kursatkemalkul/autokitch/_local/montaj-v87/v87_K_on.png

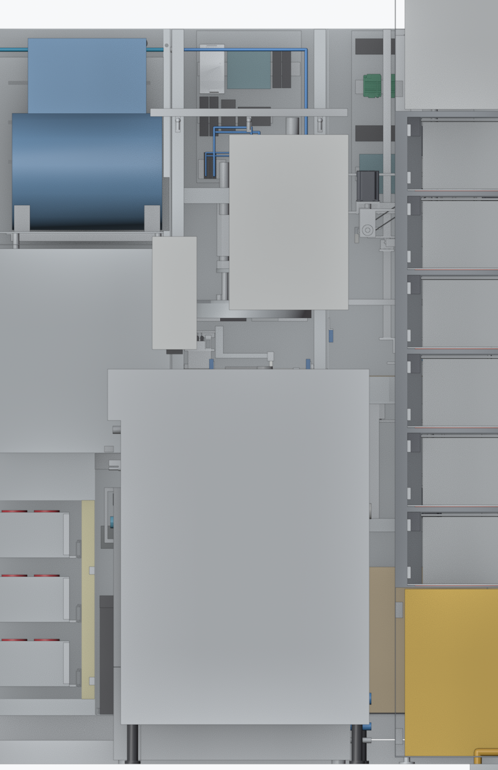
_local/montaj-v87/v87_K_on.png
