kursatkemalkul/autokitch/_local/montaj-v87/v87_K_34.png

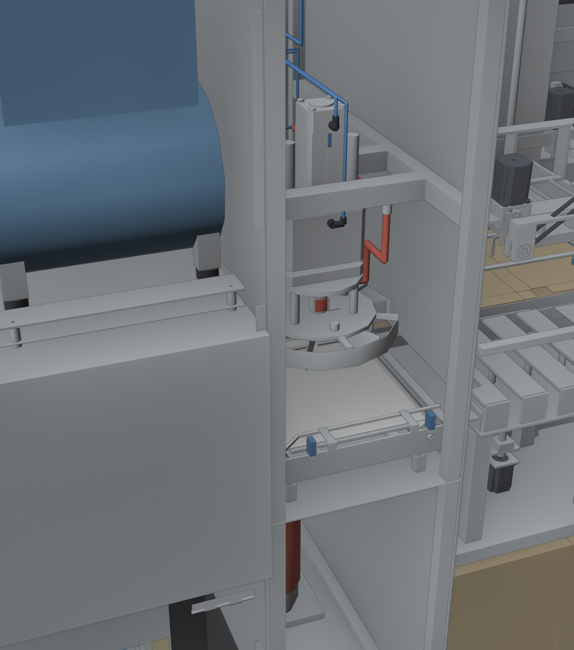
_local/montaj-v87/v87_K_34.png
