kursatkemalkul/autokitch/arastirma/DUZEN.md

# ARASTIRMA KLASÖR DÜZENİ (31 Ağu 2026)

Her istasyonun kendi klasörü var — o istasyonla ilgili çizim versiyonları,
belgeler, mail taslakları oraya gider. Yeni netlik = yeni versiyon, ilgili klasöre.

- 1_STORE    — soğuk depo: ist1_store_detay_v4 (4 Eyl; ölçü kontrolü: top kubbe Ø9,5×6, kutu Ø66×115, tatlı 4 kanal, soğutma 28, kaset çekmecesi 29, dikey 185 ✓) = ALT BUZLUK 6 çekmece (4 hamur + 2 kaset) + TAM ÇEKMECELİ KAPAKSIZ kasa, gerçek kalınlıklar (PU 60/80, ray 12,7, önler 40/60), robot erişimi 70 cm tam açılım (hat v43 STORE hâlâ v39 üst-buzluk — v44'te güncellenecek)
- 2_PRESS    — Fersah PZP-400 + uç cepleri + çöp          [güncel: ist2_pres_detay_v8 — sol yarı 30 L kova + 14 cm kol boşluğu (huni/çekmece yok), sağ yarı boş; altta yatay uç yuvaları 14 + tepsi rafı 8]
- 3_TOPPING  — dozaj/malzeme (hazne kulesi kararı AÇIK) · topping_cikis_geometri_v1 = çıkış kendi kaset merkezinde mi? 70 yan yana ✗ / 70 tek kolon A / 105 iki kolon B — B reddedildi (makine büyümez); topping_cikis_geometri_v2 = 70 tek kolon 3 dizilim (A1 öne kaşar öneri · A3 tabla · A2 yan yana dar-uzun ✗) · topping_kaset_form_v1 = form araştırması (F1 kutu · F2 kama · F3 REVOLVER döner tabla sektör kaset ÖNERİ · F4 tambur) · topping_revolver_v1 = KARAR: revolver 8 eşit 45° dilim (kaşar ×4 · sucuk ×2 · kav · kuş), dilim 11,7 L ≤ 6 kg, dozaj+değişim (35,60), geçiş rafı 12 yuva, 197 dikey ✓ · topping_dozaj_unitesi_v1 = dozaj kurgusu (Picnic referansı: köprü kırıcı tel + oluklu rotor; yük hücresiyle gram; sucuk = çubuk+dilimleyici; v2 = gerçek Picnic kareleri gömülü; v3 = sektörde köprü kırıcı = rotora paralel radyal TARAK mili, V-oluk 45°, malzeme tablosu; v4 = ideal kama huni vs bizim dilim üst/ön/yan; v5 = KARAR: cepli rotor+huni yerine YATAY HELEZON dış uçtan tek nokta (huni yok, çark katı 21→8, dozaj noktası (35,69)); dik boru ✗) · ist3_topping_detay_v12 GÜNCEL = ÇİFT REVOLVER (üst çalışan 8 + alt sıra 8 kaşar) + RAF A (park+boş) + RAF B (çözülme), dilim pasif helezon+tarak, pençe kavrama, M1 M2 M3 + klape ×2 + yük hücresi ×3 + RFID sabit gövdede, dikey 197 — Kemal REDDETTİ ('ne revolveri, KARAR C dedik') · ist3_topping_detay_v13 GÜNCEL = SABİT dizilim, helezon ağzı iç uçta → kasetler yan duvara yaslı, 2 kat + 2 dozaj düzlemi (kat 1 kaşar A + sucuk çubuk magazini sabit; kat 2 kaşar B + kav/kuş üst üste), raf A/B 2×4 yuva, yan dişli kavrama, 5 motor, 27+32+3+14+32+3+14+36+36 = 197 ✓, arka 50 cm boş — Kemal REDDETTİ ('C seçimindeki şekli direkt kullan, kutu kutu yapmışsın') · ist3_topping_detay_v14 GÜNCEL = TEK revolver Ø66 + C-şekli dilim (45° sektör, V-oluk, helezon r 12-30, tarak, ağız dış uçta (35,69), pençe iç uçta) + geçiş rafı 3 kat (12 yuva, önden FIFO, park = RAF 3 boş yuva), M1 M3 + klape + yük hücresi ×3 + RFID sabit gövdede, 27+4+33+8+14+37×3 = 197 — Kemal REDDETTİ ('revolver yok yokkk') · ist3_topping_detay_v15 GÜNCEL = REVOLVER YOK, C-kaset (sektör, helezon, tarak, V-oluk, ağız dış uçta) sabit PAPYON dizilimi: tip yan duvarda (motor), ağız ortada x 31/39; kat 1 kaşar A 60° | sucuk çubuk 60°; kat 2 kaşar B 60° | kavurma 30° + kuşbaşı 30° yan yana; her kasetin arkasında aynı rayda yedeği; boşluk ×2 (düzlem 123/74 cm); raf 2 kat (E-H + park + çözülme); 27+35+14+35+14+36+36 = 197 — Kemal REDDETTİ ('üstten üçgen değil, mükemmel form + v7 ölçüleri') · ist3_topping_detay_v16 GÜNCEL = v4 ideal kama huni (dikdörtgen, 45° V, tam boy helezon, tarak ×2) + C ağız iç uçta; kaşar 27×38×44 = 14,6 kg ×4 (A B çalışan, C D arkada), sucuk 27×19×27 çubuk ×2, kav/kuş 27×17×18 = 3,5 kg ×4; kat 47 ×2, boşluk 14 ×2 (tepsi 111 / 50 cm), raf 48 (park ×2 + boş küçük ×2); 27+47+14+47+14+48 = 197 ✓; kol yükü 18 kg → ⑦ ≥ 20 kg kobot (4 Eyl) · ist3_topping_detay_v17 GÜNCEL = TEK BÜYÜK KASET 27×78×44 tam derinlik (L-oluk: arka besleme helezonu + ön dozaj helezonu, ortada konik, tek duvar motoru), 76 L → kaşar 31 kg; kaşar A+B 62 kg/hafta + sucuk 10 kg büyük gövde → robot bunları HİÇ değiştirmez, eleman haftalık üstten doldurur (çekmece gibi öne çekilir); ⑦ kapandı (kol ≤ 6 kg); kav/kuş B = küçük gövde 3 gün (varsayılan) / A = −18 hücre + IQF donmuş dozaj (test); ALT 48 boşa çıktı; dok: motor duvarda, kaset pasif, kontak yok; isimler (LIW feeder, metering auger, bridge breaker...) (5 Eyl) · ist3_topping_detay_v18 GÜNCEL = KAPLAR: kıyma yok; BÜYÜK kap kaşar 27×65×48 = 56 L → 23 kg (3,5 gün; kat 1 + kat 2 birlikte 8 gün, eleman haftalık) · KÜÇÜK kap 27×21×28 = 13 L tek ölçü: sucuk 24 çubuk 7,5 kg (hafta, eleman, kavurmanın arkasında) / kavurma 3,3 kg / kuşbaşı 4 kg (3 gün, robot, STORE −18 28 ≤ 29); her kapta tek tarak (pimli mil, köprü kırıcı) + altta dozaj helezonu (sucukta bıçak); yerleşim kat 1 kaşar A + kavurma ön + sucuk arka, kat 2 kaşar B + kuşbaşı ön + yedek arka; dikey 27+51+14+51+14+40 = 197 (tepsi 107/42 cm); v16/v17 kaşar ölçüleri iptal (5 Eyl) · ist3_topping_detay_v19 GÜNCEL = kaplar 90° döndü: helezon derinlik (y) yönünde, V-kesit ÖN yüz, motor ARKADA eksenel pençe (taktığı gibi bağlanır); kesit asimetrik (dış duvar 45°, iç duvar dik, oluk bant kenarında); BÜYÜK kaşar 32,5×70×55 = 102 L → 42 kg HAFTALIK (yedek yok, robot dokunmaz); KÜÇÜK 32,5×20×28 = 11,7 L sucuk 28 yatay çubuk 8,7 kg / kavurma 3,3 / kuşbaşı 4; kat 1 kaşar sol tam derinlik + sucuk sağ ön, kat 2 kavurma sol + kuşbaşı sağ ön (arkası boş), ALT 53 sucuk yedeği + kav/kuş çözülme + park; dikey 27+58+14+31+14+53 = 197 (tepsi 100/55); kavurmalı/kuşbaşılı pide kat değiştirir +5 sn (5 Eyl) · ist3_topping_detay_v20 GÜNCEL = Kemal'in krokisi (referans/kemal_kroki_topping_kaplar_5eyl.jpg) izometrik: üst sol KAŞAR 32,5×70×55 (42 kg hafta) + üst sağ KAVURMA 32,5×20×55 (kısa, aynı yükseklik), alt SUCUK KÜP 32,5×20×40 + KUŞBAŞI 32,5×20×40; SUCUK KÜP — bıçak/çubuk/magazin İPTAL, dört kap aynı iç (tek tarak + helezon); motorlar 10 cm kalın arka duvarda gizli, kısa kaplara ara mil; dikey 27+58+14+42+14+42 = 197; (5 Eyl) · ist3_topping_detay_v21 GÜNCEL = Kemal'in simetrik V şekli korundu (helezon + tarak ortada); ağız banda kabın ön ucundaki kısa ÇAPRAZ HELEZONLA (konik dişli, aynı motor, kap içinde, 9-17 cm); kat 1 = KAŞAR 40×70×50 (121 L, 50 kg hafta) + SUCUK KÜP 24×20×50 (23 L, 9 kg hafta) eleman; kat 2 = KAVURMA + KUŞBAŞI 32×15×28 (11 L, 3 gün) robot; ALT 58 = değişim rafı (çözülme ×2 + park ×2); dikey 27+53+14+31+14+58 = 197 (tepsi 105/60); STORE −18 kesiti aynı paftada: kap döndürülüp 3/modül, 28 ≤ 29 ✓ (5 Eyl) — Kemal: taşıyıcı yok, arka arkaya yok, yan yana; menü Gemini araştırmasıyla kıyma+kaşar+kuşbaşı+sucuk; pide Ø30; 'mükemmel formu araştır' · kap_geometri_v1 GÜNCEL = literatüre dayalı kap: tek eğimli kama 55°, U-oluk R38, milsiz spiral Ø70, çift tarak, UHMW-PE, R ≥ 6 (EHEDG), yığın sınırı; BÜYÜK-L kaşar 32,5×70×60 → 90 L 37 kg ≈ 8 gün; KÜÇÜK 20×54×24 → 15,4 L (kıyma L ×4, sucuk R ×2, kuşbaşı R ×4; sol/sağ ayna, kap = ürün = pozisyon); kıyma/kuşbaşı harçları KAVRULMUŞ/SOTE vakumlu; dikey 27+63+14+27+14+52 = 197; ALT 2 sıra × 3 beşik; STORE −18 2/modül pay 5 (5 Eyl) · ist3_topping_detay_v22 GÜNCEL = bu kaplarla istasyon: izometrik + ön kesit + ALT 2 sıra × 3 beşik (kap şeklinde U yatak, L/R ayna: park L/R, yedek R, kıyma çözülme L, kuşbaşı çözülme R, boş yedek R) + STORE −18 kesiti (kıyma modülü L ×2, kuşbaşı modülü R ×2, 24 ≤ 29); kaşar 93 L 37 kg hafta, küçükler 17,7 L; helezon x 29,7 / 39,6; dikey 27+63+14+27+14+52 = 197, tepsi 95/54 (5 Eyl) · ist3_topping_detay_v23 GÜNCEL = TEK KAP TİPİ 16×54×24 simetrik (ağız ortada, ayna yok, 16 kap tek kalıp; 282 cm² → 14,8 L; kaşar 6,1 kg 1,35 gün); pide Ø30 → tepsi Ø32 + spiral R 11 = süpürme 27 → kap merkezleri x 27/43 (pay 0); 3 kat × 2 = 6 pozisyon (kat 1 kaşar A + sucuk, kat 2 kaşar B + boş/kavurma park, kat 3 kıyma + kuşbaşı), tepsi 158/117/76; üst teknik YOK: elektrik arka duvar içi, soğutma grubu ALT arkası 20 derin (plint ızgarası), evaporatör ALT üstü; ALT 74 = 2 sıra × 4 beşik (4 kaşar yedek, 2 çözülme, 2 park); STORE −18 3/modül; robot 11 değişim/hafta; 3×41 + 74 = 197 (5 Eyl) · ist3_topping_detay_v24 = v23 + normal ÜST GÖRÜNÜM (kat 1/2/3/ALT planları) + ALT sıra düzeltmesi (zf 8/35, evaporatör 62-74) · FULL_MAKINE hat_on_gorunus_teknik_v45 GÜNCEL (v45.1: TOPPING v23 bloğu, üst görünüm, KONTROL ⑤⑦⑧⑨⑪ ✓ + ⑫ tepsi Ø32 zinciri; STORE −18'de TOPPING kapları; tx '<' kaçışı) · FULL_MAKINE hat_on_gorunus_teknik_v46 GÜNCEL (5 Eyl; _uretec/teknik_cizim46.py doğrudan yazıldı, patch zinciri yok): TOPPING v25 bloğu (kap 14×68, L raf, klape ×3 + ALT ×2, soğutma dipte, evaporatör sol kanal, tepsi düzlemleri 158/117/76), STORE −18 sol modül klapeli kaset katı (4 kap, üstte z 28-57; v5 öneri), PRESS Ø32 + ÇATAL yuvası + plan kova/çatal, OVEN kavite 40 iç + ② 44 + kulp öne önerisi + niş/nozül düzeni, PACK bıçak Ø28 geometri + açık kutu 32×32×4,5 + şarjör 2×2 planda, SERVICE ambalaj notu, robot 16-20 kg + menzil ≥ 130 (UR16e 90 ✗) + 3 uç, KONTROL 13 madde (⑤ Fersah AÇIK, ⑦ yeniden AÇIK, ⑬ ÇATAL + haftalık) geniş kutu; tüm notlar notew() ile kolonuna sarılı; 8 denetçi ajan bulgusu işlendi; site HAT görseli v46 (5 Eyl) · hat_on_gorunus_teknik_v47 GÜNCEL (make_hat47.py → teknik_cizim47.py): TOPPING kap simgesi v26 Picnic tipi (daire duvar + POM helezon + göbek/çubuk tarak, şeffaf PC), ⑦ 15,4 kg, ⑧ v26 kap + 14,0 L, robot ≈ 12 kap/hafta, KONTROL kutusu uzatıldı; sitede henüz v46 · SİTE: TOPPING bölümü v24 + kap_geometri_v1 + Picnic referans görseli (otonom/img/picnic_istasyon.webp, referans/picnic_istasyon_5eyl.webp), HAT görseli v45 — commit 1a4ae75 + 61e4c1b (5 Eyl); referans kareler: 3_TOPPING/referans/ (Kemal kaydedecek) · ist3_topping_detay_v25 ÖNERİ (onay bekliyor, 5 Eyl) = KAP TAŞIMA TEK ÇÖZÜM: kap 14×68×24 (PE 6 mm, 17,5 L, boş ≈ 4,6 kg) altında 2 içi boş kızak 3,0×2,0 (cep 2,0×1,4), kabinde 2 L raf (20×8×2), robot ucu = ÇATAL (2 lama 16×12 × 50 cm + sırt, ≈ 2 kg, forklift: gir 50 → kaldır 0,5 → çek 70, 5° yatık taşıma); kap arkaya dayalı (helezon kare ucu duvardaki yaylı sokete, ara mil ve ön boşluk yok; derinlik 10+68+2+4 = 84); ALT beşik → aynı L raflar 2 sıra × 4 (soğutma grubu ALT dibinde 20, evaporatör sol yan kanalda), kat 27 + boşluk 14 aynı, 197 ✓; STORE −18: sol modül kaset çekmecesi → klapeli kat (4 kap yan yana 59,5, arka PU 8 + 68 + 2 + klape 6 = 84), sağ modül boş, öneri kaset katı z 28-57 (hamur 8-28); KOL YÜKÜ ⑦ YENİDEN AÇIK: kıyma 15,2 / sucuk 15,0 / kaşar 13,8 kg → 16-20 kg kobot ya da 2 günlük dolum · ist3_topping_detay_v26 GÜNCEL KAP (5 Eyl; ist3_topping26.py) = PICNIC TİPİ KAP (Kemal: 'biz böyle kuralım'): daire duvar R 6,5 tarak süpürmesiyle eş merkezli (göbek z 14, 4 çubuk Ø6 × 630 r 57/43/29/14, arka + ön omurga), plastik milli helezon POM Ø70 hatve 50 boy 60 + tırtıllı topuz Ø50 → yaylı soket (milsiz spiral iptal), boğaz 7,6 + yalak R 3,8, şeffaf PC 5 mm gövde (UHMW iptal), geçmeli kapak, ağız ön uçta 6×6,5; kap dışı 14×68, kızakla 26 → kat 27 (istasyon v25 / HAT v46 aynı); brüt 16,3 L / kullanılabilir 14,0 L → kaşar 5,8 kg 1,3 gün, kıyma 8,4 (2,9 g), sucuk 7,7 (6,4 g); boş kap 5,0 kg, kol kıyma 15,4; 123 cm³/dev (kaşar ≈ 50 g/dev); arka duvarda kap başına 2 soket (helezon z 3,8 + tarak z 14) · referans/: picnic_kap_helezon, picnic_kap_tarak, picnic_tarak_detay, picnic_reload_pepp (5 Eyl) · SİTE: TOPPING = v26 karar kutusu + v26 + 4 Picnic karesi (modelleme referansı) + v25 + v24 'yerleşim' etiketi; HAT görseli v46 (site_topping_v26.py) · ist3_topping_detay_v27 GÜNCEL (5 Eyl; ist3_topping27.py) = KAP AĞIZ/KAPAK/TUTMA: kapalı boru ucu y 62-67 (helezon son hatvesi içinde) + tek ağız 5×4,5 altta; menteşeli PC kapak (menteşe ön kenar y 67, burulma yayı kapalı tutar) + kol 1,8 (x +3, plaka altı boşlukta) + TOPPING katında raflar arası çapraz çubukta pim Ø8 (kap son 3 cm girerken kol pime dayanır → 90° açılır; STORE/ALT'ta pim yok); kızaklar ±4 → ±5 (çatal 10, L raflar ±5); taban plakası 0,4; ön çekme dudağı 1,5×3 (kap üstte 69,5 ≤ STORE 70); eleman: dudaktan çek → alttan tut → taşı; hacim 14,0 → 12,5 L (hazne 61,5) → kaşar 5,1 kg 1,1 gün, robot ≈ 14 kap/hafta; boş kap 5,7 kg, kol 15,2; açık: 3. kaşar kabı (kat 2 boş pozisyon) → 3,4 gün; site/HAT henüz v26/v47 · hat_on_gorunus_teknik_v48 (6 Eyl; _uretec/make_hat48.py → teknik_cizim48.py) = v47 + OVEN v3 kolonu (70, hat 420: plint/pano/kartuş/niş/fırın 2 kat/plenum/fan+filtre; yan yalıtım; üst görünüm arka kanal 20 + kulp 6) + TOPPING v27 sayıları (12,5 L, kap 5,7 kg, ⑦ 15,2, ≈ 14 kap/hafta) + kızaklar ±5 + KONTROL ② ve ⑩ KAPANDI (kulp 6 = 38 ≤ 40; kartuş) + ⑪ 420 + kutu yüksekliği içeriğe göre · hat_on_gorunus_teknik_v49 (6 Eyl; _uretec/make_hat49.py → teknik_cizim49.py) = v48 + OVEN v4 kolonu (2 standart yağ kabı sağ/sol + pompalar arkada + sprey ortada + KESME presi 50 + plenum/fan 12 + filtre 5 opsiyon + pano 20; üst görünümde kaplar ve pompalar kesik) + PACK = şarjör 116 + kutulama (kesim kalktı, BOŞ 26) + KONTROL ④ ⑩ ⑪ ⑫ güncel · hat_on_gorunus_teknik_v50 (6 Eyl; _uretec/make_hat50.py → teknik_cizim50.py) = v49 + OVEN v5 tek yağ kabı (sağ slot boş), ⑩ ⑪ güncel · hat_on_gorunus_teknik_v51 GÜNCEL (6 Eyl; _uretec/make_hat51.py → teknik_cizim51.py) = v50 + PACK v4 kutu açıcı (ön: zonlar + yığın 84 + plaka z 60 + kutu + plunger; üst: pencere + kapak bölgesi + kılavuzlar; ④ güncel; PACK plintli) · hat_dis_kapak_gorunus_v1 (6 Eyl; _uretec/kapak_gorunus1.py) = DIŞ GÖRÜNÜŞ: kapalı paneller, iç görünmez; beyaz = robot açıklığı (STORE kaset klapesi 40–69, PRESS 45–134 + kol boşluğu 178–192, TOPPING 3 kat klapesi 74–195, OVEN kesme 32–82 + sprey 82–112, PACK 60–104), turuncu = eleman kapıları (TOPPING ALT klapeleri, kova, yağ kabı, pano/fan/şarjör kapıları), mavi = cam fırın kapakları 112–168, çekmeceler robot pençeyle · hat_dis_kapak_gorunus_v2 GÜNCEL (6 Eyl; _uretec/kapak_gorunus2.py) = Kemal: yazısız, daha gerçekçi, açıklıklar koyu, PRESS'te yalnız pres ağzı açıklığı (50×36, z 72–108)
- 4_OVEN     — fırın · ist4_oven_detay_v5 GÜNCEL (6 Eyl; _uretec/ist4_oven5.py) = v4 ile aynı, Kemal "1 kap olsun, 2'ye gerek yok" → TEK standart yağ kabı solda (slot 15), sağ 15 boş, 12 L = 30 gün, dolu 14,1 kg, tek pompa, şamandıra 4 gün kala uyarır, değişim kapanışta (dolap gece açık, sabaha erir) · ist4_oven_detay_v4 (6 Eyl; _uretec/ist4_oven4.py) = Kemal: pompa arka duvarda, sağda solda 2 STANDART KAP (yağ versiyonu: helezon/tarak yok, taban kapalı, geçmeli kapak + dolum ağzı Ø60, arka soket = kuru bağlantı Ø12, şamandıra), 10 L = 25 gün (max 12 L = 30), dolu 12,3 kg, eleman AYDA 1 değiştirir, robot dokunmaz; 2 mini pompa 24 V arka duvarda, BEYİN biri boşalınca diğerine geçer · sprey ORTADA (slot 15 | tepsi 34 | slot 15), nozül 20 derinlikte, ayrı niş kalktı · zon = sıcak dolap 42 °C (klape 4; sadeyağ 32 °C altında katı → pompalanmaz; pide için sıcak şart değil; alternatif sıvı yağ = ısıtıcı yok) · KESME PRESİ PACK'ten OVEN'e: bıçak yıldızı + (2 × 28, paslanmaz 1,2 mm), 24 V lineer aktüatör 1500 N strok 100 mm (kuvvet 56 cm × 15–20 N/cm = 0,85–1,1 kN), 2 mil Ø12 kılavuz, tepsi zemin plakası + halka Ø33'e dayanır, robot yalnız kulpu tutar, kendini kilitler · fan ŞART (kabin ısısı), karbon filtre 5 OPSİYON (AVM), baca YOK (elektrikli) · zonlar hesapla: plint 12 / pano 20 / KESME 50 / YAĞ+SPREY 30 / fırın 56 (tepsi 117/145) / plenum+fan 12 / filtre 5 / yedek 12 = 197 (v3'te plenum+filtre+üst 51 → 17, pano 30 → 20) · ist4_oven_detay_v3 (6 Eyl; _uretec/ist4_oven3.py) = OVEN v2 + Kemal isteği: sadeyağ TANK → KARTUŞ 4 L paslanmaz 16×16×18 (ısıtma ceketi 45 °C, kuru bağlantı, kilit; ELEMAN haftada 1 değiştirir = 10 gün, ROBOT DOKUNMAZ; 1 haftalık 2,8 L çok değil → ikiye bölünmez) · sprey nişi 18 altı boş (robot tepsiyi sokar 1 sn çeker) · motorlar küçük (2 menteşe redüktörü Ø28 yan aralıkta, pompa 60×40×40, fan Ø120; ayrı motor odası yok) · havalandırma: plint ızgarası → yan/arka kanallar → plenum 26 → fan 140 m³/h → yağ filtresi + aktif karbon → üst ızgara (bacasız) · yan 3 = 2 seramik elyaf + 1 hava (sol TOPPING +3 °C, sağ PACK karton; komşu yüzey < oda +10 °C) · kolon 65 → 70 (hat 420) · zonlar: plint 12 / pano 30 / kartuş 30 / niş 18 / fırın 56 / plenum 26 / filtre 15 / üst 10 = 197; tepsi düzlemleri 95/123 · ist4_oven_detay_v2 (6 Eyl; _uretec/ist4_oven2.py) = Omake FPZ01.E21 çift katlı taş fırın 64×60×56 (2 kapak, 4,8 kW, 40 bin TL) + motorlu kapaklar + sadeyağ sprey ünitesi (4 L tank 45 °C, dişli pompa, 90° koni nozül, tek atım 4 ml) + stok (haftalık 2,8 L, teneke SERVICE'te) + satın alma seçenekleri; kolon 65×197 yeni dizilim: boş 40 / pano 20 / yağ 30 / niş 18 / fırın 56 / filtre 15; kulp 6 ile ② çözülür; HAT v48'de işlenecek
- 5_PACK     — kesim + kutu (kutu şema/mail arşivi burada) [kutu katlama artık ELEMAN işi] · v49 (6 Eyl): KESİM OVEN'e taşındı (OVEN v4 KESME presi) → PACK = şarjör 2×2×29 = 116 + kutulama (tepsi eğilir, 4 parça kayar); üstte 26 cm boşaldı · kutu_istasyonu_teknik_v4 GÜNCEL (6 Eyl; _uretec/kutu_istasyonu4.py) = ÜSTTEN BESLEMELİ KUTU AÇICI (Kemal: Çin pnömatik kutu açma videosu → bizde dikey, elektrikli): açık kutu blank 40×76 (32×32×4 köşe tırnaklı tepsi tipi, E-dalga 1,6 mm 115 g) üstte yatay yığın z 104–188 = 525 kutu (80 pide: 3 gün 38 cm garanti, 5 gün 64 cm hedef, dolu 6,6 gün; 7 gün 90 cm sığmaz); tek dikey eksen (bilyalı vida + NEMA 23, strok 48): plunger + 6 vantuz Ø40 alttan yükselir, en alt blankı çeker, 44 cm indirir, tabanı kalıp penceresinden (32,5) 4 cm çeker → 4 duvar + köşe tırnakları plowla katlanır (1 vuruş), kutu plakaya (z 60) yükselir, kapak açık arkada; robot tepsiyi eğer pide kayar; 3 flap parmağı (servo) + U çevirme kolu (24 V redüktör) kapağı kapatır; eksen 6 cm kaldırır, pençe alır → PICKUP. Zonlar: plint 12 / pano 18 / step+vakum pompası 15 / boyunduruk 10 / kalıp 5 / yükleme 44 (kapak yayı 40) / şarjör 84 / üst 9 = 197; klape 66×44 (robot), ön kapı (eleman demet sürer). Kompresör yok (24 V diyafram vakum pompası). Çevrim 15 sn. HAT v51 güncel, site değil
- 6_PICKUP   — QR teslim dolabı · pickup_dolap_teknik_v1 GÜNCEL (7 Eyl; _uretec/pickup_dolap1.py) = kabin 140×60×197 müşteri duvarında (pass-through): 12 dolap (2 sütun × 6 sıra, z 60–180; hesap: 20 sipariş/saat pik × 12 dk bekleme = 4 ort., %95 8, +2 geç = 10 gerek) + kiosk şeridi 20 (10" ekran, PIN, QR, kamera) + pano 48 (BEYİN PC, kilit kartı); dolap içi 56×36×16 = 3 pide üst üste (13,2) sağda + sol 20: 1 L şişe yatık + tatlı 12×12 / 2 kutu içecek; ön kapı 12 V elektrikli kilit + LED + açık-kaldı sensörü, arka üst menteşeli yaylı klape (robot kutuyla iter, mıknatıs kilit, interlock), ısıtıcı YOK (PU 20 mm + 15 dk kuralı + 3 buhar deliği); kod: platformlar (Yemeksepeti/Getir/Trendyol Go) kod üretmez → BEYİN üretir: kendi app SMS/QR, platform müşterisi ve kurye sipariş no son 4 hane; robot adresleme: BEYİN tablosu + 12 sabit XYZ + IR sensör (kamera yok); satın alma: TR kargo dolapçıları (pudo, Easy Point, Emanetmatik, Fitekno, kutu.tech) tek taraflı, yurt dışı Apex OrderHQ / Hatco Minnow; öneri entegratör kabin + hazır kilit kartı + Android kiosk ≈ 60–90 bin TL · kiosk_siparis_ekrani_v1 GÜNCEL (7 Eyl; _uretec/kiosk_siparis1.py) = Kemal: sipariş ekranı dolabın üstünde olmasın, ayrı olsun (sipariş veren kuryeyi bloke etmesin) ama her şey bir cephede → SİPARİŞ KİOSKU 40×197×25 duvara gömme (32" portre dokunmatik 40×71 merkez z 140, ÖKC entegre POS + 80 mm fiş z 95–103, 2D okuyucu, kamera, mini PC; BEYİN YOK, LAN istemci) + dolap şeridinde 10" TESLİM EKRANI (yalnız kod: PIN pad + QR, müşteri SMS/fiş kodu, kurye sipariş no son 4 hane); cephe 180 = kiosk 40 + PICKUP 140, iki bekleme noktası; sipariş akışı 6 adım (menü/ürün/sepet/telefon isteğe bağlı/ödeme/fiş+kod), dolap hazır olunca atanır; TR üreticiler KioSelf, Onega Zenyo KSK-3200, İnnova, Kardo, Novem, PandaX, Menulux, Posgo, robotPOS (50–120 bin TL tahmin); fiş zorunlu → ÖKC POS (Ingenico/PAX/Hugin), kağıtsız e-Arşiv mali müşavire · 3 AYRI TEKNİK RESİM GÜNCEL (7 Eyl; _uretec/pickup_uc_parca.py; Kemal: paftada Q&A/akış görseli yok, yalnız ön/üst/yan, gereksiz hacim yok): siparis_ekrani_teknik_v2 = duvar tipi 45×104×14 z 85–189 (32" + ÖKC POS yuva 20° + 80 mm yazıcı + 2D + kamera, mini PC, arkada gövde yok, altı serbest) · teslim_dolabi_teknik_v2 = 124×165×52 (plint 15 + pano 25 + 6×20 + üst 5), kapı 58×18 2 mm 304 gizli yaylı menteşe ×3 + amortisör (kendiliğinden kapanır) + yaylı elektrikli dil 5 kN + 10 mm bindirme + reed, arka klape üst menteşe yay + mıknatıs, PU 20, IR, buhar delikleri, çıkarılabilir tepsi · kod_unitesi_teknik_v1 = 20×34×8 z 110–144 (7" ekran, metal PIN pad IK09/IP65, 2D, kamera, LED, KURYE tuşu, RPi kontrolcü) dolabın sağında; kiosk_siparis_ekrani_v1 ve pickup_dolap_teknik_v1 ESKİ (birleşik/Q&A)
- 7_SERVICE  — servis istasyonu (ayrı ünite)
- FULL_MAKINE — bütün istasyonların BİR ARADA olduğu çizimler: · dukkan_plani_v1 (7 Eyl; _uretec/dukkan_plani1.py) = Kemal krokisinden dükkan üst görünüşü 560×560 = 31,4 m²: hat sol duvarda y 100–520, robot koridoru 90 (ray y 30–500), ince duvar 6 (arka uçta kilitli kapı 80), müşteri yüzünde teslim dolabı (y 20–144, duvardan geçer) + kod ünitesi + sipariş ekranı, SERVICE 70×84 + tezgah 130×40 + eleman + arka koridor 100 personel zonu (x 180–280), sağda müşteri salonu 280×560 = 15,7 m², giriş ön duvarda 100; alan tablosu; YORUM: v1 yanlış okundu · dukkan_plani_v2 GÜNCEL (7 Eyl; _uretec/dukkan_plani2.py) = Kemal düzeltmesi: aynalı (hat SAĞ duvarda x 316–400, kapı SOLDA), tezgah sokağa bakar, müşteri salonu YOK (al-git): 400×560 = 22,4 m²; ön duvar (kaldırım) soldan sağa: kapı 90 (eleman/kurye/ikmal) · tezgah penceresi 80 (sürme cam, tezgah 80×40 içeride, eleman arkasında) · sipariş ekranı 45×14 dışa asılı · teslim dolabı 124×52 ön duvar içinde (arkası robot koridoruna + hat önü boşluğuna bakar, ray ucu y 90) · kod ünitesi 20×8; personel zonu 220 (tezgah, SERVICE 84×70 ince duvara dayalı, depo 200, eleman koridoru 100 + kilitli arka kapı 80); robot koridoru 90 (x 226–316) + hat önü 48 boşluk; daraltma seçeneği 360×560 = 20,2 m² · dukkan_plani_v3 GÜNCEL TEK FİNAL (7 Eyl; _uretec/dukkan_plani3.py) = Kemal: "krokiyi çevirme, DÜKKANI 90° çevir, sokak cephesi aşağı baksın, tek final resim" → 560×320 = 17,9 m²: arka duvarda HAT 420 (x 100–520), önünde robot koridoru 90 (ray 340 düz + R45 kavis + 46 bacak sağ uca, dolaba iner), ince duvar 6 (sol uçta kilitli kapı 80), ön zon 140: sol koridor 100 + sokak kapısı 90, tezgah 80×40 sokağa bakar + eleman, SERVICE 84×84, sipariş ekranı 45, kod 20, teslim dolabı 124×52 sağ uçta ön duvar içinde; aynı paftada SOKAK CEPHESİ (kapı 90×210, pencere 80×100 eşik 100, ekran z 85–189, kod z 110–144, dolap 124×165); v1/v2 eski · dukkan_plani_v4 GÜNCEL TEK FİNAL (7 Eyl; _uretec/dukkan_plani4.py, dukkan_patch4.py ile v3'ten): Kemal "benim çizdiğim gibi yap" → kroki birebir: 600×320 = 19,2 m²; ince duvar YALNIZ tezgah bölgesinde (x 100–370), sağda robot koridoru dolabın arkasına kadar iner (kavis/bacak yok, düz ray 440), SERVICE 70×84 ince duvarın sağ ucunda, sipariş ekranı SERVICE'in önünde ön duvarda, kod, teslim dolabı sağda ön duvar içinde; sol şerit koridor 100 (sokak kapısı 80 + ön zon kapısı 80 + kilitli robot kapısı 70); tezgah 180×40 sokağa bakar, pencere 160; kol menzili ≥ 150 (dolap arkası ray ekseninden 139) → H2017; v3 eski · dukkan_plani_v5 GÜNCEL TEK FİNAL (7 Eyl; _uretec/dukkan_plani5.py): Kemal "tezgah + dolap SERVICE ile aynı hizada, ekran SERVICE'in arka (sokak) yüzünde, hat sağ duvara yaslı, sol koridor sil duvarla kapat, ray soldan kısalsın, erişimi kontrol et, en az kaç m²" → 420×320 = 13,4 m² (ön zon 130 ile 13,0): ön duvarda tek sıra kapı 75 + tezgah 140×40 (pencere 130) + SERVICE 70×84 sırtı sokağa (sırtında 32" ekran + kod) + dolap 124×52; ince duvar x 0–296, dolap arkası açık robot alanı; ray 300 (x 60–360) ekseni y 160 (duvara 14); erişim H2017 170 ile ✓ (dolap dip ≤ 156, TOPPING çatal 126, STORE 90, PACK 100), CRX-20iA/L 142 ✗; giriş ön duvar solda; v4 eski · dukkan_plani_v6 (kademeli cephe, Kemal istemedi) · dukkan_plani_v7 GÜNCEL TEK FİNAL (7 Eyl; _uretec/dukkan_plani7.py): Kemal "kademesiz düz: SERVICE arkası ince duvara, önü cephe; tezgah ve dolap aynı hatta" → 420×264 = 11,1 m²: ön zon 84 (tezgah 30 + eleman 54 DAR, öneri ön zon 100 → 11,8 m²), ince duvar x 0–296, dolap arkasındaki 32 + 6 robot alanı, ray 300 ekseni y 135, erişim CRX-20iA/L 142 ile ✓ (dolap sağ dibi 132, TOPPING çatal 113), ekran + kod SERVICE sırtında cephe hattında, kapı 75 solda, pencere 130
    hat_on_gorunus_teknik_v3..v46 (ön görünüş serisi; v46 GÜNCEL (5 Eyl: TOPPING v25 + STORE v5 öneri + denetim düzeltmeleri); v44 = tüm istasyonlar + KONTROL; v44: STORE v4 (alt buzluk, 19 çekmece, kalınlıklar) + PRESS v8 (kova + kol boşluğu) + TOPPING v11 + OVEN tank+pompa + PACK 116, 4 Eyl)
    hat_plan_* (yerleşim planları v32-v37 — yerleşim kararı SONRA)
    kombine_el_detay (robot eli)
- _uretec    — tüm çizimlerin Python üreteçleri (teknik_cizimN.py vb.)

İstasyon isimleri (ONAYLI): 1 STORE · 2 PRESS · 3 TOPPING · 4 OVEN · 5 PACK · 6 PICKUP (+SERVICE)
İstek üzerine tüm istasyonlar birleştirilip tek "full makine" çizimi üretilir (_uretec'ten).

- 8_ROBOT    — robot ucu/tepsi (4 Eyl 2026): robot_tepsi_el_v1 = kulplu tepsi robotun kilitli aksesuar ucu; pide press→kutu tepside; fırına tepsiyle girer; TOPPING v8 (tabla kalktı, açık dozaj boşluğu) — ONAY BEKLİYOR

- _uretec/render_hq.py — SVG → PNG 2,5× (Chrome device-scale-factor); 4 Eyl'den itibaren tüm PNG'ler bununla (güncel 8 çizim yeniden üretildi)

- SİTE (7 Eyl 2026) — otonom/hat/ = HAT · Yol C sayfaları (_uretec/hat_site_gen.py üretir; görseller otonom/hat/img/ içine kopyalanır): index.html DÜKKAN 3B (three.js kutu modeli, makine tek grup kırmızı → makine.html; SERVICE/dolap/ekran/kod kendi sayfasına) + genel senaryo + dükkan v7 · makine.html (istasyonlar ayrı renk + robot → store/press/topping/oven/pack/robot.html) · birim sayfaları hep aynı 6 başlık: senaryo · özellikler · teknik resimler · tedarikçiler · açık konular · sürüm geçmişi · scene.js + hat.css ortak. Store sayfası (otonom/index.html) Yol C araştırma bloğu silindi → kart + nav linki "HAT · Yol C →". Yeni pafta/karar geldiğinde: hat_site_gen.py içindeki ilgili unit() metnini ve IMGS listesini güncelle, çalıştır, commit, push, dispatch.

## SolidWorks 3B model (7 Eyl 2026)
- `1_STORE/STORE_dis_v1.SLDPRT` — STORE dış gövde, doğrudan SolidWorks 2025 içinde COM API ile üretildi (`_uretec/sw_store_dis.py`). 31 gövde, feature ağacında adlı (govde_kasa, ayak_1..4, sove_*, cekmece_*, *_kulp, panel_*). Gabari 1400×1970×840 mm, ön yüz z=+20, gövde z 0..−820.
- `1_STORE/STORE_dis_v1_sw_iso.png` — SolidWorks izometrik görüntü.
- CadQuery STEP/STL/SVG çıktıları (STORE_dis_v1.step vb.) eski deneme; SLDPRT esas.
- `2_PRESS/PRESS_dis_v1.SLDPRT`, `3_TOPPING/TOPPING_dis_v1.SLDPRT`, `4_OVEN/OVEN_dis_v1.SLDPRT`, `5_PACK/PACK_dis_v1.SLDPRT` — 70×197×84 dış gövdeler (`_uretec/sw_hat_dis.py`; zonlar kapak_gorunus2'den). Açıklıklar gövdeye 100 mm oyuk, servis kapakları sağ kenar dikey kulplu, cam kapak 12 mm.
- `FULL_MAKINE/HAT_dis_v1.SLDASM` — 5 istasyon yan yana (x: 0/1400/2100/2800/3500, toplam 4200), ön yüzler aynı düzlemde; `_sw_iso.png` + `_sw_on.png`.
- API notu: FeatureCut4 Dir bayrağı ekstrüzyonun TERSİ; AddComponent5 verilen noktaya BBOX MERKEZİNİ koyar.
- `1_STORE/STORE.SLDASM` + `1_STORE/parca/*.SLDPRT` (105 ayrı parça, `_uretec/sw_store_asm.py`) — AYRI PARÇALI SAC KASA: dış kabuk 1,5 / iç kabuk 1,0 / PU 60 (yan-arka-taban-tavan) / PU80 ayırıcı / orta bölme 24 sandviç / L-T bükme söveler / çekmece önü sandviç 40 (1,5+37,5 PU+1,0) / çekmece kutusu U 1,0 × 600. Parçalar global koordinatta; montajda sabit. `STORE_asm_iso.png`, `STORE_asm_on.png`.
- Eski çok gövdeli `STORE_dis_v1.SLDPRT` HAT_dis_v1.SLDASM'de hâlâ kullanılıyor (dış gabari).
