kursatkemalkul/autokitch/_local/e-v12/ozet.md

# E v12 · gerçek süre denetimi (30 Eyl 2026 · Claude)

Döngü: eski 23.0 s → **gerçek 31.96 s** (her eksen katalog hız/ivme sınırında) · zaman ihlali 0 · kesişim 0 · makine↔karton 0 · kafa↔besleme en kısa 4.30 mm

| eksen | eski süre (s) | gerçek süre (s) | eski tepe → gerçek tepe | sınır | φ |
|---|---|---|---|---|---|
| PISTON baskı kafası | 0.66 | 2.58 | 980 → 250 mm/s | 250 | 3.92 |
| PISTON baskı kafası | 0.69 | 1.35 | 270 → 139 mm/s | 250 | 1.95 |
| PISTON baskı kafası | 0.25 | 0.36 | 270 → 188 mm/s | 250 | 1.43 |
| PISTON baskı kafası | 0.50 | 2.23 | 1117 → 250 mm/s | 250 | 4.47 |
| PISTON baskı kafası | 1.40 | 1.90 | 340 → 250 mm/s | 250 | 1.36 |
| PISTON baskı kafası | 0.80 | 1.97 | 615 → 250 mm/s | 250 | 2.46 |
| ITICI vakum besleme arabası | 0.65 | 0.78 | 948 → 792 mm/s | 800 | 1.20 |
| ITICI vakum besleme arabası | 0.68 | 1.95 | 907 → 792 mm/s | 800 | 1.14 |
| NEST destek tablası | 0.38 | 0.85 | 180 → 80 mm/s | 80 | 2.25 |
| CNR_LIFT köşe çerçevesi | 0.50 | 0.71 | 114 → 80 mm/s | 80 | 1.43 |
| CNR_LIFT köşe çerçevesi | 0.30 | 0.41 | 110 → 80 mm/s | 80 | 1.38 |
| CNR_LIFT köşe çerçevesi | 0.25 | 0.42 | 132 → 80 mm/s | 80 | 1.65 |
| CNR_LIFT köşe çerçevesi | 0.30 | 0.71 | 190 → 80 mm/s | 80 | 2.38 |
| CNR köşe parmakları (4) | 0.84 | 1.04 | 193 → 165 °/s | 300 | 1.17 |
| PARMAK ön dil katlayıcı | 0.35 | 0.48 | 771 → 648 °/s | 900 | 1.19 |
| KATLAYICI U flap | 0.40 | 0.68 | 141 → 83 mm/s | 83 | 1.70 |
| KATLAYICI U flap | 0.40 | 0.79 | 141 → 83 mm/s | 83 | 1.70 |
| KOPRU pizza köprüsü | 0.40 | 0.61 | 112 → 83 mm/s | 83 | 1.35 |
| KOPRU pizza köprüsü | 0.40 | 0.54 | 112 → 83 mm/s | 83 | 1.35 |

Karton içi (kat yeri kalınlık bindirmesi, makine değil): 373 kayıt, 4 çift.
Bağlantı: 381 parça tek bileşen + asansör kayışı (0,38 mm diş boşluğu — v11 ile aynı).
