kursatkemalkul/autokitch/arastirma/4_OVEN/PROBLEMLER.md

# 4 · OVEN — PROBLEM DEFTERİ
Durumlar: **ÇÖZÜLDÜ** · **ÖNERİ VAR** (Kemal onayı bekliyor) · **AÇIK**.
Kapananlar silinmez, ÇÖZÜLDÜ olarak kalır. Güncelleme: 31 Ağu 2026

| # | Problem | Durum | Çözüm / Not |
|---|---|---|---|
| O1 | Pide yanarsa / az pişerse | ÖNERİ VAR | Reçeteli süre+sıcaklık (PZP ısıtmalı olduğundan +15-30 sn dahil); çıkışta kamera renk kontrolü → yanıksa ÇÖP + yeni pide otomatik başlar + elemana bilgi |
| O2 | Motorlu kapak açılmazsa pide içeride kalır | ÖNERİ VAR | Kapak switch + 2. deneme; başarısızsa alarm — eleman müdahale eder (bakım kapısından) |
| O3 | Peş peşe pişirmede taş taban soğur | DÜZELTİLDİ (6 Eyl) | Kemal haklı: 3 kW'lık kompakt fırın 4 dk döngüde kendini yeniler (pide başına ~200 kJ = 65 sn eleman; alt rezistans pişirme sırasında çalışır) → tek kavite de peş peşe pişirir. Soğuma 2. kavitenin gerekçesi DEĞİL; gerekçe pişme süresi (kapasite: tek kavite 12–15/saat, pik 25) + arıza yedeği. BEYİN koymadan önce taş sıcaklığı ≥ set −15 °C şartı arar (en fazla 60 sn bekler) |
| O6 | Fırın ne zaman açık/ısınmalı? Gece açık kalmasın (Kemal) | ÖNERİ VAR (6 Eyl) | Soğuktan 340 °C'ye 15–25 dk sürer, 1 dk önceden ısıtma olmaz → servis saatinde BEKLEME (340 °C, ~0,6–1 kWh/saat/fırın), 20 dk sipariş yoksa EKO (250 °C, 250→340 boost ~3 dk = pide hazırlık süresi), kapanışta KAPALI, sabah zamanlayıcıyla açılıştan 20–25 dk önce ön ısıtma. 2. fırın yalnız pik saatlerde ya da kuyruk ≥ 2 siparişte uyanır. Pişme süresi sabit sıcaklık + sabit süre (termostat tutar); çıkışta kamera renk kontrolü süreyi ±15 sn öğrenir (O1) |
| O4 | Sadeyağ sprey nozülü tıkanırsa | ÇÖZÜLDÜ | Isıtmalı tank + ısıtmalı hat (mevcut karar); haftalık nozül kontrolü eleman listesinde |
| O5 | Koku/duman birikimi | ÇÖZÜLDÜ | Fırın üstü karbon filtre + fan, çıkış arkaya (mevcut karar); filtre değişimi aylık eleman işi |
| F-T1 | Kürekle taşa sürme / pişmiş pideyi alma | ÇÖZÜLDÜ (4 Eyl) | Pide TEPSİYLE fırına girer (delikli alüminyum, pizza screen); robot kilit açar/kapar, sıyırma yok |
| F-T2 | Delikli tepside alt kabuk taş kadar çıtır mı | ÖNERİ VAR | Pilotta taş-tepsi karşılaştırması; gerekirse delik oranı artar |
| O7 | Fırın seçimi + kapak sayısı + yağ ünitesi + stok (Kemal, 6 Eyl) | ÖNERİ VAR (6 Eyl; v3 ile güncellendi, bkz. O8) | ist4_oven_detay_v2: Omake FPZ01.E21 çift katlı taş fırın (64×60×56, 2 ayrı camlı kapak, 4,8 kW, 40.169 TL Cafemarkt) — bant fırın geri çekildi (TR fiyatı 300 bin, hat +60 cm). Kavite 40×40×10 → tepsi Ø32 + kulp 6 = 38 ✓ (② çözüm: kulp 6). Kapaklar 24 V lineer aktüatör + 2 switch. Sadeyağ ünitesi: 4 L çift cidar tank 45 °C + 100 W ısıtıcı + 24 V dişli pompa 0,5 L/dk + ısıtmalı Ø6 hat + çek valf + 90° tam koni nozül 15 cm → Ø30 iz, tek atım 4 ml = 0,48 sn, tepsi 1 sn durur; gün sonu mini-CIP. Stok: 0,4 L/gün → 4 L tank 10 gün → haftalık dolum 2,8 L; teneke SERVICE'te oda sıcaklığı (sadeyağ soğuk istemez); makinede teneke deposu kalktı. Satın alma: Gold Medal 2496 (ABD, BIB, ~1.300 $ teyit) / Alibaba ısıtmalı pompalı dispenser ≈ 185 $ / entegratör yapımı 8–12 bin TL (öneri) |
| F-T3 | Tepsi malzemesi ısı döngüsü (350 °C fırın + 150 °C press + yıkama) | AÇIK | Seramik kaplama + 3 mm alüminyum; pilot 200 tur |
| O8 | Yağ ünitesi eleman değiştirsin (robot değil), niş altı boş, motorlar küçük, havalandırma/filtre, komşu istasyonlara ısı, yalıtım (Kemal, 6 Eyl) | ÖNERİ VAR (6 Eyl; v4 ile güncellendi, bkz. O9) | ist4_oven_detay_v3: sadeyağ KARTUŞ 4 L paslanmaz 16×16×18 (ısıtma ceketi 45 °C, kuru bağlantı, kilit mandalı, ön kapak) — eleman haftada 1 değiştirir (10 gün), boşunu SERVICE'te 16 kg tenekeden doldurur; robot dokunmaz; 1 haftalık 2,8 L = 3,6 kg çok değil → tek kartuş, ikiye bölünmez · sprey nişi 18 altı boş: robot tepsiyi sokar, 0,5 sn atım 4 ml, çeker · motorlar: 2 menteşe redüktörü Ø28×60 (3 cm yan aralıkta), pompa 60×40×40 (kartuş arkası), fan Ø120 (filtre bölmesi), sürücüler panoda; ayrı motor odası yok · havalandırma (Omake bacasız, buhar arkadan): plint ızgarası → yan/arka kanallar → plenum 26 → fan 140 m³/h → yağ filtresi + aktif karbon → üst ızgara → mekân; filtre aylık eleman işi (O5) · ısı: bekleme ≈ 0,7 kW, pişirmede 2,4 kW, egzoz +15 °C, mekâna günde 6–8 kWh (küçük radyatör kadar, klima yükü) · komşular: sol TOPPING +3 °C kabin, sağ PACK karton → yan 3 cm = 2 seramik elyaf + 1 hava aralığı, komşu yüzey < oda + 10 °C; kolon 65 → 70, hat 420 · AÇIK: kuru bağlantı tipi (CPC gıda tipi), kartuş kalıbı, aktif karbon tedariki, tepsili pide pilotu (F-T2) |
| O9 | Kemal (6 Eyl): pompa arka duvarda, sağda solda 2 STANDART KAP (helezonsuz), biri bitince diğeri; kaç gün gider; yağ sıcak mı olmalı; sprey önde az yer; havalandırma/filtre şart mı, koku, baca; KESME presi bu istasyona (pres + 4 bölen bıçak, tepsi zemine, motor hesabı); "büyük büyük koydun" | ÖNERİ VAR (6 Eyl) | ist4_oven_detay_v4: 2 standart kap yağ versiyonu (helezon/tarak yok, taban kapalı, geçmeli kapak + dolum ağzı, arka soket = kuru bağlantı, şamandıra) slot 15 sağ/sol, 10 L = 25 gün (max 12 = 30), dolu 12,3 kg, eleman ayda 1, robot dokunmaz; 2 mini pompa 24 V arka duvarda, otomatik geçiş · YAĞ SICAK MI: pide için şart değil, pompa için şart (sadeyağ 32 °C altında katı, oda sıcaklığında akmaz; "bozulmaz" ile "akmaz" ayrı) → zon = sıcak dolap 42 °C (100 W termostat, kayıp 20–30 W, gece açık, günde ≈ 0,6 kWh; hat ısıtması yok); alternatif sıvı yağ → ısıtıcı yok (lezzet kararı) · 42 °C'de 1 aydan uzun bekletme acılaşma → 10 L dolum · sprey ORTADA (15 | 34 | 15), nozül 20 derinlikte, tepsi 40 girer, damlalık tavası; niş kalktı (18 cm) · FAN ŞART (0,7 kW bekleme ısısı kabinde birikir), FİLTRE OPSİYON (koku az; AVM/ofis içinde 40×40×5 karbon panel), BACA YOK (elektrikli; gazlı isterdi) · KESME PRESİ 50 (z 32–82): bıçak + 2 × 28 paslanmaz 1,2 mm, kuvvet 56 cm × 15–20 N/cm = 0,85–1,1 kN → 24 V lineer aktüatör 1500 N, 100 mm, 10 mm/s, 60 W, 2 mil Ø12 + 4 lineer yatak, tepsi zemin plakası + halka Ø33, robot kulpu tutar (kuvvet plakaya), bıçak tepsiye değince akım limiti (tepsi sarf), kendini kilitler · zonlar: 12 + 20 + 50 + 30 + 56 + 12 + 5 + 12 = 197 (plenum 26 + filtre 15 + üst 10 = 51 → 17; pano 30 → 20) · PACK = şarjör + kutulama (26 cm boşaldı) · AÇIK: kesme kuvveti pilotu, sadeyağ mı sıvı yağ mı, PC + 42 °C yağ uzun süre, kuru bağlantı tipi |
| O10 | Kemal (6 Eyl): "1 kap olsun, yağda 2'ye gerek yok" | KARAR (6 Eyl) | ist4_oven_detay_v5: tek standart yağ kabı solda (slot 15), sağ 15 boş (yedek), 12 L = 30 gün, dolu 14,1 kg, tek pompa arka duvarda, şamandıra 4 gün kala "yağ az", eleman ayda 1 kapanışta değiştirir (katı sadeyağ dolapta gece erir) |
