kursatkemalkul/autokitch/_local/claude_son_yerel/gece2/adim4/kars_tam1.md

# GLB KARŞILAŞTIRMA

A = `C:/Users/Kemal/AppData/Local/Temp/claude/C--Users-Kemal-Desktop-Kemal-WEBS-TE/f3ef876a-f062-4b29-bb81-775cc8a1a6d8/scratchpad/gece2/adim4/hat3_v9_zincir_kayitli_taban.glb` (122050432 bayt)  
B = `C:/Users/Kemal/AppData/Local/Temp/claude/C--Users-Kemal-Desktop-Kemal-WEBS-TE/f3ef876a-f062-4b29-bb81-775cc8a1a6d8/scratchpad/hat3_v8zq.glb` (122050432 bayt)  
köşe toleransı ±0.01 mm

- bayt bayt: **farklı (aşağıda anlamsal karşılaştırma)**
- düğüm adları + sırası: aynı (809 düğüm)
- malzemeler / sahne (extras: mekanizmalar, kategoriler…): aynı
- 809 düğüm karşılaştırıldı · toplam 2069667 üçgen · en büyük köşe farkı 57.50012 mm
- animasyonlar: 6 · farklı: 0

## Farklı düğümler (1)

| düğüm | üçgen A / B | köşe farkı mm | ne farklı |
|---|---|---|---|
| TOPPING_MODUL__pu | 8491 / 8491 | 57.5001 | NORMAL 1.971, köşe 57.5001 mm |

**SONUÇ: 1 FARK**
