kursatkemalkul/autokitch/_local/claude-site-20261005/held-paths/_local/k-v11/ozet.md

# K v11 · özet (30 Eyl 2026 · Claude) — kesme_cad_v11 = v10 + alt dolap yerleşimi

Kemal (alt dolap ekran görüntüsü): "bunu geriye en gidebileceği kadar it ki ben ön tarafa da bir şeyler koyabileyim"

- Teneke + tartı + damlama tavası 452 mm geri: teneke z −769,5…−534,5 · tava −784…−500 (arka alt kayıt −785: daha geri gidemez, kayıt boydan boya tava yüksekliğinde).
- Teneke ağzı ön-sağ köşede (x 285 · z −562): emme borusu + adaptör rafın önünde; teneke 0 → 850 mm öne çekilirken hiçbir parçaya değmez.
- Pompa grubu (filtre · GJ-N21 · T · PM1704 · KBP) tenekenin üstünde arkada 304 1,5 rafta (y 640, z −785…−623, 3 kenarı 20 kıvrık = kendi damlama tavası),
  2 × L 30×30×3 köşebent yan saclara + arka köşe dikmelerine. PM1704 T'nin üstüne dik. Basınç hattı T'nin önünden taban rakoruna (x 380 · z −600).
- Ön boşluk: tartı platformunun önünden (z −522) ön köşe dikmelerine (z 27) 549 mm × x 35…365 × y 156…862.
- Denetim (kesme_v11_check): 238 parça · durağan 0 · hareket 0 · ürün 0 · havada 0 · v10↔v11 yalnız yağ sistemi (3 yeni + 21 değişen) ·
  teneke çıkarma 0 bulgu · raf yükü 4,56 kg → sehim 0,035 mm · hat: basınç 1,53 m, 15 °C kayıp 0,22 bar, regülatör 2,98 bar.
- Açık: öndeki eşya teneke değişiminde alınmalı (istenirse tartı altına teleskopik kızak); v10 açıkları aynen.
