kursatkemalkul/autokitch/_local/claude_son_yerel/gece2/adim8/denetim/cak/cakisma.md

# HAT v3 · v9h · TÜM MODEL ÇAKIŞMA TARAMASI (gece2 adım 8, salt okuma)

Model `hat3_v9h.glb` · 10021 katı bileşen (ROBOT/İNSAN/ZEMİN hariç) · yöntem `govde_denetim_dogru` (0,6 mm örnekleme + iç testi iki yönlü, derinlik = kapsayanın yüzeyine uzaklık, OCC doğrulama) · eşik 0,05 mm.

**Toplam çakışma 1068** · gerçek **108** · kasıtlı 904 · şüpheli 56 · temas (≤0,05 mm) 19683 · incele 0

## GERÇEK BULGULAR (istasyona göre; her grupta derinliğe göre sıralı)

### TOPPING · 79 bulgu

| derinlik mm | A | B | konum x,y,z mm | OCC | öneri |
|---|---|---|---|---|---|
| 10.00 | TOPPING_MODUL__aluminyum · aluminyum#1 | TOPPING_MODUL__paslanmaz__PISTON_SOS · PISTON_SOS#2 | 2254, 1614, -682 | 10.00 | PISTON_SOS#2, aluminyum#1 içine 10.0 mm giriyor: küçük parçayı en kısa yönde ~11 mm kaydır ya da büyük parçada cep/kesik aç |
| 10.00 | TOPPING_MODUL__aluminyum · evap_kaseti_PU | TOPPING_MODUL__paslanmaz__PISTON_HARC · PISTON_HARC#2 | 1716, 1614, -682 | 10.00 | PISTON_HARC#2, evap_kaseti_PU içine 10.0 mm giriyor: küçük parçayı en kısa yönde ~11 mm kaydır ya da büyük parçada cep/kesik aç |
| 10.00 | TOPPING_MODUL__aluminyum · aluminyum#13 | TOPPING_MODUL__paslanmaz__PISTON_KUSBASI · PISTON_KUSBASI#2 | 1842, 1190, -682 | 10.00 | PISTON_KUSBASI#2, aluminyum#13 içine 10.0 mm giriyor: küçük parçayı en kısa yönde ~11 mm kaydır ya da büyük parçada cep/kesik aç |
| 8.00 | TOPPING_MODUL__paslanmaz__PISTON_HARC · soguk_ic_kaplama | TOPPING_MODUL__paslanmaz__PISTON_HARC · yalitim_blogu | 1720, 1614, -569 | 8.00 | yalitim_blogu, soguk_ic_kaplama içine 8.0 mm giriyor: küçük parçayı en kısa yönde ~9 mm kaydır ya da büyük parçada cep/kesik aç |
| 8.00 | TOPPING_MODUL__paslanmaz__PISTON_SOS · soguk_ic_kaplama | TOPPING_MODUL__paslanmaz__PISTON_SOS · yalitim_blogu | 2258, 1614, -569 | 8.00 | yalitim_blogu, soguk_ic_kaplama içine 8.0 mm giriyor: küçük parçayı en kısa yönde ~9 mm kaydır ya da büyük parçada cep/kesik aç |
| 8.00 | TOPPING_MODUL__paslanmaz__PISTON_KUSBASI · soguk_ic_kaplama | TOPPING_MODUL__paslanmaz__PISTON_KUSBASI · yalitim_blogu | 1846, 1190, -569 | 8.00 | yalitim_blogu, soguk_ic_kaplama içine 8.0 mm giriyor: küçük parçayı en kısa yönde ~9 mm kaydır ya da büyük parçada cep/kesik aç |
| 7.83 | TOPPING_MODUL__bakir · bakir#17 | TOPPING_MODUL__bakir · evap_kaseti_ic_sac | 2156, 1441, -700 | 7.84 | evap_kaseti_ic_sac, bakir#17 içine 7.8 mm giriyor: küçük parçayı en kısa yönde ~9 mm kaydır ya da büyük parçada cep/kesik aç |
| 6.34 | TOPPING_MODUL__bakir · evap_kaseti_PU | TOPPING_MODUL__bakir · evap_kaseti_dis_sac | 2172, 1500, -739 | 6.34 | evap_kaseti_PU, evap_kaseti_dis_sac içine 6.3 mm giriyor: küçük parçayı en kısa yönde ~7 mm kaydır ya da büyük parçada cep/kesik aç |
| 6.34 | TOPPING_MODUL__bakir · evap_kaseti_dis_sac | TOPPING_MODUL__bakir · bakir#17 | 2156, 1442, -700 | 6.34 | evap_kaseti_dis_sac, bakir#17 içine 6.3 mm giriyor: küçük parçayı en kısa yönde ~7 mm kaydır ya da büyük parçada cep/kesik aç |
| 6.29 | TOPPING_MODUL__bakir · bakir#12 | TOPPING_MODUL__bakir · bakir#17 | 1622, 1440, -775 | 6.24 | bakir#12, bakir#17 içine 6.3 mm giriyor: küçük parçayı en kısa yönde ~7 mm kaydır ya da büyük parçada cep/kesik aç |
| 6.18 | TOPPING_MODUL__bakir · evap_kaseti_dis_sac | TOPPING_MODUL__bakir · evap_kaseti_ic_sac | 2156, 1449, -700 | 6.14 | evap_kaseti_ic_sac, evap_kaseti_dis_sac içine 6.2 mm giriyor: küçük parçayı en kısa yönde ~7 mm kaydır ya da büyük parçada cep/kesik aç |
| 5.75 | TOPPING_MODUL__aluminyum · evap_kaseti_PU | TOPPING_MODUL__paslanmaz__PISTON_HARC · PISTON_HARC#2 | 1722, 1614, -672 | 5.73 | evap_kaseti_PU, PISTON_HARC#2 içine 5.7 mm giriyor: küçük parçayı en kısa yönde ~7 mm kaydır ya da büyük parçada cep/kesik aç |
| 5.75 | TOPPING_MODUL__aluminyum · aluminyum#14 | TOPPING_MODUL__paslanmaz__PISTON_KUSBASI · PISTON_KUSBASI#2 | 1848, 1190, -672 | 5.73 | aluminyum#14, PISTON_KUSBASI#2 içine 5.7 mm giriyor: küçük parçayı en kısa yönde ~7 mm kaydır ya da büyük parçada cep/kesik aç |
| 5.75 | TOPPING_MODUL__aluminyum · aluminyum#2 | TOPPING_MODUL__paslanmaz__PISTON_SOS · PISTON_SOS#2 | 2260, 1614, -672 | 5.73 | aluminyum#2, PISTON_SOS#2 içine 5.7 mm giriyor: küçük parçayı en kısa yönde ~7 mm kaydır ya da büyük parçada cep/kesik aç |
| 5.11 | TOPPING_MODUL__silikon · silikon#8 | TOPPING_MODUL__silikon · silikon#10 | 2107, 1143, -757 | 5.10 | silikon#10, silikon#8 içine 5.1 mm giriyor: küçük parçayı en kısa yönde ~6 mm kaydır ya da büyük parçada cep/kesik aç |
| 4.39 | TOPPING_MODUL__bakir · bakir#14 | TOPPING_MODUL__bakir · evap_kaseti_ic_sac | 2134, 1446, -700 | 4.39 | evap_kaseti_ic_sac, bakir#14 içine 4.4 mm giriyor: küçük parçayı en kısa yönde ~5 mm kaydır ya da büyük parçada cep/kesik aç |
| 3.52 | TOPPING_MODUL__paslanmaz · soguk_ic_kaplama | TOPPING_DONER__VALF_HARC · VALF_HARC#0 | 1722, 1614, -391 | 0.00 | VALF_HARC#0, soguk_ic_kaplama içine 3.5 mm giriyor: küçük parçayı en kısa yönde ~5 mm kaydır ya da büyük parçada cep/kesik aç |
| 3.19 | TOPPING_MODUL__bakir · evap_kaseti_dis_sac | TOPPING_MODUL__bakir · bakir#14 | 2134, 1448, -700 | 3.19 | evap_kaseti_dis_sac, bakir#14 içine 3.2 mm giriyor: küçük parçayı en kısa yönde ~4 mm kaydır ya da büyük parçada cep/kesik aç |
| 3.09 | TOPPING_MODUL__bakir · evap_kaseti_dis_sac | TOPPING_MODUL__bakir · evap_kaseti_ic_sac | 2134, 1440, -700 | 3.10 | evap_kaseti_ic_sac, evap_kaseti_dis_sac içine 3.1 mm giriyor: küçük parçayı en kısa yönde ~4 mm kaydır ya da büyük parçada cep/kesik aç |
| 3.00 | TOPPING_MODUL__silikon · silikon#9 | TOPPING_MODUL__silikon · silikon#10 | 2108, 1140, -752 | 3.00 | silikon#10, silikon#9 içine 3.0 mm giriyor: küçük parçayı en kısa yönde ~4 mm kaydır ya da büyük parçada cep/kesik aç |
| 2.98 | TOPPING_MODUL__kart · kart#67 | TOPPING_MODUL__kart · kart#83 | 2386, 1716, -715 | 2.96 | kart#67, kart#83 içine 3.0 mm giriyor: küçük parçayı en kısa yönde ~4 mm kaydır ya da büyük parçada cep/kesik aç |
| 2.98 | TOPPING_MODUL__kart · kart#23 | TOPPING_MODUL__kart · kart#39 | 2320, 1716, -715 | 2.96 | kart#23, kart#39 içine 3.0 mm giriyor: küçük parçayı en kısa yönde ~4 mm kaydır ya da büyük parçada cep/kesik aç |
| 2.98 | TOPPING_MODUL__kart · kart#3 | TOPPING_MODUL__kart · kart#17 | 2287, 1716, -715 | 2.96 | kart#3, kart#17 içine 3.0 mm giriyor: küçük parçayı en kısa yönde ~4 mm kaydır ya da büyük parçada cep/kesik aç |
| 2.98 | TOPPING_MODUL__kart · kart#45 | TOPPING_MODUL__kart · kart#61 | 2353, 1716, -715 | 2.96 | kart#45, kart#61 içine 3.0 mm giriyor: küçük parçayı en kısa yönde ~4 mm kaydır ya da büyük parçada cep/kesik aç |
| 2.39 | TOPPING_MODUL__celik · soguk_ic_kaplama | TOPPING_MODUL__paslanmaz · soguk_ic_kaplama | 1722, 1194, -150 | 2.40 | soguk_ic_kaplama, soguk_ic_kaplama içine 2.4 mm giriyor: küçük parçayı en kısa yönde ~3 mm kaydır ya da büyük parçada cep/kesik aç |
| 2.39 | TOPPING_MODUL__celik · soguk_ic_kaplama | TOPPING_MODUL__paslanmaz · soguk_ic_kaplama | 2259, 1194, -150 | 2.40 | soguk_ic_kaplama, soguk_ic_kaplama içine 2.4 mm giriyor: küçük parçayı en kısa yönde ~3 mm kaydır ya da büyük parçada cep/kesik aç |
| 2.02 | TOPPING_MODUL__paslanmaz · paslanmaz#18 | TOPPING_MODUL__paslanmaz · paslanmaz#19 | 2258, 1082, -278 | 1.99 | paslanmaz#18, paslanmaz#19 içine 2.0 mm giriyor: küçük parçayı en kısa yönde ~3 mm kaydır ya da büyük parçada cep/kesik aç |
| 2.02 | TOPPING_MODUL__paslanmaz · paslanmaz#34 | TOPPING_MODUL__paslanmaz · paslanmaz#35 | 1720, 1082, -278 | 1.99 | paslanmaz#34, paslanmaz#35 içine 2.0 mm giriyor: küçük parçayı en kısa yönde ~3 mm kaydır ya da büyük parçada cep/kesik aç |
| 2.00 | TOPPING_MODUL__aluminyum · soguk_ic_kaplama | TOPPING_DONER__VALF_KUSBASI · VALF_KUSBASI#0 | 1805, 1170, -385 | 2.00 | soguk_ic_kaplama, VALF_KUSBASI#0 içine 2.0 mm giriyor: küçük parçayı en kısa yönde ~3 mm kaydır ya da büyük parçada cep/kesik aç |
| 1.00 | TOPPING_DONER__VALF_HARC · VALF_HARC#1 | TOPPING_DONER__VALF_HARC · VALF_HARC#2 | 1789, 1620, -388 | 1.00 | VALF_HARC#1, VALF_HARC#2 içine 1.0 mm giriyor: küçük parçayı en kısa yönde ~2 mm kaydır ya da büyük parçada cep/kesik aç |
| 1.00 | TOPPING_DONER__VALF_KIYMA · VALF_KIYMA#1 | TOPPING_DONER__VALF_KIYMA · VALF_KIYMA#2 | 1663, 1198, -388 | 1.00 | VALF_KIYMA#1, VALF_KIYMA#2 içine 1.0 mm giriyor: küçük parçayı en kısa yönde ~2 mm kaydır ya da büyük parçada cep/kesik aç |
| 1.00 | TOPPING_DONER__VALF_SOS · VALF_SOS#1 | TOPPING_DONER__VALF_SOS · VALF_SOS#2 | 2326, 1620, -388 | 1.00 | VALF_SOS#1, VALF_SOS#2 içine 1.0 mm giriyor: küçük parçayı en kısa yönde ~2 mm kaydır ya da büyük parçada cep/kesik aç |
| 1.00 | TOPPING_DONER__VALF_KUSBASI · VALF_KUSBASI#1 | TOPPING_DONER__VALF_KUSBASI · VALF_KUSBASI#2 | 1915, 1198, -388 | 1.00 | VALF_KUSBASI#1, VALF_KUSBASI#2 içine 1.0 mm giriyor: küçük parçayı en kısa yönde ~2 mm kaydır ya da büyük parçada cep/kesik aç |
| 0.96 | TOPPING_MODUL__paslanmaz · soguk_ic_kaplama | TOPPING_MODUL__saydam_celik · soguk_ic_kaplama | 1860, 1160, -558 | 1.00 | soguk_ic_kaplama, soguk_ic_kaplama içine 1.0 mm giriyor: küçük parçayı en kısa yönde ~2 mm kaydır ya da büyük parçada cep/kesik aç |
| 0.96 | TOPPING_MODUL__paslanmaz · soguk_ic_kaplama | TOPPING_MODUL__saydam_celik · soguk_ic_kaplama | 1860, 1160, -435 | 1.00 | soguk_ic_kaplama, soguk_ic_kaplama içine 1.0 mm giriyor: küçük parçayı en kısa yönde ~2 mm kaydır ya da büyük parçada cep/kesik aç |
| 0.95 | TOPPING_MODUL__motor · motor#25 | TOPPING_MODUL__motor · motor#26 | 1578, 1520, -716 | 0.98 | motor#25, motor#26 içine 1.0 mm giriyor: küçük parçayı en kısa yönde ~2 mm kaydır ya da büyük parçada cep/kesik aç |
| 0.69 | TOPPING_MODUL__kart · kart#65 | TOPPING_MODUL__kart · kart#76 | 2380, 1733, -750 | 0.69 | kart#65, kart#76 içine 0.7 mm giriyor: küçük parçayı en kısa yönde ~2 mm kaydır ya da büyük parçada cep/kesik aç |
| 0.69 | TOPPING_MODUL__kart · kart#21 | TOPPING_MODUL__kart · kart#32 | 2314, 1733, -750 | 0.69 | kart#21, kart#32 içine 0.7 mm giriyor: küçük parçayı en kısa yönde ~2 mm kaydır ya da büyük parçada cep/kesik aç |
| 0.69 | TOPPING_MODUL__kart · kart#1 | TOPPING_MODUL__kart · kart#9 | 2281, 1733, -750 | 0.69 | kart#1, kart#9 içine 0.7 mm giriyor: küçük parçayı en kısa yönde ~2 mm kaydır ya da büyük parçada cep/kesik aç |
| 0.69 | TOPPING_MODUL__kart · kart#43 | TOPPING_MODUL__kart · kart#54 | 2347, 1733, -750 | 0.69 | kart#43, kart#54 içine 0.7 mm giriyor: küçük parçayı en kısa yönde ~2 mm kaydır ya da büyük parçada cep/kesik aç |
| 0.52 | TOPPING_MODUL__kart · kart#6 | TOPPING_MODUL__kart · kart#9 | 2280, 1704, -751 | 0.52 | kart#9, kart#6 içine 0.5 mm giriyor: küçük parçayı en kısa yönde ~2 mm kaydır ya da büyük parçada cep/kesik aç |
| 0.52 | TOPPING_MODUL__kart · kart#71 | TOPPING_MODUL__kart · kart#76 | 2379, 1704, -751 | 0.52 | kart#76, kart#71 içine 0.5 mm giriyor: küçük parçayı en kısa yönde ~2 mm kaydır ya da büyük parçada cep/kesik aç |
| 0.52 | TOPPING_MODUL__kart · kart#27 | TOPPING_MODUL__kart · kart#32 | 2313, 1704, -751 | 0.52 | kart#32, kart#27 içine 0.5 mm giriyor: küçük parçayı en kısa yönde ~2 mm kaydır ya da büyük parçada cep/kesik aç |
| 0.52 | TOPPING_MODUL__kart · kart#49 | TOPPING_MODUL__kart · kart#54 | 2346, 1704, -751 | 0.52 | kart#54, kart#49 içine 0.5 mm giriyor: küçük parçayı en kısa yönde ~2 mm kaydır ya da büyük parçada cep/kesik aç |
| 0.52 | TOPPING_MODUL__kart · kart#67 | TOPPING_MODUL__kart · kart#76 | 2379, 1718, -709 | 0.52 | kart#76, kart#67 içine 0.5 mm giriyor: küçük parçayı en kısa yönde ~2 mm kaydır ya da büyük parçada cep/kesik aç |
| 0.52 | TOPPING_MODUL__kart · kart#3 | TOPPING_MODUL__kart · kart#9 | 2280, 1718, -709 | 0.52 | kart#9, kart#3 içine 0.5 mm giriyor: küçük parçayı en kısa yönde ~2 mm kaydır ya da büyük parçada cep/kesik aç |
| 0.52 | TOPPING_MODUL__kart · kart#45 | TOPPING_MODUL__kart · kart#54 | 2346, 1718, -709 | 0.52 | kart#54, kart#45 içine 0.5 mm giriyor: küçük parçayı en kısa yönde ~2 mm kaydır ya da büyük parçada cep/kesik aç |
| 0.52 | TOPPING_MODUL__kart · kart#23 | TOPPING_MODUL__kart · kart#32 | 2313, 1718, -709 | 0.52 | kart#32, kart#23 içine 0.5 mm giriyor: küçük parçayı en kısa yönde ~2 mm kaydır ya da büyük parçada cep/kesik aç |
| 0.45 | TOPPING_MODUL__paslanmaz · paslanmaz#18 | TOPPING_MODUL__pom · pom#1 | 2260, 1085, -162 | 0.45 | 0.45 mm bindirme (ölçü yuvarlaması): paslanmaz#18 ya da pom#1 0.9 mm geri çekilsin |
| 0.45 | TOPPING_MODUL__paslanmaz · paslanmaz#34 | TOPPING_MODUL__pom · pom#4 | 1722, 1085, -162 | 0.45 | 0.45 mm bindirme (ölçü yuvarlaması): paslanmaz#34 ya da pom#4 0.9 mm geri çekilsin |
| 0.43 | TOPPING_DONER__HELEZON_KASAR · HELEZON_KASAR#2 | TOPPING_DONER__HELEZON_KASAR · HELEZON_KASAR#16 | 2085, 1182, -546 | 0.42 | 0.43 mm bindirme (ölçü yuvarlaması): HELEZON_KASAR#2 ya da HELEZON_KASAR#16 0.9 mm geri çekilsin |
| 0.43 | TOPPING_DONER__KARISTIRICI_KASAR · KARISTIRICI_KASAR#8 | TOPPING_DONER__KARISTIRICI_KASAR · KARISTIRICI_KASAR#23 | 2085, 1337, -546 | 0.42 | 0.43 mm bindirme (ölçü yuvarlaması): KARISTIRICI_KASAR#8 ya da KARISTIRICI_KASAR#23 0.9 mm geri çekilsin |
| 0.43 | TOPPING_DONER__HELEZON_SUCUK · HELEZON_SUCUK#2 | TOPPING_DONER__HELEZON_SUCUK · HELEZON_SUCUK#16 | 2357, 1202, -546 | 0.42 | 0.43 mm bindirme (ölçü yuvarlaması): HELEZON_SUCUK#2 ya da HELEZON_SUCUK#16 0.9 mm geri çekilsin |
| 0.43 | TOPPING_DONER__KARISTIRICI_SUCUK · KARISTIRICI_SUCUK#6 | TOPPING_DONER__KARISTIRICI_SUCUK · KARISTIRICI_SUCUK#21 | 2357, 1306, -546 | 0.42 | 0.43 mm bindirme (ölçü yuvarlaması): KARISTIRICI_SUCUK#6 ya da KARISTIRICI_SUCUK#21 0.9 mm geri çekilsin |
| 0.36 | TOPPING_MODUL__kart · kart#83 | TOPPING_MODUL__kart · kart#85 | 2392, 1742, -745 | 0.38 | 0.36 mm bindirme (ölçü yuvarlaması): kart#83 ya da kart#85 0.9 mm geri çekilsin |
| 0.36 | TOPPING_MODUL__kart · kart#39 | TOPPING_MODUL__kart · kart#41 | 2326, 1742, -745 | 0.38 | 0.36 mm bindirme (ölçü yuvarlaması): kart#39 ya da kart#41 0.9 mm geri çekilsin |
| 0.36 | TOPPING_MODUL__kart · kart#61 | TOPPING_MODUL__kart · kart#63 | 2359, 1742, -745 | 0.38 | 0.36 mm bindirme (ölçü yuvarlaması): kart#61 ya da kart#63 0.9 mm geri çekilsin |
| 0.36 | TOPPING_MODUL__kart · kart#17 | TOPPING_MODUL__kart · kart#19 | 2293, 1742, -745 | 0.38 | 0.36 mm bindirme (ölçü yuvarlaması): kart#17 ya da kart#19 0.9 mm geri çekilsin |
| 0.34 | TOPPING_MODUL__celik__ARABA · doner_yatak | TOPPING_MODUL__sac__ARABA · siyirici_apron | 1182, 951, -192 | 0.39 | 0.34 mm bindirme (ölçü yuvarlaması): doner_yatak ya da siyirici_apron 0.8 mm geri çekilsin |
| 0.19 | TOPPING_MODUL__paslanmaz · soguk_ic_kaplama | TOPPING_DONER__VALF_KUSBASI · VALF_KUSBASI#0 | 1840, 1169, -396 | 0.24 | 0.19 mm bindirme (ölçü yuvarlaması): soguk_ic_kaplama ya da VALF_KUSBASI#0 0.7 mm geri çekilsin |
| 0.19 | TOPPING_MODUL__paslanmaz · soguk_ic_kaplama | TOPPING_DONER__VALF_SOS · VALF_SOS#0 | 2251, 1592, -396 | 0.24 | 0.19 mm bindirme (ölçü yuvarlaması): soguk_ic_kaplama ya da VALF_SOS#0 0.7 mm geri çekilsin |
| 0.13 | TOPPING_MODUL__kart · kart#10 | TOPPING_MODUL__kart · kart#17 | 2284, 1708, -706 | 0.10 | 0.13 mm bindirme (ölçü yuvarlaması): kart#10 ya da kart#17 0.6 mm geri çekilsin |
| 0.13 | TOPPING_MODUL__kart · kart#77 | TOPPING_MODUL__kart · kart#83 | 2384, 1708, -706 | 0.14 | 0.13 mm bindirme (ölçü yuvarlaması): kart#77 ya da kart#83 0.6 mm geri çekilsin |
| 0.13 | TOPPING_MODUL__kart · kart#33 | TOPPING_MODUL__kart · kart#39 | 2317, 1708, -706 | 0.10 | 0.13 mm bindirme (ölçü yuvarlaması): kart#33 ya da kart#39 0.6 mm geri çekilsin |
| 0.13 | TOPPING_MODUL__kart · kart#55 | TOPPING_MODUL__kart · kart#61 | 2350, 1708, -706 | 0.10 | 0.13 mm bindirme (ölçü yuvarlaması): kart#55 ya da kart#61 0.6 mm geri çekilsin |
| 0.13 | TOPPING_MODUL__celik · x_tahrik_kasnagi | TOPPING_MODUL__koyu · x_kayisi_sarim_sol | 873, 916, -367 | 0.10 | 0.13 mm bindirme (ölçü yuvarlaması): x_tahrik_kasnagi ya da x_kayisi_sarim_sol 0.6 mm geri çekilsin |
| 0.11 | TOPPING_MODUL__kart · kart#27 | TOPPING_MODUL__kart · kart#39 | 2314, 1702, -757 | 0.11 | 0.11 mm bindirme (ölçü yuvarlaması): kart#27 ya da kart#39 0.6 mm geri çekilsin |
| 0.11 | TOPPING_MODUL__kart · kart#49 | TOPPING_MODUL__kart · kart#61 | 2347, 1702, -757 | 0.11 | 0.11 mm bindirme (ölçü yuvarlaması): kart#49 ya da kart#61 0.6 mm geri çekilsin |
| 0.11 | TOPPING_MODUL__kart · kart#71 | TOPPING_MODUL__kart · kart#83 | 2380, 1702, -757 | 0.11 | 0.11 mm bindirme (ölçü yuvarlaması): kart#71 ya da kart#83 0.6 mm geri çekilsin |
| 0.11 | TOPPING_MODUL__kart · kart#6 | TOPPING_MODUL__kart · kart#17 | 2281, 1702, -757 | 0.11 | 0.11 mm bindirme (ölçü yuvarlaması): kart#6 ya da kart#17 0.6 mm geri çekilsin |
| 0.08 | TOPPING_MODUL__kart · kart#64 | TOPPING_MODUL__kart · kart#83 | 2373, 1741, -751 | 0.04 | 0.08 mm bindirme (ölçü yuvarlaması): kart#64 ya da kart#83 0.6 mm geri çekilsin |
| 0.08 | TOPPING_MODUL__kart · kart#42 | TOPPING_MODUL__kart · kart#61 | 2340, 1741, -751 | 0.04 | 0.08 mm bindirme (ölçü yuvarlaması): kart#42 ya da kart#61 0.6 mm geri çekilsin |
| 0.08 | TOPPING_MODUL__kart · kart#0 | TOPPING_MODUL__kart · kart#17 | 2274, 1741, -751 | 0.04 | 0.08 mm bindirme (ölçü yuvarlaması): kart#0 ya da kart#17 0.6 mm geri çekilsin |
| 0.08 | TOPPING_MODUL__kart · kart#20 | TOPPING_MODUL__kart · kart#39 | 2307, 1741, -751 | 0.04 | 0.08 mm bindirme (ölçü yuvarlaması): kart#20 ya da kart#39 0.6 mm geri çekilsin |
| 0.06 | TOPPING_DONER__TABLA · TABLA#4 | TOPPING_DONER__TABLA · TABLA#35 | 1174, 982, -22 | 0.07 | 0.06 mm bindirme (ölçü yuvarlaması): TABLA#4 ya da TABLA#35 0.6 mm geri çekilsin |
| 0.06 | TOPPING_DONER__TABLA · TABLA#26 | TOPPING_DONER__TABLA · TABLA#46 | 1182, 988, -330 | 0.02 | 0.06 mm bindirme (ölçü yuvarlaması): TABLA#26 ya da TABLA#46 0.6 mm geri çekilsin |
| 0.06 | TOPPING_DONER__TABLA · TABLA#4 | TOPPING_DONER__TABLA · TABLA#41 | 1174, 982, -318 | 0.07 | 0.06 mm bindirme (ölçü yuvarlaması): TABLA#4 ya da TABLA#41 0.6 mm geri çekilsin |
| 0.06 | TOPPING_DONER__TABLA · TABLA#4 | TOPPING_DONER__TABLA · TABLA#40 | 1084, 982, -318 | 0.07 | 0.06 mm bindirme (ölçü yuvarlaması): TABLA#4 ya da TABLA#40 0.6 mm geri çekilsin |
| 0.06 | TOPPING_DONER__TABLA · TABLA#4 | TOPPING_DONER__TABLA · TABLA#34 | 1084, 982, -22 | 0.07 | 0.06 mm bindirme (ölçü yuvarlaması): TABLA#4 ya da TABLA#34 0.6 mm geri çekilsin |

### QR · 12 bulgu

| derinlik mm | A | B | konum x,y,z mm | OCC | öneri |
|---|---|---|---|---|---|
| 1.34 | ELK_QR_KABLO__kablo_sinyal · goz_21_isitici_kablosu | ELK_QR_KABLO__kablo_sinyal · qrk_ana_hat_veri_MODEM_Cat6A | 4806, 853, 1000 | 1.33 | goz_21_isitici_kablosu, qrk_ana_hat_veri_MODEM_Cat6A içine 1.3 mm giriyor: küçük parçayı en kısa yönde ~2 mm kaydır ya da büyük parçada cep/kesik aç |
| 1.34 | ELK_QR_KABLO__kablo_sinyal · goz_51_isitici_kablosu | ELK_QR_KABLO__kablo_sinyal · qrk_ana_hat_veri_MODEM_Cat6A | 4806, 1453, 1000 | 1.33 | goz_51_isitici_kablosu, qrk_ana_hat_veri_MODEM_Cat6A içine 1.3 mm giriyor: küçük parçayı en kısa yönde ~2 mm kaydır ya da büyük parçada cep/kesik aç |
| 1.34 | ELK_QR_KABLO__kablo_sinyal · goz_11_isitici_kablosu | ELK_QR_KABLO__kablo_sinyal · qrk_ana_hat_veri_MODEM_Cat6A | 4806, 653, 1000 | 1.33 | goz_11_isitici_kablosu, qrk_ana_hat_veri_MODEM_Cat6A içine 1.3 mm giriyor: küçük parçayı en kısa yönde ~2 mm kaydır ya da büyük parçada cep/kesik aç |
| 1.34 | ELK_QR_KABLO__kablo_sinyal · goz_41_isitici_kablosu | ELK_QR_KABLO__kablo_sinyal · qrk_ana_hat_veri_MODEM_Cat6A | 4806, 1253, 1000 | 1.33 | goz_41_isitici_kablosu, qrk_ana_hat_veri_MODEM_Cat6A içine 1.3 mm giriyor: küçük parçayı en kısa yönde ~2 mm kaydır ya da büyük parçada cep/kesik aç |
| 1.34 | ELK_QR_KABLO__kablo_sinyal · goz_31_isitici_kablosu | ELK_QR_KABLO__kablo_sinyal · qrk_ana_hat_veri_MODEM_Cat6A | 4806, 1053, 1000 | 1.33 | goz_31_isitici_kablosu, qrk_ana_hat_veri_MODEM_Cat6A içine 1.3 mm giriyor: küçük parçayı en kısa yönde ~2 mm kaydır ya da büyük parçada cep/kesik aç |
| 1.34 | ELK_QR_KABLO__kablo_sinyal · goz_50_isitici_kablosu | ELK_QR_KABLO__kablo_sinyal · qrk_ana_hat_veri_QR_Cat6A | 4784, 1453, 1000 | 1.33 | goz_50_isitici_kablosu, qrk_ana_hat_veri_QR_Cat6A içine 1.3 mm giriyor: küçük parçayı en kısa yönde ~2 mm kaydır ya da büyük parçada cep/kesik aç |
| 1.34 | ELK_QR_KABLO__kablo_sinyal · goz_30_isitici_kablosu | ELK_QR_KABLO__kablo_sinyal · qrk_ana_hat_veri_QR_Cat6A | 4784, 1053, 1000 | 1.33 | goz_30_isitici_kablosu, qrk_ana_hat_veri_QR_Cat6A içine 1.3 mm giriyor: küçük parçayı en kısa yönde ~2 mm kaydır ya da büyük parçada cep/kesik aç |
| 1.34 | ELK_QR_KABLO__kablo_sinyal · goz_40_isitici_kablosu | ELK_QR_KABLO__kablo_sinyal · qrk_ana_hat_veri_QR_Cat6A | 4784, 1253, 1000 | 1.33 | goz_40_isitici_kablosu, qrk_ana_hat_veri_QR_Cat6A içine 1.3 mm giriyor: küçük parçayı en kısa yönde ~2 mm kaydır ya da büyük parçada cep/kesik aç |
| 1.34 | ELK_QR_KABLO__kablo_sinyal · goz_10_isitici_kablosu | ELK_QR_KABLO__kablo_sinyal · qrk_ana_hat_veri_QR_Cat6A | 4784, 653, 1000 | 1.33 | goz_10_isitici_kablosu, qrk_ana_hat_veri_QR_Cat6A içine 1.3 mm giriyor: küçük parçayı en kısa yönde ~2 mm kaydır ya da büyük parçada cep/kesik aç |
| 1.34 | ELK_QR_KABLO__kablo_sinyal · goz_20_isitici_kablosu | ELK_QR_KABLO__kablo_sinyal · qrk_ana_hat_veri_QR_Cat6A | 4784, 853, 1000 | 1.33 | goz_20_isitici_kablosu, qrk_ana_hat_veri_QR_Cat6A içine 1.3 mm giriyor: küçük parçayı en kısa yönde ~2 mm kaydır ya da büyük parçada cep/kesik aç |
| 1.32 | ELK_QR_KABLO__kablo_sinyal · goz_01_isitici_kablosu | ELK_QR_KABLO__kablo_sinyal · qrk_ana_hat_veri_MODEM_Cat6A | 4806, 452, 1000 | 1.35 | goz_01_isitici_kablosu, qrk_ana_hat_veri_MODEM_Cat6A içine 1.3 mm giriyor: küçük parçayı en kısa yönde ~2 mm kaydır ya da büyük parçada cep/kesik aç |
| 1.32 | ELK_QR_KABLO__kablo_sinyal · goz_00_isitici_kablosu | ELK_QR_KABLO__kablo_sinyal · qrk_ana_hat_veri_QR_Cat6A | 4784, 452, 1000 | 1.35 | goz_00_isitici_kablosu, qrk_ana_hat_veri_QR_Cat6A içine 1.3 mm giriyor: küçük parçayı en kısa yönde ~2 mm kaydır ya da büyük parçada cep/kesik aç |

### F · 5 bulgu

| derinlik mm | A | B | konum x,y,z mm | OCC | öneri |
|---|---|---|---|---|---|
| 0.50 | F_DONER__RULO_TP_CIKIS · RULO_TP_CIKIS#0 | F_DONER__RULO_TP_CIKIS · RULO_TP_CIKIS#2 | 3990, 972, -393 | 0.50 | RULO_TP_CIKIS#2, RULO_TP_CIKIS#0 içine 0.5 mm giriyor: küçük parçayı en kısa yönde ~2 mm kaydır ya da büyük parçada cep/kesik aç |
| 0.31 | F_DONER__RULO_TP_GIRIS · RULO_TP_GIRIS#0 | F_DONER__RULO_TP_GIRIS · RULO_TP_GIRIS#2 | 2875, 953, -393 | 0.31 | 0.31 mm bindirme (ölçü yuvarlaması): RULO_TP_GIRIS#0 ya da RULO_TP_GIRIS#2 0.8 mm geri çekilsin |
| 0.13 | F_YUKLEME_BANDI__koyu · yb_gt2_kayis | F_DONER__RULO_GB_TAHRIK · RULO_GB_TAHRIK#0 | 2838, 985, -428 | 0.12 | 0.13 mm bindirme (ölçü yuvarlaması): yb_gt2_kayis ya da RULO_GB_TAHRIK#0 0.6 mm geri çekilsin |
| 0.10 | F_TP10_KONVEYOR__paslanmaz · on_ray | F_DONER__RULO_TP_GIRIS · RULO_TP_GIRIS#1 | 2892, 972, -4 | 0.10 | 0.10 mm bindirme (ölçü yuvarlaması): on_ray ya da RULO_TP_GIRIS#1 0.6 mm geri çekilsin |
| 0.10 | F_TP10_KONVEYOR__paslanmaz · arka_ray | F_DONER__RULO_TP_GIRIS · RULO_TP_GIRIS#1 | 2892, 972, -404 | 0.10 | 0.10 mm bindirme (ölçü yuvarlaması): arka_ray ya da RULO_TP_GIRIS#1 0.6 mm geri çekilsin |

### B · 5 bulgu

| derinlik mm | A | B | konum x,y,z mm | OCC | öneri |
|---|---|---|---|---|---|
| 0.25 | B_SOGUTMA__plastik · gider_ana_hatti_borusu | B_SOGUTMA__plastik · gider_ana_hatti_kelepcesi_K6 | 3700, 173, -734 | 0.23 | 0.25 mm bindirme (ölçü yuvarlaması): gider_ana_hatti_borusu ya da gider_ana_hatti_kelepcesi_K6 0.8 mm geri çekilsin |
| 0.23 | B_SOGUTMA__plastik · gider_ana_hatti_borusu | B_SOGUTMA__plastik · gider_ana_hatti_kelepcesi_K5 | 3250, 178, -734 | 0.22 | 0.23 mm bindirme (ölçü yuvarlaması): gider_ana_hatti_borusu ya da gider_ana_hatti_kelepcesi_K5 0.7 mm geri çekilsin |
| 0.08 | B_SOGUTMA__bakir · sicak_gaz_serpantini | DUZ_B_SERPANTIN__plastik · serpantin_tutucu_2 | 4339, 129, -770 | 0.10 | 0.08 mm bindirme (ölçü yuvarlaması): sicak_gaz_serpantini ya da serpantin_tutucu_2 0.6 mm geri çekilsin |
| 0.08 | B_SOGUTMA__bakir · sicak_gaz_serpantini | DUZ_B_SERPANTIN__plastik · serpantin_tutucu_0 | 4074, 129, -720 | 0.10 | 0.08 mm bindirme (ölçü yuvarlaması): sicak_gaz_serpantini ya da serpantin_tutucu_0 0.6 mm geri çekilsin |
| 0.08 | B_SOGUTMA__bakir · sicak_gaz_serpantini | DUZ_B_SERPANTIN__plastik · serpantin_tutucu_1 | 4219, 129, -720 | 0.10 | 0.08 mm bindirme (ölçü yuvarlaması): sicak_gaz_serpantini ya da serpantin_tutucu_1 0.6 mm geri çekilsin |

### E · 6 bulgu

| derinlik mm | A | B | konum x,y,z mm | OCC | öneri |
|---|---|---|---|---|---|
| 0.23 | E_KOSE__CNR_PF · kose_CNR_PF_kaplin | E_KOSE__CNR_PF · kose_CNR_PF_sifir_bayragi | 4499, 1410, -49 | 0.25 | 0.23 mm bindirme (ölçü yuvarlaması): kose_CNR_PF_kaplin ya da kose_CNR_PF_sifir_bayragi 0.7 mm geri çekilsin |
| 0.23 | E_KOSE__CNR_MF · kose_CNR_MF_kaplin | E_KOSE__CNR_MF · kose_CNR_MF_sifir_bayragi | 4503, 1413, -379 | 0.23 | 0.23 mm bindirme (ölçü yuvarlaması): kose_CNR_MF_kaplin ya da kose_CNR_MF_sifir_bayragi 0.7 mm geri çekilsin |
| 0.23 | E_KOSE__CNR_PB · kose_CNR_PB_kaplin | E_KOSE__CNR_PB · kose_CNR_PB_sifir_bayragi | 4817, 1413, -33 | 0.23 | 0.23 mm bindirme (ölçü yuvarlaması): kose_CNR_PB_kaplin ya da kose_CNR_PB_sifir_bayragi 0.7 mm geri çekilsin |
| 0.23 | E_KOSE__CNR_MB · kose_CNR_MB_kaplin | E_KOSE__CNR_MB · kose_CNR_MB_sifir_bayragi | 4821, 1410, -363 | 0.25 | 0.23 mm bindirme (ölçü yuvarlaması): kose_CNR_MB_kaplin ya da kose_CNR_MB_sifir_bayragi 0.7 mm geri çekilsin |
| 0.14 | E_KOSE__aluminyum__CNR_LIFT · CNR_LIFT#0 | E_KOSE__CNR_PF · kose_CNR_PF_kaplin | 4496, 1399, -36 | 0.18 | 0.14 mm bindirme (ölçü yuvarlaması): CNR_LIFT#0 ya da kose_CNR_PF_kaplin 0.6 mm geri çekilsin |
| 0.06 | E_BESLEYICI__aluminyum__VAC_Y · vakum_manifold | E_BESLEYICI__vakum_kaucuk__VAC_Y · vakum_dagitim_hatti | 4880, 1024, -763 | 0.08 | 0.06 mm bindirme (ölçü yuvarlaması): vakum_manifold ya da vakum_dagitim_hatti 0.6 mm geri çekilsin |

### A · 1 bulgu

| derinlik mm | A | B | konum x,y,z mm | OCC | öneri |
|---|---|---|---|---|---|
| 0.15 | TOPPING_DONER__KONI_ON · KONI_ON#0 | TOPPING_DONER__KONI_ARKA · KONI_ARKA#0 | 1086, 1068, -170 | 0.16 | 0.15 mm bindirme (ölçü yuvarlaması): KONI_ON#0 ya da KONI_ARKA#0 0.7 mm geri çekilsin |

## ŞÜPHELİ · KABLO↔KABLO DEMET İÇİ GEÇİŞ (8 çift, en derin 2.9 mm) — kablo çiftine göre özet

Ana hat / QR kablo demetlerinde kablolar aynı güzergâhta birbirinin içinden geçiyor. Üretimde sorun değil ama model ölçüsü yanlış: demet içi kablolar yan yana/üst üste ofsetlenmeli (kablo çapı kadar). Tam liste cakisma.json'da.

| kablo A | kablo B | çift | en derin mm | örnek konum |
|---|---|---|---|---|
| hava_hortumu_DGRF_on | hava_hortumu_giris | 2 | 2.91 | 4223, 1600, -700 |
| hava_hortumu_giris | hava_hortumu_DGRF_arka | 2 | 2.91 | 4115, 1600, -700 |
| hava_hortumu_X_1 | hava_hortumu_X_0 | 4 | 1.94 | 4357, 1399, -724 |

## ŞÜPHELİ · DİĞER (48)

| derinlik mm | A | B | istasyon | konum x,y,z mm | neden |
|---|---|---|---|---|---|
| 32.58 | CEK_K3_hamur_3__hamur__CEKMECE · CEK_K3_hamur_3_top_2_1 | URUN__top · top#0 | B | 2416, 447, -358 | görsel ürün/sarf (hamur, pizza, kutu, teneke) yerleşimi |
| 31.64 | K_GOVDE__kabuk · sol_sac_urun_girisi | K_YAG__hortum_yag · yag_donus_hortumu_TLM0806 | K | 4002, 1800, -202 | SAHTE olası: OCC derinlik 0 ve iki yüzey kesişmiyor (VTK iç testi kötü ağda yanıldı) |
| 20.74 | CEK_K3_hamur_3__silikon__CEKMECE · CEK_K3_hamur_3_tepsi | URUN__top · top#0 | B | 2432, 434, -356 | görsel ürün/sarf (hamur, pizza, kutu, teneke) yerleşimi |
| 20.18 | CEK_K3_hamur_3__hamur__CEKMECE · CEK_K3_hamur_3_top_2_2 | URUN__top · top#0 | B | 2418, 447, -306 | görsel ürün/sarf (hamur, pizza, kutu, teneke) yerleşimi |
| 12.31 | K_GOVDE__kabuk · sol_sac_urun_girisi | K_GOVDE__kabuk · ust_sac | K | 4002, 1848, 43 | SAHTE olası: OCC derinlik 0 ve iki yüzey kesişmiyor (VTK iç testi kötü ağda yanıldı) |
| 11.14 | CEK_K3_hamur_3__sac__CEKMECE · CEK_K3_hamur_3_kutu_2.0_1.0 | URUN__top · top#0 | B | 2400, 424, -356 | görsel ürün/sarf (hamur, pizza, kutu, teneke) yerleşimi |
| 3.72 | TOPPING_MODUL__celik · st_tahrik_diski | TOPPING_MODUL__miknatis · st_tahrik_miknatisi_3 | TOPPING | 2452, 986, -361 | gömülü mıknatıs; diskte cep modellenmemiş |
| 3.72 | TOPPING_MODUL__celik · st_tahrik_diski | TOPPING_MODUL__miknatis · st_tahrik_miknatisi_1 | TOPPING | 2461, 1000, -361 | gömülü mıknatıs; diskte cep modellenmemiş |
| 3.72 | TOPPING_MODUL__celik · st_tahrik_diski | TOPPING_MODUL__miknatis · st_tahrik_miknatisi_4 | TOPPING | 2461, 975, -361 | gömülü mıknatıs; diskte cep modellenmemiş |
| 3.72 | TOPPING_MODUL__celik · st_tahrik_diski | TOPPING_MODUL__miknatis · st_tahrik_miknatisi_2 | TOPPING | 2452, 990, -361 | gömülü mıknatıs; diskte cep modellenmemiş |
| 3.72 | TOPPING_MODUL__celik · st_tahrik_diski | TOPPING_MODUL__miknatis · st_tahrik_miknatisi_5 | TOPPING | 2472, 981, -361 | gömülü mıknatıs; diskte cep modellenmemiş |
| 3.72 | TOPPING_MODUL__celik · st_tahrik_diski | TOPPING_MODUL__miknatis · st_tahrik_miknatisi_0 | TOPPING | 2472, 993, -361 | gömülü mıknatıs; diskte cep modellenmemiş |
| 2.00 | TOPPING_MODUL__aluminyum · kiyma__valf_dondurme_aktuatoru | TOPPING_DONER__VALF_KIYMA · VALF_KIYMA#0 | TOPPING | 1553, 1170, -385 | döner valf ↔ valf bloğu/aktüatör (mil-yuva geçmesi olası; yuva boşluğu modellenmemiş) |
| 2.00 | TOPPING_MODUL__aluminyum · sos__valf_blogu | TOPPING_DONER__VALF_HARC · VALF_HARC#0 | TOPPING | 1679, 1593, -385 | döner valf ↔ valf bloğu/aktüatör (mil-yuva geçmesi olası; yuva boşluğu modellenmemiş) |
| 2.00 | TOPPING_MODUL__aluminyum · harc__valf_blogu | TOPPING_DONER__VALF_SOS · VALF_SOS#0 | TOPPING | 2216, 1593, -385 | döner valf ↔ valf bloğu/aktüatör (mil-yuva geçmesi olası; yuva boşluğu modellenmemiş) |
| 0.74 | TOPPING_MODUL__paslanmaz · kiyma__cikis_tc_kelepcesi | TOPPING_MODUL__paslanmaz · kiyma__cikis_tc_ferrule_valf | TOPPING | 1599, 1165, -248 | TC kelepçe ↔ ferrule oturması (kelepçe kanal profili basit) |
| 0.19 | TOPPING_MODUL__paslanmaz · kiyma__valf_blogu | TOPPING_DONER__VALF_KIYMA · VALF_KIYMA#0 | TOPPING | 1588, 1169, -396 | döner valf ↔ valf bloğu/aktüatör (mil-yuva geçmesi olası; yuva boşluğu modellenmemiş) |
| 0.09 | TOPPING_MODUL__on_seffaf · onyuz_kilavuz_flipper | TOPPING_MODUL__pom · pom#29 | TOPPING | 1992, 1158, 3 | kapak/kanat (kpk) parçası; kapalı konumda bindirme |
| 0.08 | K_GOVDE__sac · kose_dikmesi_380_42 | K_GOVDE__siyah · onyuz_kapak_K_basac_0 | K | 4374, 1006, 55 | kapak/kanat (kpk) parçası; kapalı konumda bindirme |
| 0.08 | K_GOVDE__sac · kose_dikmesi_380_42 | K_GOVDE__siyah · onyuz_kapak_K_basac_2 | K | 4372, 1796, 55 | kapak/kanat (kpk) parçası; kapalı konumda bindirme |
| 0.08 | K_GOVDE__sac · kose_dikmesi_380_42 | K_GOVDE__siyah · onyuz_kapak_K_basac_1 | K | 4372, 1426, 55 | kapak/kanat (kpk) parçası; kapalı konumda bindirme |
| 0.07 | TOPPING_MODUL__on_seffaf · on_seffaf#0 | TOPPING_MODUL__on_seffaf · on_seffaf#4 | TOPPING | 1943, 1647, 34 | kapak/kanat (kpk) parçası; kapalı konumda bindirme |
| 0.07 | TOPPING_MODUL__on_seffaf · on_seffaf#0 | TOPPING_MODUL__on_seffaf · on_seffaf#3 | TOPPING | 1943, 1187, 34 | kapak/kanat (kpk) parçası; kapalı konumda bindirme |
| 0.07 | TOPPING_MODUL__on_seffaf · on_seffaf#0 | TOPPING_MODUL__on_seffaf · on_seffaf#5 | TOPPING | 1943, 2087, 34 | kapak/kanat (kpk) parçası; kapalı konumda bindirme |
| 0.07 | ELK_QR_MONTAJ__celik · goz_31_kapak_kulagi_0 | QR_GOZLER__celik__GOZ_31_KAPAK · goz_31_kapak_mili | QR | 4858, 1232, 684 | kapak/kanat (kpk) parçası; kapalı konumda bindirme |
| 0.07 | ELK_QR_MONTAJ__celik · goz_21_kapak_kulagi_0 | QR_GOZLER__celik__GOZ_21_KAPAK · goz_21_kapak_mili | QR | 4858, 1032, 684 | kapak/kanat (kpk) parçası; kapalı konumda bindirme |
| 0.07 | ELK_QR_MONTAJ__celik · goz_10_kapak_kulagi_1 | QR_GOZLER__celik__GOZ_10_KAPAK · goz_10_kapak_mili | QR | 4748, 832, 684 | kapak/kanat (kpk) parçası; kapalı konumda bindirme |
| 0.07 | ELK_QR_MONTAJ__celik · goz_11_kapak_kulagi_0 | QR_GOZLER__celik__GOZ_11_KAPAK · goz_11_kapak_mili | QR | 4858, 832, 684 | kapak/kanat (kpk) parçası; kapalı konumda bindirme |
| 0.07 | ELK_QR_MONTAJ__celik · goz_41_kapak_kulagi_0 | QR_GOZLER__celik__GOZ_41_KAPAK · goz_41_kapak_mili | QR | 4858, 1432, 684 | kapak/kanat (kpk) parçası; kapalı konumda bindirme |
| 0.07 | ELK_QR_MONTAJ__celik · goz_21_kapak_kulagi_1 | QR_GOZLER__celik__GOZ_21_KAPAK · goz_21_kapak_mili | QR | 5158, 1032, 684 | kapak/kanat (kpk) parçası; kapalı konumda bindirme |
| 0.07 | ELK_QR_MONTAJ__celik · goz_10_kapak_kulagi_0 | QR_GOZLER__celik__GOZ_10_KAPAK · goz_10_kapak_mili | QR | 4448, 832, 684 | kapak/kanat (kpk) parçası; kapalı konumda bindirme |
| 0.07 | ELK_QR_MONTAJ__celik · goz_01_kapak_kulagi_1 | QR_GOZLER__celik__GOZ_01_KAPAK · goz_01_kapak_mili | QR | 5158, 632, 684 | kapak/kanat (kpk) parçası; kapalı konumda bindirme |
| 0.07 | ELK_QR_MONTAJ__celik · goz_20_kapak_kulagi_0 | QR_DONER__GOZ_20_KAPAK · GOZ_20_KAPAK#0 | QR | 4448, 1032, 684 | kapak/kanat (kpk) parçası; kapalı konumda bindirme |
| 0.07 | ELK_QR_MONTAJ__celik · goz_30_kapak_kulagi_0 | QR_GOZLER__celik__GOZ_30_KAPAK · goz_30_kapak_mili | QR | 4448, 1232, 684 | kapak/kanat (kpk) parçası; kapalı konumda bindirme |
| 0.07 | ELK_QR_MONTAJ__celik · goz_31_kapak_kulagi_1 | QR_GOZLER__celik__GOZ_31_KAPAK · goz_31_kapak_mili | QR | 5158, 1232, 684 | kapak/kanat (kpk) parçası; kapalı konumda bindirme |
| 0.07 | ELK_QR_MONTAJ__celik · goz_51_kapak_kulagi_1 | QR_GOZLER__celik__GOZ_51_KAPAK · goz_51_kapak_mili | QR | 5158, 1632, 684 | kapak/kanat (kpk) parçası; kapalı konumda bindirme |
| 0.07 | ELK_QR_MONTAJ__celik · goz_41_kapak_kulagi_1 | QR_GOZLER__celik__GOZ_41_KAPAK · goz_41_kapak_mili | QR | 5158, 1432, 684 | kapak/kanat (kpk) parçası; kapalı konumda bindirme |
| 0.07 | ELK_QR_MONTAJ__celik · goz_40_kapak_kulagi_1 | QR_GOZLER__celik__GOZ_40_KAPAK · goz_40_kapak_mili | QR | 4748, 1432, 684 | kapak/kanat (kpk) parçası; kapalı konumda bindirme |
| 0.07 | ELK_QR_MONTAJ__celik · goz_51_kapak_kulagi_0 | QR_GOZLER__celik__GOZ_51_KAPAK · goz_51_kapak_mili | QR | 4858, 1632, 684 | kapak/kanat (kpk) parçası; kapalı konumda bindirme |
| 0.07 | ELK_QR_MONTAJ__celik · goz_20_kapak_kulagi_1 | QR_DONER__GOZ_20_KAPAK · GOZ_20_KAPAK#0 | QR | 4748, 1032, 684 | kapak/kanat (kpk) parçası; kapalı konumda bindirme |
| 0.07 | ELK_QR_MONTAJ__celik · goz_30_kapak_kulagi_1 | QR_GOZLER__celik__GOZ_30_KAPAK · goz_30_kapak_mili | QR | 4748, 1232, 684 | kapak/kanat (kpk) parçası; kapalı konumda bindirme |
| 0.07 | ELK_QR_MONTAJ__celik · goz_00_kapak_kulagi_0 | QR_GOZLER__celik__GOZ_00_KAPAK · goz_00_kapak_mili | QR | 4448, 632, 684 | kapak/kanat (kpk) parçası; kapalı konumda bindirme |
| 0.07 | ELK_QR_MONTAJ__celik · goz_50_kapak_kulagi_0 | QR_GOZLER__celik__GOZ_50_KAPAK · goz_50_kapak_mili | QR | 4448, 1632, 684 | kapak/kanat (kpk) parçası; kapalı konumda bindirme |
| 0.07 | ELK_QR_MONTAJ__celik · goz_40_kapak_kulagi_0 | QR_GOZLER__celik__GOZ_40_KAPAK · goz_40_kapak_mili | QR | 4448, 1432, 684 | kapak/kanat (kpk) parçası; kapalı konumda bindirme |
| 0.07 | ELK_QR_MONTAJ__celik · goz_11_kapak_kulagi_1 | QR_GOZLER__celik__GOZ_11_KAPAK · goz_11_kapak_mili | QR | 5158, 832, 684 | kapak/kanat (kpk) parçası; kapalı konumda bindirme |
| 0.07 | ELK_QR_MONTAJ__celik · goz_00_kapak_kulagi_1 | QR_GOZLER__celik__GOZ_00_KAPAK · goz_00_kapak_mili | QR | 4748, 632, 684 | kapak/kanat (kpk) parçası; kapalı konumda bindirme |
| 0.07 | ELK_QR_MONTAJ__celik · goz_01_kapak_kulagi_0 | QR_GOZLER__celik__GOZ_01_KAPAK · goz_01_kapak_mili | QR | 4858, 632, 684 | kapak/kanat (kpk) parçası; kapalı konumda bindirme |
| 0.07 | ELK_QR_MONTAJ__celik · goz_50_kapak_kulagi_1 | QR_GOZLER__celik__GOZ_50_KAPAK · goz_50_kapak_mili | QR | 4748, 1632, 684 | kapak/kanat (kpk) parçası; kapalı konumda bindirme |

## KASITLI (904) — nedene göre özet (tam liste cakisma.json)

| neden | adet | en derin mm | örnekler |
|---|---|---|---|
| bağlantı elemanı (PEM/vida/somun) sac içinde; delik modellenmemiş | 270 | 7.50 | baca_flans_pem_M6_0_kapak ↔ arayuz_baca_flans_M6_0; baca_flans_pem_M6_1_kapak ↔ arayuz_baca_flans_M6_1; baca_flans_pem_M6_2_kapak ↔ arayuz_baca_flans_M6_2; baca_flans_pem_M6_3_kapak ↔ arayuz_baca_flans_M6_3 |
| aynı parçanın alt katıları birbirine giriyor (tek parça; boolean birleşim yapılmamış) | 232 | 15.05 | ana_pano_guc_24V_NDR-120-24 ↔ ana_pano_guc_24V_NDR-120-24; ana_pano_hmi_ana_bilgisayar_RevPi_Connect_4 ↔ ana_pano_hmi_ana_bilgisayar_RevPi_Connect_4; ana_pano_kacak_akim_iID_4P_40A_30mA ↔ ana_pano_kacak_akim_iID_4P_40A_30mA; ana_pano_revpi_AIO_100250 ↔ ana_pano_revpi_AIO_100250 |
| birim-içi mekanizma parçaları (B/Gövde) | 126 | 2.40 | arayuz_ray_1418_204_330 ↔ ray_pem_1418_204_330_kopuk_kapagi; arayuz_ray_1418_204_45 ↔ ray_pem_1418_204_45_kopuk_kapagi; arayuz_ray_1418_204_580 ↔ ray_pem_1418_204_580_kopuk_kapagi; arayuz_ray_1418_312_330 ↔ ray_pem_1418_312_330_kopuk_kapagi |
| sac arayüz elemanı (PEM / FHP saplama / burç / perçin somun) sacta; gömme başı / delik modellenmemiş (v9 sac) | 120 | 1.01 | arayuz_fan_2640_2075_0_0 ↔ ust_f_arka_sac; arayuz_fan_2640_2075_0_1 ↔ ust_f_arka_sac; arayuz_fan_2640_2075_1_0 ↔ ust_f_arka_sac; arayuz_fan_2640_2075_1_1 ↔ ust_f_arka_sac |
| DIN raya geçme cihaz (cihazın ray yuvası modellenmemiş) | 54 | 3.84 | ag_anahtari_FL_SWITCH_1008N_QR ↔ qr_kutu_din_rayi; ana_pano_ag_anahtari_FL_SWITCH_1008N ↔ ana_pano_din_rayi_B; ana_pano_din_rayi_B ↔ ana_pano_klemens_PT2_5_PE_16; ana_pano_din_rayi_B ↔ ana_pano_klemens_PT2_5_PE_17 |
| birim-içi mekanizma parçaları (B/Çekmeceler) | 21 | 0.35 | CEK_K1_lahm_1_motor_kasnagi ↔ CEK_K1_lahm_1_kayis_GT3; CEK_K1_lahm_2_motor_kasnagi ↔ CEK_K1_lahm_2_kayis_GT3; CEK_K1_lahm_3_motor_kasnagi ↔ CEK_K1_lahm_3_kayis_GT3; CEK_K1_lahm_4_motor_kasnagi ↔ CEK_K1_lahm_4_kayis_GT3 |
| kablo/hortum kanal-rakor-geçiş içinde | 16 | 3.50 | qr_kutu_rakoru_goz_demeti ↔ qr_pano_alti_kablo_tavasi_kapak; qr_kutu_rakoru_goz_demeti ↔ qrk_goz_demeti_rakor_ucu; qr_kutu_rakoru_kart_modem ↔ qr_pano_alti_kablo_tavasi_kapak; qr_kutu_rakoru_ups ↔ qr_pano_alti_kablo_tavasi_kapak |
| mil ↔ yatak/göbek/kol geçmesi (birim-içi mekanizma) | 15 | 10.48 | besleyici_avara_yatagi ↔ besleyici_avara_mili; besleyici_kasnak_avara ↔ besleyici_avara_mili; kapak_kolu_mili ↔ kapak_kolu; kiyma__urun_mili ↔ kiyma__mil_kavramasi |
| sıkı geçme ≤0,2 mm (conta/rakor/kelepçe/burç) | 13 | 0.20 | F_kutu_rakoru_230V_bina ↔ harting_F_soket; bolme_5_sac_a ↔ bolme_5_gider_silikonu_0; gider_ana_hatti_borusu ↔ gider_ana_hatti_kelepcesi_K3; qr_kutu_rakoru_kart_modem ↔ qrk_kart_modem_rakor_ucu |
| birim-içi mekanizma (aynı mek: E/Kutu katlama) | 9 | 0.07 | destek_motor_kaplin ↔ destek_motoru; flap_katlayici_kaplini ↔ flap_katlayici_motoru; kopru_kaplini ↔ kopru_motoru; kose_CNR_MB_motor ↔ kose_CNR_MB_kaplin |
| birim-içi mekanizma parçaları (E/Kutu katlama) | 8 | 5.00 | flap_lineer_burc_govdesi_0 ↔ flap_lineer_burc_0; kol_reduktoru ↔ kol_motoru; parmak_kasnak_alt ↔ parmak_kayisi; parmak_kayisi ↔ parmak_kasnak_ust |
| birim-içi mekanizma parçaları (TOPPING/Kıyma) | 4 | 10.00 | kiyma__pnomatik_on_bogaz ↔ kiyma__pnomatik_mil_D12; kiyma__pnomatik_silindir_D32 ↔ kiyma__pnomatik_mil_D12; kiyma__urun_silindiri_bilezigi ↔ kiyma__urun_silindiri_D70; kiyma__urun_silindiri_kapagi ↔ kiyma__urun_silindiri_D70 |
| birim-içi mekanizma (aynı mek: F/Gövde) | 4 | 0.07 | onyuz_f_ust_gazli_yay_braketi_sag ↔ onyuz_f_ust_gazli_yay_sag_goz_a; onyuz_f_ust_gazli_yay_braketi_sol ↔ onyuz_f_ust_gazli_yay_sol_goz_a; onyuz_f_ust_kapak_sag_yay_pimi ↔ onyuz_f_ust_gazli_yay_sag_goz_b; onyuz_f_ust_kapak_sol_yay_pimi ↔ onyuz_f_ust_gazli_yay_sol_goz_b |
| aynı kablo/hortumun segmentleri birleşimde bindiriyor (tek parça) | 3 | 4.90 | hava_ana#0 ↔ hava_ana#1; hava_ana#19 ↔ hava_ana#20; hava_ana#23 ↔ hava_ana#24 |
| PU köpük içine gömülü eleman | 2 | 0.63 | avara_rulosu_46 ↔ bant_sarim_46; tahrik_rulosu_EC5000_354 ↔ bant_sarim_354 |
| birim-içi mekanizma (aynı mek: TOPPING/Tabla) | 2 | 0.17 | avara_kasnak ↔ x_kayisi_sarim_sag; st_kaplin ↔ st_tahrik_motoru |
| birim-içi mekanizma (aynı mek: E/Asansör) | 2 | 0.09 | asansor_kasnak_20 ↔ asansor_motoru; asansor_kasnak_40 ↔ asansor_kayisi |
| birim-içi mekanizma parçaları (E/Besleyici) | 1 | 6.29 | besleyici_kasnak_tahrik ↔ besleyici_motoru |
| birim-içi mekanizma parçaları (TOPPING/Tabla) | 1 | 0.46 | st_motor_adaptor_flansi ↔ st_tahrik_motoru |
| birim-içi mekanizma (aynı mek: F/Yükleme bandı) | 1 | 0.19 | yb_kasnak_motor ↔ yb_gt2_kayis |
