kursatkemalkul/autokitch/KURALLAR.md

# AUTOKITCH · KURALLAR (Claude + Codex, tek liste)

Kemal, 5 Eki 2026: "Kurallar listesi hem senin hem Codex'in için kaydedilsin; ikisi de aynı sistemle, aynı kurallarla çalışsın."

- Her ajan işe başlamadan bu dosyayı okur. İş bitince §5'teki denetimi çalıştırır. Bir madde tutmazsa iş yayımlanmaz.
- Yeni kural yalnız buraya yazılır (Kemal kararıyla). Başka dosyada kural tutulmaz; eski dosyalar buraya bağlanır.
- Çelişkide sıra: **Kemal kararı (§6) > bu dosya > `arastirma/_uretec/h3/yama_v9/sac_standart/sac_uyum_v1.json` > `sac_kararlar_v1.json` > `sac_standart_v1.json`.**
- Ortak çalışma (kim neyi yapıyor, dosya sahipliği, zincir kilidi, yayın): `KOORDINASYON.md`.

---

## 1. Üretilebilirlik: her parça gerçekten üretilebilir ve birbirine uyumlu

### 1.1 Sac
1. Malzeme AISI 304 2B. Dış yüz 240 kum satine (hat boyunca yatay). Gıdaya değen yer 304; tuzlu veya asitli ürüne sürekli değen yer gerekirse 316L.
2. Kalınlık yalnız şu aileden: **0,8 · 1,0 · 1,2 · 1,5 · 2,0 · 3,0 mm**. Plaka veya lama olarak 4 ve 6 mm izinli. Aile dışı kalınlık Kemal onayı ister.
3. Aynı işlev, her istasyonda aynı kalınlık:
   - dış kabuk 1,5;
   - kapak dış tava 1,5, iç tava 1,0;
   - ön çerçeve 1,0;
   - raf ve yük sacı 3,0;
   - kulak ve braket 3,0;
   - dikme tapası 2,0.
4. Büküm iç yarıçapı R = 1,5 × t. Gıda tarafında iç köşe en az R 3.
5. Delik veya kesik, büküm çizgisine en az 2 × t + R uzak. Daha yakınsa rahatlatma kesiği açılır.
6. Açınım standart levhaya sığar (1000 × 2000 / 1250 × 2500 / 1500 × 3000). Büküm boyu ve flanş yüksekliği abkanta uyar: en kısa flanş en az 4 × t.
7. Profil dış R = 2 × t. Profiller iç içe geçmez; köşebent, plaka, cıvata ya da kaynakla birleşir.
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
