kursatkemalkul/autokitch/_local/claude-site-20261005/hat3-v8/sabah/m1_K_ara_raf_yok.jpg

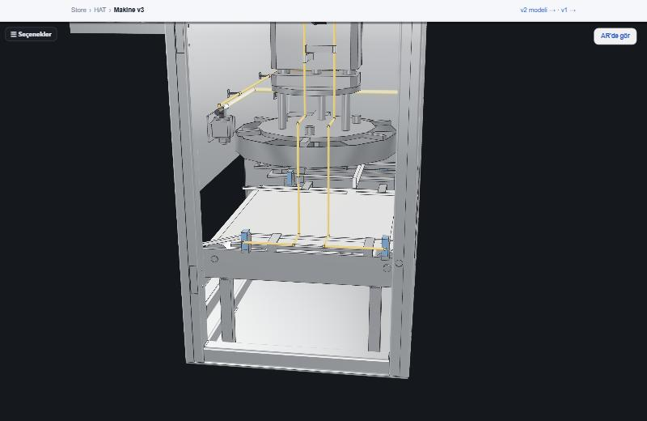
_local/claude-site-20261005/hat3-v8/sabah/m1_K_ara_raf_yok.jpg
