kursatkemalkul/autokitch/_local/claude-site-20261005/hat3-v8/sabah/m5_duz_zemin.jpg

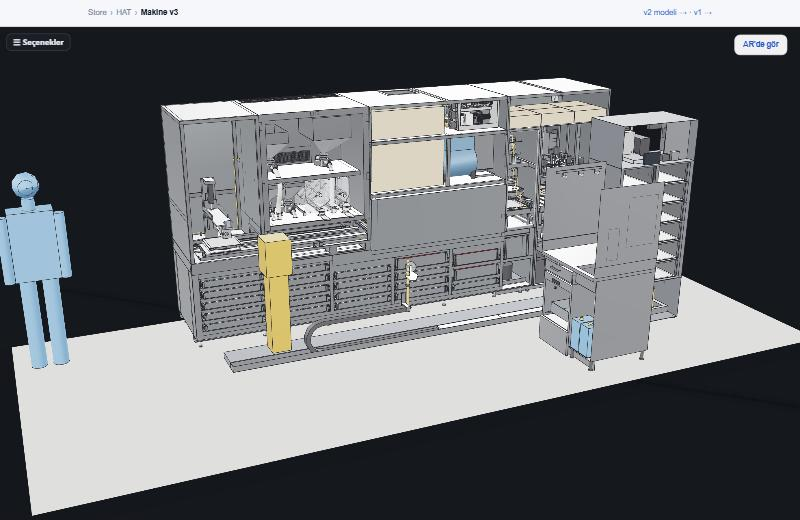
_local/claude-site-20261005/hat3-v8/sabah/m5_duz_zemin.jpg
