kursatkemalkul/autokitch/_local/claude-site-20261005/hat3-v8/sabah/m7_on_TOPPING_kapaksiz.jpg

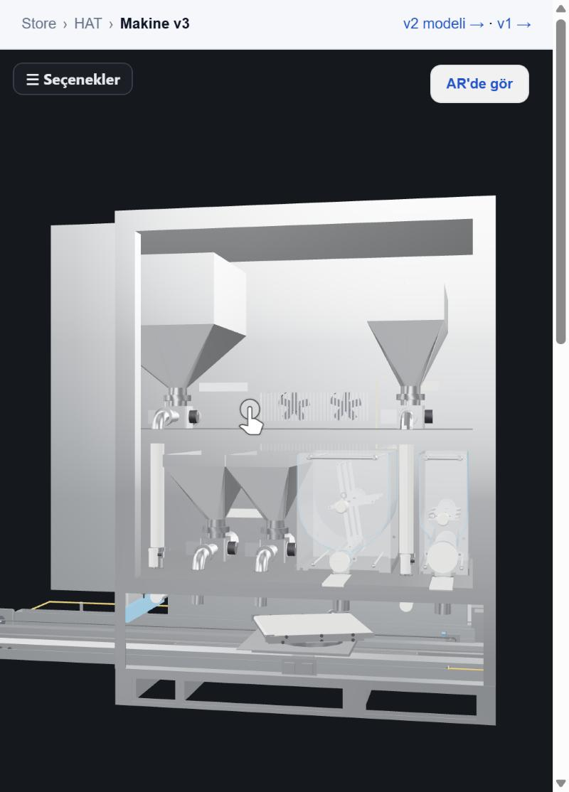
_local/claude-site-20261005/hat3-v8/sabah/m7_on_TOPPING_kapaksiz.jpg
