kursatkemalkul/autokitch/_local/claude-site-20261005/hat3-v8/sabah/m8t2_ust_kanal_UF2_UF3_sonra_v8z.jpg

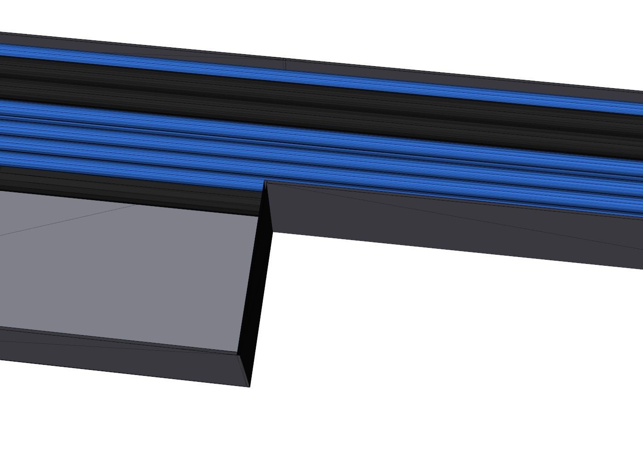
_local/claude-site-20261005/hat3-v8/sabah/m8t2_ust_kanal_UF2_UF3_sonra_v8z.jpg
