kursatkemalkul/autokitch/_local/claude-site-20261005/hat3-v8/sabah/v8v_ist_F.jpg

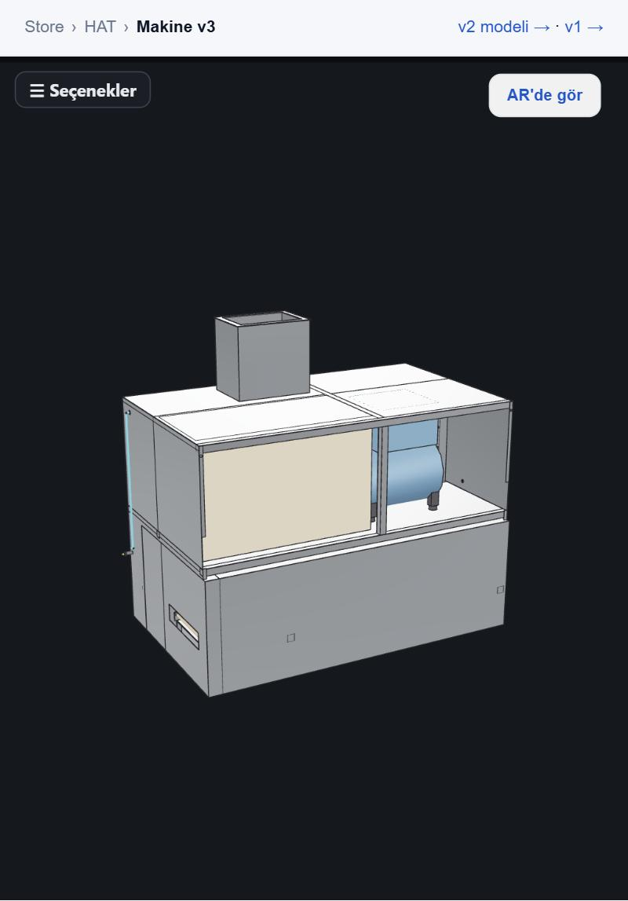
_local/claude-site-20261005/hat3-v8/sabah/v8v_ist_F.jpg
