kursatkemalkul/autokitch/_local/claude-site-20261005/hat3-v8/topping_govde_denetim/f_tek.png

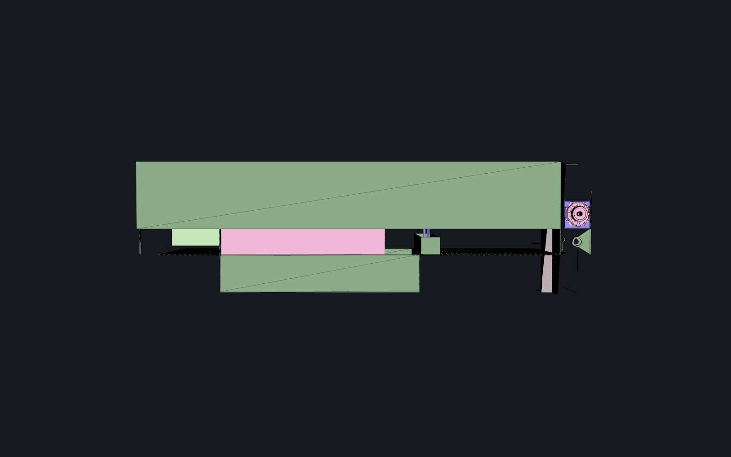
_local/claude-site-20261005/hat3-v8/topping_govde_denetim/f_tek.png
