kursatkemalkul/autokitch/_local/claude-site-20261005/held-paths/_local/topping-v32/tc_kesit_v31_v32.png

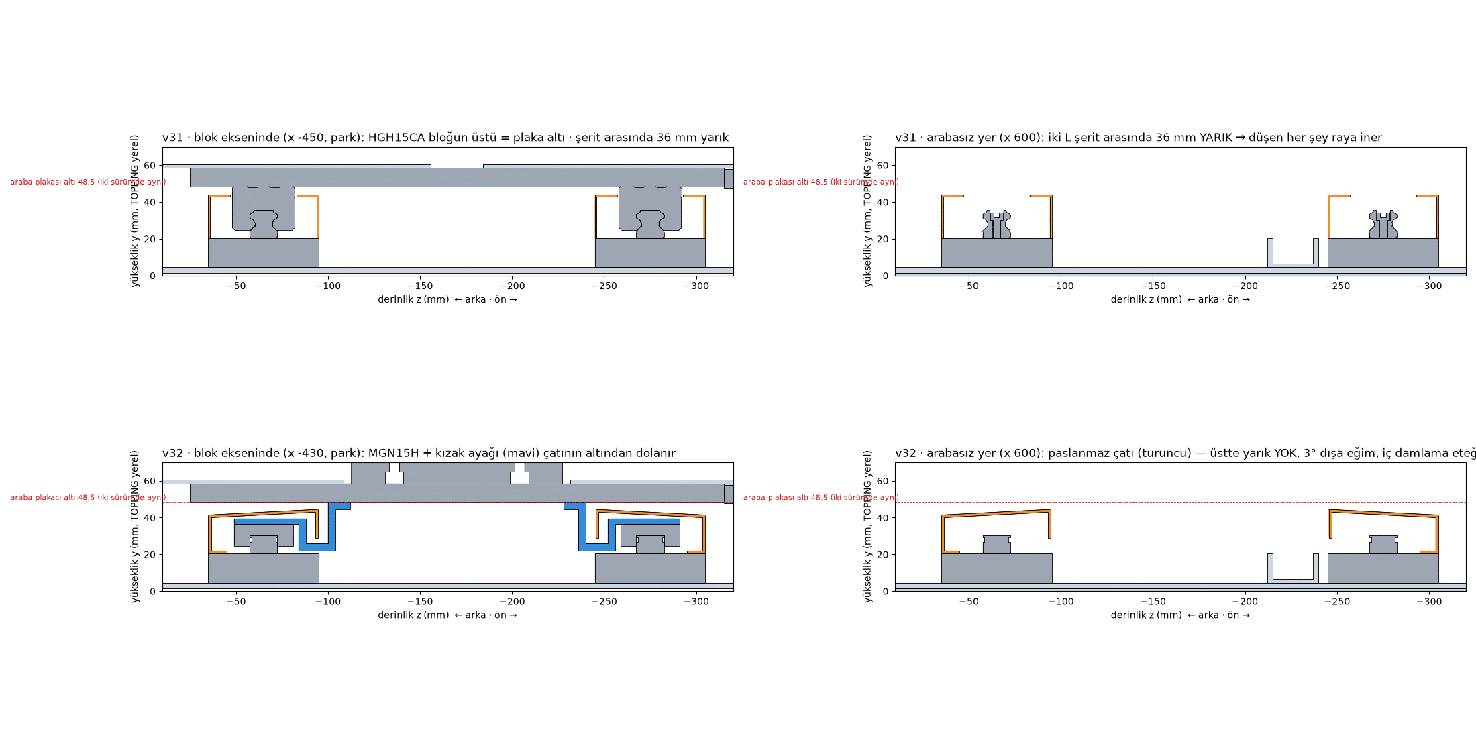
_local/claude-site-20261005/held-paths/_local/topping-v32/tc_kesit_v31_v32.png
