kursatkemalkul/autokitch/_local/claude-site-20261005/held-paths/_local/topping-v32/v92_ray_cati.png

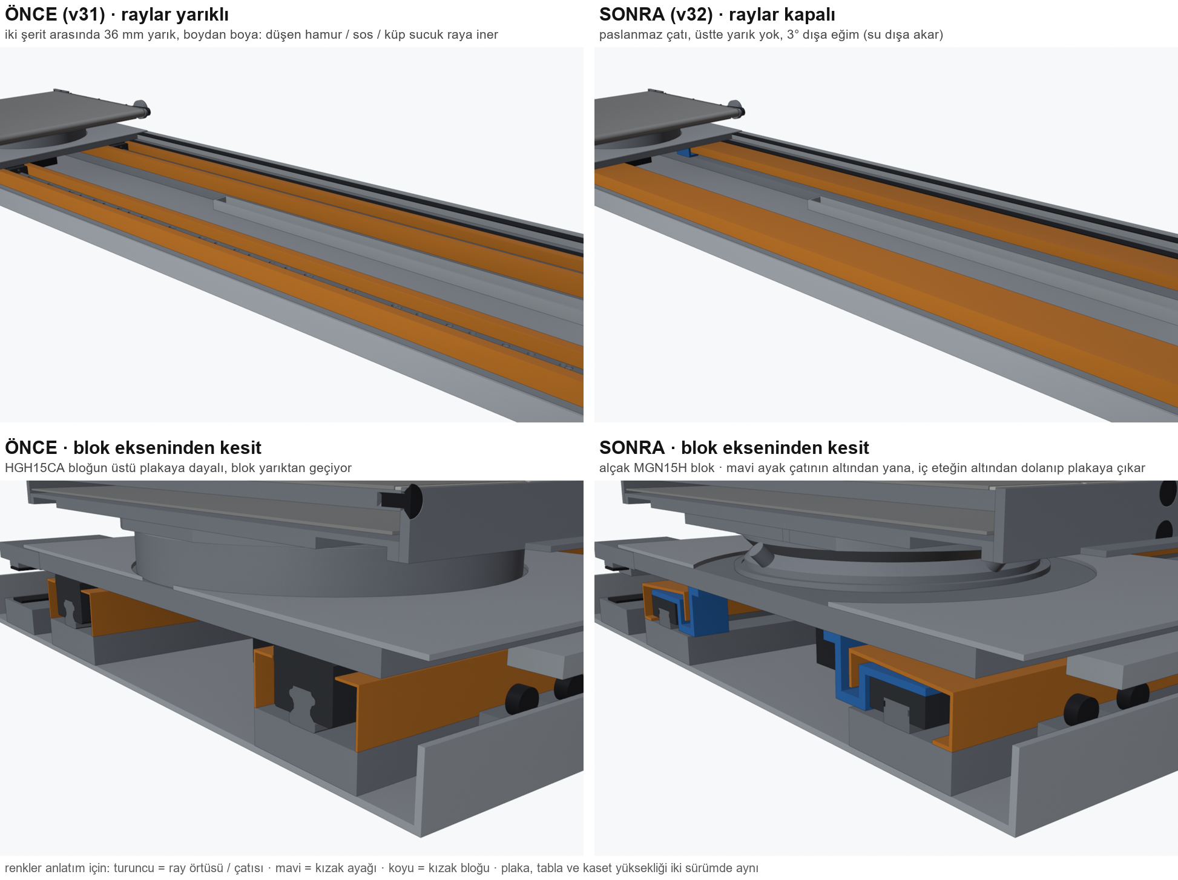
_local/claude-site-20261005/held-paths/_local/topping-v32/v92_ray_cati.png
