kursatkemalkul/autokitch/_local/claude_son_yerel/adim58_acil_stop.png

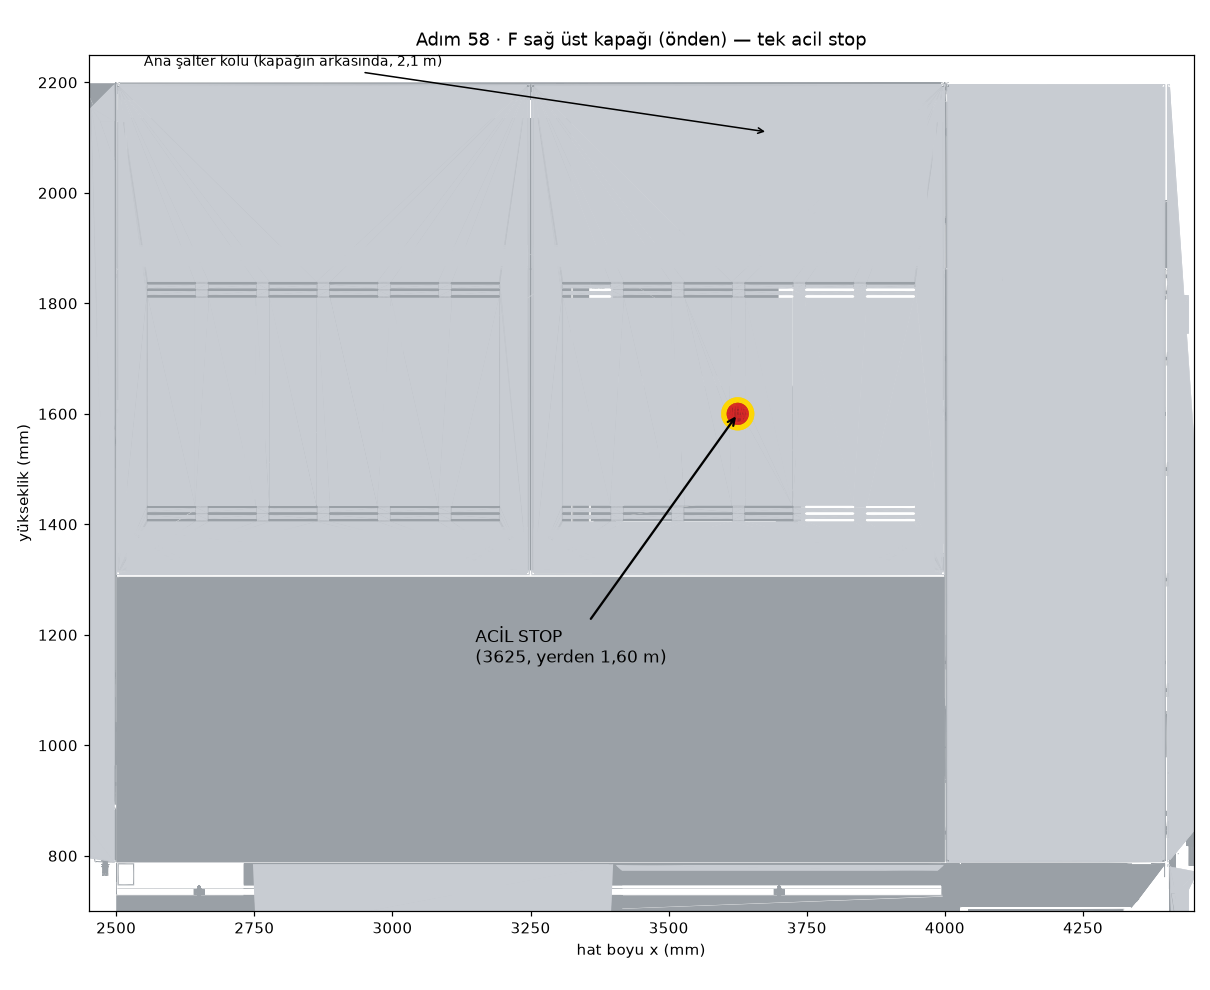
_local/claude_son_yerel/adim58_acil_stop.png
