kursatkemalkul/autokitch/_local/claude_son_yerel/adim59_kapi_emniyet.png

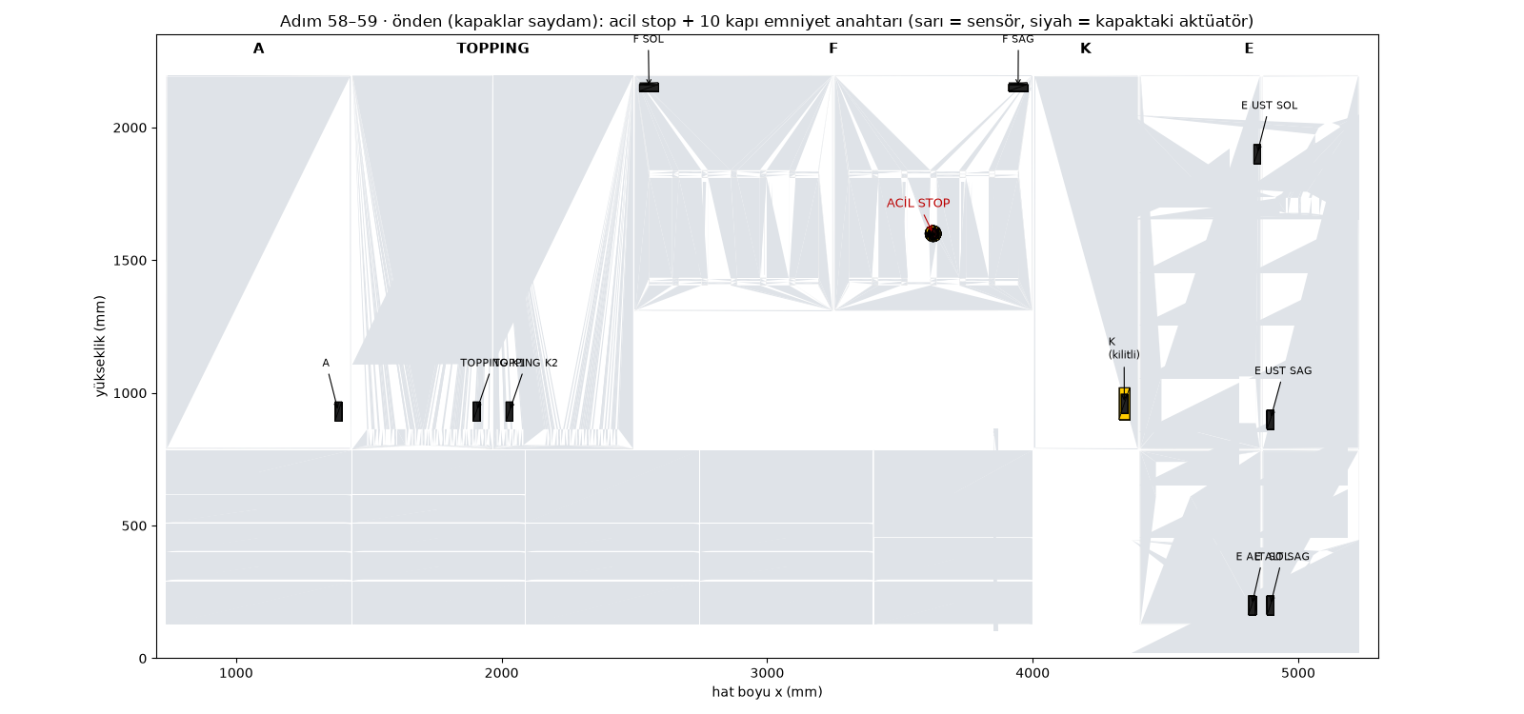
_local/claude_son_yerel/adim59_kapi_emniyet.png
