kursatkemalkul/autokitch/_local/claude_son_yerel/adim61_filtre_servis.png

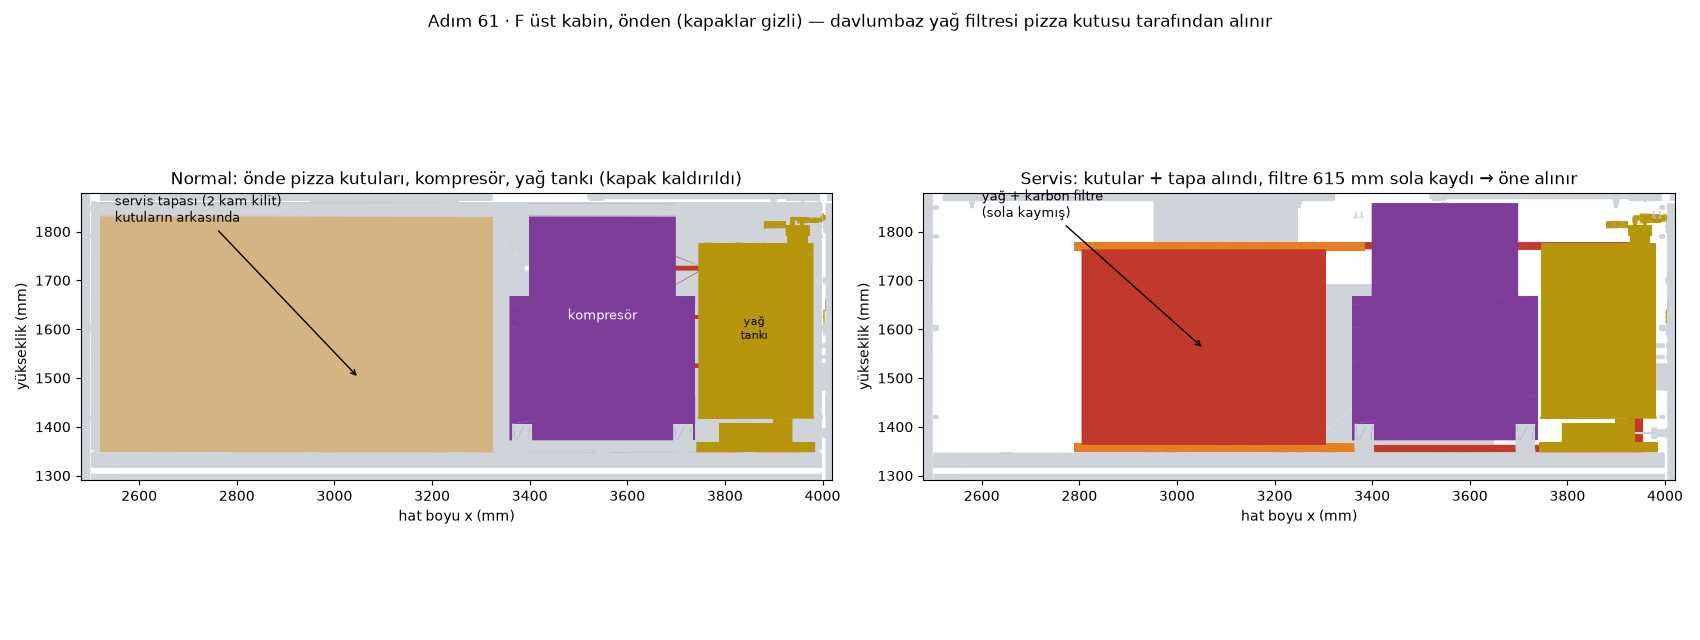
_local/claude_son_yerel/adim61_filtre_servis.png
