kursatkemalkul/autokitch/_local/claude_son_yerel/adim63_uno_kaset.png

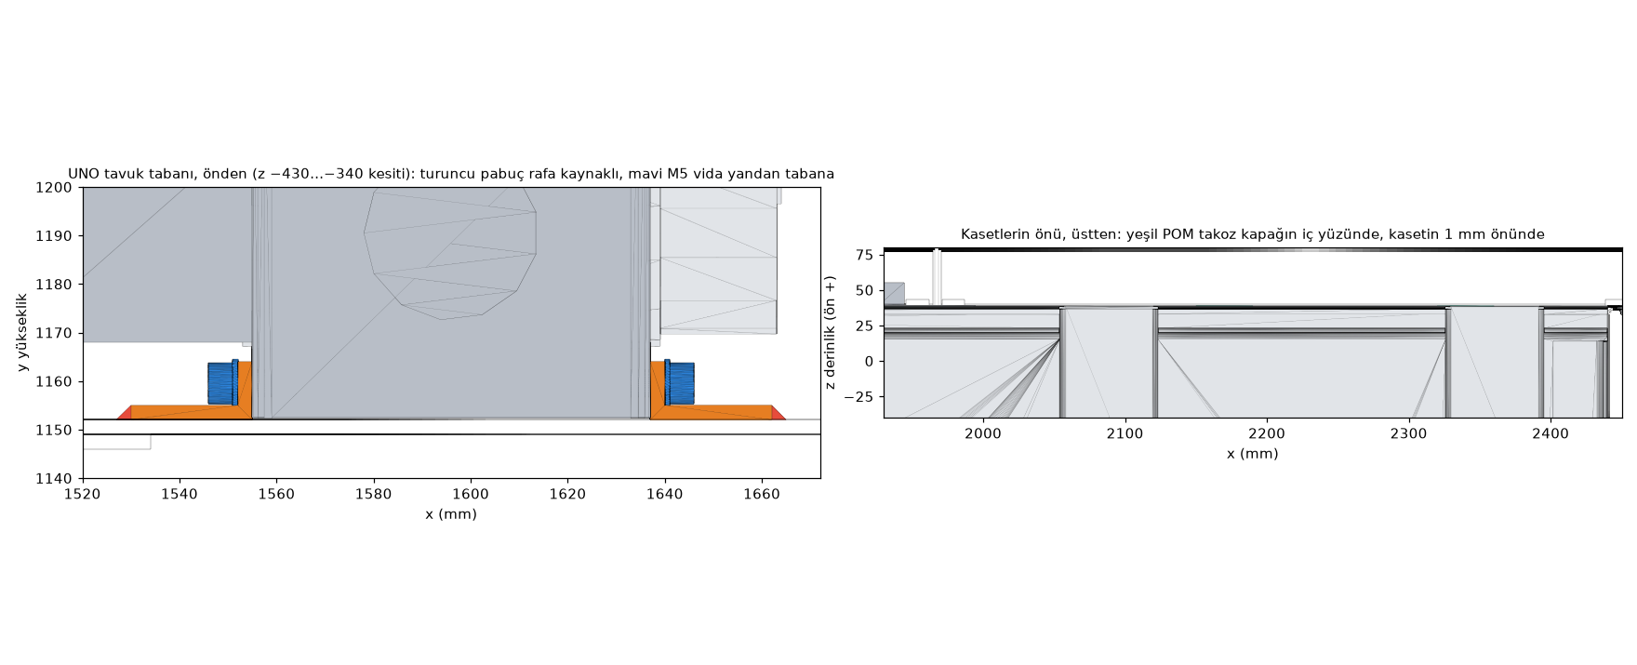
_local/claude_son_yerel/adim63_uno_kaset.png
