kursatkemalkul/autokitch/_local/codex_robot_v28/v28_local.png

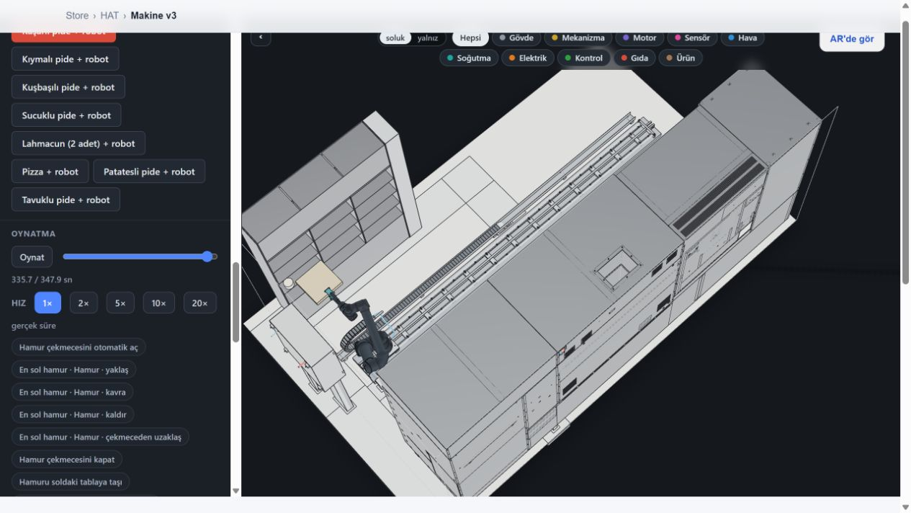
_local/codex_robot_v28/v28_local.png
