kursatkemalkul/autokitch/_local/k-v8/k8_genel.png

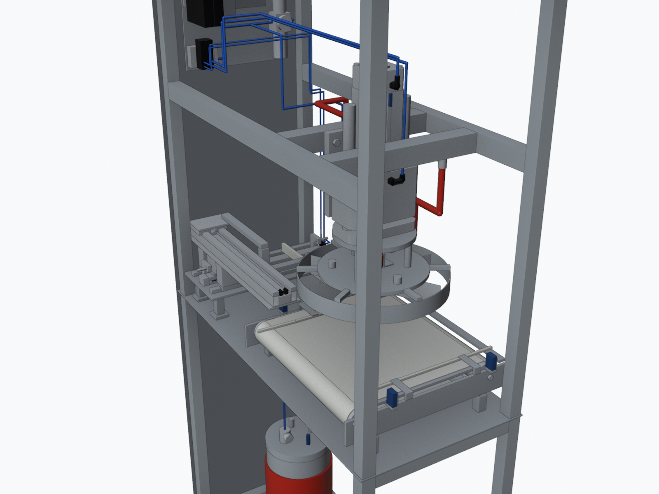
_local/k-v8/k8_genel.png
