kursatkemalkul/autokitch/_local/k-v8/k8_itici_bant.png

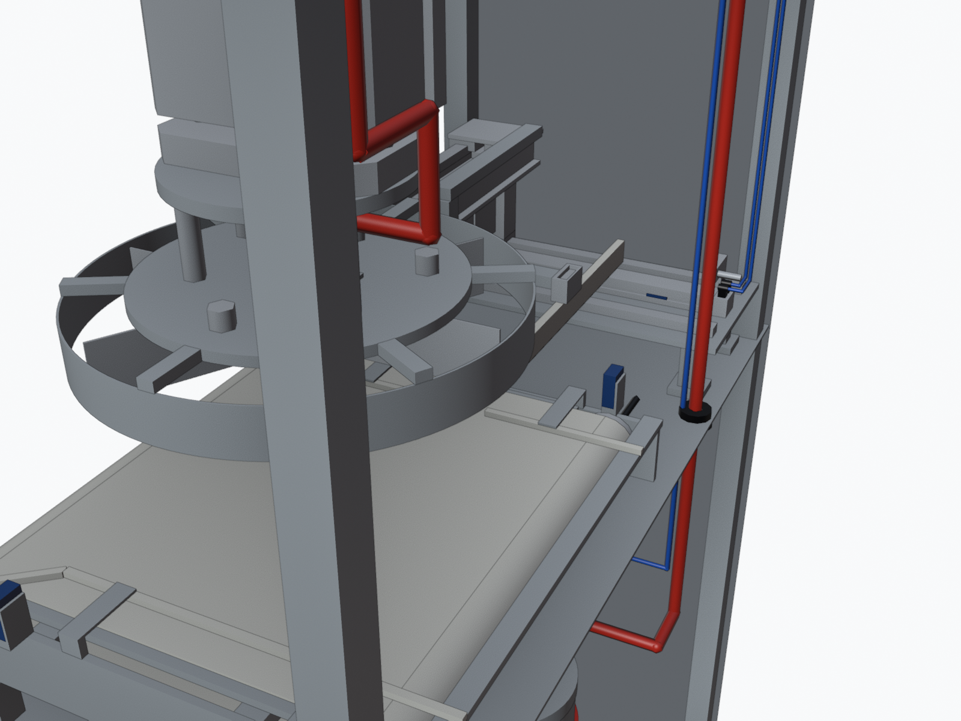
_local/k-v8/k8_itici_bant.png
