kursatkemalkul/autokitch/_local/k-v8/k8_kesici_sprey.png

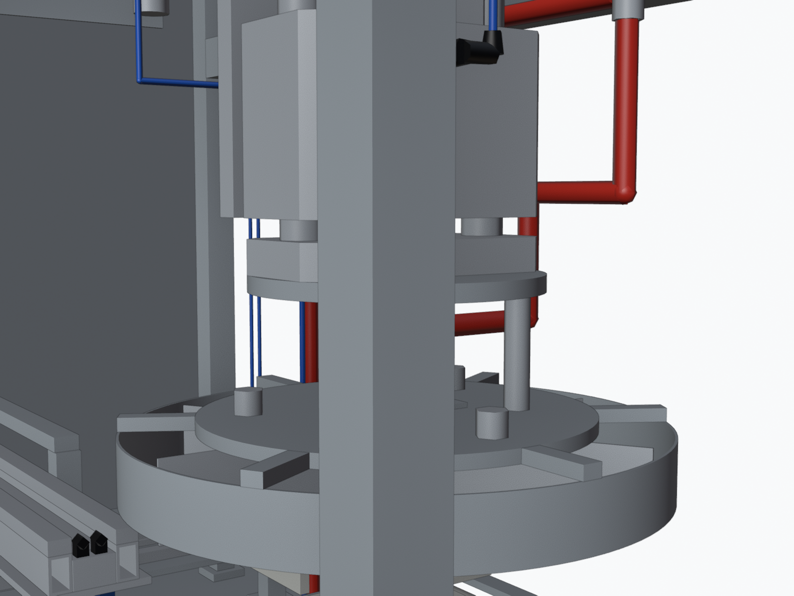
_local/k-v8/k8_kesici_sprey.png
