kursatkemalkul/autokitch/_local/k-v8/k8_on_pano_tank.png

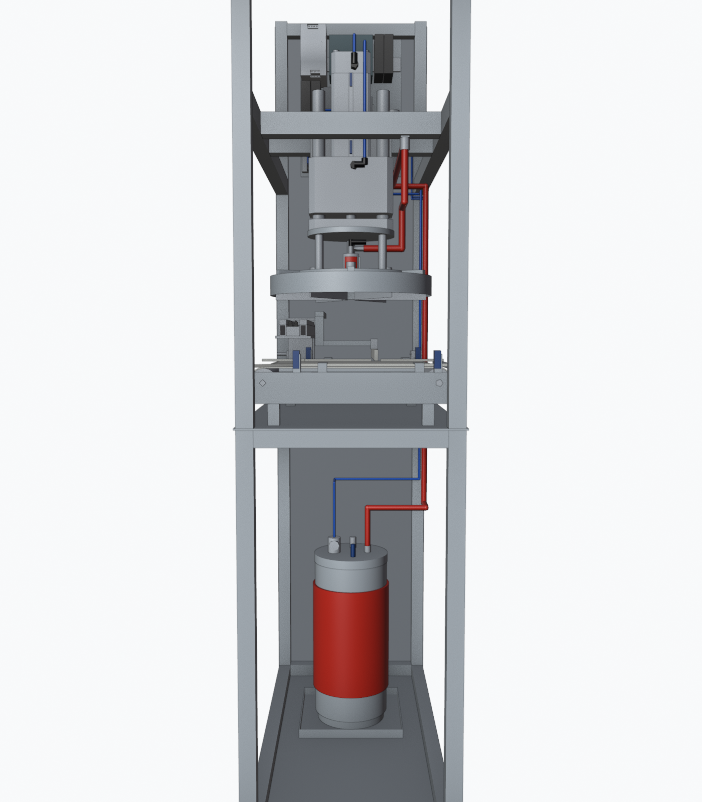
_local/k-v8/k8_on_pano_tank.png
