kursatkemalkul/autokitch/_local/kutu-v11/preview.png

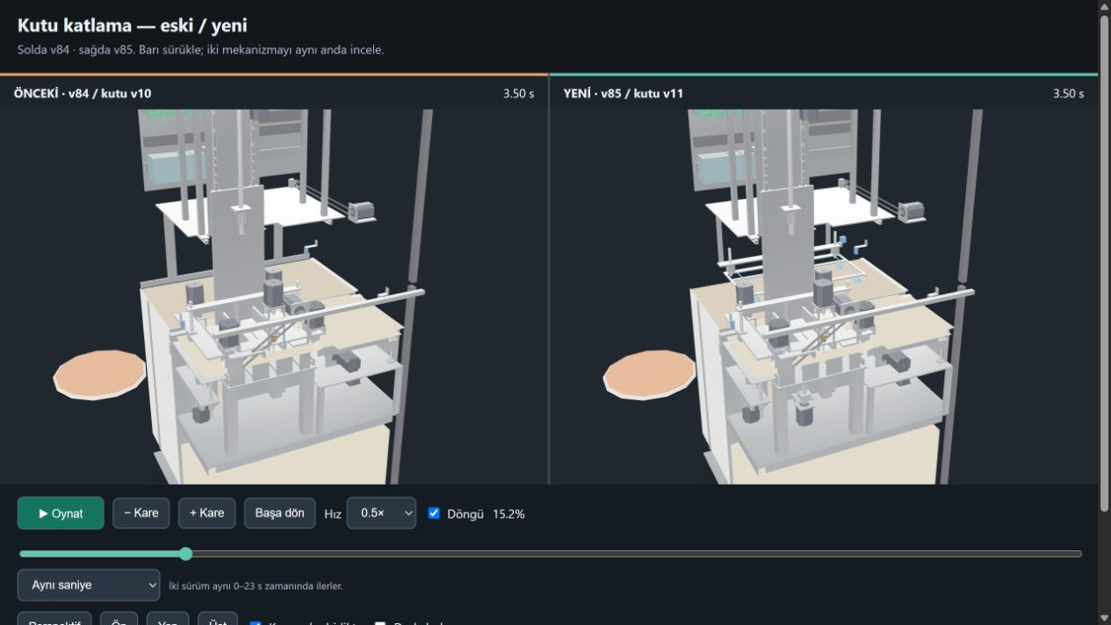
_local/kutu-v11/preview.png
