kursatkemalkul/autokitch/_local/tezgah-v2/tezgah_v2_ince_duvar_tarafi.png

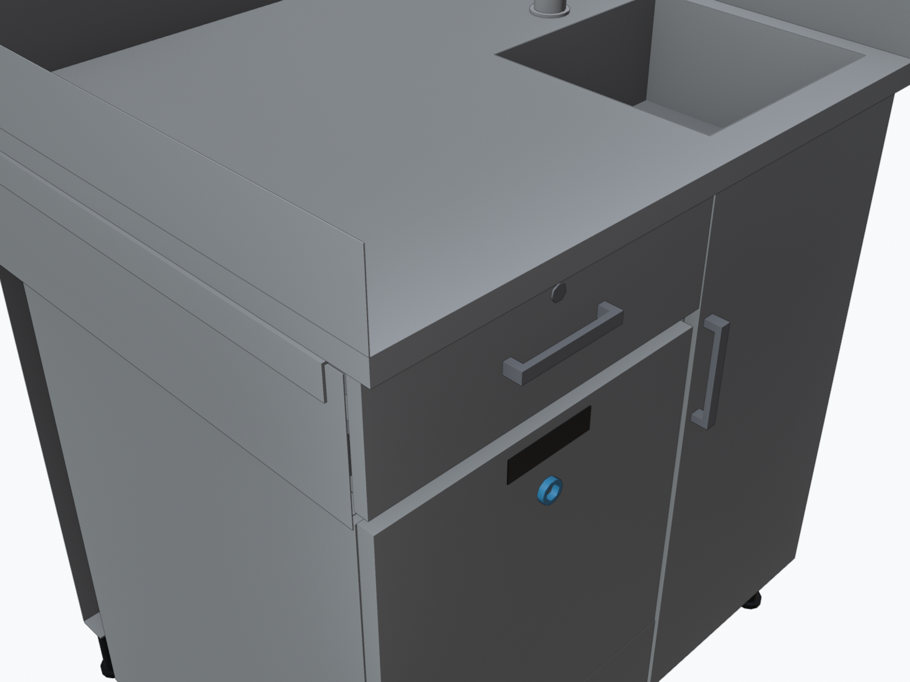
_local/tezgah-v2/tezgah_v2_ince_duvar_tarafi.png
