kursatkemalkul/autokitch/_local/tezgah-v2/tezgah_v2_kullanici.png

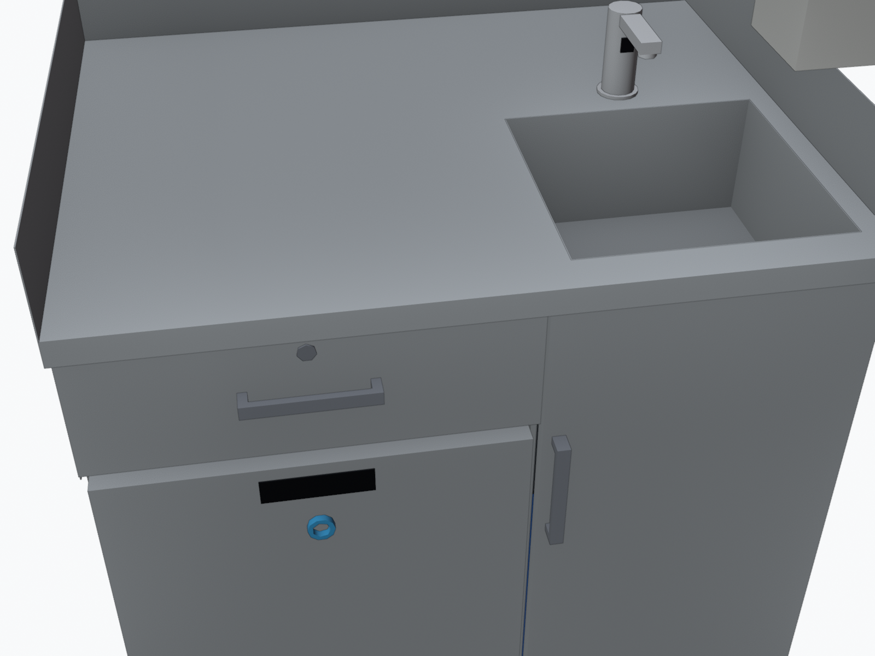
_local/tezgah-v2/tezgah_v2_kullanici.png
