kursatkemalkul/autokitch/arastirma/2_PRESS/ist2_pres_detay_v1.png

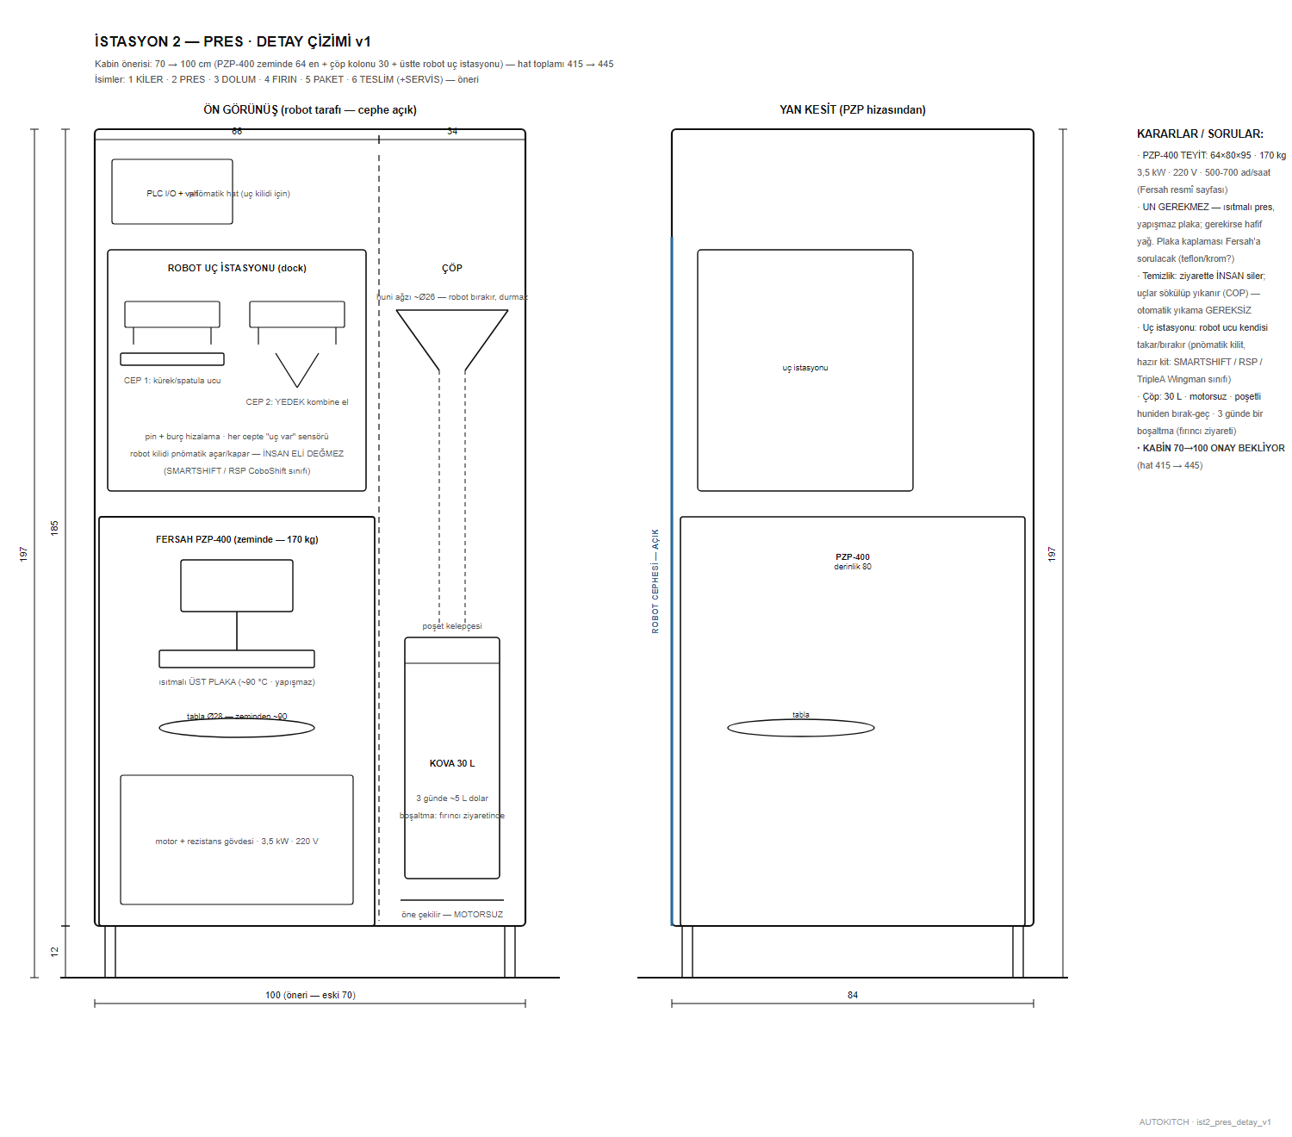
arastirma/2_PRESS/ist2_pres_detay_v1.png
