kursatkemalkul/autokitch/arastirma/2_PRESS/ist2_pres_detay_v2.png

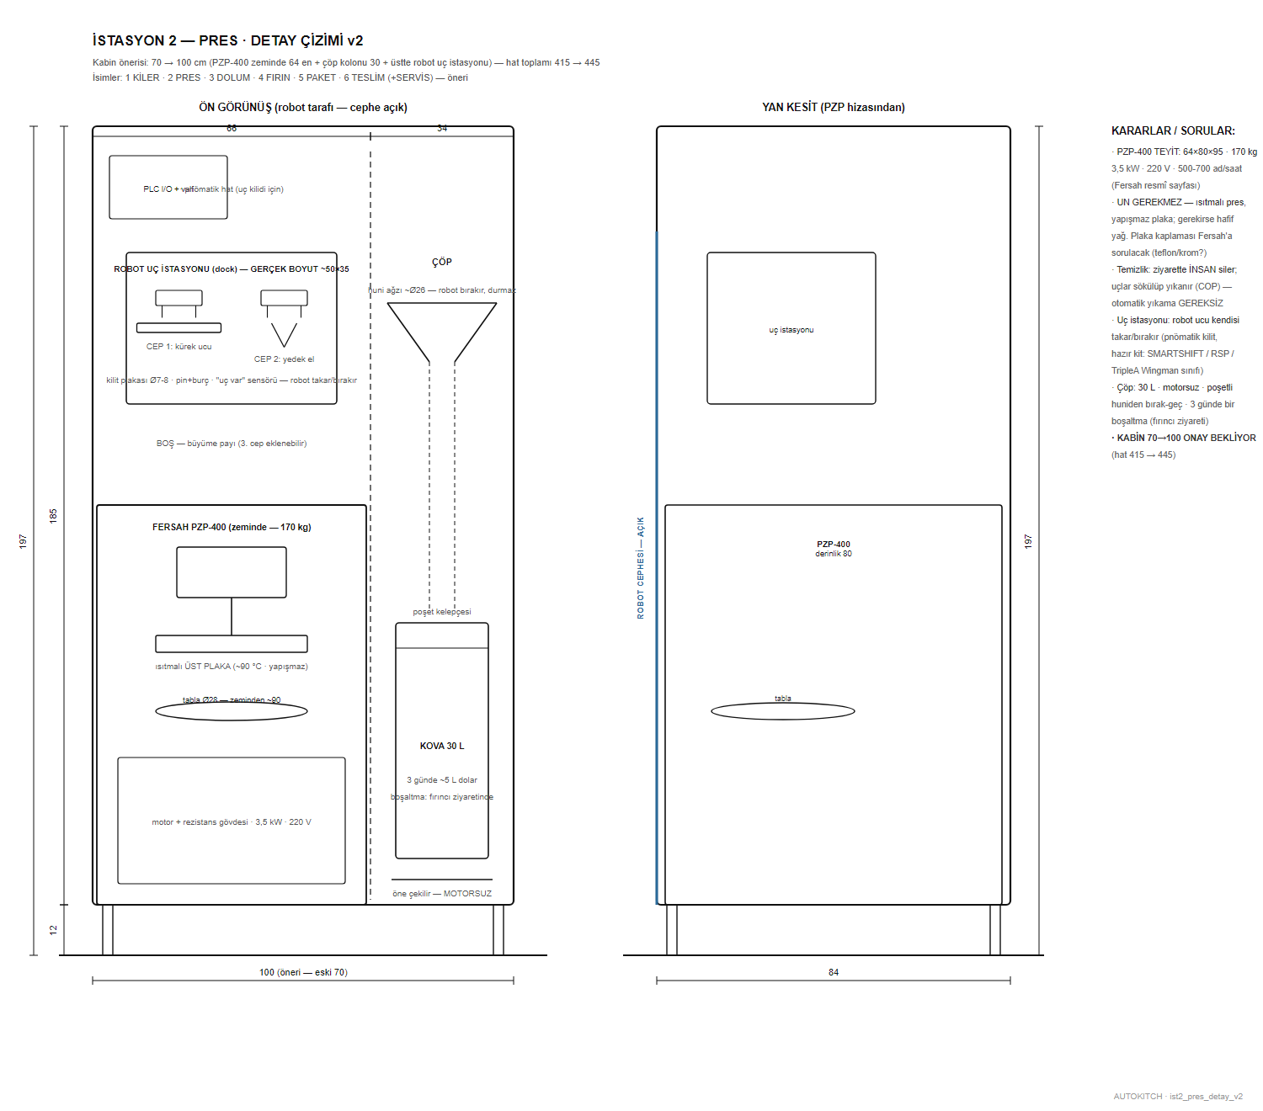
arastirma/2_PRESS/ist2_pres_detay_v2.png
