kursatkemalkul/autokitch/arastirma/2_PRESS/ist2_pres_detay_v3.png

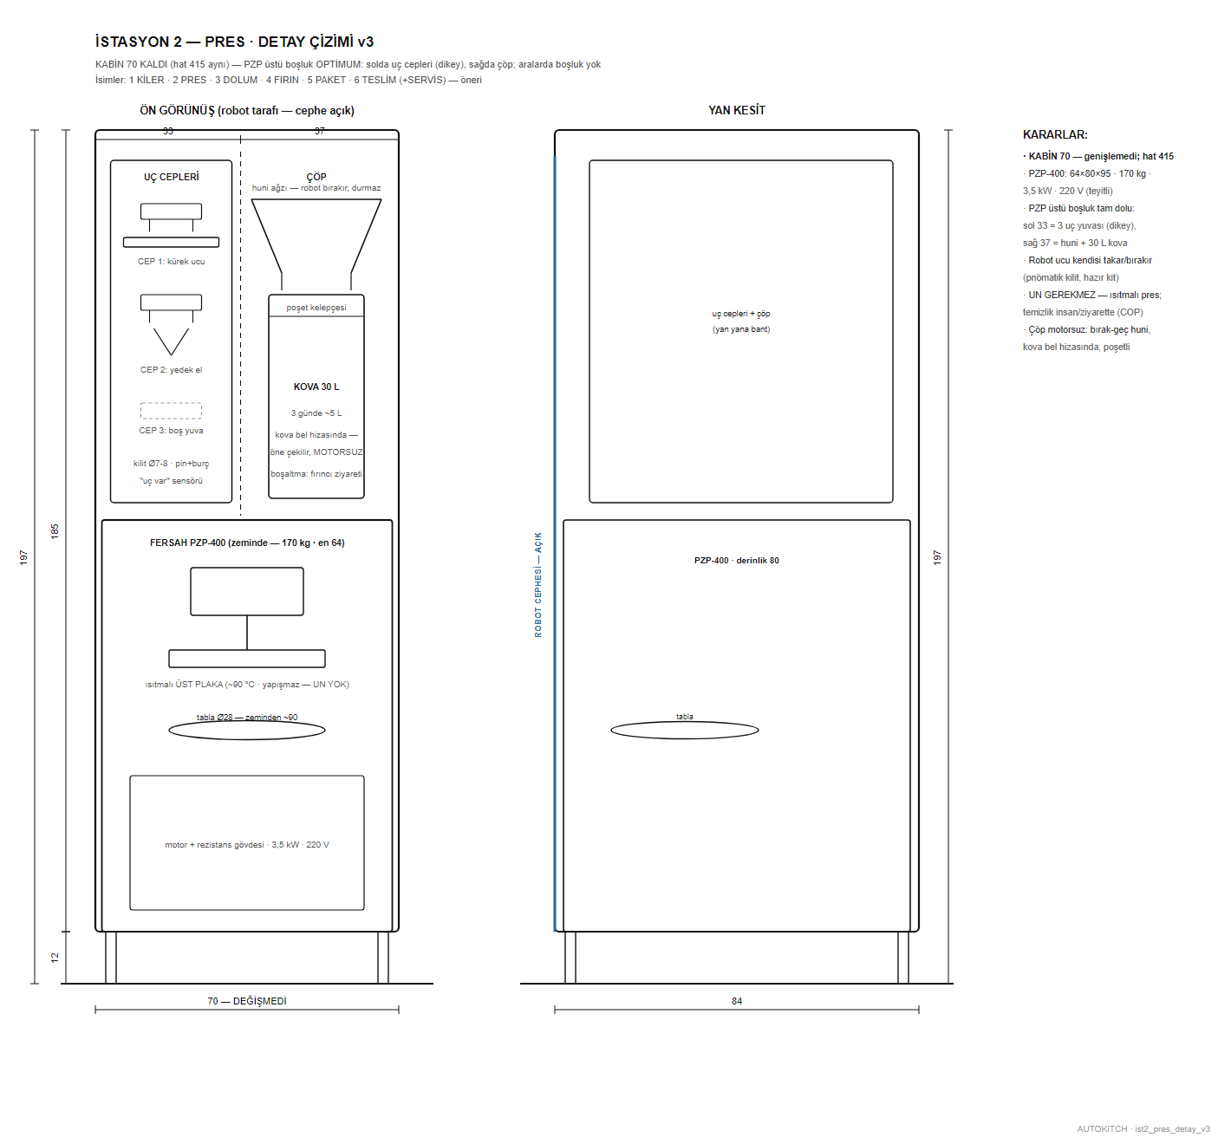
arastirma/2_PRESS/ist2_pres_detay_v3.png
