kursatkemalkul/autokitch/arastirma/2_PRESS/PRESS_asm_iso.png

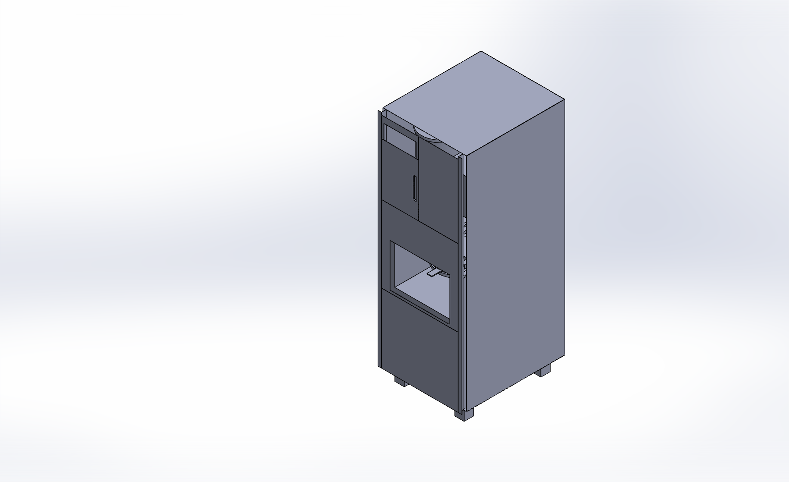
arastirma/2_PRESS/PRESS_asm_iso.png
