kursatkemalkul/autokitch/arastirma/3_TOPPING/BIRLESIM_DETAYLARI_v1.png

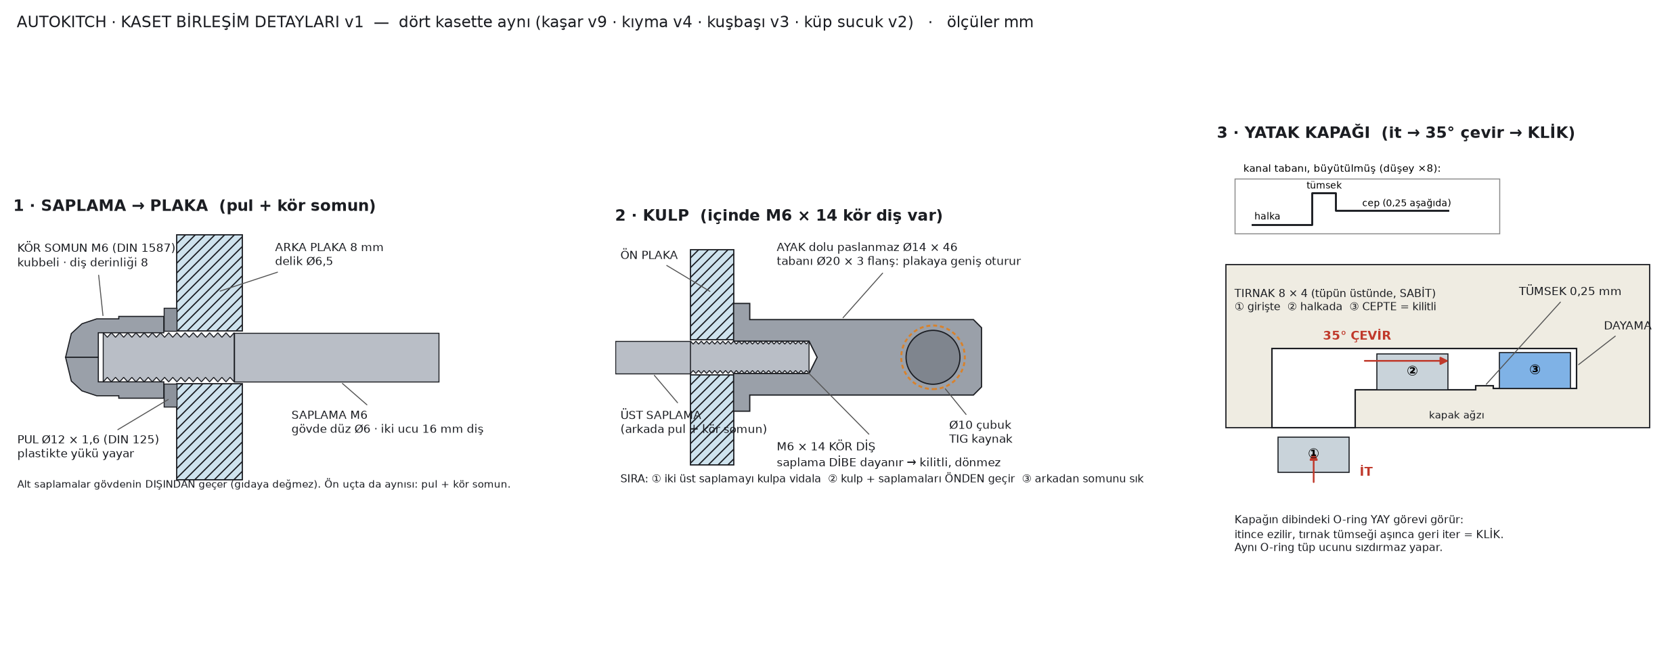
arastirma/3_TOPPING/BIRLESIM_DETAYLARI_v1.png
