kursatkemalkul/autokitch/arastirma/3_TOPPING/ist3_cep_tekeri_v1.png

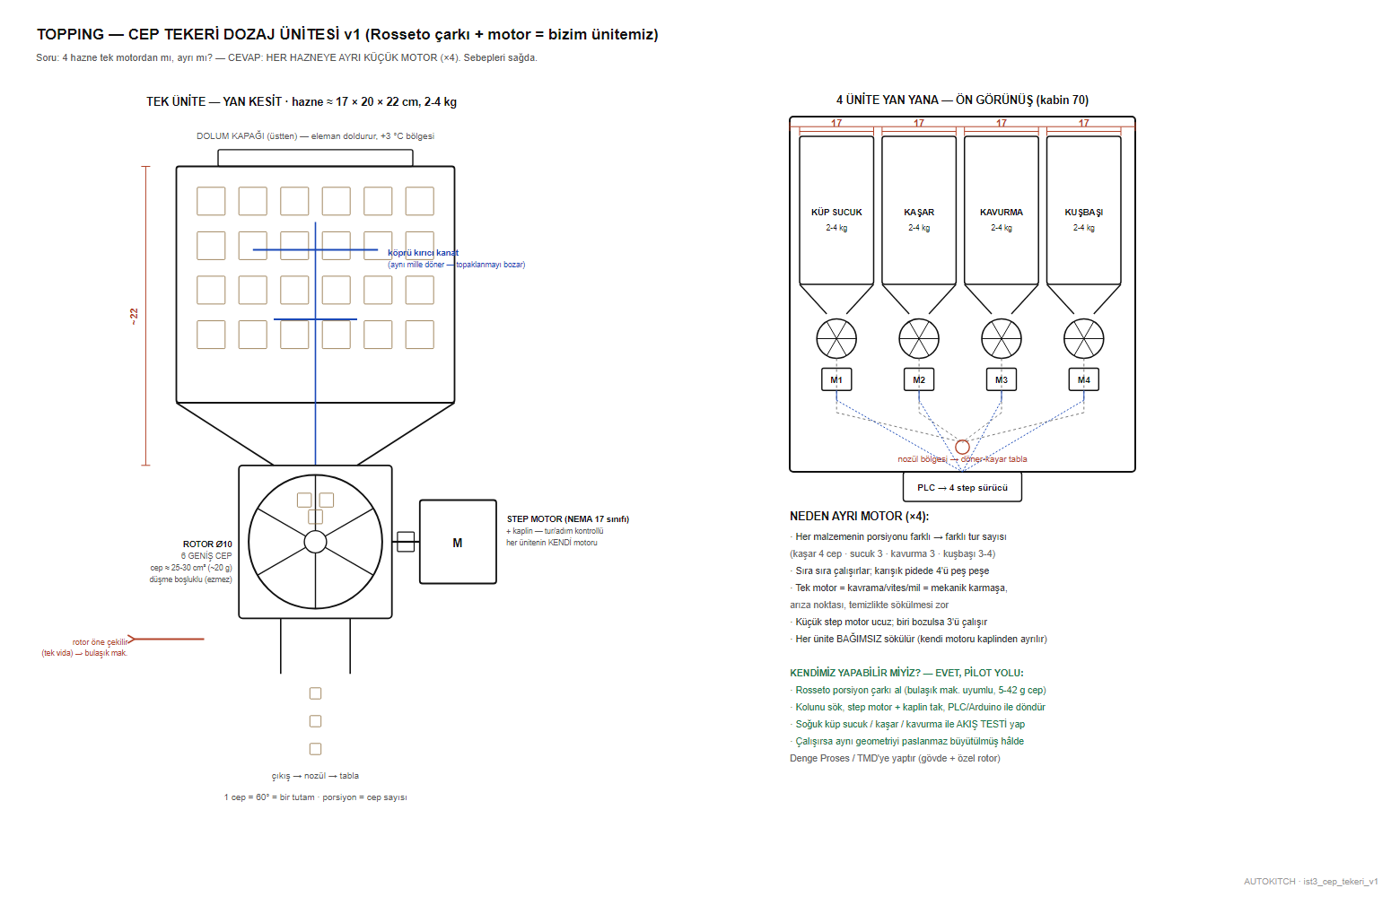
arastirma/3_TOPPING/ist3_cep_tekeri_v1.png
