kursatkemalkul/autokitch/arastirma/3_TOPPING/ist3_topping_detay_v13.png

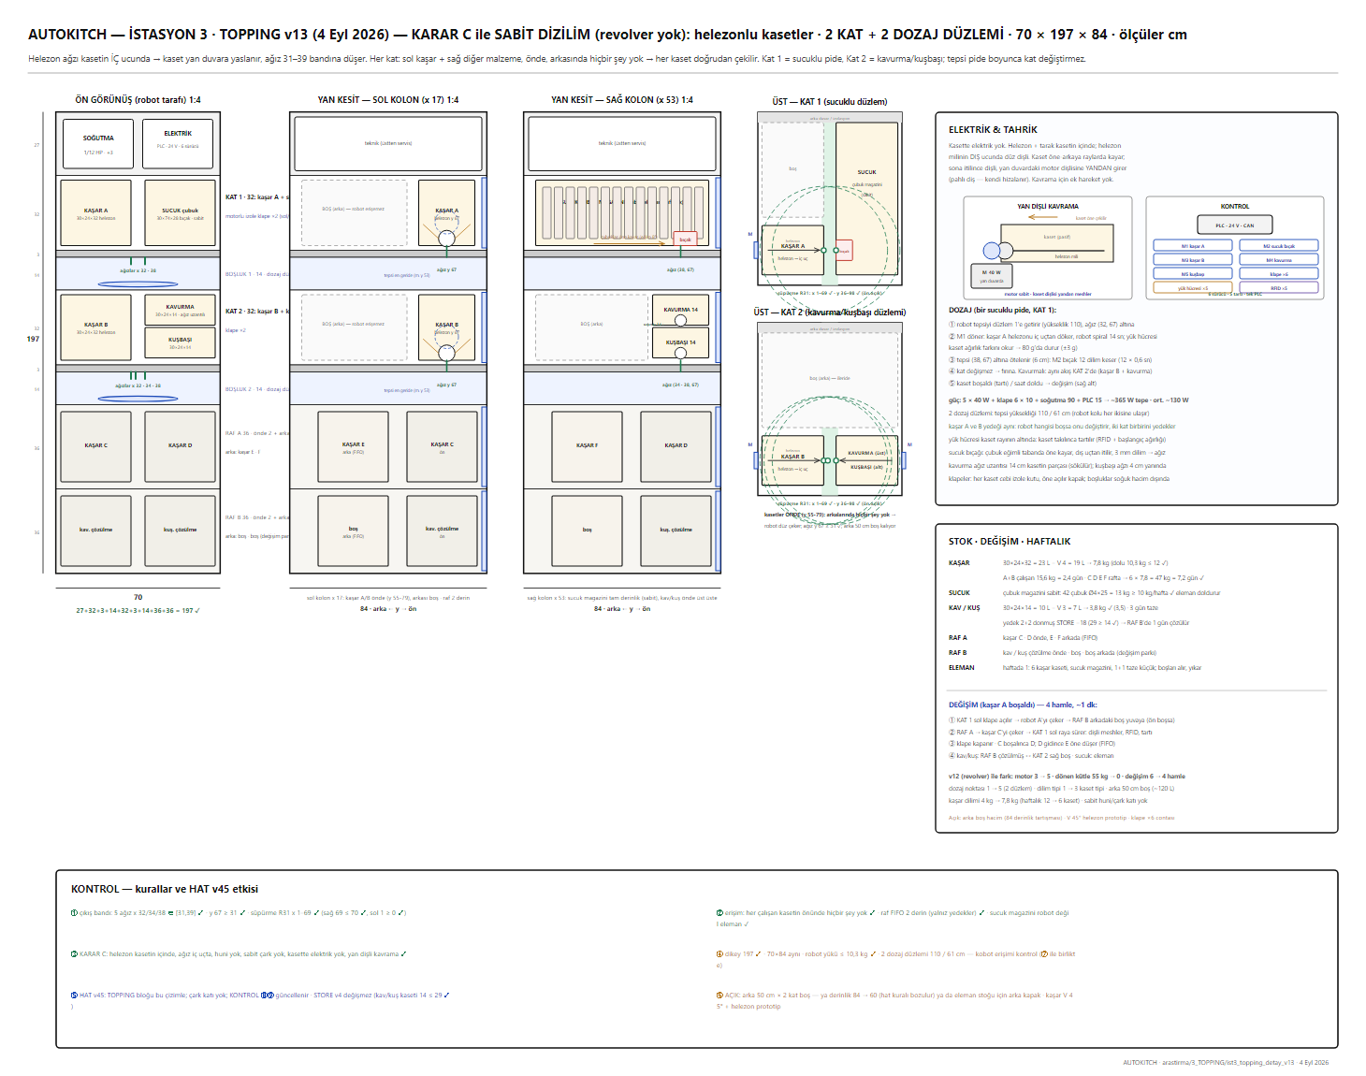
arastirma/3_TOPPING/ist3_topping_detay_v13.png
