kursatkemalkul/autokitch/arastirma/3_TOPPING/ist3_topping_detay_v14.png

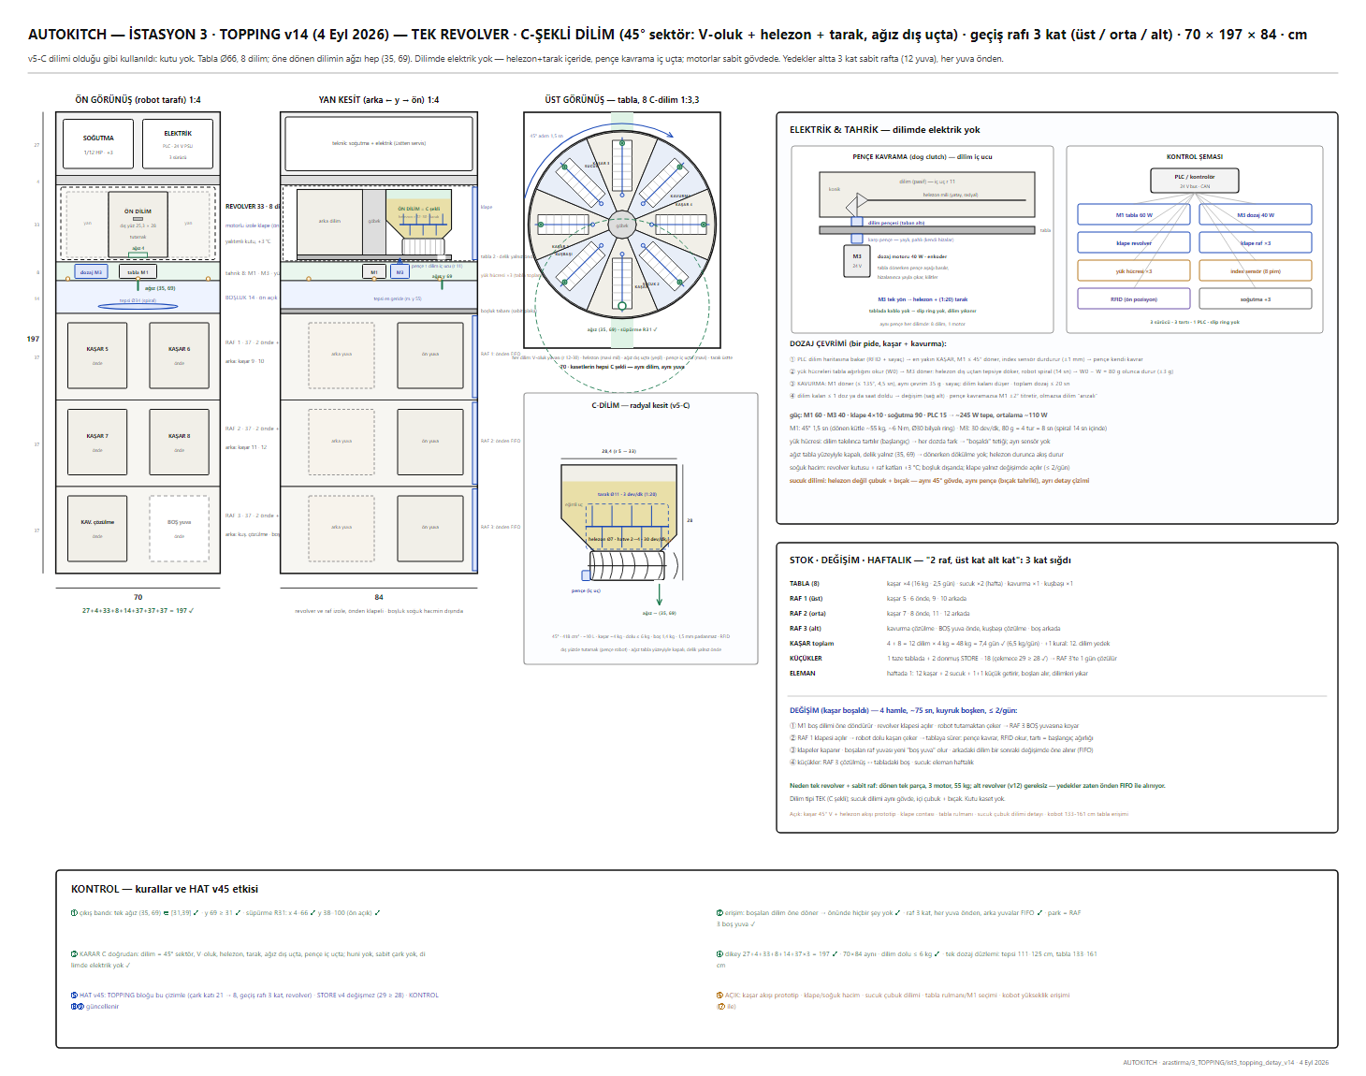
arastirma/3_TOPPING/ist3_topping_detay_v14.png
