kursatkemalkul/autokitch/arastirma/3_TOPPING/referans/kemal_kroki_topping_kaplar_5eyl.jpg

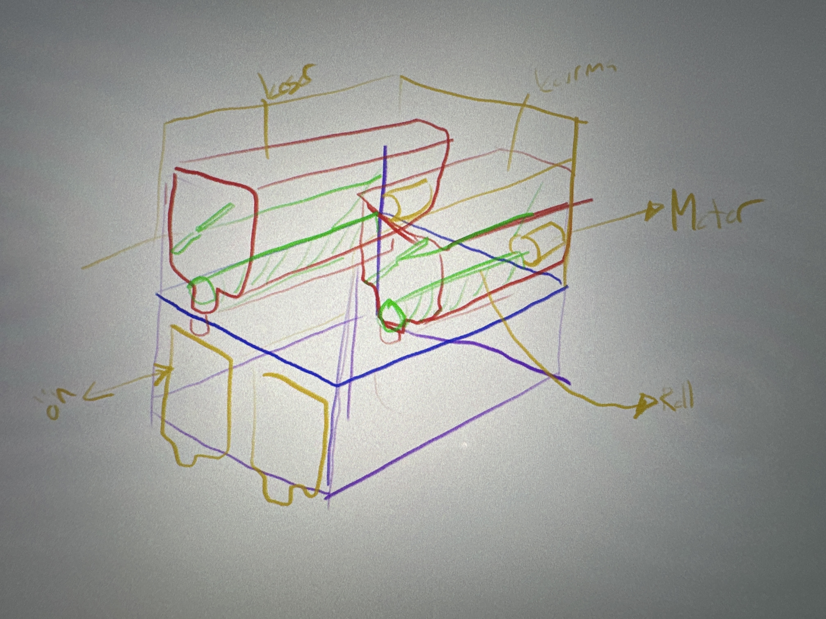
arastirma/3_TOPPING/referans/kemal_kroki_topping_kaplar_5eyl.jpg
