kursatkemalkul/autokitch/arastirma/3_TOPPING/referans/picnic_kare1_kopru_kirici.webp

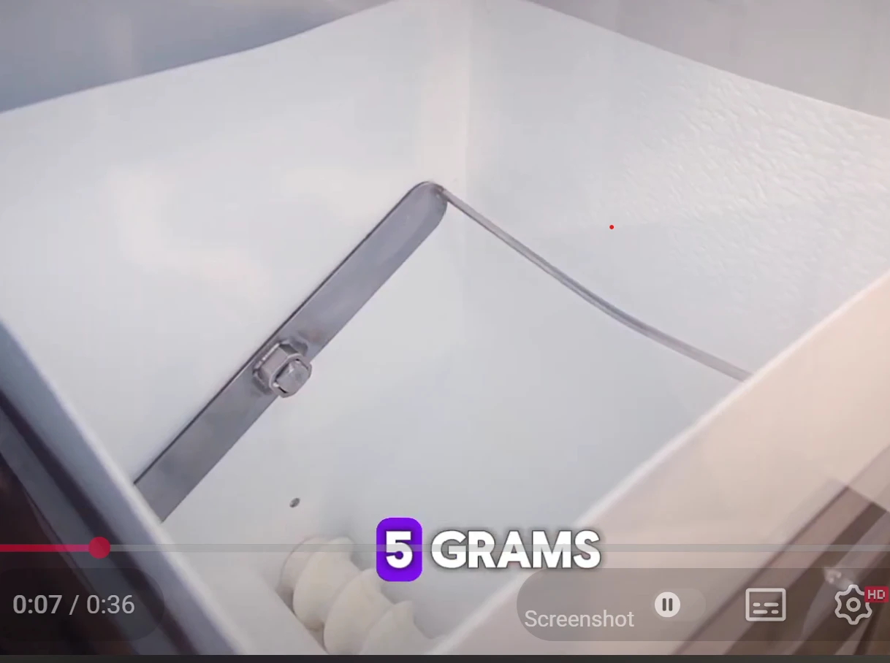
arastirma/3_TOPPING/referans/picnic_kare1_kopru_kirici.webp
