kursatkemalkul/autokitch/arastirma/3_TOPPING/referans/picnic_kare2_rotor.webp

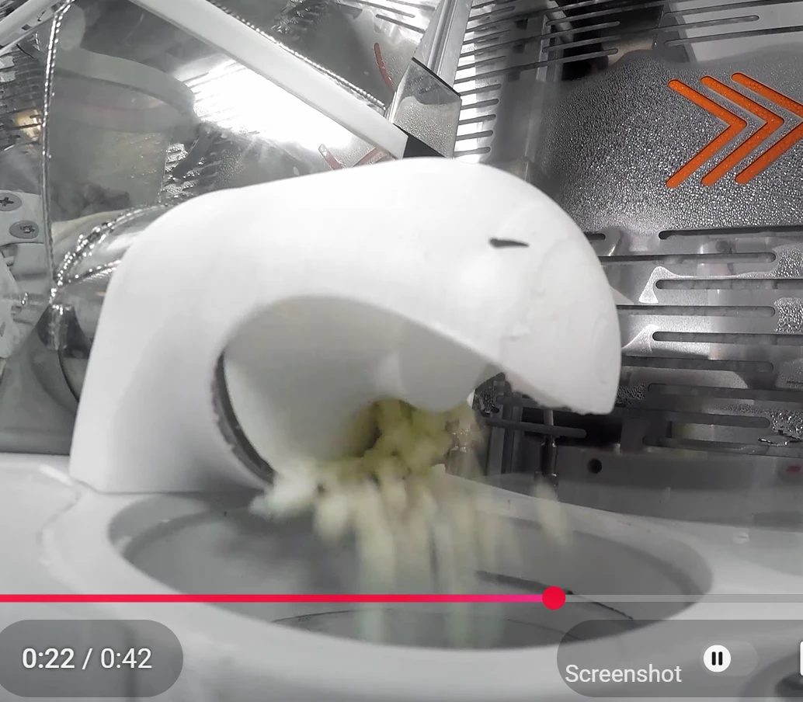
arastirma/3_TOPPING/referans/picnic_kare2_rotor.webp
