kursatkemalkul/autokitch/arastirma/3_TOPPING/TOPPING_asm_on.png

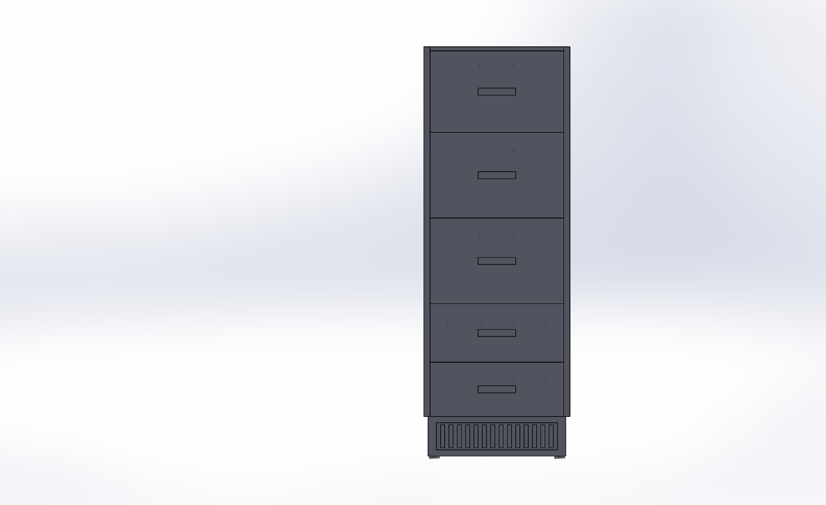
arastirma/3_TOPPING/TOPPING_asm_on.png
