kursatkemalkul/autokitch/arastirma/3_TOPPING/topping_cikis_geometri_v1.png

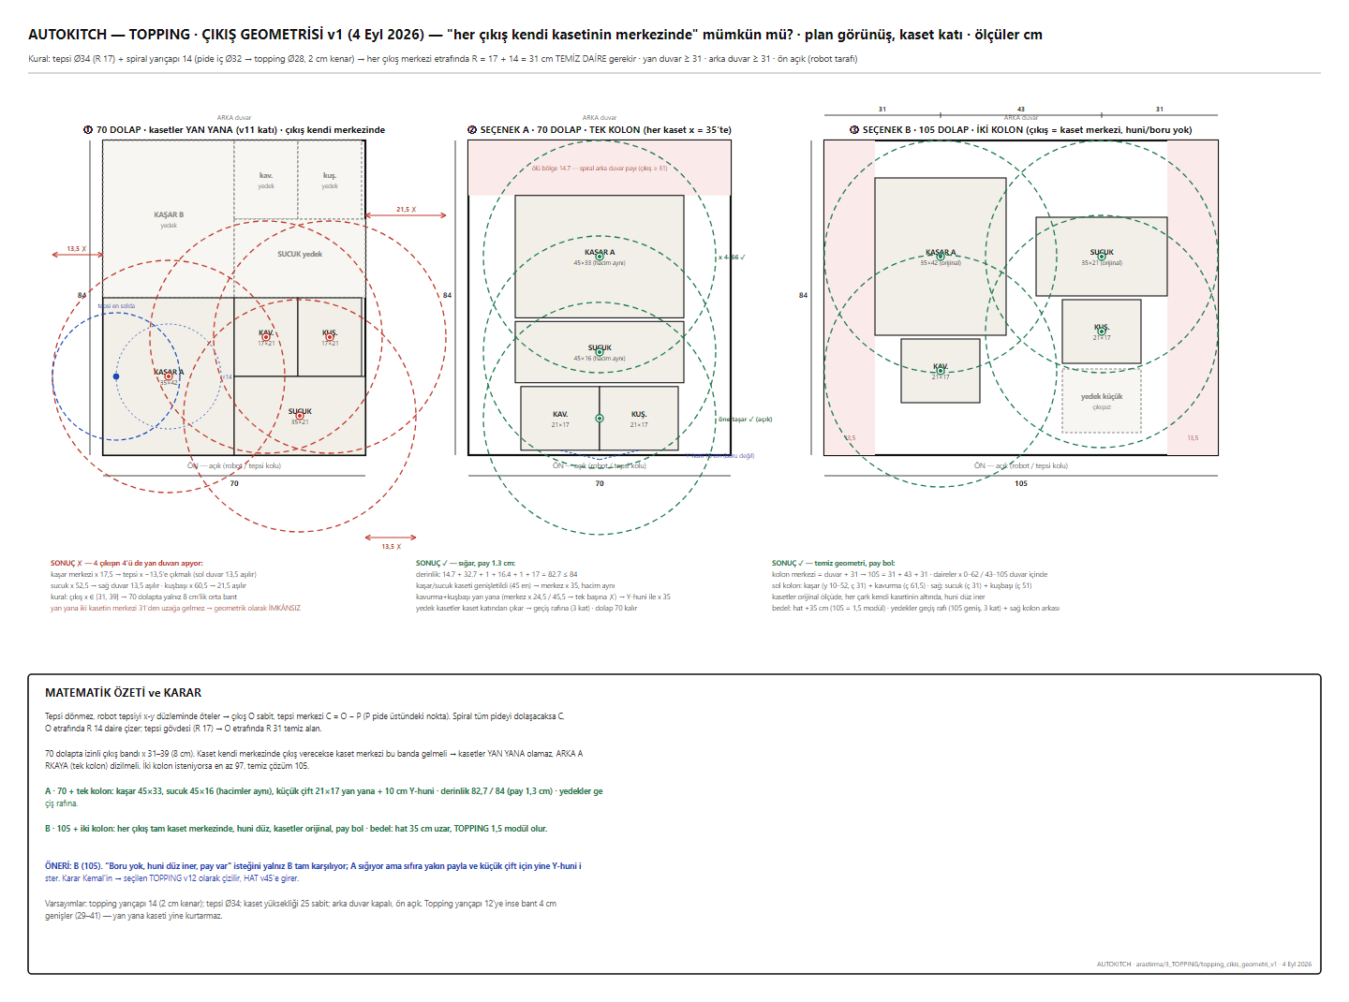
arastirma/3_TOPPING/topping_cikis_geometri_v1.png
