kursatkemalkul/autokitch/arastirma/3_TOPPING/topping_cikis_geometri_v2.png

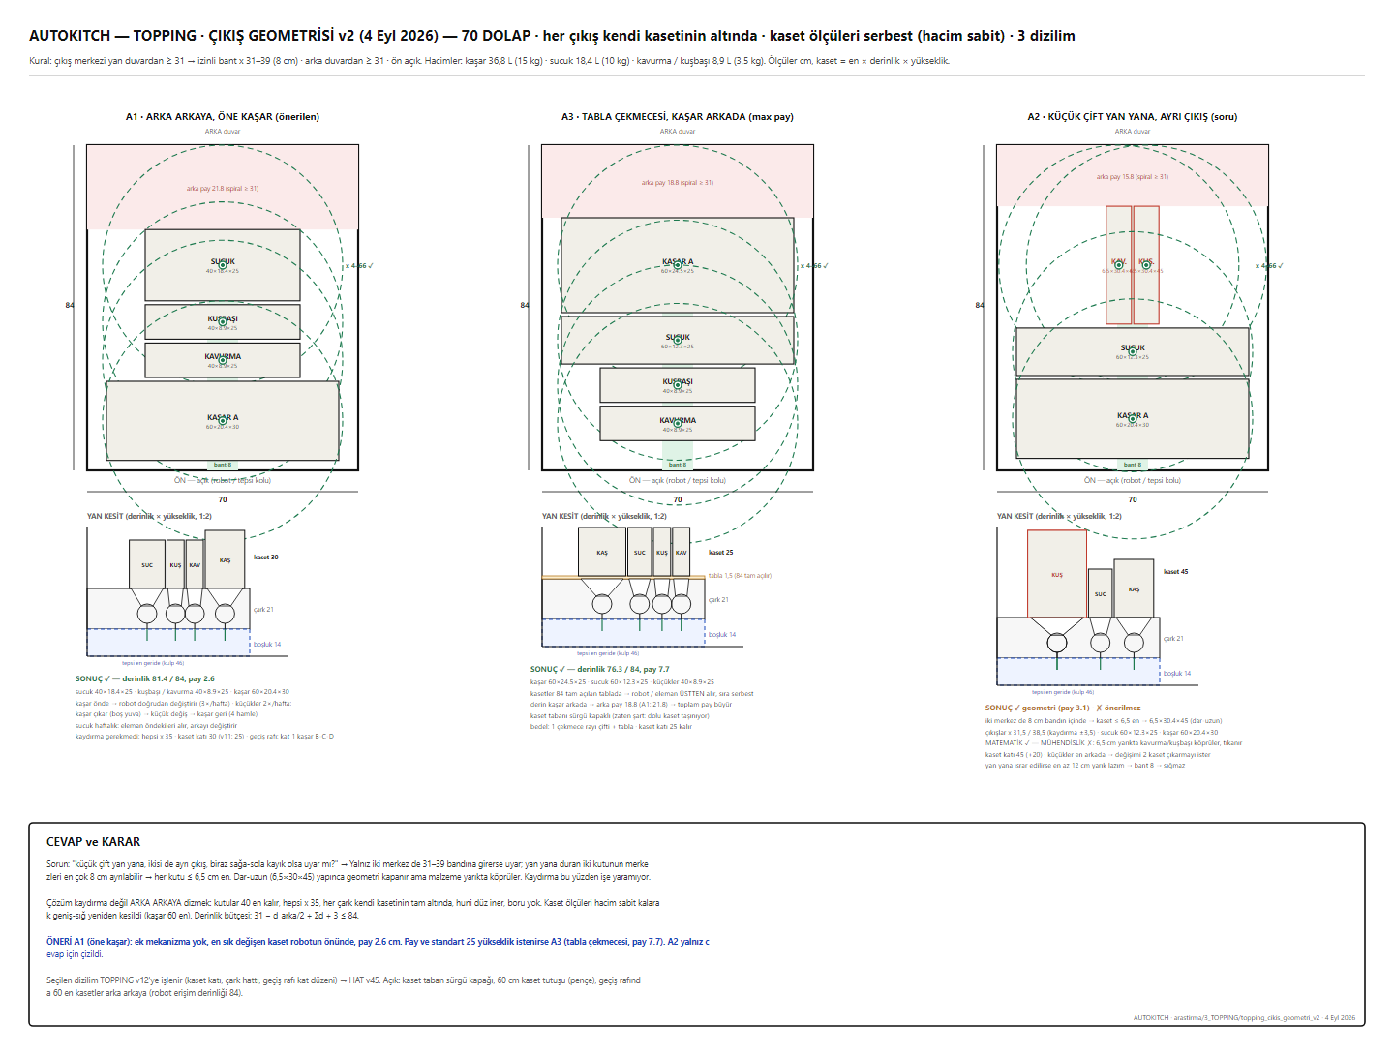
arastirma/3_TOPPING/topping_cikis_geometri_v2.png
