kursatkemalkul/autokitch/arastirma/3_TOPPING/topping_dozaj_unitesi_v1.png

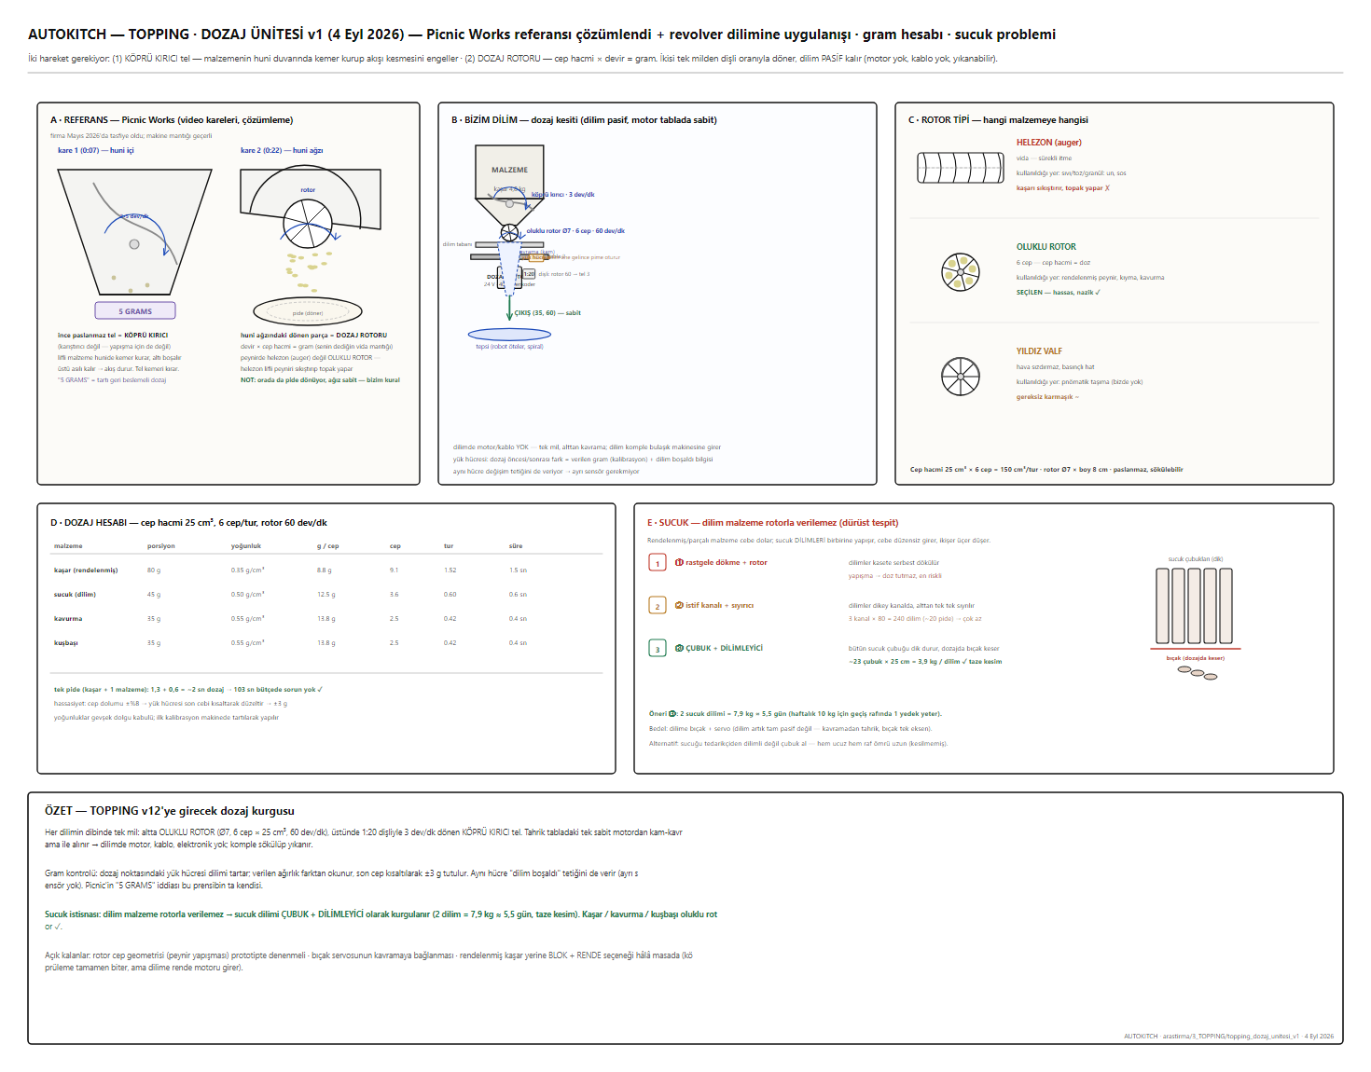
arastirma/3_TOPPING/topping_dozaj_unitesi_v1.png
