kursatkemalkul/autokitch/arastirma/3_TOPPING/topping_dozaj_unitesi_v2.png

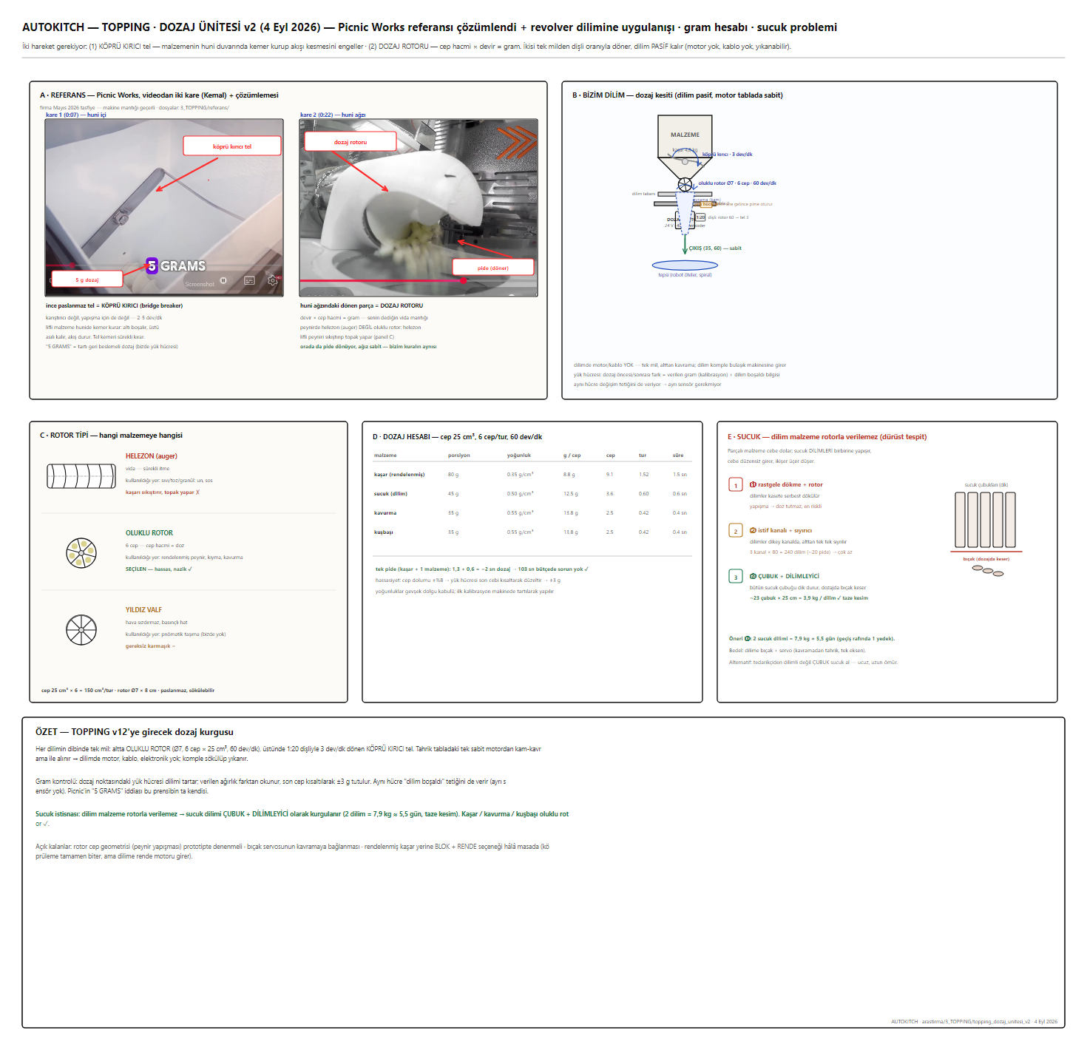
arastirma/3_TOPPING/topping_dozaj_unitesi_v2.png
