kursatkemalkul/autokitch/arastirma/3_TOPPING/topping_dozaj_unitesi_v3.png

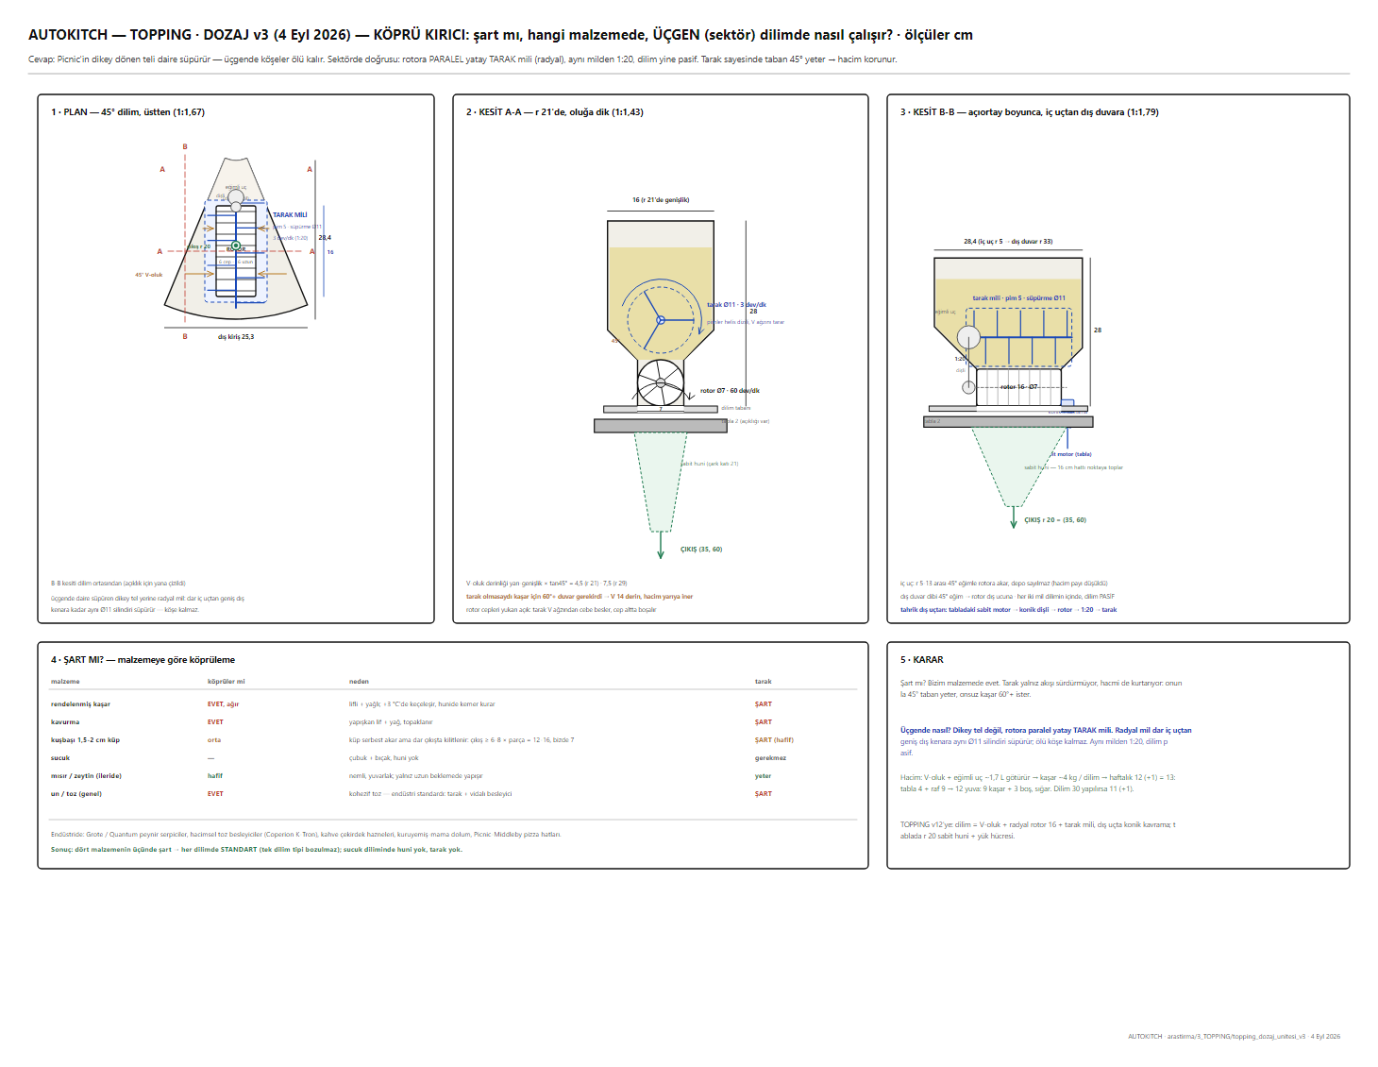
arastirma/3_TOPPING/topping_dozaj_unitesi_v3.png
