kursatkemalkul/autokitch/arastirma/3_TOPPING/topping_dozaj_unitesi_v4.png

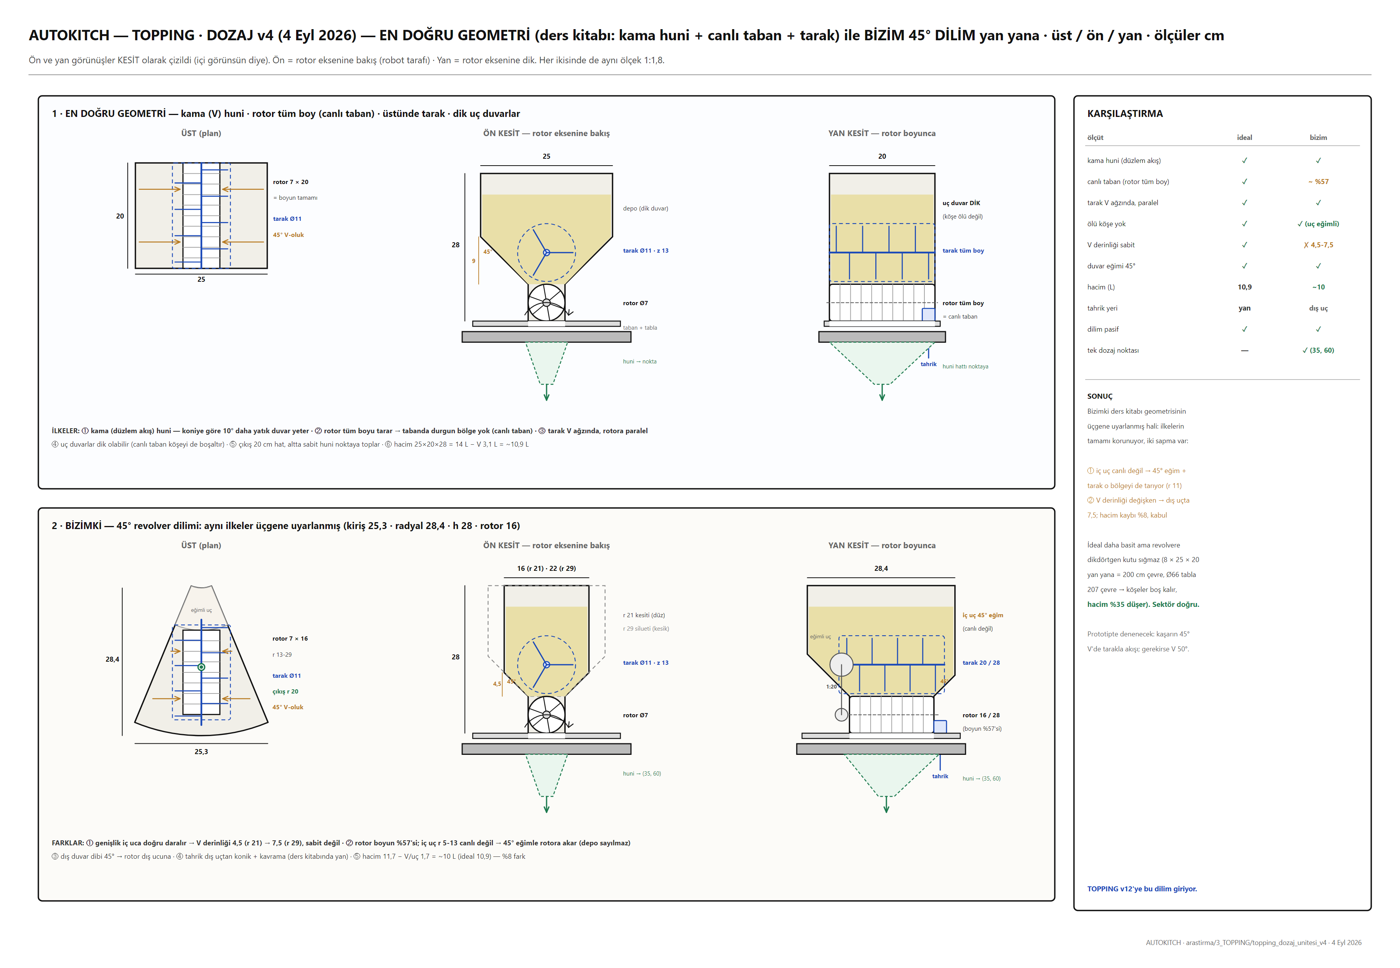
arastirma/3_TOPPING/topping_dozaj_unitesi_v4.png
