kursatkemalkul/autokitch/arastirma/3_TOPPING/topping_kaset_form_v1.png

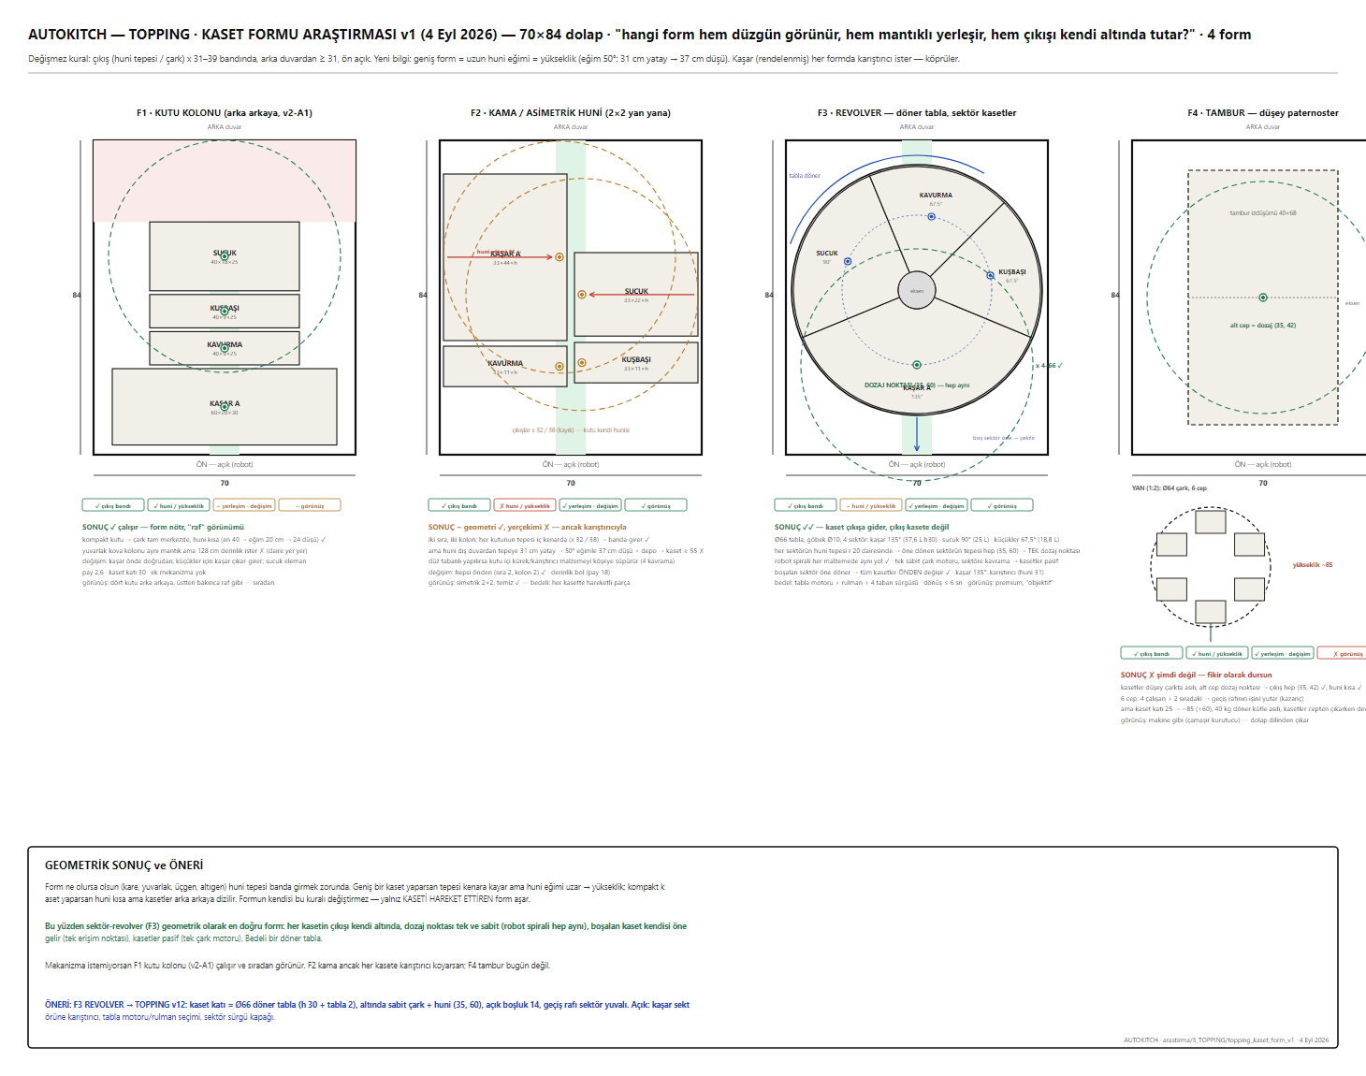
arastirma/3_TOPPING/topping_kaset_form_v1.png
