kursatkemalkul/autokitch/arastirma/3_TOPPING/topping_revolver_v1.png

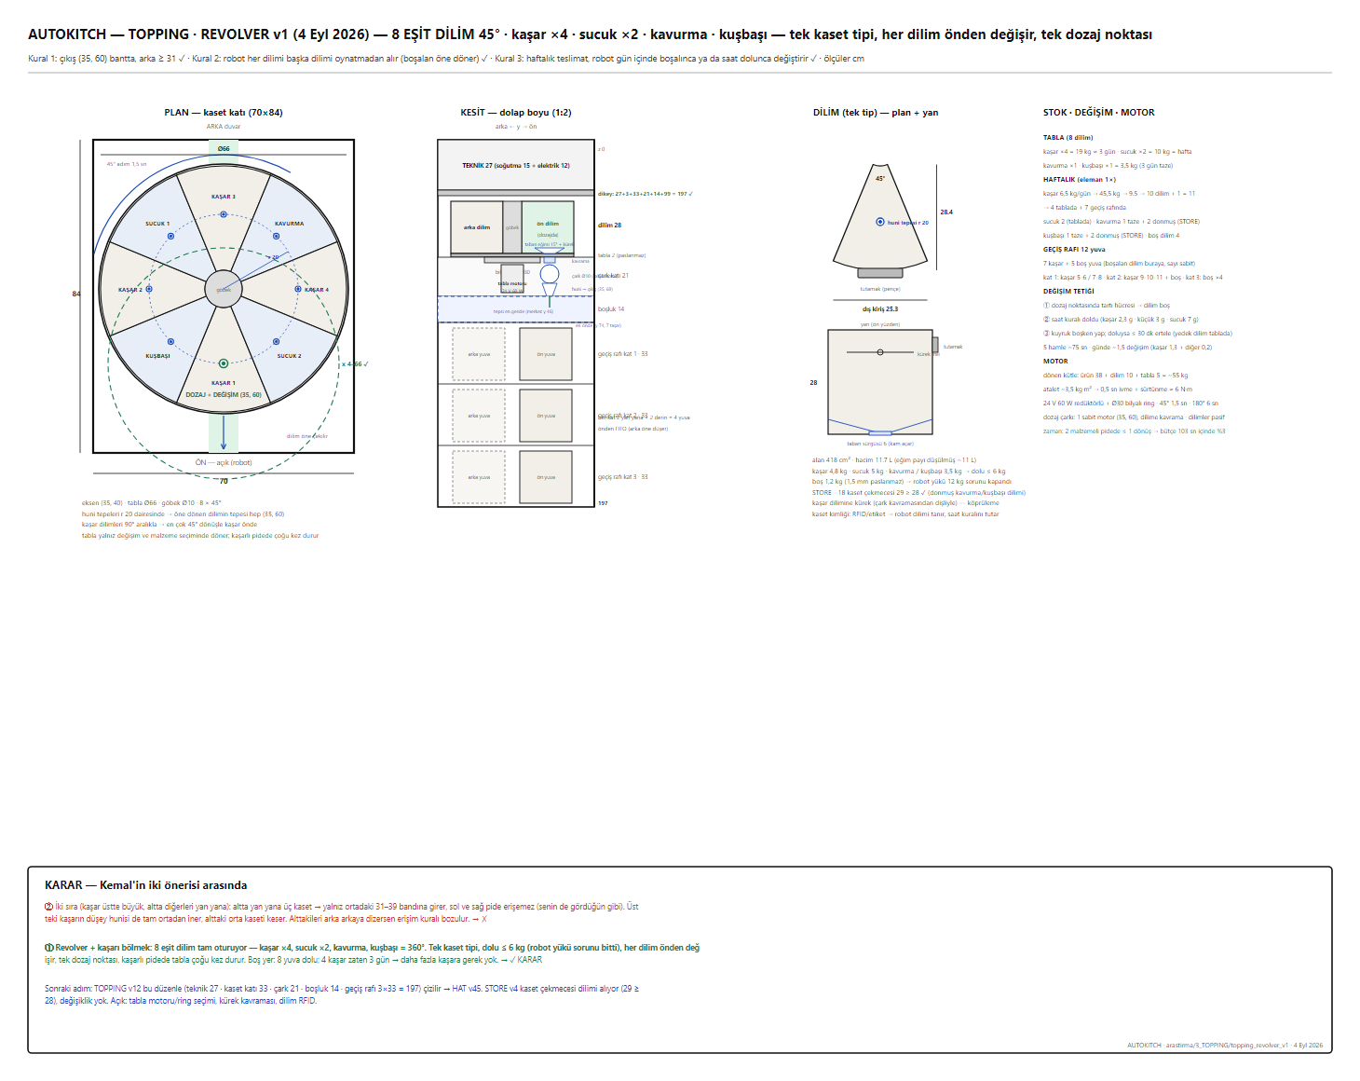
arastirma/3_TOPPING/topping_revolver_v1.png
