kursatkemalkul/autokitch/arastirma/4_OVEN/ist4_oven_detay_v2.png

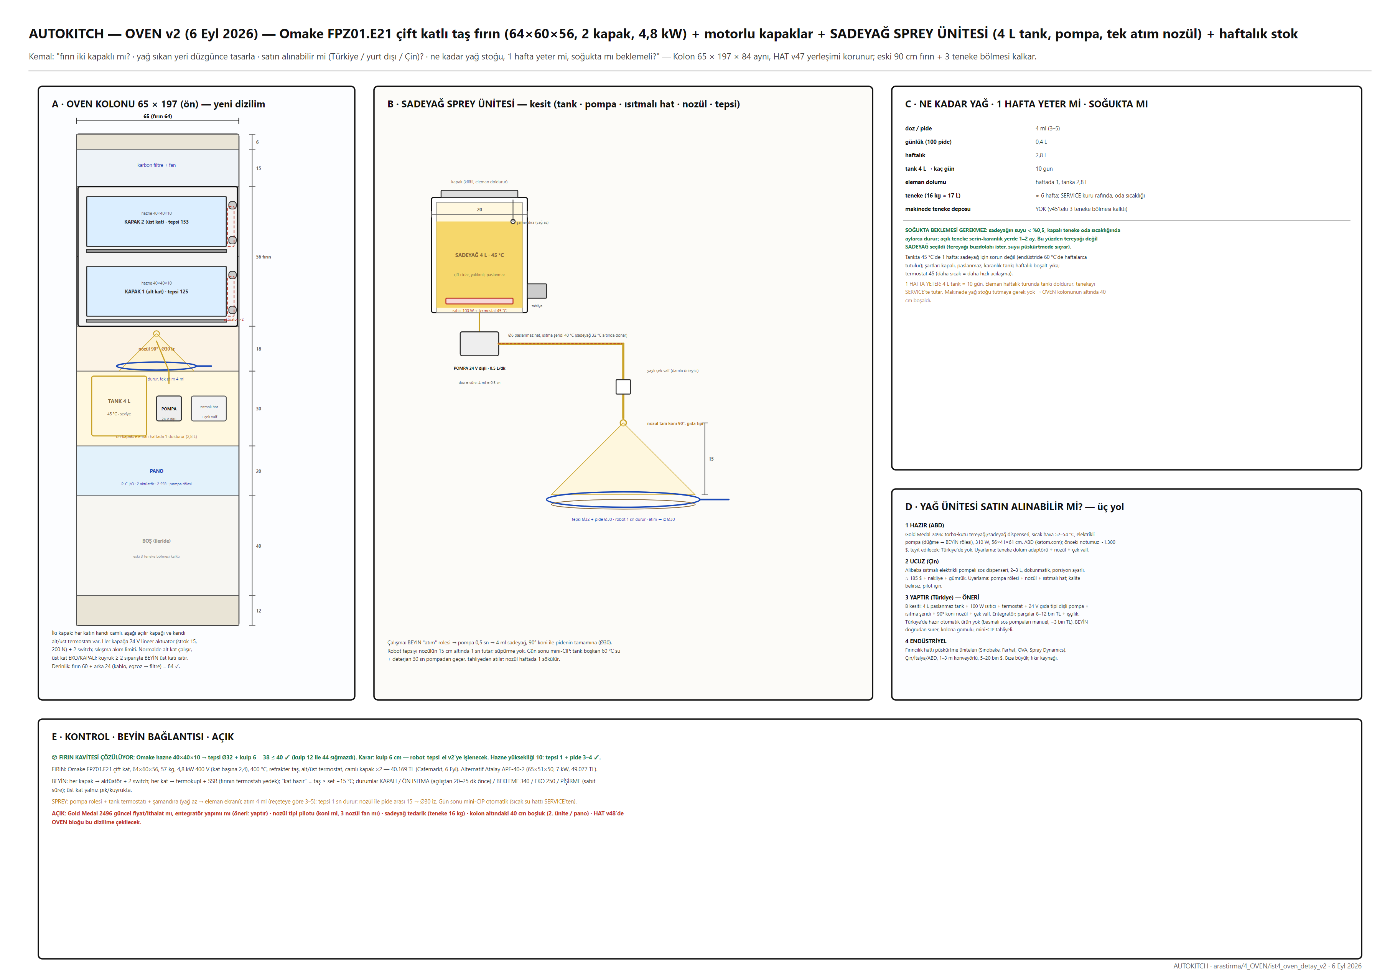
arastirma/4_OVEN/ist4_oven_detay_v2.png
