kursatkemalkul/autokitch/arastirma/4_OVEN/ist4_oven_detay_v3.png

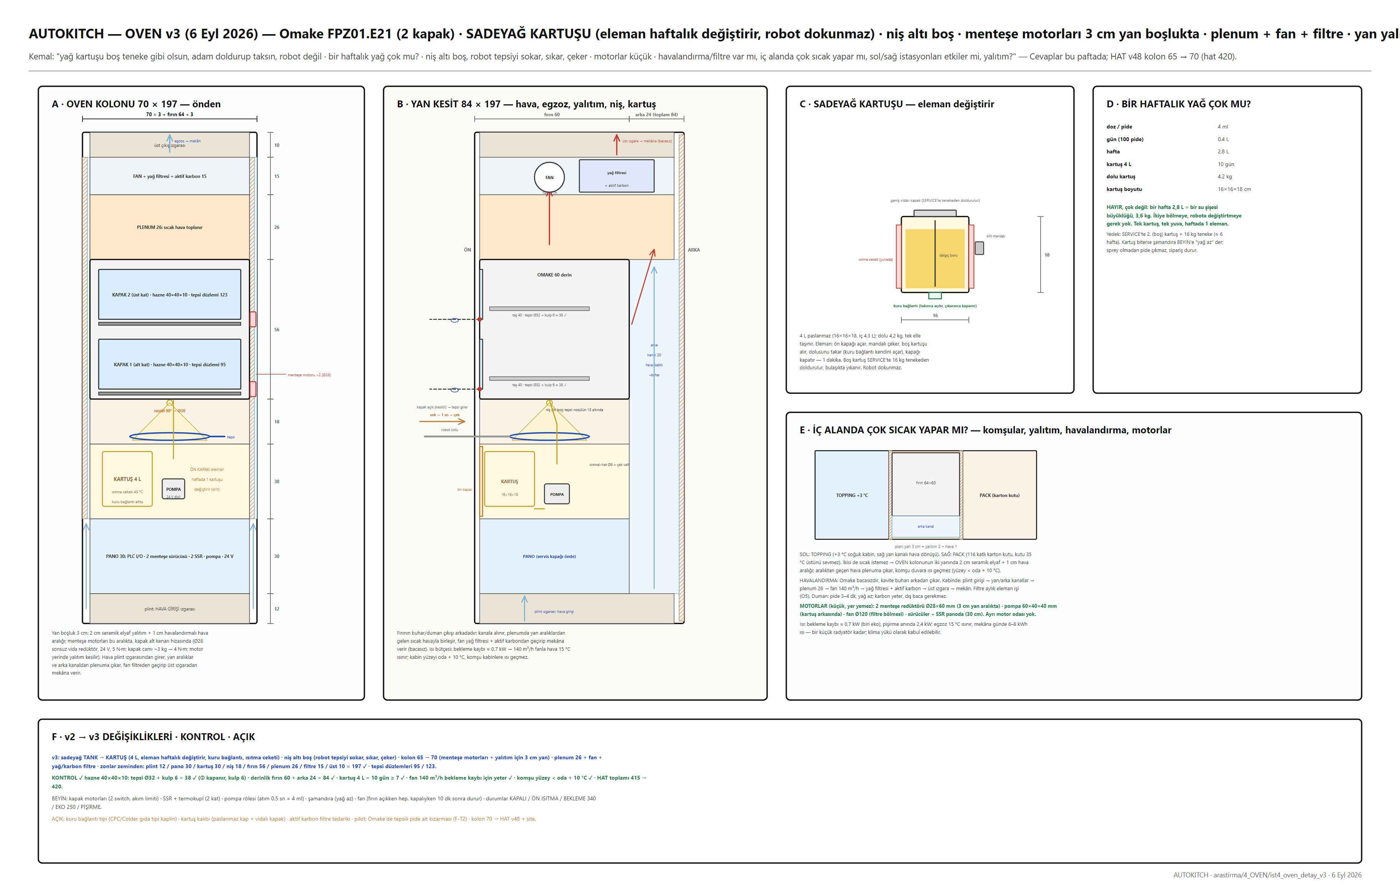
arastirma/4_OVEN/ist4_oven_detay_v3.png
