kursatkemalkul/autokitch/arastirma/6_PICKUP/kiosk_siparis_ekrani_v1.png

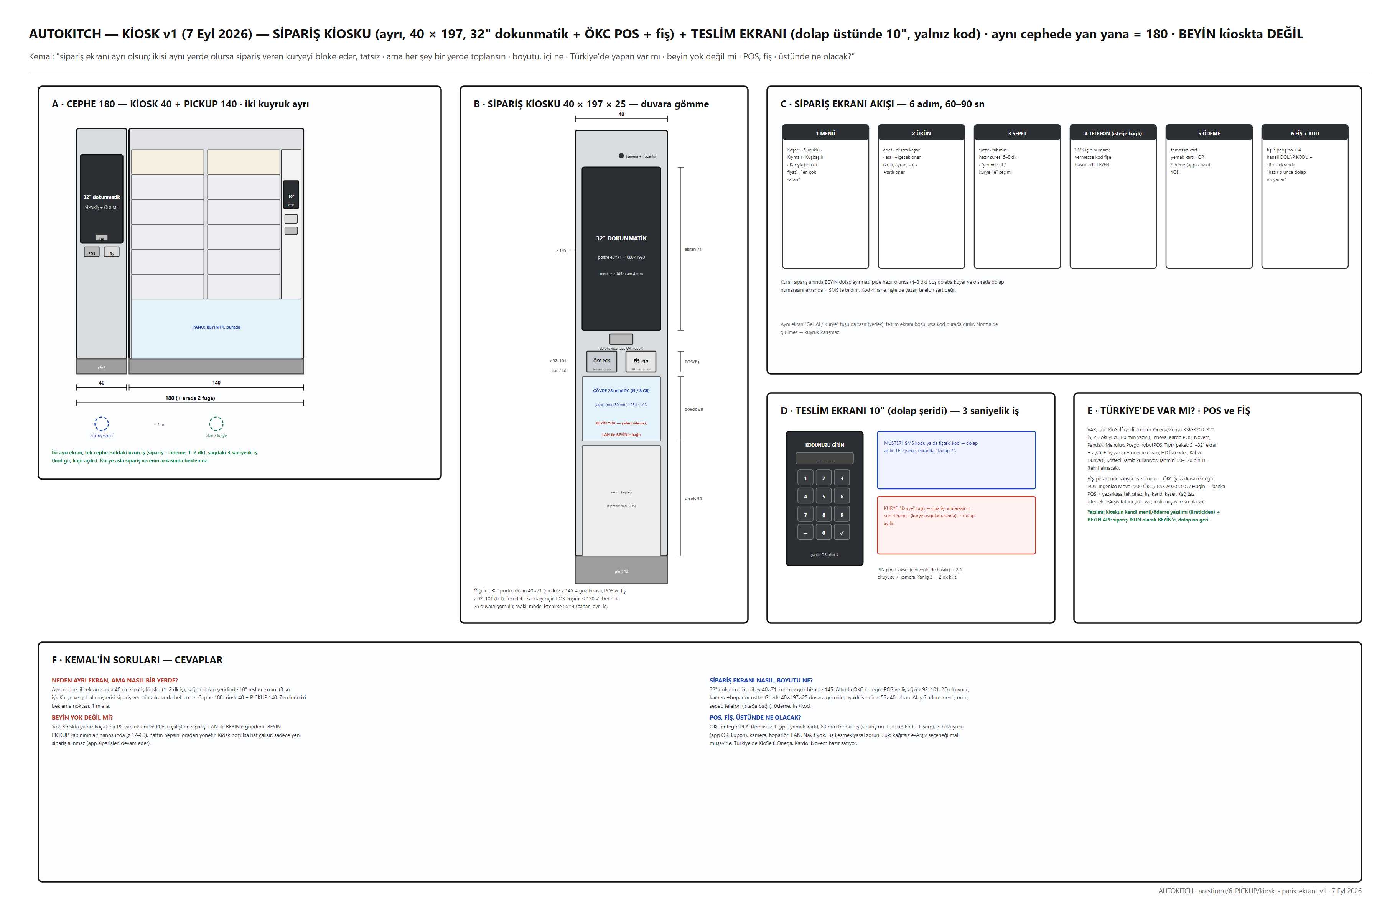
arastirma/6_PICKUP/kiosk_siparis_ekrani_v1.png
