kursatkemalkul/autokitch/arastirma/6_PICKUP/kod_unitesi_teknik_v1.png

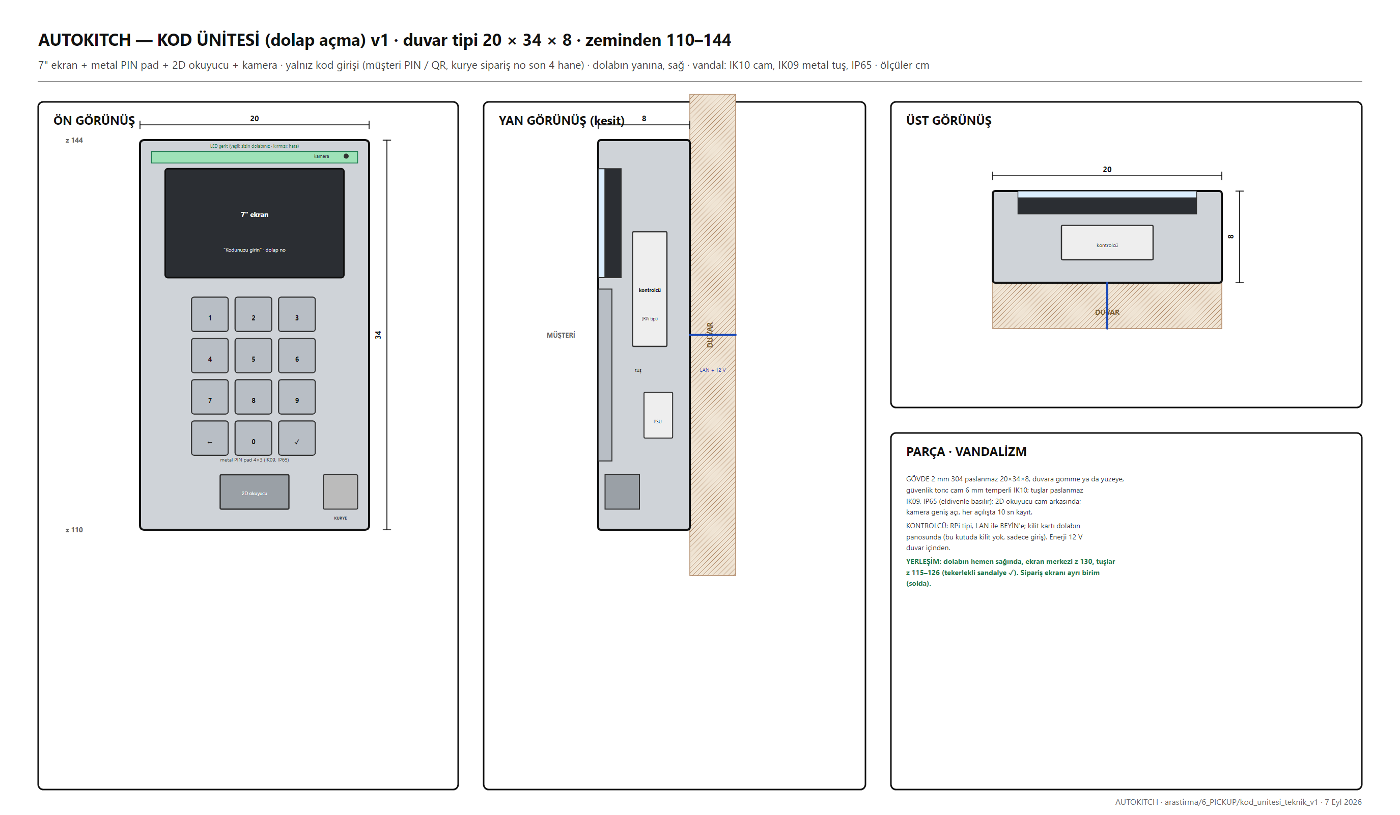
arastirma/6_PICKUP/kod_unitesi_teknik_v1.png
