kursatkemalkul/autokitch/arastirma/6_PICKUP/pickup_dolap_teknik_v1.png

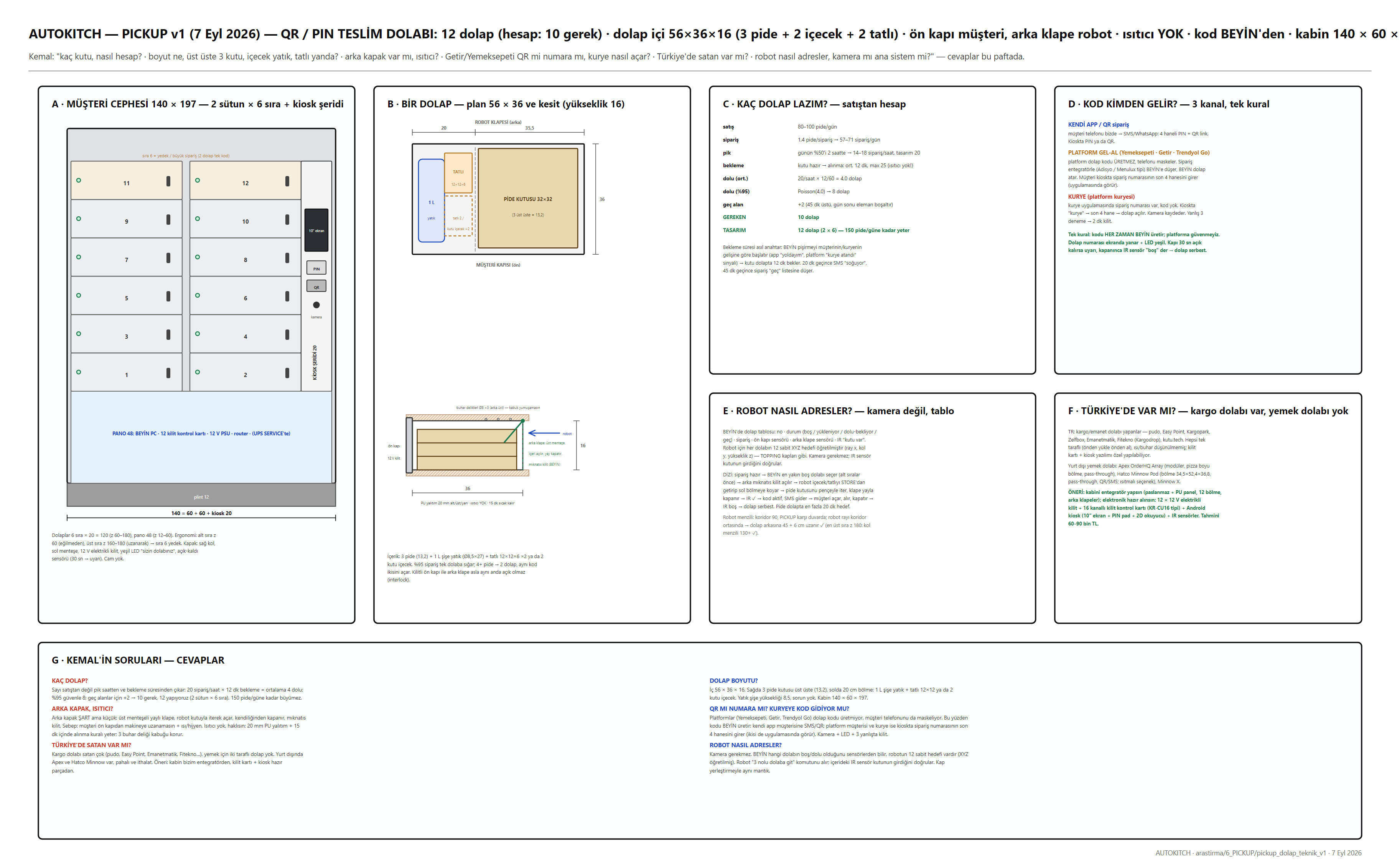
arastirma/6_PICKUP/pickup_dolap_teknik_v1.png
