kursatkemalkul/autokitch/arastirma/6_PICKUP/siparis_ekrani_teknik_v2.png

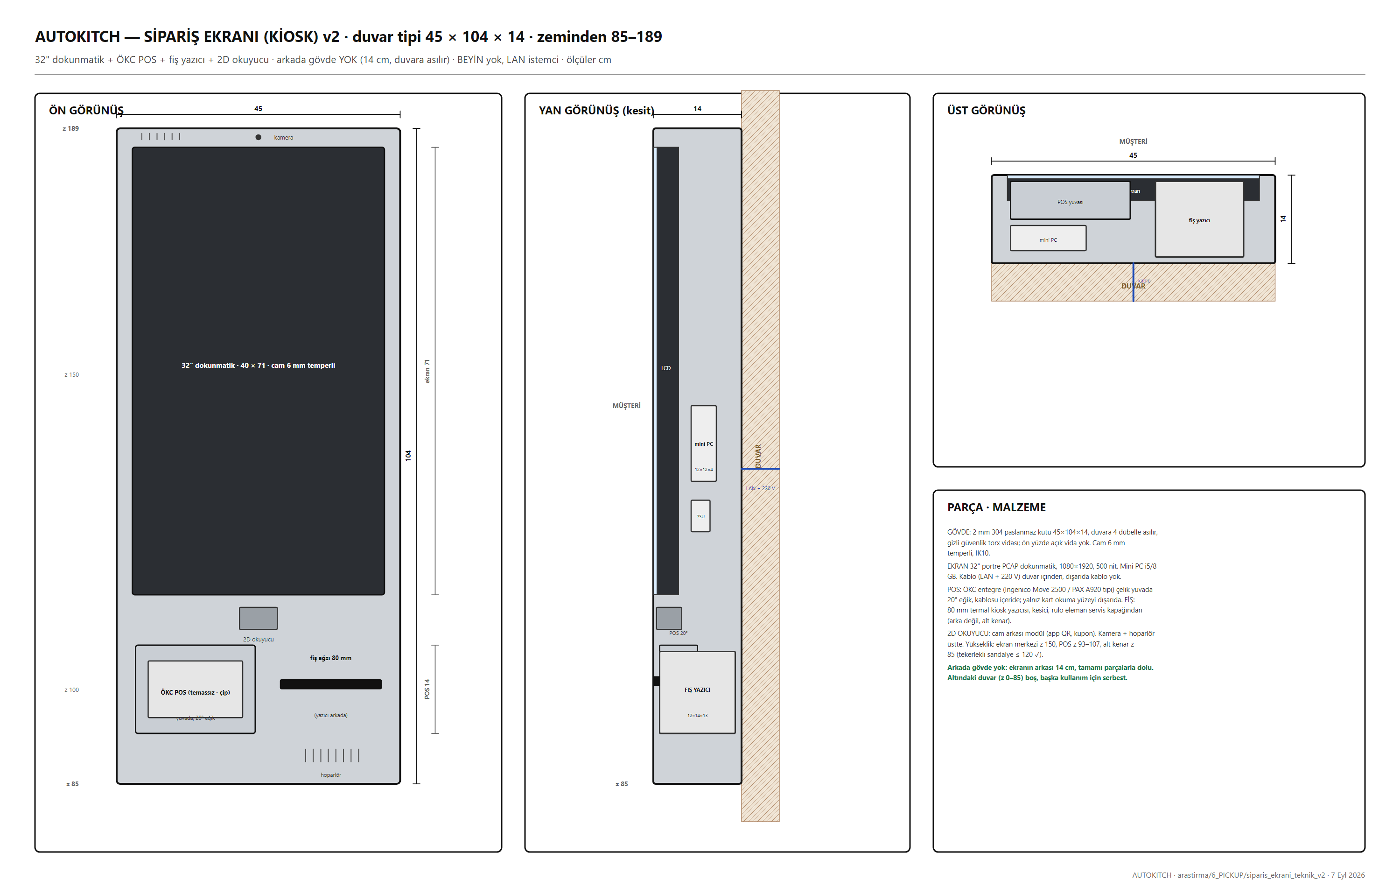
arastirma/6_PICKUP/siparis_ekrani_teknik_v2.png
