kursatkemalkul/autokitch/arastirma/6_PICKUP/teslim_dolabi_teknik_v2.png

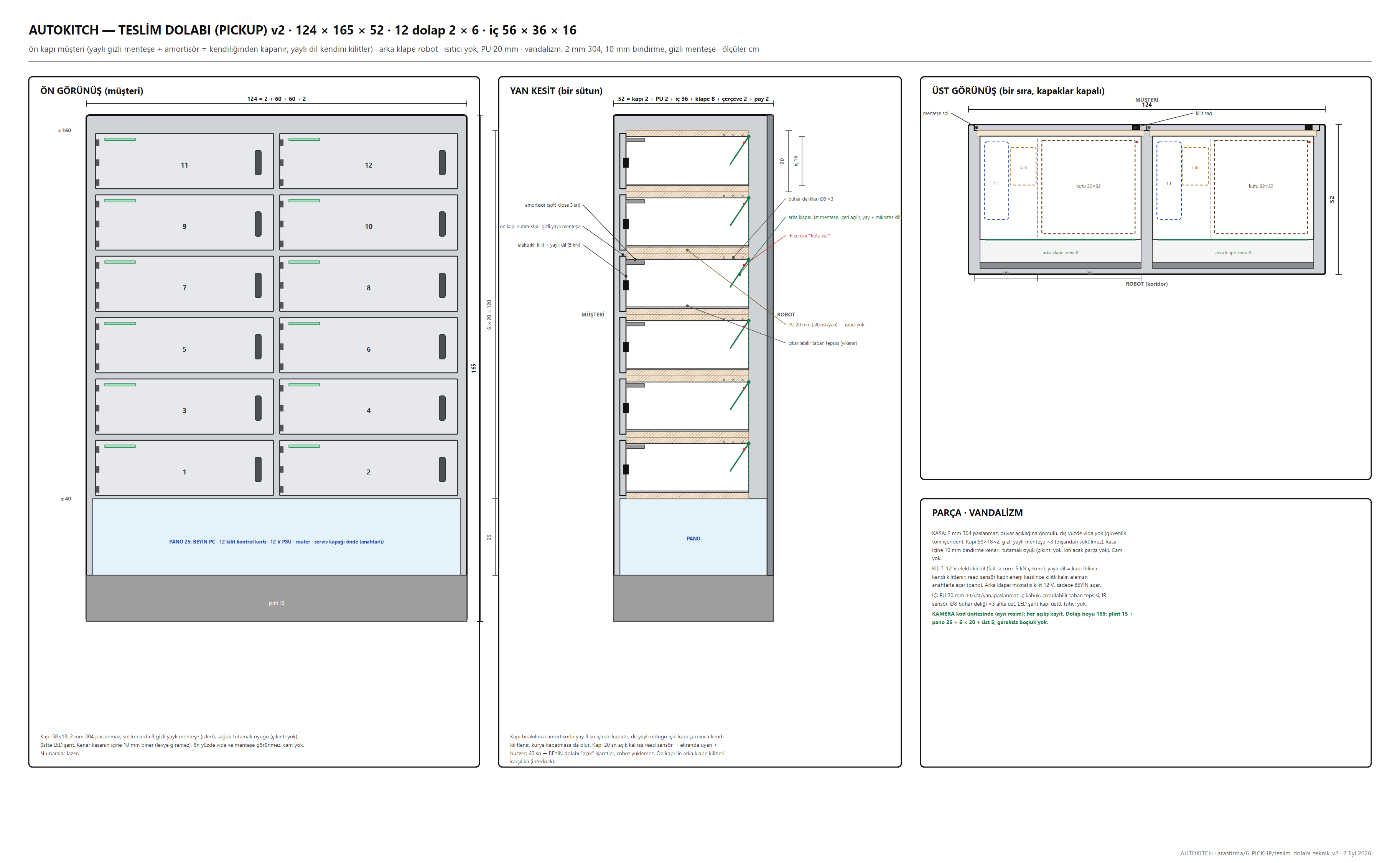
arastirma/6_PICKUP/teslim_dolabi_teknik_v2.png
