kursatkemalkul/autokitch/arastirma/8_ROBOT/tepsi_hareket_analizi_v1.png

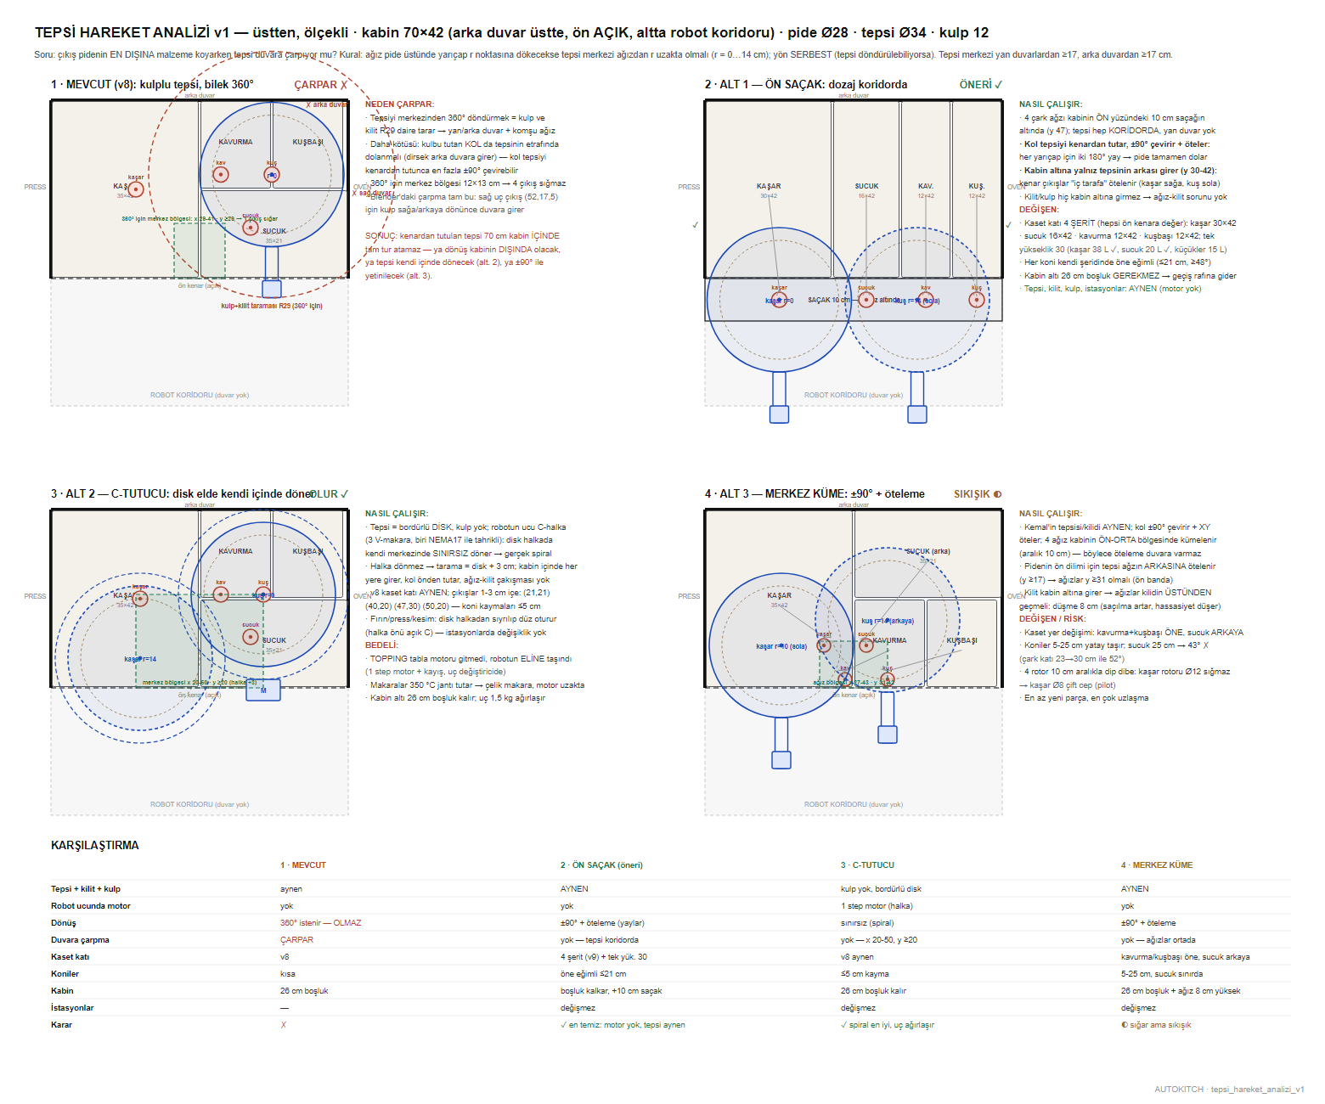
arastirma/8_ROBOT/tepsi_hareket_analizi_v1.png
