kursatkemalkul/autokitch/arastirma/_ortak/FIRIN_KAPAK_CAM/FIRIN_KAPAK_CAM_asm_iso.png

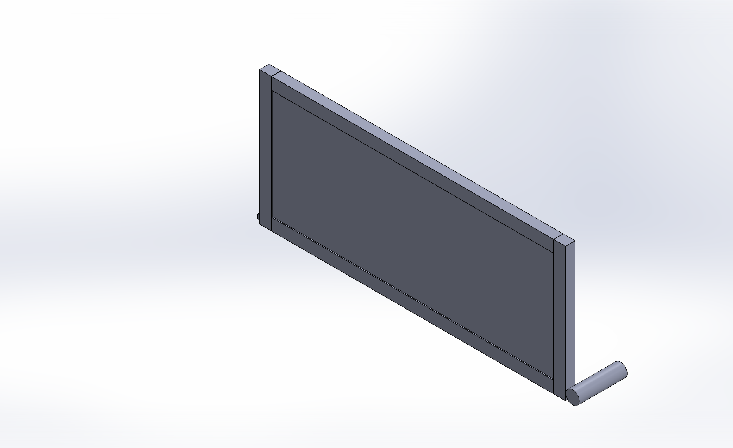
arastirma/_ortak/FIRIN_KAPAK_CAM/FIRIN_KAPAK_CAM_asm_iso.png
