kursatkemalkul/autokitch/arastirma/_ortak/HAMUR_TOPU_220g/HAMUR_TOPU_220g_asm_iso.png

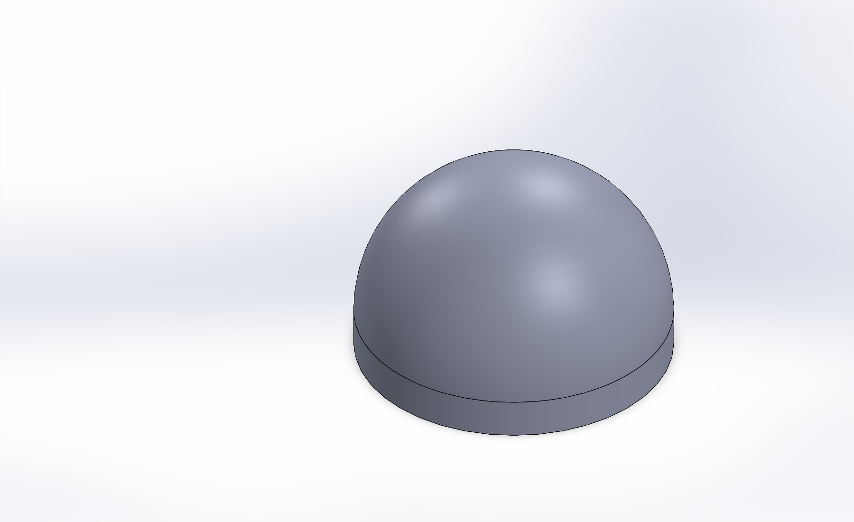
arastirma/_ortak/HAMUR_TOPU_220g/HAMUR_TOPU_220g_asm_iso.png
