kursatkemalkul/autokitch/arastirma/_ortak/HAMUR_TOPU_220g/HAMUR_TOPU_220g_asm_on.png

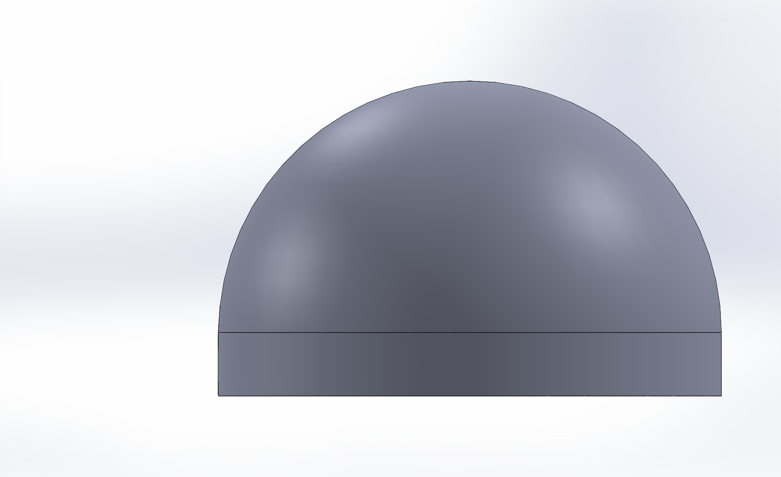
arastirma/_ortak/HAMUR_TOPU_220g/HAMUR_TOPU_220g_asm_on.png
