kursatkemalkul/autokitch/arastirma/_ortak/KABLO_24V_D5/KABLO_24V_D5_asm_on.png

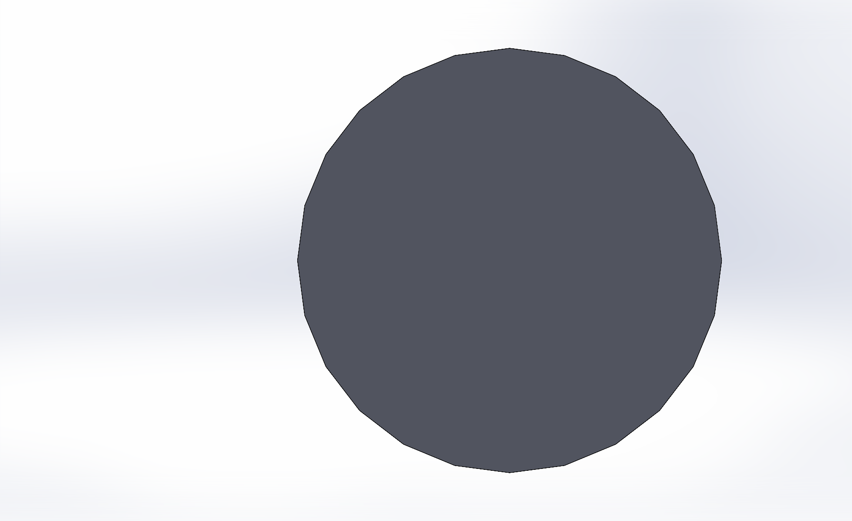
arastirma/_ortak/KABLO_24V_D5/KABLO_24V_D5_asm_on.png
