kursatkemalkul/autokitch/arastirma/_ortak/KAP_YAG_14x68x24/KAP_YAG_14x68x24_asm_iso.png

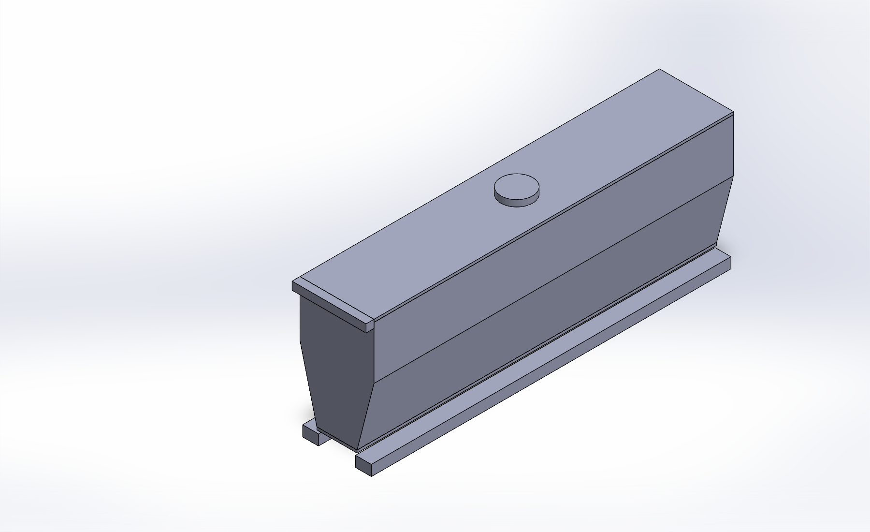
arastirma/_ortak/KAP_YAG_14x68x24/KAP_YAG_14x68x24_asm_iso.png
