kursatkemalkul/autokitch/arastirma/_ortak/KUTU_BLANK_40x76/KUTU_BLANK_40x76_asm_iso.png

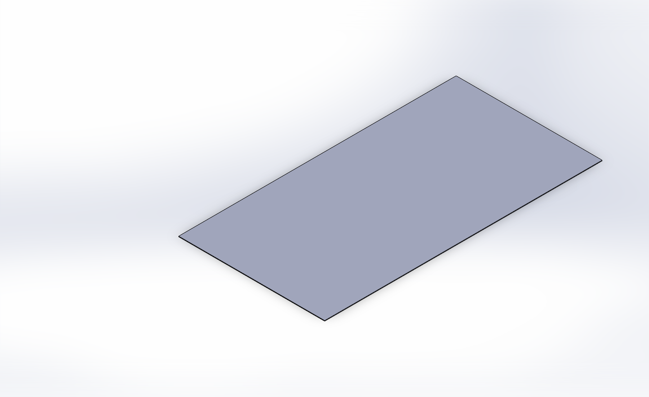
arastirma/_ortak/KUTU_BLANK_40x76/KUTU_BLANK_40x76_asm_iso.png
