kursatkemalkul/autokitch/arastirma/_ortak/KUTU_KATLI_32x32/KUTU_KATLI_32x32_asm_on.png

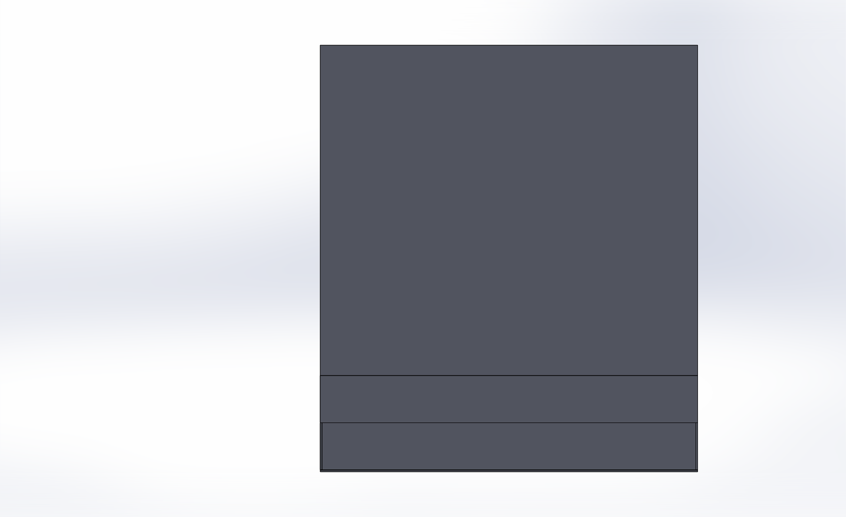
arastirma/_ortak/KUTU_KATLI_32x32/KUTU_KATLI_32x32_asm_on.png
