kursatkemalkul/autokitch/arastirma/_ortak/MOTOR_TAHRIK_GRUBU/MOTOR_TAHRIK_GRUBU_asm_on.png

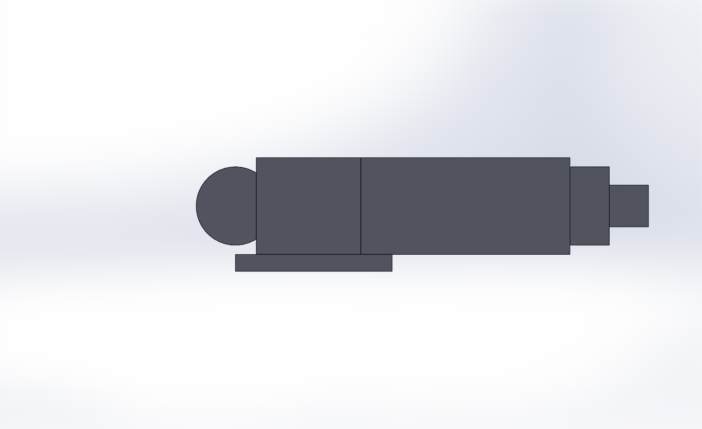
arastirma/_ortak/MOTOR_TAHRIK_GRUBU/MOTOR_TAHRIK_GRUBU_asm_on.png
