kursatkemalkul/autokitch/arastirma/_ortak/TEPSI_HAMUR_GN21/TEPSI_HAMUR_GN21_asm_iso.png

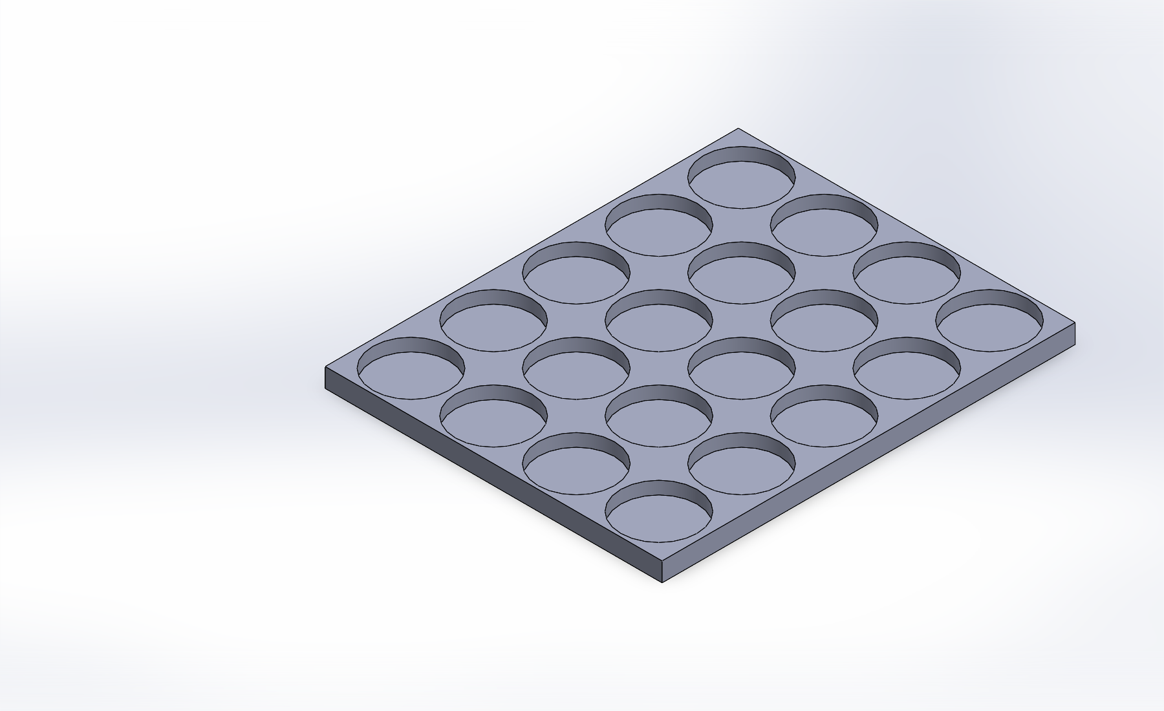
arastirma/_ortak/TEPSI_HAMUR_GN21/TEPSI_HAMUR_GN21_asm_iso.png
