kursatkemalkul/autokitch/arastirma/_ortak/UC_YUVASI/UC_YUVASI_asm_iso.png

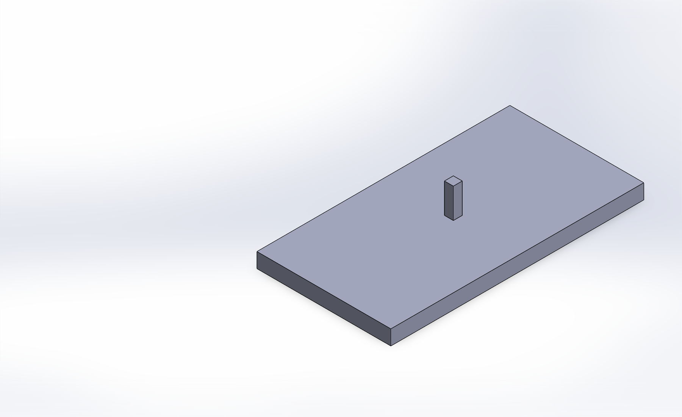
arastirma/_ortak/UC_YUVASI/UC_YUVASI_asm_iso.png
