kursatkemalkul/autokitch/arastirma/_ortak/UC_YUVASI/UC_YUVASI_asm_on.png

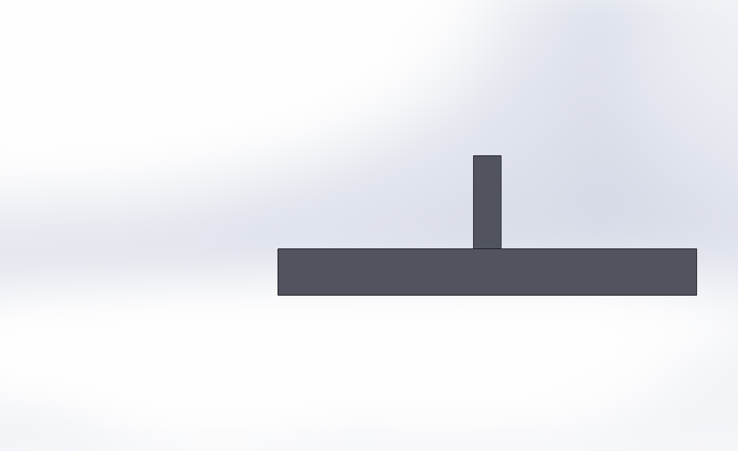
arastirma/_ortak/UC_YUVASI/UC_YUVASI_asm_on.png
