kursatkemalkul/autokitch/arastirma/_ortak/VANTUZ_D40/VANTUZ_D40_asm_on.png

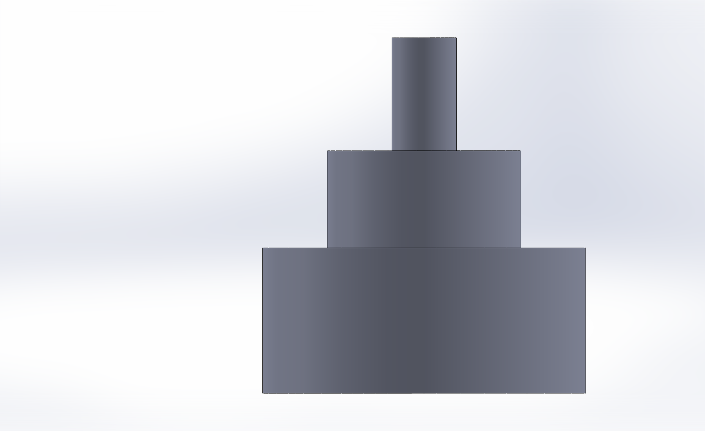
arastirma/_ortak/VANTUZ_D40/VANTUZ_D40_asm_on.png
