kursatkemalkul/autokitch/arastirma/_ortak/YUVA_1L/YUVA_1L_asm_iso.png

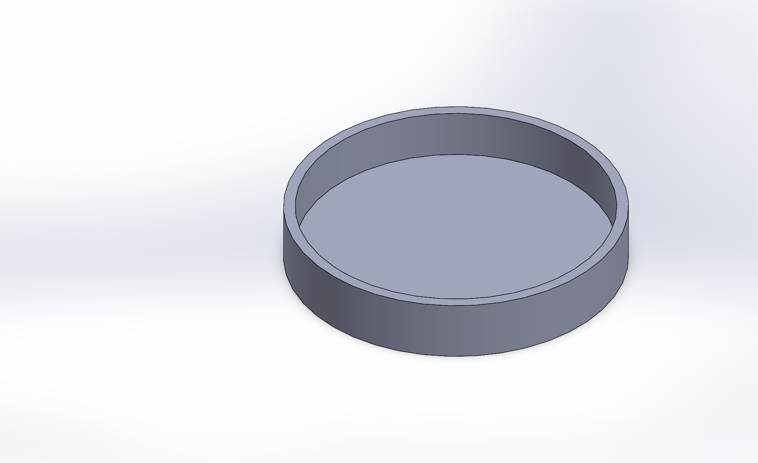
arastirma/_ortak/YUVA_1L/YUVA_1L_asm_iso.png
