kursatkemalkul/autokitch/arastirma/_ortak/YUVA_icecek/YUVA_icecek_asm_iso.png

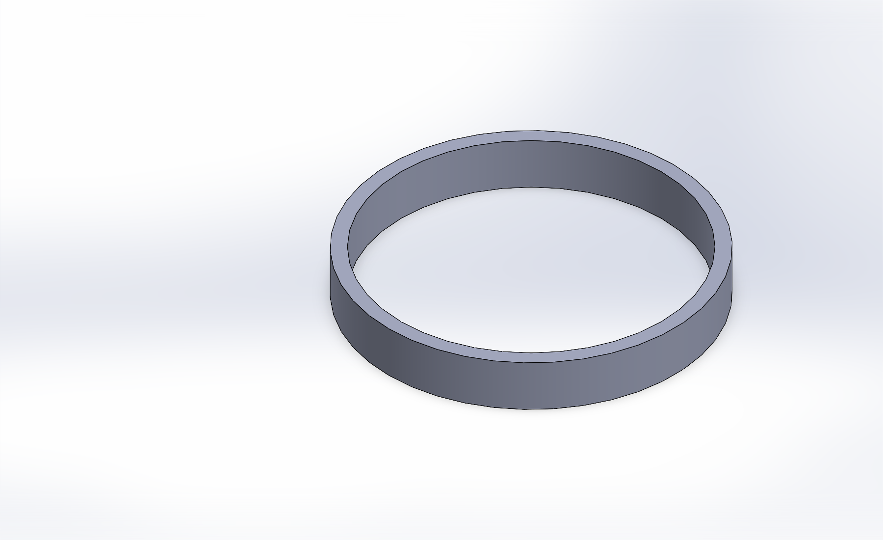
arastirma/_ortak/YUVA_icecek/YUVA_icecek_asm_iso.png
