kursatkemalkul/autokitch/arastirma/FULL_MAKINE/ALCAK_HAT_RESIM1_v4.png

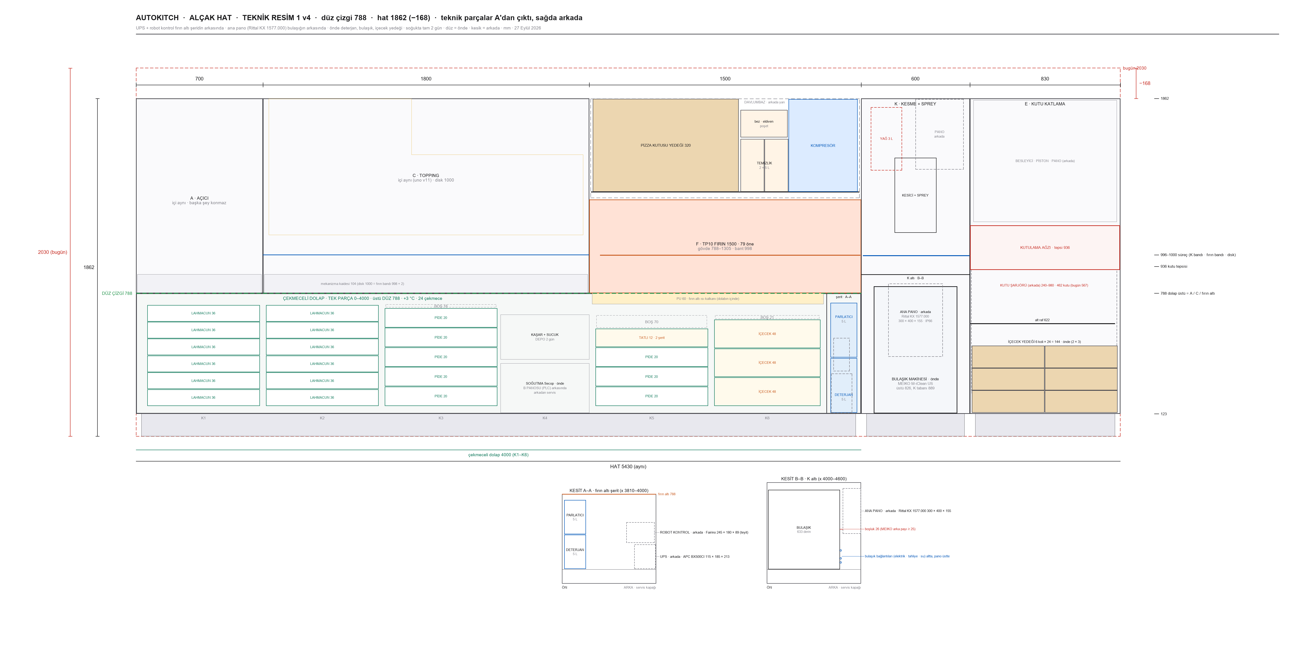
arastirma/FULL_MAKINE/ALCAK_HAT_RESIM1_v4.png
