kursatkemalkul/autokitch/arastirma/FULL_MAKINE/ALT_A1_ROBOTSUZ_v1_teknik.png

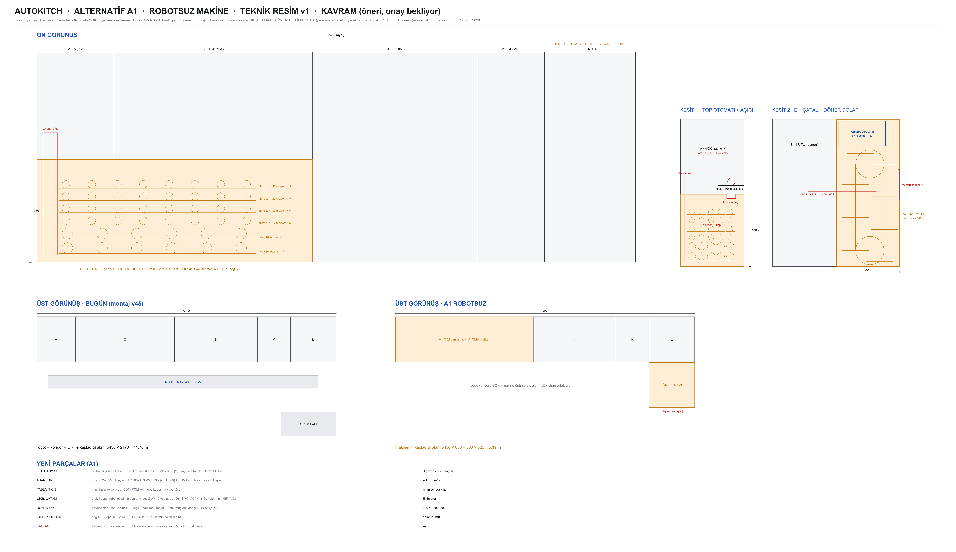
arastirma/FULL_MAKINE/ALT_A1_ROBOTSUZ_v1_teknik.png
