kursatkemalkul/autokitch/arastirma/FULL_MAKINE/BULASIK_MAKINESI_v1.png

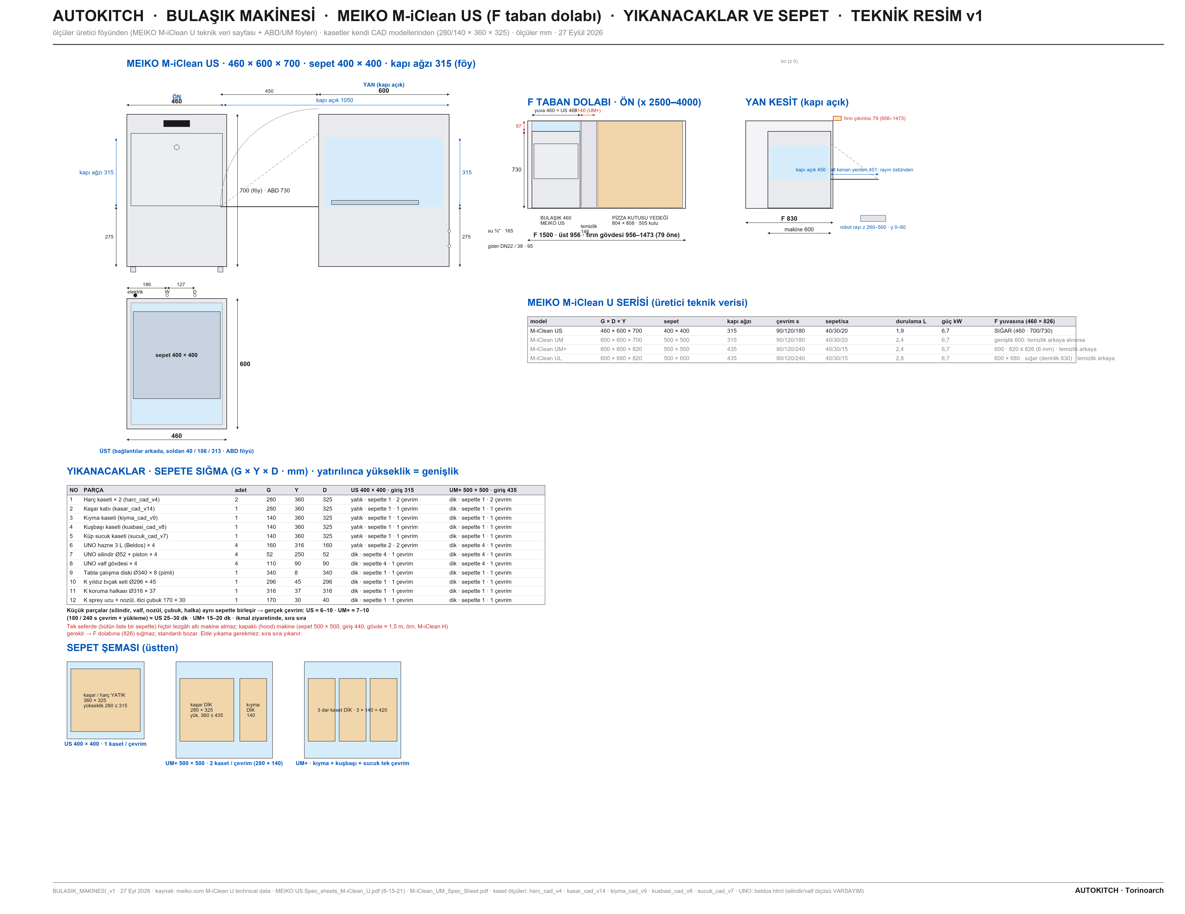
arastirma/FULL_MAKINE/BULASIK_MAKINESI_v1.png
