kursatkemalkul/autokitch/arastirma/FULL_MAKINE/dukkan_plani_v1.png

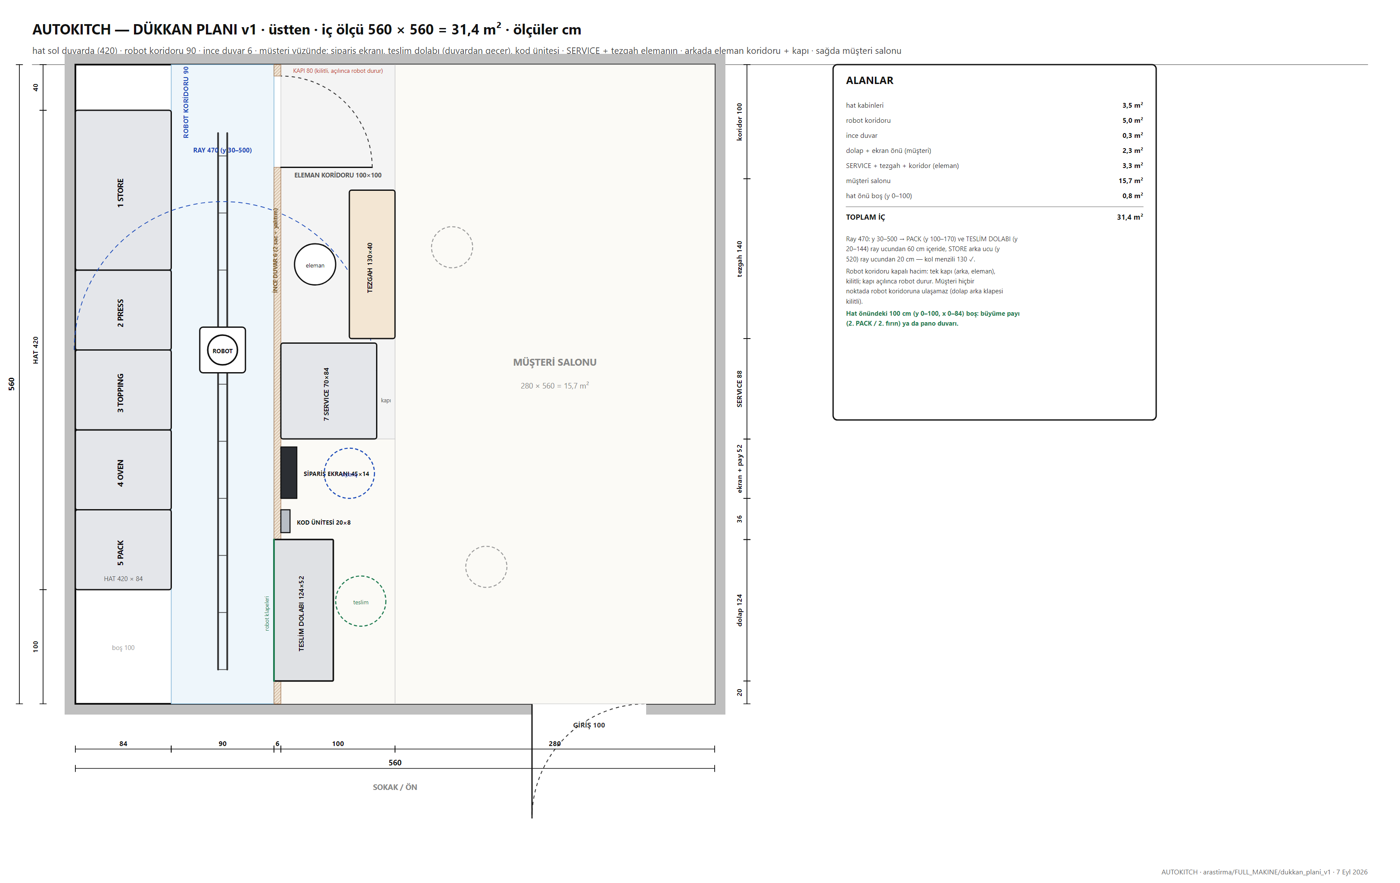
arastirma/FULL_MAKINE/dukkan_plani_v1.png
