kursatkemalkul/autokitch/arastirma/FULL_MAKINE/dukkan_plani_v2.png

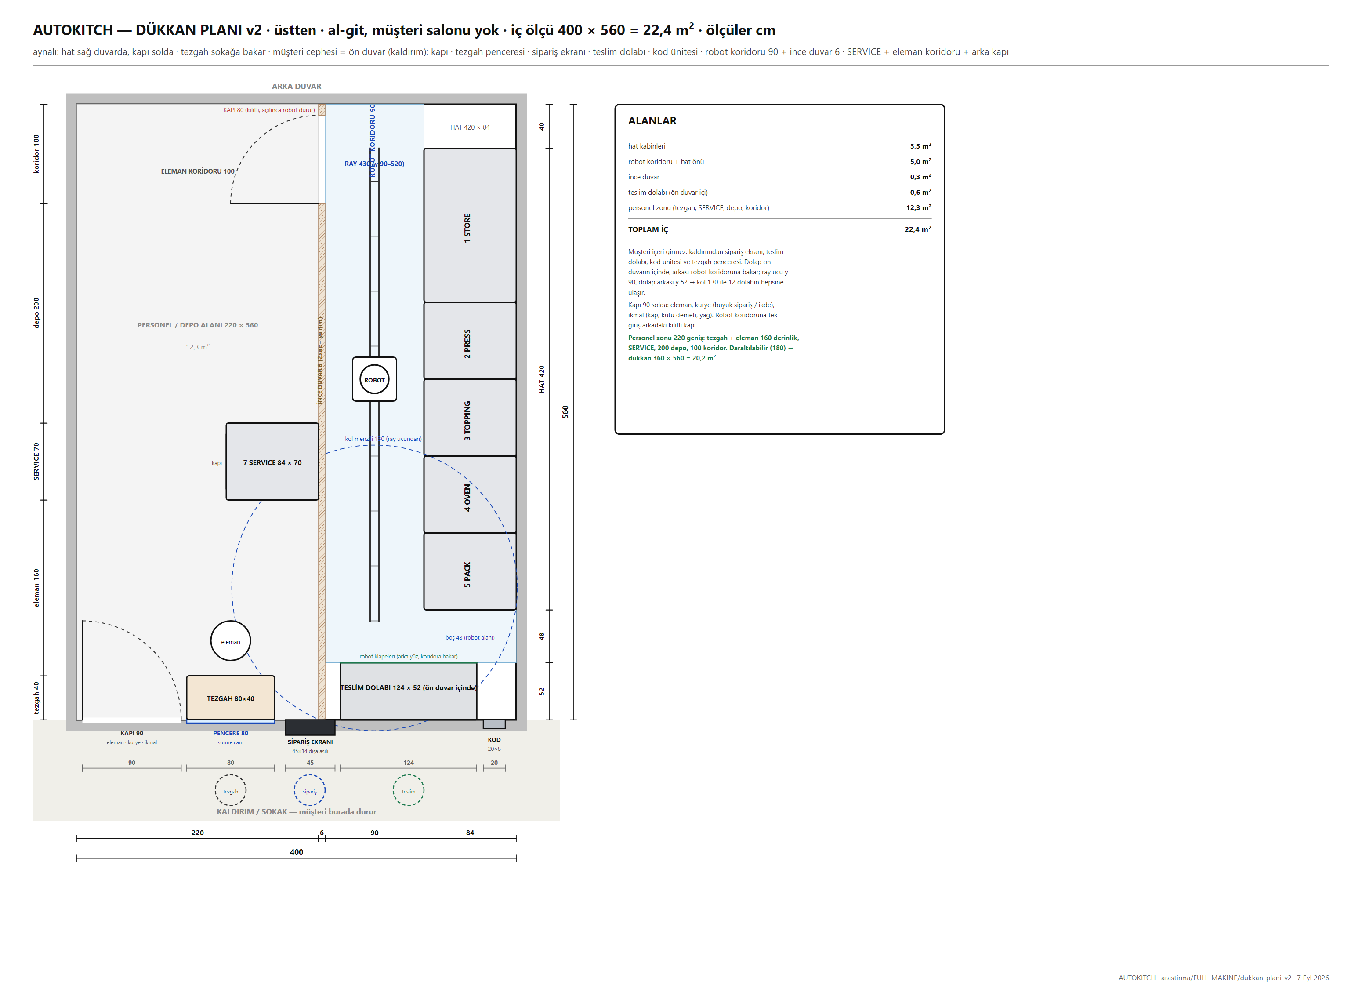
arastirma/FULL_MAKINE/dukkan_plani_v2.png
