kursatkemalkul/autokitch/arastirma/FULL_MAKINE/dukkan_plani_v3.png

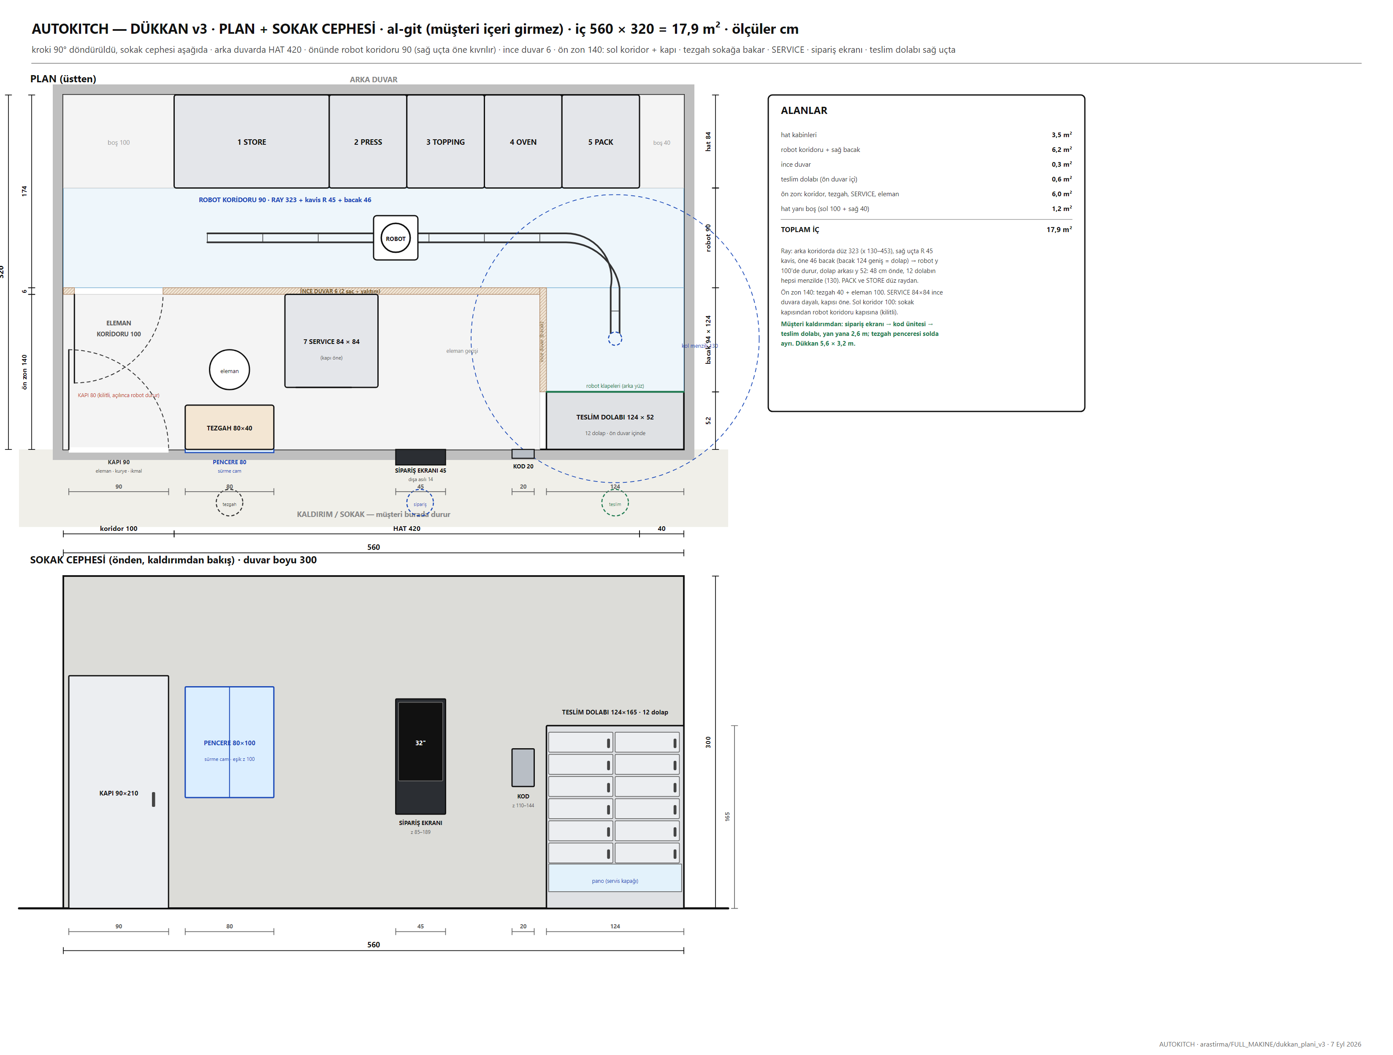
arastirma/FULL_MAKINE/dukkan_plani_v3.png
