kursatkemalkul/autokitch/arastirma/FULL_MAKINE/dukkan_plani_v4.png

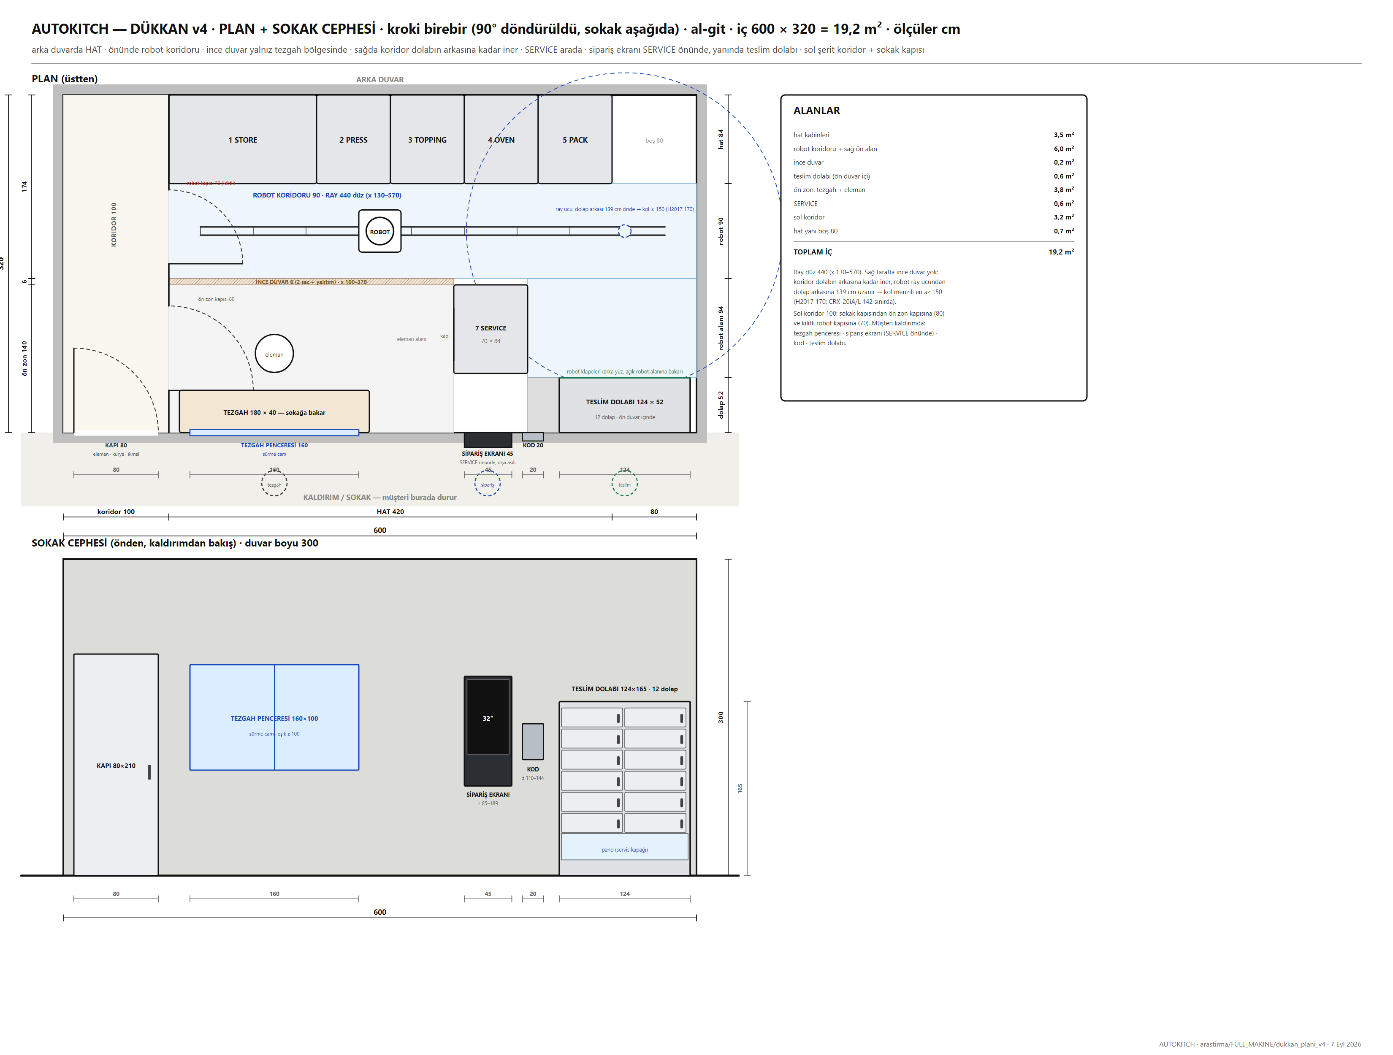
arastirma/FULL_MAKINE/dukkan_plani_v4.png
