kursatkemalkul/autokitch/arastirma/FULL_MAKINE/dukkan_plani_v5.png

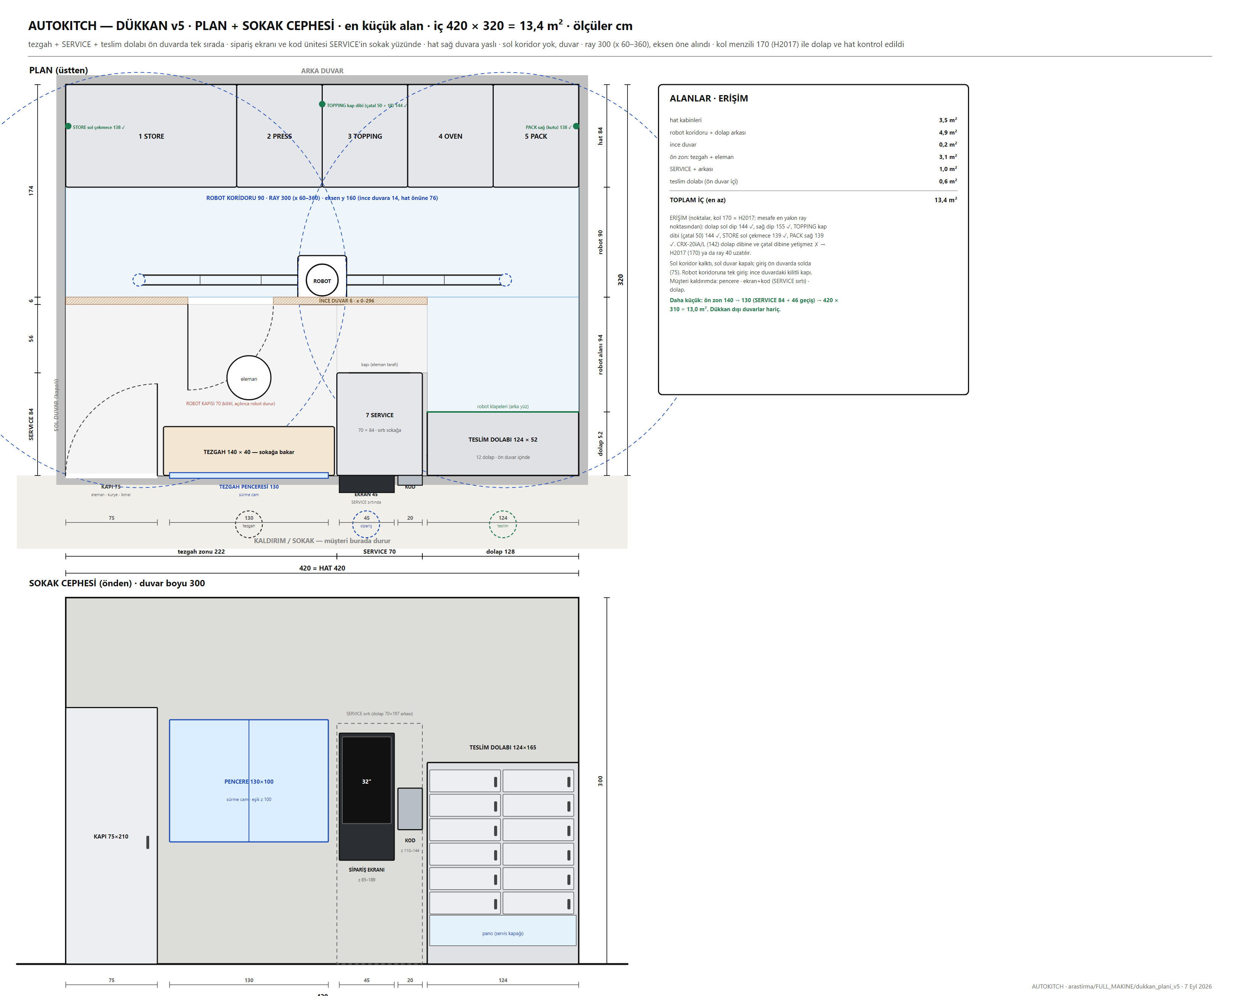
arastirma/FULL_MAKINE/dukkan_plani_v5.png
