kursatkemalkul/autokitch/arastirma/FULL_MAKINE/dukkan_plani_v11_hat543.png

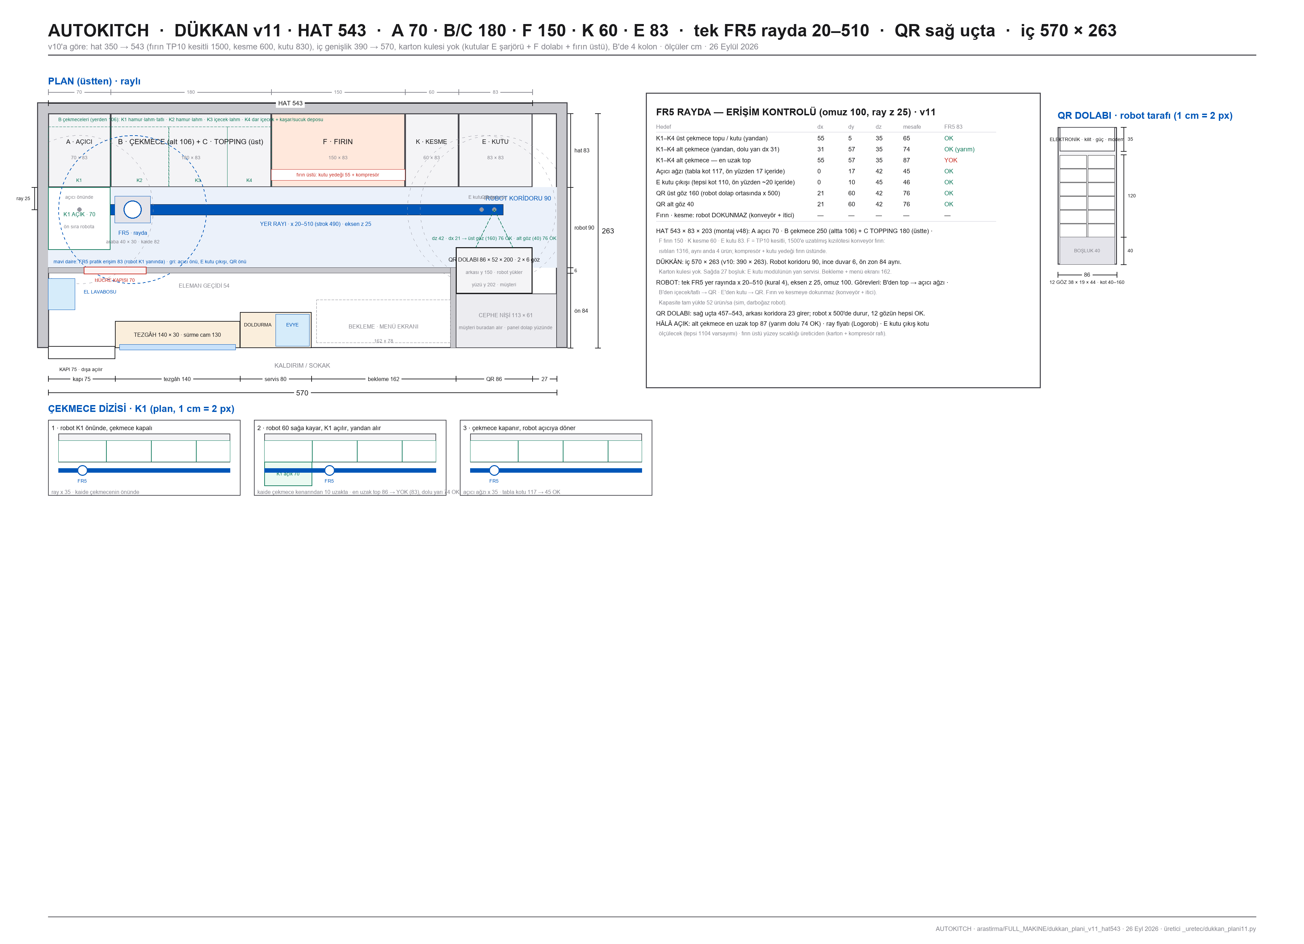
arastirma/FULL_MAKINE/dukkan_plani_v11_hat543.png
