kursatkemalkul/autokitch/arastirma/FULL_MAKINE/dukkan_plani_v14_alcak_hat.png

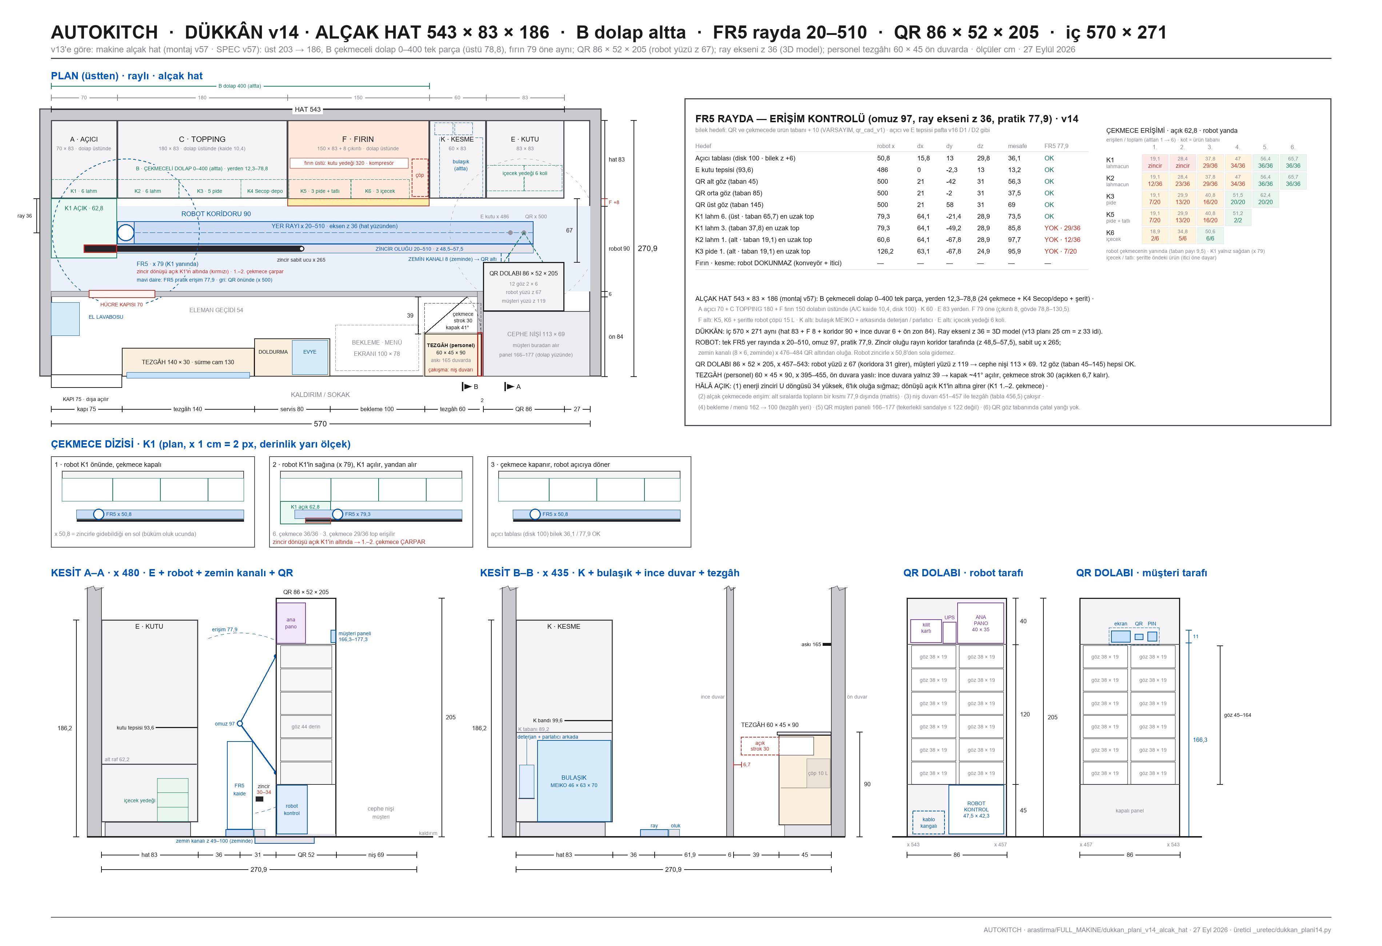
arastirma/FULL_MAKINE/dukkan_plani_v14_alcak_hat.png
