kursatkemalkul/autokitch/arastirma/FULL_MAKINE/FIRIN_EKSEN_ustten_v1.png

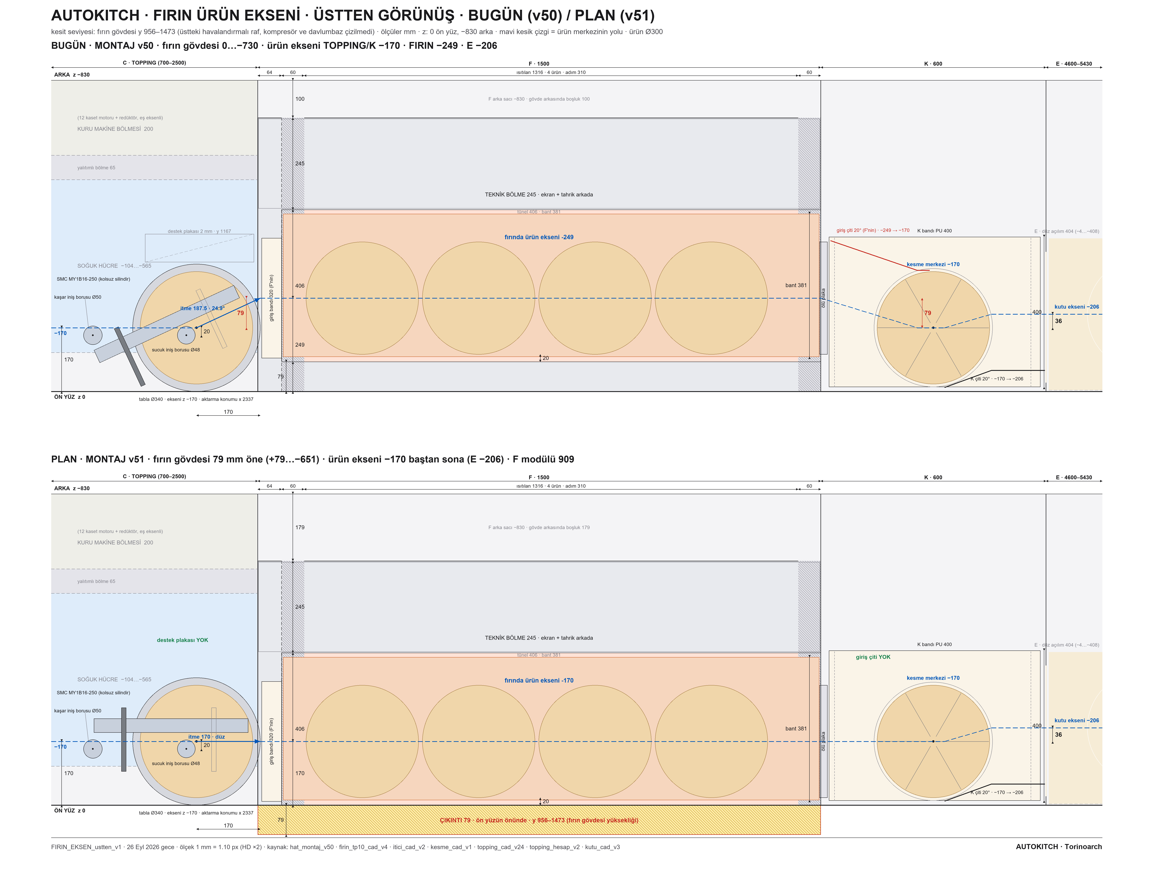
arastirma/FULL_MAKINE/FIRIN_EKSEN_ustten_v1.png
