kursatkemalkul/autokitch/arastirma/FULL_MAKINE/FIRIN_TP10_v6_teknik.png

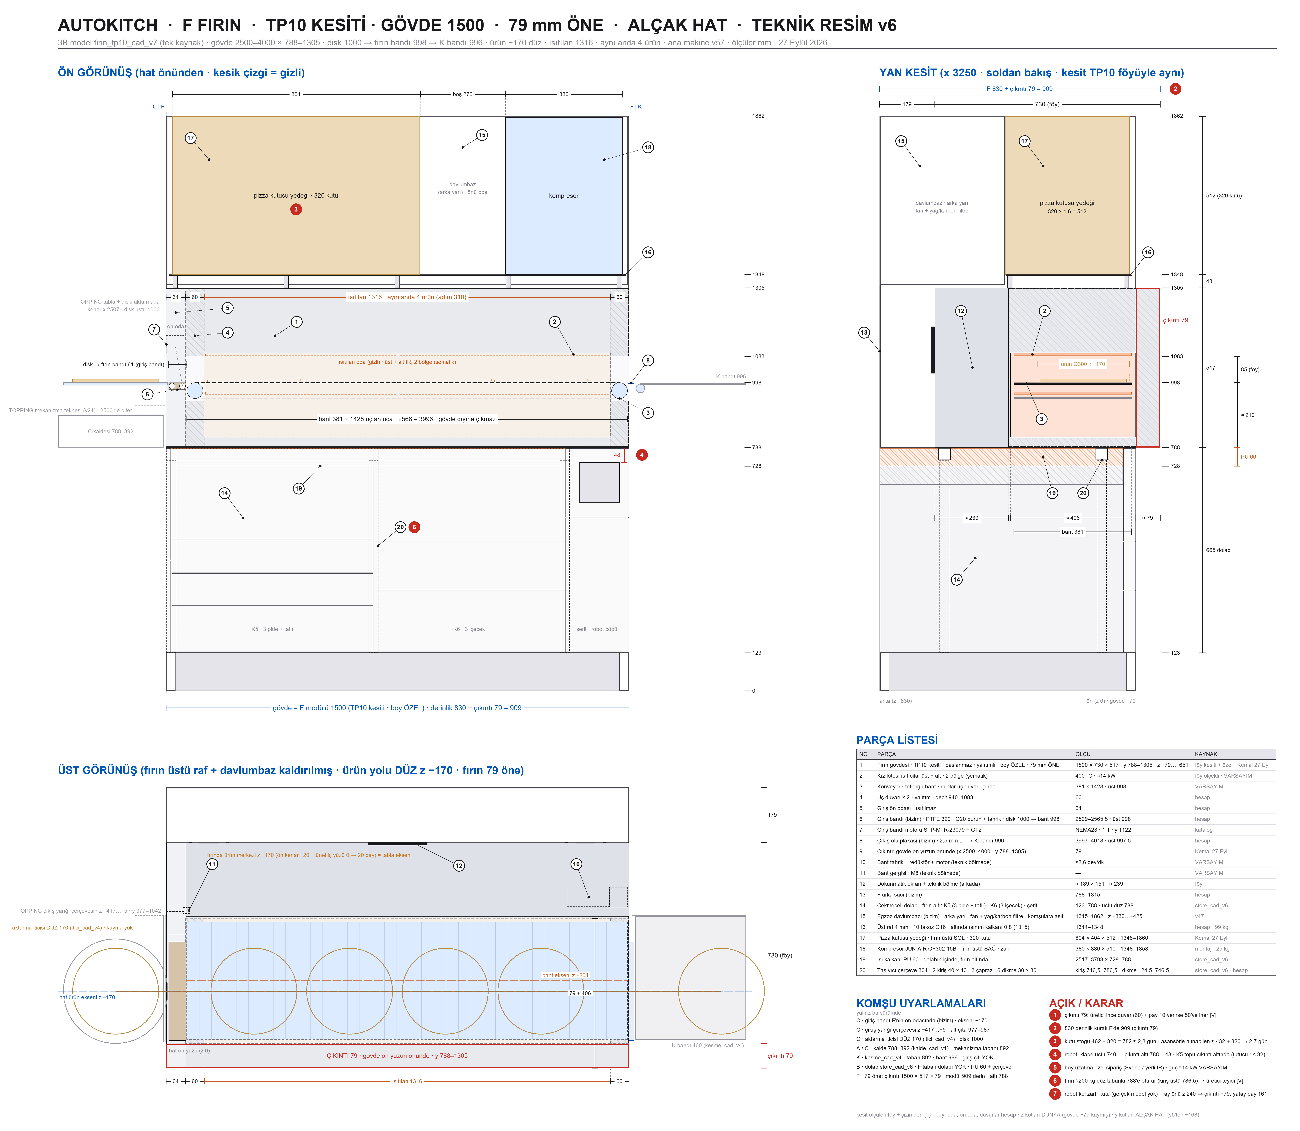
arastirma/FULL_MAKINE/FIRIN_TP10_v6_teknik.png
