kursatkemalkul/autokitch/arastirma/FULL_MAKINE/HAT_2KOL_v10_teknik.png

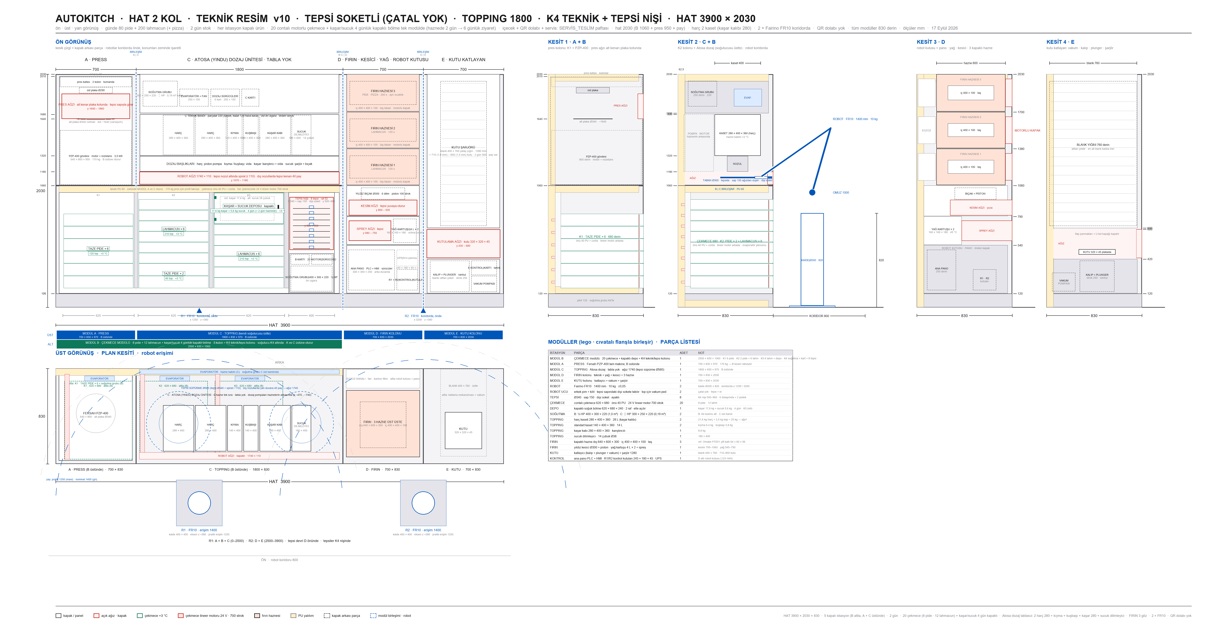
arastirma/FULL_MAKINE/HAT_2KOL_v10_teknik.png
