kursatkemalkul/autokitch/arastirma/FULL_MAKINE/HAT_A1_v4_teknik.png

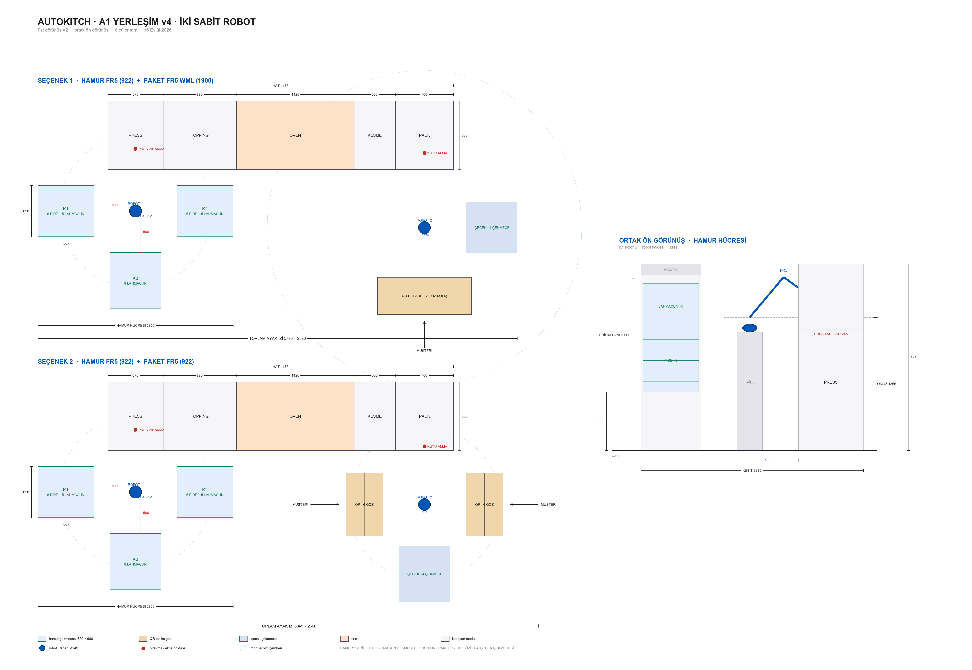
arastirma/FULL_MAKINE/HAT_A1_v4_teknik.png
