kursatkemalkul/autokitch/arastirma/FULL_MAKINE/HAT_asm_iso.png

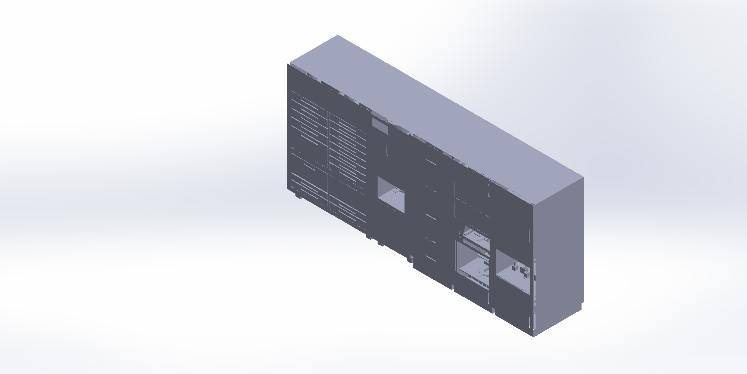
arastirma/FULL_MAKINE/HAT_asm_iso.png
