kursatkemalkul/autokitch/arastirma/FULL_MAKINE/HAT_ATOSA_GOZLU_v1_teknik.png

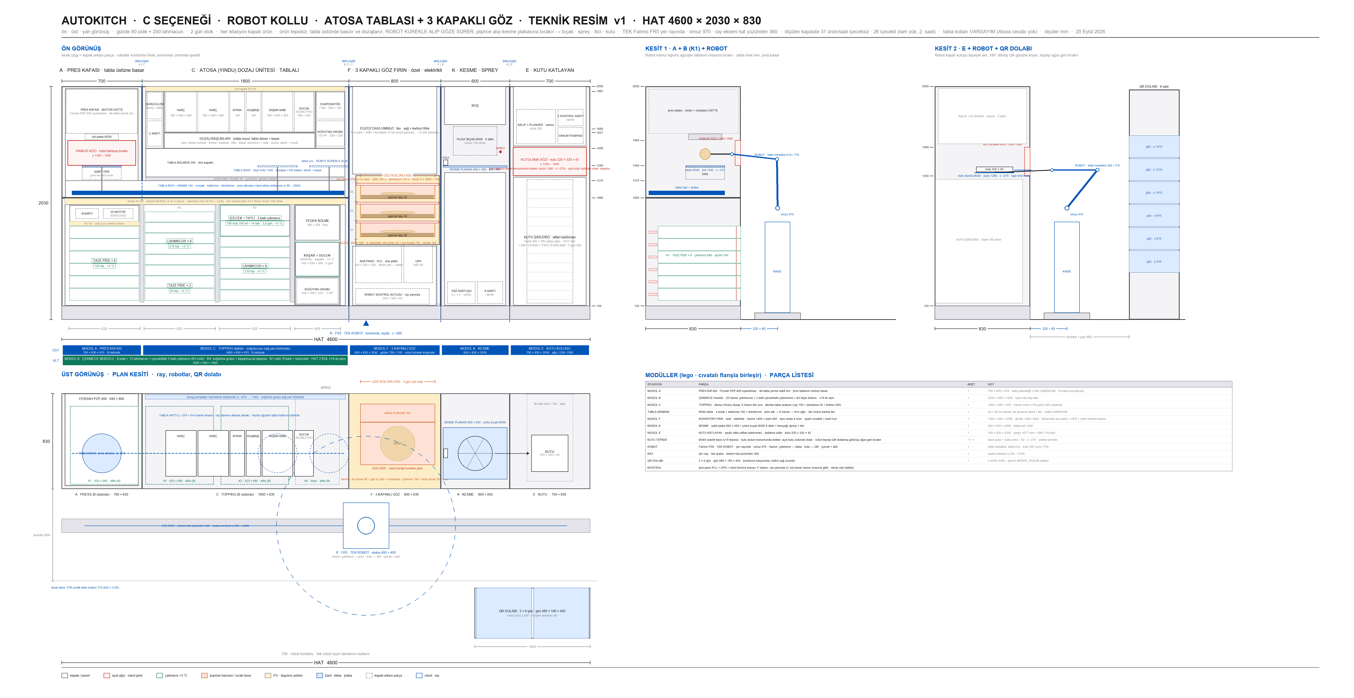
arastirma/FULL_MAKINE/HAT_ATOSA_GOZLU_v1_teknik.png
