kursatkemalkul/autokitch/arastirma/FULL_MAKINE/HAT_ATOSA_TABLALI_v2_teknik.png

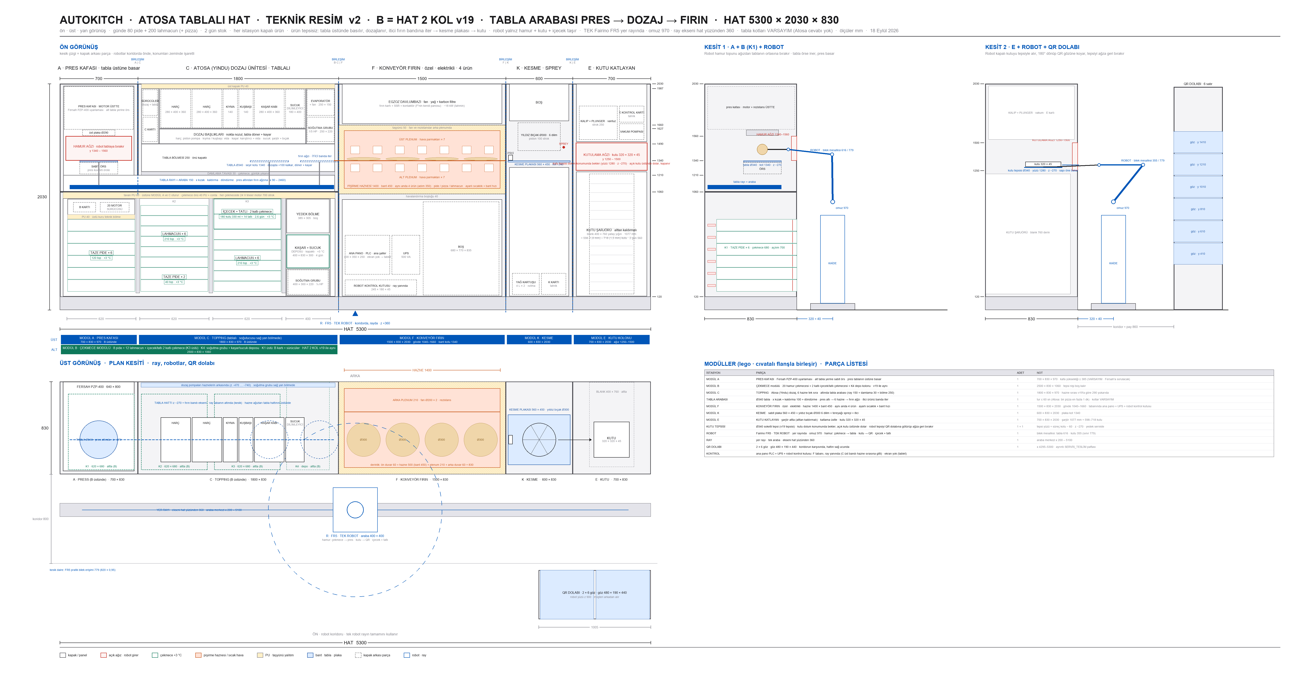
arastirma/FULL_MAKINE/HAT_ATOSA_TABLALI_v2_teknik.png
