kursatkemalkul/autokitch/arastirma/FULL_MAKINE/HAT_ATOSA_TABLALI_v15_EKRAN.png

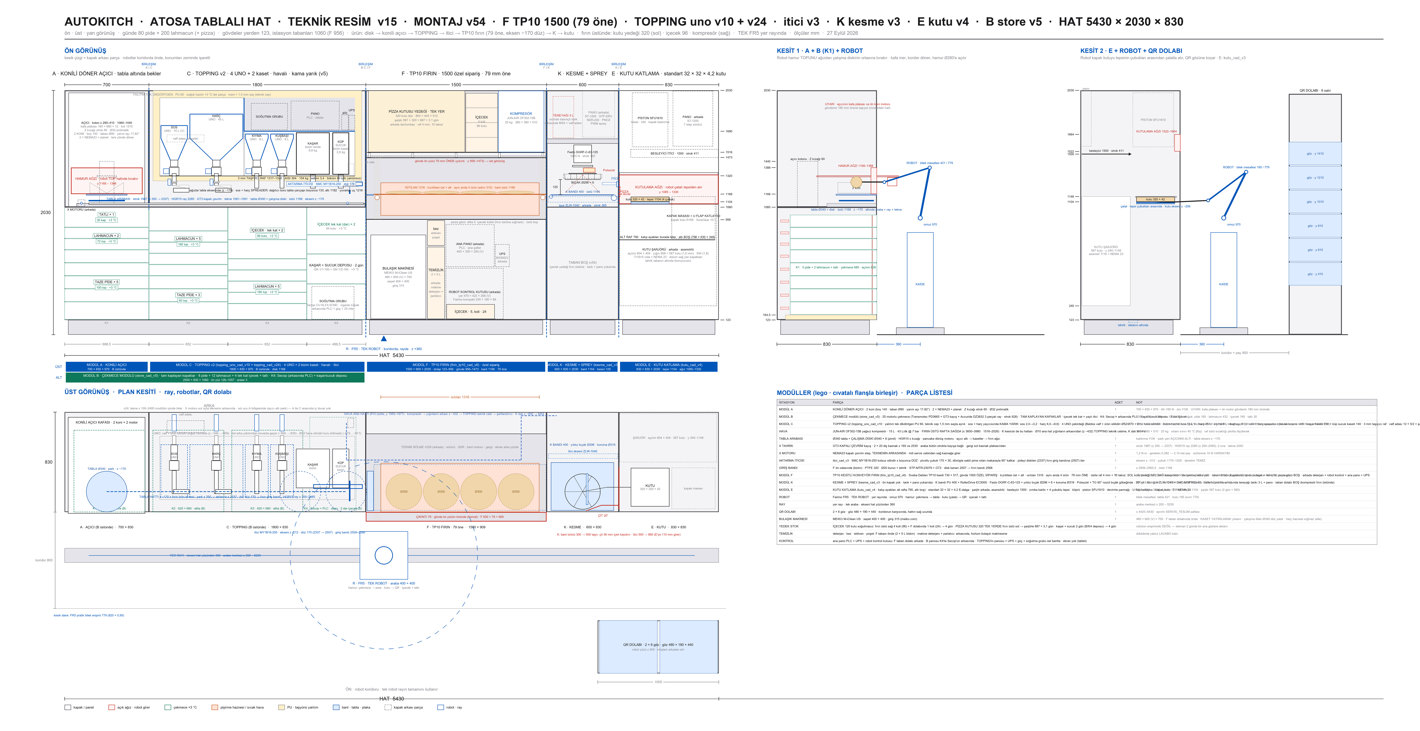
arastirma/FULL_MAKINE/HAT_ATOSA_TABLALI_v15_EKRAN.png
