kursatkemalkul/autokitch/arastirma/FULL_MAKINE/hat_dis_kapak_gorunus_v2.png

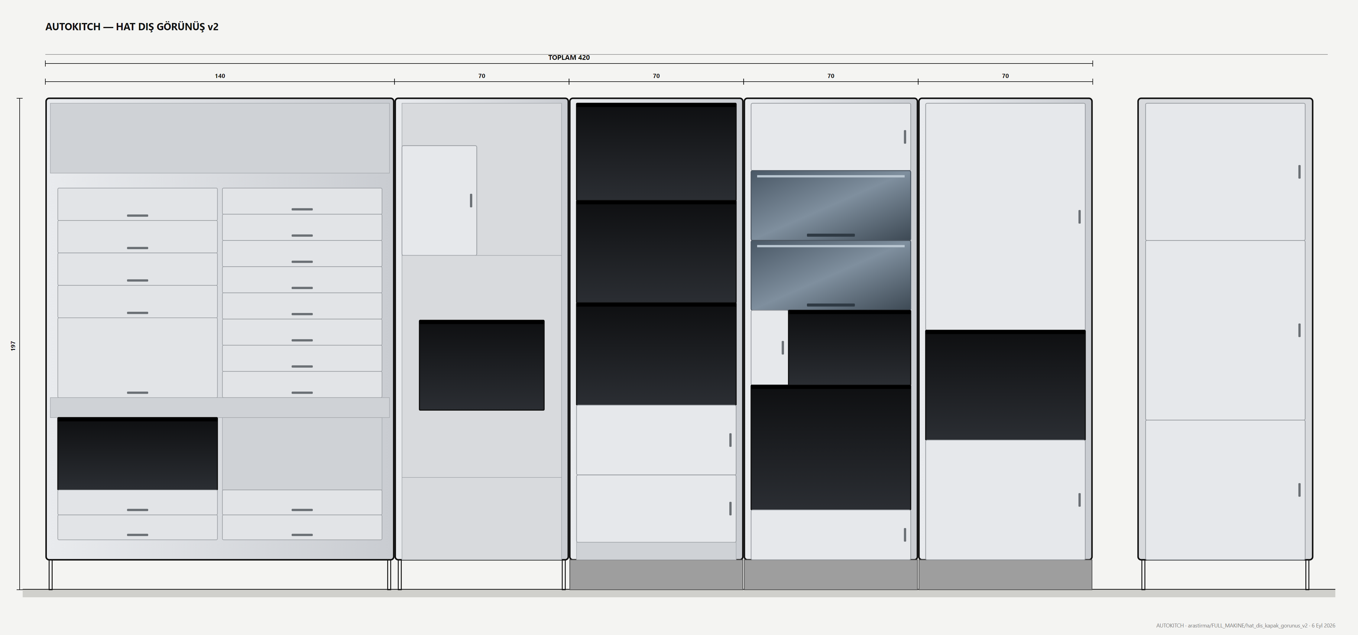
arastirma/FULL_MAKINE/hat_dis_kapak_gorunus_v2.png
