kursatkemalkul/autokitch/arastirma/FULL_MAKINE/HAT_dis_v1_sw_iso.png

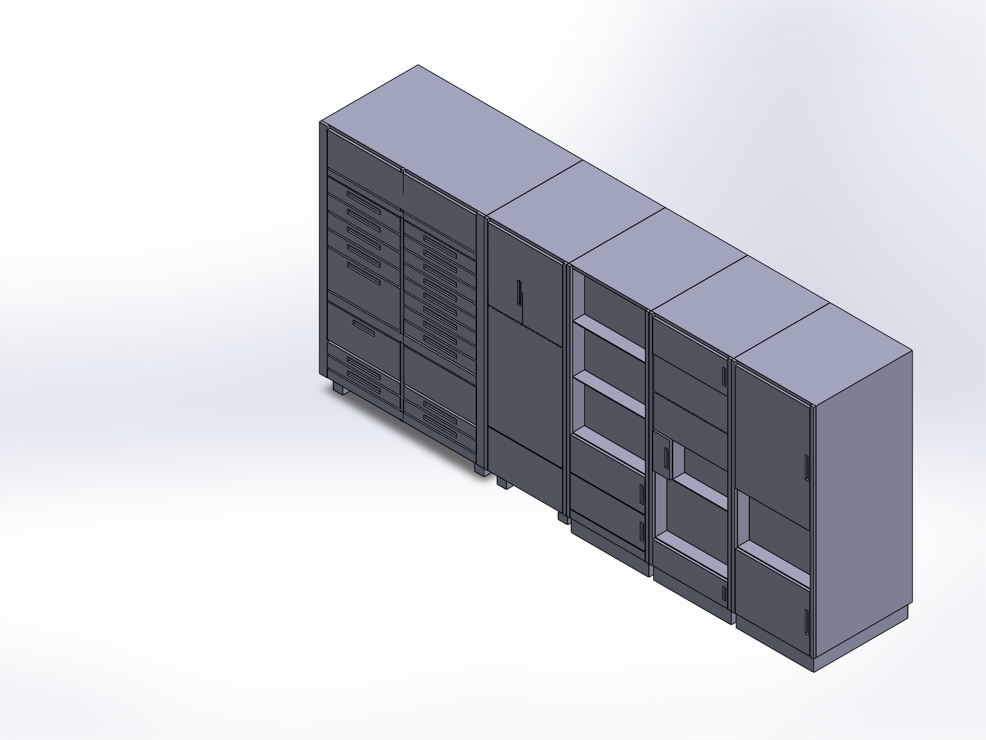
arastirma/FULL_MAKINE/HAT_dis_v1_sw_iso.png
