kursatkemalkul/autokitch/arastirma/FULL_MAKINE/HAT_dis_v1_sw_on.png

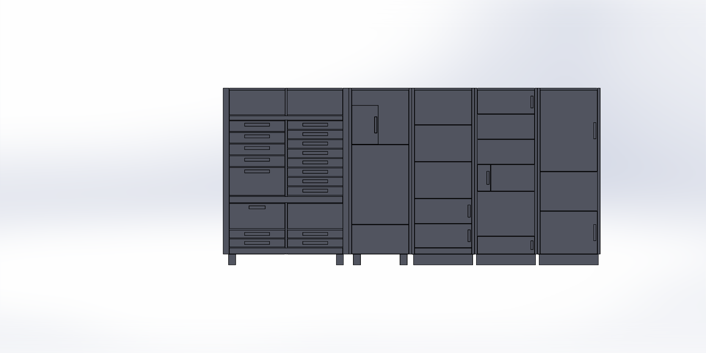
arastirma/FULL_MAKINE/HAT_dis_v1_sw_on.png
