kursatkemalkul/autokitch/arastirma/FULL_MAKINE/HAT_KISALTMA_v1_teknik.png

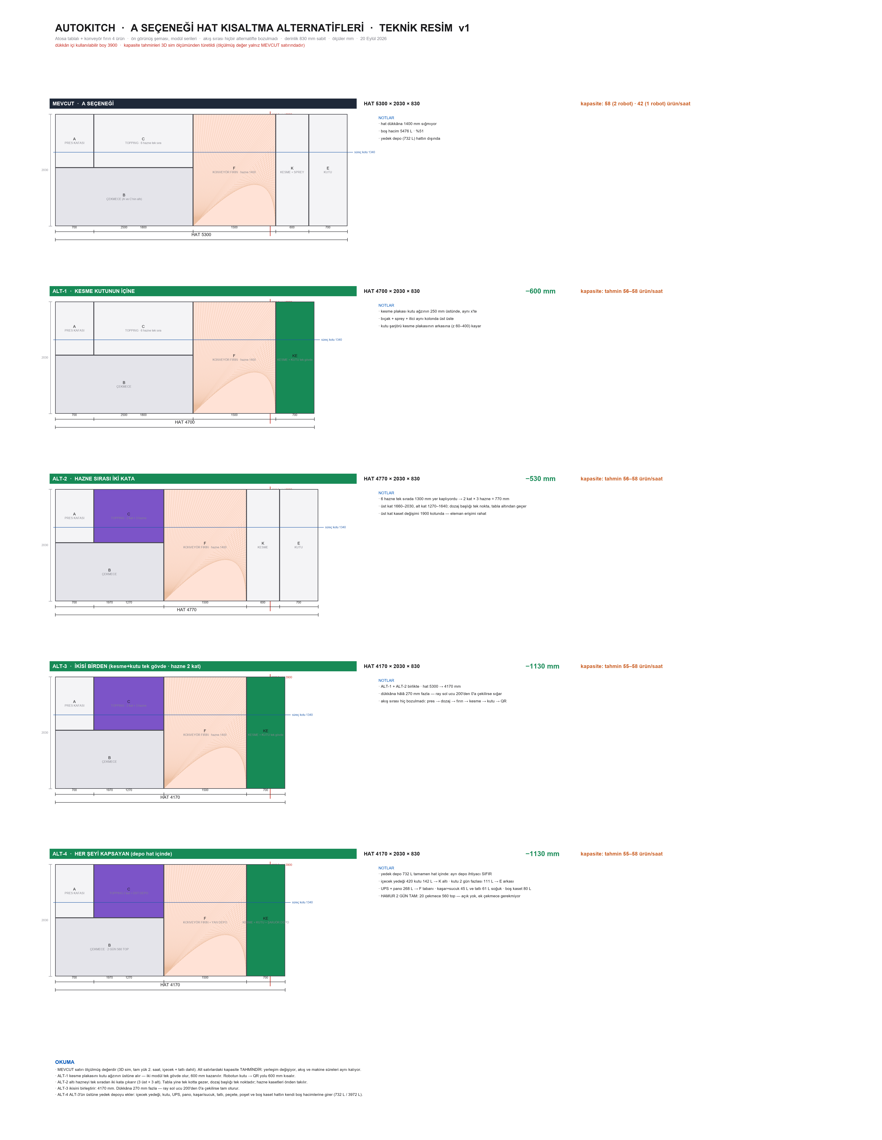
arastirma/FULL_MAKINE/HAT_KISALTMA_v1_teknik.png
