kursatkemalkul/autokitch/arastirma/FULL_MAKINE/hat_on_gorunus_teknik_v5.png

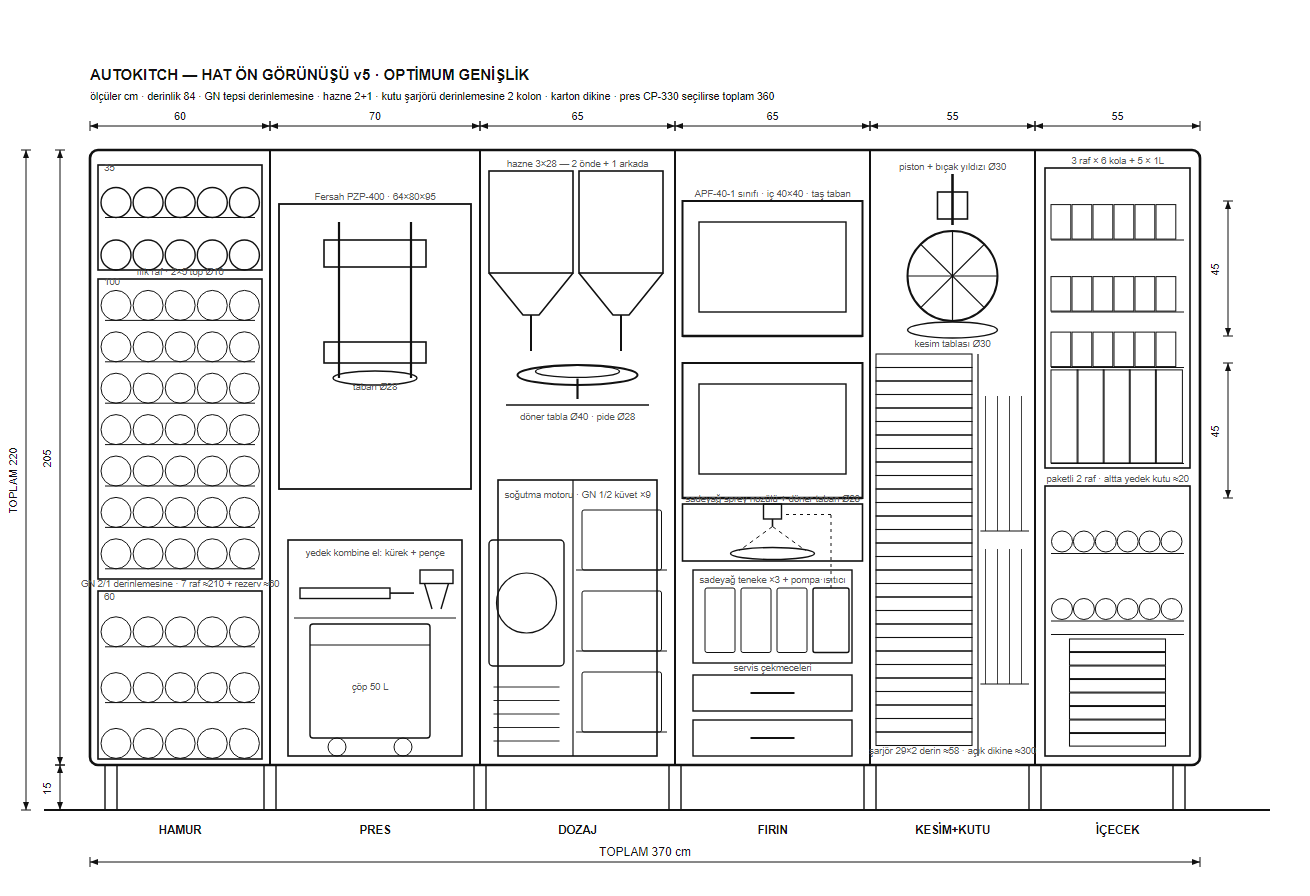
arastirma/FULL_MAKINE/hat_on_gorunus_teknik_v5.png
