kursatkemalkul/autokitch/arastirma/FULL_MAKINE/hat_plan_duz_3gun_v34.png

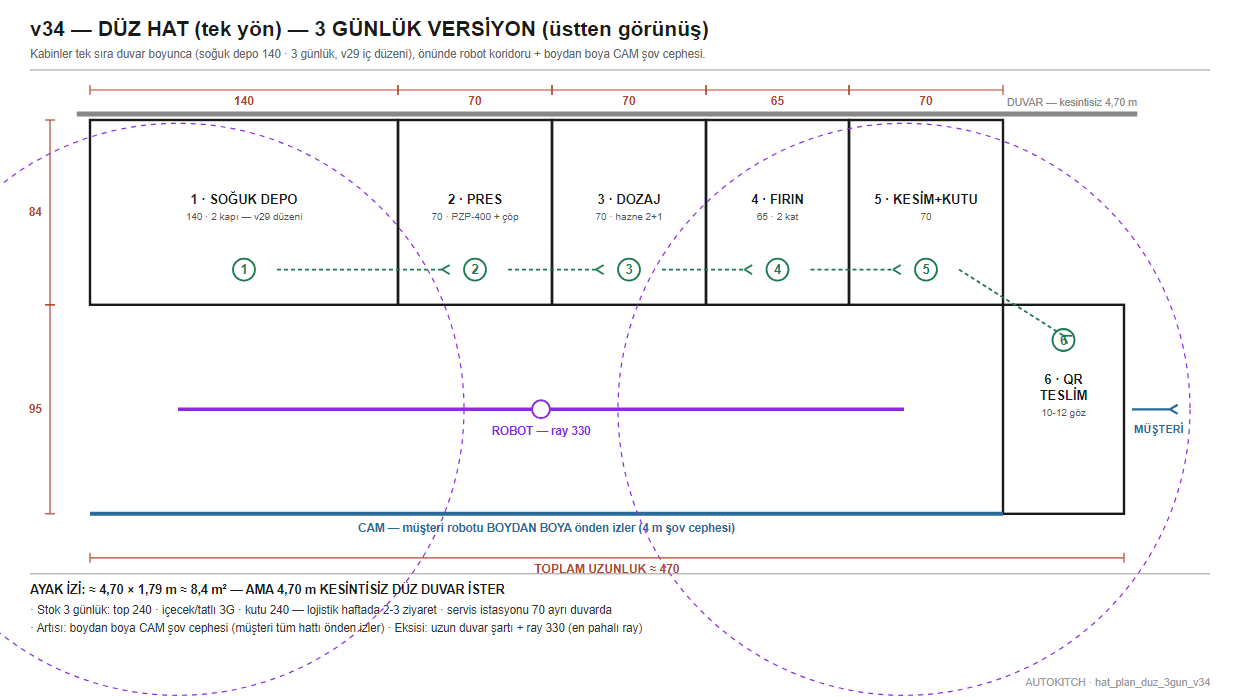
arastirma/FULL_MAKINE/hat_plan_duz_3gun_v34.png
