kursatkemalkul/autokitch/arastirma/FULL_MAKINE/hat_plan_karsilikli_3gun_v33.png

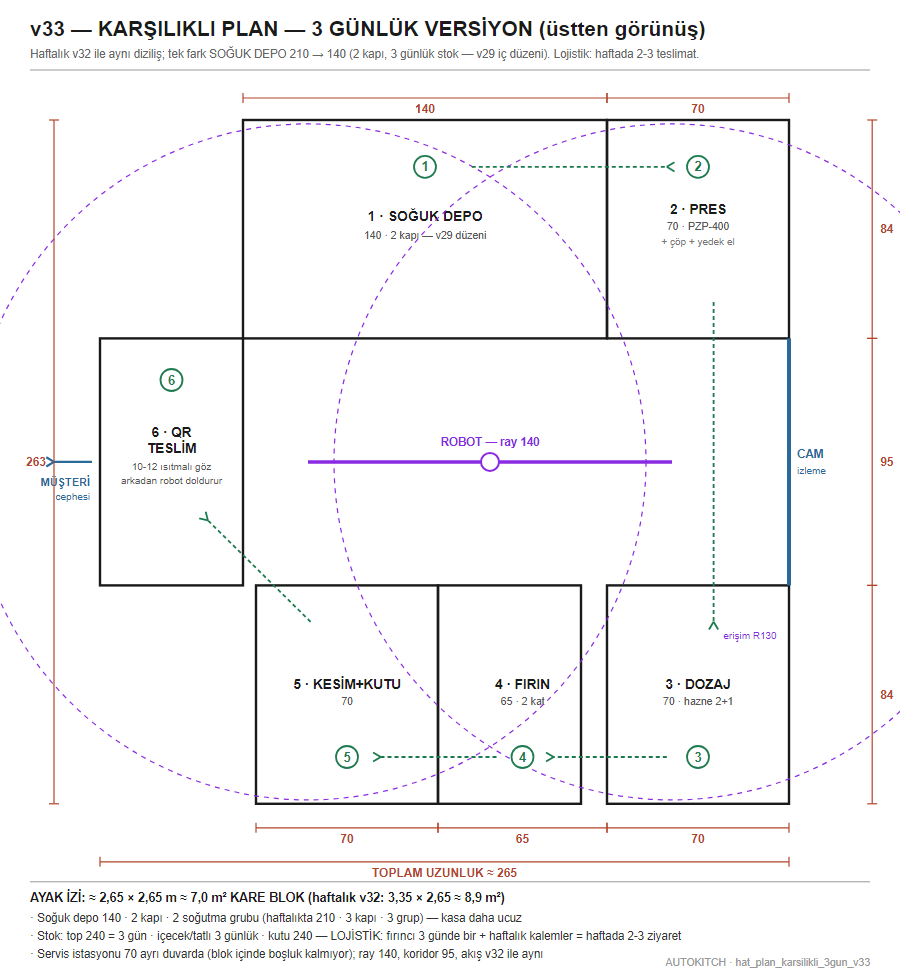
arastirma/FULL_MAKINE/hat_plan_karsilikli_3gun_v33.png
