kursatkemalkul/autokitch/arastirma/FULL_MAKINE/hat_plan_karsilikli_v32.png

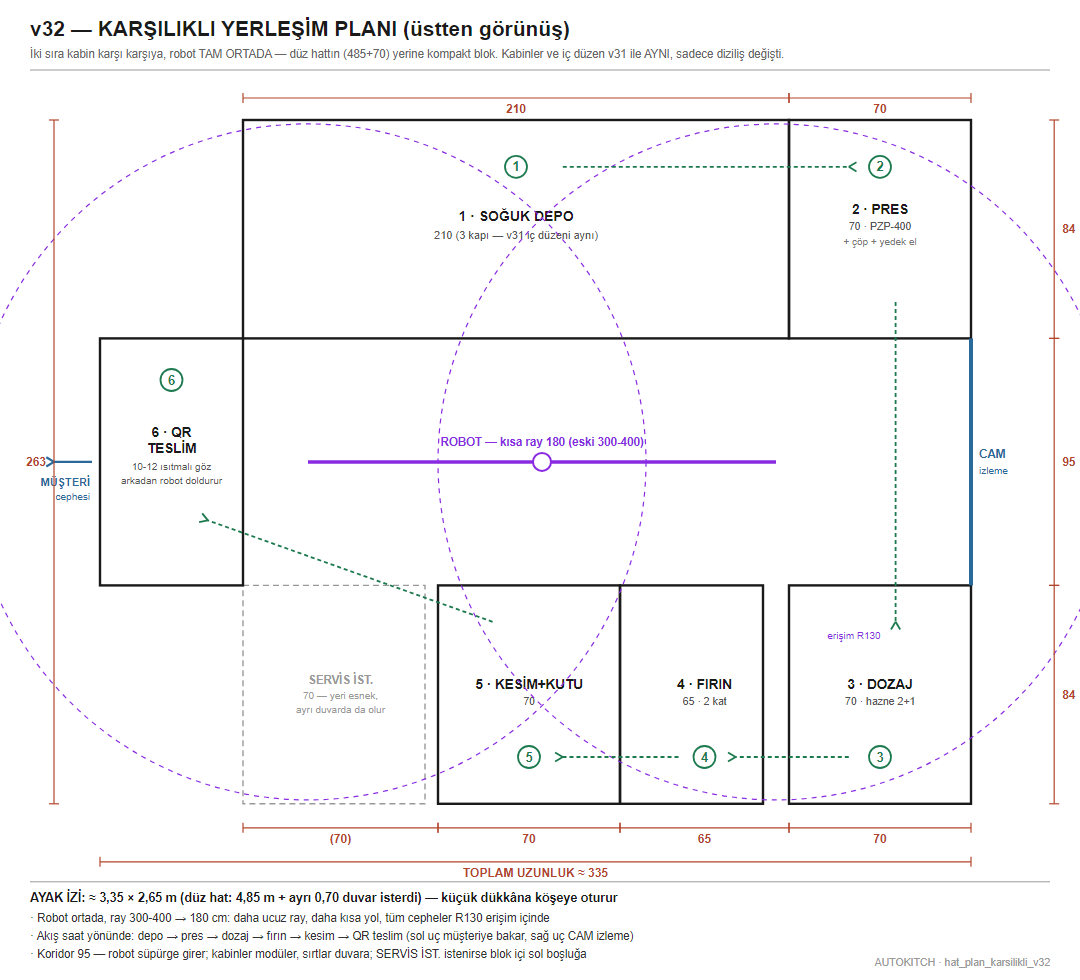
arastirma/FULL_MAKINE/hat_plan_karsilikli_v32.png
