kursatkemalkul/autokitch/arastirma/FULL_MAKINE/hat_plan_kroki_v37.png

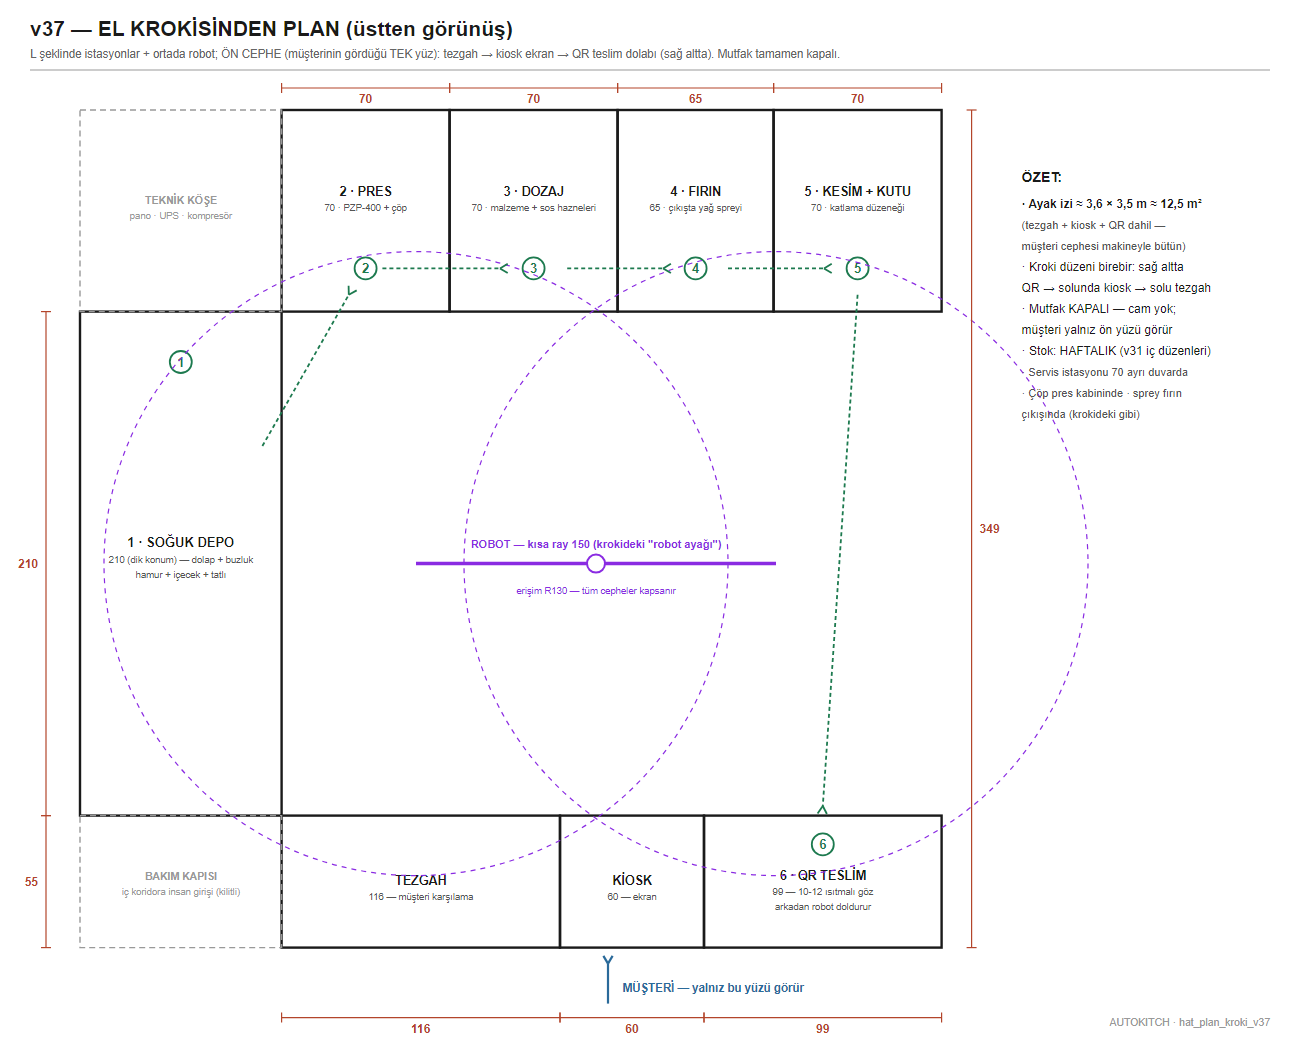
arastirma/FULL_MAKINE/hat_plan_kroki_v37.png
