kursatkemalkul/autokitch/arastirma/FULL_MAKINE/HAT_ROBOT_v6_teknik.png

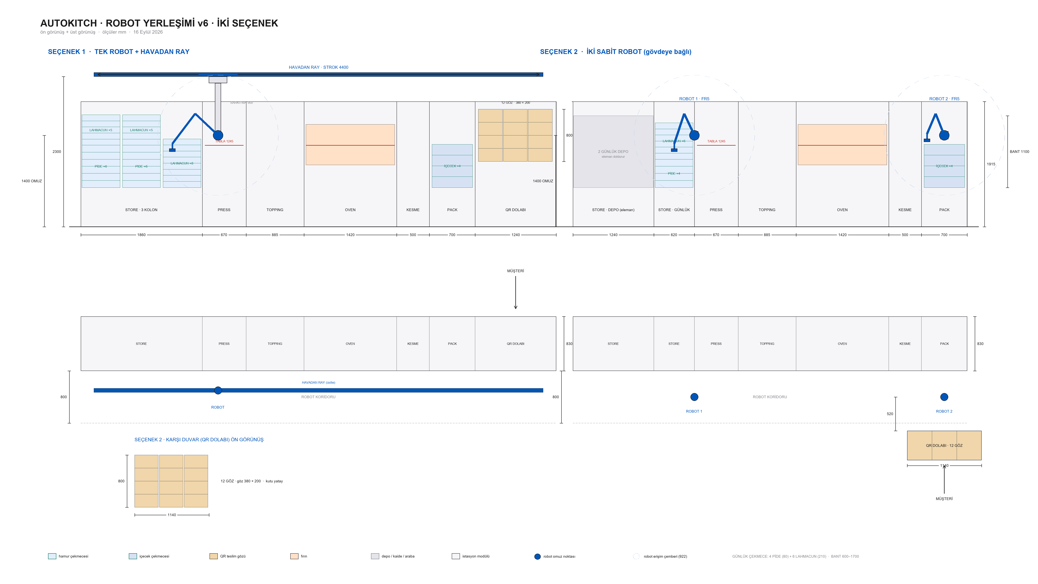
arastirma/FULL_MAKINE/HAT_ROBOT_v6_teknik.png
