kursatkemalkul/autokitch/arastirma/FULL_MAKINE/hat_teknik_3gun_v36.png

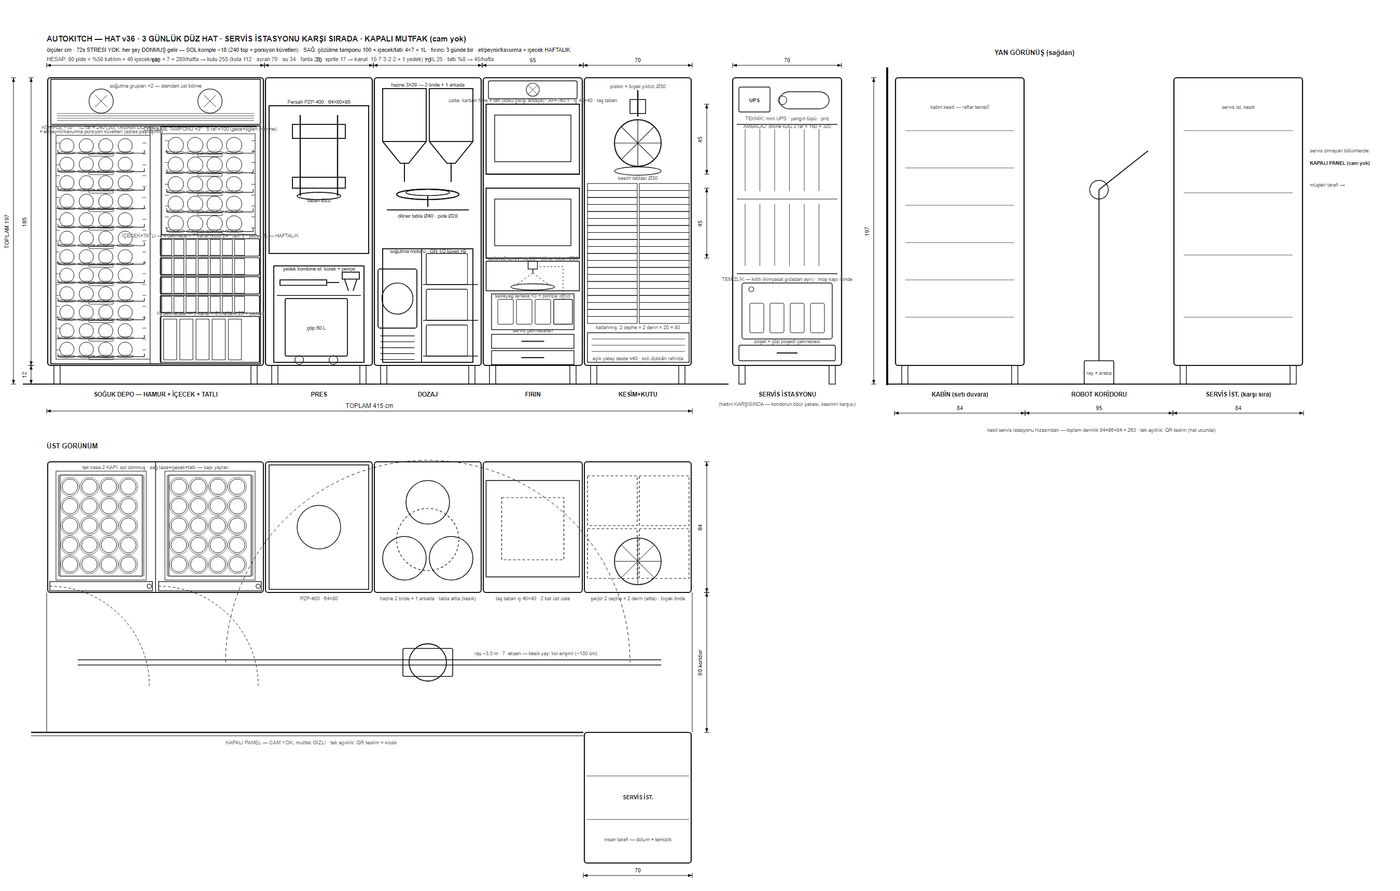
arastirma/FULL_MAKINE/hat_teknik_3gun_v36.png
