kursatkemalkul/autokitch/arastirma/FULL_MAKINE/ITICI_v1_teknik.png

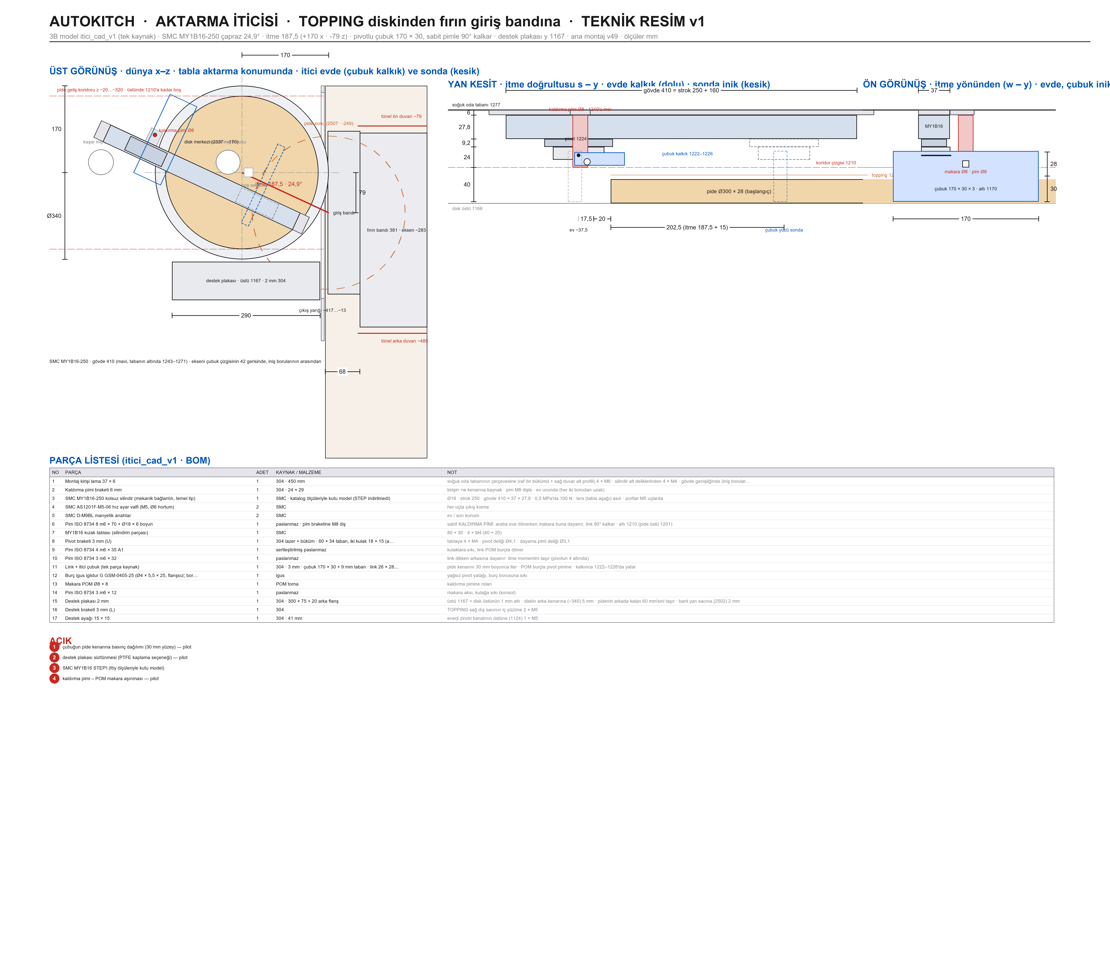
arastirma/FULL_MAKINE/ITICI_v1_teknik.png
