kursatkemalkul/autokitch/arastirma/FULL_MAKINE/ITICI_v3_teknik.png

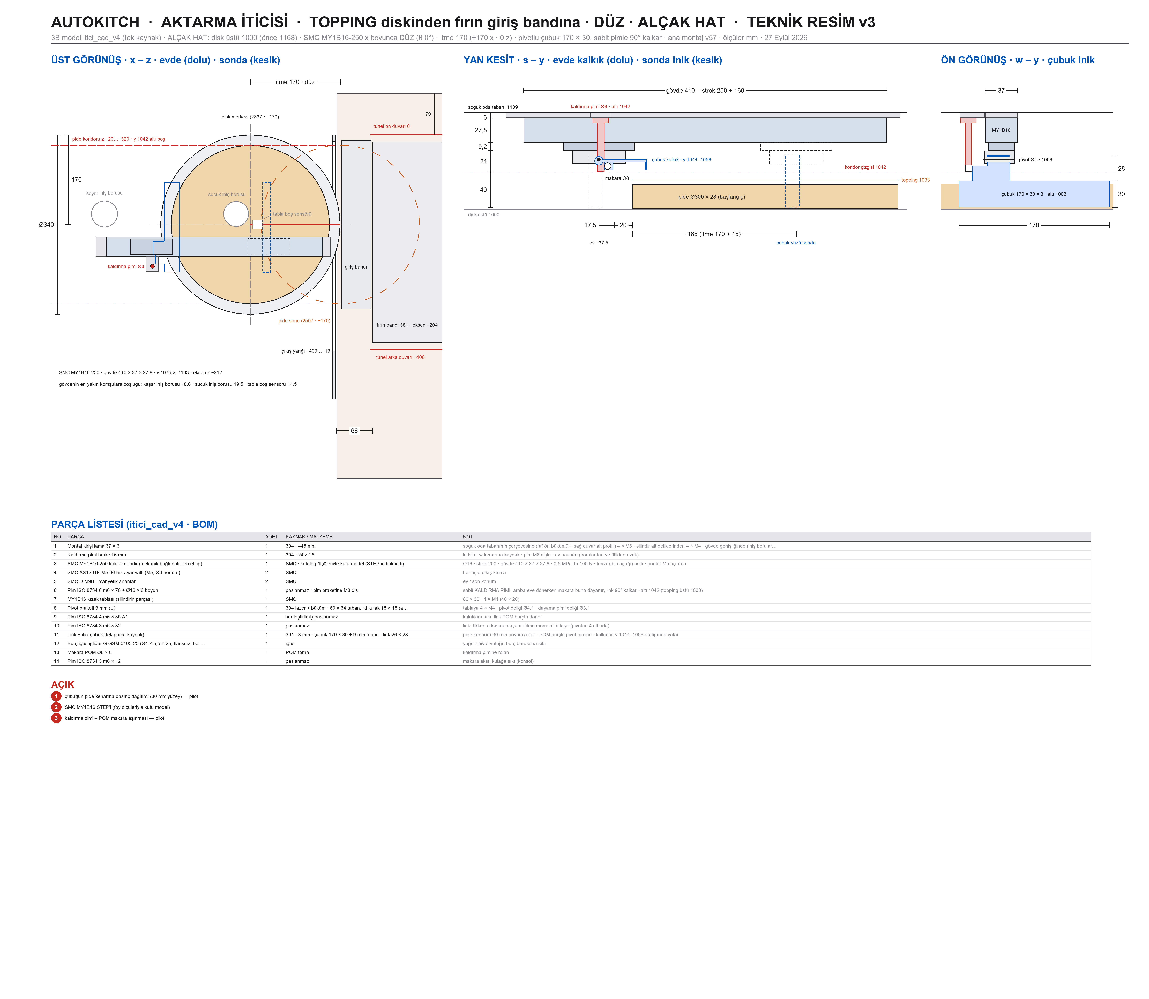
arastirma/FULL_MAKINE/ITICI_v3_teknik.png
