kursatkemalkul/autokitch/arastirma/FULL_MAKINE/QR_TEZGAH_v4.png

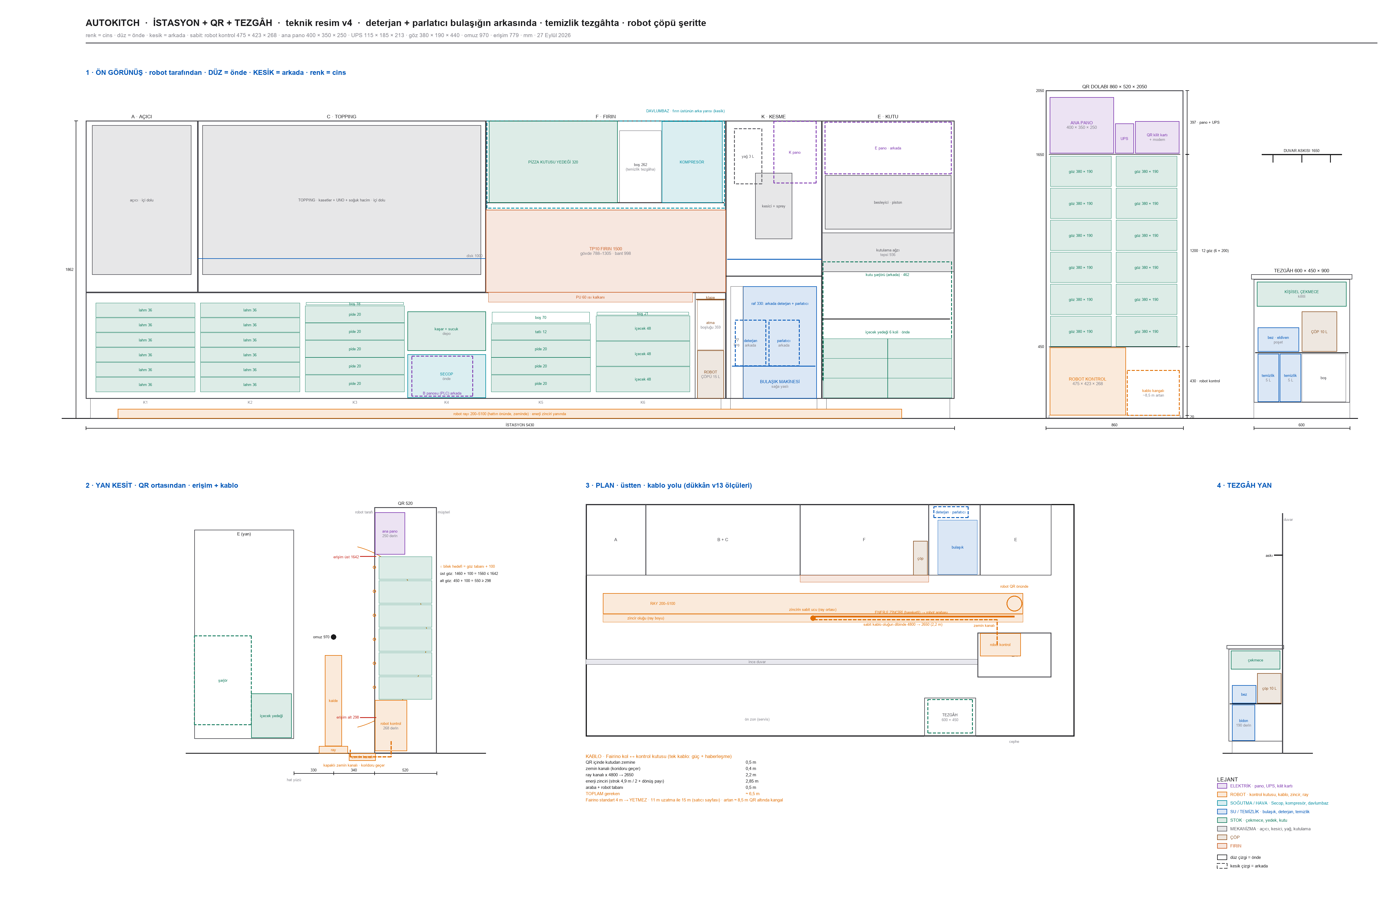
arastirma/FULL_MAKINE/QR_TEZGAH_v4.png
