kursatkemalkul/autokitch/arastirma/MODULER_ISTASYON_v1/ayri-moduller.png

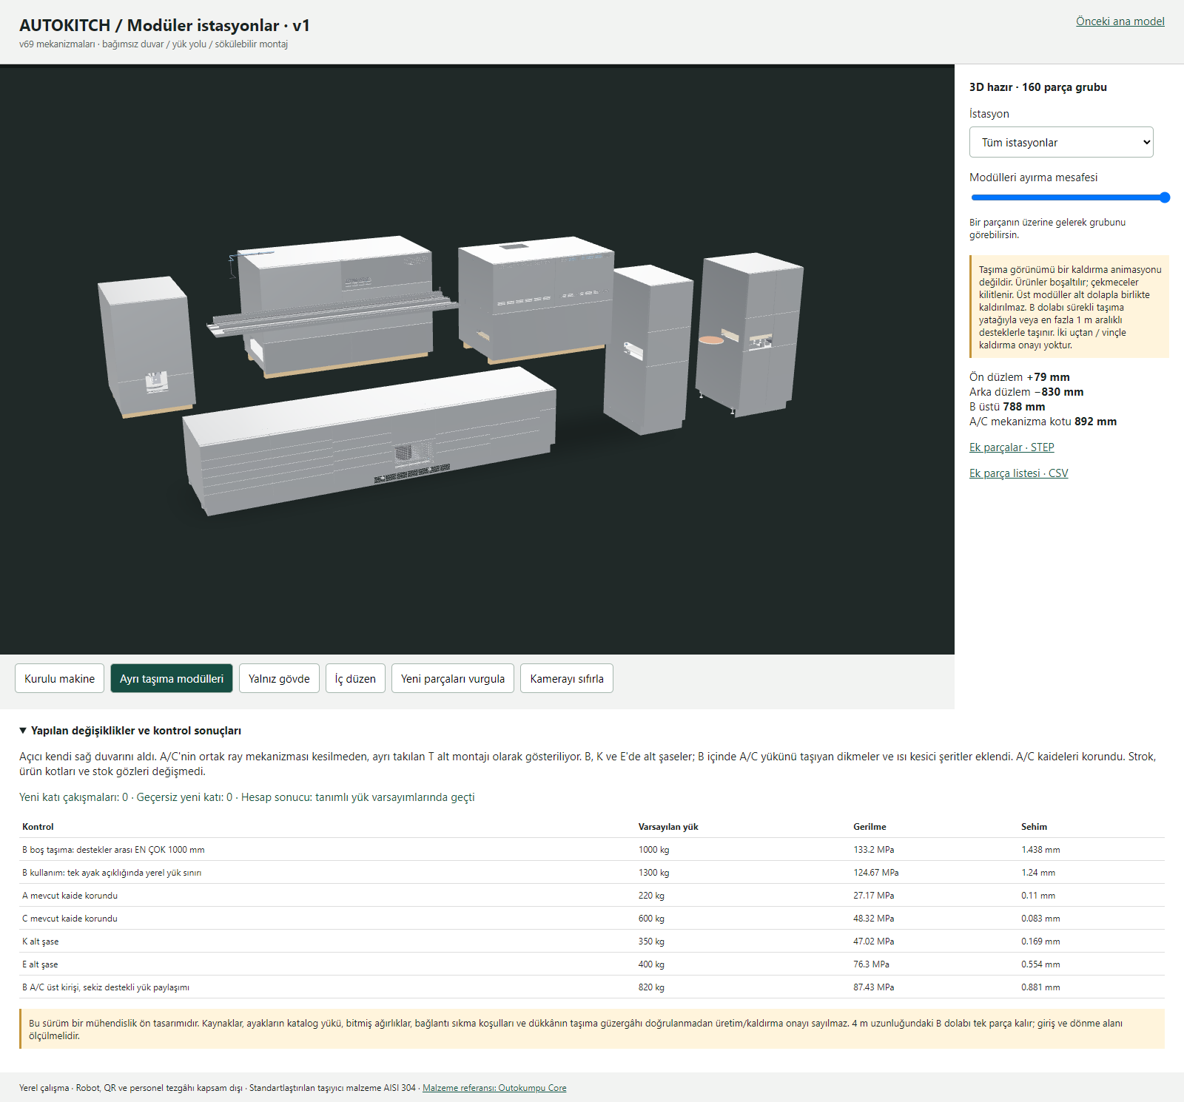
arastirma/MODULER_ISTASYON_v1/ayri-moduller.png
