kursatkemalkul/autokitch/arastirma/MODULER_ISTASYON_v1/B-ic-duzen.png

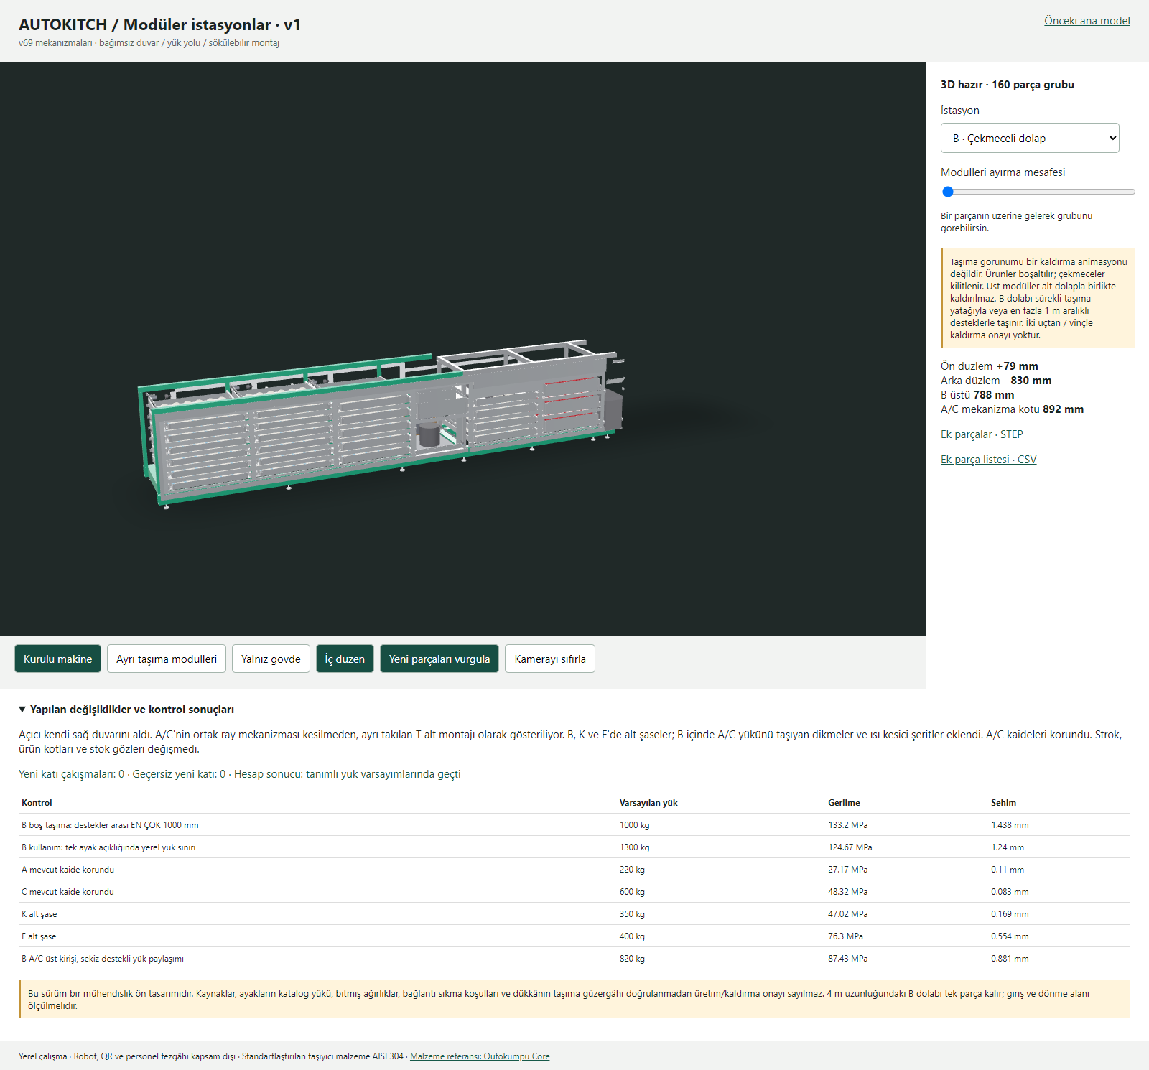
arastirma/MODULER_ISTASYON_v1/B-ic-duzen.png
