kursatkemalkul/autokitch/arastirma/MODULER_ISTASYON_v1/kurulu.png

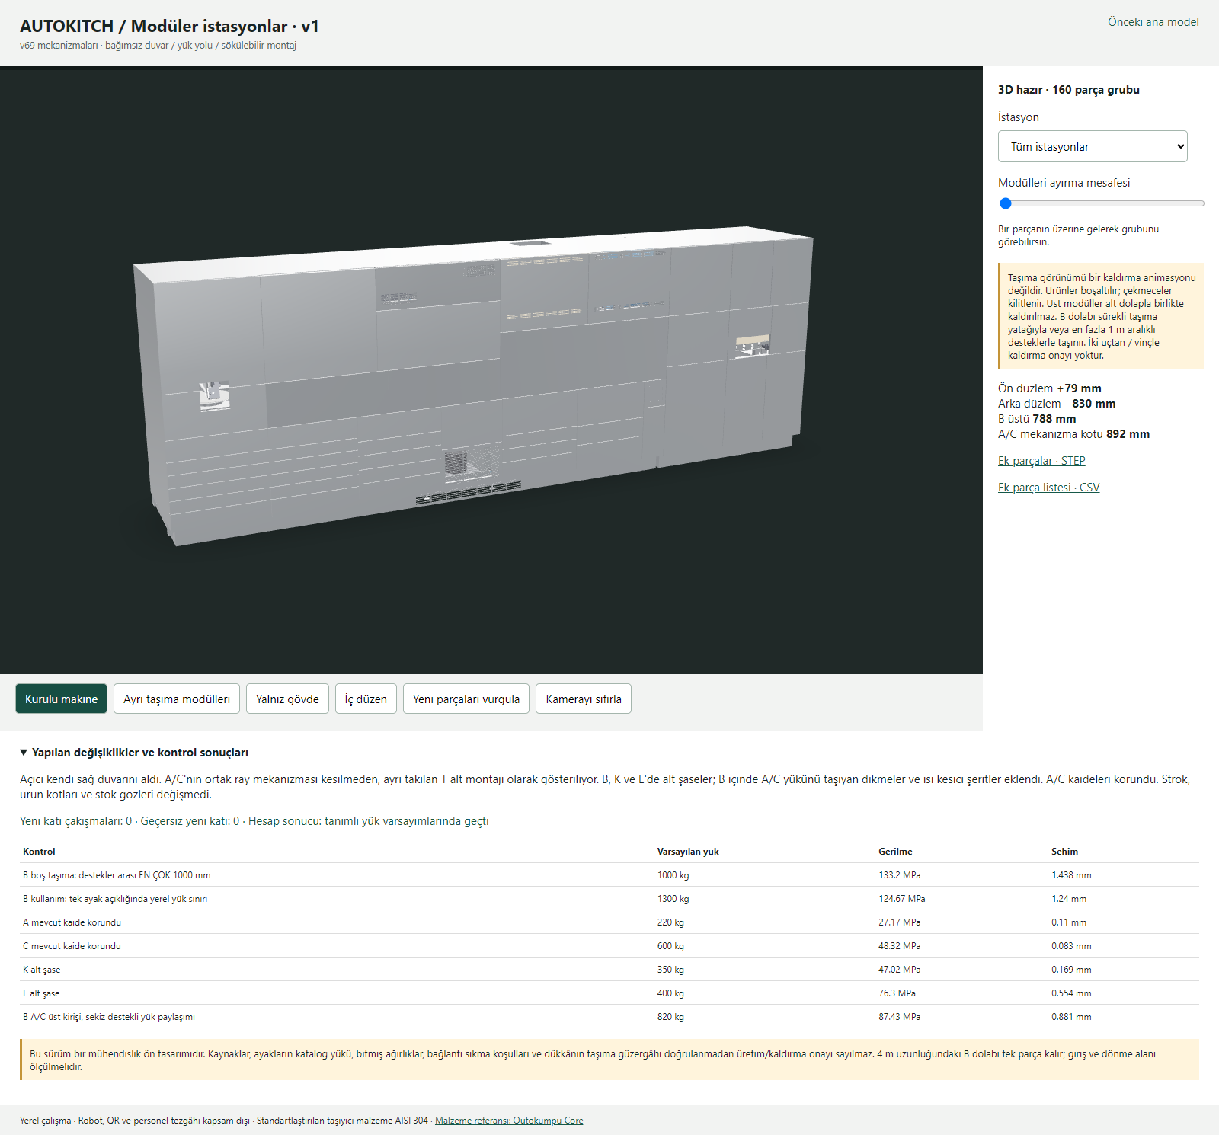
arastirma/MODULER_ISTASYON_v1/kurulu.png
