kursatkemalkul/autokitch/arastirma/TEDARIK/AUTOKITCH_DOSING_01.png

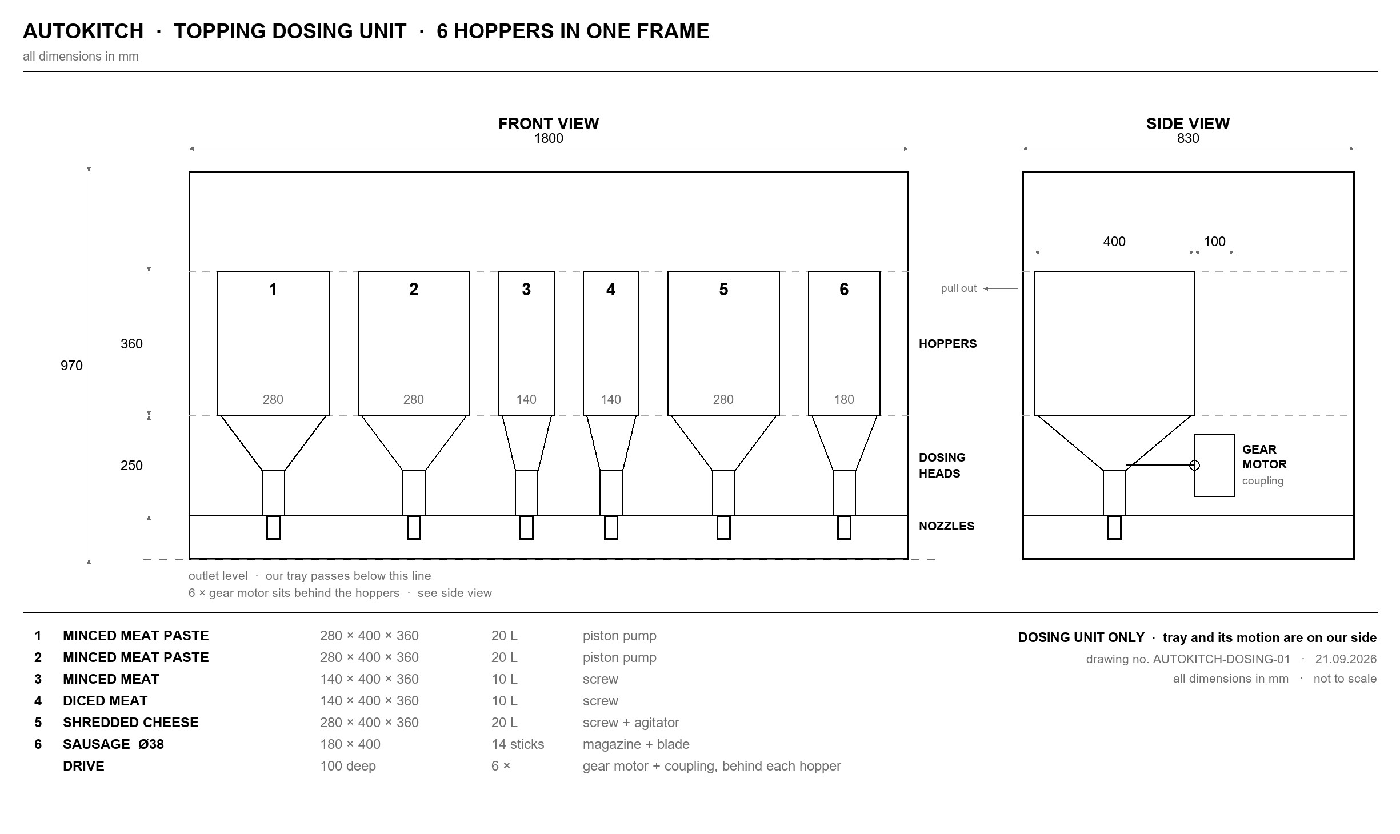
arastirma/TEDARIK/AUTOKITCH_DOSING_01.png
