kursatkemalkul/autokitch/otonom/hat3d/rochu-v9-four/evidence-v10/box-straight-start.jpg

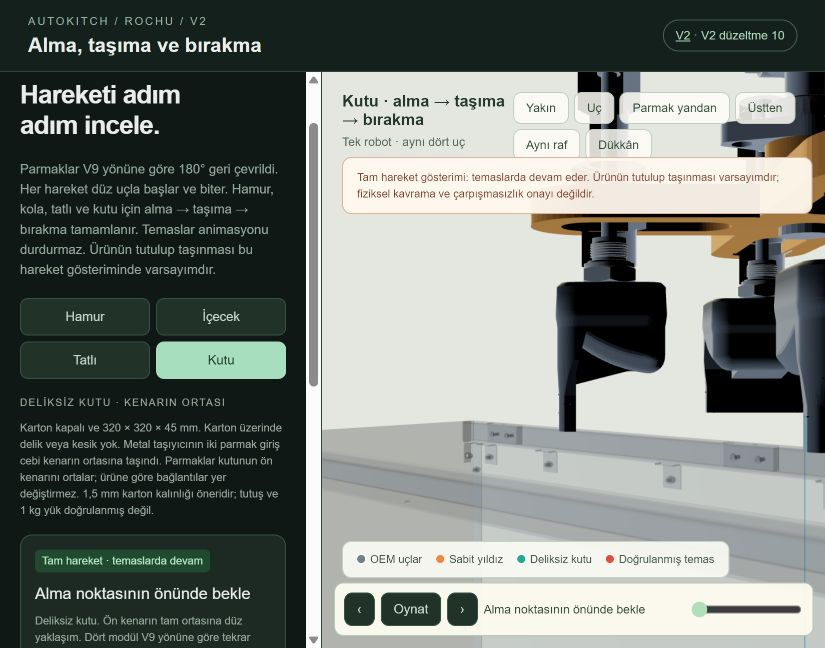
otonom/hat3d/rochu-v9-four/evidence-v10/box-straight-start.jpg
