kursatkemalkul/autokitch/otonom/hat/denemeler/rochu-kavrama-cizimleri/kavrama-kesitleri.png

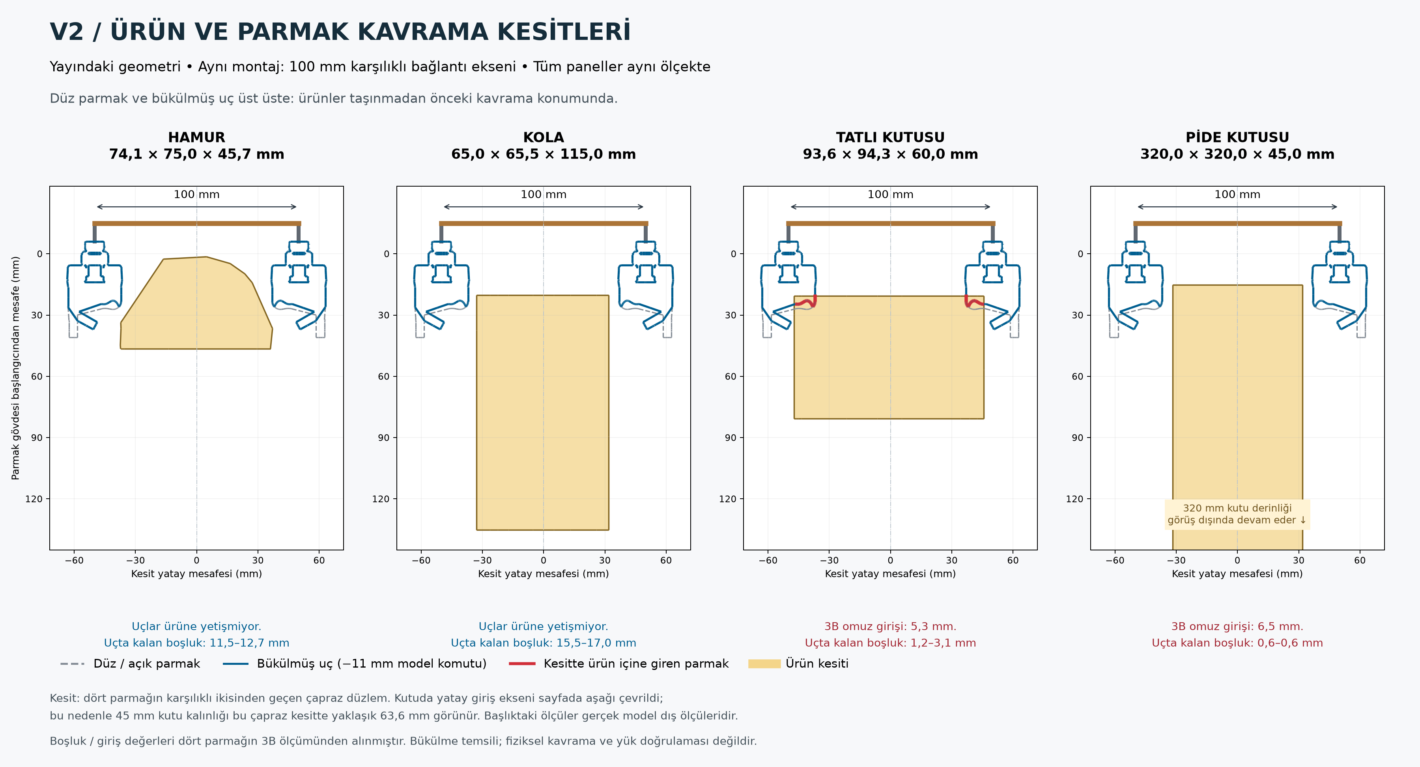
otonom/hat/denemeler/rochu-kavrama-cizimleri/kavrama-kesitleri.png
