kursatkemalkul/autokitch/otonom/hat/denemeler/rochu-kavrama-cizimleri/omuz-kesitleri.png

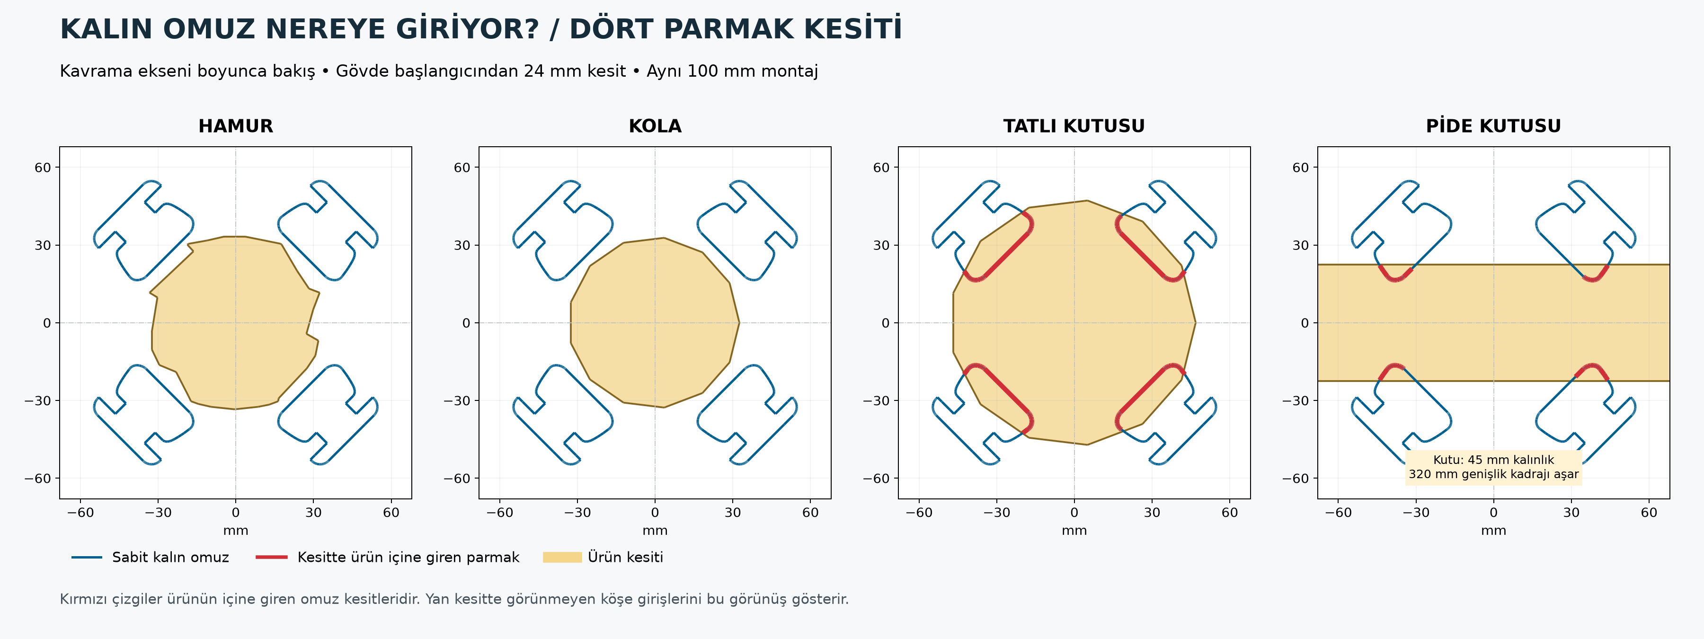
otonom/hat/denemeler/rochu-kavrama-cizimleri/omuz-kesitleri.png
