kursatkemalkul/autokitch/otonom/hat/denemeler/rochu-priority-grip/browser-box.png

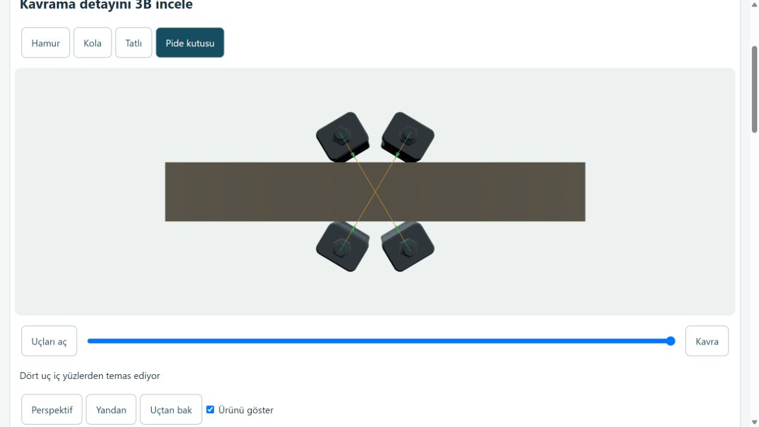
otonom/hat/denemeler/rochu-priority-grip/browser-box.png
