kursatkemalkul/autokitch/otonom/hat/denemeler/rochu-priority-grip/browser-inward.png

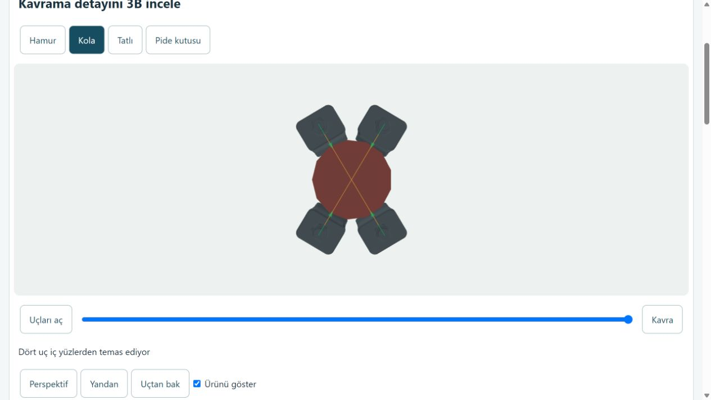
otonom/hat/denemeler/rochu-priority-grip/browser-inward.png
