kursatkemalkul/autokitch/otonom/hat/denemeler/rochu-priority-grip/plan.png

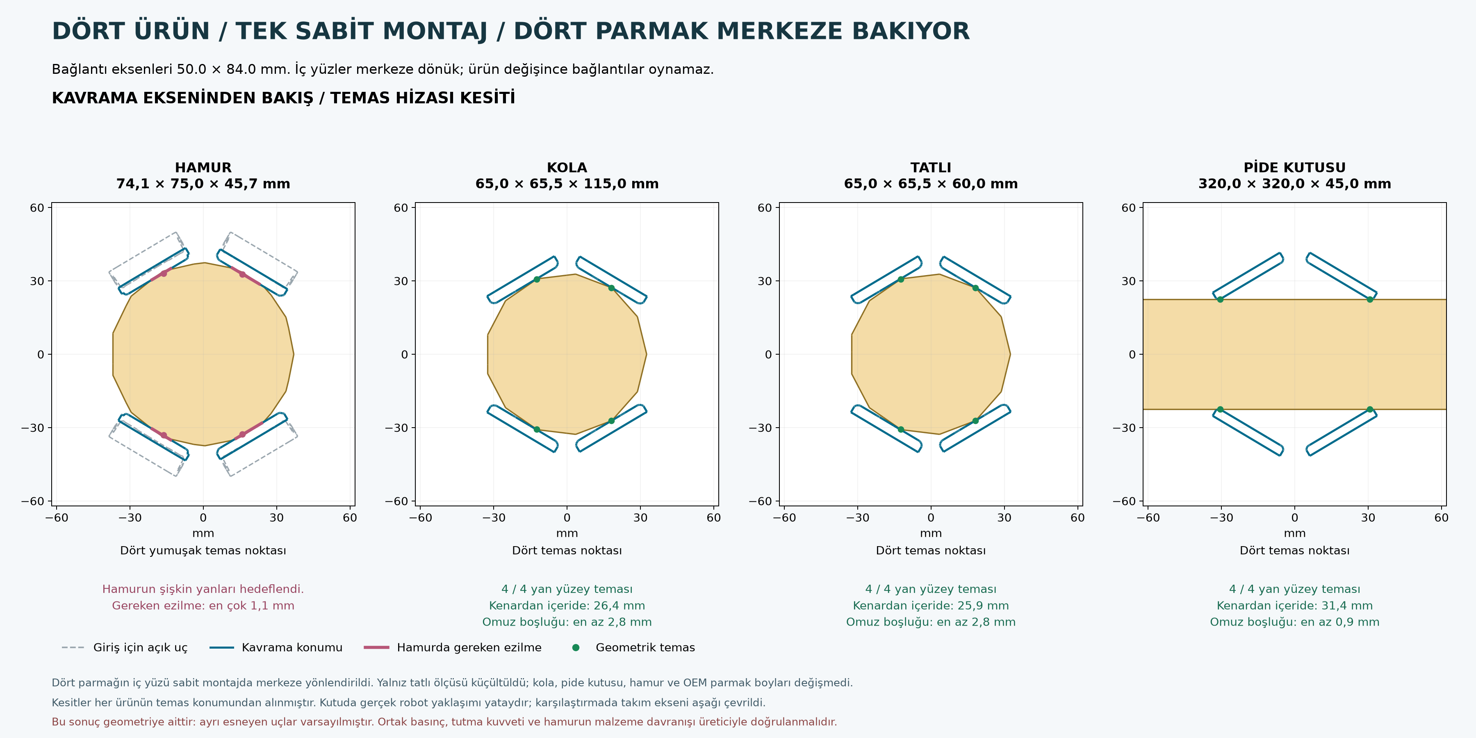
otonom/hat/denemeler/rochu-priority-grip/plan.png
