kursatkemalkul/autokitch/otonom/hat/denemeler/rochu-priority-grip/side.png

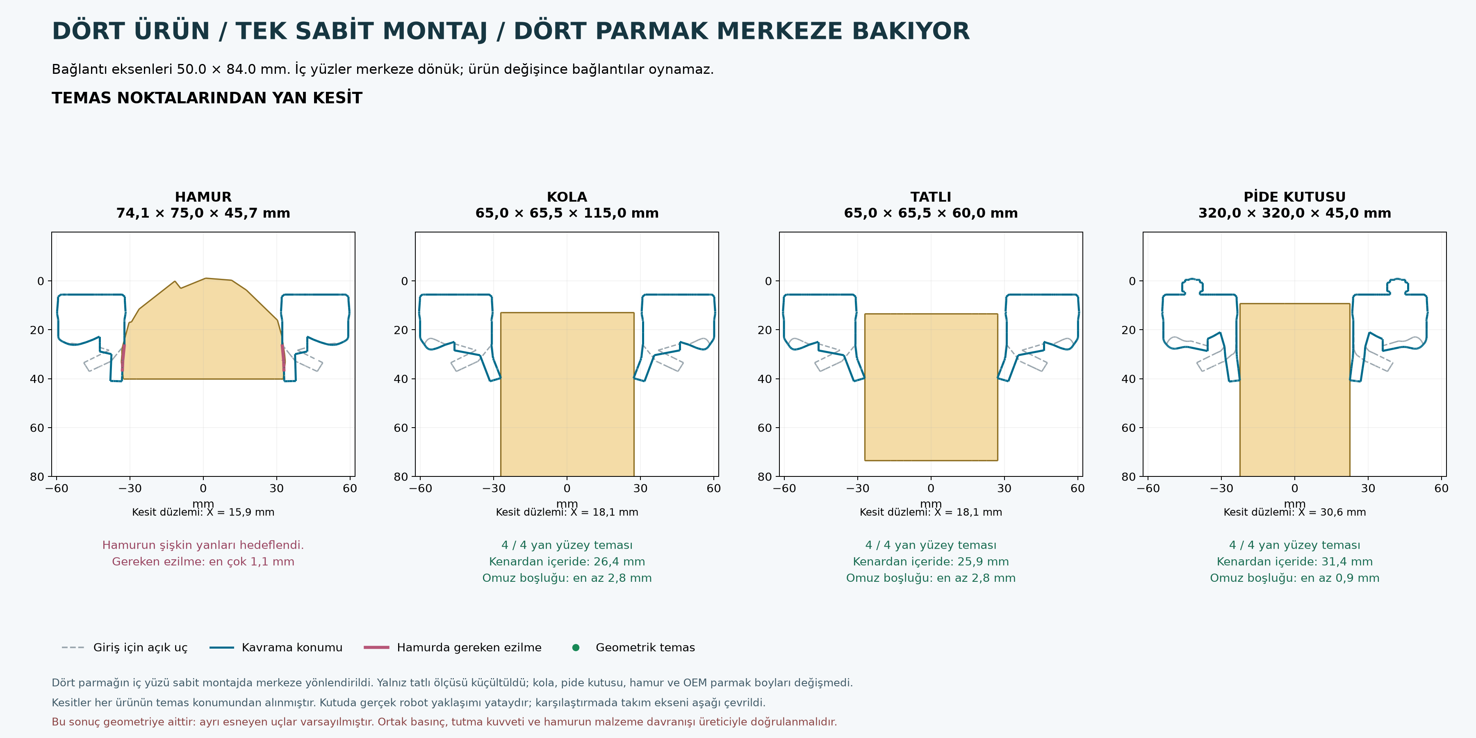
otonom/hat/denemeler/rochu-priority-grip/side.png
