kursatkemalkul/autokitch/otonom/hat/denemeler/rochu-small-dessert/shoulder.png

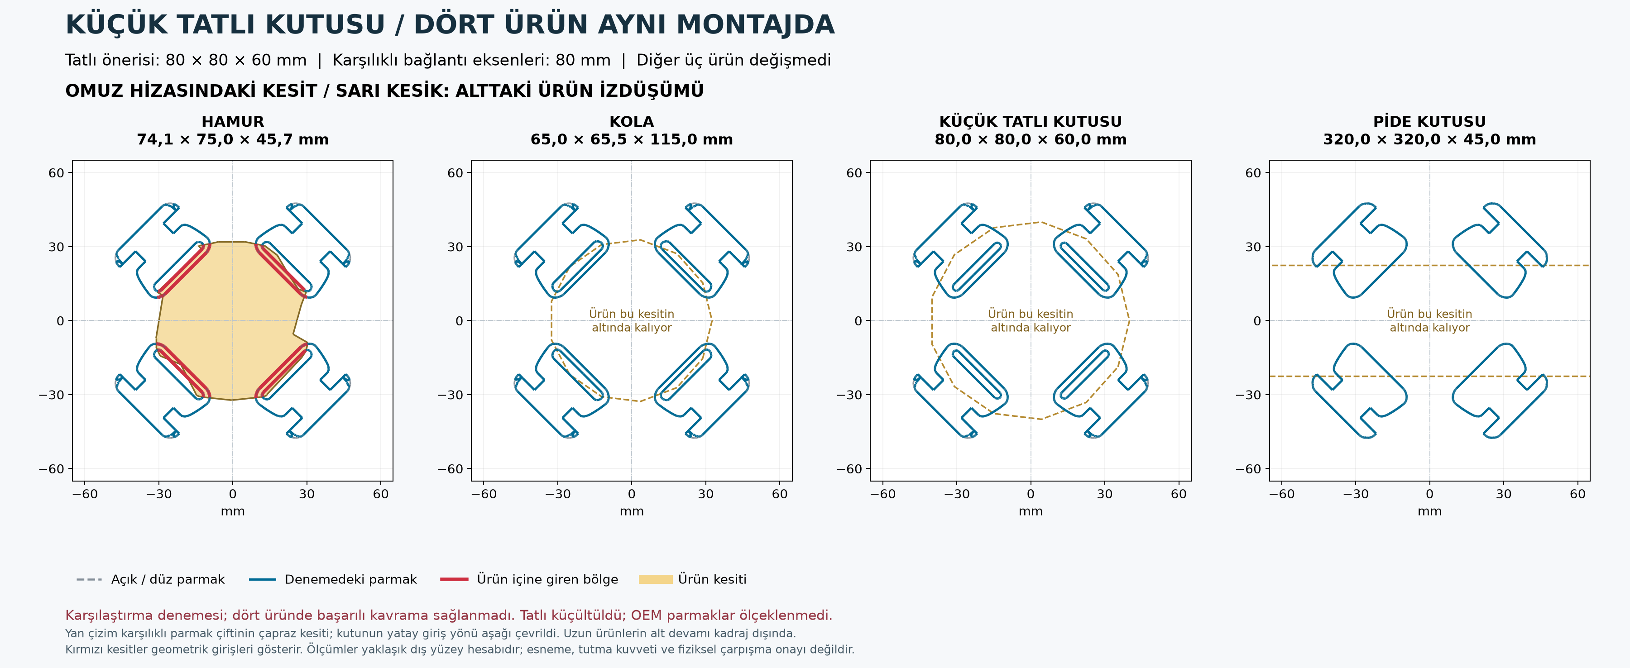
otonom/hat/denemeler/rochu-small-dessert/shoulder.png
