kursatkemalkul/autokitch/otonom/hat/denemeler/rochu-small-dessert/side.png

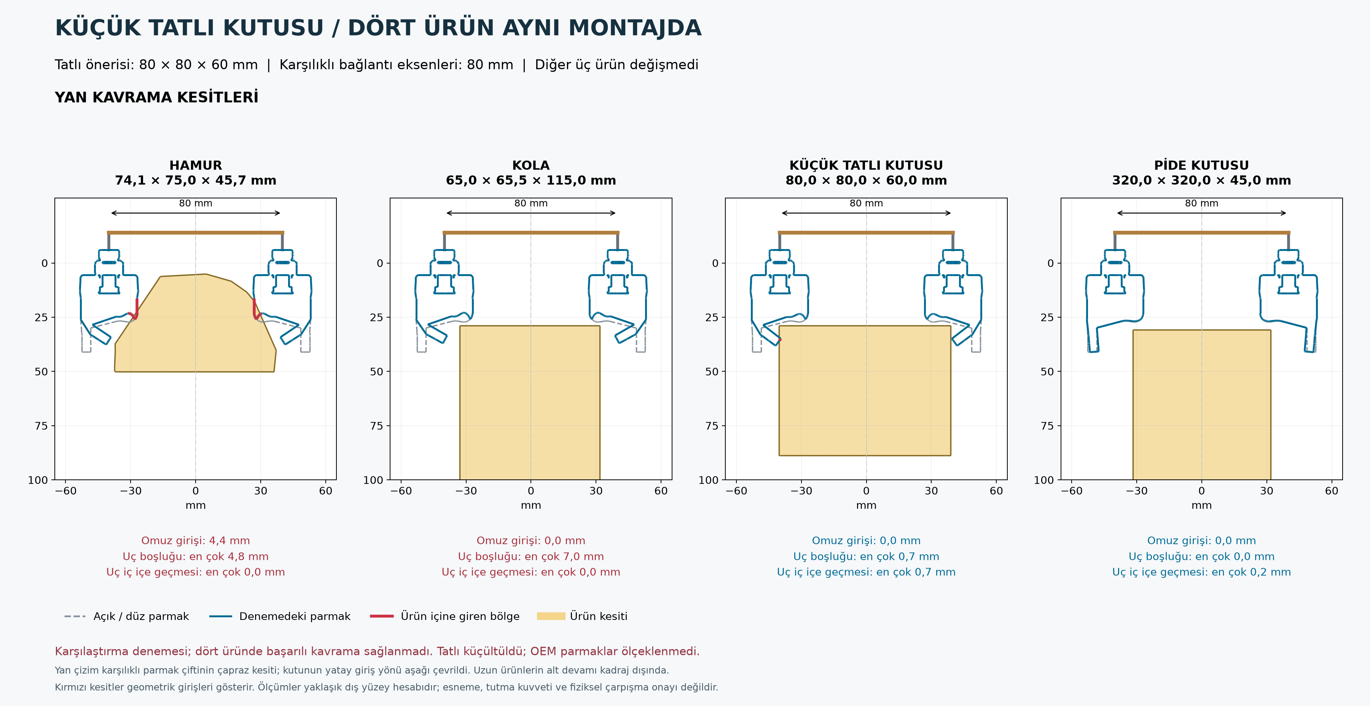
otonom/hat/denemeler/rochu-small-dessert/side.png
