kursatkemalkul/autokitch/otonom/hat/img/HAT_ATOSA_TABLALI_v18_teknik.png

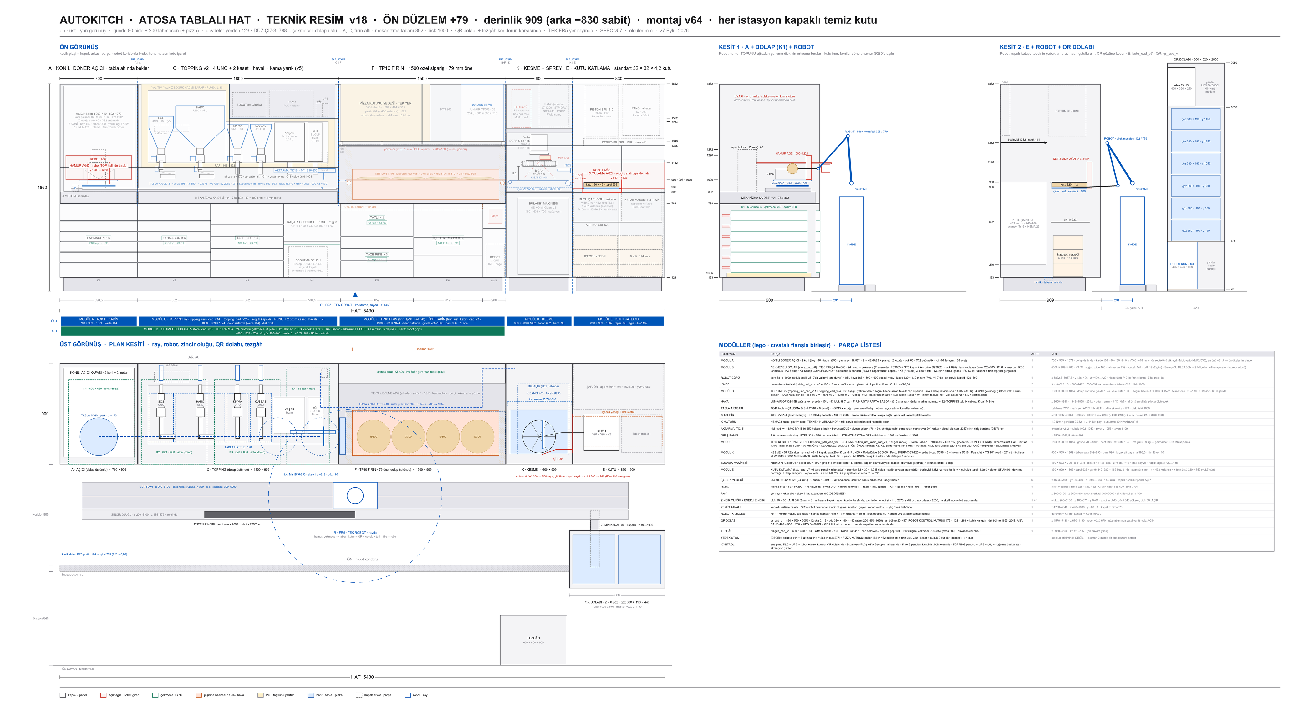
otonom/hat/img/HAT_ATOSA_TABLALI_v18_teknik.png
