kursatkemalkul/autokitch/otonom/hat/img/HAT_ATOSA_TABLALI_v19_teknik.png

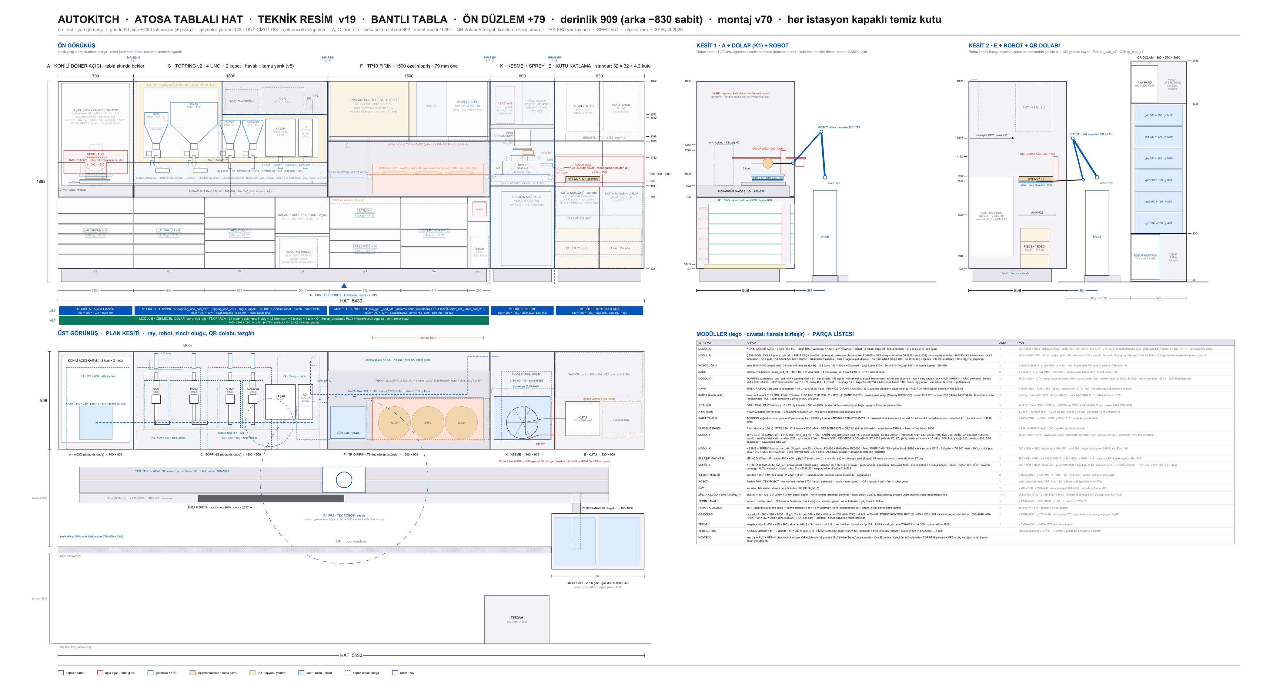
otonom/hat/img/HAT_ATOSA_TABLALI_v19_teknik.png
