kursatkemalkul/autokitch/otonom/img/ist3_topping_detay_v3.png

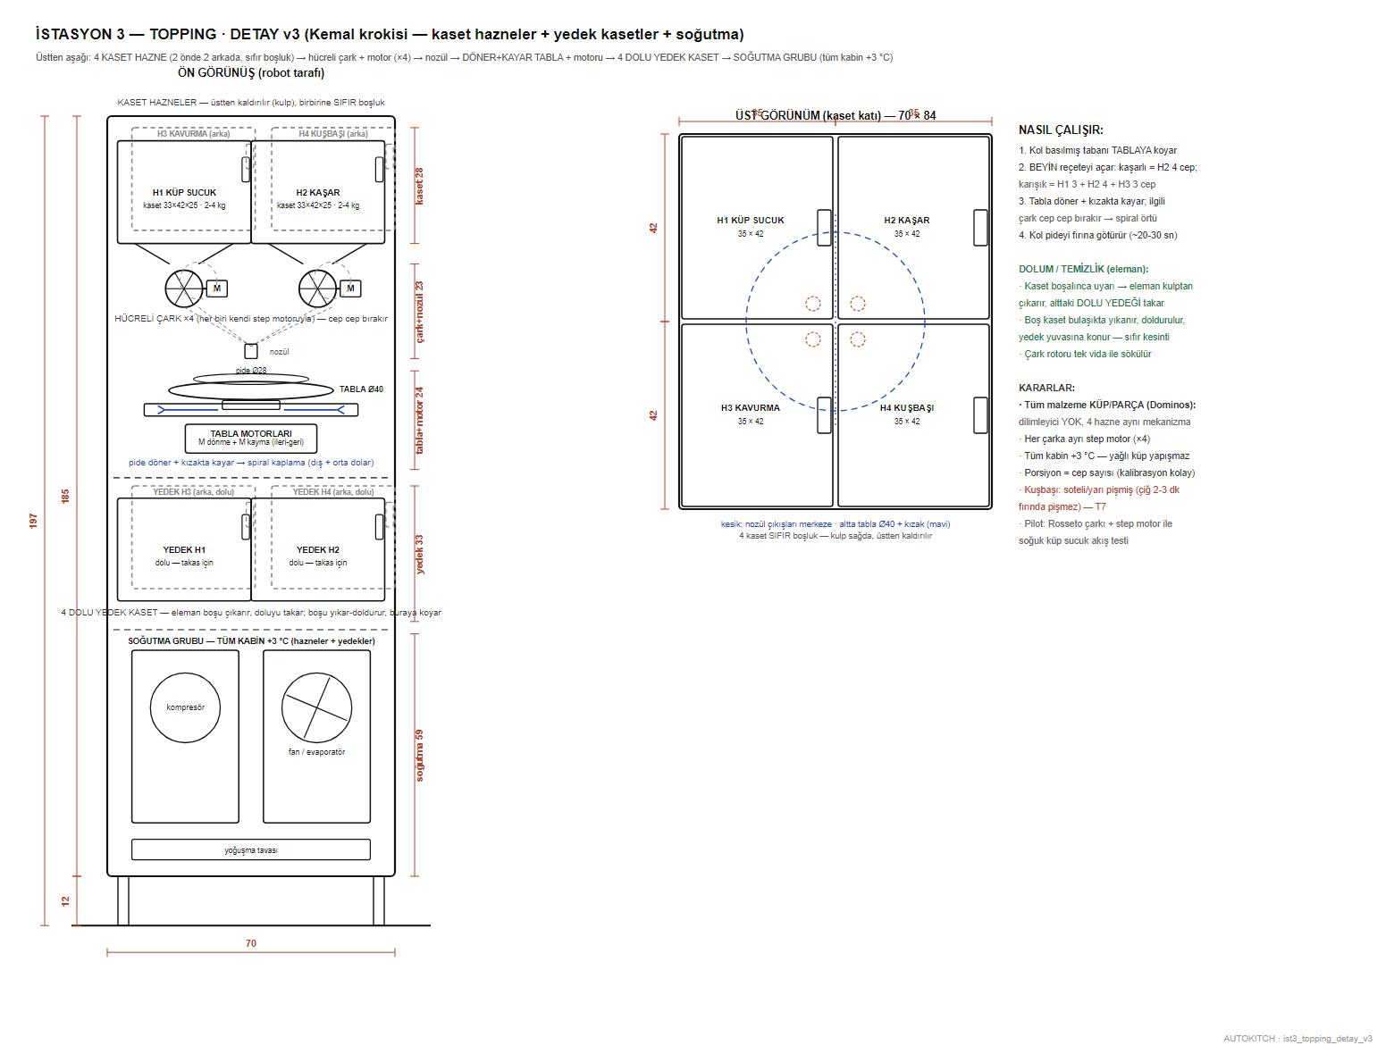
otonom/img/ist3_topping_detay_v3.png
