kursatkemalkul/autokitch/otonom/kaset3d/sucuk_dagilim.png

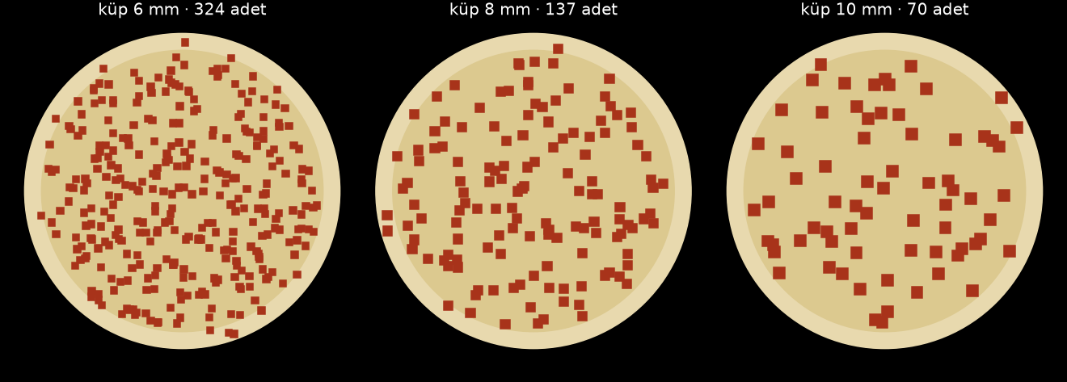
otonom/kaset3d/sucuk_dagilim.png
