kursatkemalkul/autokitch/arastirma/5_PACK_kutu_v8/BOM.csv

parça (model adı) | kalem | adet | tanım / ürün | not / ölçü | tür
ayak_0 | Ayarlı ayak Elesa+Ganter LV.A-SST · M12 | 6 | paslanmaz · taban Ø40 · v7: 4 köşe + 2 orta | elesa-ganter.com LV.A-SST | SATIN ALMA
ayak_1 | ayak 1 | 0 |  | aynı kalemin eşi — adet ilk örnekte | ALT
ayak_2 | ayak 2 | 0 |  | aynı kalemin eşi — adet ilk örnekte | ALT
ayak_3 | ayak 3 | 0 |  | aynı kalemin eşi — adet ilk örnekte | ALT
ayak_4 | ayak 4 | 0 |  | aynı kalemin eşi — adet ilk örnekte | ALT
ayak_5 | ayak 5 | 0 |  | aynı kalemin eşi — adet ilk örnekte | ALT
taban_sac_3 | taban sac 3 | 1 | 304 sac · lazer + büküm | zarf 827.0 × 3.0 × 886.0 | ÜRETİM
arka_sac | arka sac | 1 | 304 sac 1,5 · lazer + büküm (dış kabuk) | zarf 830.0 × 1739.0 × 1.5 | ÜRETİM
ust_sac | ust sac | 1 | 304 sac 1,5 · lazer + büküm (dış kabuk) | zarf 830.0 × 1.5 × 887.5 | ÜRETİM
sol_sac_pizza_penceresi | sol sac pizza penceresi | 1 | 304 sac 1,5 · lazer + büküm (dış kabuk) | zarf 1.5 × 1737.5 × 887.5 | ÜRETİM
sag_sac | sag sac | 1 | 304 sac 1,5 · lazer + büküm (dış kabuk) | zarf 1.5 × 1737.5 × 887.5 | ÜRETİM
sarjor_yan_kapisi | sarjor yan kapisi | 1 | 304 sac 1,5 · lazer + büküm (dış kabuk) | zarf 1.5 × 752.0 × 406.0 | ÜRETİM
sarjor_yan_kapisi_mentese_0 | Gizli menteşe · yan kapı (içte, 1,5 sac kapı) | 1 | arka kenar · kapı ↔ yan sac kesim kenarı | VARSAYIM ölçü 8,5 × 50 × 12 · üretici / parça no BULUNAMADI | SATIN ALMA
sarjor_yan_kapisi_mentese_1 | Gizli menteşe · yan kapı (içte, 1,5 sac kapı) | 1 | arka kenar · kapı ↔ yan sac kesim kenarı | VARSAYIM ölçü 8,5 × 50 × 12 · üretici / parça no BULUNAMADI | SATIN ALMA
sarjor_yan_kapisi_basac | Bas-aç mandalı (push-to-open, mıknatıslı) | 1 | yan kapı ön kenarı · içte | VARSAYIM ölçü · Southco push-to-open ailesi, parça no BULUNAMADI | SATIN ALMA
agiz_ust_kirisi | agiz ust kirisi | 1 | 304 / S235 · lazer / torna | zarf 827.0 × 15.0 × 20.0 | ÜRETİM
onyuz_dikme_sol | Ön dikme sol · 304 kutu profil 20 × 30 × 2 + 1,0 lam | 1 | profil y 520–1860.5 · lam y 126–520 (koli bandı: yol serbest) · yan saca kaynaklı | v7 · üretim | ÜRETİM
onyuz_dikme_sag | Ön dikme sağ · 304 kutu profil 20 × 30 × 2 | 1 | y 126–1860.5 · yan saca kaynaklı | v7 · üretim | ÜRETİM
onyuz_kayit_orta | Ön kayıt · 304 kutu profil 30 × 30 × 2 | 1 | boy 787 · derz arkasında (üst yüzü y 883) · dikmelere kaynaklı | v7 · üretim | ÜRETİM
onyuz_kayit_ust | Ön kayıt · 304 kutu profil 30 × 30 × 2 | 1 | boy 787 · derz arkasında (üst yüzü y 1305) · dikmelere kaynaklı | v7 · üretim | ÜRETİM
onyuz_alt_kanat_sol | Tava kapak 304 fırçalı 1,5 · 20 büküm + 1,0 iç kapatma sacı (kutu kesit) | 1 | 413.0 × 757.0 · gizli menteşe sol (sıfır çıkıntılı 155°) · bas-aç · kulpsuz | v7 · SPEC_on_duzlem_v63 | ÜRETİM
onyuz_alt_kanat_sag | Tava kapak 304 fırçalı 1,5 · 20 büküm + 1,0 iç kapatma sacı (kutu kesit) | 1 | 412.5 × 757.0 · gizli menteşe sag (sıfır çıkıntılı 155°) · bas-aç · kulpsuz | v7 · SPEC_on_duzlem_v63 | ÜRETİM
onyuz_orta_sabit_panel | Tava sabit panel 304 fırçalı 1,5 · 20 büküm | 1 | 438.5 × 419.0 · ROBOT AĞZI kesikli (x 85–440 · y 886–1062, kenarları bükülü) · arkadan kaynaklı M5 saplamalı | v7 · SPEC_on_duzlem_v63 | ÜRETİM
onyuz_orta_servis_kapagi | Tava kapak 304 fırçalı 1,5 · 20 büküm | 1 | 387.0 × 419.0 · gizli menteşe sag (sıfır çıkıntılı 155°) · bas-aç · kulpsuz | v7 · SPEC_on_duzlem_v63 | ÜRETİM
onyuz_ust_kanat_sol | Tava kapak 304 fırçalı 1,5 · 20 büküm | 1 | 413.0 × 551.0 · gizli menteşe sol (sıfır çıkıntılı 155°) · bas-aç · kulpsuz | v7 · SPEC_on_duzlem_v63 | ÜRETİM
onyuz_ust_kanat_sag | Tava kapak 304 fırçalı 1,5 · 20 büküm | 1 | 412.5 × 551.0 · gizli menteşe sag (sıfır çıkıntılı 155°) · bas-aç · kulpsuz | v7 · SPEC_on_duzlem_v63 | ÜRETİM
onyuz_mentese_0 | Gizli menteşe · sıfır çıkıntılı 155°, tam bindirme (aday Blum CLIP top 71B7550 ailesi; bas-aç için yaysız sürüm) | 1 | 90°'de kapak iç yüzü yan sac iç yüzünde → koli / servis yolu açık · kılavuz: ≤ 900 mm kapakta 6,8 kg'a kadar 2, üstü 3 menteşe (okuma VARSAYIM) | blum.com 71B7550 (155° zero protrusion, kapak ≤ 24 mm) · sac kapakta Ø35 kap yuvası kaynaklı · yaysız parça no + ölçü VARSAYIM 20 × 60 × 28,5 | SATIN ALMA
onyuz_mentese_1 | Gizli menteşe · sıfır çıkıntılı 155°, tam bindirme (aday Blum CLIP top 71B7550 ailesi; bas-aç için yaysız sürüm) | 1 | 90°'de kapak iç yüzü yan sac iç yüzünde → koli / servis yolu açık · kılavuz: ≤ 900 mm kapakta 6,8 kg'a kadar 2, üstü 3 menteşe (okuma VARSAYIM) | blum.com 71B7550 (155° zero protrusion, kapak ≤ 24 mm) · sac kapakta Ø35 kap yuvası kaynaklı · yaysız parça no + ölçü VARSAYIM 20 × 60 × 28,5 | SATIN ALMA
onyuz_mentese_2 | Gizli menteşe · sıfır çıkıntılı 155°, tam bindirme (aday Blum CLIP top 71B7550 ailesi; bas-aç için yaysız sürüm) | 1 | 90°'de kapak iç yüzü yan sac iç yüzünde → koli / servis yolu açık · kılavuz: ≤ 900 mm kapakta 6,8 kg'a kadar 2, üstü 3 menteşe (okuma VARSAYIM) | blum.com 71B7550 (155° zero protrusion, kapak ≤ 24 mm) · sac kapakta Ø35 kap yuvası kaynaklı · yaysız parça no + ölçü VARSAYIM 20 × 60 × 28,5 | SATIN ALMA
onyuz_mentese_3 | Gizli menteşe · sıfır çıkıntılı 155°, tam bindirme (aday Blum CLIP top 71B7550 ailesi; bas-aç için yaysız sürüm) | 1 | 90°'de kapak iç yüzü yan sac iç yüzünde → koli / servis yolu açık · kılavuz: ≤ 900 mm kapakta 6,8 kg'a kadar 2, üstü 3 menteşe (okuma VARSAYIM) | blum.com 71B7550 (155° zero protrusion, kapak ≤ 24 mm) · sac kapakta Ø35 kap yuvası kaynaklı · yaysız parça no + ölçü VARSAYIM 20 × 60 × 28,5 | SATIN ALMA
onyuz_mentese_4 | Gizli menteşe · sıfır çıkıntılı 155°, tam bindirme (aday Blum CLIP top 71B7550 ailesi; bas-aç için yaysız sürüm) | 1 | 90°'de kapak iç yüzü yan sac iç yüzünde → koli / servis yolu açık · kılavuz: ≤ 900 mm kapakta 6,8 kg'a kadar 2, üstü 3 menteşe (okuma VARSAYIM) | blum.com 71B7550 (155° zero protrusion, kapak ≤ 24 mm) · sac kapakta Ø35 kap yuvası kaynaklı · yaysız parça no + ölçü VARSAYIM 20 × 60 × 28,5 | SATIN ALMA
onyuz_mentese_5 | Gizli menteşe · sıfır çıkıntılı 155°, tam bindirme (aday Blum CLIP top 71B7550 ailesi; bas-aç için yaysız sürüm) | 1 | 90°'de kapak iç yüzü yan sac iç yüzünde → koli / servis yolu açık · kılavuz: ≤ 900 mm kapakta 6,8 kg'a kadar 2, üstü 3 menteşe (okuma VARSAYIM) | blum.com 71B7550 (155° zero protrusion, kapak ≤ 24 mm) · sac kapakta Ø35 kap yuvası kaynaklı · yaysız parça no + ölçü VARSAYIM 20 × 60 × 28,5 | SATIN ALMA
onyuz_mentese_6 | Gizli menteşe · sıfır çıkıntılı 155°, tam bindirme (aday Blum CLIP top 71B7550 ailesi; bas-aç için yaysız sürüm) | 1 | 90°'de kapak iç yüzü yan sac iç yüzünde → koli / servis yolu açık · kılavuz: ≤ 900 mm kapakta 6,8 kg'a kadar 2, üstü 3 menteşe (okuma VARSAYIM) | blum.com 71B7550 (155° zero protrusion, kapak ≤ 24 mm) · sac kapakta Ø35 kap yuvası kaynaklı · yaysız parça no + ölçü VARSAYIM 20 × 60 × 28,5 | SATIN ALMA
onyuz_mentese_7 | Gizli menteşe · sıfır çıkıntılı 155°, tam bindirme (aday Blum CLIP top 71B7550 ailesi; bas-aç için yaysız sürüm) | 1 | 90°'de kapak iç yüzü yan sac iç yüzünde → koli / servis yolu açık · kılavuz: ≤ 900 mm kapakta 6,8 kg'a kadar 2, üstü 3 menteşe (okuma VARSAYIM) | blum.com 71B7550 (155° zero protrusion, kapak ≤ 24 mm) · sac kapakta Ø35 kap yuvası kaynaklı · yaysız parça no + ölçü VARSAYIM 20 × 60 × 28,5 | SATIN ALMA
onyuz_mentese_8 | Gizli menteşe · sıfır çıkıntılı 155°, tam bindirme (aday Blum CLIP top 71B7550 ailesi; bas-aç için yaysız sürüm) | 1 | 90°'de kapak iç yüzü yan sac iç yüzünde → koli / servis yolu açık · kılavuz: ≤ 900 mm kapakta 6,8 kg'a kadar 2, üstü 3 menteşe (okuma VARSAYIM) | blum.com 71B7550 (155° zero protrusion, kapak ≤ 24 mm) · sac kapakta Ø35 kap yuvası kaynaklı · yaysız parça no + ölçü VARSAYIM 20 × 60 × 28,5 | SATIN ALMA
onyuz_mentese_9 | Gizli menteşe · sıfır çıkıntılı 155°, tam bindirme (aday Blum CLIP top 71B7550 ailesi; bas-aç için yaysız sürüm) | 1 | 90°'de kapak iç yüzü yan sac iç yüzünde → koli / servis yolu açık · kılavuz: ≤ 900 mm kapakta 6,8 kg'a kadar 2, üstü 3 menteşe (okuma VARSAYIM) | blum.com 71B7550 (155° zero protrusion, kapak ≤ 24 mm) · sac kapakta Ø35 kap yuvası kaynaklı · yaysız parça no + ölçü VARSAYIM 20 × 60 × 28,5 | SATIN ALMA
onyuz_mentese_10 | Gizli menteşe · sıfır çıkıntılı 155°, tam bindirme (aday Blum CLIP top 71B7550 ailesi; bas-aç için yaysız sürüm) | 1 | 90°'de kapak iç yüzü yan sac iç yüzünde → koli / servis yolu açık · kılavuz: ≤ 900 mm kapakta 6,8 kg'a kadar 2, üstü 3 menteşe (okuma VARSAYIM) | blum.com 71B7550 (155° zero protrusion, kapak ≤ 24 mm) · sac kapakta Ø35 kap yuvası kaynaklı · yaysız parça no + ölçü VARSAYIM 20 × 60 × 28,5 | SATIN ALMA
onyuz_mentese_11 | Gizli menteşe · sıfır çıkıntılı 155°, tam bindirme (aday Blum CLIP top 71B7550 ailesi; bas-aç için yaysız sürüm) | 1 | 90°'de kapak iç yüzü yan sac iç yüzünde → koli / servis yolu açık · kılavuz: ≤ 900 mm kapakta 6,8 kg'a kadar 2, üstü 3 menteşe (okuma VARSAYIM) | blum.com 71B7550 (155° zero protrusion, kapak ≤ 24 mm) · sac kapakta Ø35 kap yuvası kaynaklı · yaysız parça no + ölçü VARSAYIM 20 × 60 × 28,5 | SATIN ALMA
onyuz_alt_dayama_dudagi | ALT kanat dayama dudağı 304 lama 3 × 14 | 1 | x 2.5–808.5 · tabana kaynaklı · ALT kanatların alt kenarı yaslanır (koli yolunun 1 mm altında) | v7b · üretim | ÜRETİM
onyuz_basac_0 | Bas-aç mandalı (push-to-open, mıknatıslı) | 1 | onyuz_alt_kanat_sol serbest kenarı · kayıta vidalı · pim kapak kenar bükümüne basar (2 mm) | VARSAYIM ölçü 20 × 30 × 18 · Southco push-to-open ailesi, parça no BULUNAMADI | SATIN ALMA
onyuz_basac_1 | Bas-aç mandalı (push-to-open, mıknatıslı) | 1 | onyuz_alt_kanat_sag serbest kenarı · kayıta vidalı · pim kapak kenar bükümüne basar (2 mm) | VARSAYIM ölçü 20 × 30 × 18 · Southco push-to-open ailesi, parça no BULUNAMADI | SATIN ALMA
onyuz_basac_2 | Bas-aç mandalı (push-to-open, mıknatıslı) | 1 | onyuz_orta_servis_kapagi serbest kenarı · kayıta vidalı · pim kapak kenar bükümüne basar (2 mm) | VARSAYIM ölçü 20 × 30 × 18 · Southco push-to-open ailesi, parça no BULUNAMADI | SATIN ALMA
onyuz_basac_3 | Bas-aç mandalı (push-to-open, mıknatıslı) | 1 | onyuz_ust_kanat_sol serbest kenarı · kayıta vidalı · pim kapak kenar bükümüne basar (2 mm) | VARSAYIM ölçü 20 × 30 × 18 · Southco push-to-open ailesi, parça no BULUNAMADI | SATIN ALMA
onyuz_basac_4 | Bas-aç mandalı (push-to-open, mıknatıslı) | 1 | onyuz_ust_kanat_sag serbest kenarı · kayıta vidalı · pim kapak kenar bükümüne basar (2 mm) | VARSAYIM ölçü 20 × 30 × 18 · Southco push-to-open ailesi, parça no BULUNAMADI | SATIN ALMA
onyuz_plint | Plint (süpürgelik) 304 fırçalı 1,5 | 1 | ön x 0–800 · z +17.5…+19.0 (ön düzlemin 60 gerisi) + hat sonu dönüşü · klipsli, sökülür | v7 | ÜRETİM
kilavuz_sol_uhmw | UHMW-PE şerit 3 mm (şarjör kılavuzu) | 3 | sol + sağ + arka | levha | SATIN ALMA
kilavuz_sag_uhmw | kilavuz sag uhmw | 0 |  | aynı kalemin eşi — adet ilk örnekte | ALT
kilavuz_sol_tasiyici | kilavuz sol tasiyici | 1 | 304 sac · lazer + büküm | zarf 3.0 × 740.0 × 20.0 | ÜRETİM
kilavuz_sag_tasiyici | kilavuz sag tasiyici | 1 | 304 sac · lazer + büküm | zarf 13.0 × 740.0 × 20.0 | ÜRETİM
kilavuz_arka_uhmw | kilavuz arka uhmw | 0 |  | aynı kalemin eşi — adet ilk örnekte | ALT
kilavuz_arka_tasiyici | kilavuz arka tasiyici | 1 | 304 sac · lazer + büküm | zarf 724.0 × 728.0 × 6.0 | ÜRETİM
sarjor_kapi_esigi | Şarjör eşiği 304 · 3 mm tarak (4 diş) + diş ayakları | 1 | 804 × 855 · üst kenar 980,8 (2. blankı tutar) · ayaklar tabana 8 × M5 · iki yanda köşebentle yan saca | v7b · üretim | ÜRETİM
sarjor_kapi_esigi_kosebendi_sol | Eşik köşebendi 304 · L 3 mm (bükümlü) | 1 | eşik ön yüzü ↔ yan sac · 2 + 2 × M5 | v7b · üretim | ÜRETİM
sarjor_kapi_esigi_kosebendi_sag | Eşik köşebendi 304 · L 3 mm (bükümlü) | 1 | eşik ön yüzü ↔ yan sac · 2 + 2 × M5 | v7b · üretim | ÜRETİM
karton_yigini | Pizza kutusu 32 × 32 × 4,2 E-dalga (düz açılım 804 × 404) | 462 | yığın 740 mm = 462 adet @1,6 · 411 @1,8 (v5 alçak hat; + fırın üstü yedek 320) | AmbalajPazarı · 100'lü paket (sarf) | SATIN ALMA
asansor_platformu | asansor platformu | 1 | alüminyum 6082 · CNC | zarf 804.0 × 3.0 × 404.0 | ÜRETİM
asansor_catali_0 | asansor catali 0 | 1 | 304 / S235 · lazer / torna | zarf 30.0 × 8.0 × 413.0 | ÜRETİM
asansor_catali_1 | asansor catali 1 | 1 | 304 / S235 · lazer / torna | zarf 30.0 × 8.0 × 413.0 | ÜRETİM
asansor_catali_2 | asansor catali 2 | 1 | 304 / S235 · lazer / torna | zarf 30.0 × 8.0 × 413.0 | ÜRETİM
asansor_arabasi | asansor arabasi | 1 | 304 / S235 · lazer / torna | zarf 500.0 × 130.0 × 4.0 | ÜRETİM
asansor_ray_plakasi | asansor ray plakasi | 1 | 304 sac · lazer + büküm | zarf 400.0 × 846.0 × 4.0 | ÜRETİM
asansor_ray_plakasi_flansi | Ray plakası taban flanşı 304 · L 3 mm | 1 | 400 × 20 tabana 4 × M6 · dik kol plakaya 4 × M5 | v7b: plakanın alt mesnedi | ÜRETİM
asansor_ray_plakasi_ust_kosebendi_sol | Ray plakası üst köşebendi 304 · L 32 × 26 · 4 mm + yan saca dik kol | 1 | plakaya 30 mm bindirme (2 × M5) · yan saca 2 × M5 · yığın momenti | v7b · üretim | ÜRETİM
asansor_ray_plakasi_ust_kosebendi_sag | Ray plakası üst köşebendi 304 · L 32 × 26 · 4 mm + yan saca dik kol | 1 | plakaya 30 mm bindirme (2 × M5) · yan saca 2 × M5 · yığın momenti | v7b · üretim | ÜRETİM
asansor_rayi_0 | Lineer ray HIWIN HGR15R | 2 | asansör · boy 822 (v5) | hiwin.com | SATIN ALMA
asansor_arabasi_00 | Lineer araba HIWIN HGH15CA | 1 | flanşsız · 34 × 61,4 · H 28 | TraceParts 90-03042020-037166 | SATIN ALMA
asansor_arabasi_01 | Lineer araba HIWIN HGH15CA | 1 | flanşsız · 34 × 61,4 · H 28 | TraceParts 90-03042020-037166 | SATIN ALMA
asansor_rayi_1 | Lineer ray HIWIN HGR15R | 0 |  | aynı kalemin eşi (adet ana satırda) | ALT
asansor_arabasi_10 | Lineer araba HIWIN HGH15CA | 1 | flanşsız · 34 × 61,4 · H 28 | TraceParts 90-03042020-037166 | SATIN ALMA
asansor_arabasi_11 | Lineer araba HIWIN HGH15CA | 1 | flanşsız · 34 × 61,4 · H 28 | TraceParts 90-03042020-037166 | SATIN ALMA
asansor_vidasi_Tr16x4 | Trapez vida Tr16×4 (DIN 103) + bronz blok somun | 1 | boy 807 (v5) + Ø12 alt uç 42 (tabandan geçer, kasnağı taşır) · kendinden kilitli (η≈0,35): güç kesilince yığın düşmez | katalog | SATIN ALMA
asansor_vidasi_alt_ucu | asansor vidasi alt ucu | 0 |  | aynı kalemin eşi — adet ilk örnekte | ALT
asansor_somunu | asansor somunu | 1 | 304 / S235 · lazer / torna | zarf 30.0 × 45.0 × 26.0 | ÜRETİM
asansor_alt_yatak | Flanşlı yatak KFL001 (Ø12) | 2 | vida uçları | katalog | SATIN ALMA
asansor_ust_yatak | asansor ust yatak | 0 |  | aynı kalemin eşi — adet ilk örnekte | ALT
asansor_kasnak_40 | Kasnak GT3 40 diş | 1 | PD 38.2 · 9 mm kayış | gates.com GT3 · katalog | SATIN ALMA
asansor_kasnak_20 | Kasnak GT3 20 diş | 1 | PD 19.1 · 9 mm kayış | gates.com GT3 · katalog | SATIN ALMA
asansor_kayisi | Kayış GT3 9 mm | 1 | kapalı çevrim | gates.com | SATIN ALMA
asansor_motor_plakasi | Motor askı plakası 3 mm | 1 | 304 lazer + 2 büküm · tabanın altına 4 × M5 · NEMA 23 flanşı 4 × M5 | v3: tahrik tabanın altında | ÜRETİM
asansor_motoru | Step motor AutomationDirect SureStep STP-MTR-23079 | 1 | NEMA 23 · 1,95 N·m (276 oz-in) · 2,8 A · gövde 75,5 + pilot Ø38,1 + mil Ø6,35 × 20,6 (STEP ölçüsü, v7) | automationdirect.com STP-MTR-23079 · TraceParts STEP | SATIN ALMA
asansor_kayis_koruyucu | Kayış koruyucu 1 mm | 1 | 304 büküm · tabanın altına 4 × M4 · kasnaklar ve kayış kapalı, motor alttan geçer | v3: sabit koruyucu | ÜRETİM
asansor_alt_sensor | Endüktif sensör Omron E2E-X2D1-N | 1 | M8 · 2 mm · DC 2 telli | omron.com E2E · katalog ölçüsü | SATIN ALMA
asansor_alt_sensor_braketi | Sensör braketi · delikli sac (Ø8, M8 endüktif) + L / Z kol | 1 | sensör deliğe 2 × M8 somunla (iki ucu açık) · taşıyıcıya ≥ 10 mm bindirme, 2 × M4 | v7b · üretim (v7 ilk: düz lam / teğet temas — denetim bulgusu 5) | ÜRETİM
besleyici_plakasi | Besleyici plakası 6082 · 5 mm | 1 | 621 × 461 | üretim | ÜRETİM
besleyici_plaka_askisi_0 | besleyici plaka askisi 0 | 1 | alüminyum 6082 · CNC | zarf 20.0 × 523.5 × 20.0 | ÜRETİM
besleyici_rayi_0 | Lineer ray HIWIN HGR15R | 2 | besleyici · boy 473 | hiwin.com | SATIN ALMA
besleyici_arabasi_0 | Lineer araba HIWIN HGH15CA | 1 | flanşsız · 34 × 61,4 · H 28 | TraceParts 90-03042020-037166 | SATIN ALMA
besleyici_plaka_askisi_1 | besleyici plaka askisi 1 | 1 | alüminyum 6082 · CNC | zarf 20.0 × 523.5 × 20.0 | ÜRETİM
besleyici_rayi_1 | Lineer ray HIWIN HGR15R | 0 |  | aynı kalemin eşi (adet ana satırda) | ALT
besleyici_arabasi_1 | Lineer araba HIWIN HGH15CA | 1 | flanşsız · 34 × 61,4 · H 28 | TraceParts 90-03042020-037166 | SATIN ALMA
itici_araba_plakasi_sol | itici araba plakasi sol | 1 | alüminyum 6082 · CNC | zarf 38.0 × 6.0 × 64.0 | ÜRETİM
itici_araba_plakasi_sag | itici araba plakasi sag | 1 | alüminyum 6082 · CNC | zarf 95.0 × 6.0 × 76.0 | ÜRETİM
itici_asma_plakasi_0 | itici asma plakasi 0 | 1 | alüminyum 6082 · CNC | zarf 40.0 × 289.8 × 8.0 | ÜRETİM
itici_asma_plakasi_1 | itici asma plakasi 1 | 1 | alüminyum 6082 · CNC | zarf 40.0 × 289.8 × 8.0 | ÜRETİM
itici_kirisi_40x20 | itici kirisi 40x20 | 1 | alüminyum 6082 · CNC | zarf 800.0 × 20.0 × 6.5 | ÜRETİM
itici_cubugu | İtici çubuk 304 · 800 × 6,5 × 6 | 1 | alt kenarı 982,2: yalnız EN ÜSTTEKİ blankı yakalar (981,6–983,2) | üretim | ÜRETİM
besleyici_kasnak_tahrik | Kasnak GT3 20 diş | 1 | PD 19.1 · 9 mm kayış | gates.com GT3 · katalog | SATIN ALMA
besleyici_kasnak_avara | Kasnak GT3 20 diş | 1 | PD 19.1 · 9 mm kayış | gates.com GT3 · katalog | SATIN ALMA
besleyici_kayisi | Kayış GT3 9 mm | 1 | kapalı çevrim | gates.com | SATIN ALMA
besleyici_avara_yatagi | besleyici avara yatagi | 1 | alüminyum 6082 · CNC | zarf 21.0 × 36.0 × 21.0 | ÜRETİM
besleyici_avara_mili | besleyici avara mili | 1 | 304 / S235 · lazer / torna | zarf 40.0 × 8.0 × 8.0 | ÜRETİM
itici_kayis_kulagi | itici kayis kulagi | 1 | 304 / S235 · lazer / torna | zarf 3.0 × 33.0 × 20.0 | ÜRETİM
itici_kayis_cenesi | itici kayis cenesi | 1 | 304 / S235 · lazer / torna | zarf 15.0 × 9.2 × 20.0 | ÜRETİM
besleyici_motoru | Step motor AutomationDirect SureStep STP-MTR-23079 | 1 | NEMA 23 · 1,95 N·m (276 oz-in) · 2,8 A · gövde 75,5 + pilot Ø38,1 + mil Ø6,35 × 20,6 (STEP ölçüsü, v7) | automationdirect.com STP-MTR-23079 · TraceParts STEP | SATIN ALMA
besleyici_motor_braketi | besleyici motor braketi | 1 | alüminyum 6082 · CNC | zarf 4.0 × 60.0 × 62.0 | ÜRETİM
besleyici_motor_rafi | besleyici motor rafi | 1 | alüminyum 6082 · CNC | zarf 90.5 × 6.0 × 62.0 | ÜRETİM
besleyici_arka_sensor | Endüktif sensör Omron E2E-X2D1-N | 1 | M8 · 2 mm · DC 2 telli | omron.com E2E · katalog ölçüsü | SATIN ALMA
besleyici_plaka_askisi_2 | besleyici plaka askisi 2 | 1 | alüminyum 6082 · CNC | zarf 20.0 × 523.5 × 20.0 | ÜRETİM
besleyici_plaka_askisi_3 | besleyici plaka askisi 3 | 1 | alüminyum 6082 · CNC | zarf 20.0 × 523.5 × 20.0 | ÜRETİM
besleyici_arka_sensor_braketi | Sensör braketi · delikli sac (Ø8, M8 endüktif) + L / Z kol | 1 | sensör deliğe 2 × M8 somunla (iki ucu açık) · taşıyıcıya ≥ 10 mm bindirme, 2 × M4 | v7b · üretim (v7 ilk: düz lam / teğet temas — denetim bulgusu 5) | ÜRETİM
kalip_tablasi_6 | kalip tablasi 6 | 1 | 304 sac · lazer + büküm | zarf 340.0 × 6.0 × 340.5 | ÜRETİM
kalip_ayagi_0 | Alüminyum profil 40 × 40 (kalıp ayağı) | 4 | boy 290 (v4: alt rafta biter) | item / Bosch Rexroth 40×40 | SATIN ALMA
kalip_ayagi_1 | kalip ayagi 1 | 0 |  | aynı kalemin eşi — adet ilk örnekte | ALT
kalip_ayagi_2 | kalip ayagi 2 | 0 |  | aynı kalemin eşi — adet ilk örnekte | ALT
kalip_ayagi_3 | kalip ayagi 3 | 0 |  | aynı kalemin eşi — adet ilk örnekte | ALT
kalip_alt_rafi | Alt raf 304 · 4 mm | 1 | 796 × 348 | v4: kalıp + kapak plakası ayakları üstünde · v5: altı 126–588, önde içecek yedeği 6 koli (x 3–805 · y 130–499 · z −350…−83) | ÜRETİM
kalip_alt_rafi_koseben_sol | Köşebent 30 × 30 × 3 AISI 304 (alt raf) | 4 | sol/sağ duvar + ön/arka kenar | M6 ile duvara | ÜRETİM
kalip_alt_rafi_koseben_sag | kalip alt rafi koseben sag | 1 | 304 sac · lazer + büküm | zarf 30.0 × 30.0 × 317.0 | ÜRETİM
kalip_alt_rafi_duvar_takozu_sag | Duvar takozu 304 kutu profil 28,5 × 30 × 2 | 1 | sağ köşebent ↔ sağ yan sac (v6: 28,5 mm havada) · kablo kanalının arkasında biter (z −55) | v7 · üretim | ÜRETİM
kalip_alt_rafi_koseben_on | kalip alt rafi koseben on | 1 | 304 sac · lazer + büküm | zarf 738.0 × 30.0 × 30.0 | ÜRETİM
kalip_alt_rafi_koseben_arka | kalip alt rafi koseben arka | 1 | 304 sac · lazer + büküm | zarf 738.0 × 30.0 × 30.0 | ÜRETİM
tepsi_cubugu_0 | tepsi cubugu 0 | 1 | 304 sac · lazer + büküm | zarf 55.0 × 8.0 × 320.0 | ÜRETİM
tepsi_ayagi_0 | tepsi ayagi 0 | 1 | 304 sac · lazer + büküm | zarf 16.0 × 10.0 × 16.0 | ÜRETİM
tepsi_cubugu_1 | tepsi cubugu 1 | 1 | 304 sac · lazer + büküm | zarf 60.0 × 8.0 × 320.0 | ÜRETİM
tepsi_ayagi_1 | tepsi ayagi 1 | 1 | 304 sac · lazer + büküm | zarf 16.0 × 10.0 × 16.0 | ÜRETİM
tepsi_cubugu_2 | tepsi cubugu 2 | 1 | 304 sac · lazer + büküm | zarf 60.0 × 8.0 × 320.0 | ÜRETİM
tepsi_ayagi_2 | tepsi ayagi 2 | 1 | 304 sac · lazer + büküm | zarf 16.0 × 10.0 × 16.0 | ÜRETİM
tepsi_cubugu_3 | tepsi cubugu 3 | 1 | 304 sac · lazer + büküm | zarf 55.0 × 8.0 × 320.0 | ÜRETİM
tepsi_ayagi_3 | tepsi ayagi 3 | 1 | 304 sac · lazer + büküm | zarf 16.0 × 10.0 × 16.0 | ÜRETİM
kalip_rayi_arka_z | Kalıp rayı 304 · 6 mm | 1 | arka yan duvarı kaldırır | üretim | ÜRETİM
kalip_taragi_on_z_0 | Kalıp tarağı 304 · 6 mm (4 diş) | 1 | ön yan duvarı tutar · dişleri arasından robot çatalı geçer | üretim | ÜRETİM
kalip_taragi_on_z_1 | kalip taragi on z 1 | 0 |  | aynı kalemin eşi — adet ilk örnekte | ALT
kalip_taragi_on_z_2 | kalip taragi on z 2 | 0 |  | aynı kalemin eşi — adet ilk örnekte | ALT
kalip_taragi_on_z_3 | kalip taragi on z 3 | 0 |  | aynı kalemin eşi — adet ilk örnekte | ALT
kalip_on_x_rayi | Kalıp ön rayı 304 · 4,5 mm | 1 | ön duvar 20 mm geç kalkar (köşe tırnakları önce döner) | üretim | ÜRETİM
kalip_arka_x_dayagi | kalip arka x dayagi | 1 | 304 sac · lazer + büküm | zarf 6.0 × 26.0 × 320.0 | ÜRETİM
kopru_plakasi | Köprü sacı 304 · 3 mm | 1 | pizza yolu · katlamada 30 mm aşağıda | üretim | ÜRETİM
kopru_tasiyici | kopru tasiyici | 1 | alüminyum 6082 · CNC | zarf 34.0 × 36.5 × 80.0 | ÜRETİM
kopru_kilavuz_mili_0 | Kılavuz mili Ø12 h6 + lineer burç LM12UU | 2 | köprü | katalog | SATIN ALMA
kopru_burcu_0 | kopru burcu 0 | 1 | 304 / S235 · lazer / torna | zarf 21.0 × 30.0 × 21.0 | ÜRETİM
kopru_kilavuz_mili_1 | kopru kilavuz mili 1 | 0 |  | aynı kalemin eşi — adet ilk örnekte | ALT
kopru_burcu_1 | kopru burcu 1 | 1 | 304 / S235 · lazer / torna | zarf 21.0 × 30.0 × 21.0 | ÜRETİM
kopru_burc_plakasi | kopru burc plakasi | 1 | alüminyum 6082 · CNC | zarf 54.0 × 6.0 × 280.0 | ÜRETİM
kopru_plaka_tutucu | kopru plaka tutucu | 1 | alüminyum 6082 · CNC | zarf 18.5 × 21.0 × 280.0 | ÜRETİM
kopru_vidasi_mil | Bilyalı vida TBI/HIWIN SFU1605 | 1 | Ø16 · hatve 5 · boy 112 · uçları BK12/BF12 işli | SFU1605 katalog (fluxelectronix / TBI) | SATIN ALMA
kopru_vidasi_somun | Bilyalı somun SFU1605-4 | 1 | flanş Ø48 · gövde Ø28 · boy 57 | katalog ölçüsü | SATIN ALMA
kopru_BK12 | Destek BK12 (sabit) | 1 | 60 × 43 × 32.5 · merkez yüksekliği 25 | MISUMI BK/BF · fonlinearguide.com | SATIN ALMA
kopru_kaplini | Kaplin tek diskli sıkma Ø25 × 26 (aday NBK MDS-25C-6.35-10) | 1 | delik 6,35 (motor) × 10 (vida muylusu) · motor mili göbeğe ≈ 10 dalar (göbek 11, olcum_v7 ölçer) | nbk1560.com MDS-25C (parça no mevcut) · boy / göbek VARSAYIM (föy açılamadı) | SATIN ALMA
kopru_motoru | Step motor AutomationDirect SureStep STP-MTR-23079 | 1 | NEMA 23 · 1,95 N·m (276 oz-in) · 2,8 A · gövde 75,5 + pilot Ø38,1 + mil Ø6,35 × 20,6 (STEP ölçüsü, v7) | automationdirect.com STP-MTR-23079 · TraceParts STEP | SATIN ALMA
kopru_motor_braketi | kopru motor braketi | 1 | alüminyum 6082 · CNC | zarf 60.0 × 6.0 × 60.0 | ÜRETİM
kopru_motor_askisi | kopru motor askisi | 1 | alüminyum 6082 · CNC | zarf 15.5 × 56.0 × 60.0 | ÜRETİM
kopru_alt_sensor | Endüktif sensör Omron E2E-X2D1-N | 1 | M8 · 2 mm · DC 2 telli | omron.com E2E · katalog ölçüsü | SATIN ALMA
kopru_alt_sensor_braketi | Sensör braketi · delikli sac (Ø8, M8 endüktif) + L / Z kol | 1 | sensör deliğe 2 × M8 somunla (iki ucu açık) · taşıyıcıya ≥ 10 mm bindirme, 2 × M4 | v7b · üretim (v7 ilk: düz lam / teğet temas — denetim bulgusu 5) | ÜRETİM
piston_kafasi | Piston kafası 6082 · 296 × 296 × 20 · ön alt kenar 6 mm pah | 1 | tabana basar, iç paneli kilitler, kapağı bastırır | üretim | ÜRETİM
piston_kaburgasi_0 | piston kaburgasi 0 | 1 | alüminyum 6082 · CNC | zarf 8.0 × 50.0 × 286.0 | ÜRETİM
piston_kaburgasi_1 | piston kaburgasi 1 | 1 | alüminyum 6082 · CNC | zarf 8.0 × 50.0 × 286.0 | ÜRETİM
piston_baglanti_plakasi | piston baglanti plakasi | 1 | alüminyum 6082 · CNC | zarf 200.0 × 515.0 × 10.0 | ÜRETİM
piston_eksen_plakasi | piston eksen plakasi | 1 | alüminyum 6082 · CNC | zarf 200.0 × 515.0 × 5.0 | ÜRETİM
piston_eksen_askisi | piston eksen askisi | 1 | alüminyum 6082 · CNC | zarf 200.0 × 13.5 × 14.0 | ÜRETİM
piston_rayi_0 | Lineer ray HIWIN HGR15R | 2 | piston · boy 515 | hiwin.com | SATIN ALMA
piston_arabasi_00 | Lineer araba HIWIN HGH15CA | 1 | flanşsız · 34 × 61,4 · H 28 | TraceParts 90-03042020-037166 | SATIN ALMA
piston_arabasi_01 | Lineer araba HIWIN HGH15CA | 1 | flanşsız · 34 × 61,4 · H 28 | TraceParts 90-03042020-037166 | SATIN ALMA
piston_rayi_1 | Lineer ray HIWIN HGR15R | 0 |  | aynı kalemin eşi (adet ana satırda) | ALT
piston_arabasi_10 | Lineer araba HIWIN HGH15CA | 1 | flanşsız · 34 × 61,4 · H 28 | TraceParts 90-03042020-037166 | SATIN ALMA
piston_arabasi_11 | Lineer araba HIWIN HGH15CA | 1 | flanşsız · 34 × 61,4 · H 28 | TraceParts 90-03042020-037166 | SATIN ALMA
piston_vidasi_mil | Bilyalı vida TBI/HIWIN SFU1610 | 1 | Ø16 · hatve 10 · boy 493 · uçları BK12/BF12 işli | SFU1610 katalog (fluxelectronix / TBI) | SATIN ALMA
piston_vidasi_somun | Bilyalı somun SFU1610-4 | 1 | flanş Ø48 · gövde Ø28 · boy 57 | katalog ölçüsü | SATIN ALMA
piston_somun_braketi | piston somun braketi | 1 | alüminyum 6082 · CNC | zarf 60.0 × 10.0 × 52.0 | ÜRETİM
piston_BK12 | Destek BK12 (sabit) | 1 | 60 × 43 × 32.5 · merkez yüksekliği 25 | MISUMI BK/BF · fonlinearguide.com | SATIN ALMA
piston_BK_askisi_0 | piston BK askisi 0 | 1 | alüminyum 6082 · CNC | zarf 60.0 × 38.0 × 6.0 | ÜRETİM
piston_BK_askisi_1 | piston BK askisi 1 | 1 | alüminyum 6082 · CNC | zarf 60.0 × 38.0 × 6.0 | ÜRETİM
piston_kasnak_vida | Kasnak GT3 20 diş | 1 | PD 19.1 · 9 mm kayış | gates.com GT3 · katalog | SATIN ALMA
piston_kasnak_motor | Kasnak GT3 20 diş | 1 | PD 19.1 · 9 mm kayış | gates.com GT3 · katalog | SATIN ALMA
piston_kayisi | Kayış GT3 9 mm | 1 | kapalı çevrim | gates.com | SATIN ALMA
piston_motoru | Step motor AutomationDirect SureStep STP-MTR-23079 | 1 | NEMA 23 · 1,95 N·m (276 oz-in) · 2,8 A · gövde 75,5 + pilot Ø38,1 + mil Ø6,35 × 20,6 (STEP ölçüsü, v7) | automationdirect.com STP-MTR-23079 · TraceParts STEP | SATIN ALMA
piston_motor_braketi | piston motor braketi | 1 | alüminyum 6082 · CNC | zarf 64.0 × 4.0 × 64.0 | ÜRETİM
piston_motor_askisi_0 | piston motor askisi 0 | 1 | alüminyum 6082 · CNC | zarf 8.0 × 34.5 × 14.0 | ÜRETİM
piston_motor_askisi_1 | piston motor askisi 1 | 1 | alüminyum 6082 · CNC | zarf 8.0 × 34.5 × 14.0 | ÜRETİM
piston_ust_sensor | Endüktif sensör Omron E2E-X2D1-N | 1 | M8 · 2 mm · DC 2 telli | omron.com E2E · katalog ölçüsü | SATIN ALMA
piston_ust_sensor_braketi | Sensör braketi · delikli sac (Ø8, M8 endüktif) + L / Z kol | 1 | sensör deliğe 2 × M8 somunla (iki ucu açık) · taşıyıcıya ≥ 10 mm bindirme, 2 × M4 | v7b · üretim (v7 ilk: düz lam / teğet temas — denetim bulgusu 5) | ÜRETİM
piston_eksen_plakasi_bagi_sol | Köşebent 6082 · L 3 mm (piston eksen plakası ↔ besleyici plakası) | 1 | 2 + 2 × M5 | v7b · üretim | ÜRETİM
piston_eksen_plakasi_bagi_sag | Köşebent 6082 · L 3 mm (piston eksen plakası ↔ besleyici plakası) | 1 | 2 + 2 × M5 | v7b · üretim | ÜRETİM
devirme_parmagi | Devirme parmağı 304 · 8 mm | 1 | R 72 · 140° döner | üretim | ÜRETİM
parmak_mili | parmak mili | 1 | 304 / S235 · lazer / torna | zarf 12.0 × 12.0 × 75.0 | ÜRETİM
parmak_yatagi_0 | Flanşlı yatak KFL001 (Ø12) | 2 | parmak mili | katalog | SATIN ALMA
parmak_yatagi_1 | parmak yatagi 1 | 0 |  | aynı kalemin eşi — adet ilk örnekte | ALT
parmak_yatak_askisi | parmak yatak askisi | 1 | alüminyum 6082 · CNC | zarf 32.0 × 224.0 × 50.0 | ÜRETİM
parmak_yatak_kolu_on | parmak yatak kolu on | 1 | alüminyum 6082 · CNC | zarf 32.0 × 10.0 × 16.0 | ÜRETİM
parmak_reduktoru | Planet redüktör SureGear PGCN23-1025 | 1 | 10:1 · 5 N·m · NEMA 23 | adcpn.com/pn/PGCN23-1025 · TraceParts STEP | SATIN ALMA
parmak_motoru | Step motor AutomationDirect SureStep STP-MTR-23079 | 1 | NEMA 23 · 1,95 N·m (276 oz-in) · 2,8 A · gövde 75,5 + pilot Ø38,1 + mil Ø6,35 × 20,6 (STEP ölçüsü, v7) | automationdirect.com STP-MTR-23079 · TraceParts STEP | SATIN ALMA
parmak_red_braketi | parmak red braketi | 1 | alüminyum 6082 · CNC | zarf 58.0 × 211.0 × 7.0 | ÜRETİM
parmak_sensor | Endüktif sensör Omron E2E-X2D1-N | 1 | M8 · 2 mm · DC 2 telli | omron.com E2E · katalog ölçüsü | SATIN ALMA
parmak_red_flans_plakasi | parmak red flans plakasi | 1 | alüminyum 6082 · CNC | zarf 58.0 × 74.0 × 4.0 | ÜRETİM
parmak_sensor_braketi | Sensör braketi · delikli sac (Ø8, M8 endüktif) + L / Z kol | 1 | sensör deliğe 2 × M8 somunla (iki ucu açık) · taşıyıcıya ≥ 10 mm bindirme, 2 × M4 | v7b · üretim (v7 ilk: düz lam / teğet temas — denetim bulgusu 5) | ÜRETİM
kapak_masasi_0 | Kapak masası levhası 304 · 3 mm | 2 | 264 × 143 · aralarında 26 mm kol yarığı (kol β 0…144°, iz x 471–726) · her levha kendi direğine | üretim | ÜRETİM
kapak_masasi_1 | kapak masasi 1 | 1 | 304 sac · lazer + büküm | zarf 264.0 × 3.0 × 143.0 | ÜRETİM
kapak_masasi_diregi_0 | kapak masasi diregi 0 | 1 | 304 / S235 · lazer / torna | zarf 16.0 × 145.0 × 16.0 | ÜRETİM
kapak_masasi_diregi_1 | kapak masasi diregi 1 | 1 | 304 / S235 · lazer / torna | zarf 16.0 × 145.0 × 16.0 | ÜRETİM
kapak_alt_plakasi | kapak alt plakasi | 1 | alüminyum 6082 · CNC | zarf 360.0 × 6.0 × 342.0 | ÜRETİM
kapak_alt_plaka_ayagi_0 | kapak alt plaka ayagi 0 | 1 | alüminyum 6082 · CNC | zarf 20.0 × 204.0 × 20.0 | ÜRETİM
kapak_alt_plaka_ayagi_1 | kapak alt plaka ayagi 1 | 1 | alüminyum 6082 · CNC | zarf 20.0 × 204.0 × 20.0 | ÜRETİM
kapak_alt_plaka_ayagi_2 | kapak alt plaka ayagi 2 | 1 | alüminyum 6082 · CNC | zarf 20.0 × 204.0 × 20.0 | ÜRETİM
kapak_alt_plaka_ayagi_3 | kapak alt plaka ayagi 3 | 1 | alüminyum 6082 · CNC | zarf 20.0 × 204.0 × 20.0 | ÜRETİM
flap_katlayici_U | Flap katlayıcı U çerçeve 304 · 3 mm | 1 | 37,6 mm kalkar: kapağın 3 flapını 90° kaldırır | üretim | ÜRETİM
flap_katlayici_alt_bagi | flap katlayici alt bagi | 1 | alüminyum 6082 · CNC | zarf 15.0 × 54.0 × 324.2 | ÜRETİM
flap_katlayici_somun_kolu | flap katlayici somun kolu | 1 | alüminyum 6082 · CNC | zarf 33.4 × 10.0 × 60.0 | ÜRETİM
flap_katlayici_vidasi_mil | Bilyalı vida TBI/HIWIN SFU1605 | 1 | Ø16 · hatve 5 · boy 200 · uçları BK12/BF12 işli | SFU1605 katalog (fluxelectronix / TBI) | SATIN ALMA
flap_katlayici_vidasi_somun | Bilyalı somun SFU1605-4 | 1 | flanş Ø48 · gövde Ø28 · boy 57 | katalog ölçüsü | SATIN ALMA
flap_katlayici_motoru | Step motor AutomationDirect SureStep STP-MTR-23079 | 1 | NEMA 23 · 1,95 N·m (276 oz-in) · 2,8 A · gövde 75,5 + pilot Ø38,1 + mil Ø6,35 × 20,6 (STEP ölçüsü, v7) | automationdirect.com STP-MTR-23079 · TraceParts STEP | SATIN ALMA
flap_katlayici_kaplini | Kaplin tek diskli sıkma Ø25 × 26 (aday NBK MDS-25C-6.35-10) | 1 | delik 6,35 (motor) × 10 (vida muylusu) · motor mili göbeğe ≈ 10 dalar (göbek 11, olcum_v7 ölçer) | nbk1560.com MDS-25C (parça no mevcut) · boy / göbek VARSAYIM (föy açılamadı) | SATIN ALMA
flap_katlayici_motor_braketi | flap katlayici motor braketi | 1 | alüminyum 6082 · CNC | zarf 60.0 × 6.0 × 60.0 | ÜRETİM
flap_katlayici_yatak_braketi | flap katlayici yatak braketi | 1 | alüminyum 6082 · CNC | zarf 60.0 × 8.0 × 60.0 | ÜRETİM
flap_katlayici_braket_ayagi | flap katlayici braket ayagi | 1 | alüminyum 6082 · CNC | zarf 10.0 × 140.5 × 60.0 | ÜRETİM
flap_katlayici_sensor | Endüktif sensör Omron E2E-X2D1-N | 1 | M8 · 2 mm · DC 2 telli | omron.com E2E · katalog ölçüsü | SATIN ALMA
flap_katlayici_sensor_braketi | Sensör braketi · delikli sac (Ø8, M8 endüktif) + L / Z kol | 1 | sensör deliğe 2 × M8 somunla (iki ucu açık) · taşıyıcıya ≥ 10 mm bindirme, 2 × M4 | v7b · üretim (v7 ilk: düz lam / teğet temas — denetim bulgusu 5) | ÜRETİM
kapak_kolu | Kapak kolu 304 + makara Ø20 (POM) | 1 | R 166 · kapağı 85° dik tutar, 100° yatırır | üretim | ÜRETİM
kapak_kolu_mili | kapak kolu mili | 1 | 304 / S235 · lazer / torna | zarf 12.0 × 12.0 × 82.0 | ÜRETİM
kol_yatagi_0 | Flanşlı yatak KFL001 (Ø12) | 2 | kol mili | katalog | SATIN ALMA
kol_yatak_ayagi_0 | kol yatak ayagi 0 | 1 | alüminyum 6082 · CNC | zarf 36.0 × 62.0 × 10.0 | ÜRETİM
kol_yatagi_1 | kol yatagi 1 | 0 |  | aynı kalemin eşi — adet ilk örnekte | ALT
kol_yatak_ayagi_1 | kol yatak ayagi 1 | 1 | alüminyum 6082 · CNC | zarf 36.0 × 62.0 × 10.0 | ÜRETİM
kol_reduktoru | Planet redüktör SureGear PGCN23-1025 | 1 | 10:1 · 5 N·m · NEMA 23 | adcpn.com/pn/PGCN23-1025 · TraceParts STEP | SATIN ALMA
kol_motoru | Step motor AutomationDirect SureStep STP-MTR-23079 | 1 | NEMA 23 · 1,95 N·m (276 oz-in) · 2,8 A · gövde 75,5 + pilot Ø38,1 + mil Ø6,35 × 20,6 (STEP ölçüsü, v7) | automationdirect.com STP-MTR-23079 · TraceParts STEP | SATIN ALMA
kol_reduktor_braketi | kol reduktor braketi | 1 | alüminyum 6082 · CNC | zarf 60.0 × 51.0 × 10.0 | ÜRETİM
kol_red_flans_plakasi | kol red flans plakasi | 1 | alüminyum 6082 · CNC | zarf 60.0 × 72.0 × 4.0 | ÜRETİM
kol_sensor | Endüktif sensör Omron E2E-X2D1-N | 1 | M8 · 2 mm · DC 2 telli | omron.com E2E · katalog ölçüsü | SATIN ALMA
kol_sensor_braketi | Sensör braketi · delikli sac (Ø8, M8 endüktif) + L / Z kol | 1 | sensör deliğe 2 × M8 somunla (iki ucu açık) · taşıyıcıya ≥ 10 mm bindirme, 2 × M4 | v7b · üretim (v7 ilk: düz lam / teğet temas — denetim bulgusu 5) | ÜRETİM
pano_plakasi | pano plakasi | 1 | 304 sac · lazer + büküm | zarf 720.0 × 460.0 × 4.0 | ÜRETİM
pano_plakasi_burcu_0 | Mesafe burcu M5 · Ø12 × 2,5 paslanmaz | 1 | pano plakası ↔ arka sac | katalog | SATIN ALMA
pano_plakasi_burcu_1 | Mesafe burcu M5 · Ø12 × 2,5 paslanmaz | 1 | pano plakası ↔ arka sac | katalog | SATIN ALMA
pano_plakasi_burcu_2 | Mesafe burcu M5 · Ø12 × 2,5 paslanmaz | 1 | pano plakası ↔ arka sac | katalog | SATIN ALMA
pano_plakasi_burcu_3 | Mesafe burcu M5 · Ø12 × 2,5 paslanmaz | 1 | pano plakası ↔ arka sac | katalog | SATIN ALMA
din_rayi_0 | DIN ray 35 × 7,5 | 2 | boy 700 | EN 60715 | SATIN ALMA
din_rayi_1 | din rayi 1 | 0 |  | aynı kalemin eşi — adet ilk örnekte | ALT
plc_S7-1200_1214C | PLC Siemens S7-1200 CPU 1214C DC/DC/DC | 1 | 6ES7214-1AG40-0XB0 · 4 PTO ekseni (7 sürücü enable ile paylaşır; aynı anda en çok 3 eksen döner) | 110 × 100 × 75 | SATIN ALMA
plc_SM1221_DI16 | Siemens SM1221 DI16 | 1 | 6ES7221-1BH32-0XB0 | 45 × 100 × 75 | SATIN ALMA
plc_SM1222_DQ16 | Siemens SM1222 DQ16 | 1 | 6ES7222-1BH32-0XB0 · yön + enable | 45 × 100 × 75 | SATIN ALMA
guc_24V_NDR-240-24 | Güç kaynağı Mean Well NDR-240-24 | 1 | 24 V 10 A · PLC + sensör | TraceParts STEP | SATIN ALMA
guc_48V_NDR-240-48_a | Güç kaynağı Mean Well NDR-240-48 | 2 | 48 V 5 A · step sürücüler | NDR-240 gövdesi (STEP 24 V ile aynı) | SATIN ALMA
guc_48V_NDR-240-48_b | guc 48V NDR-240-48 b | 0 |  | aynı kalemin eşi — adet ilk örnekte | ALT
surucu_STP-DRV-4830_0 | Step sürücü AutomationDirect SureStep STP-DRV-4830 | 7 | 3 A/faz · 12–48 VDC · adım/yön | automationdirect.com · TraceParts STEP | SATIN ALMA
surucu_STP-DRV-4830_1 | surucu STP-DRV-4830 1 | 0 |  | aynı kalemin eşi — adet ilk örnekte | ALT
surucu_STP-DRV-4830_2 | surucu STP-DRV-4830 2 | 0 |  | aynı kalemin eşi — adet ilk örnekte | ALT
surucu_STP-DRV-4830_3 | surucu STP-DRV-4830 3 | 0 |  | aynı kalemin eşi — adet ilk örnekte | ALT
surucu_STP-DRV-4830_4 | surucu STP-DRV-4830 4 | 0 |  | aynı kalemin eşi — adet ilk örnekte | ALT
surucu_STP-DRV-4830_5 | surucu STP-DRV-4830 5 | 0 |  | aynı kalemin eşi — adet ilk örnekte | ALT
surucu_STP-DRV-4830_6 | surucu STP-DRV-4830 6 | 0 |  | aynı kalemin eşi — adet ilk örnekte | ALT
klemens_sirasi | Klemens sırası Phoenix UT 2,5 | 40 |  | phoenixcontact.com | SATIN ALMA
kablo_kanali_0 | Kablo kanalı 40 × 25 | 2 | pano | katalog | SATIN ALMA
kablo_kanali_1 | kablo kanali 1 | 0 |  | aynı kalemin eşi — adet ilk örnekte | ALT
kablo_kanali_dikey_alt | Kablo kanalı 20 × 25 (dikey) | 2 | sağ ön köşe · x 806–826 | katalog ölçüsü VARSAYIM | SATIN ALMA
kablo_kanali_dikey_ust | kablo kanali dikey ust | 0 |  | aynı kalemin eşi — adet ilk örnekte | ALT
sensor_yigin_ustu | Fotosel Omron E3Z-D62 | 1 | dağınık yansımalı · 1 m · PNP | omron.com E3Z · katalog ölçüsü | SATIN ALMA
sensor_blank_var | Fotosel Omron E3Z-D62 | 1 | dağınık yansımalı · 1 m · PNP | omron.com E3Z · katalog ölçüsü | SATIN ALMA
sensor_kutu_dolu | Fotosel Omron E3Z-D62 | 1 | dağınık yansımalı · 1 m · PNP | omron.com E3Z · katalog ölçüsü | SATIN ALMA
sensor_yigin_ustu_braketi | Fotosel braketi Al · L 3 mm | 1 | Omron E3Z 2 × M3 ile · yan saca 27 × 20 kol, 2 × M4 | v7b · üretim (v7 ilk: 3 mm kenarla yan saca — denetim bulgusu 5) | ÜRETİM
sensor_blank_var_braketi | Fotosel braketi Al · L 3 mm | 1 | Omron E3Z 2 × M3 ile · yan saca 27 × 20 kol, 2 × M4 | v7b · üretim (v7 ilk: 3 mm kenarla yan saca — denetim bulgusu 5) | ÜRETİM
sensor_kutu_dolu_braketi | Fotosel braketi Al · L 3 mm | 1 | Omron E3Z 2 × M3 ile · yan saca 27 × 20 kol, 2 × M4 | v7b · üretim (v7 ilk: 3 mm kenarla yan saca — denetim bulgusu 5) | ÜRETİM
icecek_yedek_altligi | Koli altlığı PE-HD 4 mm (içecek yedeği) | 1 | 802 × 267 | VARSAYIM · levha kesim | ÜRETİM
icecek_yedek_koli_00 | İçecek kolisi 24 kutu (yedek, soğutmasız) | 6 | 400 × 267 × 123 · 144 kutu | sarf · koli ölçüsü VARSAYIM (resim) | SATIN ALMA
icecek_yedek_koli_01 | icecek yedek koli 01 | 0 |  | aynı kalemin eşi — adet ilk örnekte | ALT
icecek_yedek_koli_02 | icecek yedek koli 02 | 0 |  | aynı kalemin eşi — adet ilk örnekte | ALT
icecek_yedek_koli_10 | icecek yedek koli 10 | 0 |  | aynı kalemin eşi — adet ilk örnekte | ALT
icecek_yedek_koli_11 | icecek yedek koli 11 | 0 |  | aynı kalemin eşi — adet ilk örnekte | ALT
icecek_yedek_koli_12 | icecek yedek koli 12 | 0 |  | aynı kalemin eşi — adet ilk örnekte | ALT
