kursatkemalkul/autokitch/arastirma/1_STORE_v12/BOM.csv

parça (model adı) | kalem | adet | tanım / ürün | not / ölçü | birim | tür
tasiyici_kiris_on | Taşıyıcı kiriş 40 × 40 × 2 | 2 | AISI 304 kare profil · ısı kalkanının içinde, dış tavan sacının hemen altında | 1494 boy · fırın 2500–4000'in altı · sağ uçta 208 konsol | B_TASIYICI | ÜRETİM
tasiyici_kiris_arka | tasiyici kiris arka | 0 | 304 · lazer / lama | alt gövde → Taşıyıcı kiriş 40 × 40 × 2 | B_TASIYICI | ALT
tasiyici_capraz_0 | Taşıyıcı çapraz 30 × 40 × 2 | 3 | AISI 304 dikdörtgen profil · kirişlere kaynaklı | 470 boy · B4 / B5 / B6 bölme hizasında | B_TASIYICI | ÜRETİM
tasiyici_capraz_1 | tasiyici capraz | 0 | 304 · lazer / lama | alt gövde → Taşıyıcı çapraz 30 × 40 × 2 | B_TASIYICI | ALT
tasiyici_capraz_2 | tasiyici capraz | 0 | 304 · lazer / lama | alt gövde → Taşıyıcı çapraz 30 × 40 × 2 | B_TASIYICI | ALT
tasiyici_dikme_0 | Taşıyıcı dikme 30 × 30 × 2 | 6 | AISI 304 kare profil · bölmenin PU'su içinde · alt ucunda M12 kaynak somunu → ayak | 622 boy · dış taban sacına oturur | B_TASIYICI | ÜRETİM
tasiyici_dikme_1 | tasiyici dikme | 0 | 304 · lazer / lama | alt gövde → Taşıyıcı dikme 30 × 30 × 2 | B_TASIYICI | ALT
tasiyici_dikme_2 | tasiyici dikme | 0 | 304 · lazer / lama | alt gövde → Taşıyıcı dikme 30 × 30 × 2 | B_TASIYICI | ALT
tasiyici_dikme_3 | tasiyici dikme | 0 | 304 · lazer / lama | alt gövde → Taşıyıcı dikme 30 × 30 × 2 | B_TASIYICI | ALT
tasiyici_dikme_4 | tasiyici dikme | 0 | 304 · lazer / lama | alt gövde → Taşıyıcı dikme 30 × 30 × 2 | B_TASIYICI | ALT
tasiyici_dikme_5 | tasiyici dikme | 0 | 304 · lazer / lama | alt gövde → Taşıyıcı dikme 30 × 30 × 2 | B_TASIYICI | ALT
onyuz_plint | Plint 1,5 (ön) | 1 | 304 fırçalı 1,5 · z +17,5…+19 (ön düzlemin 60 gerisi) · x 30–3970 · üst flanş 25: taban dış sacına M5 perçin somun @ 300 · K4 önünde emiş ızgarası 42 yarık 120 × 10 (köprü 5 / 8) 504 cm² | dolabın altında ayak + plint dışında parça yok | B_KASA | ÜRETİM
onyuz_plint_donus_sol | Plint yan dönüşü 1,5 | 2 | 304 · x 30 ve 3970 · plintten arka dış sac hizasına · üst flanş 20: taban dış sacına M5 perçin somun | 846 boy | B_KASA | ÜRETİM
onyuz_plint_donus_sag | onyuz plint donus | 0 | 304 sac · lazer + büküm | alt gövde → Plint yan dönüşü (× 2) | B_KASA | ALT
ayak_0 | Ayarlı ayak Elesa+Ganter LV.A-SST · M12 | 14 | paslanmaz AISI 304 · taban Ø40 · yükseklik 123 | elesa-ganter.com LV.A-SST · 123'e uygun diş boyu + taşıma yükü katalogdan seçilecek · fırın altında dikmelerin altında | B_KASA | SATIN ALMA
ayak_1 | ayak | 0 | 304 · lazer / lama | alt gövde → Elesa LV.A-SST | B_KASA | ALT
ayak_2 | ayak | 0 | 304 · lazer / lama | alt gövde → Elesa LV.A-SST | B_KASA | ALT
ayak_3 | ayak | 0 | 304 · lazer / lama | alt gövde → Elesa LV.A-SST | B_KASA | ALT
ayak_4 | ayak | 0 | 304 · lazer / lama | alt gövde → Elesa LV.A-SST | B_KASA | ALT
ayak_5 | ayak | 0 | 304 · lazer / lama | alt gövde → Elesa LV.A-SST | B_KASA | ALT
ayak_6 | ayak | 0 | 304 · lazer / lama | alt gövde → Elesa LV.A-SST | B_KASA | ALT
ayak_7 | ayak | 0 | 304 · lazer / lama | alt gövde → Elesa LV.A-SST | B_KASA | ALT
ayak_8 | ayak | 0 | 304 · lazer / lama | alt gövde → Elesa LV.A-SST | B_KASA | ALT
ayak_9 | ayak | 0 | 304 · lazer / lama | alt gövde → Elesa LV.A-SST | B_KASA | ALT
ayak_10 | ayak | 0 | 304 · lazer / lama | alt gövde → Elesa LV.A-SST | B_KASA | ALT
ayak_11 | ayak | 0 | 304 · lazer / lama | alt gövde → Elesa LV.A-SST | B_KASA | ALT
ayak_12 | ayak | 0 | 304 · lazer / lama | alt gövde → Elesa LV.A-SST | B_KASA | ALT
ayak_13 | ayak | 0 | 304 · lazer / lama | alt gövde → Elesa LV.A-SST | B_KASA | ALT
kasa_yan_dis_sac_sol | Yan dış sac 1,5 | 2 | 304 lazer + büküm · ön kenar kapak arkasında (z +39) · v8: iki yan simetrik (şerit dönüşü 40) |  | B_KASA | ÜRETİM
kasa_yan_dis_sac_sag | kasa yan dis sac | 0 | 304 sac · lazer + büküm | alt gövde → Yan dış sac 1,5 (× 2) | B_KASA | ALT
tavan_dis_sac | Tavan dış sacı | 1 | 304 1,5 · A, C ve fırın bunun üstüne oturur (fırın altında taşıyıcı çerçeve) · v8: ön kenar +39 (kaide ön profili ve fırın tam basar) |  | B_KASA | ÜRETİM
taban_dis_sac | Taban dış sacı 1,5 | 1 | 304 · v8: ön kenar +39 · K4 altında 9 emiş penceresi 668 cm² (aralarında ≥ 20 köprü · paslanmaz tel elek [VARSAYIM]) + pano girişi 4 × 80 × 12 | plint boşluğundan Secop'a ve panoya hava · Secop yükünü montaj rayları taşır, taban sacı taşımaz | B_KASA | ÜRETİM
arka_dis_sac | arka dis sac | 1 | 304 sac · lazer + büküm | zarf 3997.0 × 662.0 × 1.5 | B_KASA | ÜRETİM
yan_ic_sac_sol | yan ic sac | 1 | 304 sac · lazer + büküm | zarf 1.0 × 563.5 × 813.0 | B_KASA | ÜRETİM
kasa_yan_on_donus_sol | kasa yan on donus | 1 | 304 sac · lazer + büküm | zarf 28.5 × 662.0 × 1.5 | B_KASA | ÜRETİM
tavan_ic_sac | tavan ic sac | 1 | 304 sac · lazer + büküm | zarf 2472.5 × 1.0 × 827.5 | B_KASA | ÜRETİM
tavan_ic_sac_F | tavan ic sac F | 1 | 304 sac · lazer + büküm | zarf 1240.0 × 1.0 × 827.5 | B_KASA | ÜRETİM
tavan_on_donus | tavan on donus | 1 | 304 sac · lazer + büküm | zarf 3779.0 × 118.5 × 1.5 | B_KASA | ÜRETİM
taban_ic_sac | taban ic sac | 1 | 304 sac · lazer + büküm | zarf 1965.0 × 1.0 × 827.5 | B_KASA | ÜRETİM
taban_k4_kademe_saci | Taban kademe sacı 1,0 | 1 | 304 · yalıtımlı tabanın K4 tarafındaki ucunu kapatır | K4 sıcak bölmesi 40 mm alçak | B_KASA | ÜRETİM
taban_ic_sac_F | taban ic sac F | 1 | 304 sac · lazer + büküm | zarf 1240.0 × 1.0 × 827.5 | B_KASA | ÜRETİM
taban_on_donus | taban on donus | 1 | 304 sac · lazer + büküm | zarf 1997.5 × 40.0 × 1.5 | B_KASA | ÜRETİM
taban_on_donus_2 | taban on donus | 1 | 304 sac · lazer + büküm | zarf 1309.0 × 40.0 × 1.5 | B_KASA | ÜRETİM
arka_ic_sac | arka ic sac | 1 | 304 sac · lazer + büküm | zarf 2473.5 × 563.5 × 1.0 | B_KASA | ÜRETİM
arka_ic_sac_k4_alt | arka ic sac k4 alt | 1 | 304 sac · lazer + büküm | zarf 507.5 × 40.0 × 1.0 | B_KASA | ÜRETİM
arka_ic_sac_F | arka ic sac F | 1 | 304 sac · lazer + büküm | zarf 1240.0 × 503.5 × 1.0 | B_KASA | ÜRETİM
bolme_0_sac_a | bolme 0 sac | 1 | 304 sac · lazer + büküm | zarf 1.0 × 563.5 × 813.0 | B_KASA | ÜRETİM
bolme_0_sac_b | bolme 0 sac | 1 | 304 sac · lazer + büküm | zarf 1.0 × 563.5 × 813.0 | B_KASA | ÜRETİM
bolme_1_sac_a | bolme 1 sac | 1 | 304 sac · lazer + büküm | zarf 1.0 × 563.5 × 813.0 | B_KASA | ÜRETİM
bolme_1_sac_b | bolme 1 sac | 1 | 304 sac · lazer + büküm | zarf 1.0 × 563.5 × 813.0 | B_KASA | ÜRETİM
bolme_2_sac_a | bolme 2 sac | 1 | 304 sac · lazer + büküm | zarf 1.0 × 563.5 × 813.0 | B_KASA | ÜRETİM
bolme_2_sac_b | bolme 2 sac | 1 | 304 sac · lazer + büküm | zarf 1.0 × 563.5 × 813.0 | B_KASA | ÜRETİM
bolme_3_sac_a | bolme 3 sac | 1 | 304 sac · lazer + büküm | zarf 1.0 × 603.5 × 813.0 | B_KASA | ÜRETİM
bolme_3_sac_b | bolme 3 sac | 1 | 304 sac · lazer + büküm | zarf 1.0 × 564.5 × 813.0 | B_KASA | ÜRETİM
bolme_4_sac_a | bolme 4 sac | 1 | 304 sac · lazer + büküm | zarf 1.0 × 503.5 × 813.0 | B_KASA | ÜRETİM
bolme_4_sac_b | bolme 4 sac | 1 | 304 sac · lazer + büküm | zarf 1.0 × 503.5 × 813.0 | B_KASA | ÜRETİM
bolme_5_sac_a | bolme 5 sac | 1 | 304 sac · lazer + büküm | zarf 1.0 × 564.5 × 814.0 | B_KASA | ÜRETİM
bolme_5_sac_b | Ara duvar sacı 1,0 (soğuk ↔ şerit) | 1 | 304 · x 3809–3810 · taşıyıcı kiriş geçiş oyuklu | şerit tarafı · arkasında PU 33 | B_KASA | ÜRETİM
isi_kalkani_ayirma_saci | Isı kalkanı ayırma sacı 1,0 | 1 | 304 · K5/K6 tavan PU'sunun üstü, hava boşluğunun tabanı | x 2534–3776 · y 728–729 | B_KASA | ÜRETİM
isi_kalkani_sol_sac | Isı kalkanı yan sacı 1,0 | 2 | 304 · hava boşluğunu yanlardan kapatır | kiriş geçiş oyuklu | B_KASA | ÜRETİM
isi_kalkani_sag_sac | isi kalkani sag sac | 0 | 304 sac · lazer + büküm | alt gövde → Isı kalkanı yan sacı (× 2) | B_KASA | ALT
isi_kalkani_isinim_saci | Işınım sacı 0,8 · parlak paslanmaz | 1 | 304 BA (ε ≈ 0,1 VARSAYIM) · takozlar üstünde · dikme geçiş delikli | fırın tabanının ışınımını geri yansıtır · üstünde 46 mm havalandırmalı boşluk (rapor seçenek b) | B_KASA | ÜRETİM
isi_kalkani_takozu_0 | Isı köprüsü kesici takoz 20 × 20 × 11 | 12 | cam elyaf / PTFE [VARSAYIM] | ayırma sacı ↔ ışınım sacı | B_KASA | ÜRETİM
isi_kalkani_takozu_1 | isi kalkani takozu | 0 |  | alt gövde → Isı köprüsü kesici takoz | B_KASA | ALT
isi_kalkani_takozu_2 | isi kalkani takozu | 0 |  | alt gövde → Isı köprüsü kesici takoz | B_KASA | ALT
isi_kalkani_takozu_3 | isi kalkani takozu | 0 |  | alt gövde → Isı köprüsü kesici takoz | B_KASA | ALT
isi_kalkani_takozu_4 | isi kalkani takozu | 0 |  | alt gövde → Isı köprüsü kesici takoz | B_KASA | ALT
isi_kalkani_takozu_5 | isi kalkani takozu | 0 |  | alt gövde → Isı köprüsü kesici takoz | B_KASA | ALT
isi_kalkani_takozu_6 | isi kalkani takozu | 0 |  | alt gövde → Isı köprüsü kesici takoz | B_KASA | ALT
isi_kalkani_takozu_7 | isi kalkani takozu | 0 |  | alt gövde → Isı köprüsü kesici takoz | B_KASA | ALT
isi_kalkani_takozu_8 | isi kalkani takozu | 0 |  | alt gövde → Isı köprüsü kesici takoz | B_KASA | ALT
isi_kalkani_takozu_9 | isi kalkani takozu | 0 |  | alt gövde → Isı köprüsü kesici takoz | B_KASA | ALT
isi_kalkani_takozu_10 | isi kalkani takozu | 0 |  | alt gövde → Isı köprüsü kesici takoz | B_KASA | ALT
isi_kalkani_takozu_11 | isi kalkani takozu | 0 |  | alt gövde → Isı köprüsü kesici takoz | B_KASA | ALT
yan_pu_sol | yan pu | 0 | PU köpük (gövdeyle birlikte enjeksiyon) | alt gövde → PU köpük gövde | B_KASA | ALT
yan_pu_sol_on | yan pu sol on | 0 | PU köpük (gövdeyle birlikte enjeksiyon) | alt gövde → PU köpük gövde | B_KASA | ALT
tavan_pu_57.5 | PU köpük gövde | 1 | 40 kg/m³ enjeksiyon · sac kabuk içine | yan 60 (v7) · tavan 57,5 (fırın altı 59 + hava boşluğu) · arka 37,5 · taban 39 · bölme 33 | B_KASA | ÜRETİM
bolme_5_pu_ust | bolme 5 pu ust | 0 | PU köpük (gövdeyle birlikte enjeksiyon) | alt gövde → PU köpük gövde | B_KASA | ALT
tavan_pu_F | tavan pu F | 0 | PU köpük (gövdeyle birlikte enjeksiyon) | alt gövde → PU köpük gövde | B_KASA | ALT
taban_pu | taban pu | 0 | PU köpük (gövdeyle birlikte enjeksiyon) | alt gövde → PU köpük gövde | B_KASA | ALT
taban_pu_F | taban pu F | 0 | PU köpük (gövdeyle birlikte enjeksiyon) | alt gövde → PU köpük gövde | B_KASA | ALT
arka_pu_37.5 | arka pu 37.5 | 0 | PU köpük (gövdeyle birlikte enjeksiyon) | alt gövde → PU köpük gövde | B_KASA | ALT
arka_pu_F | arka pu F | 0 | PU köpük (gövdeyle birlikte enjeksiyon) | alt gövde → PU köpük gövde | B_KASA | ALT
bolme_0_pu | bolme 0 pu | 0 | PU köpük (gövdeyle birlikte enjeksiyon) | alt gövde → PU köpük gövde | B_KASA | ALT
bolme_1_pu | bolme 1 pu | 0 | PU köpük (gövdeyle birlikte enjeksiyon) | alt gövde → PU köpük gövde | B_KASA | ALT
bolme_2_pu | bolme 2 pu | 0 | PU köpük (gövdeyle birlikte enjeksiyon) | alt gövde → PU köpük gövde | B_KASA | ALT
bolme_3_pu | bolme 3 pu | 0 | PU köpük (gövdeyle birlikte enjeksiyon) | alt gövde → PU köpük gövde | B_KASA | ALT
bolme_4_pu | bolme 4 pu | 0 | PU köpük (gövdeyle birlikte enjeksiyon) | alt gövde → PU köpük gövde | B_KASA | ALT
bolme_5_pu | bolme 5 pu | 0 | PU köpük (gövdeyle birlikte enjeksiyon) | alt gövde → PU köpük gövde | B_KASA | ALT
kablo_kanali_K1 | Kablo kanalı 40 × 25 | 8 | PVC perfore + kapak | dikey her kolonda (K1–K6) + üstte yatay 2 | B_KABLO | SATIN ALMA
kablo_kanali_K2 | kablo kanali K2 | 0 | PVC | alt gövde → kablo kanalı | B_KABLO | ALT
kablo_kanali_K3 | kablo kanali K3 | 0 | PVC | alt gövde → kablo kanalı | B_KABLO | ALT
kablo_kanali_K5 | kablo kanali K5 | 0 | PVC | alt gövde → kablo kanalı | B_KABLO | ALT
kablo_kanali_K6 | kablo kanali K6 | 0 | PVC | alt gövde → kablo kanalı | B_KABLO | ALT
kablo_kanali_K4 | kablo kanali K4 | 0 | PVC | alt gövde → kablo kanalı | B_KABLO | ALT
kablo_kanali_ust | kablo kanali ust | 0 | PVC | alt gövde → kablo kanalı | B_KABLO | ALT
kablo_kanali_ust_F | kablo kanali ust F | 0 | PVC | alt gövde → kablo kanalı | B_KABLO | ALT
evaporator_sol_lamel | Evaporatör lamelli · epoksi kaplı Cu/Al | 2 | bakır boru + alüminyum lamel, epoksi kaplı · 4 sıra · lamel aralığı 4,2 [VARSAYIM] | 336 × 400 × 85 (sol, K2 arkası) · 336 × 265 × 85 (sağ, K5 arkası) · iki bölge UA ≈ 60 W/K (sogutma_hesabi_v1) · ölçüye üretim | B_SOGUTMA | ÜRETİM
evaporator_sol_yan_sac_a | evaporator sol yan sac | 0 | 304 sac · lazer + büküm | alt gövde → Evaporatör lamelli | B_SOGUTMA | ALT
evaporator_sol_yan_sac_b | evaporator sol yan sac | 0 | 304 sac · lazer + büküm | alt gövde → Evaporatör lamelli | B_SOGUTMA | ALT
evaporator_sol_dirsek_a | evaporator sol dirsek | 0 |  | alt gövde → Evaporatör lamelli | B_SOGUTMA | ALT
evaporator_sol_dirsek_b | evaporator sol dirsek | 0 |  | alt gövde → Evaporatör lamelli | B_SOGUTMA | ALT
evaporator_sol_askisi_1 | Evaporatör askısı 2 mm | 4 | 304 lama · arka iç saca 2 × M5 perçin somun | lamel bloğu üstten asılı | B_SOGUTMA | ÜRETİM
evaporator_sol_askisi_2 | evaporator sol askisi | 0 | 304 · lazer / lama | alt gövde → Evaporatör askısı | B_SOGUTMA | ALT
damlama_teknesi_sol | Damlama teknesi 1,5 | 2 | 304 büküm · gider ağzına eğimli | evaporatörün altında · Ø12 gider | B_SOGUTMA | ÜRETİM
damlama_teknesi_sol_braketi_1 | Damlama teknesi braketi 1,5 · L | 4 | 304 büküm · arka iç saca 2 × M5 perçin somun · tekne üstüne oturur |  | B_SOGUTMA | ÜRETİM
damlama_teknesi_sol_braketi_2 | damlama teknesi sol braketi | 0 | 304 · lazer / lama | alt gövde → Damlama teknesi braketi | B_SOGUTMA | ALT
fan_sol_1 | Fan ebm-papst 4414 FL | 4 | 24 V · 1,2 W · 94 m³/h · 26 dB(A) · 119 × 119 × 25 | bölge başına 2 · davlumbazın önünde (v6: 7 × 4414 FNH 12 W = 84 W ısı → kalktı) | B_SOGUTMA | SATIN ALMA
fan_sol_2 | fan sol | 0 |  | alt gövde → ebm-papst 4414 FL | B_SOGUTMA | ALT
fan_davlumbazi_sol | Fan davlumbazı 1,0 | 2 | 304 büküm · 2 fan deliği 113 × 113 | lamel yüzüne 26 mm (rapor ≥ 25) | B_SOGUTMA | ÜRETİM
gider_borusu_sol | Gider borusu Ø12 × 1 | 2 | PVC · v8b: tekne dibinden SÜREKLİ EĞİMLE (her koşu ≥ %1, sifon YOK — durgun su kalmaz): soğuk bölmenin arkasından (z −690) en alt kayışın altından, bölmeyi kılıfla geçer, K4 emiş şeridinde öne gelir, tavanın üstünde ördek gagası | bölme geçişleri Ø16 kılıf içinde (boru çekilip değiştirilir) · dolabın altına hiçbir boru sarkmaz | B_SOGUTMA | ÜRETİM
gider_kilifi_sol_B2 | Gider kılıfı Ø16 × 2 PVC | 3 | bölme PU'su içinde köpükle birlikte · içinden Ø12 boru kayar | B2 · B3 · B4 geçişleri | B_SOGUTMA | ÜRETİM
gider_kilifi_sol_B3 | gider kilifi sol B3 | 0 |  | alt gövde → Gider kılıfı | B_SOGUTMA | ALT
gider_kelepcesi_sol_0 | Boru kelepçesi Ø12 + konsol | 5 | PA kelepçe + 304 konsol · taban iç sacına / bölme sacına perçin | K3 arkasında 1 eyer · K4 şeritlerinde 4 konsol | B_SOGUTMA | ÜRETİM
gider_kelepcesi_sol_1 | gider kelepcesi sol | 0 |  | alt gövde → Boru kelepçesi | B_SOGUTMA | ALT
gider_kelepcesi_sol_2 | gider kelepcesi sol | 0 |  | alt gövde → Boru kelepçesi | B_SOGUTMA | ALT
gider_cek_valfi_sol | Ördek gagası çek valf Minivalve DU 120.001 | 2 | silikon · flanşlı · boru ucunda tutucu kapakla [ölçü VARSAYIM: zarf Ø14 × 10 — minivalve.com katalog föyünden teyit] | v8b: KURU KAPAN (buzdolabı gideri gibi): tava buharlaştırdıkça kurur, su kapanı güvenilmez → sıcak hava / koku geri gelmez | B_SOGUTMA | SATIN ALMA
evaporator_sag_lamel | evaporator sag lamel | 0 | alüminyum | alt gövde → Evaporatör lamelli | B_SOGUTMA | ALT
evaporator_sag_yan_sac_a | evaporator sag yan sac | 0 | 304 sac · lazer + büküm | alt gövde → Evaporatör lamelli | B_SOGUTMA | ALT
evaporator_sag_yan_sac_b | evaporator sag yan sac | 0 | 304 sac · lazer + büküm | alt gövde → Evaporatör lamelli | B_SOGUTMA | ALT
evaporator_sag_dirsek_a | evaporator sag dirsek | 0 |  | alt gövde → Evaporatör lamelli | B_SOGUTMA | ALT
evaporator_sag_dirsek_b | evaporator sag dirsek | 0 |  | alt gövde → Evaporatör lamelli | B_SOGUTMA | ALT
evaporator_sag_askisi_1 | evaporator sag askisi | 0 | 304 · lazer / lama | alt gövde → Evaporatör askısı | B_SOGUTMA | ALT
evaporator_sag_askisi_2 | evaporator sag askisi | 0 | 304 · lazer / lama | alt gövde → Evaporatör askısı | B_SOGUTMA | ALT
damlama_teknesi_sag | damlama teknesi | 0 | 304 sac · lazer + büküm | alt gövde → Damlama teknesi | B_SOGUTMA | ALT
damlama_teknesi_sag_braketi_1 | damlama teknesi sag braketi | 0 | 304 · lazer / lama | alt gövde → Damlama teknesi braketi | B_SOGUTMA | ALT
damlama_teknesi_sag_braketi_2 | damlama teknesi sag braketi | 0 | 304 · lazer / lama | alt gövde → Damlama teknesi braketi | B_SOGUTMA | ALT
fan_sag_1 | fan sag | 0 |  | alt gövde → ebm-papst 4414 FL | B_SOGUTMA | ALT
fan_sag_2 | fan sag | 0 |  | alt gövde → ebm-papst 4414 FL | B_SOGUTMA | ALT
fan_davlumbazi_sag | fan davlumbazi | 0 | 304 sac · lazer + büküm | alt gövde → Fan davlumbazı | B_SOGUTMA | ALT
gider_borusu_sag | gider borusu | 0 |  | alt gövde → Gider borusu | B_SOGUTMA | ALT
gider_kilifi_sag_B4 | gider kilifi sag B4 | 0 |  | alt gövde → Gider kılıfı | B_SOGUTMA | ALT
gider_kelepcesi_sag_0 | gider kelepcesi sag | 0 |  | alt gövde → Boru kelepçesi | B_SOGUTMA | ALT
gider_kelepcesi_sag_1 | gider kelepcesi sag | 0 |  | alt gövde → Boru kelepçesi | B_SOGUTMA | ALT
gider_cek_valfi_sag | gider cek valfi | 0 | gıda silikonu | alt gövde → Ördek gagası çek valf | B_SOGUTMA | ALT
buharlastirma_tavasi | Buharlaştırma tavası 1,5 | 1 | 304 · v8: K4 sıcak bölmesinin önünde, tabanda — Secop atış havasının içinde · soğutma kapağı açılınca öne çekilir | 465 × 33 × 115 · brüt 1.6 L (günde 4 defrost, VARSAYIM ≤ 1 L) · gider uçları çek valfle tava ağzının 1,5 üstünde | B_SOGUTMA | ÜRETİM
sogutma_grubu_montaj_rayi_arka | Yoğuşturucu montaj rayı L 40×40×3 | 2 | AISI 304 köşebent · 472.5 boy · uçlarında 3 mm uç plakası: B3 kademe sacına / B4 bölme sacına 2 × M6 perçin somun (ön ray B4'te taşıyıcı dikme hizası; arka ray gömülü takviye sacına [VARSAYIM]) | ön ray SÖKÜLÜR (servis: ünite öne çekilir) | B_SOGUTMA | ÜRETİM
sogutma_grubu_montaj_rayi_on | sogutma grubu montaj rayi on | 0 | 304 · lazer / lama | alt gövde → Yoğuşturucu montaj rayı | B_SOGUTMA | ALT
sogutma_grubu_takozu_0 | Titreşim pedi 40 × 30 × 4 · NBR / neopren 60 ShA | 4 | Secop tabanı ↔ montaj rayı · M8 cıvata geçişli [VARSAYIM · üretici seçilmedi] | Secop montaj deliklerinin altında (yer föyden teyit) | B_SOGUTMA | SATIN ALMA
sogutma_grubu_takozu_1 | sogutma grubu takozu | 0 |  | alt gövde → Titreşim pedi | B_SOGUTMA | ALT
sogutma_grubu_takozu_2 | sogutma grubu takozu | 0 |  | alt gövde → Titreşim pedi | B_SOGUTMA | ALT
sogutma_grubu_takozu_3 | sogutma grubu takozu | 0 |  | alt gövde → Titreşim pedi | B_SOGUTMA | ALT
sogutma_grubu_taban | Yoğuşturucu ünite Secop CU NLE8.8CN R290 | 1 | −10 °C'de 25 / 32 / 43 °C: 737 / 688 / 586 W (hızlı başvuru tablosu) · föy 314H5000 32 °C'de 661 W — ÇELİŞKİ AÇIK · gereken (v8, 32 °C, 18 sa, %10 pay) boş 477 · dolum 586 · dolum + sıcak hamur 641 W | yükseklik 297 (föy) · taban 350 × 450 VARSAYIM · 17,9 kg · 180° dönük: kondenser arkada (arka plenumdan emer), atış önden K4 panelinin yarıklarından | B_SOGUTMA | SATIN ALMA
sogutma_grubu_taban_contasi | sogutma grubu taban contasi | 0 |  | alt gövde → Kondenser çevre contası | B_SOGUTMA | ALT
sogutma_grubu_kondenser | sogutma grubu kondenser | 0 |  | alt gövde → Secop CU NLE8.8CN | B_SOGUTMA | ALT
sogutma_grubu_fan | sogutma grubu fan | 0 |  | alt gövde → Secop CU NLE8.8CN | B_SOGUTMA | ALT
sogutma_grubu_kompresor | sogutma grubu kompresor | 0 |  | alt gövde → Secop CU NLE8.8CN | B_SOGUTMA | ALT
k4_ara_sac_alt | k4 ara sac alt | 1 | 304 sac · lazer + büküm | zarf 472.5 × 1.0 × 813.0 | B_SOGUTMA | ÜRETİM
k4_ara_pu | k4 ara pu | 0 | PU köpük (gövdeyle birlikte enjeksiyon) | alt gövde → PU köpük gövde | B_SOGUTMA | ALT
k4_ara_sac_ust | k4 ara sac ust | 1 | 304 sac · lazer + büküm | zarf 472.5 × 1.0 × 813.0 | B_SOGUTMA | ÜRETİM
k4_ara_perde | Ara sac perde 1,0 | 1 | 304 · Secop ile pano arasında · v8: z −655 = emiş plenumunun arka duvarı · v8b: üstte 4 × 80 × 12 havalandırma yarığı (pano → plenum) | pano tabandan emer, perde üstünden plenuma verir | B_SOGUTMA | ÜRETİM
k4_emis_yan_sac_sol | Emiş şeridi yan sacı 1,5 | 2 | 304 · ünitenin yanında 5 mm (sünger contayla) · conta düzleminden öne — emiş şeridini atış tarafından ayırır · ön ray üstünde oyuklu |  | B_SOGUTMA | ÜRETİM
k4_emis_yan_conta_sol | Sünger conta EPDM 5 × 22 yapışkanlı | 2 | ünite tabanı ↔ emiş yan sacı · 390 boy | titreşim geçmez, hava kısa devre yapmaz | B_SOGUTMA | SATIN ALMA
k4_emis_yan_sac_sag | k4 emis yan sac | 0 | 304 sac · lazer + büküm | alt gövde → Emiş şeridi sacı (× 2) | B_SOGUTMA | ALT
k4_emis_yan_conta_sag | k4 emis yan conta | 0 |  | alt gövde → Sünger conta EPDM | B_SOGUTMA | ALT
k4_kondenser_contasi | Kondenser çevre contası EPDM sünger 10 × 5…10 | 1 | kondenserin sol / sağ / üst çevresi (yan saclara ve ara sac altına yapışık) + taban altı şeridi (ünitenin tabanına yapışık) | v8b: kondenser perdesi SACI kalktı (deliği kondenser yüzüne eşitti, sıfır boşluk) | B_SOGUTMA | SATIN ALMA
k4_emis_on_kapama_sol | Emiş şeridi ön kapaması 1,5 | 2 | 304 · şeridin önünü kapatır (önü atış bölgesi: tava + panel) · ön ray üstünde oyuklu · gider borusu lastik geçişli |  | B_SOGUTMA | ÜRETİM
k4_emis_on_kapama_sag | k4 emis on kapama | 0 | 304 sac · lazer + büküm | alt gövde → Emiş şeridi sacı (× 2) | B_SOGUTMA | ALT
pano_montaj_plakasi | Pano montaj plakası 2 mm | 1 | galvaniz | K4 · Secop'un arkasında | B_ELEKTRIK | ÜRETİM
din_ray_0 | DIN ray TS35 × 7,5 | 2 |  |  | B_ELEKTRIK | SATIN ALMA
din_ray_1 | din ray | 0 | 304 · lazer / lama | alt gövde → DIN ray | B_ELEKTRIK | ALT
plc_S7-1200_1214C | PLC Siemens S7-1200 CPU 1214C DC/DC/DC | 1 | 6ES7214-1AG40-0XB0 · 14 DI · 10 DQ · PROFINET/Modbus TCP | 110 × 100 × 75 | B_ELEKTRIK | SATIN ALMA
plc_SM1221_DI16_a | PLC genişleme SM1221 DI16 | 3 | 6ES7221-1BH32-0XB0 | 45 × 100 × 75 · 48 reed + 24 röle | B_ELEKTRIK | SATIN ALMA
plc_SM1221_DI16_b | PLC genişleme SM1221 DI16 | 0 | 6ES7221-1BH32-0XB0 | alt gövde → SM1221 | B_ELEKTRIK | ALT
plc_SM1221_DI16_c | PLC genişleme SM1221 DI16 | 0 | 6ES7221-1BH32-0XB0 | alt gövde → SM1221 | B_ELEKTRIK | ALT
plc_SM1222_DQ16 | PLC genişleme SM1222 DQ16 | 1 | 6ES7222-1BH32-0XB0 | 45 × 100 × 75 · 48 reed + 24 röle | B_ELEKTRIK | SATIN ALMA
guc_kaynagi_NDR-240-24 | Güç kaynağı Mean Well NDR-240-24 | 1 | 24 V 10 A · DIN | 63 × 125,2 × 113,5 | B_ELEKTRIK | SATIN ALMA
surucu_EM-324C | DC motor sürücü Electromen EM-324C + DIN taban | 1 | 10–35 V · 4 A · akım sınırı · NPN/PNP | 72 genişlik taban [yükseklik/derinlik VARSAYIM] | B_ELEKTRIK | SATIN ALMA
role_01 | Seçici röle Phoenix Contact PLC-RSC-24DC/21 | 24 | 6,2 mm · 1 değiştirici · 24 V bobin | hangi çekmecenin motoru sürücüye bağlanacak [boyut VARSAYIM] | B_ELEKTRIK | SATIN ALMA
role_02 | role | 0 |  | alt gövde → Phoenix PLC-RSC | B_ELEKTRIK | ALT
role_03 | role | 0 |  | alt gövde → Phoenix PLC-RSC | B_ELEKTRIK | ALT
role_04 | role | 0 |  | alt gövde → Phoenix PLC-RSC | B_ELEKTRIK | ALT
role_05 | role | 0 |  | alt gövde → Phoenix PLC-RSC | B_ELEKTRIK | ALT
role_06 | role | 0 |  | alt gövde → Phoenix PLC-RSC | B_ELEKTRIK | ALT
role_07 | role | 0 |  | alt gövde → Phoenix PLC-RSC | B_ELEKTRIK | ALT
role_08 | role | 0 |  | alt gövde → Phoenix PLC-RSC | B_ELEKTRIK | ALT
role_09 | role | 0 |  | alt gövde → Phoenix PLC-RSC | B_ELEKTRIK | ALT
role_10 | role | 0 |  | alt gövde → Phoenix PLC-RSC | B_ELEKTRIK | ALT
role_11 | role | 0 |  | alt gövde → Phoenix PLC-RSC | B_ELEKTRIK | ALT
role_12 | role | 0 |  | alt gövde → Phoenix PLC-RSC | B_ELEKTRIK | ALT
role_13 | role | 0 |  | alt gövde → Phoenix PLC-RSC | B_ELEKTRIK | ALT
role_14 | role | 0 |  | alt gövde → Phoenix PLC-RSC | B_ELEKTRIK | ALT
role_15 | role | 0 |  | alt gövde → Phoenix PLC-RSC | B_ELEKTRIK | ALT
role_16 | role | 0 |  | alt gövde → Phoenix PLC-RSC | B_ELEKTRIK | ALT
role_17 | role | 0 |  | alt gövde → Phoenix PLC-RSC | B_ELEKTRIK | ALT
role_18 | role | 0 |  | alt gövde → Phoenix PLC-RSC | B_ELEKTRIK | ALT
role_19 | role | 0 |  | alt gövde → Phoenix PLC-RSC | B_ELEKTRIK | ALT
role_20 | role | 0 |  | alt gövde → Phoenix PLC-RSC | B_ELEKTRIK | ALT
role_21 | role | 0 |  | alt gövde → Phoenix PLC-RSC | B_ELEKTRIK | ALT
role_22 | role | 0 |  | alt gövde → Phoenix PLC-RSC | B_ELEKTRIK | ALT
role_23 | role | 0 |  | alt gövde → Phoenix PLC-RSC | B_ELEKTRIK | ALT
role_24 | role | 0 |  | alt gövde → Phoenix PLC-RSC | B_ELEKTRIK | ALT
klemens_blogu | Klemens bloğu | 1 | Phoenix UT 2,5 · 24 motor + 48 sensör + güç | kalan genişlik | B_ELEKTRIK | SATIN ALMA
k4_depo_kutu_U_1.5 | K4 depo çekmece kutusu U 1,5 | 1 | 304 lazer + 2 büküm · yanları iç raya 4 × M4 · ön + arka 1,5 | 447 × 134 × 545 | B_DEPO | ÜRETİM
k4_depo_kutu_arka_1.5 | k4 depo kutu arka 1.5 | 0 | 304 sac · lazer + büküm | alt gövde → K4 depo çekmece kutusu | B_DEPO | ALT
k4_depo_kutu_on_1.5 | k4 depo kutu on 1.5 | 0 | 304 sac · lazer + büküm | alt gövde → K4 depo çekmece kutusu | B_DEPO | ALT
k4_depo_on_baglanti_sol | Ön bağlantı köşesi · U 2 mm | 2 | 304 2 mm büküm · kutu önüne punta, kapak iç sacına 2 × M5 perçin somun | K4 depo çekmecesi | B_DEPO | ÜRETİM
k4_depo_on_baglanti_sag | k4 depo on baglanti | 0 | 304 · lazer / lama | alt gövde → ön bağlantı köşesi | B_DEPO | ALT
k4_depo_ray_dis_sol | Teleskopik ray Accuride DZ3832-TR (bas-aç) · 700 | 2 | %100 açılır · touch release: kapalıyken itince açılır (kulpsuz) · 45,7 × 12,7 | K4 depo · dış eleman bölme sacına 4 × M5 · accuride-europe.com DZ3832-TR [700 boy + yük katalogdan teyit] | B_DEPO | SATIN ALMA
k4_depo_ray_ara_sol | k4 depo ray ara | 0 | 304 · lazer / lama | alt gövde → Accuride DZ3832-TR | B_DEPO | ALT
k4_depo_ray_ic_sol | k4 depo ray ic | 0 | 304 · lazer / lama | alt gövde → Accuride DZ3832-TR | B_DEPO | ALT
k4_depo_ray_dis_sag | k4 depo ray dis | 0 | 304 · lazer / lama | alt gövde → Accuride DZ3832-TR | B_DEPO | ALT
k4_depo_ray_ara_sag | k4 depo ray ara | 0 | 304 · lazer / lama | alt gövde → Accuride DZ3832-TR | B_DEPO | ALT
k4_depo_ray_ic_sag | k4 depo ray ic | 0 | 304 · lazer / lama | alt gövde → Accuride DZ3832-TR | B_DEPO | ALT
k4_depo_raf_tutucu_sol | Raf tutucu köşebent 10 × 10 × 1,5 | 2 | 304 · kutu yanına punta |  | B_DEPO | ÜRETİM
k4_depo_raf_tutucu_sag | k4 depo raf tutucu | 0 | 304 · lazer / lama | alt gövde → Raf tutucu köşebent | B_DEPO | ALT
k4_depo_raf | K4 depo rafı 1,5 · sökülür | 1 | 304 · tutuculara oturur · GN 1/2'nin altında, arkası açık (GN 1/1'e hava) | raf kotu v7 ile aynı 578,5–580 | B_DEPO | ÜRETİM
k4_depo_GN11_100 | GN 1/1-100 kap + kapak | 1 | 304 · EN 631 · 530 × 325 × 100 | kaşar blok 2 gün = 8,8 kg (yoğunluk VARSAYIM) · çekmece kutusunun tabanında | B_DEPO | SATIN ALMA
k4_depo_GN12_100 | GN 1/2-100 kap + kapak | 1 | 304 · EN 631 · 325 × 265 × 100 | küp sucuk 2 gün = 2,8 kg · sökülür rafın üstünde | B_DEPO | SATIN ALMA
k4_kapak_sogutma_dis_sac | Yoğuşturucu bölmesi servis paneli 1,5 · lazer yarıklı | 1 | 304 fırçalı 1,5 tava 40 · 60 lazer yarık 145 × 8 (köprü 5 / 8) net 696 cm² · 4 gizli klipsle sökülür (düz çekilir, menteşe YOK) | v8b: Secop ATIŞI yarıklardan çıkar · v8 ızgara lamaları (452,5 açıklık, 10 N'da 11 mm sehim) kalktı | B_SOGUTMA | ÜRETİM
k4_panel_klipsi_0 | Gizli panel klipsi Fastmount paslanmaz · erkek + dişi | 8 | çerçeve sacına / yan saca perçin · panelin kenar dönüşüne vida · düz çekince çıkar [tip VARSAYIM: Fastmount Very Low Profile, fastmount.com] | K4 soğutma paneli 4 + şerit servis paneli 4 | B_SOGUTMA | SATIN ALMA
k4_panel_klipsi_1 | k4 panel klipsi | 0 | 304 · lazer / lama | alt gövde → Gizli panel klipsi | B_SOGUTMA | ALT
k4_panel_klipsi_2 | k4 panel klipsi | 0 | 304 · lazer / lama | alt gövde → Gizli panel klipsi | B_SOGUTMA | ALT
k4_panel_klipsi_3 | k4 panel klipsi | 0 | 304 · lazer / lama | alt gövde → Gizli panel klipsi | B_SOGUTMA | ALT
k4_kapak_depo_dis_sac_1.5 | K4 depo çekmecesi önü 40 · kulpsuz | 1 | dış 304 1,5 (arkada kanal kenarına dönüş) + PU 37,5 + iç panel 304 1,0 (fitil kanalı dönüş ile panel arası) · bas-aç (Accuride DZ3832-TR) | 504 × 336 | B_DEPO | ÜRETİM
k4_kapak_depo_pu | k4 kapak depo pu | 0 | PU köpük (gövdeyle birlikte enjeksiyon) | alt gövde → kapak katmanı | B_DEPO | ALT
k4_kapak_depo_ic_sac_1.0 | k4 kapak depo ic sac 1.0 | 0 | 304 sac · lazer + büküm | alt gövde → kapak katmanı | B_DEPO | ALT
k4_kapak_depo_fitil | Fitil · geçmeli manyetik profil 21 × 18,5 | 1 | PVC + şerit mıknatıs · kapak iç sacının 6,4'lük kanalına geçer · aletsiz sökülür | çevre 1465 mm · köşeler gönye kaynaklı | B_DEPO | SATIN ALMA
cop_kova_kizagi | Kova kızağı 1,5 | 1 | 304 büküm · yan + arka dudak 15 · dış taban sacına 4 × M5 | kova öne çekilip çıkarılır | B_COP | ÜRETİM
robot_cop_kovasi_15L | Robot çöp kovası 15 L · ince dikdörtgen | 1 | PP · gıda uygun · zarf 165 × 300 × 400 (SPEC) · düz duvar modellendi (gerçek kova konik) | marka seçilmedi [VARSAYIM] · 2 gün fire ≈ 6 L gevşek × 2 pay (teknik_qr_tezgah_v4) | B_COP | SATIN ALMA
robot_cop_poseti | Çöp poşeti 15 L (sarf) | 1 | LDPE 0,5 (modelde) · kova ağzından 30 dışa kıvrılır | eleman kovayı boşaltırken değiştirir | B_COP | SATIN ALMA
serit_on_kapak | Şerit servis paneli 1,5 · yalıtımsız · sökülür | 1 | 304 büküm · 40 dönüş · 4 gizli klipsle düz çekilir (menteşe YOK — v8b · denetçi ORTA 1: menteşe 3 mm derzde K6 önüne çarpıyordu) | 206 × 434 · kova öne çekilerek boşaltılır | B_COP | ÜRETİM
serit_on_klape_paneli | Şerit klape paneli 1,5 | 1 | 304 büküm · 40 dönüş · sabit · klape açıklığı 130 × 130 | 206 × 222 | B_COP | ÜRETİM
serit_panel_klipsi_0 | serit panel klipsi | 0 | 304 · lazer / lama | alt gövde → Gizli panel klipsi | B_COP | ALT
serit_panel_klipsi_1 | serit panel klipsi | 0 | 304 · lazer / lama | alt gövde → Gizli panel klipsi | B_COP | ALT
serit_panel_klipsi_2 | serit panel klipsi | 0 | 304 · lazer / lama | alt gövde → Gizli panel klipsi | B_COP | ALT
serit_panel_klipsi_3 | serit panel klipsi | 0 | 304 · lazer / lama | alt gövde → Gizli panel klipsi | B_COP | ALT
serit_dusme_olugu | Düşme oluğu 1,5 · 45° | 1 | 304 · yan kenarları 20 · üst kenarı klape panelinin arkasına kaynaklı, alt yüzü panelin alt dönüşüne dayanır | v8b: atılan parça klapenin arkasındaki 40'lık dönüş rafında kalmaz, kovaya kayar | B_COP | ÜRETİM
klape_levhasi | Yaylı klape levhası 1,5 | 1 | 304 · içe açılır (robot eli iter) · yay kapatır · en çok 90° (mekanik stop) | 142 × 140 · panelin arkasında, açıklığı 6 bindirir | B_COP | ÜRETİM
klape_mentesesi | Yaylı menteşe Ø8 · yay gövde içinde | 1 | paslanmaz · 120 boy · kapanma momenti [VARSAYIM] | marka seçilmedi [VARSAYIM] | B_COP | SATIN ALMA
klape_mentese_yapragi | klape mentese yapragi | 1 | 304 · lazer / lama | zarf 120.0 × 27.5 × 11.0 | B_COP | ÜRETİM
onyuz_cerceve_saci_1.0 | Ön çerçeve sacı 1,0 | 1 | 430 FERRİTİK 1,0 (manyetik fitil 304'e tutmaz) · lazer kesim · 26 açıklık · fırın altında üst kenar 668 | fitil buna basar | B_KASA | ÜRETİM
CEK_K1_lahm_1_on_dis_sac_1.5 | Çekmece önü 40 · kulpsuz · tam kaplama | 1 | dış 304 1,5 bükme (4 kenar + arkada kanal kenarına dönüş) + PU 37,5 köpük + iç panel 304 1,0 · fitil dişi dönüş ile panel arasındaki 6,4 kanala geçer | 698 × 132 | CEK_K1_lahm_1 | ÜRETİM
CEK_K1_lahm_1_on_pu | on pu | 0 | PU köpük (gövdeyle birlikte enjeksiyon) | alt gövde → çekmece önü / kapak katmanı | CEK_K1_lahm_1 | ALT
CEK_K1_lahm_1_on_ic_sac_1.0 | on ic sac 1.0 | 0 | 304 sac · lazer + büküm | alt gövde → çekmece önü / kapak katmanı | CEK_K1_lahm_1 | ALT
CEK_K1_lahm_1_on_fitil | Fitil · geçmeli manyetik profil 21 × 18,5 | 1 | PVC + şerit mıknatıs · kapak iç sacının 6,4'lük kanalına geçer · aletsiz sökülür | çevre 1392 mm · köşeler gönye kaynaklı | CEK_K1_lahm_1 | SATIN ALMA
CEK_K1_lahm_1_kutu_U_1.0 | Çekmece kutusu U 1,0 | 1 | 304 lazer + 2 büküm | 560 × 45 × 629 | CEK_K1_lahm_1 | ÜRETİM
CEK_K1_lahm_1_kutu_arka_1.0 | kutu arka 1.0 | 0 | 304 sac · lazer + büküm | alt gövde → çekmece kutusu | CEK_K1_lahm_1 | ALT
CEK_K1_lahm_1_kutu_on_1.0 | kutu on 1.0 | 0 | 304 sac · lazer + büküm | alt gövde → çekmece kutusu | CEK_K1_lahm_1 | ALT
CEK_K1_lahm_1_on_baglanti_sol | Ön bağlantı köşesi · U 2 mm | 2 | 304 2 mm büküm · kutu önüne punta, kapak iç sacına 2 × M5 perçin somun | ön yüz ayar yuvalı · 17 derin | CEK_K1_lahm_1 | ÜRETİM
CEK_K1_lahm_1_on_baglanti_sag | on baglanti | 0 | 304 · lazer / lama | alt gövde → ön bağlantı köşesi | CEK_K1_lahm_1 | ALT
CEK_K1_lahm_1_ray_adaptor_sol | Ray adaptör lamı 6 mm | 2 | 304 lama · kutuya punta | ray iç profiline 4 × M4 · v8: iç ray boyuyla sınırlı (660'lık kutuda kutu arkada konsol) | CEK_K1_lahm_1 | ÜRETİM
CEK_K1_lahm_1_ray_adaptor_sag | ray adaptor | 0 | 304 · lazer / lama | alt gövde → ray adaptör lamı | CEK_K1_lahm_1 | ALT
CEK_K1_lahm_1_ray_dis_sol | Teleskopik ray Accuride DZ3832-0070 | 2 | 700 · %100 açılır · 3 elemanlı · 45,7 × 12,7 · 45–50 kg (çift) | dış eleman kolon yan duvarına 4 × M5 | CEK_K1_lahm_1 | SATIN ALMA
CEK_K1_lahm_1_ray_ara_sol | ray ara | 0 | 304 · lazer / lama | alt gövde → Accuride DZ3832-0070 (ara eleman) | CEK_K1_lahm_1 | ALT
CEK_K1_lahm_1_ray_ic_sol | ray ic | 0 | 304 · lazer / lama | alt gövde → Accuride DZ3832-0070 (iç eleman) | CEK_K1_lahm_1 | ALT
CEK_K1_lahm_1_ray_dis_sag | ray dis | 0 | 304 · lazer / lama | alt gövde → Accuride DZ3832-0070 | CEK_K1_lahm_1 | ALT
CEK_K1_lahm_1_ray_ara_sag | ray ara | 0 | 304 · lazer / lama | alt gövde → Accuride DZ3832-0070 (ara eleman) | CEK_K1_lahm_1 | ALT
CEK_K1_lahm_1_ray_ic_sag | ray ic | 0 | 304 · lazer / lama | alt gövde → Accuride DZ3832-0070 (iç eleman) | CEK_K1_lahm_1 | ALT
CEK_K1_lahm_1_motor_kasnagi | GT3 kasnak 30 diş · 6 mm · flanşlı | 1 | alüminyum · delik Ø8 H7 + düz | PD 28,65 · çevre 90 mm | CEK_K1_lahm_1 | SATIN ALMA
CEK_K1_lahm_1_motor_mili | motor mili | 0 | 304 · lazer / lama | alt gövde → Transmotec PD3665 | CEK_K1_lahm_1 | ALT
CEK_K1_lahm_1_motor_gobegi | motor gobegi | 0 | 304 · lazer / lama | alt gövde → Transmotec PD3665 | CEK_K1_lahm_1 | ALT
CEK_K1_lahm_1_motor_reduktor | Motor Transmotec PD3665-24-51-BFEC | 1 | 24 V · planet 51:1 · 127 d/dk · 0,853 N·m · manyetik enkoder · EMC filtreli | Ø36 × 115,5 + enkoder · datasheet: transmotec.com PD3665 | CEK_K1_lahm_1 | SATIN ALMA
CEK_K1_lahm_1_motor_govde | motor govde | 0 |  | alt gövde → Transmotec PD3665 | CEK_K1_lahm_1 | ALT
CEK_K1_lahm_1_enkoder_kapagi | enkoder kapagi | 0 |  | alt gövde → Transmotec PD3665 | CEK_K1_lahm_1 | ALT
CEK_K1_lahm_1_m12_soket | M12 4 pin soket + kablo | 1 | motor + enkoder tek soket · kasada sabit | kablo dikey kanala | CEK_K1_lahm_1 | SATIN ALMA
CEK_K1_lahm_1_motor_braketi | Motor braketi 3 mm | 1 | 304 lazer + büküm · 4 × M3 (Ø31) + arka duvara 2 × M5 | kasnak hizası buradan | CEK_K1_lahm_1 | ÜRETİM
CEK_K1_lahm_1_avara | GT3 avara 30 diş · 6 mm · tek flanşlı (dış) · çift rulman | 1 | alüminyum · 2 × MR126-2RS (6 × 12 × 4: 8 ≤ göbek 9,5 — v8'deki 2 × 625 = 10 sığmıyordu) · v8: iç flanş yok (Gates: iki kasnaklı tahrikte motor kasnağı çift flanşlı → kayış kılavuzu yeter) | z −73 SABİT (strok 628) | CEK_K1_lahm_1 | SATIN ALMA
CEK_K1_lahm_1_avara_mili | Avara mili Ø6 · omuzlu | 1 | 304 · kola somunla (kolun iç yüzünde) · 2 × MR126-2RS taşır | v8b: Ø5 → Ø6 (sıkışma tepesinde 182 → ~108 MPa) | CEK_K1_lahm_1 | ÜRETİM
CEK_K1_lahm_1_avara_kolu | Avara kolu 2 mm · L kesit + ön flanş + arka kulak | 1 | 304 2 mm büküm · üst flanş 12 · ön flanş 20 × 12,7 (K1 / K2 üst çekmecede tavan nedeniyle 18,5): çerçeve sacına 2 × PEM FH4-M3-10 gömme başlı saplama + somun (çerçevenin önü düz, fitil bandı temiz) · arka kulak: sensör lamına 20 bindirme, 2 × M3 perçin | boy 104 (−81…+23), moment kolu 96 · iç raya 1,0 · avaraya 1,3 · kayış gergisi burada: 8 mm yuvalı | CEK_K1_lahm_1 | ÜRETİM
CEK_K1_lahm_1_kayis_GT3 | Kayış GT3 6 mm kapalı çevrim | 1 | ~1482 mm (494 diş) · çelik kordlu | tedarikçi boyu doğrulayacak | CEK_K1_lahm_1 | SATIN ALMA
CEK_K1_lahm_1_kayis_cenesi | Kayış çenesi + kolu | 1 | 304 · kutunun yan duvarına kaynaklı · dişli çene 2 × M3 | kutunun arkasından kasnağa uzanır (strok için) | CEK_K1_lahm_1 | ÜRETİM
CEK_K1_lahm_1_miknatis_ayagi | miknatis ayagi | 1 | 304 · lazer / lama | zarf 6.3 × 2.3 × 28.6 | CEK_K1_lahm_1 | ÜRETİM
CEK_K1_lahm_1_miknatis_57135 | Mıknatıs Littelfuse 57135-000 | 1 | AlNiCo 5 · flanşlı 28,57 × 19,05 × 6,35 | çenenin üstünde | CEK_K1_lahm_1 | SATIN ALMA
CEK_K1_lahm_1_reed_kapali | Reed sensör Littelfuse 59135-010 | 2 | NO · flanşlı 28,57 × 19,05 × 6,35 | KAPALI + AÇIK konum · PLC girişine | CEK_K1_lahm_1 | SATIN ALMA
CEK_K1_lahm_1_reed_acik | reed acik | 0 |  | alt gövde → Littelfuse 59135 | CEK_K1_lahm_1 | ALT
CEK_K1_lahm_1_sensor_lami | Sensör lamı L 6,35 × 8 × 2 + arka tırnak | 1 | 304 büküm · reed sensörler altında · önde avara kolunun arka kulağına 20 bindirme 2 × M3 perçin · arkada 16 geniş tırnakla arka iç saca 2 × M4 perçin somun |  | CEK_K1_lahm_1 | ÜRETİM
CEK_K1_lahm_1_tepsi | Tepsi · 36 çukur Ø80 | 1 | gıda silikonu 10 mm · çukur 7 · kalıp döküm | 530 × 540 | CEK_K1_lahm_1 | ÜRETİM
CEK_K1_lahm_2_on_dis_sac_1.5 | Çekmece önü 40 · kulpsuz · tam kaplama | 1 | dış 304 1,5 bükme (4 kenar + arkada kanal kenarına dönüş) + PU 37,5 köpük + iç panel 304 1,0 · fitil dişi dönüş ile panel arasındaki 6,4 kanala geçer | 698 × 90 | CEK_K1_lahm_2 | ÜRETİM
CEK_K1_lahm_2_on_pu | on pu | 0 | PU köpük (gövdeyle birlikte enjeksiyon) | alt gövde → çekmece önü / kapak katmanı | CEK_K1_lahm_2 | ALT
CEK_K1_lahm_2_on_ic_sac_1.0 | on ic sac 1.0 | 0 | 304 sac · lazer + büküm | alt gövde → çekmece önü / kapak katmanı | CEK_K1_lahm_2 | ALT
CEK_K1_lahm_2_on_fitil | Fitil · geçmeli manyetik profil 21 × 18,5 | 1 | PVC + şerit mıknatıs · kapak iç sacının 6,4'lük kanalına geçer · aletsiz sökülür | çevre 1392 mm · köşeler gönye kaynaklı | CEK_K1_lahm_2 | SATIN ALMA
CEK_K1_lahm_2_kutu_U_1.0 | Çekmece kutusu U 1,0 | 1 | 304 lazer + 2 büküm | 560 × 45 × 629 | CEK_K1_lahm_2 | ÜRETİM
CEK_K1_lahm_2_kutu_arka_1.0 | kutu arka 1.0 | 0 | 304 sac · lazer + büküm | alt gövde → çekmece kutusu | CEK_K1_lahm_2 | ALT
CEK_K1_lahm_2_kutu_on_1.0 | kutu on 1.0 | 0 | 304 sac · lazer + büküm | alt gövde → çekmece kutusu | CEK_K1_lahm_2 | ALT
CEK_K1_lahm_2_on_baglanti_sol | Ön bağlantı köşesi · U 2 mm | 2 | 304 2 mm büküm · kutu önüne punta, kapak iç sacına 2 × M5 perçin somun | ön yüz ayar yuvalı · 17 derin | CEK_K1_lahm_2 | ÜRETİM
CEK_K1_lahm_2_on_baglanti_sag | on baglanti | 0 | 304 · lazer / lama | alt gövde → ön bağlantı köşesi | CEK_K1_lahm_2 | ALT
CEK_K1_lahm_2_ray_adaptor_sol | Ray adaptör lamı 6 mm | 2 | 304 lama · kutuya punta | ray iç profiline 4 × M4 · v8: iç ray boyuyla sınırlı (660'lık kutuda kutu arkada konsol) | CEK_K1_lahm_2 | ÜRETİM
CEK_K1_lahm_2_ray_adaptor_sag | ray adaptor | 0 | 304 · lazer / lama | alt gövde → ray adaptör lamı | CEK_K1_lahm_2 | ALT
CEK_K1_lahm_2_ray_dis_sol | Teleskopik ray Accuride DZ3832-0070 | 2 | 700 · %100 açılır · 3 elemanlı · 45,7 × 12,7 · 45–50 kg (çift) | dış eleman kolon yan duvarına 4 × M5 | CEK_K1_lahm_2 | SATIN ALMA
CEK_K1_lahm_2_ray_ara_sol | ray ara | 0 | 304 · lazer / lama | alt gövde → Accuride DZ3832-0070 (ara eleman) | CEK_K1_lahm_2 | ALT
CEK_K1_lahm_2_ray_ic_sol | ray ic | 0 | 304 · lazer / lama | alt gövde → Accuride DZ3832-0070 (iç eleman) | CEK_K1_lahm_2 | ALT
CEK_K1_lahm_2_ray_dis_sag | ray dis | 0 | 304 · lazer / lama | alt gövde → Accuride DZ3832-0070 | CEK_K1_lahm_2 | ALT
CEK_K1_lahm_2_ray_ara_sag | ray ara | 0 | 304 · lazer / lama | alt gövde → Accuride DZ3832-0070 (ara eleman) | CEK_K1_lahm_2 | ALT
CEK_K1_lahm_2_ray_ic_sag | ray ic | 0 | 304 · lazer / lama | alt gövde → Accuride DZ3832-0070 (iç eleman) | CEK_K1_lahm_2 | ALT
CEK_K1_lahm_2_motor_kasnagi | GT3 kasnak 30 diş · 6 mm · flanşlı | 1 | alüminyum · delik Ø8 H7 + düz | PD 28,65 · çevre 90 mm | CEK_K1_lahm_2 | SATIN ALMA
CEK_K1_lahm_2_motor_mili | motor mili | 0 | 304 · lazer / lama | alt gövde → Transmotec PD3665 | CEK_K1_lahm_2 | ALT
CEK_K1_lahm_2_motor_gobegi | motor gobegi | 0 | 304 · lazer / lama | alt gövde → Transmotec PD3665 | CEK_K1_lahm_2 | ALT
CEK_K1_lahm_2_motor_reduktor | Motor Transmotec PD3665-24-51-BFEC | 1 | 24 V · planet 51:1 · 127 d/dk · 0,853 N·m · manyetik enkoder · EMC filtreli | Ø36 × 115,5 + enkoder · datasheet: transmotec.com PD3665 | CEK_K1_lahm_2 | SATIN ALMA
CEK_K1_lahm_2_motor_govde | motor govde | 0 |  | alt gövde → Transmotec PD3665 | CEK_K1_lahm_2 | ALT
CEK_K1_lahm_2_enkoder_kapagi | enkoder kapagi | 0 |  | alt gövde → Transmotec PD3665 | CEK_K1_lahm_2 | ALT
CEK_K1_lahm_2_m12_soket | M12 4 pin soket + kablo | 1 | motor + enkoder tek soket · kasada sabit | kablo dikey kanala | CEK_K1_lahm_2 | SATIN ALMA
CEK_K1_lahm_2_motor_braketi | Motor braketi 3 mm | 1 | 304 lazer + büküm · 4 × M3 (Ø31) + arka duvara 2 × M5 | kasnak hizası buradan | CEK_K1_lahm_2 | ÜRETİM
CEK_K1_lahm_2_avara | GT3 avara 30 diş · 6 mm · tek flanşlı (dış) · çift rulman | 1 | alüminyum · 2 × MR126-2RS (6 × 12 × 4: 8 ≤ göbek 9,5 — v8'deki 2 × 625 = 10 sığmıyordu) · v8: iç flanş yok (Gates: iki kasnaklı tahrikte motor kasnağı çift flanşlı → kayış kılavuzu yeter) | z −73 SABİT (strok 628) | CEK_K1_lahm_2 | SATIN ALMA
CEK_K1_lahm_2_avara_mili | Avara mili Ø6 · omuzlu | 1 | 304 · kola somunla (kolun iç yüzünde) · 2 × MR126-2RS taşır | v8b: Ø5 → Ø6 (sıkışma tepesinde 182 → ~108 MPa) | CEK_K1_lahm_2 | ÜRETİM
CEK_K1_lahm_2_avara_kolu | Avara kolu 2 mm · L kesit + ön flanş + arka kulak | 1 | 304 2 mm büküm · üst flanş 12 · ön flanş 20 × 12,7 (K1 / K2 üst çekmecede tavan nedeniyle 18,5): çerçeve sacına 2 × PEM FH4-M3-10 gömme başlı saplama + somun (çerçevenin önü düz, fitil bandı temiz) · arka kulak: sensör lamına 20 bindirme, 2 × M3 perçin | boy 104 (−81…+23), moment kolu 96 · iç raya 1,0 · avaraya 1,3 · kayış gergisi burada: 8 mm yuvalı | CEK_K1_lahm_2 | ÜRETİM
CEK_K1_lahm_2_kayis_GT3 | Kayış GT3 6 mm kapalı çevrim | 1 | ~1482 mm (494 diş) · çelik kordlu | tedarikçi boyu doğrulayacak | CEK_K1_lahm_2 | SATIN ALMA
CEK_K1_lahm_2_kayis_cenesi | Kayış çenesi + kolu | 1 | 304 · kutunun yan duvarına kaynaklı · dişli çene 2 × M3 | kutunun arkasından kasnağa uzanır (strok için) | CEK_K1_lahm_2 | ÜRETİM
CEK_K1_lahm_2_miknatis_ayagi | miknatis ayagi | 1 | 304 · lazer / lama | zarf 6.3 × 2.3 × 28.6 | CEK_K1_lahm_2 | ÜRETİM
CEK_K1_lahm_2_miknatis_57135 | Mıknatıs Littelfuse 57135-000 | 1 | AlNiCo 5 · flanşlı 28,57 × 19,05 × 6,35 | çenenin üstünde | CEK_K1_lahm_2 | SATIN ALMA
CEK_K1_lahm_2_reed_kapali | Reed sensör Littelfuse 59135-010 | 2 | NO · flanşlı 28,57 × 19,05 × 6,35 | KAPALI + AÇIK konum · PLC girişine | CEK_K1_lahm_2 | SATIN ALMA
CEK_K1_lahm_2_reed_acik | reed acik | 0 |  | alt gövde → Littelfuse 59135 | CEK_K1_lahm_2 | ALT
CEK_K1_lahm_2_sensor_lami | Sensör lamı L 6,35 × 8 × 2 + arka tırnak | 1 | 304 büküm · reed sensörler altında · önde avara kolunun arka kulağına 20 bindirme 2 × M3 perçin · arkada 16 geniş tırnakla arka iç saca 2 × M4 perçin somun |  | CEK_K1_lahm_2 | ÜRETİM
CEK_K1_lahm_2_tepsi | Tepsi · 36 çukur Ø80 | 1 | gıda silikonu 10 mm · çukur 7 · kalıp döküm | 530 × 540 | CEK_K1_lahm_2 | ÜRETİM
CEK_K1_lahm_3_on_dis_sac_1.5 | Çekmece önü 40 · kulpsuz · tam kaplama | 1 | dış 304 1,5 bükme (4 kenar + arkada kanal kenarına dönüş) + PU 37,5 köpük + iç panel 304 1,0 · fitil dişi dönüş ile panel arasındaki 6,4 kanala geçer | 698 × 90 | CEK_K1_lahm_3 | ÜRETİM
CEK_K1_lahm_3_on_pu | on pu | 0 | PU köpük (gövdeyle birlikte enjeksiyon) | alt gövde → çekmece önü / kapak katmanı | CEK_K1_lahm_3 | ALT
CEK_K1_lahm_3_on_ic_sac_1.0 | on ic sac 1.0 | 0 | 304 sac · lazer + büküm | alt gövde → çekmece önü / kapak katmanı | CEK_K1_lahm_3 | ALT
CEK_K1_lahm_3_on_fitil | Fitil · geçmeli manyetik profil 21 × 18,5 | 1 | PVC + şerit mıknatıs · kapak iç sacının 6,4'lük kanalına geçer · aletsiz sökülür | çevre 1392 mm · köşeler gönye kaynaklı | CEK_K1_lahm_3 | SATIN ALMA
CEK_K1_lahm_3_kutu_U_1.0 | Çekmece kutusu U 1,0 | 1 | 304 lazer + 2 büküm | 560 × 45 × 629 | CEK_K1_lahm_3 | ÜRETİM
CEK_K1_lahm_3_kutu_arka_1.0 | kutu arka 1.0 | 0 | 304 sac · lazer + büküm | alt gövde → çekmece kutusu | CEK_K1_lahm_3 | ALT
CEK_K1_lahm_3_kutu_on_1.0 | kutu on 1.0 | 0 | 304 sac · lazer + büküm | alt gövde → çekmece kutusu | CEK_K1_lahm_3 | ALT
CEK_K1_lahm_3_on_baglanti_sol | Ön bağlantı köşesi · U 2 mm | 2 | 304 2 mm büküm · kutu önüne punta, kapak iç sacına 2 × M5 perçin somun | ön yüz ayar yuvalı · 17 derin | CEK_K1_lahm_3 | ÜRETİM
CEK_K1_lahm_3_on_baglanti_sag | on baglanti | 0 | 304 · lazer / lama | alt gövde → ön bağlantı köşesi | CEK_K1_lahm_3 | ALT
CEK_K1_lahm_3_ray_adaptor_sol | Ray adaptör lamı 6 mm | 2 | 304 lama · kutuya punta | ray iç profiline 4 × M4 · v8: iç ray boyuyla sınırlı (660'lık kutuda kutu arkada konsol) | CEK_K1_lahm_3 | ÜRETİM
CEK_K1_lahm_3_ray_adaptor_sag | ray adaptor | 0 | 304 · lazer / lama | alt gövde → ray adaptör lamı | CEK_K1_lahm_3 | ALT
CEK_K1_lahm_3_ray_dis_sol | Teleskopik ray Accuride DZ3832-0070 | 2 | 700 · %100 açılır · 3 elemanlı · 45,7 × 12,7 · 45–50 kg (çift) | dış eleman kolon yan duvarına 4 × M5 | CEK_K1_lahm_3 | SATIN ALMA
CEK_K1_lahm_3_ray_ara_sol | ray ara | 0 | 304 · lazer / lama | alt gövde → Accuride DZ3832-0070 (ara eleman) | CEK_K1_lahm_3 | ALT
CEK_K1_lahm_3_ray_ic_sol | ray ic | 0 | 304 · lazer / lama | alt gövde → Accuride DZ3832-0070 (iç eleman) | CEK_K1_lahm_3 | ALT
CEK_K1_lahm_3_ray_dis_sag | ray dis | 0 | 304 · lazer / lama | alt gövde → Accuride DZ3832-0070 | CEK_K1_lahm_3 | ALT
CEK_K1_lahm_3_ray_ara_sag | ray ara | 0 | 304 · lazer / lama | alt gövde → Accuride DZ3832-0070 (ara eleman) | CEK_K1_lahm_3 | ALT
CEK_K1_lahm_3_ray_ic_sag | ray ic | 0 | 304 · lazer / lama | alt gövde → Accuride DZ3832-0070 (iç eleman) | CEK_K1_lahm_3 | ALT
CEK_K1_lahm_3_motor_kasnagi | GT3 kasnak 30 diş · 6 mm · flanşlı | 1 | alüminyum · delik Ø8 H7 + düz | PD 28,65 · çevre 90 mm | CEK_K1_lahm_3 | SATIN ALMA
CEK_K1_lahm_3_motor_mili | motor mili | 0 | 304 · lazer / lama | alt gövde → Transmotec PD3665 | CEK_K1_lahm_3 | ALT
CEK_K1_lahm_3_motor_gobegi | motor gobegi | 0 | 304 · lazer / lama | alt gövde → Transmotec PD3665 | CEK_K1_lahm_3 | ALT
CEK_K1_lahm_3_motor_reduktor | Motor Transmotec PD3665-24-51-BFEC | 1 | 24 V · planet 51:1 · 127 d/dk · 0,853 N·m · manyetik enkoder · EMC filtreli | Ø36 × 115,5 + enkoder · datasheet: transmotec.com PD3665 | CEK_K1_lahm_3 | SATIN ALMA
CEK_K1_lahm_3_motor_govde | motor govde | 0 |  | alt gövde → Transmotec PD3665 | CEK_K1_lahm_3 | ALT
CEK_K1_lahm_3_enkoder_kapagi | enkoder kapagi | 0 |  | alt gövde → Transmotec PD3665 | CEK_K1_lahm_3 | ALT
CEK_K1_lahm_3_m12_soket | M12 4 pin soket + kablo | 1 | motor + enkoder tek soket · kasada sabit | kablo dikey kanala | CEK_K1_lahm_3 | SATIN ALMA
CEK_K1_lahm_3_motor_braketi | Motor braketi 3 mm | 1 | 304 lazer + büküm · 4 × M3 (Ø31) + arka duvara 2 × M5 | kasnak hizası buradan | CEK_K1_lahm_3 | ÜRETİM
CEK_K1_lahm_3_avara | GT3 avara 30 diş · 6 mm · tek flanşlı (dış) · çift rulman | 1 | alüminyum · 2 × MR126-2RS (6 × 12 × 4: 8 ≤ göbek 9,5 — v8'deki 2 × 625 = 10 sığmıyordu) · v8: iç flanş yok (Gates: iki kasnaklı tahrikte motor kasnağı çift flanşlı → kayış kılavuzu yeter) | z −73 SABİT (strok 628) | CEK_K1_lahm_3 | SATIN ALMA
CEK_K1_lahm_3_avara_mili | Avara mili Ø6 · omuzlu | 1 | 304 · kola somunla (kolun iç yüzünde) · 2 × MR126-2RS taşır | v8b: Ø5 → Ø6 (sıkışma tepesinde 182 → ~108 MPa) | CEK_K1_lahm_3 | ÜRETİM
CEK_K1_lahm_3_avara_kolu | Avara kolu 2 mm · L kesit + ön flanş + arka kulak | 1 | 304 2 mm büküm · üst flanş 12 · ön flanş 20 × 12,7 (K1 / K2 üst çekmecede tavan nedeniyle 18,5): çerçeve sacına 2 × PEM FH4-M3-10 gömme başlı saplama + somun (çerçevenin önü düz, fitil bandı temiz) · arka kulak: sensör lamına 20 bindirme, 2 × M3 perçin | boy 104 (−81…+23), moment kolu 96 · iç raya 1,0 · avaraya 1,3 · kayış gergisi burada: 8 mm yuvalı | CEK_K1_lahm_3 | ÜRETİM
CEK_K1_lahm_3_kayis_GT3 | Kayış GT3 6 mm kapalı çevrim | 1 | ~1482 mm (494 diş) · çelik kordlu | tedarikçi boyu doğrulayacak | CEK_K1_lahm_3 | SATIN ALMA
CEK_K1_lahm_3_kayis_cenesi | Kayış çenesi + kolu | 1 | 304 · kutunun yan duvarına kaynaklı · dişli çene 2 × M3 | kutunun arkasından kasnağa uzanır (strok için) | CEK_K1_lahm_3 | ÜRETİM
CEK_K1_lahm_3_miknatis_ayagi | miknatis ayagi | 1 | 304 · lazer / lama | zarf 6.3 × 2.3 × 28.6 | CEK_K1_lahm_3 | ÜRETİM
CEK_K1_lahm_3_miknatis_57135 | Mıknatıs Littelfuse 57135-000 | 1 | AlNiCo 5 · flanşlı 28,57 × 19,05 × 6,35 | çenenin üstünde | CEK_K1_lahm_3 | SATIN ALMA
CEK_K1_lahm_3_reed_kapali | Reed sensör Littelfuse 59135-010 | 2 | NO · flanşlı 28,57 × 19,05 × 6,35 | KAPALI + AÇIK konum · PLC girişine | CEK_K1_lahm_3 | SATIN ALMA
CEK_K1_lahm_3_reed_acik | reed acik | 0 |  | alt gövde → Littelfuse 59135 | CEK_K1_lahm_3 | ALT
CEK_K1_lahm_3_sensor_lami | Sensör lamı L 6,35 × 8 × 2 + arka tırnak | 1 | 304 büküm · reed sensörler altında · önde avara kolunun arka kulağına 20 bindirme 2 × M3 perçin · arkada 16 geniş tırnakla arka iç saca 2 × M4 perçin somun |  | CEK_K1_lahm_3 | ÜRETİM
CEK_K1_lahm_3_tepsi | Tepsi · 36 çukur Ø80 | 1 | gıda silikonu 10 mm · çukur 7 · kalıp döküm | 530 × 540 | CEK_K1_lahm_3 | ÜRETİM
CEK_K1_lahm_4_on_dis_sac_1.5 | Çekmece önü 40 · kulpsuz · tam kaplama | 1 | dış 304 1,5 bükme (4 kenar + arkada kanal kenarına dönüş) + PU 37,5 köpük + iç panel 304 1,0 · fitil dişi dönüş ile panel arasındaki 6,4 kanala geçer | 698 × 90 | CEK_K1_lahm_4 | ÜRETİM
CEK_K1_lahm_4_on_pu | on pu | 0 | PU köpük (gövdeyle birlikte enjeksiyon) | alt gövde → çekmece önü / kapak katmanı | CEK_K1_lahm_4 | ALT
CEK_K1_lahm_4_on_ic_sac_1.0 | on ic sac 1.0 | 0 | 304 sac · lazer + büküm | alt gövde → çekmece önü / kapak katmanı | CEK_K1_lahm_4 | ALT
CEK_K1_lahm_4_on_fitil | Fitil · geçmeli manyetik profil 21 × 18,5 | 1 | PVC + şerit mıknatıs · kapak iç sacının 6,4'lük kanalına geçer · aletsiz sökülür | çevre 1392 mm · köşeler gönye kaynaklı | CEK_K1_lahm_4 | SATIN ALMA
CEK_K1_lahm_4_kutu_U_1.0 | Çekmece kutusu U 1,0 | 1 | 304 lazer + 2 büküm | 560 × 45 × 629 | CEK_K1_lahm_4 | ÜRETİM
CEK_K1_lahm_4_kutu_arka_1.0 | kutu arka 1.0 | 0 | 304 sac · lazer + büküm | alt gövde → çekmece kutusu | CEK_K1_lahm_4 | ALT
CEK_K1_lahm_4_kutu_on_1.0 | kutu on 1.0 | 0 | 304 sac · lazer + büküm | alt gövde → çekmece kutusu | CEK_K1_lahm_4 | ALT
CEK_K1_lahm_4_on_baglanti_sol | Ön bağlantı köşesi · U 2 mm | 2 | 304 2 mm büküm · kutu önüne punta, kapak iç sacına 2 × M5 perçin somun | ön yüz ayar yuvalı · 17 derin | CEK_K1_lahm_4 | ÜRETİM
CEK_K1_lahm_4_on_baglanti_sag | on baglanti | 0 | 304 · lazer / lama | alt gövde → ön bağlantı köşesi | CEK_K1_lahm_4 | ALT
CEK_K1_lahm_4_ray_adaptor_sol | Ray adaptör lamı 6 mm | 2 | 304 lama · kutuya punta | ray iç profiline 4 × M4 · v8: iç ray boyuyla sınırlı (660'lık kutuda kutu arkada konsol) | CEK_K1_lahm_4 | ÜRETİM
CEK_K1_lahm_4_ray_adaptor_sag | ray adaptor | 0 | 304 · lazer / lama | alt gövde → ray adaptör lamı | CEK_K1_lahm_4 | ALT
CEK_K1_lahm_4_ray_dis_sol | Teleskopik ray Accuride DZ3832-0070 | 2 | 700 · %100 açılır · 3 elemanlı · 45,7 × 12,7 · 45–50 kg (çift) | dış eleman kolon yan duvarına 4 × M5 | CEK_K1_lahm_4 | SATIN ALMA
CEK_K1_lahm_4_ray_ara_sol | ray ara | 0 | 304 · lazer / lama | alt gövde → Accuride DZ3832-0070 (ara eleman) | CEK_K1_lahm_4 | ALT
CEK_K1_lahm_4_ray_ic_sol | ray ic | 0 | 304 · lazer / lama | alt gövde → Accuride DZ3832-0070 (iç eleman) | CEK_K1_lahm_4 | ALT
CEK_K1_lahm_4_ray_dis_sag | ray dis | 0 | 304 · lazer / lama | alt gövde → Accuride DZ3832-0070 | CEK_K1_lahm_4 | ALT
CEK_K1_lahm_4_ray_ara_sag | ray ara | 0 | 304 · lazer / lama | alt gövde → Accuride DZ3832-0070 (ara eleman) | CEK_K1_lahm_4 | ALT
CEK_K1_lahm_4_ray_ic_sag | ray ic | 0 | 304 · lazer / lama | alt gövde → Accuride DZ3832-0070 (iç eleman) | CEK_K1_lahm_4 | ALT
CEK_K1_lahm_4_motor_kasnagi | GT3 kasnak 30 diş · 6 mm · flanşlı | 1 | alüminyum · delik Ø8 H7 + düz | PD 28,65 · çevre 90 mm | CEK_K1_lahm_4 | SATIN ALMA
CEK_K1_lahm_4_motor_mili | motor mili | 0 | 304 · lazer / lama | alt gövde → Transmotec PD3665 | CEK_K1_lahm_4 | ALT
CEK_K1_lahm_4_motor_gobegi | motor gobegi | 0 | 304 · lazer / lama | alt gövde → Transmotec PD3665 | CEK_K1_lahm_4 | ALT
CEK_K1_lahm_4_motor_reduktor | Motor Transmotec PD3665-24-51-BFEC | 1 | 24 V · planet 51:1 · 127 d/dk · 0,853 N·m · manyetik enkoder · EMC filtreli | Ø36 × 115,5 + enkoder · datasheet: transmotec.com PD3665 | CEK_K1_lahm_4 | SATIN ALMA
CEK_K1_lahm_4_motor_govde | motor govde | 0 |  | alt gövde → Transmotec PD3665 | CEK_K1_lahm_4 | ALT
CEK_K1_lahm_4_enkoder_kapagi | enkoder kapagi | 0 |  | alt gövde → Transmotec PD3665 | CEK_K1_lahm_4 | ALT
CEK_K1_lahm_4_m12_soket | M12 4 pin soket + kablo | 1 | motor + enkoder tek soket · kasada sabit | kablo dikey kanala | CEK_K1_lahm_4 | SATIN ALMA
CEK_K1_lahm_4_motor_braketi | Motor braketi 3 mm | 1 | 304 lazer + büküm · 4 × M3 (Ø31) + arka duvara 2 × M5 | kasnak hizası buradan | CEK_K1_lahm_4 | ÜRETİM
CEK_K1_lahm_4_avara | GT3 avara 30 diş · 6 mm · tek flanşlı (dış) · çift rulman | 1 | alüminyum · 2 × MR126-2RS (6 × 12 × 4: 8 ≤ göbek 9,5 — v8'deki 2 × 625 = 10 sığmıyordu) · v8: iç flanş yok (Gates: iki kasnaklı tahrikte motor kasnağı çift flanşlı → kayış kılavuzu yeter) | z −73 SABİT (strok 628) | CEK_K1_lahm_4 | SATIN ALMA
CEK_K1_lahm_4_avara_mili | Avara mili Ø6 · omuzlu | 1 | 304 · kola somunla (kolun iç yüzünde) · 2 × MR126-2RS taşır | v8b: Ø5 → Ø6 (sıkışma tepesinde 182 → ~108 MPa) | CEK_K1_lahm_4 | ÜRETİM
CEK_K1_lahm_4_avara_kolu | Avara kolu 2 mm · L kesit + ön flanş + arka kulak | 1 | 304 2 mm büküm · üst flanş 12 · ön flanş 20 × 12,7 (K1 / K2 üst çekmecede tavan nedeniyle 18,5): çerçeve sacına 2 × PEM FH4-M3-10 gömme başlı saplama + somun (çerçevenin önü düz, fitil bandı temiz) · arka kulak: sensör lamına 20 bindirme, 2 × M3 perçin | boy 104 (−81…+23), moment kolu 96 · iç raya 1,0 · avaraya 1,3 · kayış gergisi burada: 8 mm yuvalı | CEK_K1_lahm_4 | ÜRETİM
CEK_K1_lahm_4_kayis_GT3 | Kayış GT3 6 mm kapalı çevrim | 1 | ~1482 mm (494 diş) · çelik kordlu | tedarikçi boyu doğrulayacak | CEK_K1_lahm_4 | SATIN ALMA
CEK_K1_lahm_4_kayis_cenesi | Kayış çenesi + kolu | 1 | 304 · kutunun yan duvarına kaynaklı · dişli çene 2 × M3 | kutunun arkasından kasnağa uzanır (strok için) | CEK_K1_lahm_4 | ÜRETİM
CEK_K1_lahm_4_miknatis_ayagi | miknatis ayagi | 1 | 304 · lazer / lama | zarf 6.3 × 2.3 × 28.6 | CEK_K1_lahm_4 | ÜRETİM
CEK_K1_lahm_4_miknatis_57135 | Mıknatıs Littelfuse 57135-000 | 1 | AlNiCo 5 · flanşlı 28,57 × 19,05 × 6,35 | çenenin üstünde | CEK_K1_lahm_4 | SATIN ALMA
CEK_K1_lahm_4_reed_kapali | Reed sensör Littelfuse 59135-010 | 2 | NO · flanşlı 28,57 × 19,05 × 6,35 | KAPALI + AÇIK konum · PLC girişine | CEK_K1_lahm_4 | SATIN ALMA
CEK_K1_lahm_4_reed_acik | reed acik | 0 |  | alt gövde → Littelfuse 59135 | CEK_K1_lahm_4 | ALT
CEK_K1_lahm_4_sensor_lami | Sensör lamı L 6,35 × 8 × 2 + arka tırnak | 1 | 304 büküm · reed sensörler altında · önde avara kolunun arka kulağına 20 bindirme 2 × M3 perçin · arkada 16 geniş tırnakla arka iç saca 2 × M4 perçin somun |  | CEK_K1_lahm_4 | ÜRETİM
CEK_K1_lahm_4_tepsi | Tepsi · 36 çukur Ø80 | 1 | gıda silikonu 10 mm · çukur 7 · kalıp döküm | 530 × 540 | CEK_K1_lahm_4 | ÜRETİM
CEK_K1_lahm_5_on_dis_sac_1.5 | Çekmece önü 40 · kulpsuz · tam kaplama | 1 | dış 304 1,5 bükme (4 kenar + arkada kanal kenarına dönüş) + PU 37,5 köpük + iç panel 304 1,0 · fitil dişi dönüş ile panel arasındaki 6,4 kanala geçer | 698 × 90 | CEK_K1_lahm_5 | ÜRETİM
CEK_K1_lahm_5_on_pu | on pu | 0 | PU köpük (gövdeyle birlikte enjeksiyon) | alt gövde → çekmece önü / kapak katmanı | CEK_K1_lahm_5 | ALT
CEK_K1_lahm_5_on_ic_sac_1.0 | on ic sac 1.0 | 0 | 304 sac · lazer + büküm | alt gövde → çekmece önü / kapak katmanı | CEK_K1_lahm_5 | ALT
CEK_K1_lahm_5_on_fitil | Fitil · geçmeli manyetik profil 21 × 18,5 | 1 | PVC + şerit mıknatıs · kapak iç sacının 6,4'lük kanalına geçer · aletsiz sökülür | çevre 1392 mm · köşeler gönye kaynaklı | CEK_K1_lahm_5 | SATIN ALMA
CEK_K1_lahm_5_kutu_U_1.0 | Çekmece kutusu U 1,0 | 1 | 304 lazer + 2 büküm | 560 × 45 × 629 | CEK_K1_lahm_5 | ÜRETİM
CEK_K1_lahm_5_kutu_arka_1.0 | kutu arka 1.0 | 0 | 304 sac · lazer + büküm | alt gövde → çekmece kutusu | CEK_K1_lahm_5 | ALT
CEK_K1_lahm_5_kutu_on_1.0 | kutu on 1.0 | 0 | 304 sac · lazer + büküm | alt gövde → çekmece kutusu | CEK_K1_lahm_5 | ALT
CEK_K1_lahm_5_on_baglanti_sol | Ön bağlantı köşesi · U 2 mm | 2 | 304 2 mm büküm · kutu önüne punta, kapak iç sacına 2 × M5 perçin somun | ön yüz ayar yuvalı · 17 derin | CEK_K1_lahm_5 | ÜRETİM
CEK_K1_lahm_5_on_baglanti_sag | on baglanti | 0 | 304 · lazer / lama | alt gövde → ön bağlantı köşesi | CEK_K1_lahm_5 | ALT
CEK_K1_lahm_5_ray_adaptor_sol | Ray adaptör lamı 6 mm | 2 | 304 lama · kutuya punta | ray iç profiline 4 × M4 · v8: iç ray boyuyla sınırlı (660'lık kutuda kutu arkada konsol) | CEK_K1_lahm_5 | ÜRETİM
CEK_K1_lahm_5_ray_adaptor_sag | ray adaptor | 0 | 304 · lazer / lama | alt gövde → ray adaptör lamı | CEK_K1_lahm_5 | ALT
CEK_K1_lahm_5_ray_dis_sol | Teleskopik ray Accuride DZ3832-0070 | 2 | 700 · %100 açılır · 3 elemanlı · 45,7 × 12,7 · 45–50 kg (çift) | dış eleman kolon yan duvarına 4 × M5 | CEK_K1_lahm_5 | SATIN ALMA
CEK_K1_lahm_5_ray_ara_sol | ray ara | 0 | 304 · lazer / lama | alt gövde → Accuride DZ3832-0070 (ara eleman) | CEK_K1_lahm_5 | ALT
CEK_K1_lahm_5_ray_ic_sol | ray ic | 0 | 304 · lazer / lama | alt gövde → Accuride DZ3832-0070 (iç eleman) | CEK_K1_lahm_5 | ALT
CEK_K1_lahm_5_ray_dis_sag | ray dis | 0 | 304 · lazer / lama | alt gövde → Accuride DZ3832-0070 | CEK_K1_lahm_5 | ALT
CEK_K1_lahm_5_ray_ara_sag | ray ara | 0 | 304 · lazer / lama | alt gövde → Accuride DZ3832-0070 (ara eleman) | CEK_K1_lahm_5 | ALT
CEK_K1_lahm_5_ray_ic_sag | ray ic | 0 | 304 · lazer / lama | alt gövde → Accuride DZ3832-0070 (iç eleman) | CEK_K1_lahm_5 | ALT
CEK_K1_lahm_5_motor_kasnagi | GT3 kasnak 30 diş · 6 mm · flanşlı | 1 | alüminyum · delik Ø8 H7 + düz | PD 28,65 · çevre 90 mm | CEK_K1_lahm_5 | SATIN ALMA
CEK_K1_lahm_5_motor_mili | motor mili | 0 | 304 · lazer / lama | alt gövde → Transmotec PD3665 | CEK_K1_lahm_5 | ALT
CEK_K1_lahm_5_motor_gobegi | motor gobegi | 0 | 304 · lazer / lama | alt gövde → Transmotec PD3665 | CEK_K1_lahm_5 | ALT
CEK_K1_lahm_5_motor_reduktor | Motor Transmotec PD3665-24-51-BFEC | 1 | 24 V · planet 51:1 · 127 d/dk · 0,853 N·m · manyetik enkoder · EMC filtreli | Ø36 × 115,5 + enkoder · datasheet: transmotec.com PD3665 | CEK_K1_lahm_5 | SATIN ALMA
CEK_K1_lahm_5_motor_govde | motor govde | 0 |  | alt gövde → Transmotec PD3665 | CEK_K1_lahm_5 | ALT
CEK_K1_lahm_5_enkoder_kapagi | enkoder kapagi | 0 |  | alt gövde → Transmotec PD3665 | CEK_K1_lahm_5 | ALT
CEK_K1_lahm_5_m12_soket | M12 4 pin soket + kablo | 1 | motor + enkoder tek soket · kasada sabit | kablo dikey kanala | CEK_K1_lahm_5 | SATIN ALMA
CEK_K1_lahm_5_motor_braketi | Motor braketi 3 mm | 1 | 304 lazer + büküm · 4 × M3 (Ø31) + arka duvara 2 × M5 | kasnak hizası buradan | CEK_K1_lahm_5 | ÜRETİM
CEK_K1_lahm_5_avara | GT3 avara 30 diş · 6 mm · tek flanşlı (dış) · çift rulman | 1 | alüminyum · 2 × MR126-2RS (6 × 12 × 4: 8 ≤ göbek 9,5 — v8'deki 2 × 625 = 10 sığmıyordu) · v8: iç flanş yok (Gates: iki kasnaklı tahrikte motor kasnağı çift flanşlı → kayış kılavuzu yeter) | z −73 SABİT (strok 628) | CEK_K1_lahm_5 | SATIN ALMA
CEK_K1_lahm_5_avara_mili | Avara mili Ø6 · omuzlu | 1 | 304 · kola somunla (kolun iç yüzünde) · 2 × MR126-2RS taşır | v8b: Ø5 → Ø6 (sıkışma tepesinde 182 → ~108 MPa) | CEK_K1_lahm_5 | ÜRETİM
CEK_K1_lahm_5_avara_kolu | Avara kolu 2 mm · L kesit + ön flanş + arka kulak | 1 | 304 2 mm büküm · üst flanş 12 · ön flanş 20 × 12,7 (K1 / K2 üst çekmecede tavan nedeniyle 18,5): çerçeve sacına 2 × PEM FH4-M3-10 gömme başlı saplama + somun (çerçevenin önü düz, fitil bandı temiz) · arka kulak: sensör lamına 20 bindirme, 2 × M3 perçin | boy 104 (−81…+23), moment kolu 96 · iç raya 1,0 · avaraya 1,3 · kayış gergisi burada: 8 mm yuvalı | CEK_K1_lahm_5 | ÜRETİM
CEK_K1_lahm_5_kayis_GT3 | Kayış GT3 6 mm kapalı çevrim | 1 | ~1482 mm (494 diş) · çelik kordlu | tedarikçi boyu doğrulayacak | CEK_K1_lahm_5 | SATIN ALMA
CEK_K1_lahm_5_kayis_cenesi | Kayış çenesi + kolu | 1 | 304 · kutunun yan duvarına kaynaklı · dişli çene 2 × M3 | kutunun arkasından kasnağa uzanır (strok için) | CEK_K1_lahm_5 | ÜRETİM
CEK_K1_lahm_5_miknatis_ayagi | miknatis ayagi | 1 | 304 · lazer / lama | zarf 6.3 × 2.3 × 28.6 | CEK_K1_lahm_5 | ÜRETİM
CEK_K1_lahm_5_miknatis_57135 | Mıknatıs Littelfuse 57135-000 | 1 | AlNiCo 5 · flanşlı 28,57 × 19,05 × 6,35 | çenenin üstünde | CEK_K1_lahm_5 | SATIN ALMA
CEK_K1_lahm_5_reed_kapali | Reed sensör Littelfuse 59135-010 | 2 | NO · flanşlı 28,57 × 19,05 × 6,35 | KAPALI + AÇIK konum · PLC girişine | CEK_K1_lahm_5 | SATIN ALMA
CEK_K1_lahm_5_reed_acik | reed acik | 0 |  | alt gövde → Littelfuse 59135 | CEK_K1_lahm_5 | ALT
CEK_K1_lahm_5_sensor_lami | Sensör lamı L 6,35 × 8 × 2 + arka tırnak | 1 | 304 büküm · reed sensörler altında · önde avara kolunun arka kulağına 20 bindirme 2 × M3 perçin · arkada 16 geniş tırnakla arka iç saca 2 × M4 perçin somun |  | CEK_K1_lahm_5 | ÜRETİM
CEK_K1_lahm_5_tepsi | Tepsi · 36 çukur Ø80 | 1 | gıda silikonu 10 mm · çukur 7 · kalıp döküm | 530 × 540 | CEK_K1_lahm_5 | ÜRETİM
CEK_K1_lahm_6_on_dis_sac_1.5 | Çekmece önü 40 · kulpsuz · tam kaplama | 1 | dış 304 1,5 bükme (4 kenar + arkada kanal kenarına dönüş) + PU 37,5 köpük + iç panel 304 1,0 · fitil dişi dönüş ile panel arasındaki 6,4 kanala geçer | 698 × 152 | CEK_K1_lahm_6 | ÜRETİM
CEK_K1_lahm_6_on_pu | on pu | 0 | PU köpük (gövdeyle birlikte enjeksiyon) | alt gövde → çekmece önü / kapak katmanı | CEK_K1_lahm_6 | ALT
CEK_K1_lahm_6_on_ic_sac_1.0 | on ic sac 1.0 | 0 | 304 sac · lazer + büküm | alt gövde → çekmece önü / kapak katmanı | CEK_K1_lahm_6 | ALT
CEK_K1_lahm_6_on_fitil | Fitil · geçmeli manyetik profil 21 × 18,5 | 1 | PVC + şerit mıknatıs · kapak iç sacının 6,4'lük kanalına geçer · aletsiz sökülür | çevre 1392 mm · köşeler gönye kaynaklı | CEK_K1_lahm_6 | SATIN ALMA
CEK_K1_lahm_6_kutu_U_1.0 | Çekmece kutusu U 1,0 | 1 | 304 lazer + 2 büküm | 560 × 45 × 629 | CEK_K1_lahm_6 | ÜRETİM
CEK_K1_lahm_6_kutu_arka_1.0 | kutu arka 1.0 | 0 | 304 sac · lazer + büküm | alt gövde → çekmece kutusu | CEK_K1_lahm_6 | ALT
CEK_K1_lahm_6_kutu_on_1.0 | kutu on 1.0 | 0 | 304 sac · lazer + büküm | alt gövde → çekmece kutusu | CEK_K1_lahm_6 | ALT
CEK_K1_lahm_6_on_baglanti_sol | Ön bağlantı köşesi · U 2 mm | 2 | 304 2 mm büküm · kutu önüne punta, kapak iç sacına 2 × M5 perçin somun | ön yüz ayar yuvalı · 17 derin | CEK_K1_lahm_6 | ÜRETİM
CEK_K1_lahm_6_on_baglanti_sag | on baglanti | 0 | 304 · lazer / lama | alt gövde → ön bağlantı köşesi | CEK_K1_lahm_6 | ALT
CEK_K1_lahm_6_ray_adaptor_sol | Ray adaptör lamı 6 mm | 2 | 304 lama · kutuya punta | ray iç profiline 4 × M4 · v8: iç ray boyuyla sınırlı (660'lık kutuda kutu arkada konsol) | CEK_K1_lahm_6 | ÜRETİM
CEK_K1_lahm_6_ray_adaptor_sag | ray adaptor | 0 | 304 · lazer / lama | alt gövde → ray adaptör lamı | CEK_K1_lahm_6 | ALT
CEK_K1_lahm_6_ray_dis_sol | Teleskopik ray Accuride DZ3832-0070 | 2 | 700 · %100 açılır · 3 elemanlı · 45,7 × 12,7 · 45–50 kg (çift) | dış eleman kolon yan duvarına 4 × M5 | CEK_K1_lahm_6 | SATIN ALMA
CEK_K1_lahm_6_ray_ara_sol | ray ara | 0 | 304 · lazer / lama | alt gövde → Accuride DZ3832-0070 (ara eleman) | CEK_K1_lahm_6 | ALT
CEK_K1_lahm_6_ray_ic_sol | ray ic | 0 | 304 · lazer / lama | alt gövde → Accuride DZ3832-0070 (iç eleman) | CEK_K1_lahm_6 | ALT
CEK_K1_lahm_6_ray_dis_sag | ray dis | 0 | 304 · lazer / lama | alt gövde → Accuride DZ3832-0070 | CEK_K1_lahm_6 | ALT
CEK_K1_lahm_6_ray_ara_sag | ray ara | 0 | 304 · lazer / lama | alt gövde → Accuride DZ3832-0070 (ara eleman) | CEK_K1_lahm_6 | ALT
CEK_K1_lahm_6_ray_ic_sag | ray ic | 0 | 304 · lazer / lama | alt gövde → Accuride DZ3832-0070 (iç eleman) | CEK_K1_lahm_6 | ALT
CEK_K1_lahm_6_motor_kasnagi | GT3 kasnak 30 diş · 6 mm · flanşlı | 1 | alüminyum · delik Ø8 H7 + düz | PD 28,65 · çevre 90 mm | CEK_K1_lahm_6 | SATIN ALMA
CEK_K1_lahm_6_motor_mili | motor mili | 0 | 304 · lazer / lama | alt gövde → Transmotec PD3665 | CEK_K1_lahm_6 | ALT
CEK_K1_lahm_6_motor_gobegi | motor gobegi | 0 | 304 · lazer / lama | alt gövde → Transmotec PD3665 | CEK_K1_lahm_6 | ALT
CEK_K1_lahm_6_motor_reduktor | Motor Transmotec PD3665-24-51-BFEC | 1 | 24 V · planet 51:1 · 127 d/dk · 0,853 N·m · manyetik enkoder · EMC filtreli | Ø36 × 115,5 + enkoder · datasheet: transmotec.com PD3665 | CEK_K1_lahm_6 | SATIN ALMA
CEK_K1_lahm_6_motor_govde | motor govde | 0 |  | alt gövde → Transmotec PD3665 | CEK_K1_lahm_6 | ALT
CEK_K1_lahm_6_enkoder_kapagi | enkoder kapagi | 0 |  | alt gövde → Transmotec PD3665 | CEK_K1_lahm_6 | ALT
CEK_K1_lahm_6_m12_soket | M12 4 pin soket + kablo | 1 | motor + enkoder tek soket · kasada sabit | kablo dikey kanala | CEK_K1_lahm_6 | SATIN ALMA
CEK_K1_lahm_6_motor_braketi | Motor braketi 3 mm | 1 | 304 lazer + büküm · 4 × M3 (Ø31) + arka duvara 2 × M5 | kasnak hizası buradan | CEK_K1_lahm_6 | ÜRETİM
CEK_K1_lahm_6_avara | GT3 avara 30 diş · 6 mm · tek flanşlı (dış) · çift rulman | 1 | alüminyum · 2 × MR126-2RS (6 × 12 × 4: 8 ≤ göbek 9,5 — v8'deki 2 × 625 = 10 sığmıyordu) · v8: iç flanş yok (Gates: iki kasnaklı tahrikte motor kasnağı çift flanşlı → kayış kılavuzu yeter) | z −73 SABİT (strok 628) | CEK_K1_lahm_6 | SATIN ALMA
CEK_K1_lahm_6_avara_mili | Avara mili Ø6 · omuzlu | 1 | 304 · kola somunla (kolun iç yüzünde) · 2 × MR126-2RS taşır | v8b: Ø5 → Ø6 (sıkışma tepesinde 182 → ~108 MPa) | CEK_K1_lahm_6 | ÜRETİM
CEK_K1_lahm_6_avara_kolu | Avara kolu 2 mm · L kesit + ön flanş + arka kulak | 1 | 304 2 mm büküm · üst flanş 12 · ön flanş 20 × 12,7 (K1 / K2 üst çekmecede tavan nedeniyle 18,5): çerçeve sacına 2 × PEM FH4-M3-10 gömme başlı saplama + somun (çerçevenin önü düz, fitil bandı temiz) · arka kulak: sensör lamına 20 bindirme, 2 × M3 perçin | boy 104 (−81…+23), moment kolu 96 · iç raya 1,0 · avaraya 1,3 · kayış gergisi burada: 8 mm yuvalı | CEK_K1_lahm_6 | ÜRETİM
CEK_K1_lahm_6_kayis_GT3 | Kayış GT3 6 mm kapalı çevrim | 1 | ~1482 mm (494 diş) · çelik kordlu | tedarikçi boyu doğrulayacak | CEK_K1_lahm_6 | SATIN ALMA
CEK_K1_lahm_6_kayis_cenesi | Kayış çenesi + kolu | 1 | 304 · kutunun yan duvarına kaynaklı · dişli çene 2 × M3 | kutunun arkasından kasnağa uzanır (strok için) | CEK_K1_lahm_6 | ÜRETİM
CEK_K1_lahm_6_miknatis_ayagi | miknatis ayagi | 1 | 304 · lazer / lama | zarf 6.3 × 2.3 × 28.6 | CEK_K1_lahm_6 | ÜRETİM
CEK_K1_lahm_6_miknatis_57135 | Mıknatıs Littelfuse 57135-000 | 1 | AlNiCo 5 · flanşlı 28,57 × 19,05 × 6,35 | çenenin üstünde | CEK_K1_lahm_6 | SATIN ALMA
CEK_K1_lahm_6_reed_kapali | Reed sensör Littelfuse 59135-010 | 2 | NO · flanşlı 28,57 × 19,05 × 6,35 | KAPALI + AÇIK konum · PLC girişine | CEK_K1_lahm_6 | SATIN ALMA
CEK_K1_lahm_6_reed_acik | reed acik | 0 |  | alt gövde → Littelfuse 59135 | CEK_K1_lahm_6 | ALT
CEK_K1_lahm_6_sensor_lami | Sensör lamı L 6,35 × 8 × 2 + arka tırnak | 1 | 304 büküm · reed sensörler altında · önde avara kolunun arka kulağına 20 bindirme 2 × M3 perçin · arkada 16 geniş tırnakla arka iç saca 2 × M4 perçin somun |  | CEK_K1_lahm_6 | ÜRETİM
CEK_K1_lahm_6_tepsi | Tepsi · 36 çukur Ø80 | 1 | gıda silikonu 10 mm · çukur 7 · kalıp döküm | 530 × 540 | CEK_K1_lahm_6 | ÜRETİM
CEK_K2_lahm_1_on_dis_sac_1.5 | Çekmece önü 40 · kulpsuz · tam kaplama | 1 | dış 304 1,5 bükme (4 kenar + arkada kanal kenarına dönüş) + PU 37,5 köpük + iç panel 304 1,0 · fitil dişi dönüş ile panel arasındaki 6,4 kanala geçer | 652 × 132 | CEK_K2_lahm_1 | ÜRETİM
CEK_K2_lahm_1_on_pu | on pu | 0 | PU köpük (gövdeyle birlikte enjeksiyon) | alt gövde → çekmece önü / kapak katmanı | CEK_K2_lahm_1 | ALT
CEK_K2_lahm_1_on_ic_sac_1.0 | on ic sac 1.0 | 0 | 304 sac · lazer + büküm | alt gövde → çekmece önü / kapak katmanı | CEK_K2_lahm_1 | ALT
CEK_K2_lahm_1_on_fitil | Fitil · geçmeli manyetik profil 21 × 18,5 | 1 | PVC + şerit mıknatıs · kapak iç sacının 6,4'lük kanalına geçer · aletsiz sökülür | çevre 1392 mm · köşeler gönye kaynaklı | CEK_K2_lahm_1 | SATIN ALMA
CEK_K2_lahm_1_kutu_U_1.0 | Çekmece kutusu U 1,0 | 1 | 304 lazer + 2 büküm | 560 × 45 × 629 | CEK_K2_lahm_1 | ÜRETİM
CEK_K2_lahm_1_kutu_arka_1.0 | kutu arka 1.0 | 0 | 304 sac · lazer + büküm | alt gövde → çekmece kutusu | CEK_K2_lahm_1 | ALT
CEK_K2_lahm_1_kutu_on_1.0 | kutu on 1.0 | 0 | 304 sac · lazer + büküm | alt gövde → çekmece kutusu | CEK_K2_lahm_1 | ALT
CEK_K2_lahm_1_on_baglanti_sol | Ön bağlantı köşesi · U 2 mm | 2 | 304 2 mm büküm · kutu önüne punta, kapak iç sacına 2 × M5 perçin somun | ön yüz ayar yuvalı · 17 derin | CEK_K2_lahm_1 | ÜRETİM
CEK_K2_lahm_1_on_baglanti_sag | on baglanti | 0 | 304 · lazer / lama | alt gövde → ön bağlantı köşesi | CEK_K2_lahm_1 | ALT
CEK_K2_lahm_1_ray_adaptor_sol | Ray adaptör lamı 6 mm | 2 | 304 lama · kutuya punta | ray iç profiline 4 × M4 · v8: iç ray boyuyla sınırlı (660'lık kutuda kutu arkada konsol) | CEK_K2_lahm_1 | ÜRETİM
CEK_K2_lahm_1_ray_adaptor_sag | ray adaptor | 0 | 304 · lazer / lama | alt gövde → ray adaptör lamı | CEK_K2_lahm_1 | ALT
CEK_K2_lahm_1_ray_dis_sol | Teleskopik ray Accuride DZ3832-0070 | 2 | 700 · %100 açılır · 3 elemanlı · 45,7 × 12,7 · 45–50 kg (çift) | dış eleman kolon yan duvarına 4 × M5 | CEK_K2_lahm_1 | SATIN ALMA
CEK_K2_lahm_1_ray_ara_sol | ray ara | 0 | 304 · lazer / lama | alt gövde → Accuride DZ3832-0070 (ara eleman) | CEK_K2_lahm_1 | ALT
CEK_K2_lahm_1_ray_ic_sol | ray ic | 0 | 304 · lazer / lama | alt gövde → Accuride DZ3832-0070 (iç eleman) | CEK_K2_lahm_1 | ALT
CEK_K2_lahm_1_ray_dis_sag | ray dis | 0 | 304 · lazer / lama | alt gövde → Accuride DZ3832-0070 | CEK_K2_lahm_1 | ALT
CEK_K2_lahm_1_ray_ara_sag | ray ara | 0 | 304 · lazer / lama | alt gövde → Accuride DZ3832-0070 (ara eleman) | CEK_K2_lahm_1 | ALT
CEK_K2_lahm_1_ray_ic_sag | ray ic | 0 | 304 · lazer / lama | alt gövde → Accuride DZ3832-0070 (iç eleman) | CEK_K2_lahm_1 | ALT
CEK_K2_lahm_1_motor_kasnagi | GT3 kasnak 30 diş · 6 mm · flanşlı | 1 | alüminyum · delik Ø8 H7 + düz | PD 28,65 · çevre 90 mm | CEK_K2_lahm_1 | SATIN ALMA
CEK_K2_lahm_1_motor_mili | motor mili | 0 | 304 · lazer / lama | alt gövde → Transmotec PD3665 | CEK_K2_lahm_1 | ALT
CEK_K2_lahm_1_motor_gobegi | motor gobegi | 0 | 304 · lazer / lama | alt gövde → Transmotec PD3665 | CEK_K2_lahm_1 | ALT
CEK_K2_lahm_1_motor_reduktor | Motor Transmotec PD3665-24-51-BFEC | 1 | 24 V · planet 51:1 · 127 d/dk · 0,853 N·m · manyetik enkoder · EMC filtreli | Ø36 × 115,5 + enkoder · datasheet: transmotec.com PD3665 | CEK_K2_lahm_1 | SATIN ALMA
CEK_K2_lahm_1_motor_govde | motor govde | 0 |  | alt gövde → Transmotec PD3665 | CEK_K2_lahm_1 | ALT
CEK_K2_lahm_1_enkoder_kapagi | enkoder kapagi | 0 |  | alt gövde → Transmotec PD3665 | CEK_K2_lahm_1 | ALT
CEK_K2_lahm_1_m12_soket | M12 4 pin soket + kablo | 1 | motor + enkoder tek soket · kasada sabit | kablo dikey kanala | CEK_K2_lahm_1 | SATIN ALMA
CEK_K2_lahm_1_motor_braketi | Motor braketi 3 mm | 1 | 304 lazer + büküm · 4 × M3 (Ø31) + arka duvara 2 × M5 | kasnak hizası buradan | CEK_K2_lahm_1 | ÜRETİM
CEK_K2_lahm_1_avara | GT3 avara 30 diş · 6 mm · tek flanşlı (dış) · çift rulman | 1 | alüminyum · 2 × MR126-2RS (6 × 12 × 4: 8 ≤ göbek 9,5 — v8'deki 2 × 625 = 10 sığmıyordu) · v8: iç flanş yok (Gates: iki kasnaklı tahrikte motor kasnağı çift flanşlı → kayış kılavuzu yeter) | z −73 SABİT (strok 628) | CEK_K2_lahm_1 | SATIN ALMA
CEK_K2_lahm_1_avara_mili | Avara mili Ø6 · omuzlu | 1 | 304 · kola somunla (kolun iç yüzünde) · 2 × MR126-2RS taşır | v8b: Ø5 → Ø6 (sıkışma tepesinde 182 → ~108 MPa) | CEK_K2_lahm_1 | ÜRETİM
CEK_K2_lahm_1_avara_kolu | Avara kolu 2 mm · L kesit + ön flanş + arka kulak | 1 | 304 2 mm büküm · üst flanş 12 · ön flanş 20 × 12,7 (K1 / K2 üst çekmecede tavan nedeniyle 18,5): çerçeve sacına 2 × PEM FH4-M3-10 gömme başlı saplama + somun (çerçevenin önü düz, fitil bandı temiz) · arka kulak: sensör lamına 20 bindirme, 2 × M3 perçin | boy 104 (−81…+23), moment kolu 96 · iç raya 1,0 · avaraya 1,3 · kayış gergisi burada: 8 mm yuvalı | CEK_K2_lahm_1 | ÜRETİM
CEK_K2_lahm_1_kayis_GT3 | Kayış GT3 6 mm kapalı çevrim | 1 | ~1482 mm (494 diş) · çelik kordlu | tedarikçi boyu doğrulayacak | CEK_K2_lahm_1 | SATIN ALMA
CEK_K2_lahm_1_kayis_cenesi | Kayış çenesi + kolu | 1 | 304 · kutunun yan duvarına kaynaklı · dişli çene 2 × M3 | kutunun arkasından kasnağa uzanır (strok için) | CEK_K2_lahm_1 | ÜRETİM
CEK_K2_lahm_1_miknatis_ayagi | miknatis ayagi | 1 | 304 · lazer / lama | zarf 6.4 × 2.3 × 28.6 | CEK_K2_lahm_1 | ÜRETİM
CEK_K2_lahm_1_miknatis_57135 | Mıknatıs Littelfuse 57135-000 | 1 | AlNiCo 5 · flanşlı 28,57 × 19,05 × 6,35 | çenenin üstünde | CEK_K2_lahm_1 | SATIN ALMA
CEK_K2_lahm_1_reed_kapali | Reed sensör Littelfuse 59135-010 | 2 | NO · flanşlı 28,57 × 19,05 × 6,35 | KAPALI + AÇIK konum · PLC girişine | CEK_K2_lahm_1 | SATIN ALMA
CEK_K2_lahm_1_reed_acik | reed acik | 0 |  | alt gövde → Littelfuse 59135 | CEK_K2_lahm_1 | ALT
CEK_K2_lahm_1_sensor_lami | Sensör lamı L 6,35 × 8 × 2 + arka tırnak | 1 | 304 büküm · reed sensörler altında · önde avara kolunun arka kulağına 20 bindirme 2 × M3 perçin · arkada 16 geniş tırnakla arka iç saca 2 × M4 perçin somun |  | CEK_K2_lahm_1 | ÜRETİM
CEK_K2_lahm_1_tepsi | Tepsi · 36 çukur Ø80 | 1 | gıda silikonu 10 mm · çukur 7 · kalıp döküm | 530 × 540 | CEK_K2_lahm_1 | ÜRETİM
CEK_K2_lahm_2_on_dis_sac_1.5 | Çekmece önü 40 · kulpsuz · tam kaplama | 1 | dış 304 1,5 bükme (4 kenar + arkada kanal kenarına dönüş) + PU 37,5 köpük + iç panel 304 1,0 · fitil dişi dönüş ile panel arasındaki 6,4 kanala geçer | 652 × 90 | CEK_K2_lahm_2 | ÜRETİM
CEK_K2_lahm_2_on_pu | on pu | 0 | PU köpük (gövdeyle birlikte enjeksiyon) | alt gövde → çekmece önü / kapak katmanı | CEK_K2_lahm_2 | ALT
CEK_K2_lahm_2_on_ic_sac_1.0 | on ic sac 1.0 | 0 | 304 sac · lazer + büküm | alt gövde → çekmece önü / kapak katmanı | CEK_K2_lahm_2 | ALT
CEK_K2_lahm_2_on_fitil | Fitil · geçmeli manyetik profil 21 × 18,5 | 1 | PVC + şerit mıknatıs · kapak iç sacının 6,4'lük kanalına geçer · aletsiz sökülür | çevre 1392 mm · köşeler gönye kaynaklı | CEK_K2_lahm_2 | SATIN ALMA
CEK_K2_lahm_2_kutu_U_1.0 | Çekmece kutusu U 1,0 | 1 | 304 lazer + 2 büküm | 560 × 45 × 629 | CEK_K2_lahm_2 | ÜRETİM
CEK_K2_lahm_2_kutu_arka_1.0 | kutu arka 1.0 | 0 | 304 sac · lazer + büküm | alt gövde → çekmece kutusu | CEK_K2_lahm_2 | ALT
CEK_K2_lahm_2_kutu_on_1.0 | kutu on 1.0 | 0 | 304 sac · lazer + büküm | alt gövde → çekmece kutusu | CEK_K2_lahm_2 | ALT
CEK_K2_lahm_2_on_baglanti_sol | Ön bağlantı köşesi · U 2 mm | 2 | 304 2 mm büküm · kutu önüne punta, kapak iç sacına 2 × M5 perçin somun | ön yüz ayar yuvalı · 17 derin | CEK_K2_lahm_2 | ÜRETİM
CEK_K2_lahm_2_on_baglanti_sag | on baglanti | 0 | 304 · lazer / lama | alt gövde → ön bağlantı köşesi | CEK_K2_lahm_2 | ALT
CEK_K2_lahm_2_ray_adaptor_sol | Ray adaptör lamı 6 mm | 2 | 304 lama · kutuya punta | ray iç profiline 4 × M4 · v8: iç ray boyuyla sınırlı (660'lık kutuda kutu arkada konsol) | CEK_K2_lahm_2 | ÜRETİM
CEK_K2_lahm_2_ray_adaptor_sag | ray adaptor | 0 | 304 · lazer / lama | alt gövde → ray adaptör lamı | CEK_K2_lahm_2 | ALT
CEK_K2_lahm_2_ray_dis_sol | Teleskopik ray Accuride DZ3832-0070 | 2 | 700 · %100 açılır · 3 elemanlı · 45,7 × 12,7 · 45–50 kg (çift) | dış eleman kolon yan duvarına 4 × M5 | CEK_K2_lahm_2 | SATIN ALMA
CEK_K2_lahm_2_ray_ara_sol | ray ara | 0 | 304 · lazer / lama | alt gövde → Accuride DZ3832-0070 (ara eleman) | CEK_K2_lahm_2 | ALT
CEK_K2_lahm_2_ray_ic_sol | ray ic | 0 | 304 · lazer / lama | alt gövde → Accuride DZ3832-0070 (iç eleman) | CEK_K2_lahm_2 | ALT
CEK_K2_lahm_2_ray_dis_sag | ray dis | 0 | 304 · lazer / lama | alt gövde → Accuride DZ3832-0070 | CEK_K2_lahm_2 | ALT
CEK_K2_lahm_2_ray_ara_sag | ray ara | 0 | 304 · lazer / lama | alt gövde → Accuride DZ3832-0070 (ara eleman) | CEK_K2_lahm_2 | ALT
CEK_K2_lahm_2_ray_ic_sag | ray ic | 0 | 304 · lazer / lama | alt gövde → Accuride DZ3832-0070 (iç eleman) | CEK_K2_lahm_2 | ALT
CEK_K2_lahm_2_motor_kasnagi | GT3 kasnak 30 diş · 6 mm · flanşlı | 1 | alüminyum · delik Ø8 H7 + düz | PD 28,65 · çevre 90 mm | CEK_K2_lahm_2 | SATIN ALMA
CEK_K2_lahm_2_motor_mili | motor mili | 0 | 304 · lazer / lama | alt gövde → Transmotec PD3665 | CEK_K2_lahm_2 | ALT
CEK_K2_lahm_2_motor_gobegi | motor gobegi | 0 | 304 · lazer / lama | alt gövde → Transmotec PD3665 | CEK_K2_lahm_2 | ALT
CEK_K2_lahm_2_motor_reduktor | Motor Transmotec PD3665-24-51-BFEC | 1 | 24 V · planet 51:1 · 127 d/dk · 0,853 N·m · manyetik enkoder · EMC filtreli | Ø36 × 115,5 + enkoder · datasheet: transmotec.com PD3665 | CEK_K2_lahm_2 | SATIN ALMA
CEK_K2_lahm_2_motor_govde | motor govde | 0 |  | alt gövde → Transmotec PD3665 | CEK_K2_lahm_2 | ALT
CEK_K2_lahm_2_enkoder_kapagi | enkoder kapagi | 0 |  | alt gövde → Transmotec PD3665 | CEK_K2_lahm_2 | ALT
CEK_K2_lahm_2_m12_soket | M12 4 pin soket + kablo | 1 | motor + enkoder tek soket · kasada sabit | kablo dikey kanala | CEK_K2_lahm_2 | SATIN ALMA
CEK_K2_lahm_2_motor_braketi | Motor braketi 3 mm | 1 | 304 lazer + büküm · 4 × M3 (Ø31) + arka duvara 2 × M5 | kasnak hizası buradan | CEK_K2_lahm_2 | ÜRETİM
CEK_K2_lahm_2_avara | GT3 avara 30 diş · 6 mm · tek flanşlı (dış) · çift rulman | 1 | alüminyum · 2 × MR126-2RS (6 × 12 × 4: 8 ≤ göbek 9,5 — v8'deki 2 × 625 = 10 sığmıyordu) · v8: iç flanş yok (Gates: iki kasnaklı tahrikte motor kasnağı çift flanşlı → kayış kılavuzu yeter) | z −73 SABİT (strok 628) | CEK_K2_lahm_2 | SATIN ALMA
CEK_K2_lahm_2_avara_mili | Avara mili Ø6 · omuzlu | 1 | 304 · kola somunla (kolun iç yüzünde) · 2 × MR126-2RS taşır | v8b: Ø5 → Ø6 (sıkışma tepesinde 182 → ~108 MPa) | CEK_K2_lahm_2 | ÜRETİM
CEK_K2_lahm_2_avara_kolu | Avara kolu 2 mm · L kesit + ön flanş + arka kulak | 1 | 304 2 mm büküm · üst flanş 12 · ön flanş 20 × 12,7 (K1 / K2 üst çekmecede tavan nedeniyle 18,5): çerçeve sacına 2 × PEM FH4-M3-10 gömme başlı saplama + somun (çerçevenin önü düz, fitil bandı temiz) · arka kulak: sensör lamına 20 bindirme, 2 × M3 perçin | boy 104 (−81…+23), moment kolu 96 · iç raya 1,0 · avaraya 1,3 · kayış gergisi burada: 8 mm yuvalı | CEK_K2_lahm_2 | ÜRETİM
CEK_K2_lahm_2_kayis_GT3 | Kayış GT3 6 mm kapalı çevrim | 1 | ~1482 mm (494 diş) · çelik kordlu | tedarikçi boyu doğrulayacak | CEK_K2_lahm_2 | SATIN ALMA
CEK_K2_lahm_2_kayis_cenesi | Kayış çenesi + kolu | 1 | 304 · kutunun yan duvarına kaynaklı · dişli çene 2 × M3 | kutunun arkasından kasnağa uzanır (strok için) | CEK_K2_lahm_2 | ÜRETİM
CEK_K2_lahm_2_miknatis_ayagi | miknatis ayagi | 1 | 304 · lazer / lama | zarf 6.4 × 2.3 × 28.6 | CEK_K2_lahm_2 | ÜRETİM
CEK_K2_lahm_2_miknatis_57135 | Mıknatıs Littelfuse 57135-000 | 1 | AlNiCo 5 · flanşlı 28,57 × 19,05 × 6,35 | çenenin üstünde | CEK_K2_lahm_2 | SATIN ALMA
CEK_K2_lahm_2_reed_kapali | Reed sensör Littelfuse 59135-010 | 2 | NO · flanşlı 28,57 × 19,05 × 6,35 | KAPALI + AÇIK konum · PLC girişine | CEK_K2_lahm_2 | SATIN ALMA
CEK_K2_lahm_2_reed_acik | reed acik | 0 |  | alt gövde → Littelfuse 59135 | CEK_K2_lahm_2 | ALT
CEK_K2_lahm_2_sensor_lami | Sensör lamı L 6,35 × 8 × 2 + arka tırnak | 1 | 304 büküm · reed sensörler altında · önde avara kolunun arka kulağına 20 bindirme 2 × M3 perçin · arkada 16 geniş tırnakla arka iç saca 2 × M4 perçin somun |  | CEK_K2_lahm_2 | ÜRETİM
CEK_K2_lahm_2_tepsi | Tepsi · 36 çukur Ø80 | 1 | gıda silikonu 10 mm · çukur 7 · kalıp döküm | 530 × 540 | CEK_K2_lahm_2 | ÜRETİM
CEK_K2_lahm_3_on_dis_sac_1.5 | Çekmece önü 40 · kulpsuz · tam kaplama | 1 | dış 304 1,5 bükme (4 kenar + arkada kanal kenarına dönüş) + PU 37,5 köpük + iç panel 304 1,0 · fitil dişi dönüş ile panel arasındaki 6,4 kanala geçer | 652 × 90 | CEK_K2_lahm_3 | ÜRETİM
CEK_K2_lahm_3_on_pu | on pu | 0 | PU köpük (gövdeyle birlikte enjeksiyon) | alt gövde → çekmece önü / kapak katmanı | CEK_K2_lahm_3 | ALT
CEK_K2_lahm_3_on_ic_sac_1.0 | on ic sac 1.0 | 0 | 304 sac · lazer + büküm | alt gövde → çekmece önü / kapak katmanı | CEK_K2_lahm_3 | ALT
CEK_K2_lahm_3_on_fitil | Fitil · geçmeli manyetik profil 21 × 18,5 | 1 | PVC + şerit mıknatıs · kapak iç sacının 6,4'lük kanalına geçer · aletsiz sökülür | çevre 1392 mm · köşeler gönye kaynaklı | CEK_K2_lahm_3 | SATIN ALMA
CEK_K2_lahm_3_kutu_U_1.0 | Çekmece kutusu U 1,0 | 1 | 304 lazer + 2 büküm | 560 × 45 × 629 | CEK_K2_lahm_3 | ÜRETİM
CEK_K2_lahm_3_kutu_arka_1.0 | kutu arka 1.0 | 0 | 304 sac · lazer + büküm | alt gövde → çekmece kutusu | CEK_K2_lahm_3 | ALT
CEK_K2_lahm_3_kutu_on_1.0 | kutu on 1.0 | 0 | 304 sac · lazer + büküm | alt gövde → çekmece kutusu | CEK_K2_lahm_3 | ALT
CEK_K2_lahm_3_on_baglanti_sol | Ön bağlantı köşesi · U 2 mm | 2 | 304 2 mm büküm · kutu önüne punta, kapak iç sacına 2 × M5 perçin somun | ön yüz ayar yuvalı · 17 derin | CEK_K2_lahm_3 | ÜRETİM
CEK_K2_lahm_3_on_baglanti_sag | on baglanti | 0 | 304 · lazer / lama | alt gövde → ön bağlantı köşesi | CEK_K2_lahm_3 | ALT
CEK_K2_lahm_3_ray_adaptor_sol | Ray adaptör lamı 6 mm | 2 | 304 lama · kutuya punta | ray iç profiline 4 × M4 · v8: iç ray boyuyla sınırlı (660'lık kutuda kutu arkada konsol) | CEK_K2_lahm_3 | ÜRETİM
CEK_K2_lahm_3_ray_adaptor_sag | ray adaptor | 0 | 304 · lazer / lama | alt gövde → ray adaptör lamı | CEK_K2_lahm_3 | ALT
CEK_K2_lahm_3_ray_dis_sol | Teleskopik ray Accuride DZ3832-0070 | 2 | 700 · %100 açılır · 3 elemanlı · 45,7 × 12,7 · 45–50 kg (çift) | dış eleman kolon yan duvarına 4 × M5 | CEK_K2_lahm_3 | SATIN ALMA
CEK_K2_lahm_3_ray_ara_sol | ray ara | 0 | 304 · lazer / lama | alt gövde → Accuride DZ3832-0070 (ara eleman) | CEK_K2_lahm_3 | ALT
CEK_K2_lahm_3_ray_ic_sol | ray ic | 0 | 304 · lazer / lama | alt gövde → Accuride DZ3832-0070 (iç eleman) | CEK_K2_lahm_3 | ALT
CEK_K2_lahm_3_ray_dis_sag | ray dis | 0 | 304 · lazer / lama | alt gövde → Accuride DZ3832-0070 | CEK_K2_lahm_3 | ALT
CEK_K2_lahm_3_ray_ara_sag | ray ara | 0 | 304 · lazer / lama | alt gövde → Accuride DZ3832-0070 (ara eleman) | CEK_K2_lahm_3 | ALT
CEK_K2_lahm_3_ray_ic_sag | ray ic | 0 | 304 · lazer / lama | alt gövde → Accuride DZ3832-0070 (iç eleman) | CEK_K2_lahm_3 | ALT
CEK_K2_lahm_3_motor_kasnagi | GT3 kasnak 30 diş · 6 mm · flanşlı | 1 | alüminyum · delik Ø8 H7 + düz | PD 28,65 · çevre 90 mm | CEK_K2_lahm_3 | SATIN ALMA
CEK_K2_lahm_3_motor_mili | motor mili | 0 | 304 · lazer / lama | alt gövde → Transmotec PD3665 | CEK_K2_lahm_3 | ALT
CEK_K2_lahm_3_motor_gobegi | motor gobegi | 0 | 304 · lazer / lama | alt gövde → Transmotec PD3665 | CEK_K2_lahm_3 | ALT
CEK_K2_lahm_3_motor_reduktor | Motor Transmotec PD3665-24-51-BFEC | 1 | 24 V · planet 51:1 · 127 d/dk · 0,853 N·m · manyetik enkoder · EMC filtreli | Ø36 × 115,5 + enkoder · datasheet: transmotec.com PD3665 | CEK_K2_lahm_3 | SATIN ALMA
CEK_K2_lahm_3_motor_govde | motor govde | 0 |  | alt gövde → Transmotec PD3665 | CEK_K2_lahm_3 | ALT
CEK_K2_lahm_3_enkoder_kapagi | enkoder kapagi | 0 |  | alt gövde → Transmotec PD3665 | CEK_K2_lahm_3 | ALT
CEK_K2_lahm_3_m12_soket | M12 4 pin soket + kablo | 1 | motor + enkoder tek soket · kasada sabit | kablo dikey kanala | CEK_K2_lahm_3 | SATIN ALMA
CEK_K2_lahm_3_motor_braketi | Motor braketi 3 mm | 1 | 304 lazer + büküm · 4 × M3 (Ø31) + arka duvara 2 × M5 | kasnak hizası buradan | CEK_K2_lahm_3 | ÜRETİM
CEK_K2_lahm_3_avara | GT3 avara 30 diş · 6 mm · tek flanşlı (dış) · çift rulman | 1 | alüminyum · 2 × MR126-2RS (6 × 12 × 4: 8 ≤ göbek 9,5 — v8'deki 2 × 625 = 10 sığmıyordu) · v8: iç flanş yok (Gates: iki kasnaklı tahrikte motor kasnağı çift flanşlı → kayış kılavuzu yeter) | z −73 SABİT (strok 628) | CEK_K2_lahm_3 | SATIN ALMA
CEK_K2_lahm_3_avara_mili | Avara mili Ø6 · omuzlu | 1 | 304 · kola somunla (kolun iç yüzünde) · 2 × MR126-2RS taşır | v8b: Ø5 → Ø6 (sıkışma tepesinde 182 → ~108 MPa) | CEK_K2_lahm_3 | ÜRETİM
CEK_K2_lahm_3_avara_kolu | Avara kolu 2 mm · L kesit + ön flanş + arka kulak | 1 | 304 2 mm büküm · üst flanş 12 · ön flanş 20 × 12,7 (K1 / K2 üst çekmecede tavan nedeniyle 18,5): çerçeve sacına 2 × PEM FH4-M3-10 gömme başlı saplama + somun (çerçevenin önü düz, fitil bandı temiz) · arka kulak: sensör lamına 20 bindirme, 2 × M3 perçin | boy 104 (−81…+23), moment kolu 96 · iç raya 1,0 · avaraya 1,3 · kayış gergisi burada: 8 mm yuvalı | CEK_K2_lahm_3 | ÜRETİM
CEK_K2_lahm_3_kayis_GT3 | Kayış GT3 6 mm kapalı çevrim | 1 | ~1482 mm (494 diş) · çelik kordlu | tedarikçi boyu doğrulayacak | CEK_K2_lahm_3 | SATIN ALMA
CEK_K2_lahm_3_kayis_cenesi | Kayış çenesi + kolu | 1 | 304 · kutunun yan duvarına kaynaklı · dişli çene 2 × M3 | kutunun arkasından kasnağa uzanır (strok için) | CEK_K2_lahm_3 | ÜRETİM
CEK_K2_lahm_3_miknatis_ayagi | miknatis ayagi | 1 | 304 · lazer / lama | zarf 6.4 × 2.3 × 28.6 | CEK_K2_lahm_3 | ÜRETİM
CEK_K2_lahm_3_miknatis_57135 | Mıknatıs Littelfuse 57135-000 | 1 | AlNiCo 5 · flanşlı 28,57 × 19,05 × 6,35 | çenenin üstünde | CEK_K2_lahm_3 | SATIN ALMA
CEK_K2_lahm_3_reed_kapali | Reed sensör Littelfuse 59135-010 | 2 | NO · flanşlı 28,57 × 19,05 × 6,35 | KAPALI + AÇIK konum · PLC girişine | CEK_K2_lahm_3 | SATIN ALMA
CEK_K2_lahm_3_reed_acik | reed acik | 0 |  | alt gövde → Littelfuse 59135 | CEK_K2_lahm_3 | ALT
CEK_K2_lahm_3_sensor_lami | Sensör lamı L 6,35 × 8 × 2 + arka tırnak | 1 | 304 büküm · reed sensörler altında · önde avara kolunun arka kulağına 20 bindirme 2 × M3 perçin · arkada 16 geniş tırnakla arka iç saca 2 × M4 perçin somun |  | CEK_K2_lahm_3 | ÜRETİM
CEK_K2_lahm_3_tepsi | Tepsi · 36 çukur Ø80 | 1 | gıda silikonu 10 mm · çukur 7 · kalıp döküm | 530 × 540 | CEK_K2_lahm_3 | ÜRETİM
CEK_K2_lahm_4_on_dis_sac_1.5 | Çekmece önü 40 · kulpsuz · tam kaplama | 1 | dış 304 1,5 bükme (4 kenar + arkada kanal kenarına dönüş) + PU 37,5 köpük + iç panel 304 1,0 · fitil dişi dönüş ile panel arasındaki 6,4 kanala geçer | 652 × 90 | CEK_K2_lahm_4 | ÜRETİM
CEK_K2_lahm_4_on_pu | on pu | 0 | PU köpük (gövdeyle birlikte enjeksiyon) | alt gövde → çekmece önü / kapak katmanı | CEK_K2_lahm_4 | ALT
CEK_K2_lahm_4_on_ic_sac_1.0 | on ic sac 1.0 | 0 | 304 sac · lazer + büküm | alt gövde → çekmece önü / kapak katmanı | CEK_K2_lahm_4 | ALT
CEK_K2_lahm_4_on_fitil | Fitil · geçmeli manyetik profil 21 × 18,5 | 1 | PVC + şerit mıknatıs · kapak iç sacının 6,4'lük kanalına geçer · aletsiz sökülür | çevre 1392 mm · köşeler gönye kaynaklı | CEK_K2_lahm_4 | SATIN ALMA
CEK_K2_lahm_4_kutu_U_1.0 | Çekmece kutusu U 1,0 | 1 | 304 lazer + 2 büküm | 560 × 45 × 629 | CEK_K2_lahm_4 | ÜRETİM
CEK_K2_lahm_4_kutu_arka_1.0 | kutu arka 1.0 | 0 | 304 sac · lazer + büküm | alt gövde → çekmece kutusu | CEK_K2_lahm_4 | ALT
CEK_K2_lahm_4_kutu_on_1.0 | kutu on 1.0 | 0 | 304 sac · lazer + büküm | alt gövde → çekmece kutusu | CEK_K2_lahm_4 | ALT
CEK_K2_lahm_4_on_baglanti_sol | Ön bağlantı köşesi · U 2 mm | 2 | 304 2 mm büküm · kutu önüne punta, kapak iç sacına 2 × M5 perçin somun | ön yüz ayar yuvalı · 17 derin | CEK_K2_lahm_4 | ÜRETİM
CEK_K2_lahm_4_on_baglanti_sag | on baglanti | 0 | 304 · lazer / lama | alt gövde → ön bağlantı köşesi | CEK_K2_lahm_4 | ALT
CEK_K2_lahm_4_ray_adaptor_sol | Ray adaptör lamı 6 mm | 2 | 304 lama · kutuya punta | ray iç profiline 4 × M4 · v8: iç ray boyuyla sınırlı (660'lık kutuda kutu arkada konsol) | CEK_K2_lahm_4 | ÜRETİM
CEK_K2_lahm_4_ray_adaptor_sag | ray adaptor | 0 | 304 · lazer / lama | alt gövde → ray adaptör lamı | CEK_K2_lahm_4 | ALT
CEK_K2_lahm_4_ray_dis_sol | Teleskopik ray Accuride DZ3832-0070 | 2 | 700 · %100 açılır · 3 elemanlı · 45,7 × 12,7 · 45–50 kg (çift) | dış eleman kolon yan duvarına 4 × M5 | CEK_K2_lahm_4 | SATIN ALMA
CEK_K2_lahm_4_ray_ara_sol | ray ara | 0 | 304 · lazer / lama | alt gövde → Accuride DZ3832-0070 (ara eleman) | CEK_K2_lahm_4 | ALT
CEK_K2_lahm_4_ray_ic_sol | ray ic | 0 | 304 · lazer / lama | alt gövde → Accuride DZ3832-0070 (iç eleman) | CEK_K2_lahm_4 | ALT
CEK_K2_lahm_4_ray_dis_sag | ray dis | 0 | 304 · lazer / lama | alt gövde → Accuride DZ3832-0070 | CEK_K2_lahm_4 | ALT
CEK_K2_lahm_4_ray_ara_sag | ray ara | 0 | 304 · lazer / lama | alt gövde → Accuride DZ3832-0070 (ara eleman) | CEK_K2_lahm_4 | ALT
CEK_K2_lahm_4_ray_ic_sag | ray ic | 0 | 304 · lazer / lama | alt gövde → Accuride DZ3832-0070 (iç eleman) | CEK_K2_lahm_4 | ALT
CEK_K2_lahm_4_motor_kasnagi | GT3 kasnak 30 diş · 6 mm · flanşlı | 1 | alüminyum · delik Ø8 H7 + düz | PD 28,65 · çevre 90 mm | CEK_K2_lahm_4 | SATIN ALMA
CEK_K2_lahm_4_motor_mili | motor mili | 0 | 304 · lazer / lama | alt gövde → Transmotec PD3665 | CEK_K2_lahm_4 | ALT
CEK_K2_lahm_4_motor_gobegi | motor gobegi | 0 | 304 · lazer / lama | alt gövde → Transmotec PD3665 | CEK_K2_lahm_4 | ALT
CEK_K2_lahm_4_motor_reduktor | Motor Transmotec PD3665-24-51-BFEC | 1 | 24 V · planet 51:1 · 127 d/dk · 0,853 N·m · manyetik enkoder · EMC filtreli | Ø36 × 115,5 + enkoder · datasheet: transmotec.com PD3665 | CEK_K2_lahm_4 | SATIN ALMA
CEK_K2_lahm_4_motor_govde | motor govde | 0 |  | alt gövde → Transmotec PD3665 | CEK_K2_lahm_4 | ALT
CEK_K2_lahm_4_enkoder_kapagi | enkoder kapagi | 0 |  | alt gövde → Transmotec PD3665 | CEK_K2_lahm_4 | ALT
CEK_K2_lahm_4_m12_soket | M12 4 pin soket + kablo | 1 | motor + enkoder tek soket · kasada sabit | kablo dikey kanala | CEK_K2_lahm_4 | SATIN ALMA
CEK_K2_lahm_4_motor_braketi | Motor braketi 3 mm | 1 | 304 lazer + büküm · 4 × M3 (Ø31) + arka duvara 2 × M5 | kasnak hizası buradan | CEK_K2_lahm_4 | ÜRETİM
CEK_K2_lahm_4_avara | GT3 avara 30 diş · 6 mm · tek flanşlı (dış) · çift rulman | 1 | alüminyum · 2 × MR126-2RS (6 × 12 × 4: 8 ≤ göbek 9,5 — v8'deki 2 × 625 = 10 sığmıyordu) · v8: iç flanş yok (Gates: iki kasnaklı tahrikte motor kasnağı çift flanşlı → kayış kılavuzu yeter) | z −73 SABİT (strok 628) | CEK_K2_lahm_4 | SATIN ALMA
CEK_K2_lahm_4_avara_mili | Avara mili Ø6 · omuzlu | 1 | 304 · kola somunla (kolun iç yüzünde) · 2 × MR126-2RS taşır | v8b: Ø5 → Ø6 (sıkışma tepesinde 182 → ~108 MPa) | CEK_K2_lahm_4 | ÜRETİM
CEK_K2_lahm_4_avara_kolu | Avara kolu 2 mm · L kesit + ön flanş + arka kulak | 1 | 304 2 mm büküm · üst flanş 12 · ön flanş 20 × 12,7 (K1 / K2 üst çekmecede tavan nedeniyle 18,5): çerçeve sacına 2 × PEM FH4-M3-10 gömme başlı saplama + somun (çerçevenin önü düz, fitil bandı temiz) · arka kulak: sensör lamına 20 bindirme, 2 × M3 perçin | boy 104 (−81…+23), moment kolu 96 · iç raya 1,0 · avaraya 1,3 · kayış gergisi burada: 8 mm yuvalı | CEK_K2_lahm_4 | ÜRETİM
CEK_K2_lahm_4_kayis_GT3 | Kayış GT3 6 mm kapalı çevrim | 1 | ~1482 mm (494 diş) · çelik kordlu | tedarikçi boyu doğrulayacak | CEK_K2_lahm_4 | SATIN ALMA
CEK_K2_lahm_4_kayis_cenesi | Kayış çenesi + kolu | 1 | 304 · kutunun yan duvarına kaynaklı · dişli çene 2 × M3 | kutunun arkasından kasnağa uzanır (strok için) | CEK_K2_lahm_4 | ÜRETİM
CEK_K2_lahm_4_miknatis_ayagi | miknatis ayagi | 1 | 304 · lazer / lama | zarf 6.4 × 2.3 × 28.6 | CEK_K2_lahm_4 | ÜRETİM
CEK_K2_lahm_4_miknatis_57135 | Mıknatıs Littelfuse 57135-000 | 1 | AlNiCo 5 · flanşlı 28,57 × 19,05 × 6,35 | çenenin üstünde | CEK_K2_lahm_4 | SATIN ALMA
CEK_K2_lahm_4_reed_kapali | Reed sensör Littelfuse 59135-010 | 2 | NO · flanşlı 28,57 × 19,05 × 6,35 | KAPALI + AÇIK konum · PLC girişine | CEK_K2_lahm_4 | SATIN ALMA
CEK_K2_lahm_4_reed_acik | reed acik | 0 |  | alt gövde → Littelfuse 59135 | CEK_K2_lahm_4 | ALT
CEK_K2_lahm_4_sensor_lami | Sensör lamı L 6,35 × 8 × 2 + arka tırnak | 1 | 304 büküm · reed sensörler altında · önde avara kolunun arka kulağına 20 bindirme 2 × M3 perçin · arkada 16 geniş tırnakla arka iç saca 2 × M4 perçin somun |  | CEK_K2_lahm_4 | ÜRETİM
CEK_K2_lahm_4_tepsi | Tepsi · 36 çukur Ø80 | 1 | gıda silikonu 10 mm · çukur 7 · kalıp döküm | 530 × 540 | CEK_K2_lahm_4 | ÜRETİM
CEK_K2_lahm_5_on_dis_sac_1.5 | Çekmece önü 40 · kulpsuz · tam kaplama | 1 | dış 304 1,5 bükme (4 kenar + arkada kanal kenarına dönüş) + PU 37,5 köpük + iç panel 304 1,0 · fitil dişi dönüş ile panel arasındaki 6,4 kanala geçer | 652 × 90 | CEK_K2_lahm_5 | ÜRETİM
CEK_K2_lahm_5_on_pu | on pu | 0 | PU köpük (gövdeyle birlikte enjeksiyon) | alt gövde → çekmece önü / kapak katmanı | CEK_K2_lahm_5 | ALT
CEK_K2_lahm_5_on_ic_sac_1.0 | on ic sac 1.0 | 0 | 304 sac · lazer + büküm | alt gövde → çekmece önü / kapak katmanı | CEK_K2_lahm_5 | ALT
CEK_K2_lahm_5_on_fitil | Fitil · geçmeli manyetik profil 21 × 18,5 | 1 | PVC + şerit mıknatıs · kapak iç sacının 6,4'lük kanalına geçer · aletsiz sökülür | çevre 1392 mm · köşeler gönye kaynaklı | CEK_K2_lahm_5 | SATIN ALMA
CEK_K2_lahm_5_kutu_U_1.0 | Çekmece kutusu U 1,0 | 1 | 304 lazer + 2 büküm | 560 × 45 × 629 | CEK_K2_lahm_5 | ÜRETİM
CEK_K2_lahm_5_kutu_arka_1.0 | kutu arka 1.0 | 0 | 304 sac · lazer + büküm | alt gövde → çekmece kutusu | CEK_K2_lahm_5 | ALT
CEK_K2_lahm_5_kutu_on_1.0 | kutu on 1.0 | 0 | 304 sac · lazer + büküm | alt gövde → çekmece kutusu | CEK_K2_lahm_5 | ALT
CEK_K2_lahm_5_on_baglanti_sol | Ön bağlantı köşesi · U 2 mm | 2 | 304 2 mm büküm · kutu önüne punta, kapak iç sacına 2 × M5 perçin somun | ön yüz ayar yuvalı · 17 derin | CEK_K2_lahm_5 | ÜRETİM
CEK_K2_lahm_5_on_baglanti_sag | on baglanti | 0 | 304 · lazer / lama | alt gövde → ön bağlantı köşesi | CEK_K2_lahm_5 | ALT
CEK_K2_lahm_5_ray_adaptor_sol | Ray adaptör lamı 6 mm | 2 | 304 lama · kutuya punta | ray iç profiline 4 × M4 · v8: iç ray boyuyla sınırlı (660'lık kutuda kutu arkada konsol) | CEK_K2_lahm_5 | ÜRETİM
CEK_K2_lahm_5_ray_adaptor_sag | ray adaptor | 0 | 304 · lazer / lama | alt gövde → ray adaptör lamı | CEK_K2_lahm_5 | ALT
CEK_K2_lahm_5_ray_dis_sol | Teleskopik ray Accuride DZ3832-0070 | 2 | 700 · %100 açılır · 3 elemanlı · 45,7 × 12,7 · 45–50 kg (çift) | dış eleman kolon yan duvarına 4 × M5 | CEK_K2_lahm_5 | SATIN ALMA
CEK_K2_lahm_5_ray_ara_sol | ray ara | 0 | 304 · lazer / lama | alt gövde → Accuride DZ3832-0070 (ara eleman) | CEK_K2_lahm_5 | ALT
CEK_K2_lahm_5_ray_ic_sol | ray ic | 0 | 304 · lazer / lama | alt gövde → Accuride DZ3832-0070 (iç eleman) | CEK_K2_lahm_5 | ALT
CEK_K2_lahm_5_ray_dis_sag | ray dis | 0 | 304 · lazer / lama | alt gövde → Accuride DZ3832-0070 | CEK_K2_lahm_5 | ALT
CEK_K2_lahm_5_ray_ara_sag | ray ara | 0 | 304 · lazer / lama | alt gövde → Accuride DZ3832-0070 (ara eleman) | CEK_K2_lahm_5 | ALT
CEK_K2_lahm_5_ray_ic_sag | ray ic | 0 | 304 · lazer / lama | alt gövde → Accuride DZ3832-0070 (iç eleman) | CEK_K2_lahm_5 | ALT
CEK_K2_lahm_5_motor_kasnagi | GT3 kasnak 30 diş · 6 mm · flanşlı | 1 | alüminyum · delik Ø8 H7 + düz | PD 28,65 · çevre 90 mm | CEK_K2_lahm_5 | SATIN ALMA
CEK_K2_lahm_5_motor_mili | motor mili | 0 | 304 · lazer / lama | alt gövde → Transmotec PD3665 | CEK_K2_lahm_5 | ALT
CEK_K2_lahm_5_motor_gobegi | motor gobegi | 0 | 304 · lazer / lama | alt gövde → Transmotec PD3665 | CEK_K2_lahm_5 | ALT
CEK_K2_lahm_5_motor_reduktor | Motor Transmotec PD3665-24-51-BFEC | 1 | 24 V · planet 51:1 · 127 d/dk · 0,853 N·m · manyetik enkoder · EMC filtreli | Ø36 × 115,5 + enkoder · datasheet: transmotec.com PD3665 | CEK_K2_lahm_5 | SATIN ALMA
CEK_K2_lahm_5_motor_govde | motor govde | 0 |  | alt gövde → Transmotec PD3665 | CEK_K2_lahm_5 | ALT
CEK_K2_lahm_5_enkoder_kapagi | enkoder kapagi | 0 |  | alt gövde → Transmotec PD3665 | CEK_K2_lahm_5 | ALT
CEK_K2_lahm_5_m12_soket | M12 4 pin soket + kablo | 1 | motor + enkoder tek soket · kasada sabit | kablo dikey kanala | CEK_K2_lahm_5 | SATIN ALMA
CEK_K2_lahm_5_motor_braketi | Motor braketi 3 mm | 1 | 304 lazer + büküm · 4 × M3 (Ø31) + arka duvara 2 × M5 | kasnak hizası buradan | CEK_K2_lahm_5 | ÜRETİM
CEK_K2_lahm_5_avara | GT3 avara 30 diş · 6 mm · tek flanşlı (dış) · çift rulman | 1 | alüminyum · 2 × MR126-2RS (6 × 12 × 4: 8 ≤ göbek 9,5 — v8'deki 2 × 625 = 10 sığmıyordu) · v8: iç flanş yok (Gates: iki kasnaklı tahrikte motor kasnağı çift flanşlı → kayış kılavuzu yeter) | z −73 SABİT (strok 628) | CEK_K2_lahm_5 | SATIN ALMA
CEK_K2_lahm_5_avara_mili | Avara mili Ø6 · omuzlu | 1 | 304 · kola somunla (kolun iç yüzünde) · 2 × MR126-2RS taşır | v8b: Ø5 → Ø6 (sıkışma tepesinde 182 → ~108 MPa) | CEK_K2_lahm_5 | ÜRETİM
CEK_K2_lahm_5_avara_kolu | Avara kolu 2 mm · L kesit + ön flanş + arka kulak | 1 | 304 2 mm büküm · üst flanş 12 · ön flanş 20 × 12,7 (K1 / K2 üst çekmecede tavan nedeniyle 18,5): çerçeve sacına 2 × PEM FH4-M3-10 gömme başlı saplama + somun (çerçevenin önü düz, fitil bandı temiz) · arka kulak: sensör lamına 20 bindirme, 2 × M3 perçin | boy 104 (−81…+23), moment kolu 96 · iç raya 1,0 · avaraya 1,3 · kayış gergisi burada: 8 mm yuvalı | CEK_K2_lahm_5 | ÜRETİM
CEK_K2_lahm_5_kayis_GT3 | Kayış GT3 6 mm kapalı çevrim | 1 | ~1482 mm (494 diş) · çelik kordlu | tedarikçi boyu doğrulayacak | CEK_K2_lahm_5 | SATIN ALMA
CEK_K2_lahm_5_kayis_cenesi | Kayış çenesi + kolu | 1 | 304 · kutunun yan duvarına kaynaklı · dişli çene 2 × M3 | kutunun arkasından kasnağa uzanır (strok için) | CEK_K2_lahm_5 | ÜRETİM
CEK_K2_lahm_5_miknatis_ayagi | miknatis ayagi | 1 | 304 · lazer / lama | zarf 6.4 × 2.3 × 28.6 | CEK_K2_lahm_5 | ÜRETİM
CEK_K2_lahm_5_miknatis_57135 | Mıknatıs Littelfuse 57135-000 | 1 | AlNiCo 5 · flanşlı 28,57 × 19,05 × 6,35 | çenenin üstünde | CEK_K2_lahm_5 | SATIN ALMA
CEK_K2_lahm_5_reed_kapali | Reed sensör Littelfuse 59135-010 | 2 | NO · flanşlı 28,57 × 19,05 × 6,35 | KAPALI + AÇIK konum · PLC girişine | CEK_K2_lahm_5 | SATIN ALMA
CEK_K2_lahm_5_reed_acik | reed acik | 0 |  | alt gövde → Littelfuse 59135 | CEK_K2_lahm_5 | ALT
CEK_K2_lahm_5_sensor_lami | Sensör lamı L 6,35 × 8 × 2 + arka tırnak | 1 | 304 büküm · reed sensörler altında · önde avara kolunun arka kulağına 20 bindirme 2 × M3 perçin · arkada 16 geniş tırnakla arka iç saca 2 × M4 perçin somun |  | CEK_K2_lahm_5 | ÜRETİM
CEK_K2_lahm_5_tepsi | Tepsi · 36 çukur Ø80 | 1 | gıda silikonu 10 mm · çukur 7 · kalıp döküm | 530 × 540 | CEK_K2_lahm_5 | ÜRETİM
CEK_K2_lahm_6_on_dis_sac_1.5 | Çekmece önü 40 · kulpsuz · tam kaplama | 1 | dış 304 1,5 bükme (4 kenar + arkada kanal kenarına dönüş) + PU 37,5 köpük + iç panel 304 1,0 · fitil dişi dönüş ile panel arasındaki 6,4 kanala geçer | 652 × 152 | CEK_K2_lahm_6 | ÜRETİM
CEK_K2_lahm_6_on_pu | on pu | 0 | PU köpük (gövdeyle birlikte enjeksiyon) | alt gövde → çekmece önü / kapak katmanı | CEK_K2_lahm_6 | ALT
CEK_K2_lahm_6_on_ic_sac_1.0 | on ic sac 1.0 | 0 | 304 sac · lazer + büküm | alt gövde → çekmece önü / kapak katmanı | CEK_K2_lahm_6 | ALT
CEK_K2_lahm_6_on_fitil | Fitil · geçmeli manyetik profil 21 × 18,5 | 1 | PVC + şerit mıknatıs · kapak iç sacının 6,4'lük kanalına geçer · aletsiz sökülür | çevre 1392 mm · köşeler gönye kaynaklı | CEK_K2_lahm_6 | SATIN ALMA
CEK_K2_lahm_6_kutu_U_1.0 | Çekmece kutusu U 1,0 | 1 | 304 lazer + 2 büküm | 560 × 45 × 629 | CEK_K2_lahm_6 | ÜRETİM
CEK_K2_lahm_6_kutu_arka_1.0 | kutu arka 1.0 | 0 | 304 sac · lazer + büküm | alt gövde → çekmece kutusu | CEK_K2_lahm_6 | ALT
CEK_K2_lahm_6_kutu_on_1.0 | kutu on 1.0 | 0 | 304 sac · lazer + büküm | alt gövde → çekmece kutusu | CEK_K2_lahm_6 | ALT
CEK_K2_lahm_6_on_baglanti_sol | Ön bağlantı köşesi · U 2 mm | 2 | 304 2 mm büküm · kutu önüne punta, kapak iç sacına 2 × M5 perçin somun | ön yüz ayar yuvalı · 17 derin | CEK_K2_lahm_6 | ÜRETİM
CEK_K2_lahm_6_on_baglanti_sag | on baglanti | 0 | 304 · lazer / lama | alt gövde → ön bağlantı köşesi | CEK_K2_lahm_6 | ALT
CEK_K2_lahm_6_ray_adaptor_sol | Ray adaptör lamı 6 mm | 2 | 304 lama · kutuya punta | ray iç profiline 4 × M4 · v8: iç ray boyuyla sınırlı (660'lık kutuda kutu arkada konsol) | CEK_K2_lahm_6 | ÜRETİM
CEK_K2_lahm_6_ray_adaptor_sag | ray adaptor | 0 | 304 · lazer / lama | alt gövde → ray adaptör lamı | CEK_K2_lahm_6 | ALT
CEK_K2_lahm_6_ray_dis_sol | Teleskopik ray Accuride DZ3832-0070 | 2 | 700 · %100 açılır · 3 elemanlı · 45,7 × 12,7 · 45–50 kg (çift) | dış eleman kolon yan duvarına 4 × M5 | CEK_K2_lahm_6 | SATIN ALMA
CEK_K2_lahm_6_ray_ara_sol | ray ara | 0 | 304 · lazer / lama | alt gövde → Accuride DZ3832-0070 (ara eleman) | CEK_K2_lahm_6 | ALT
CEK_K2_lahm_6_ray_ic_sol | ray ic | 0 | 304 · lazer / lama | alt gövde → Accuride DZ3832-0070 (iç eleman) | CEK_K2_lahm_6 | ALT
CEK_K2_lahm_6_ray_dis_sag | ray dis | 0 | 304 · lazer / lama | alt gövde → Accuride DZ3832-0070 | CEK_K2_lahm_6 | ALT
CEK_K2_lahm_6_ray_ara_sag | ray ara | 0 | 304 · lazer / lama | alt gövde → Accuride DZ3832-0070 (ara eleman) | CEK_K2_lahm_6 | ALT
CEK_K2_lahm_6_ray_ic_sag | ray ic | 0 | 304 · lazer / lama | alt gövde → Accuride DZ3832-0070 (iç eleman) | CEK_K2_lahm_6 | ALT
CEK_K2_lahm_6_motor_kasnagi | GT3 kasnak 30 diş · 6 mm · flanşlı | 1 | alüminyum · delik Ø8 H7 + düz | PD 28,65 · çevre 90 mm | CEK_K2_lahm_6 | SATIN ALMA
CEK_K2_lahm_6_motor_mili | motor mili | 0 | 304 · lazer / lama | alt gövde → Transmotec PD3665 | CEK_K2_lahm_6 | ALT
CEK_K2_lahm_6_motor_gobegi | motor gobegi | 0 | 304 · lazer / lama | alt gövde → Transmotec PD3665 | CEK_K2_lahm_6 | ALT
CEK_K2_lahm_6_motor_reduktor | Motor Transmotec PD3665-24-51-BFEC | 1 | 24 V · planet 51:1 · 127 d/dk · 0,853 N·m · manyetik enkoder · EMC filtreli | Ø36 × 115,5 + enkoder · datasheet: transmotec.com PD3665 | CEK_K2_lahm_6 | SATIN ALMA
CEK_K2_lahm_6_motor_govde | motor govde | 0 |  | alt gövde → Transmotec PD3665 | CEK_K2_lahm_6 | ALT
CEK_K2_lahm_6_enkoder_kapagi | enkoder kapagi | 0 |  | alt gövde → Transmotec PD3665 | CEK_K2_lahm_6 | ALT
CEK_K2_lahm_6_m12_soket | M12 4 pin soket + kablo | 1 | motor + enkoder tek soket · kasada sabit | kablo dikey kanala | CEK_K2_lahm_6 | SATIN ALMA
CEK_K2_lahm_6_motor_braketi | Motor braketi 3 mm | 1 | 304 lazer + büküm · 4 × M3 (Ø31) + arka duvara 2 × M5 | kasnak hizası buradan | CEK_K2_lahm_6 | ÜRETİM
CEK_K2_lahm_6_avara | GT3 avara 30 diş · 6 mm · tek flanşlı (dış) · çift rulman | 1 | alüminyum · 2 × MR126-2RS (6 × 12 × 4: 8 ≤ göbek 9,5 — v8'deki 2 × 625 = 10 sığmıyordu) · v8: iç flanş yok (Gates: iki kasnaklı tahrikte motor kasnağı çift flanşlı → kayış kılavuzu yeter) | z −73 SABİT (strok 628) | CEK_K2_lahm_6 | SATIN ALMA
CEK_K2_lahm_6_avara_mili | Avara mili Ø6 · omuzlu | 1 | 304 · kola somunla (kolun iç yüzünde) · 2 × MR126-2RS taşır | v8b: Ø5 → Ø6 (sıkışma tepesinde 182 → ~108 MPa) | CEK_K2_lahm_6 | ÜRETİM
CEK_K2_lahm_6_avara_kolu | Avara kolu 2 mm · L kesit + ön flanş + arka kulak | 1 | 304 2 mm büküm · üst flanş 12 · ön flanş 20 × 12,7 (K1 / K2 üst çekmecede tavan nedeniyle 18,5): çerçeve sacına 2 × PEM FH4-M3-10 gömme başlı saplama + somun (çerçevenin önü düz, fitil bandı temiz) · arka kulak: sensör lamına 20 bindirme, 2 × M3 perçin | boy 104 (−81…+23), moment kolu 96 · iç raya 1,0 · avaraya 1,3 · kayış gergisi burada: 8 mm yuvalı | CEK_K2_lahm_6 | ÜRETİM
CEK_K2_lahm_6_kayis_GT3 | Kayış GT3 6 mm kapalı çevrim | 1 | ~1482 mm (494 diş) · çelik kordlu | tedarikçi boyu doğrulayacak | CEK_K2_lahm_6 | SATIN ALMA
CEK_K2_lahm_6_kayis_cenesi | Kayış çenesi + kolu | 1 | 304 · kutunun yan duvarına kaynaklı · dişli çene 2 × M3 | kutunun arkasından kasnağa uzanır (strok için) | CEK_K2_lahm_6 | ÜRETİM
CEK_K2_lahm_6_miknatis_ayagi | miknatis ayagi | 1 | 304 · lazer / lama | zarf 6.4 × 2.3 × 28.6 | CEK_K2_lahm_6 | ÜRETİM
CEK_K2_lahm_6_miknatis_57135 | Mıknatıs Littelfuse 57135-000 | 1 | AlNiCo 5 · flanşlı 28,57 × 19,05 × 6,35 | çenenin üstünde | CEK_K2_lahm_6 | SATIN ALMA
CEK_K2_lahm_6_reed_kapali | Reed sensör Littelfuse 59135-010 | 2 | NO · flanşlı 28,57 × 19,05 × 6,35 | KAPALI + AÇIK konum · PLC girişine | CEK_K2_lahm_6 | SATIN ALMA
CEK_K2_lahm_6_reed_acik | reed acik | 0 |  | alt gövde → Littelfuse 59135 | CEK_K2_lahm_6 | ALT
CEK_K2_lahm_6_sensor_lami | Sensör lamı L 6,35 × 8 × 2 + arka tırnak | 1 | 304 büküm · reed sensörler altında · önde avara kolunun arka kulağına 20 bindirme 2 × M3 perçin · arkada 16 geniş tırnakla arka iç saca 2 × M4 perçin somun | kanala denk gelen lam kanalın altından kademeyle geçer | CEK_K2_lahm_6 | ÜRETİM
CEK_K2_lahm_6_tepsi | Tepsi · 36 çukur Ø80 | 1 | gıda silikonu 10 mm · çukur 7 · kalıp döküm | 530 × 540 | CEK_K2_lahm_6 | ÜRETİM
CEK_K3_hamur_1_on_dis_sac_1.5 | Çekmece önü 40 · kulpsuz · tam kaplama | 1 | dış 304 1,5 bükme (4 kenar + arkada kanal kenarına dönüş) + PU 37,5 köpük + iç panel 304 1,0 · fitil dişi dönüş ile panel arasındaki 6,4 kanala geçer | 652 × 146 | CEK_K3_hamur_1 | ÜRETİM
CEK_K3_hamur_1_on_pu | on pu | 0 | PU köpük (gövdeyle birlikte enjeksiyon) | alt gövde → çekmece önü / kapak katmanı | CEK_K3_hamur_1 | ALT
CEK_K3_hamur_1_on_ic_sac_1.0 | on ic sac 1.0 | 0 | 304 sac · lazer + büküm | alt gövde → çekmece önü / kapak katmanı | CEK_K3_hamur_1 | ALT
CEK_K3_hamur_1_on_fitil | Fitil · geçmeli manyetik profil 21 × 18,5 | 1 | PVC + şerit mıknatıs · kapak iç sacının 6,4'lük kanalına geçer · aletsiz sökülür | çevre 1422 mm · köşeler gönye kaynaklı | CEK_K3_hamur_1 | SATIN ALMA
CEK_K3_hamur_1_kutu_U_1.0 | Çekmece kutusu U 1,0 | 1 | 304 lazer + 2 büküm | 560 × 60 × 609 | CEK_K3_hamur_1 | ÜRETİM
CEK_K3_hamur_1_kutu_arka_1.0 | kutu arka 1.0 | 0 | 304 sac · lazer + büküm | alt gövde → çekmece kutusu | CEK_K3_hamur_1 | ALT
CEK_K3_hamur_1_kutu_on_1.0 | kutu on 1.0 | 0 | 304 sac · lazer + büküm | alt gövde → çekmece kutusu | CEK_K3_hamur_1 | ALT
CEK_K3_hamur_1_on_baglanti_sol | Ön bağlantı köşesi · U 2 mm | 2 | 304 2 mm büküm · kutu önüne punta, kapak iç sacına 2 × M5 perçin somun | ön yüz ayar yuvalı · 17 derin | CEK_K3_hamur_1 | ÜRETİM
CEK_K3_hamur_1_on_baglanti_sag | on baglanti | 0 | 304 · lazer / lama | alt gövde → ön bağlantı köşesi | CEK_K3_hamur_1 | ALT
CEK_K3_hamur_1_ray_adaptor_sol | Ray adaptör lamı 6 mm | 2 | 304 lama · kutuya punta | ray iç profiline 4 × M4 · v8: iç ray boyuyla sınırlı (660'lık kutuda kutu arkada konsol) | CEK_K3_hamur_1 | ÜRETİM
CEK_K3_hamur_1_ray_adaptor_sag | ray adaptor | 0 | 304 · lazer / lama | alt gövde → ray adaptör lamı | CEK_K3_hamur_1 | ALT
CEK_K3_hamur_1_ray_dis_sol | Teleskopik ray Accuride DZ3832-0070 | 2 | 700 · %100 açılır · 3 elemanlı · 45,7 × 12,7 · 45–50 kg (çift) | dış eleman kolon yan duvarına 4 × M5 | CEK_K3_hamur_1 | SATIN ALMA
CEK_K3_hamur_1_ray_ara_sol | ray ara | 0 | 304 · lazer / lama | alt gövde → Accuride DZ3832-0070 (ara eleman) | CEK_K3_hamur_1 | ALT
CEK_K3_hamur_1_ray_ic_sol | ray ic | 0 | 304 · lazer / lama | alt gövde → Accuride DZ3832-0070 (iç eleman) | CEK_K3_hamur_1 | ALT
CEK_K3_hamur_1_ray_dis_sag | ray dis | 0 | 304 · lazer / lama | alt gövde → Accuride DZ3832-0070 | CEK_K3_hamur_1 | ALT
CEK_K3_hamur_1_ray_ara_sag | ray ara | 0 | 304 · lazer / lama | alt gövde → Accuride DZ3832-0070 (ara eleman) | CEK_K3_hamur_1 | ALT
CEK_K3_hamur_1_ray_ic_sag | ray ic | 0 | 304 · lazer / lama | alt gövde → Accuride DZ3832-0070 (iç eleman) | CEK_K3_hamur_1 | ALT
CEK_K3_hamur_1_motor_kasnagi | GT3 kasnak 30 diş · 6 mm · flanşlı | 1 | alüminyum · delik Ø8 H7 + düz | PD 28,65 · çevre 90 mm | CEK_K3_hamur_1 | SATIN ALMA
CEK_K3_hamur_1_motor_mili | motor mili | 0 | 304 · lazer / lama | alt gövde → Transmotec PD3665 | CEK_K3_hamur_1 | ALT
CEK_K3_hamur_1_motor_gobegi | motor gobegi | 0 | 304 · lazer / lama | alt gövde → Transmotec PD3665 | CEK_K3_hamur_1 | ALT
CEK_K3_hamur_1_motor_reduktor | Motor Transmotec PD3665-24-51-BFEC | 1 | 24 V · planet 51:1 · 127 d/dk · 0,853 N·m · manyetik enkoder · EMC filtreli | Ø36 × 115,5 + enkoder · datasheet: transmotec.com PD3665 | CEK_K3_hamur_1 | SATIN ALMA
CEK_K3_hamur_1_motor_govde | motor govde | 0 |  | alt gövde → Transmotec PD3665 | CEK_K3_hamur_1 | ALT
CEK_K3_hamur_1_enkoder_kapagi | enkoder kapagi | 0 |  | alt gövde → Transmotec PD3665 | CEK_K3_hamur_1 | ALT
CEK_K3_hamur_1_m12_soket | M12 4 pin soket + kablo | 1 | motor + enkoder tek soket · kasada sabit | kablo dikey kanala | CEK_K3_hamur_1 | SATIN ALMA
CEK_K3_hamur_1_motor_braketi | Motor braketi 3 mm | 1 | 304 lazer + büküm · 4 × M3 (Ø31) + arka duvara 2 × M5 | kasnak hizası buradan | CEK_K3_hamur_1 | ÜRETİM
CEK_K3_hamur_1_avara | GT3 avara 30 diş · 6 mm · tek flanşlı (dış) · çift rulman | 1 | alüminyum · 2 × MR126-2RS (6 × 12 × 4: 8 ≤ göbek 9,5 — v8'deki 2 × 625 = 10 sığmıyordu) · v8: iç flanş yok (Gates: iki kasnaklı tahrikte motor kasnağı çift flanşlı → kayış kılavuzu yeter) | z −73 SABİT (strok 628) | CEK_K3_hamur_1 | SATIN ALMA
CEK_K3_hamur_1_avara_mili | Avara mili Ø6 · omuzlu | 1 | 304 · kola somunla (kolun iç yüzünde) · 2 × MR126-2RS taşır | v8b: Ø5 → Ø6 (sıkışma tepesinde 182 → ~108 MPa) | CEK_K3_hamur_1 | ÜRETİM
CEK_K3_hamur_1_avara_kolu | Avara kolu 2 mm · L kesit + ön flanş + arka kulak | 1 | 304 2 mm büküm · üst flanş 12 · ön flanş 20 × 12,7 (K1 / K2 üst çekmecede tavan nedeniyle 18,5): çerçeve sacına 2 × PEM FH4-M3-10 gömme başlı saplama + somun (çerçevenin önü düz, fitil bandı temiz) · arka kulak: sensör lamına 20 bindirme, 2 × M3 perçin | boy 104 (−81…+23), moment kolu 96 · iç raya 1,0 · avaraya 1,3 · kayış gergisi burada: 8 mm yuvalı | CEK_K3_hamur_1 | ÜRETİM
CEK_K3_hamur_1_kayis_GT3 | Kayış GT3 6 mm kapalı çevrim | 1 | ~1482 mm (494 diş) · çelik kordlu | tedarikçi boyu doğrulayacak | CEK_K3_hamur_1 | SATIN ALMA
CEK_K3_hamur_1_kayis_cenesi | Kayış çenesi + kolu | 1 | 304 · kutunun yan duvarına kaynaklı · dişli çene 2 × M3 | kutunun arkasından kasnağa uzanır (strok için) | CEK_K3_hamur_1 | ÜRETİM
CEK_K3_hamur_1_miknatis_ayagi | miknatis ayagi | 1 | 304 · lazer / lama | zarf 6.3 × 2.3 × 28.6 | CEK_K3_hamur_1 | ÜRETİM
CEK_K3_hamur_1_miknatis_57135 | Mıknatıs Littelfuse 57135-000 | 1 | AlNiCo 5 · flanşlı 28,57 × 19,05 × 6,35 | çenenin üstünde | CEK_K3_hamur_1 | SATIN ALMA
CEK_K3_hamur_1_reed_kapali | Reed sensör Littelfuse 59135-010 | 2 | NO · flanşlı 28,57 × 19,05 × 6,35 | KAPALI + AÇIK konum · PLC girişine | CEK_K3_hamur_1 | SATIN ALMA
CEK_K3_hamur_1_reed_acik | reed acik | 0 |  | alt gövde → Littelfuse 59135 | CEK_K3_hamur_1 | ALT
CEK_K3_hamur_1_sensor_lami | Sensör lamı L 6,35 × 8 × 2 + arka tırnak | 1 | 304 büküm · reed sensörler altında · önde avara kolunun arka kulağına 20 bindirme 2 × M3 perçin · arkada 16 geniş tırnakla arka iç saca 2 × M4 perçin somun |  | CEK_K3_hamur_1 | ÜRETİM
CEK_K3_hamur_1_tepsi | Tepsi · 20 çukur Ø100 | 1 | gıda silikonu 10 mm · çukur 7 · kalıp döküm | 530 × 520 | CEK_K3_hamur_1 | ÜRETİM
CEK_K3_hamur_2_on_dis_sac_1.5 | Çekmece önü 40 · kulpsuz · tam kaplama | 1 | dış 304 1,5 bükme (4 kenar + arkada kanal kenarına dönüş) + PU 37,5 köpük + iç panel 304 1,0 · fitil dişi dönüş ile panel arasındaki 6,4 kanala geçer | 652 × 105 | CEK_K3_hamur_2 | ÜRETİM
CEK_K3_hamur_2_on_pu | on pu | 0 | PU köpük (gövdeyle birlikte enjeksiyon) | alt gövde → çekmece önü / kapak katmanı | CEK_K3_hamur_2 | ALT
CEK_K3_hamur_2_on_ic_sac_1.0 | on ic sac 1.0 | 0 | 304 sac · lazer + büküm | alt gövde → çekmece önü / kapak katmanı | CEK_K3_hamur_2 | ALT
CEK_K3_hamur_2_on_fitil | Fitil · geçmeli manyetik profil 21 × 18,5 | 1 | PVC + şerit mıknatıs · kapak iç sacının 6,4'lük kanalına geçer · aletsiz sökülür | çevre 1422 mm · köşeler gönye kaynaklı | CEK_K3_hamur_2 | SATIN ALMA
CEK_K3_hamur_2_kutu_U_1.0 | Çekmece kutusu U 1,0 | 1 | 304 lazer + 2 büküm | 560 × 60 × 609 | CEK_K3_hamur_2 | ÜRETİM
CEK_K3_hamur_2_kutu_arka_1.0 | kutu arka 1.0 | 0 | 304 sac · lazer + büküm | alt gövde → çekmece kutusu | CEK_K3_hamur_2 | ALT
CEK_K3_hamur_2_kutu_on_1.0 | kutu on 1.0 | 0 | 304 sac · lazer + büküm | alt gövde → çekmece kutusu | CEK_K3_hamur_2 | ALT
CEK_K3_hamur_2_on_baglanti_sol | Ön bağlantı köşesi · U 2 mm | 2 | 304 2 mm büküm · kutu önüne punta, kapak iç sacına 2 × M5 perçin somun | ön yüz ayar yuvalı · 17 derin | CEK_K3_hamur_2 | ÜRETİM
CEK_K3_hamur_2_on_baglanti_sag | on baglanti | 0 | 304 · lazer / lama | alt gövde → ön bağlantı köşesi | CEK_K3_hamur_2 | ALT
CEK_K3_hamur_2_ray_adaptor_sol | Ray adaptör lamı 6 mm | 2 | 304 lama · kutuya punta | ray iç profiline 4 × M4 · v8: iç ray boyuyla sınırlı (660'lık kutuda kutu arkada konsol) | CEK_K3_hamur_2 | ÜRETİM
CEK_K3_hamur_2_ray_adaptor_sag | ray adaptor | 0 | 304 · lazer / lama | alt gövde → ray adaptör lamı | CEK_K3_hamur_2 | ALT
CEK_K3_hamur_2_ray_dis_sol | Teleskopik ray Accuride DZ3832-0070 | 2 | 700 · %100 açılır · 3 elemanlı · 45,7 × 12,7 · 45–50 kg (çift) | dış eleman kolon yan duvarına 4 × M5 | CEK_K3_hamur_2 | SATIN ALMA
CEK_K3_hamur_2_ray_ara_sol | ray ara | 0 | 304 · lazer / lama | alt gövde → Accuride DZ3832-0070 (ara eleman) | CEK_K3_hamur_2 | ALT
CEK_K3_hamur_2_ray_ic_sol | ray ic | 0 | 304 · lazer / lama | alt gövde → Accuride DZ3832-0070 (iç eleman) | CEK_K3_hamur_2 | ALT
CEK_K3_hamur_2_ray_dis_sag | ray dis | 0 | 304 · lazer / lama | alt gövde → Accuride DZ3832-0070 | CEK_K3_hamur_2 | ALT
CEK_K3_hamur_2_ray_ara_sag | ray ara | 0 | 304 · lazer / lama | alt gövde → Accuride DZ3832-0070 (ara eleman) | CEK_K3_hamur_2 | ALT
CEK_K3_hamur_2_ray_ic_sag | ray ic | 0 | 304 · lazer / lama | alt gövde → Accuride DZ3832-0070 (iç eleman) | CEK_K3_hamur_2 | ALT
CEK_K3_hamur_2_motor_kasnagi | GT3 kasnak 30 diş · 6 mm · flanşlı | 1 | alüminyum · delik Ø8 H7 + düz | PD 28,65 · çevre 90 mm | CEK_K3_hamur_2 | SATIN ALMA
CEK_K3_hamur_2_motor_mili | motor mili | 0 | 304 · lazer / lama | alt gövde → Transmotec PD3665 | CEK_K3_hamur_2 | ALT
CEK_K3_hamur_2_motor_gobegi | motor gobegi | 0 | 304 · lazer / lama | alt gövde → Transmotec PD3665 | CEK_K3_hamur_2 | ALT
CEK_K3_hamur_2_motor_reduktor | Motor Transmotec PD3665-24-51-BFEC | 1 | 24 V · planet 51:1 · 127 d/dk · 0,853 N·m · manyetik enkoder · EMC filtreli | Ø36 × 115,5 + enkoder · datasheet: transmotec.com PD3665 | CEK_K3_hamur_2 | SATIN ALMA
CEK_K3_hamur_2_motor_govde | motor govde | 0 |  | alt gövde → Transmotec PD3665 | CEK_K3_hamur_2 | ALT
CEK_K3_hamur_2_enkoder_kapagi | enkoder kapagi | 0 |  | alt gövde → Transmotec PD3665 | CEK_K3_hamur_2 | ALT
CEK_K3_hamur_2_m12_soket | M12 4 pin soket + kablo | 1 | motor + enkoder tek soket · kasada sabit | kablo dikey kanala | CEK_K3_hamur_2 | SATIN ALMA
CEK_K3_hamur_2_motor_braketi | Motor braketi 3 mm | 1 | 304 lazer + büküm · 4 × M3 (Ø31) + arka duvara 2 × M5 | kasnak hizası buradan | CEK_K3_hamur_2 | ÜRETİM
CEK_K3_hamur_2_avara | GT3 avara 30 diş · 6 mm · tek flanşlı (dış) · çift rulman | 1 | alüminyum · 2 × MR126-2RS (6 × 12 × 4: 8 ≤ göbek 9,5 — v8'deki 2 × 625 = 10 sığmıyordu) · v8: iç flanş yok (Gates: iki kasnaklı tahrikte motor kasnağı çift flanşlı → kayış kılavuzu yeter) | z −73 SABİT (strok 628) | CEK_K3_hamur_2 | SATIN ALMA
CEK_K3_hamur_2_avara_mili | Avara mili Ø6 · omuzlu | 1 | 304 · kola somunla (kolun iç yüzünde) · 2 × MR126-2RS taşır | v8b: Ø5 → Ø6 (sıkışma tepesinde 182 → ~108 MPa) | CEK_K3_hamur_2 | ÜRETİM
CEK_K3_hamur_2_avara_kolu | Avara kolu 2 mm · L kesit + ön flanş + arka kulak | 1 | 304 2 mm büküm · üst flanş 12 · ön flanş 20 × 12,7 (K1 / K2 üst çekmecede tavan nedeniyle 18,5): çerçeve sacına 2 × PEM FH4-M3-10 gömme başlı saplama + somun (çerçevenin önü düz, fitil bandı temiz) · arka kulak: sensör lamına 20 bindirme, 2 × M3 perçin | boy 104 (−81…+23), moment kolu 96 · iç raya 1,0 · avaraya 1,3 · kayış gergisi burada: 8 mm yuvalı | CEK_K3_hamur_2 | ÜRETİM
CEK_K3_hamur_2_kayis_GT3 | Kayış GT3 6 mm kapalı çevrim | 1 | ~1482 mm (494 diş) · çelik kordlu | tedarikçi boyu doğrulayacak | CEK_K3_hamur_2 | SATIN ALMA
CEK_K3_hamur_2_kayis_cenesi | Kayış çenesi + kolu | 1 | 304 · kutunun yan duvarına kaynaklı · dişli çene 2 × M3 | kutunun arkasından kasnağa uzanır (strok için) | CEK_K3_hamur_2 | ÜRETİM
CEK_K3_hamur_2_miknatis_ayagi | miknatis ayagi | 1 | 304 · lazer / lama | zarf 6.3 × 2.3 × 28.6 | CEK_K3_hamur_2 | ÜRETİM
CEK_K3_hamur_2_miknatis_57135 | Mıknatıs Littelfuse 57135-000 | 1 | AlNiCo 5 · flanşlı 28,57 × 19,05 × 6,35 | çenenin üstünde | CEK_K3_hamur_2 | SATIN ALMA
CEK_K3_hamur_2_reed_kapali | Reed sensör Littelfuse 59135-010 | 2 | NO · flanşlı 28,57 × 19,05 × 6,35 | KAPALI + AÇIK konum · PLC girişine | CEK_K3_hamur_2 | SATIN ALMA
CEK_K3_hamur_2_reed_acik | reed acik | 0 |  | alt gövde → Littelfuse 59135 | CEK_K3_hamur_2 | ALT
CEK_K3_hamur_2_sensor_lami | Sensör lamı L 6,35 × 8 × 2 + arka tırnak | 1 | 304 büküm · reed sensörler altında · önde avara kolunun arka kulağına 20 bindirme 2 × M3 perçin · arkada 16 geniş tırnakla arka iç saca 2 × M4 perçin somun |  | CEK_K3_hamur_2 | ÜRETİM
CEK_K3_hamur_2_tepsi | Tepsi · 20 çukur Ø100 | 1 | gıda silikonu 10 mm · çukur 7 · kalıp döküm | 530 × 520 | CEK_K3_hamur_2 | ÜRETİM
CEK_K3_hamur_3_on_dis_sac_1.5 | Çekmece önü 40 · kulpsuz · tam kaplama | 1 | dış 304 1,5 bükme (4 kenar + arkada kanal kenarına dönüş) + PU 37,5 köpük + iç panel 304 1,0 · fitil dişi dönüş ile panel arasındaki 6,4 kanala geçer | 652 × 105 | CEK_K3_hamur_3 | ÜRETİM
CEK_K3_hamur_3_on_pu | on pu | 0 | PU köpük (gövdeyle birlikte enjeksiyon) | alt gövde → çekmece önü / kapak katmanı | CEK_K3_hamur_3 | ALT
CEK_K3_hamur_3_on_ic_sac_1.0 | on ic sac 1.0 | 0 | 304 sac · lazer + büküm | alt gövde → çekmece önü / kapak katmanı | CEK_K3_hamur_3 | ALT
CEK_K3_hamur_3_on_fitil | Fitil · geçmeli manyetik profil 21 × 18,5 | 1 | PVC + şerit mıknatıs · kapak iç sacının 6,4'lük kanalına geçer · aletsiz sökülür | çevre 1422 mm · köşeler gönye kaynaklı | CEK_K3_hamur_3 | SATIN ALMA
CEK_K3_hamur_3_kutu_U_1.0 | Çekmece kutusu U 1,0 | 1 | 304 lazer + 2 büküm | 560 × 60 × 609 | CEK_K3_hamur_3 | ÜRETİM
CEK_K3_hamur_3_kutu_arka_1.0 | kutu arka 1.0 | 0 | 304 sac · lazer + büküm | alt gövde → çekmece kutusu | CEK_K3_hamur_3 | ALT
CEK_K3_hamur_3_kutu_on_1.0 | kutu on 1.0 | 0 | 304 sac · lazer + büküm | alt gövde → çekmece kutusu | CEK_K3_hamur_3 | ALT
CEK_K3_hamur_3_on_baglanti_sol | Ön bağlantı köşesi · U 2 mm | 2 | 304 2 mm büküm · kutu önüne punta, kapak iç sacına 2 × M5 perçin somun | ön yüz ayar yuvalı · 17 derin | CEK_K3_hamur_3 | ÜRETİM
CEK_K3_hamur_3_on_baglanti_sag | on baglanti | 0 | 304 · lazer / lama | alt gövde → ön bağlantı köşesi | CEK_K3_hamur_3 | ALT
CEK_K3_hamur_3_ray_adaptor_sol | Ray adaptör lamı 6 mm | 2 | 304 lama · kutuya punta | ray iç profiline 4 × M4 · v8: iç ray boyuyla sınırlı (660'lık kutuda kutu arkada konsol) | CEK_K3_hamur_3 | ÜRETİM
CEK_K3_hamur_3_ray_adaptor_sag | ray adaptor | 0 | 304 · lazer / lama | alt gövde → ray adaptör lamı | CEK_K3_hamur_3 | ALT
CEK_K3_hamur_3_ray_dis_sol | Teleskopik ray Accuride DZ3832-0070 | 2 | 700 · %100 açılır · 3 elemanlı · 45,7 × 12,7 · 45–50 kg (çift) | dış eleman kolon yan duvarına 4 × M5 | CEK_K3_hamur_3 | SATIN ALMA
CEK_K3_hamur_3_ray_ara_sol | ray ara | 0 | 304 · lazer / lama | alt gövde → Accuride DZ3832-0070 (ara eleman) | CEK_K3_hamur_3 | ALT
CEK_K3_hamur_3_ray_ic_sol | ray ic | 0 | 304 · lazer / lama | alt gövde → Accuride DZ3832-0070 (iç eleman) | CEK_K3_hamur_3 | ALT
CEK_K3_hamur_3_ray_dis_sag | ray dis | 0 | 304 · lazer / lama | alt gövde → Accuride DZ3832-0070 | CEK_K3_hamur_3 | ALT
CEK_K3_hamur_3_ray_ara_sag | ray ara | 0 | 304 · lazer / lama | alt gövde → Accuride DZ3832-0070 (ara eleman) | CEK_K3_hamur_3 | ALT
CEK_K3_hamur_3_ray_ic_sag | ray ic | 0 | 304 · lazer / lama | alt gövde → Accuride DZ3832-0070 (iç eleman) | CEK_K3_hamur_3 | ALT
CEK_K3_hamur_3_motor_kasnagi | GT3 kasnak 30 diş · 6 mm · flanşlı | 1 | alüminyum · delik Ø8 H7 + düz | PD 28,65 · çevre 90 mm | CEK_K3_hamur_3 | SATIN ALMA
CEK_K3_hamur_3_motor_mili | motor mili | 0 | 304 · lazer / lama | alt gövde → Transmotec PD3665 | CEK_K3_hamur_3 | ALT
CEK_K3_hamur_3_motor_gobegi | motor gobegi | 0 | 304 · lazer / lama | alt gövde → Transmotec PD3665 | CEK_K3_hamur_3 | ALT
CEK_K3_hamur_3_motor_reduktor | Motor Transmotec PD3665-24-51-BFEC | 1 | 24 V · planet 51:1 · 127 d/dk · 0,853 N·m · manyetik enkoder · EMC filtreli | Ø36 × 115,5 + enkoder · datasheet: transmotec.com PD3665 | CEK_K3_hamur_3 | SATIN ALMA
CEK_K3_hamur_3_motor_govde | motor govde | 0 |  | alt gövde → Transmotec PD3665 | CEK_K3_hamur_3 | ALT
CEK_K3_hamur_3_enkoder_kapagi | enkoder kapagi | 0 |  | alt gövde → Transmotec PD3665 | CEK_K3_hamur_3 | ALT
CEK_K3_hamur_3_m12_soket | M12 4 pin soket + kablo | 1 | motor + enkoder tek soket · kasada sabit | kablo dikey kanala | CEK_K3_hamur_3 | SATIN ALMA
CEK_K3_hamur_3_motor_braketi | Motor braketi 3 mm | 1 | 304 lazer + büküm · 4 × M3 (Ø31) + arka duvara 2 × M5 | kasnak hizası buradan | CEK_K3_hamur_3 | ÜRETİM
CEK_K3_hamur_3_avara | GT3 avara 30 diş · 6 mm · tek flanşlı (dış) · çift rulman | 1 | alüminyum · 2 × MR126-2RS (6 × 12 × 4: 8 ≤ göbek 9,5 — v8'deki 2 × 625 = 10 sığmıyordu) · v8: iç flanş yok (Gates: iki kasnaklı tahrikte motor kasnağı çift flanşlı → kayış kılavuzu yeter) | z −73 SABİT (strok 628) | CEK_K3_hamur_3 | SATIN ALMA
CEK_K3_hamur_3_avara_mili | Avara mili Ø6 · omuzlu | 1 | 304 · kola somunla (kolun iç yüzünde) · 2 × MR126-2RS taşır | v8b: Ø5 → Ø6 (sıkışma tepesinde 182 → ~108 MPa) | CEK_K3_hamur_3 | ÜRETİM
CEK_K3_hamur_3_avara_kolu | Avara kolu 2 mm · L kesit + ön flanş + arka kulak | 1 | 304 2 mm büküm · üst flanş 12 · ön flanş 20 × 12,7 (K1 / K2 üst çekmecede tavan nedeniyle 18,5): çerçeve sacına 2 × PEM FH4-M3-10 gömme başlı saplama + somun (çerçevenin önü düz, fitil bandı temiz) · arka kulak: sensör lamına 20 bindirme, 2 × M3 perçin | boy 104 (−81…+23), moment kolu 96 · iç raya 1,0 · avaraya 1,3 · kayış gergisi burada: 8 mm yuvalı | CEK_K3_hamur_3 | ÜRETİM
CEK_K3_hamur_3_kayis_GT3 | Kayış GT3 6 mm kapalı çevrim | 1 | ~1482 mm (494 diş) · çelik kordlu | tedarikçi boyu doğrulayacak | CEK_K3_hamur_3 | SATIN ALMA
CEK_K3_hamur_3_kayis_cenesi | Kayış çenesi + kolu | 1 | 304 · kutunun yan duvarına kaynaklı · dişli çene 2 × M3 | kutunun arkasından kasnağa uzanır (strok için) | CEK_K3_hamur_3 | ÜRETİM
CEK_K3_hamur_3_miknatis_ayagi | miknatis ayagi | 1 | 304 · lazer / lama | zarf 6.3 × 2.3 × 28.6 | CEK_K3_hamur_3 | ÜRETİM
CEK_K3_hamur_3_miknatis_57135 | Mıknatıs Littelfuse 57135-000 | 1 | AlNiCo 5 · flanşlı 28,57 × 19,05 × 6,35 | çenenin üstünde | CEK_K3_hamur_3 | SATIN ALMA
CEK_K3_hamur_3_reed_kapali | Reed sensör Littelfuse 59135-010 | 2 | NO · flanşlı 28,57 × 19,05 × 6,35 | KAPALI + AÇIK konum · PLC girişine | CEK_K3_hamur_3 | SATIN ALMA
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
