kursatkemalkul/autokitch/arastirma/3_KAIDE_v2/BOM.csv

parça (model adı) | birim | kalem | adet | tanım / ürün | not / kaynak | tür
kaide_A_on_profil | KAIDE_A | Kutu profil 40 × 100 × 2 AISI 304 (dik, kaynaklı çerçeve) · KAIDE_A | 7 | KAIDE_A çerçevesi · 7 parça · toplam boy 4.28 m | üretim · profil ölçüsü VARSAYIM | ÜRETİM
kaide_A_arka_profil | KAIDE_A | kaide A arka profil | 0 |  | aynı kalemin eşi ya da alt parça · zarf 684 × 100 × 40 | ALT
kaide_A_yan_profil_sol | KAIDE_A | kaide A yan profil sol | 0 |  | aynı kalemin eşi ya da alt parça · zarf 40 × 100 × 781 | ALT
kaide_A_yan_profil_sag | KAIDE_A | kaide A yan profil sag | 0 |  | aynı kalemin eşi ya da alt parça · zarf 40 × 100 × 781 | ALT
kaide_A_enine_profil_0 | KAIDE_A | kaide A enine profil 0 | 0 |  | aynı kalemin eşi ya da alt parça · zarf 40 × 100 × 781 | ALT
kaide_A_boyuna_profil_0 | KAIDE_A | kaide A boyuna profil 0 | 0 |  | aynı kalemin eşi ya da alt parça · zarf 282 × 100 × 40 | ALT
kaide_A_boyuna_profil_1 | KAIDE_A | kaide A boyuna profil 1 | 0 |  | aynı kalemin eşi ya da alt parça · zarf 282 × 100 × 40 | ALT
kaide_A_ust_plaka_4 | KAIDE_A | Üst plaka AISI 304 4 mm · KAIDE_A | 1 | 684 × 861 | üretim (lazer) · mekanizma tabanına M6 perçin somunlu | ÜRETİM
kaide_A_mekanizma_taban_saci | KAIDE_A | A mekanizma taban sacı AISI 304 1,5 mm (TC dis_taban'ın A'daki eşi) · açıcı kolonu dikmesi deliği 122 × 52 | 1 | 698.5 × 867.5 | üretim · v2: sağ ucu x 700 = C dis_taban solu (SPEC v63) · sol x 1,5 / arka −828,5 / ön +39 = kabin sacları ve ön çerçeve (köşe dikmeleri tam oturur; kaide profilinin 6,5 / 2,5 / 4 mm dışına taşan kenarlar 1,5 sacın kendisi) | ÜRETİM
kaide_C_on_profil | KAIDE_C | Kutu profil 40 × 100 × 2 AISI 304 (dik, kaynaklı çerçeve) · KAIDE_C | 11 | KAIDE_C çerçevesi · 11 parça · toplam boy 9.06 m | üretim · profil ölçüsü VARSAYIM | ÜRETİM
kaide_C_arka_profil | KAIDE_C | kaide C arka profil | 0 |  | aynı kalemin eşi ya da alt parça · zarf 1784 × 100 × 40 | ALT
kaide_C_yan_profil_sol | KAIDE_C | kaide C yan profil sol | 0 |  | aynı kalemin eşi ya da alt parça · zarf 40 × 100 × 781 | ALT
kaide_C_yan_profil_sag | KAIDE_C | kaide C yan profil sag | 0 |  | aynı kalemin eşi ya da alt parça · zarf 40 × 100 × 781 | ALT
kaide_C_enine_profil_0 | KAIDE_C | kaide C enine profil 0 | 0 |  | aynı kalemin eşi ya da alt parça · zarf 40 × 100 × 781 | ALT
kaide_C_enine_profil_1 | KAIDE_C | kaide C enine profil 1 | 0 |  | aynı kalemin eşi ya da alt parça · zarf 40 × 100 × 781 | ALT
kaide_C_enine_profil_2 | KAIDE_C | kaide C enine profil 2 | 0 |  | aynı kalemin eşi ya da alt parça · zarf 40 × 100 × 781 | ALT
kaide_C_boyuna_profil_0 | KAIDE_C | kaide C boyuna profil 0 | 0 |  | aynı kalemin eşi ya da alt parça · zarf 386 × 100 × 40 | ALT
kaide_C_boyuna_profil_1 | KAIDE_C | kaide C boyuna profil 1 | 0 |  | aynı kalemin eşi ya da alt parça · zarf 406 × 100 × 40 | ALT
kaide_C_boyuna_profil_2 | KAIDE_C | kaide C boyuna profil 2 | 0 |  | aynı kalemin eşi ya da alt parça · zarf 406 × 100 × 40 | ALT
kaide_C_boyuna_profil_3 | KAIDE_C | kaide C boyuna profil 3 | 0 |  | aynı kalemin eşi ya da alt parça · zarf 386 × 100 × 40 | ALT
kaide_C_ust_plaka_4 | KAIDE_C | Üst plaka AISI 304 4 mm · KAIDE_C | 1 | 1784 × 861 | üretim (lazer) · mekanizma tabanına M6 perçin somunlu | ÜRETİM
