kursatkemalkul/autokitch/supplier-review/rochu/all-products.png

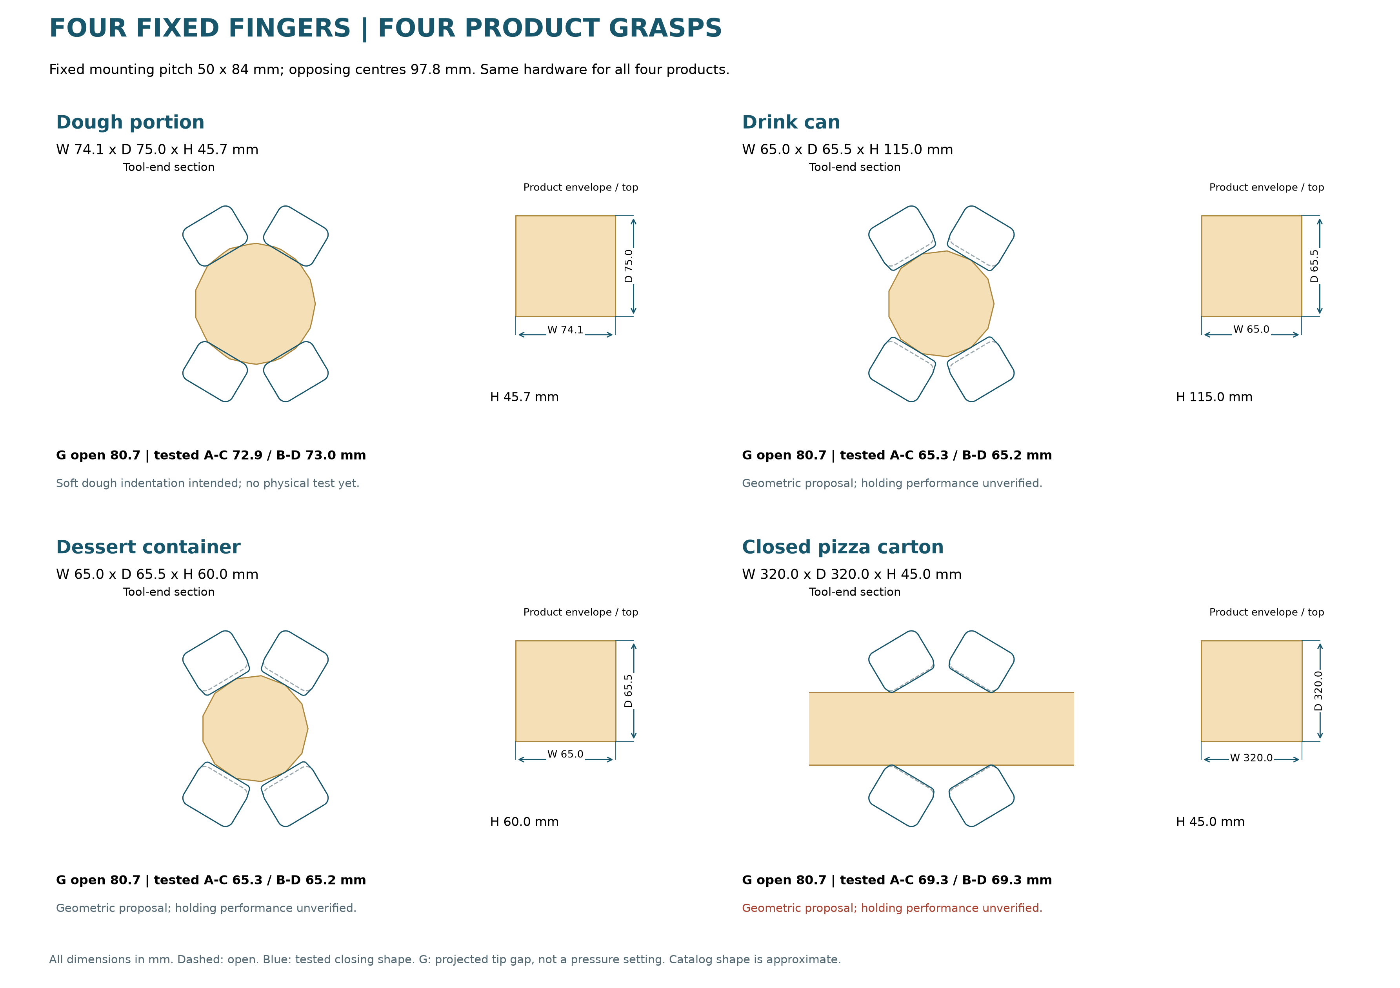
supplier-review/rochu/all-products.png
