kursatkemalkul/autokitch/supplier-review/rochu/box-dimensions.png

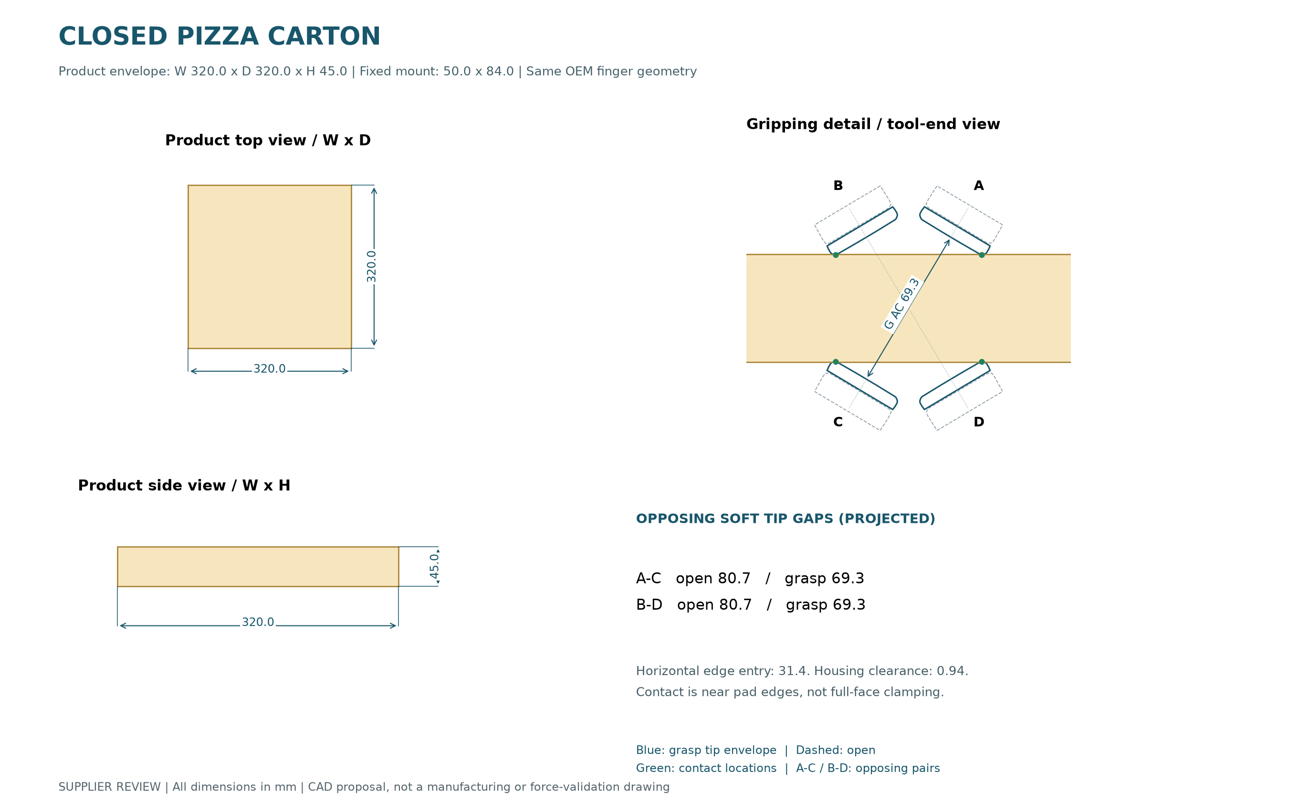
supplier-review/rochu/box-dimensions.png
