kursatkemalkul/autokitch/supplier-review/rochu/catalog/box-dimensions.png

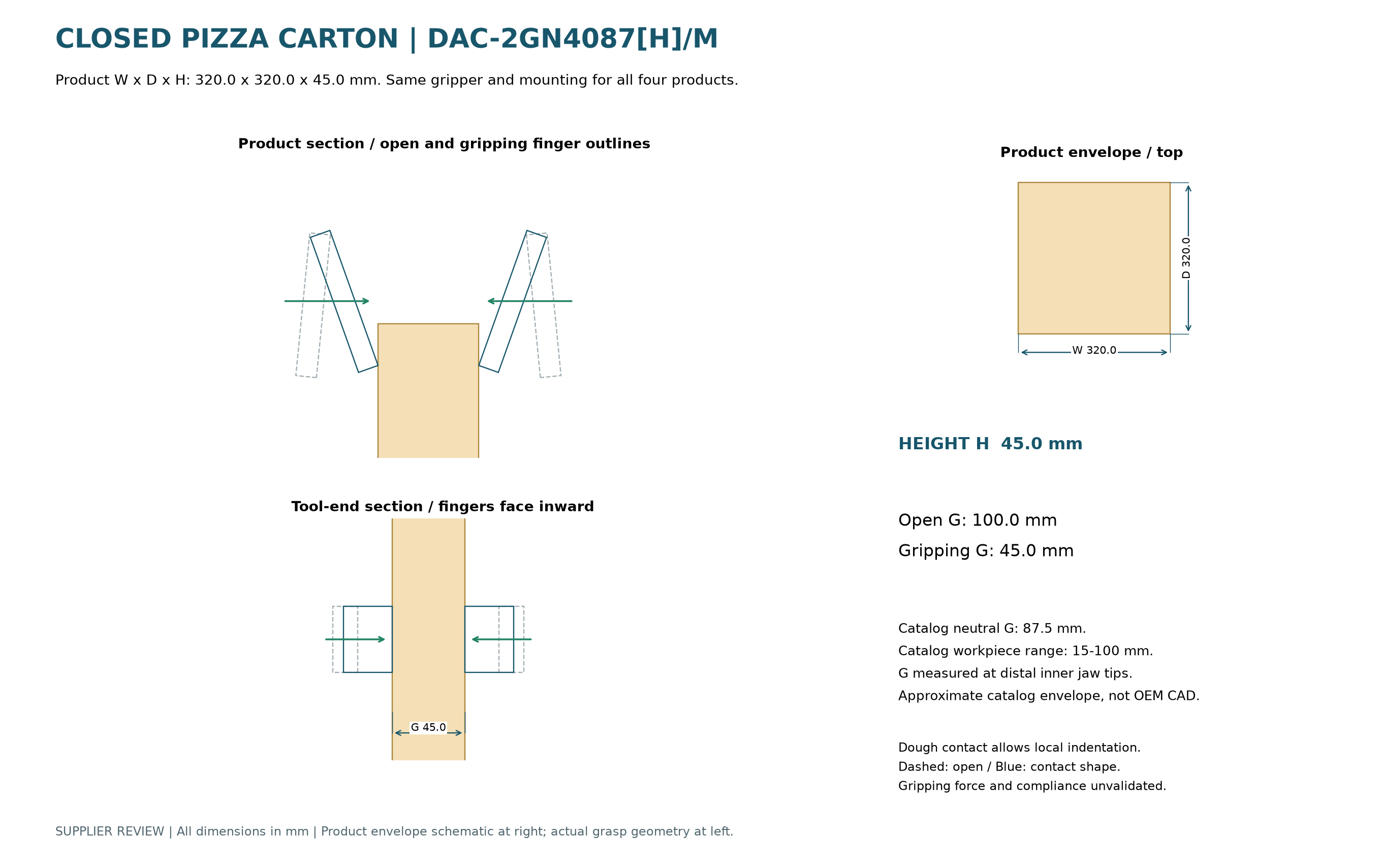
supplier-review/rochu/catalog/box-dimensions.png
