kursatkemalkul/autokitch/supplier-review/rochu/catalog/catalog-source.png

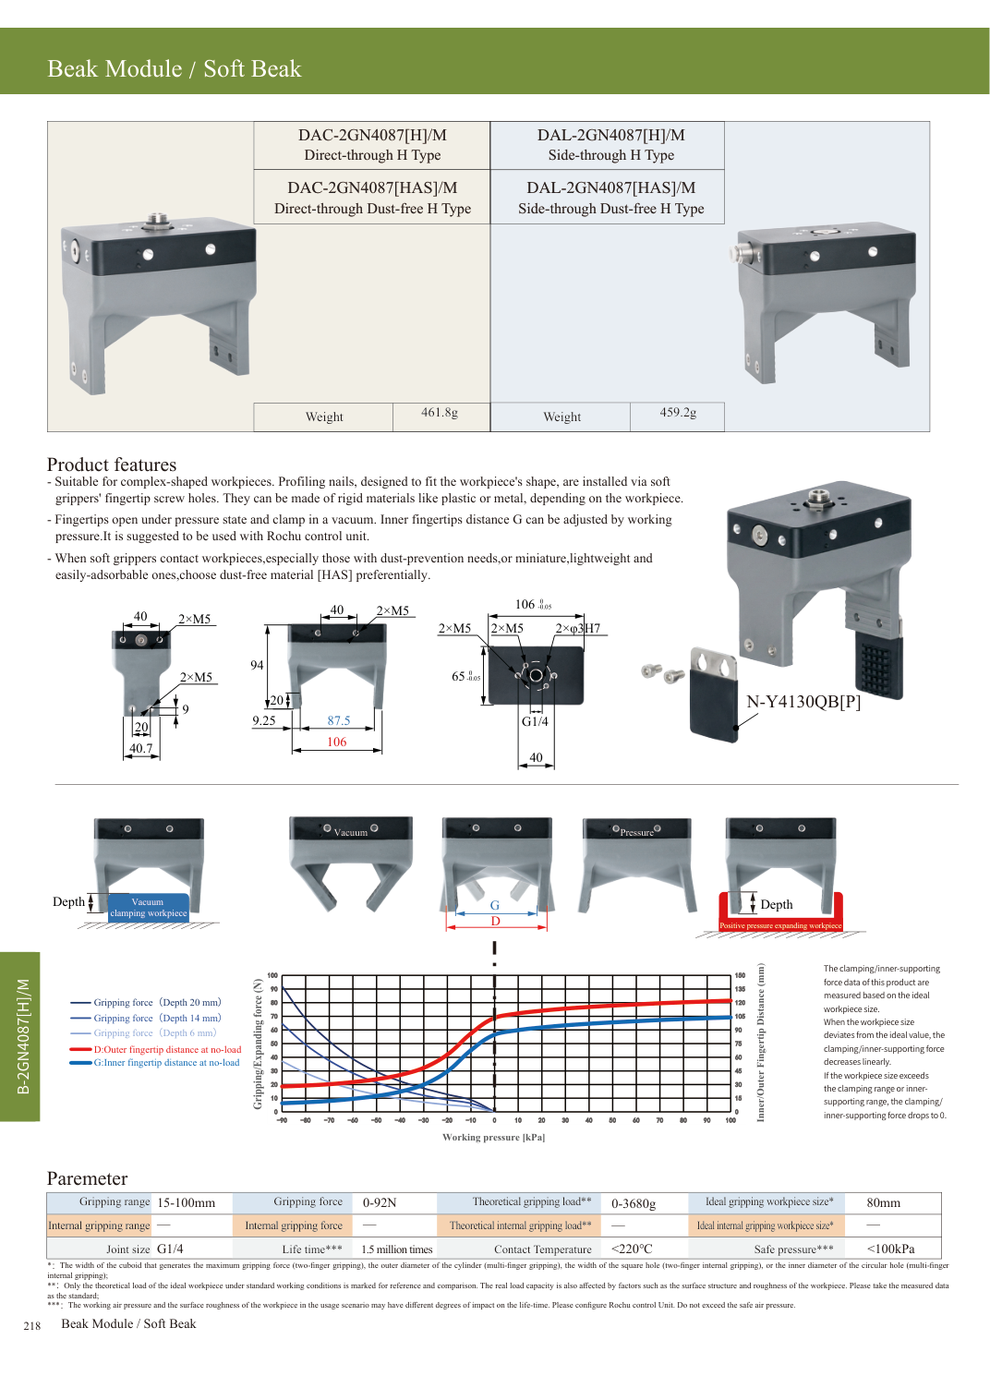
supplier-review/rochu/catalog/catalog-source.png
