kursatkemalkul/autokitch/supplier-review/rochu/cola-dimensions.png

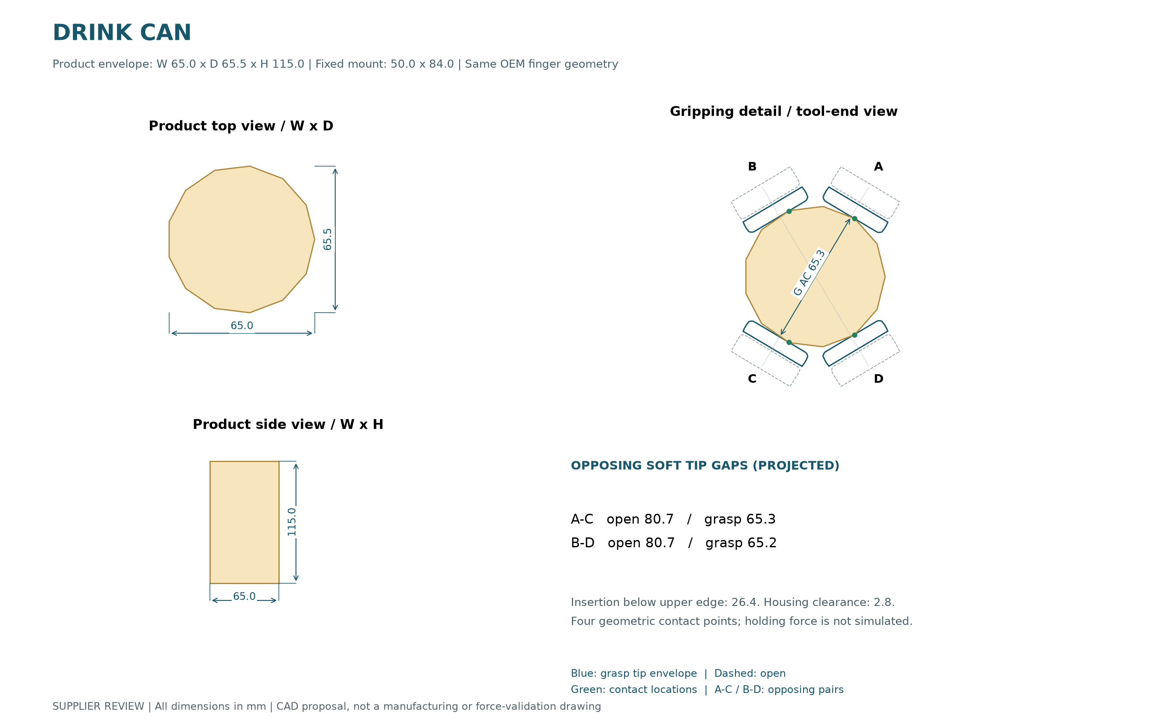
supplier-review/rochu/cola-dimensions.png
