kursatkemalkul/autokitch/supplier-review/rochu/dough-dimensions.png

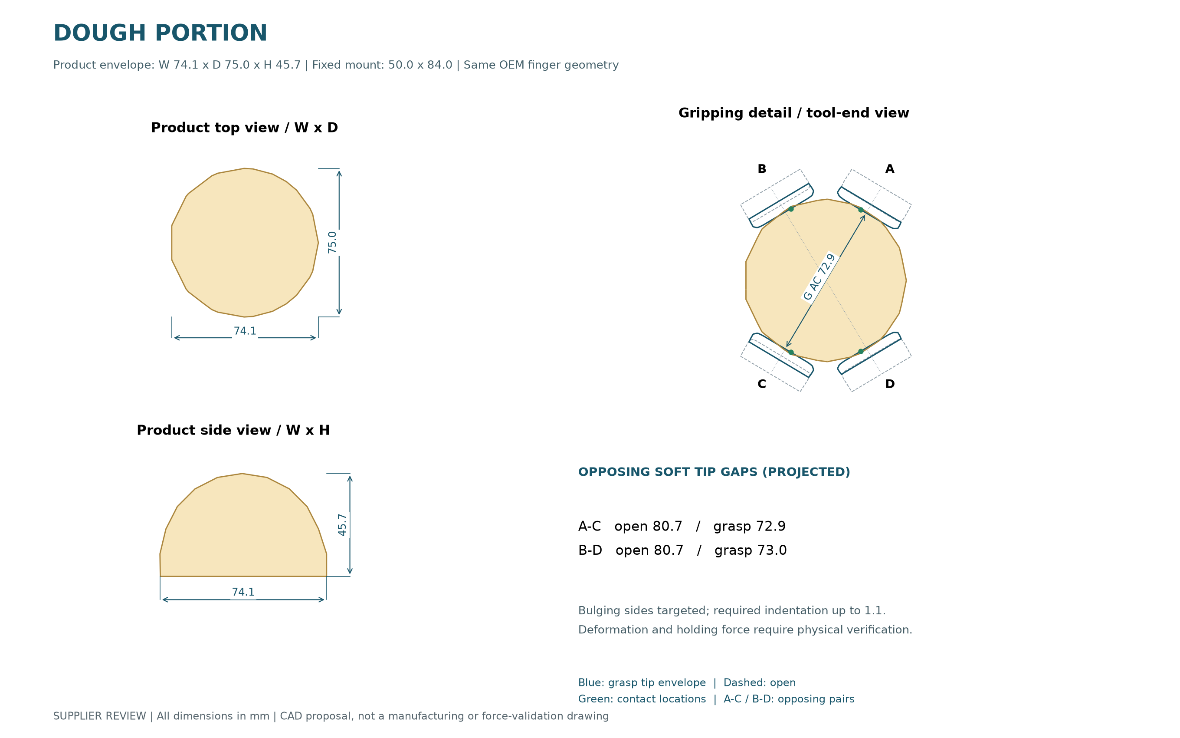
supplier-review/rochu/dough-dimensions.png
