kursatkemalkul/autokitch/supplier-review/rochu/mount-dimensions.png

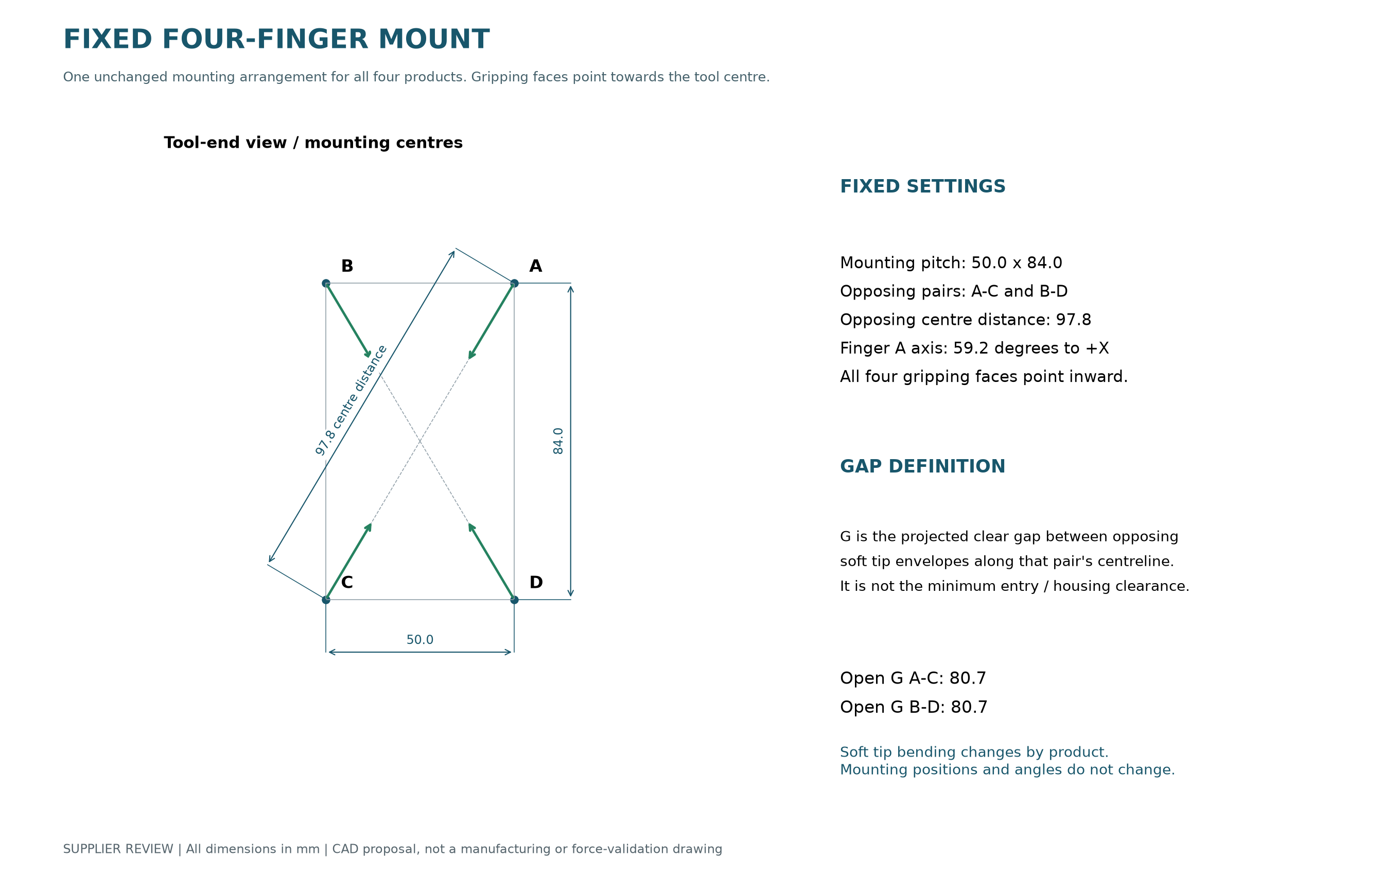
supplier-review/rochu/mount-dimensions.png
