kursatkemalkul/autokitch/supplier-review/rochu/two/box-dimensions.png

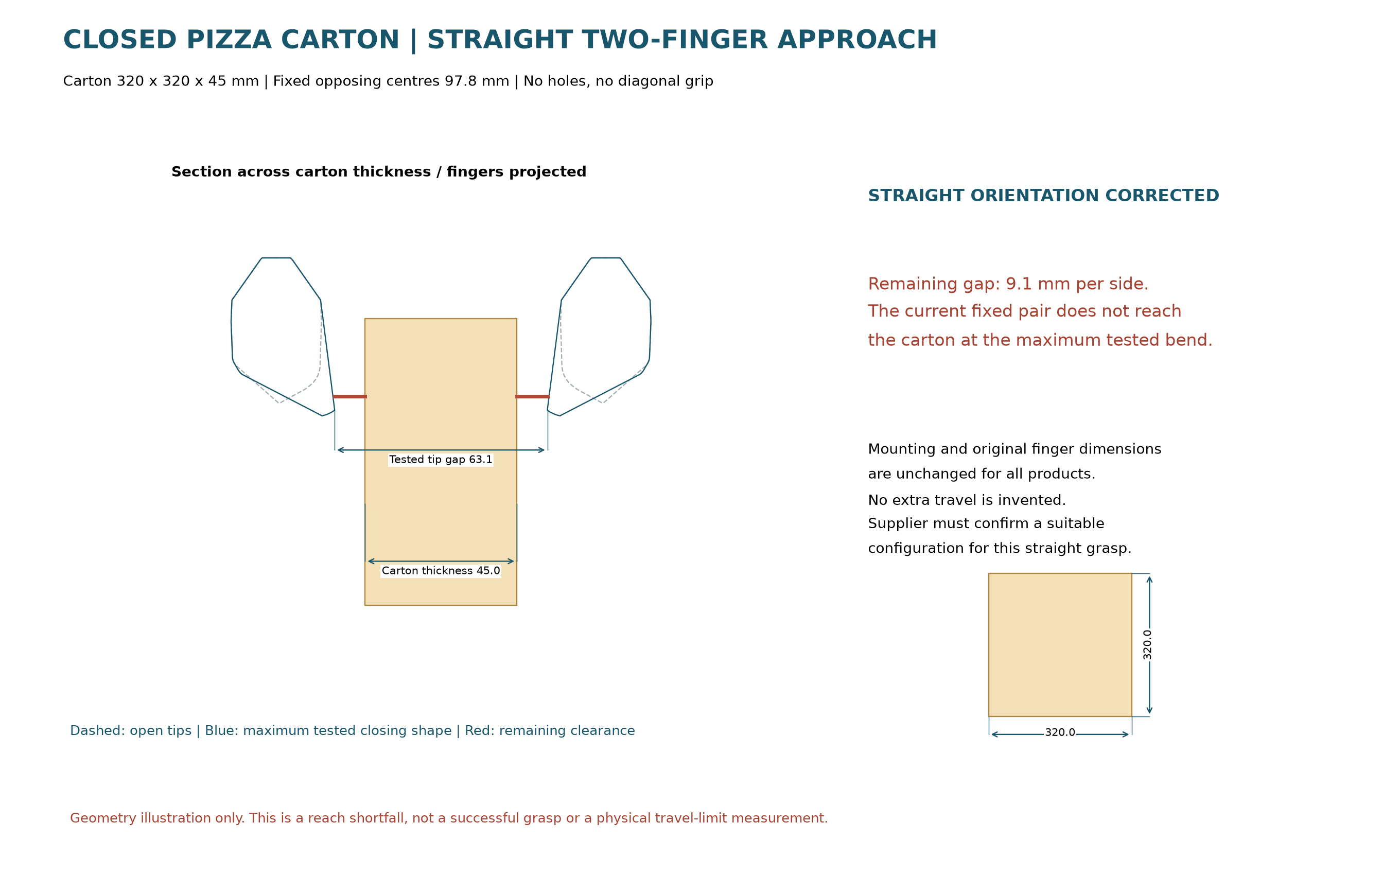
supplier-review/rochu/two/box-dimensions.png
