kursatkemalkul/autokitch/supplier-review/rochu/two/dough-dimensions.png

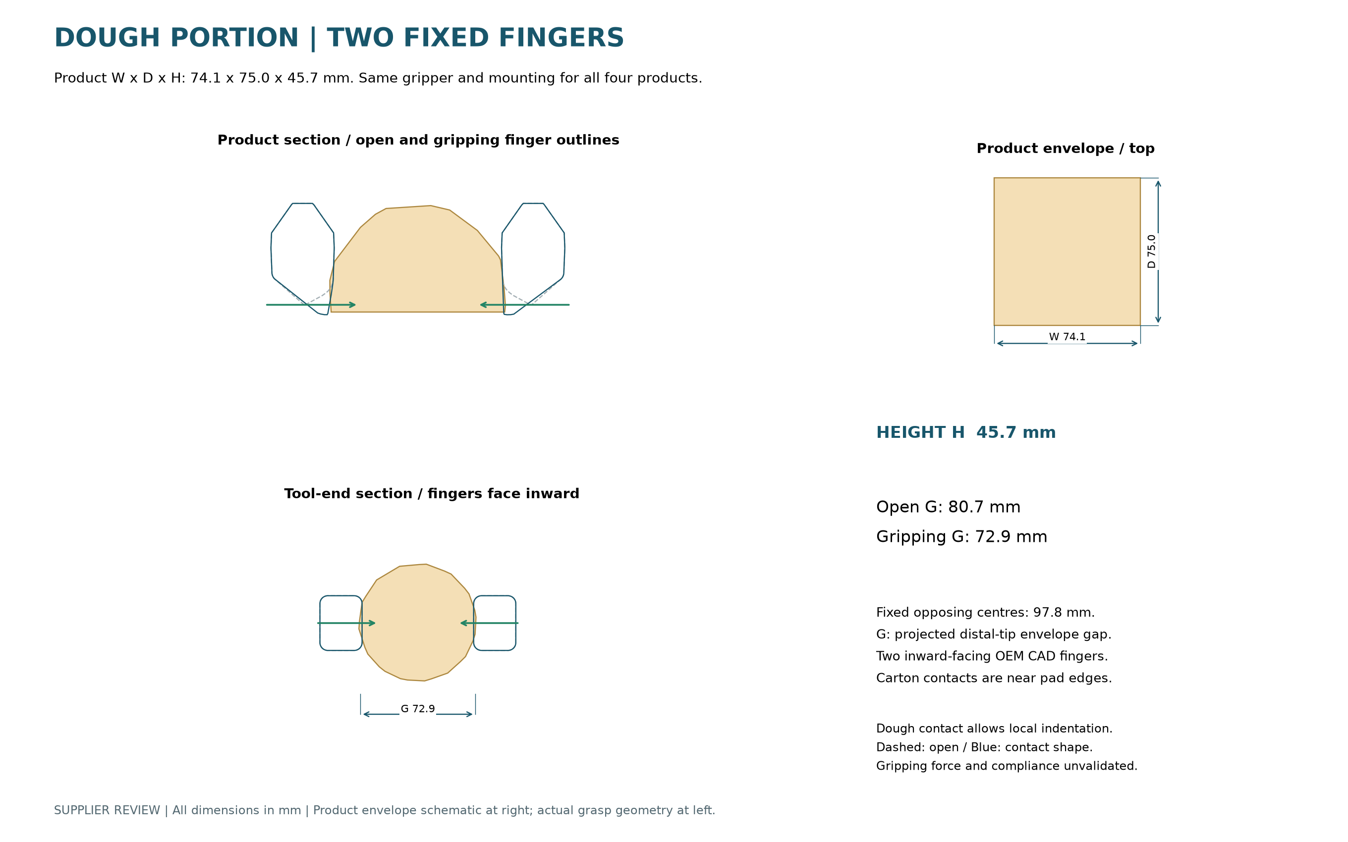
supplier-review/rochu/two/dough-dimensions.png
