kursatkemalkul/autokitch/arastirma/3_TOPPING/alt_montaj/L_RAF_CIFTI/L_RAF_CIFTI.SLDASM

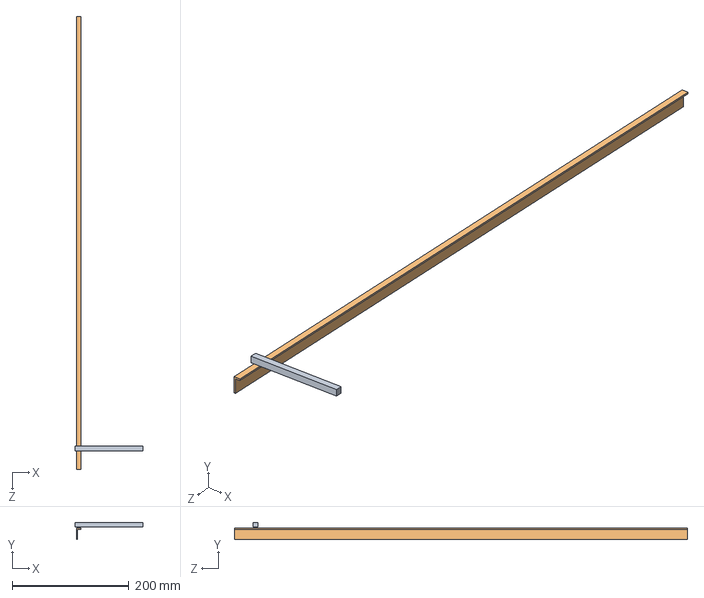
[picture p180: CAD file, 2026-09-08]
arastirma/3_TOPPING/alt_montaj/L_RAF_CIFTI/L_RAF_CIFTI.SLDASM
116.0 x 30.0 x 777.5 mm
LRAF_sol_20x8x2
LRAF_capraz_cubuk_8x8
