kursatkemalkul/autokitch/arastirma/_ortak/HAMUR_TOPU_220g/HAMUR_TOPU_220g.SLDASM

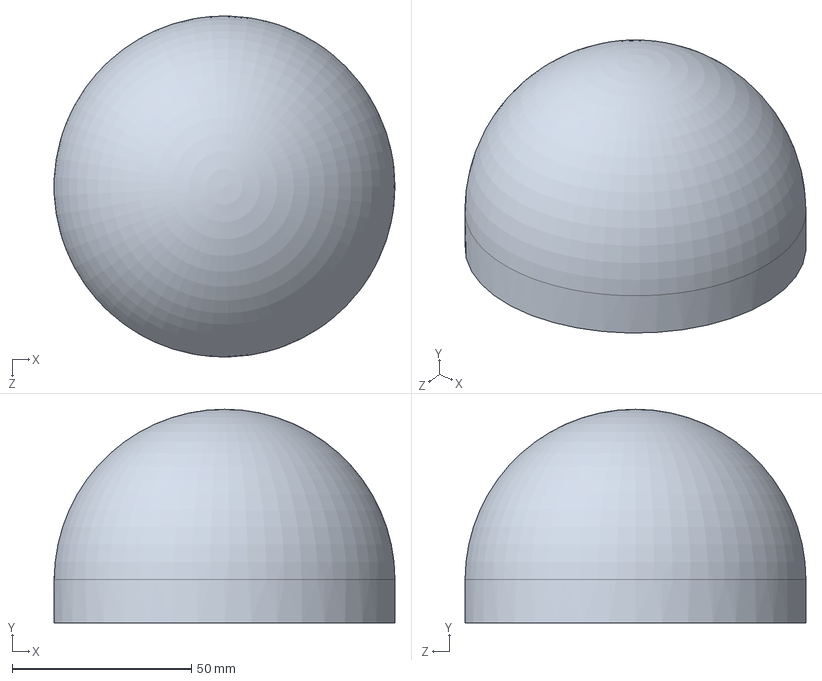
[picture p181: CAD file, 2026-09-08]
arastirma/_ortak/HAMUR_TOPU_220g/HAMUR_TOPU_220g.SLDASM
95.0 x 59.5 x 95.0 mm
