kursatkemalkul/autokitch/arastirma/_ortak/KABLO_24V_D5/KABLO_24V_D5.SLDASM

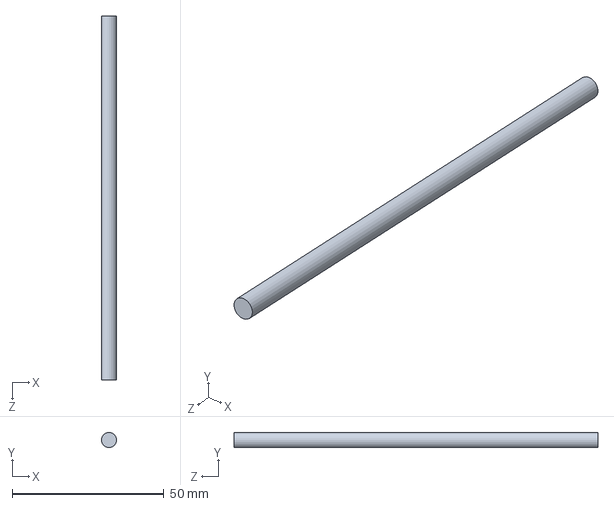
[picture p182: CAD file, 2026-09-08]
arastirma/_ortak/KABLO_24V_D5/KABLO_24V_D5.SLDASM
5.00 x 5.00 x 120.0 mm
