kursatkemalkul/autokitch/arastirma/_ortak/KAYIS_GT3_6mm/KAYIS_GT3_6mm.SLDASM

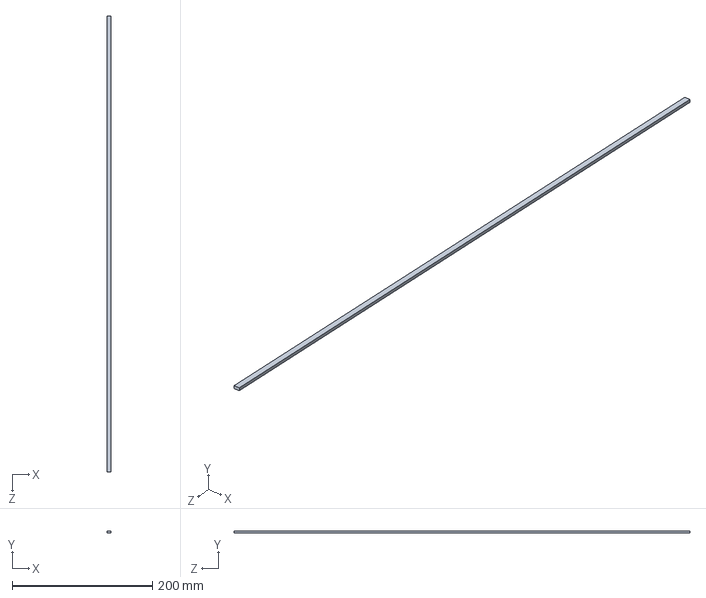
[picture p183: CAD file, 2026-09-08]
arastirma/_ortak/KAYIS_GT3_6mm/KAYIS_GT3_6mm.SLDASM
6.00 x 3.00 x 650.0 mm
