kursatkemalkul/autokitch/arastirma/_ortak/KUTU_BLANK_40x76/KUTU_BLANK_40x76.SLDASM

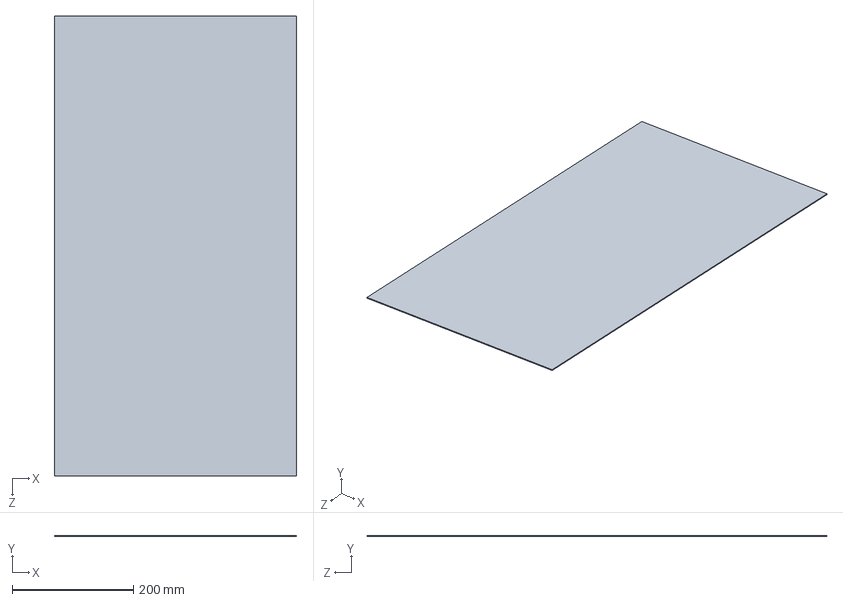
[picture p184: CAD file, 2026-09-08]
arastirma/_ortak/KUTU_BLANK_40x76/KUTU_BLANK_40x76.SLDASM
400.0 x 1.60 x 760.0 mm
