kursatkemalkul/autokitch/arastirma/_ortak/RAY_DIS_PROFIL/RAY_DIS_PROFIL.SLDASM

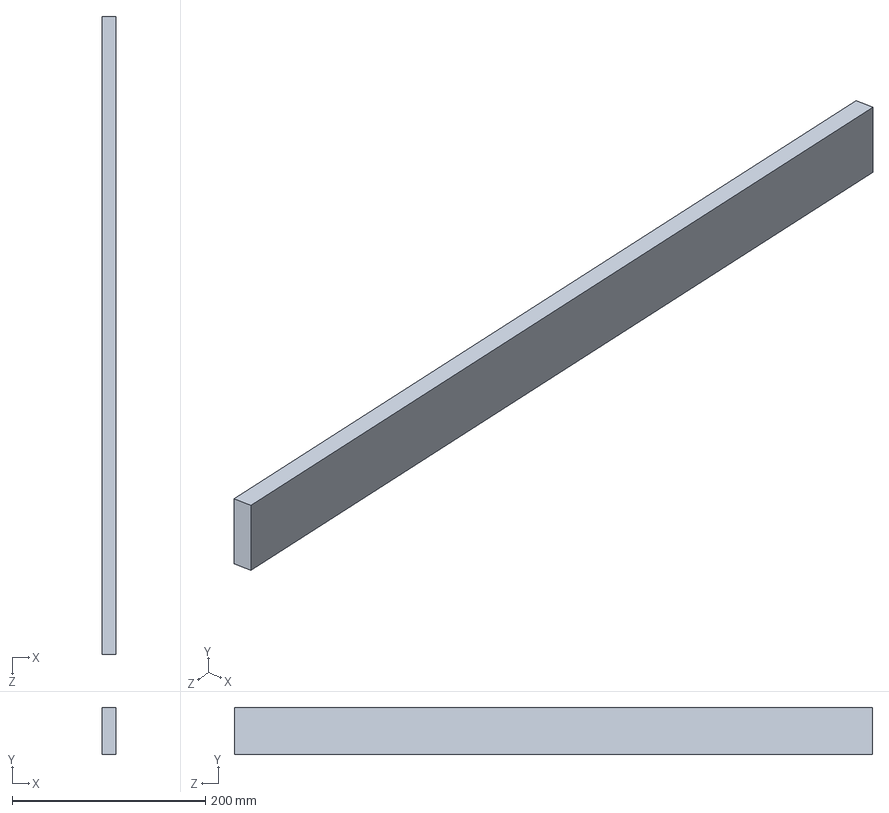
[picture p185: CAD file, 2026-09-08]
arastirma/_ortak/RAY_DIS_PROFIL/RAY_DIS_PROFIL.SLDASM
14.0 x 49.0 x 660.0 mm
