kursatkemalkul/autokitch/arastirma/_ortak/SENSOR_REED_D12/SENSOR_REED_D12.SLDASM

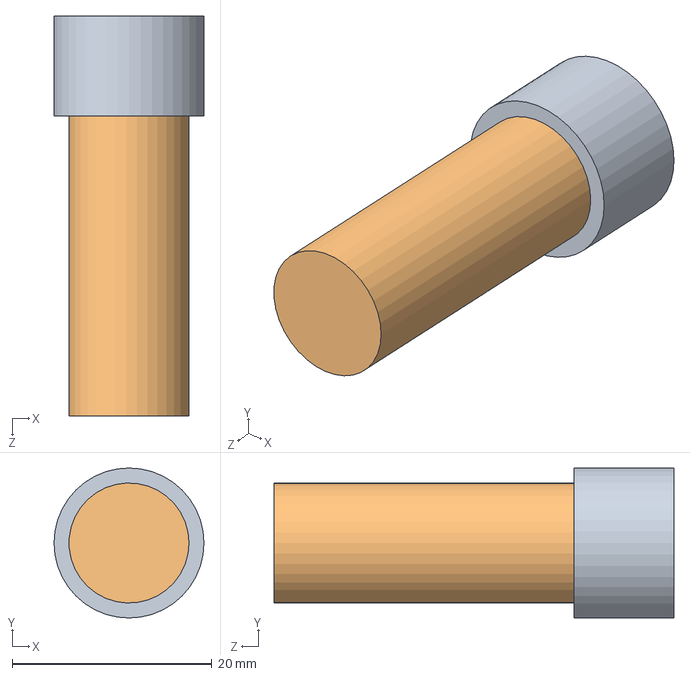
[picture p186: CAD file, 2026-09-08]
arastirma/_ortak/SENSOR_REED_D12/SENSOR_REED_D12.SLDASM
15.0 x 15.0 x 40.0 mm
SNS_govde_D12x30
SNS_M12_soket
