kursatkemalkul/autokitch/arastirma/_ortak/TEPSI_HAMUR_GN21/TEPSI_HAMUR_GN21.SLDASM

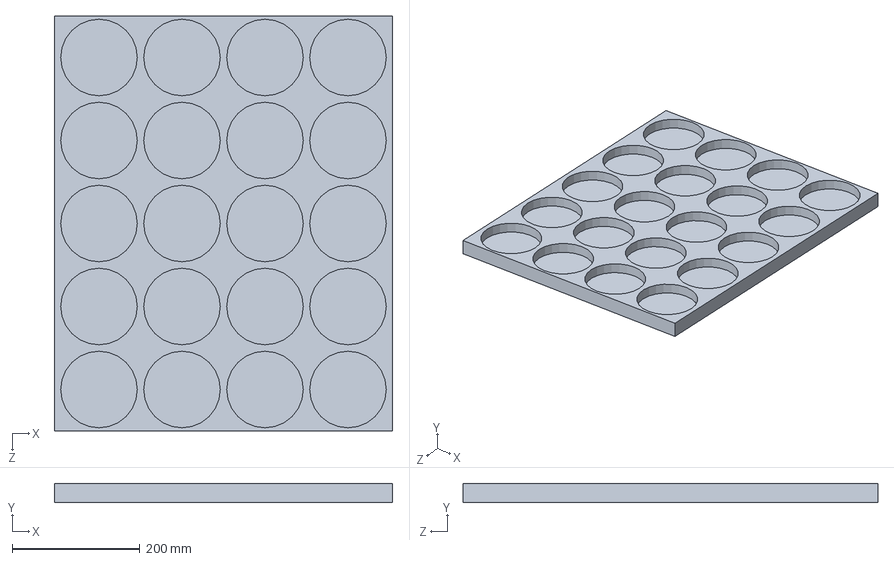
[picture p187: CAD file, 2026-09-08]
arastirma/_ortak/TEPSI_HAMUR_GN21/TEPSI_HAMUR_GN21.SLDASM
530.0 x 30.0 x 650.0 mm
