kursatkemalkul/autokitch/arastirma/_ortak/YUVA_1L/YUVA_1L.SLDASM

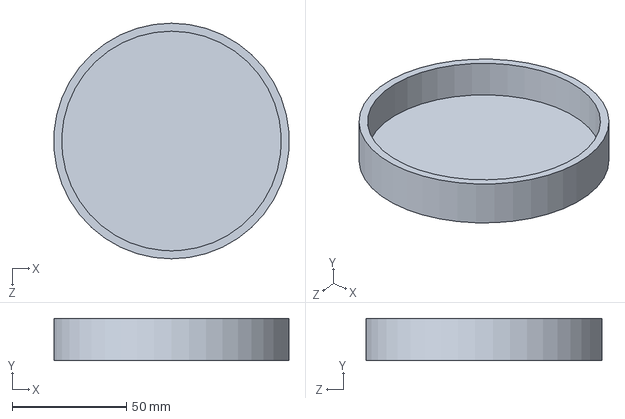
[picture p188: CAD file, 2026-09-08]
arastirma/_ortak/YUVA_1L/YUVA_1L.SLDASM
102.7 x 18.5 x 103.0 mm
