kursatkemalkul/autokitch/arastirma/_ortak/YUVA_icecek/YUVA_icecek.SLDASM

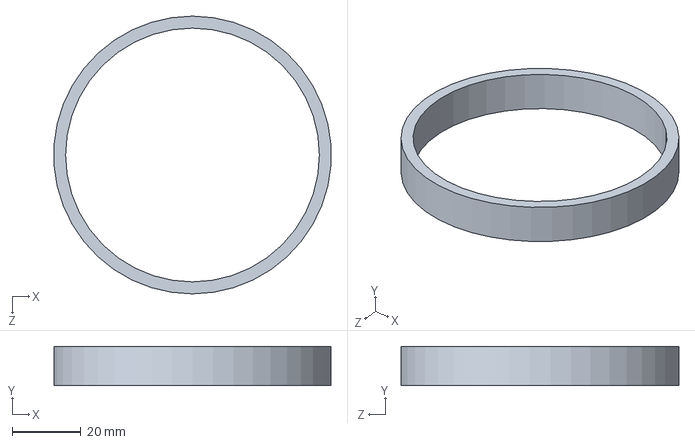
[picture p189: CAD file, 2026-09-08]
arastirma/_ortak/YUVA_icecek/YUVA_icecek.SLDASM
80.8 x 11.5 x 81.0 mm
