kursatkemalkul/autokitch/arastirma/FULL_MAKINE/HAT_dis_v1.SLDASM

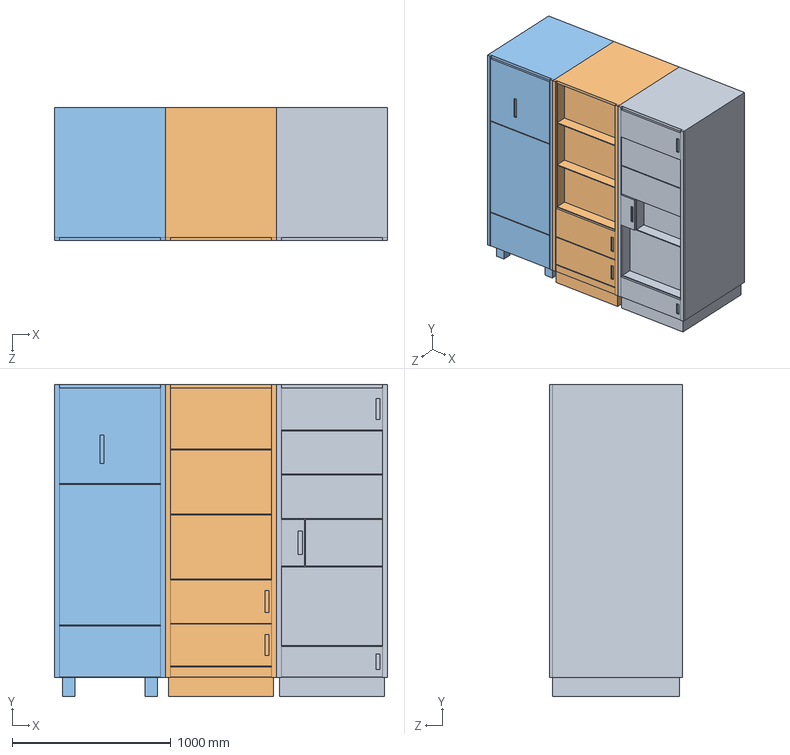
[picture p190: CAD file, 2026-09-08]
arastirma/FULL_MAKINE/HAT_dis_v1.SLDASM
2100.0 x 1970.0 x 840.0 mm
PRESS_dis_v1
TOPPING_dis_v1
OVEN_dis_v1
