kursatkemalkul/autokitch/arastirma/2_PRESS/parca/PRESS_uc_rafi_kosebent_sol.SLDPRT

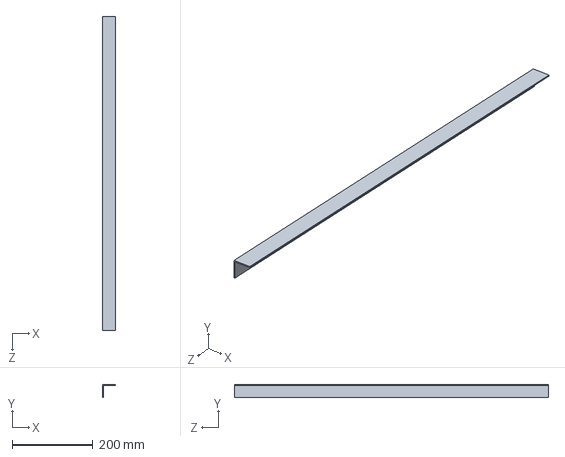
[picture p191: CAD file, 2026-09-08]
arastirma/2_PRESS/parca/PRESS_uc_rafi_kosebent_sol.SLDPRT
32.0 x 32.0 x 780.0 mm
