kursatkemalkul/autokitch/arastirma/2_PRESS/PRESS_dis_v1.SLDPRT

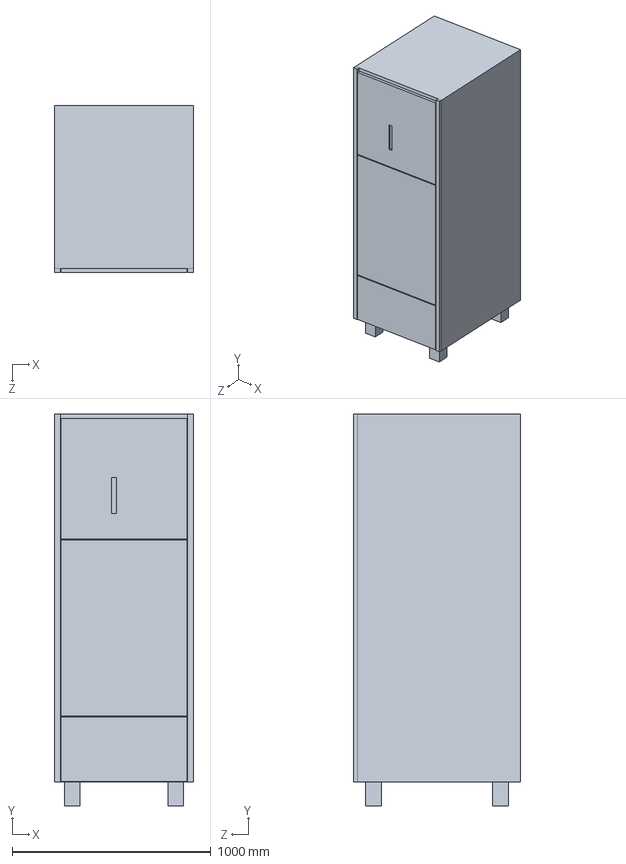
[picture p192: CAD file, 2026-09-08]
arastirma/2_PRESS/PRESS_dis_v1.SLDPRT
700.0 x 1970.0 x 840.0 mm
