kursatkemalkul/autokitch/arastirma/3_TOPPING/alt_montaj/KAP_14x68x24/parca/KAP_tarak_topuz_D30.SLDPRT

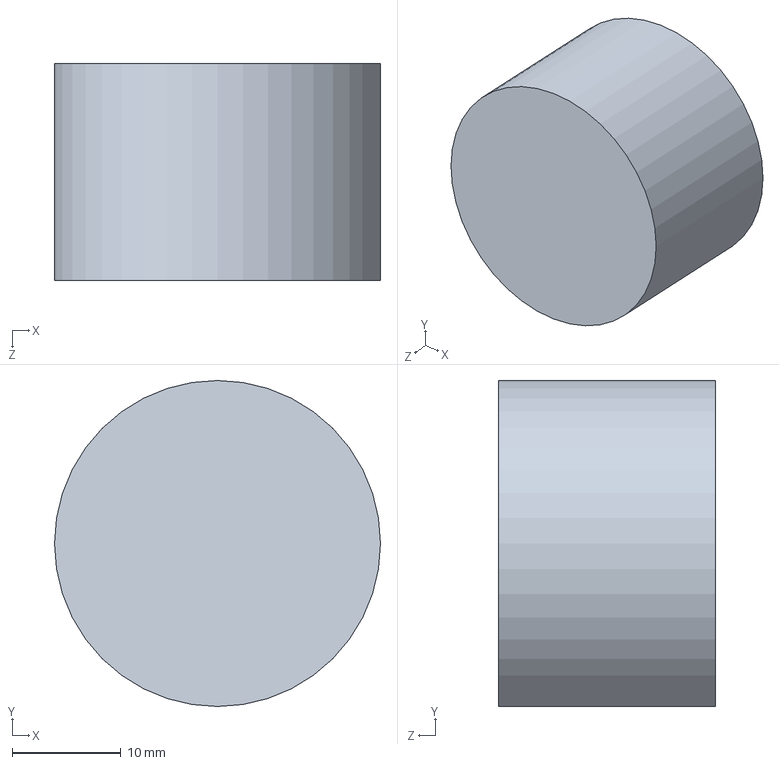
[picture p193: CAD file, 2026-09-08]
arastirma/3_TOPPING/alt_montaj/KAP_14x68x24/parca/KAP_tarak_topuz_D30.SLDPRT
30.0 x 30.0 x 20.0 mm
