kursatkemalkul/autokitch/arastirma/3_TOPPING/alt_montaj/L_RAF_CIFTI/parca/LRAF_capraz_cubuk_8x8.SLDPRT

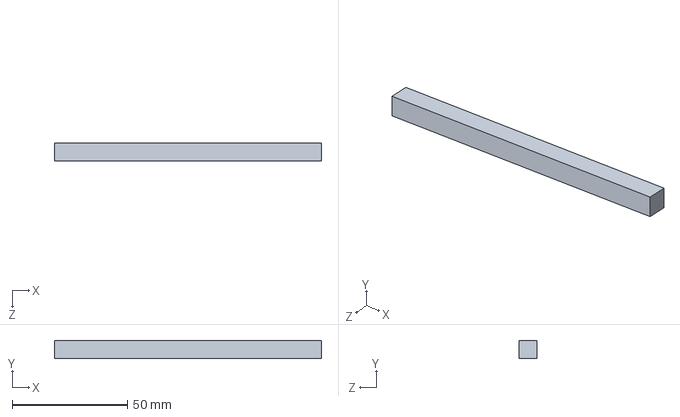
[picture p194: CAD file, 2026-09-08]
arastirma/3_TOPPING/alt_montaj/L_RAF_CIFTI/parca/LRAF_capraz_cubuk_8x8.SLDPRT
116.0 x 8.00 x 8.00 mm
