kursatkemalkul/autokitch/arastirma/3_TOPPING/alt_montaj/SOKET_MOTOR/parca/SM_motor_helezon_57x57x40.SLDPRT

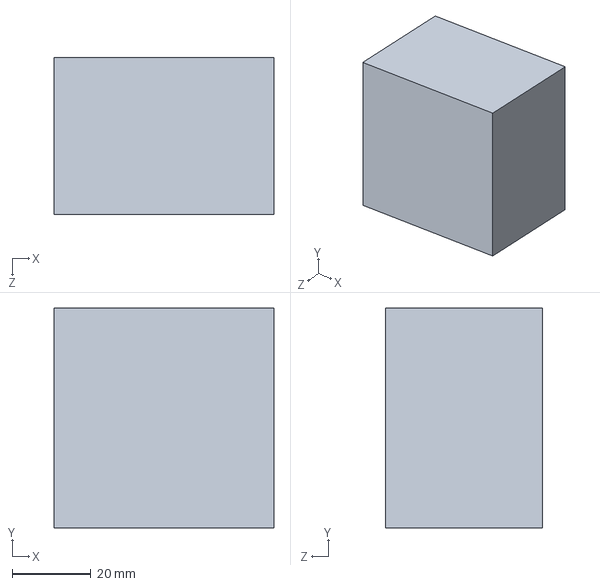
[picture p195: CAD file, 2026-09-08]
arastirma/3_TOPPING/alt_montaj/SOKET_MOTOR/parca/SM_motor_helezon_57x57x40.SLDPRT
56.0 x 56.0 x 40.0 mm
