kursatkemalkul/autokitch/arastirma/3_TOPPING/kasar_kabi_v10/step/somun_arka_1.step

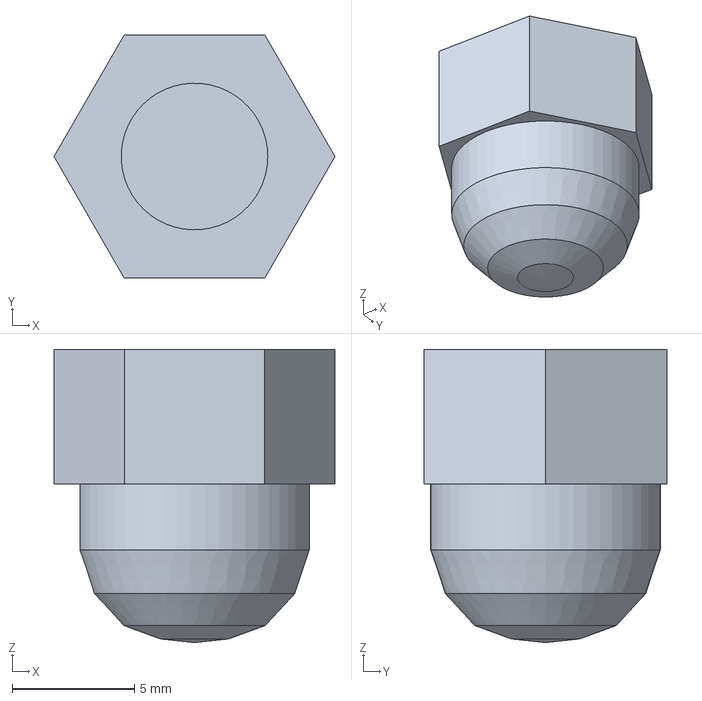
[picture p197: CAD file, 2026-09-21]
arastirma/3_TOPPING/kasar_kabi_v10/step/somun_arka_1.step
11.5 x 9.96 x 12.0 mm
