kursatkemalkul/autokitch/arastirma/3_TOPPING/kiyma_kaseti_v5/KIYMA_KASETI_v5_MONTAJ.step

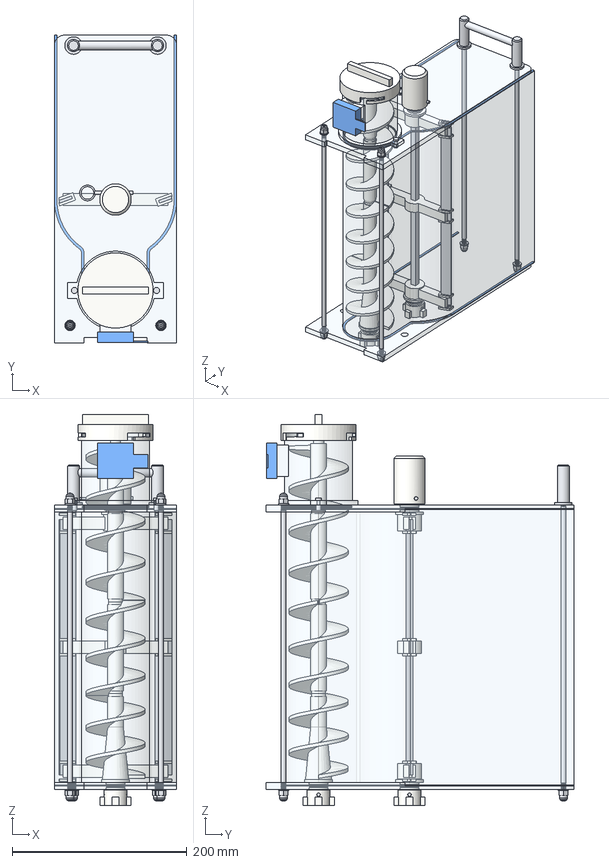
[picture p198: CAD file, 2026-09-21]
arastirma/3_TOPPING/kiyma_kaseti_v5/KIYMA_KASETI_v5_MONTAJ.step
140.0 x 352.0 x 447.0 mm
govde
plaka_arka
plaka_on
saplama_0
somun_arka_0
somun_on_0
saplama_1
somun_arka_1
somun_on_1
saplama_2
somun_arka_2
saplama_3
somun_arka_3
kulp
helezon_A
helezon_B
helezon_C
helezon_D
helezon_cekirdek
gobek_helezon
kavrama_helezon
yayli_pim_helezon
gobek_karistirici
kavrama_karistirici
yayli_pim_karistirici
cikis_tupu
vida_tup_a
vida_tup_b
yatak_kapagi
tasima_tapasi
kar_mil
orumcek_arka
orumcek_orta
orumcek_on
cubuk_0
cubuk_1
on_kovan
topuz
setuskur
kilit_pimi
conta_arka
conta_on
insert_a
insert_b
oring_tup
oring_kapak
oring_gobek_helezon
oring_gobek_karistirici
oring_on_kovan
pul_arka_0
pul_on_0
pul_arka_1
pul_on_1
pul_arka_2
pul_arka_3
