kursatkemalkul/autokitch/arastirma/3_TOPPING/kiyma_kaseti_v5/step/orumcek_orta.step

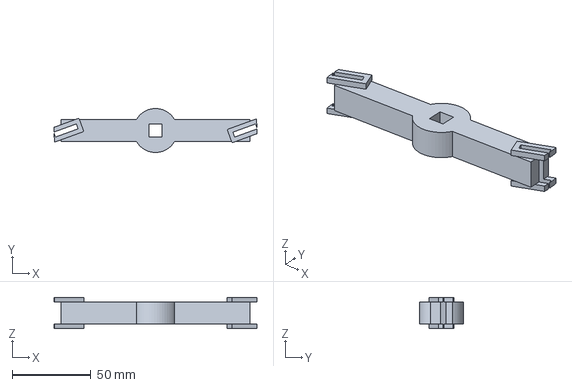
[picture p199: CAD file, 2026-09-21]
arastirma/3_TOPPING/kiyma_kaseti_v5/step/orumcek_orta.step
129.1 x 27.9 x 20.0 mm
