kursatkemalkul/autokitch/arastirma/3_TOPPING/parca/TOPPING_sog_kompresor_yatik_D100.SLDPRT

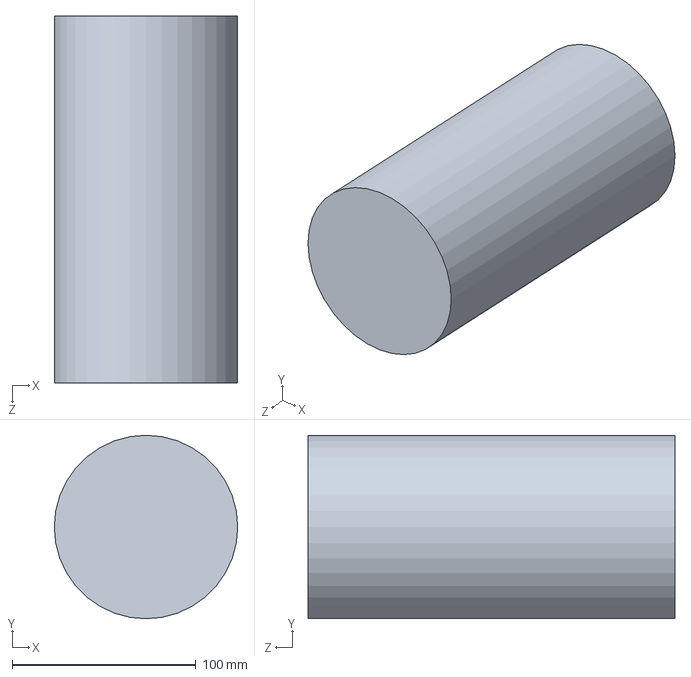
[picture p200: CAD file, 2026-09-08]
arastirma/3_TOPPING/parca/TOPPING_sog_kompresor_yatik_D100.SLDPRT
100.0 x 100.0 x 200.0 mm
