kursatkemalkul/autokitch/arastirma/3_TOPPING/topping_modul_v1/step/din_ray.step

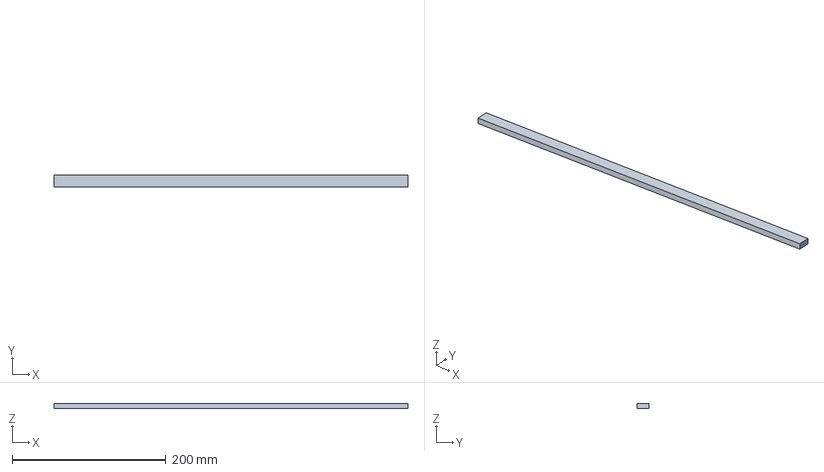
[picture p201: CAD file, 2026-09-21]
arastirma/3_TOPPING/topping_modul_v1/step/din_ray.step
460.0 x 15.0 x 7.00 mm
