kursatkemalkul/autokitch/arastirma/3_TOPPING/topping_modul_v1/TOPPING_MODUL_v1_MONTAJ.step

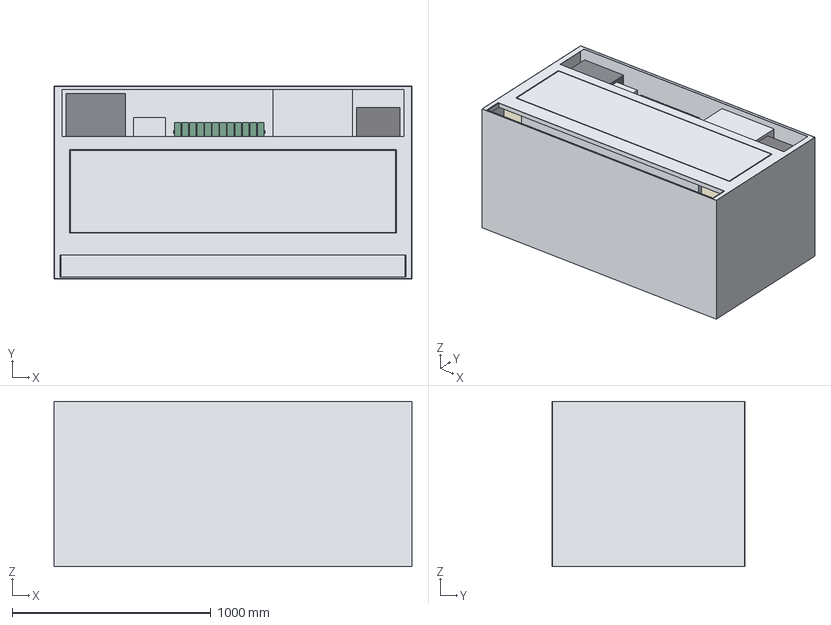
[picture p202: CAD file, 2026-09-21]
arastirma/3_TOPPING/topping_modul_v1/TOPPING_MODUL_v1_MONTAJ.step
1800.0 x 970.0 x 830.0 mm
dis_taban
dis_tavan
dis_yan_sol
dis_yan_sag
dis_arka
on_cerceve
pu_taban
pu_tavan
pu_sol
pu_sag
pu_arka
ic_kabuk
on_kapak
kapak_contasi
mentese_0
mentese_1
ray_HARÃ_1
konum_pimi_HARÃ_1_0
konum_pimi_HARÃ_1_1
huni_HARÃ_1
ray_HARÃ_2
konum_pimi_HARÃ_2_0
konum_pimi_HARÃ_2_1
huni_HARÃ_2
ray_KIYMA
konum_pimi_KIYMA_0
konum_pimi_KIYMA_1
huni_KIYMA
ray_KUÅBAÅI
konum_pimi_KUÅBAÅI_0
konum_pimi_KUÅBAÅI_1
huni_KUÅBAÅI
ray_KAÅAR_KABI
konum_pimi_KAÅAR_KABI_0
konum_pimi_KAÅAR_KABI_1
huni_KAÅAR_KABI
ray_KÃP_SUCUK
konum_pimi_KÃP_SUCUK_0
konum_pimi_KÃP_SUCUK_1
huni_KÃP_SUCUK
bolme_0
bolme_1
bolme_2
bolme_3
bolme_4
bolme_5
bolme_6
soket_HARÃ_1_helezon
yay_HARÃ_1_helezon
mil_HARÃ_1_helezon
kovan_HARÃ_1_helezon
reduktor_HARÃ_1_helezon
motor_HARÃ_1_helezon
soket_HARÃ_1_rotor
yay_HARÃ_1_rotor
mil_HARÃ_1_rotor
kovan_HARÃ_1_rotor
reduktor_HARÃ_1_rotor
motor_HARÃ_1_rotor
soket_HARÃ_2_helezon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
