kursatkemalkul/autokitch/arastirma/4_OVEN/parca/OVEN_pano_psu_24V.SLDPRT

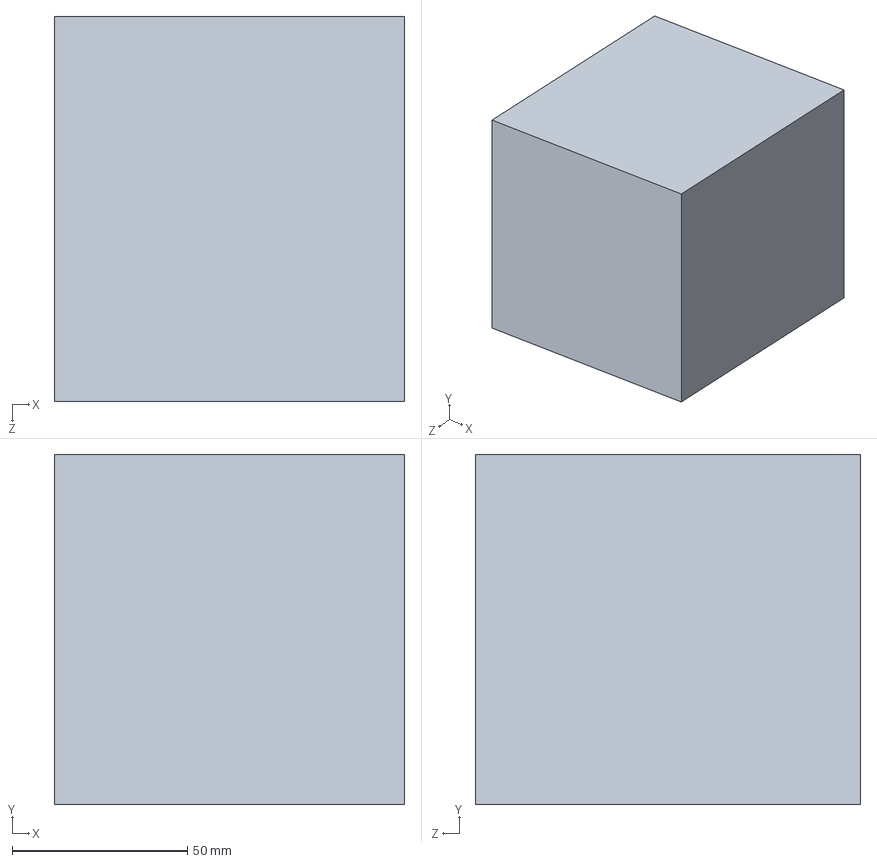
[picture p203: CAD file, 2026-09-08]
arastirma/4_OVEN/parca/OVEN_pano_psu_24V.SLDPRT
100.0 x 100.0 x 110.0 mm
