kursatkemalkul/autokitch/arastirma/_ortak/FIRIN_KAPAK_CAM/parca/FKAP_cam_ic_4mm.SLDPRT

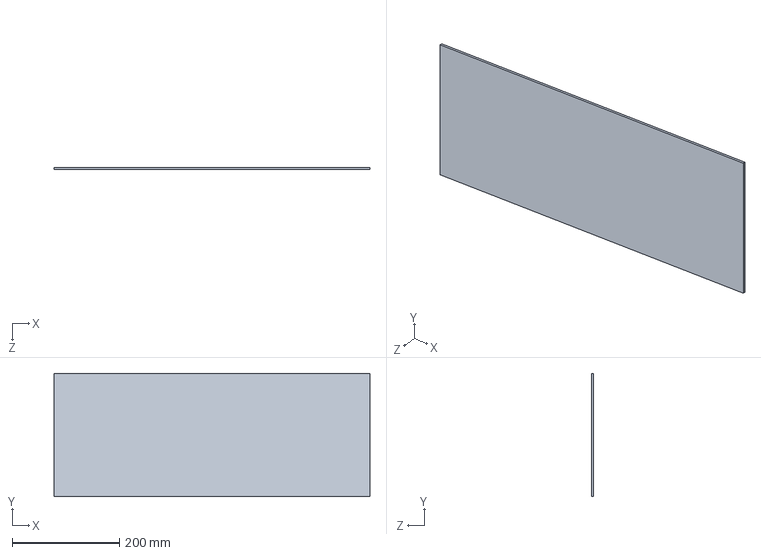
[picture p204: CAD file, 2026-09-08]
arastirma/_ortak/FIRIN_KAPAK_CAM/parca/FKAP_cam_ic_4mm.SLDPRT
590.0 x 230.0 x 4.00 mm
