kursatkemalkul/autokitch/arastirma/_ortak/KAP_YAG_14x68x24/parca/KAPYAG_kuru_baglanti_D12.SLDPRT

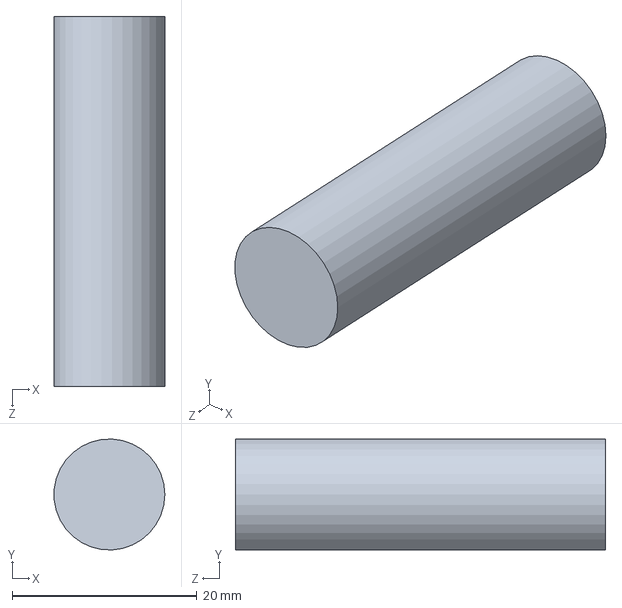
[picture p205: CAD file, 2026-09-08]
arastirma/_ortak/KAP_YAG_14x68x24/parca/KAPYAG_kuru_baglanti_D12.SLDPRT
12.0 x 12.0 x 40.0 mm
