kursatkemalkul/autokitch/arastirma/_ortak/KUTU_KATLI_32x32/parca/KUTU_duvar_sag.SLDPRT

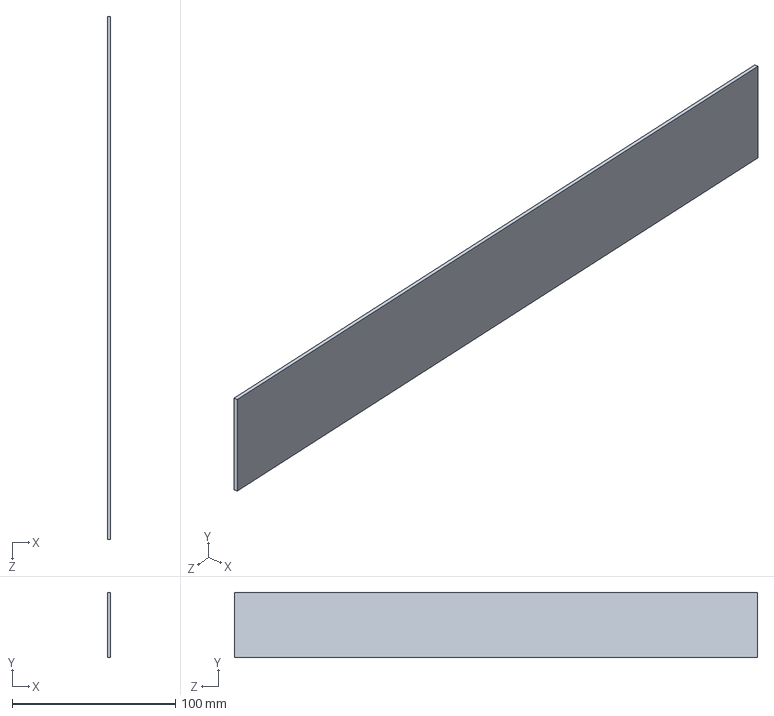
[picture p206: CAD file, 2026-09-08]
arastirma/_ortak/KUTU_KATLI_32x32/parca/KUTU_duvar_sag.SLDPRT
1.60 x 40.0 x 320.0 mm
