kursatkemalkul/autokitch/arastirma/_ortak/MOTOR_TAHRIK_GRUBU/parca/MTG_kasnak_D30_kayis.SLDPRT

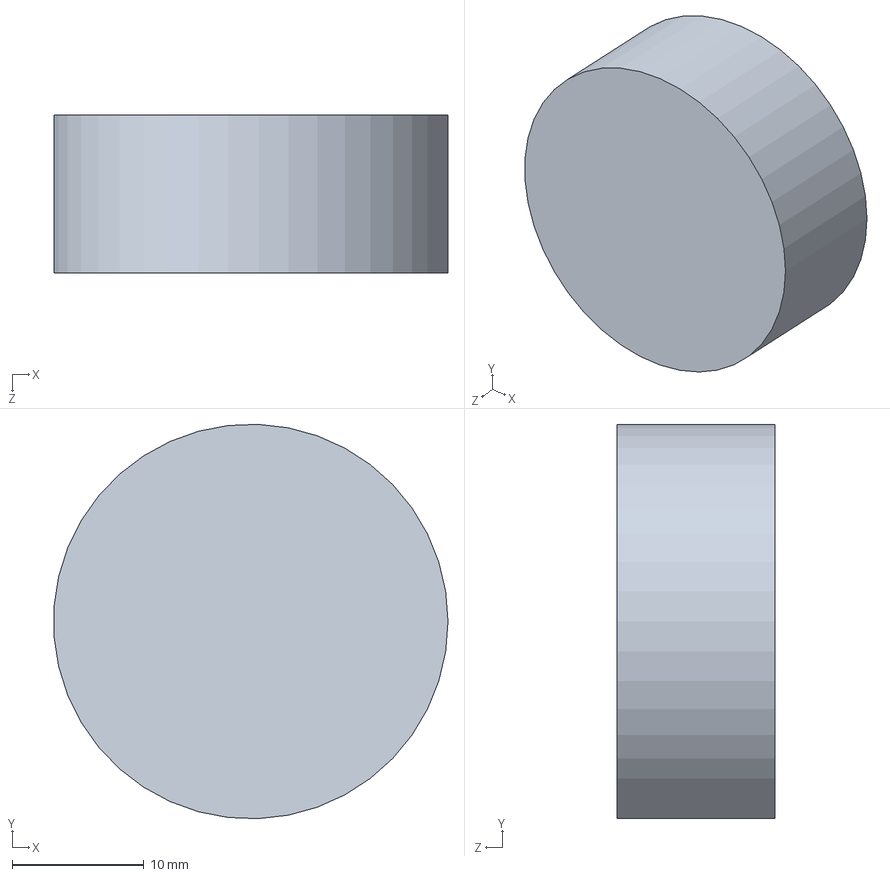
[picture p208: CAD file, 2026-09-08]
arastirma/_ortak/MOTOR_TAHRIK_GRUBU/parca/MTG_kasnak_D30_kayis.SLDPRT
30.0 x 30.0 x 12.0 mm
