kursatkemalkul/autokitch/arastirma/_ortak/SENSOR_REED_D12/parca/SNS_govde_D12x30.SLDPRT

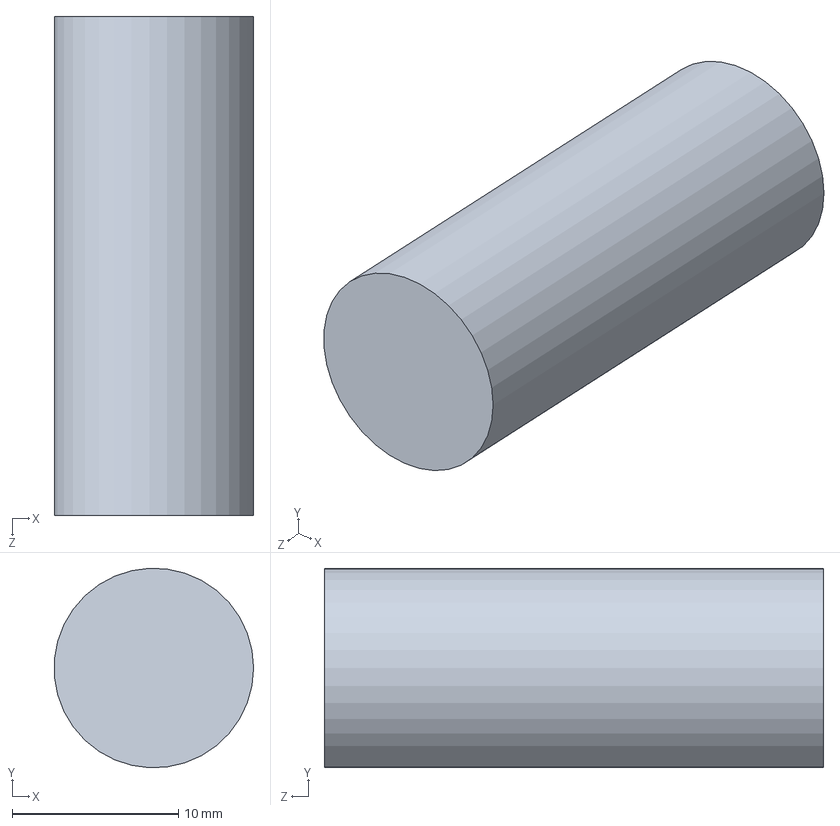
[picture p209: CAD file, 2026-09-08]
arastirma/_ortak/SENSOR_REED_D12/parca/SNS_govde_D12x30.SLDPRT
12.0 x 12.0 x 30.0 mm
