kursatkemalkul/autokitch/arastirma/_ortak/SISE_KOLA_1L/parca/KOLA1L_govde_D88.SLDPRT

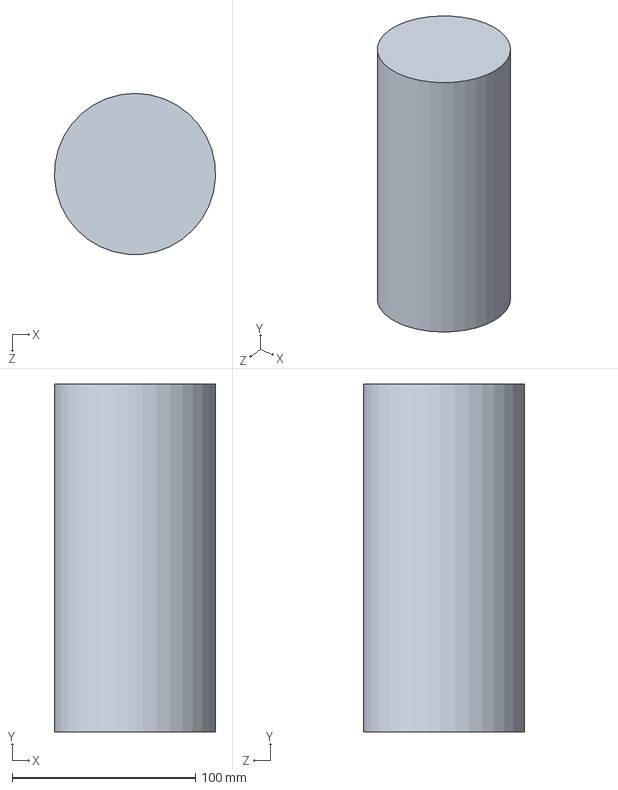
[picture p210: CAD file, 2026-09-08]
arastirma/_ortak/SISE_KOLA_1L/parca/KOLA1L_govde_D88.SLDPRT
87.9 x 190.0 x 88.0 mm
