kursatkemalkul/autokitch/arastirma/_ortak/TEPSI_D320/parca/TEPSI_disk_D320_alu_1.5.SLDPRT

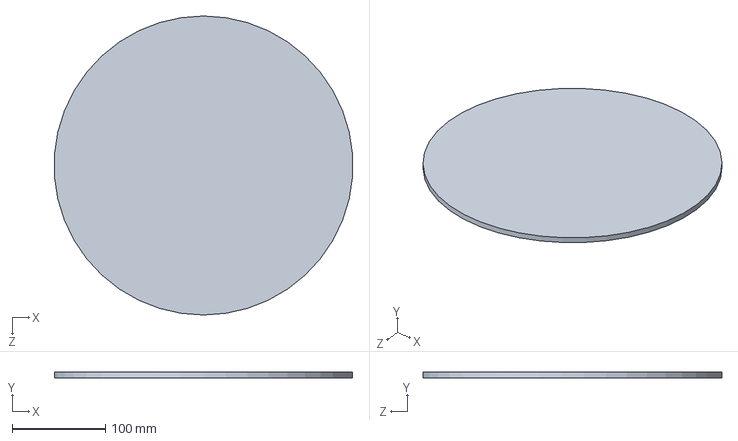
[picture p211: CAD file, 2026-09-08]
arastirma/_ortak/TEPSI_D320/parca/TEPSI_disk_D320_alu_1.5.SLDPRT
319.1 x 6.00 x 320.0 mm
