kursatkemalkul/autokitch/arastirma/_ortak/UC_YUVASI/parca/UCY_taban_180x20x340.SLDPRT

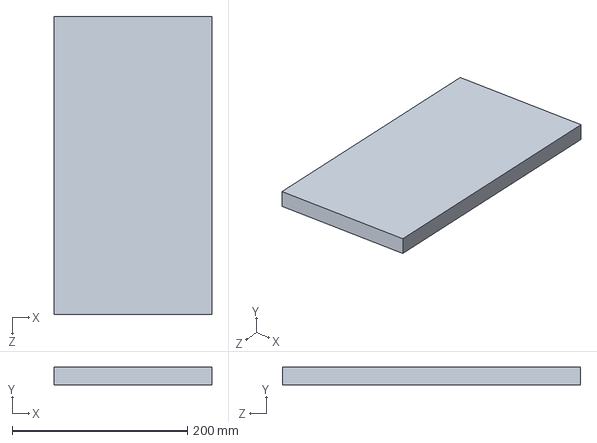
[picture p212: CAD file, 2026-09-08]
arastirma/_ortak/UC_YUVASI/parca/UCY_taban_180x20x340.SLDPRT
180.0 x 20.0 x 340.0 mm
