kursatkemalkul/autokitch/arastirma/_ortak/VANTUZ_D40/parca/VNT_govde_D24.SLDPRT

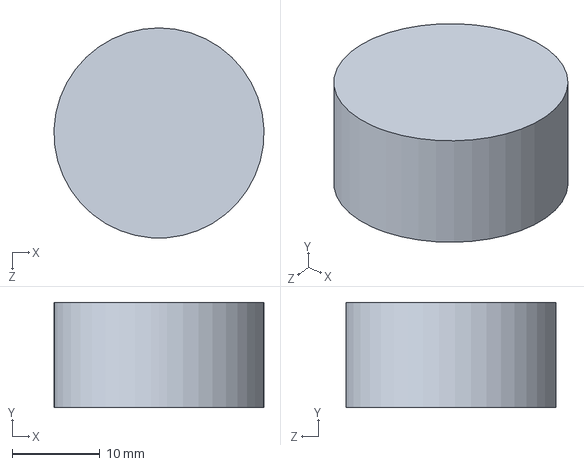
[picture p213: CAD file, 2026-09-08]
arastirma/_ortak/VANTUZ_D40/parca/VNT_govde_D24.SLDPRT
24.0 x 12.0 x 24.0 mm
