kursatkemalkul/autokitch/arastirma/FULL_MAKINE/HAT_v5_YERLESIM.step

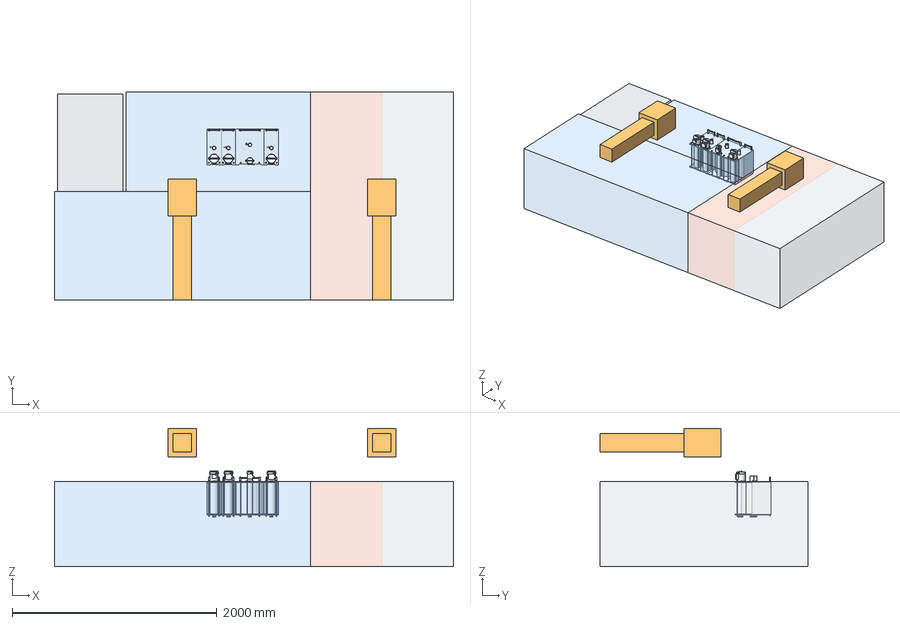
[picture p214: CAD file, 2026-09-21]
arastirma/FULL_MAKINE/HAT_v5_YERLESIM.step
3900.0 x 2030.0 x 1350.0 mm
KASET_HARÃ_1
TAHRIK_HARÃ_1
KASET_HARÃ_2
TAHRIK_HARÃ_2
KASET_KIYMA__govde
KASET_KIYMA__plaka_arka
KASET_KIYMA__plaka_on
KASET_KIYMA__saplama_0
KASET_KIYMA__somun_arka_0
KASET_KIYMA__somun_on_0
KASET_KIYMA__saplama_1
KASET_KIYMA__somun_arka_1
KASET_KIYMA__somun_on_1
KASET_KIYMA__saplama_2
KASET_KIYMA__somun_arka_2
KASET_KIYMA__saplama_3
KASET_KIYMA__somun_arka_3
KASET_KIYMA__kulp
KASET_KIYMA__helezon_A
KASET_KIYMA__helezon_B
KASET_KIYMA__helezon_C
KASET_KIYMA__helezon_D
KASET_KIYMA__helezon_cekirdek
KASET_KIYMA__gobek_helezon
KASET_KIYMA__kavrama_helezon
KASET_KIYMA__yayli_pim_helezon
KASET_KIYMA__gobek_karistirici
KASET_KIYMA__kavrama_karistirici
KASET_KIYMA__yayli_pim_karistirici
KASET_KIYMA__cikis_tupu
KASET_KIYMA__vida_tup_a
KASET_KIYMA__vida_tup_b
KASET_KIYMA__yatak_kapagi
KASET_KIYMA__tasima_tapasi
KASET_KIYMA__kar_mil
KASET_KIYMA__orumcek_arka
KASET_KIYMA__orumcek_orta
KASET_KIYMA__orumcek_on
KASET_KIYMA__cubuk_0
KASET_KIYMA__cubuk_1
KASET_KIYMA__on_kovan
KASET_KIYMA__topuz
KASET_KIYMA__setuskur
KASET_KIYMA__kilit_pimi
KASET_KIYMA__conta_arka
KASET_KIYMA__conta_on
KASET_KIYMA__insert_a
KASET_KIYMA__insert_b
KASET_KIYMA__oring_tup
KASET_KIYMA__oring_kapak
KASET_KIYMA__oring_gobek_helezon
KASET_KIYMA__oring_gobek_karistirici
KASET_KIYMA__oring_on_kovan
KASET_KIYMA__pul_arka_0
KASET_KIYMA__pul_on_0
KASET_KIYMA__pul_arka_1
KASET_KIYMA__pul_on_1
KASET_KIYMA__pul_arka_2
KASET_KIYMA__pul_arka_3
TAHRIK_KIYMA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
