kursatkemalkul/autokitch/arastirma/katalog/step/a9n21555.stp

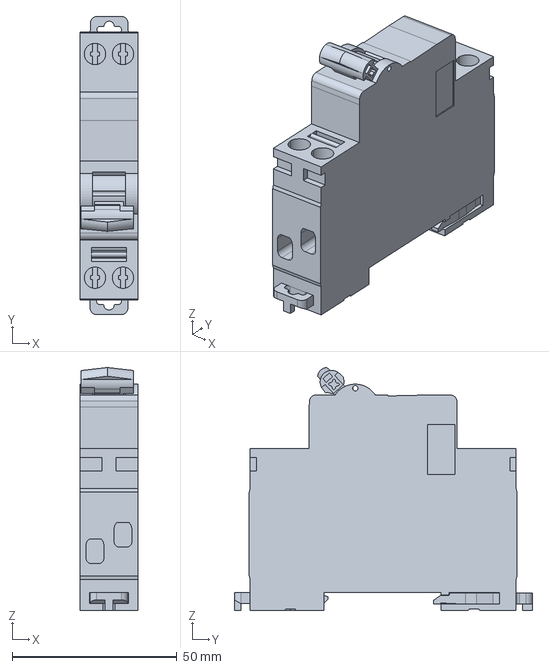
[picture p215: CAD file, 2026-10-05]
arastirma/katalog/step/a9n21555.stp
17.5 x 90.6 x 73.8 mm
