kursatkemalkul/autokitch/arastirma/2_PRESS/parca/PRESS_kova_tabani.SLDPRT

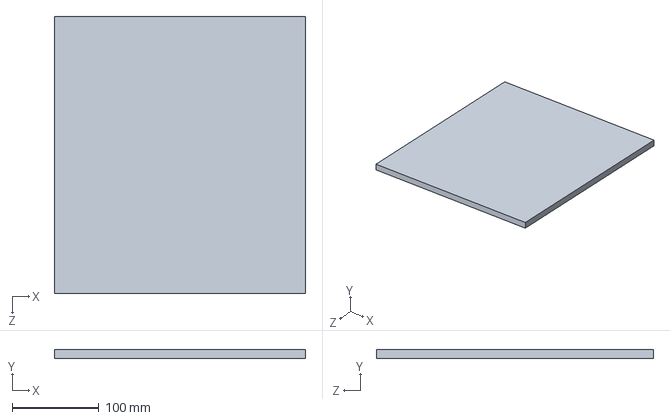
[picture p216: CAD file, 2026-09-08]
arastirma/2_PRESS/parca/PRESS_kova_tabani.SLDPRT
290.0 x 10.00 x 320.0 mm
