kursatkemalkul/autokitch/arastirma/3_TOPPING/alt_montaj/KAP_14x68x24/parca/KAP_agiz_kapagi_PC.SLDPRT

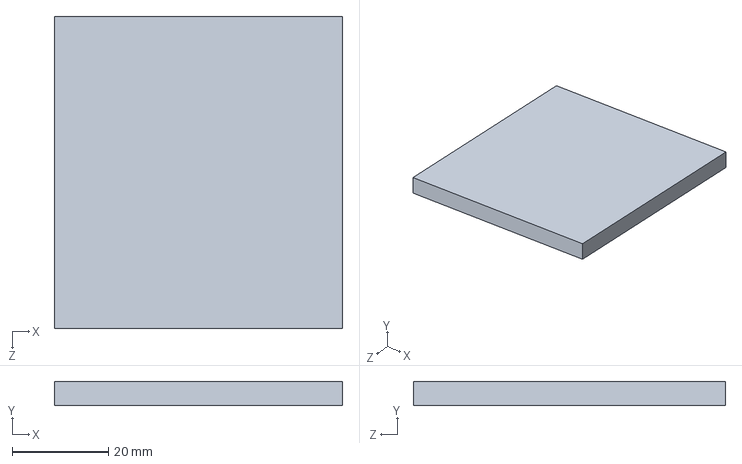
[picture p217: CAD file, 2026-09-08]
arastirma/3_TOPPING/alt_montaj/KAP_14x68x24/parca/KAP_agiz_kapagi_PC.SLDPRT
60.0 x 5.00 x 65.0 mm
