kursatkemalkul/autokitch/arastirma/3_TOPPING/alt_montaj/L_RAF_CIFTI/parca/LRAF_sol_20x8x2.SLDPRT

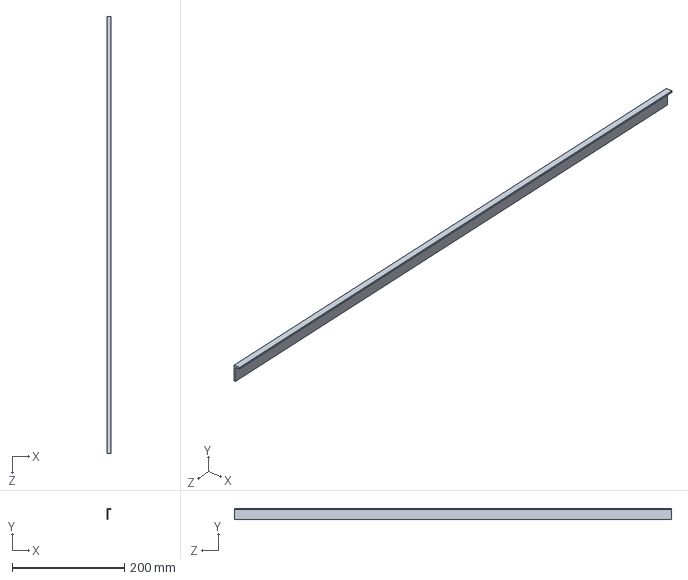
[picture p218: CAD file, 2026-09-08]
arastirma/3_TOPPING/alt_montaj/L_RAF_CIFTI/parca/LRAF_sol_20x8x2.SLDPRT
8.00 x 20.0 x 777.5 mm
