kursatkemalkul/autokitch/arastirma/3_TOPPING/kasar_kabi_v10/step/govde.step

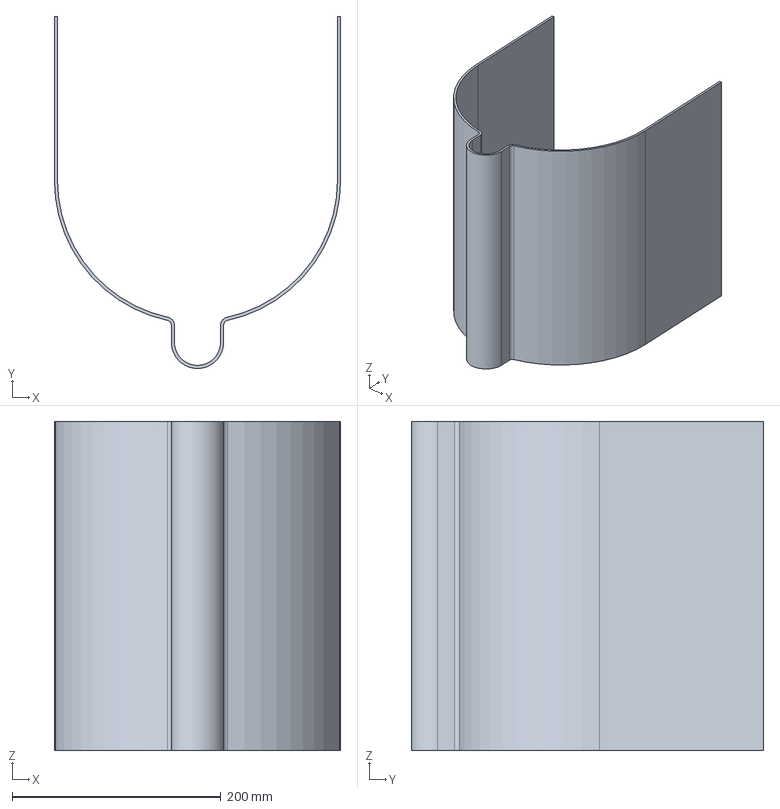
[picture p219: CAD file, 2026-09-21]
arastirma/3_TOPPING/kasar_kabi_v10/step/govde.step
274.0 x 337.0 x 315.0 mm
