kursatkemalkul/autokitch/arastirma/3_TOPPING/kiyma_kaseti_v5/step/topuz.step

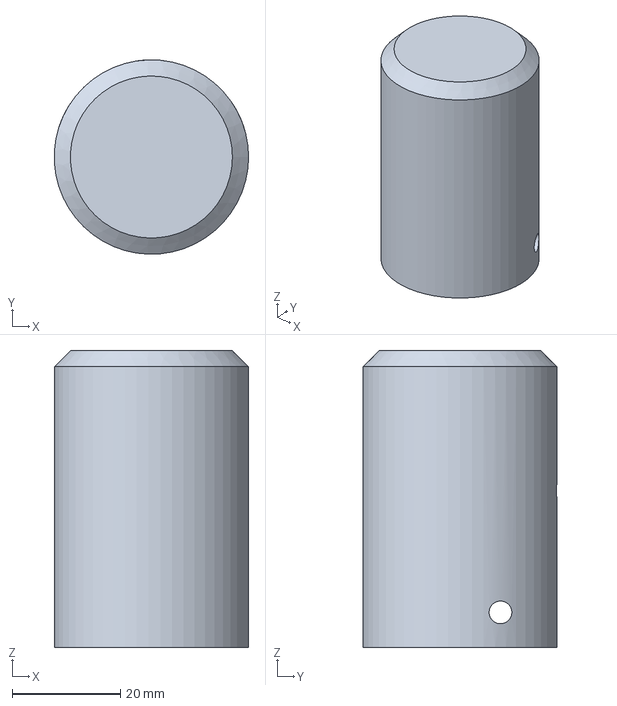
[picture p220: CAD file, 2026-09-21]
arastirma/3_TOPPING/kiyma_kaseti_v5/step/topuz.step
36.0 x 36.0 x 55.0 mm
