kursatkemalkul/autokitch/arastirma/3_TOPPING/parca/TOPPING_ayar_ayagi_2.SLDPRT

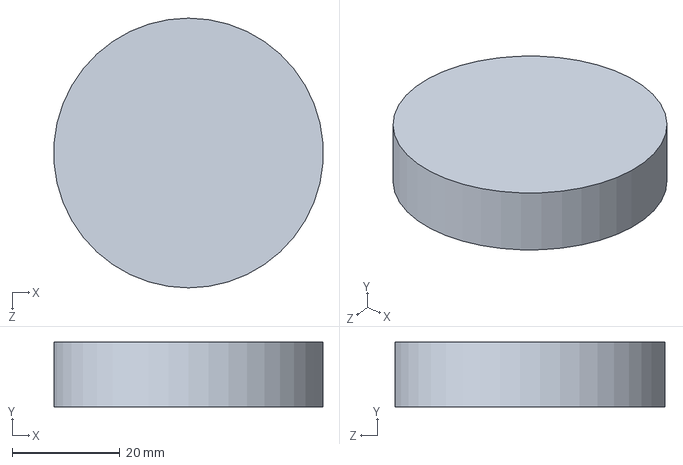
[picture p221: CAD file, 2026-09-08]
arastirma/3_TOPPING/parca/TOPPING_ayar_ayagi_2.SLDPRT
49.9 x 12.0 x 50.0 mm
