kursatkemalkul/autokitch/arastirma/3_TOPPING/sucuk_kaseti_v3/step/kavrama_helezon.step

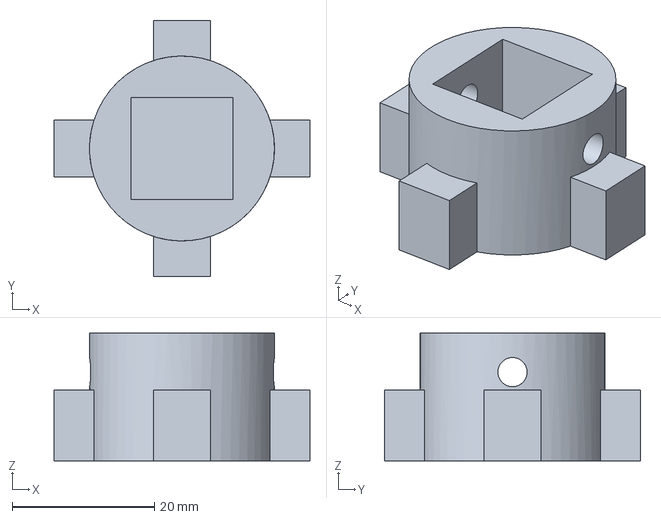
[picture p222: CAD file, 2026-09-21]
arastirma/3_TOPPING/sucuk_kaseti_v3/step/kavrama_helezon.step
36.0 x 36.0 x 18.0 mm
