kursatkemalkul/autokitch/arastirma/3_TOPPING/topping_modul_v1/step/motor_HARÇ_2_rotor.step

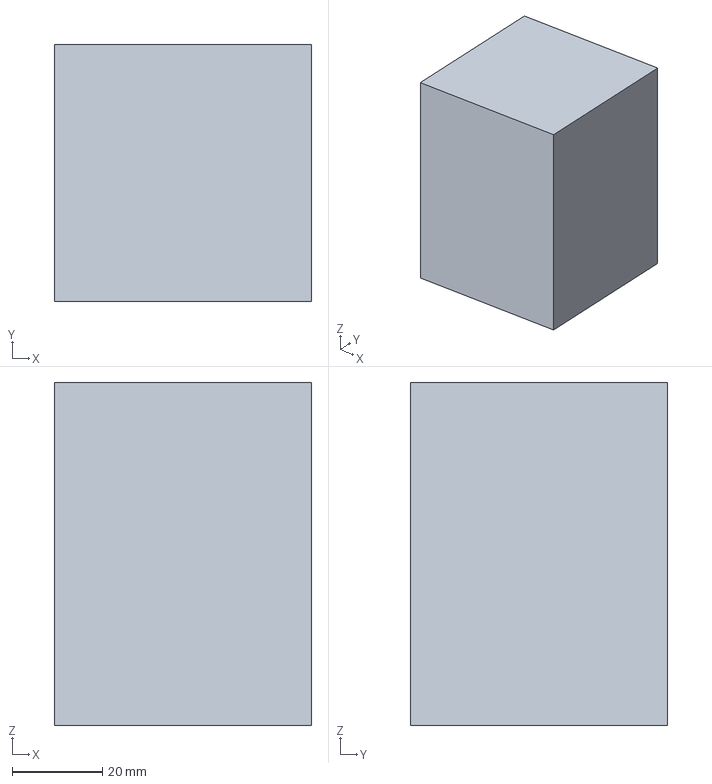
[picture p223: CAD file, 2026-09-21]
arastirma/3_TOPPING/topping_modul_v1/step/motor_HARÇ_2_rotor.step
57.0 x 57.0 x 76.0 mm
