kursatkemalkul/autokitch/arastirma/4_OVEN/parca/OVEN_ayar_mil_1.SLDPRT

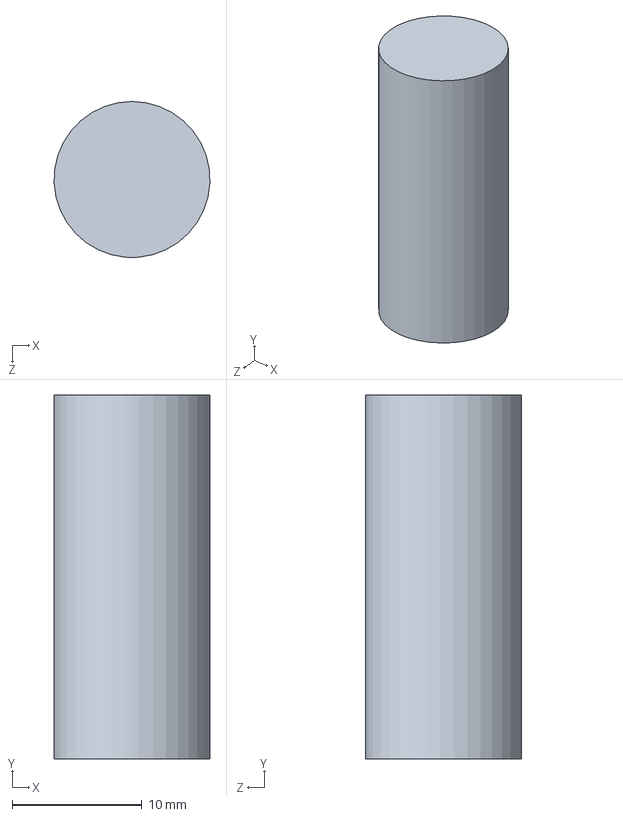
[picture p224: CAD file, 2026-09-08]
arastirma/4_OVEN/parca/OVEN_ayar_mil_1.SLDPRT
12.0 x 28.0 x 12.0 mm
