kursatkemalkul/autokitch/arastirma/_ortak/FIRIN_KAPAK_CAM/parca/FKAP_pivot_mili_D8.SLDPRT

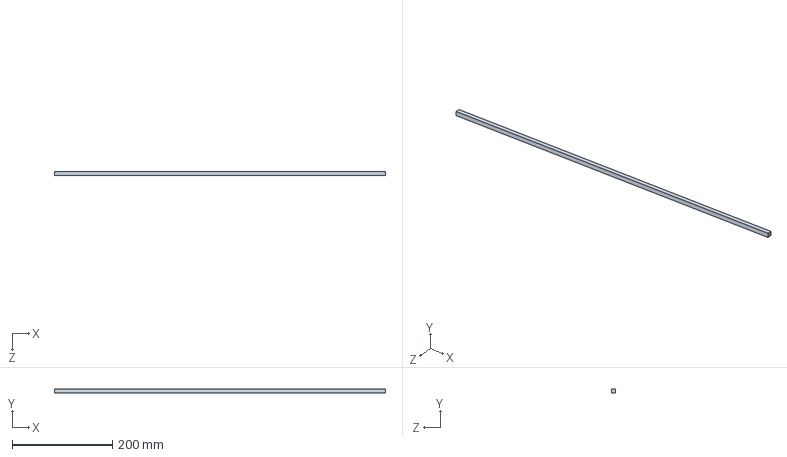
[picture p225: CAD file, 2026-09-08]
arastirma/_ortak/FIRIN_KAPAK_CAM/parca/FKAP_pivot_mili_D8.SLDPRT
660.0 x 8.00 x 8.00 mm
