kursatkemalkul/autokitch/arastirma/_ortak/KAP_YAG_14x68x24/parca/KAPYAG_taban_plakasi_kapali.SLDPRT

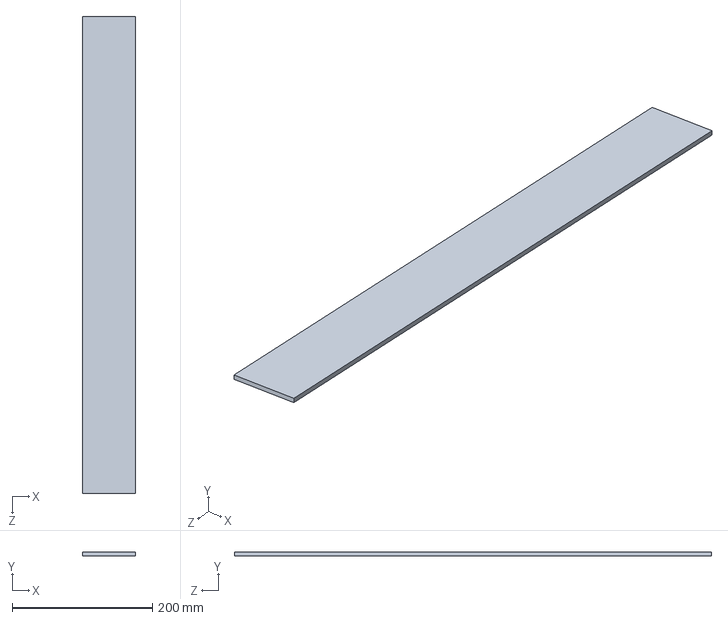
[picture p226: CAD file, 2026-09-08]
arastirma/_ortak/KAP_YAG_14x68x24/parca/KAPYAG_taban_plakasi_kapali.SLDPRT
76.0 x 5.00 x 680.0 mm
