kursatkemalkul/autokitch/arastirma/_ortak/KUTU_KOLA_330ml/parca/KOLA330_boyun_daralma_D60.SLDPRT

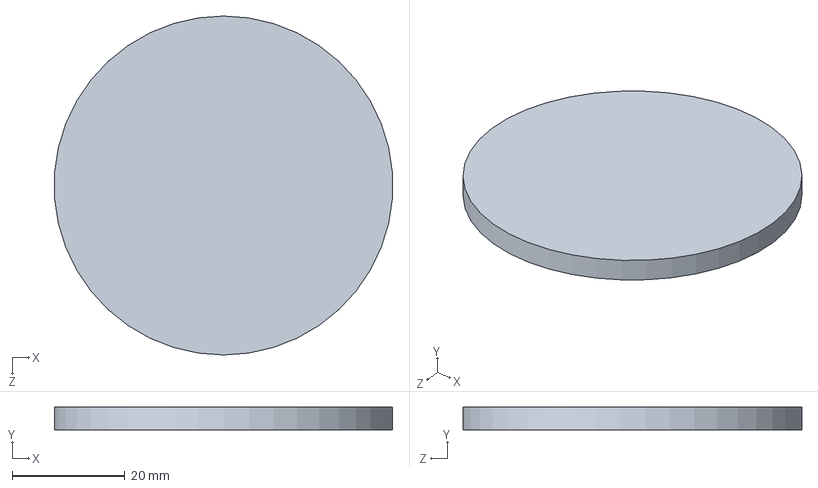
[picture p227: CAD file, 2026-09-08]
arastirma/_ortak/KUTU_KOLA_330ml/parca/KOLA330_boyun_daralma_D60.SLDPRT
59.8 x 4.00 x 60.0 mm
