kursatkemalkul/autokitch/arastirma/_ortak/MOTOR_TAHRIK_GRUBU/parca/MTG_montaj_braketi_3mm.SLDPRT

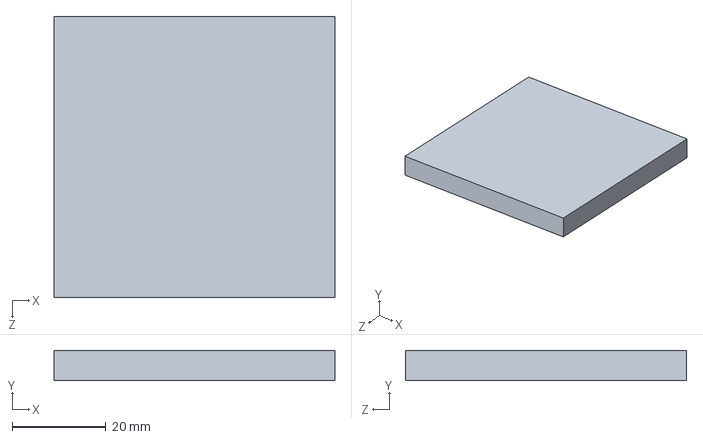
[picture p228: CAD file, 2026-09-08]
arastirma/_ortak/MOTOR_TAHRIK_GRUBU/parca/MTG_montaj_braketi_3mm.SLDPRT
60.0 x 6.50 x 60.0 mm
