kursatkemalkul/autokitch/arastirma/_ortak/SENSOR_REED_D12/parca/SNS_M12_soket.SLDPRT

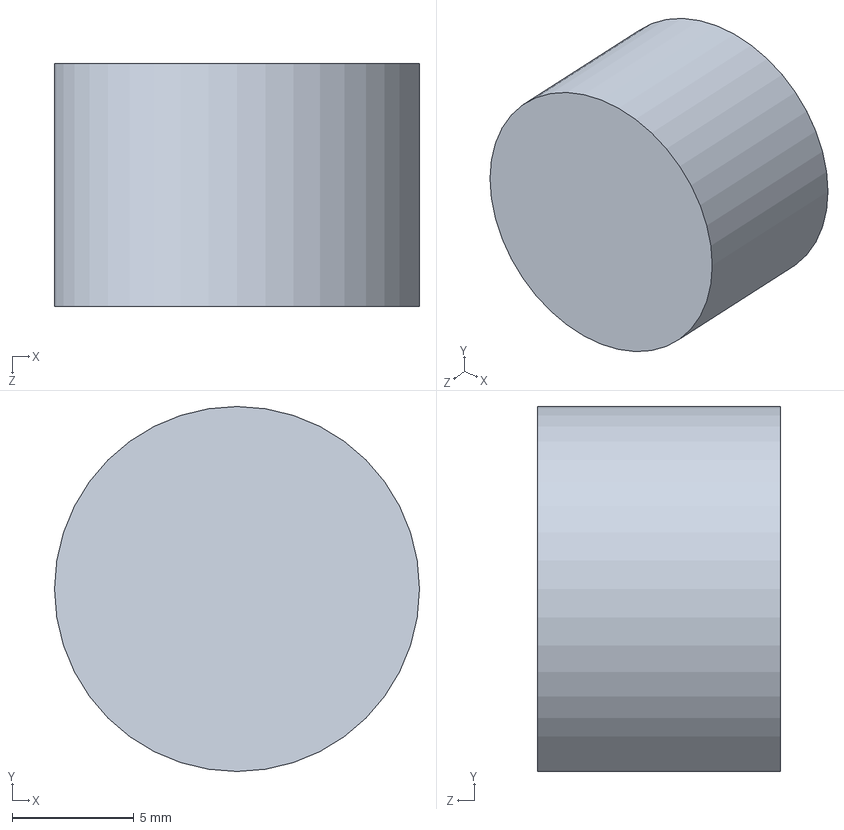
[picture p229: CAD file, 2026-09-08]
arastirma/_ortak/SENSOR_REED_D12/parca/SNS_M12_soket.SLDPRT
15.0 x 15.0 x 10.0 mm
