kursatkemalkul/autokitch/arastirma/_ortak/SISE_KOLA_1L/parca/KOLA1L_boyun_D30.SLDPRT

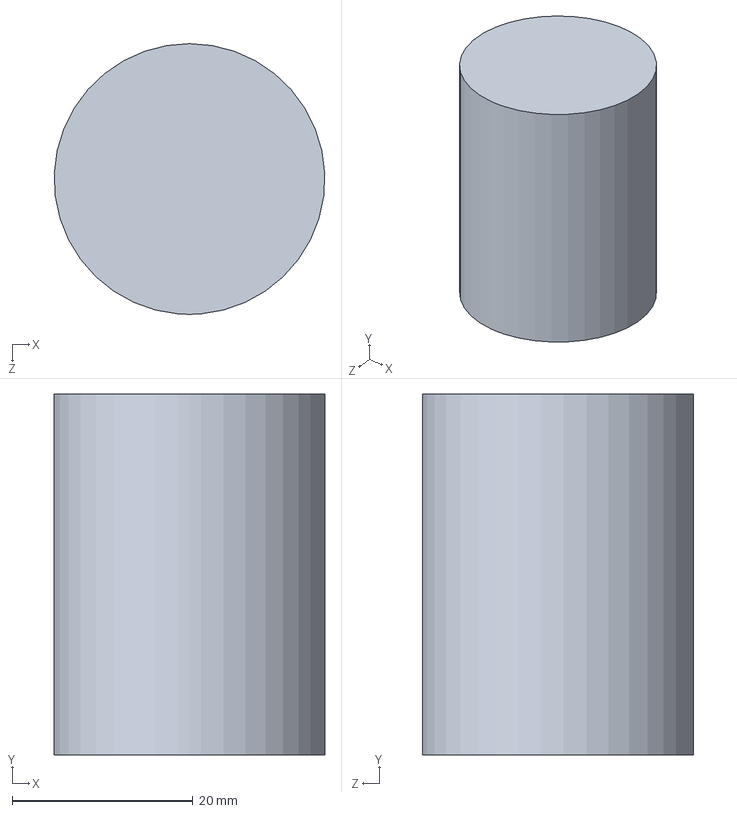
[picture p230: CAD file, 2026-09-08]
arastirma/_ortak/SISE_KOLA_1L/parca/KOLA1L_boyun_D30.SLDPRT
30.0 x 40.0 x 30.0 mm
