kursatkemalkul/autokitch/arastirma/_ortak/TEPSI_D320/parca/TEPSI_kulp_40x6x80.SLDPRT

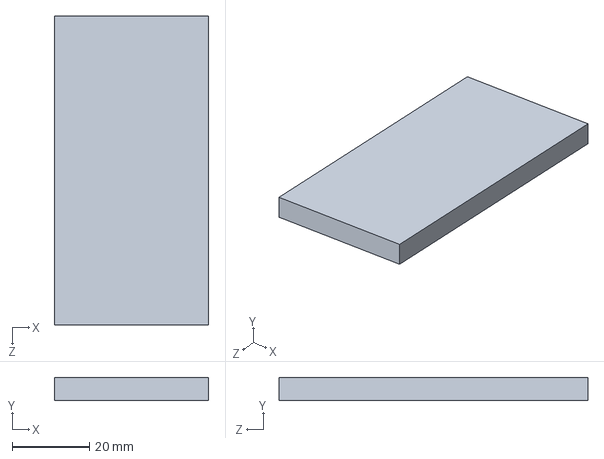
[picture p231: CAD file, 2026-09-08]
arastirma/_ortak/TEPSI_D320/parca/TEPSI_kulp_40x6x80.SLDPRT
40.0 x 6.00 x 80.0 mm
