kursatkemalkul/autokitch/arastirma/_ortak/UC_YUVASI/parca/UCY_kilit_pimi_12x40.SLDPRT

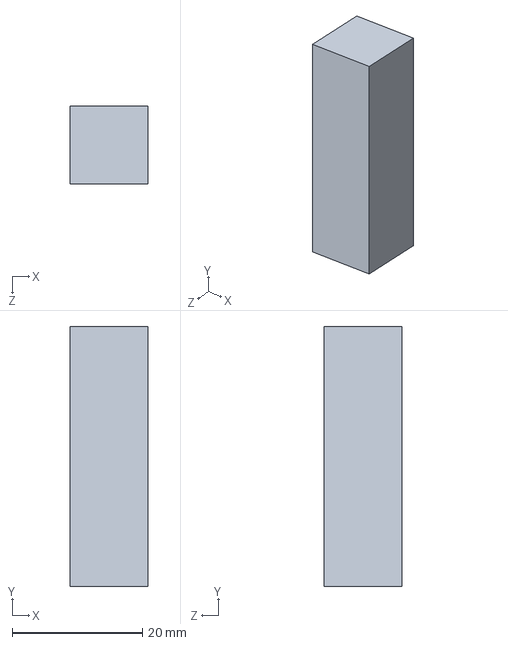
[picture p232: CAD file, 2026-09-08]
arastirma/_ortak/UC_YUVASI/parca/UCY_kilit_pimi_12x40.SLDPRT
12.0 x 40.0 x 12.0 mm
