kursatkemalkul/autokitch/arastirma/_ortak/VANTUZ_D40/parca/VNT_koruk_dudak_D40.SLDPRT

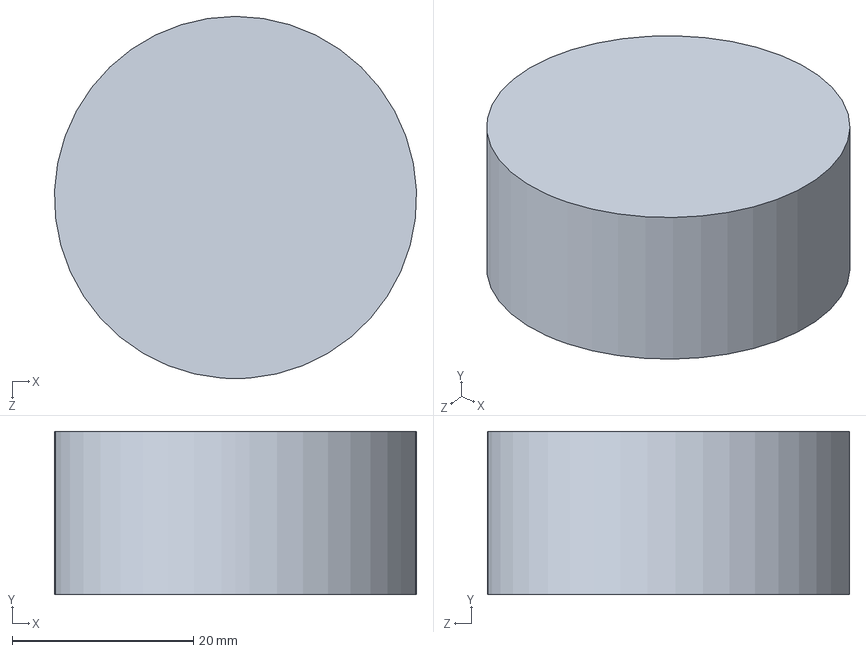
[picture p233: CAD file, 2026-09-08]
arastirma/_ortak/VANTUZ_D40/parca/VNT_koruk_dudak_D40.SLDPRT
40.0 x 18.0 x 40.0 mm
