kursatkemalkul/autokitch/arastirma/katalog/step/a9f79610.stp

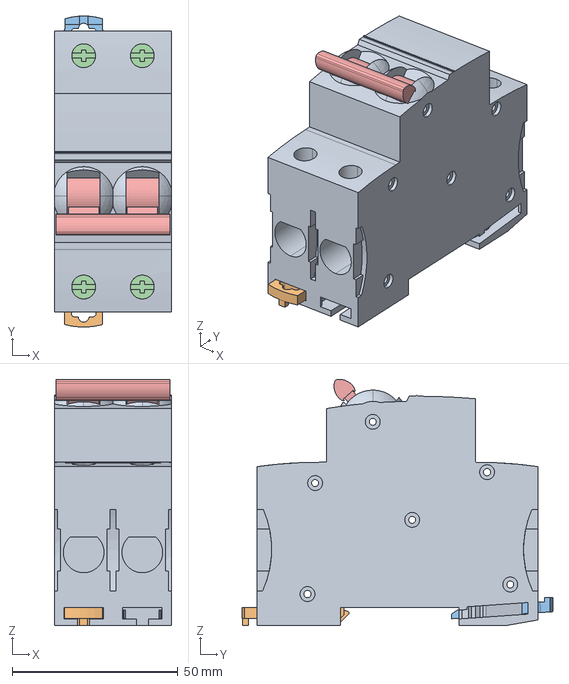
[picture p234: CAD file, 2026-10-05]
arastirma/katalog/step/a9f79610.stp
35.4 x 93.9 x 74.3 mm
