kursatkemalkul/autokitch/arastirma/2_PRESS/parca/PRESS_kova_kapagi_kapak.SLDPRT

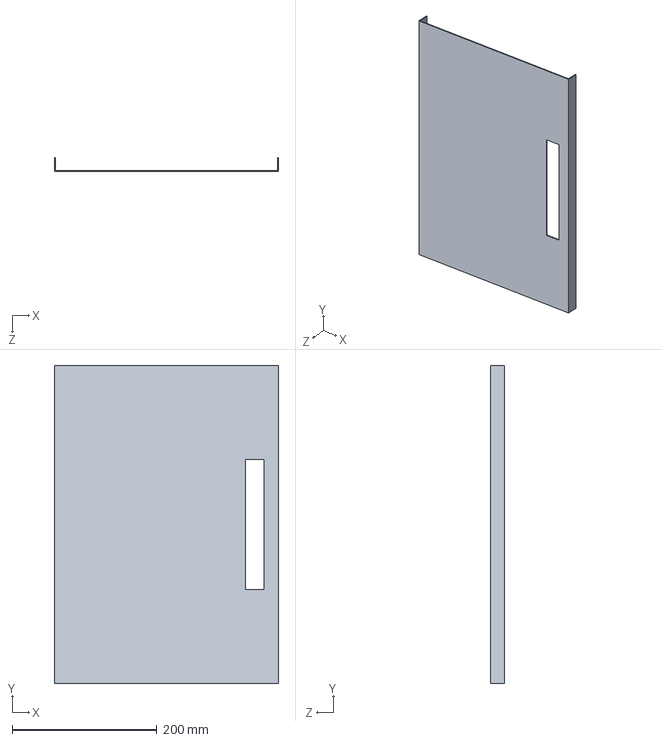
[picture p235: CAD file, 2026-09-08]
arastirma/2_PRESS/parca/PRESS_kova_kapagi_kapak.SLDPRT
310.0 x 440.0 x 20.0 mm
