kursatkemalkul/autokitch/arastirma/3_TOPPING/alt_montaj/KAP_14x68x24/parca/KAP_helezon_POM_D70.SLDPRT

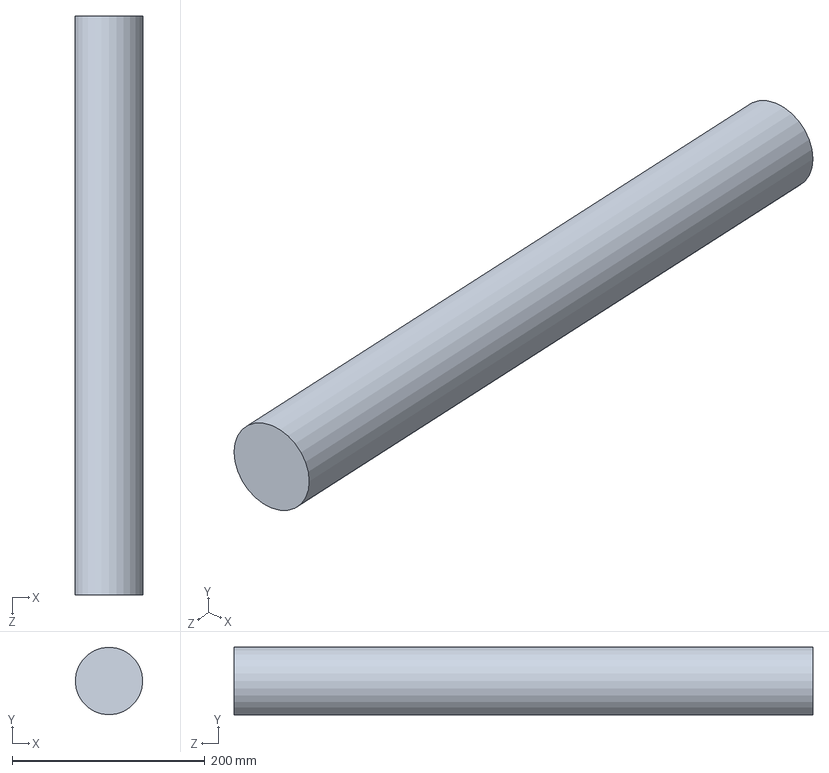
[picture p236: CAD file, 2026-09-08]
arastirma/3_TOPPING/alt_montaj/KAP_14x68x24/parca/KAP_helezon_POM_D70.SLDPRT
70.0 x 70.0 x 600.0 mm
