kursatkemalkul/autokitch/arastirma/3_TOPPING/kasar_kabi_v10/step/pul_arka_3.step

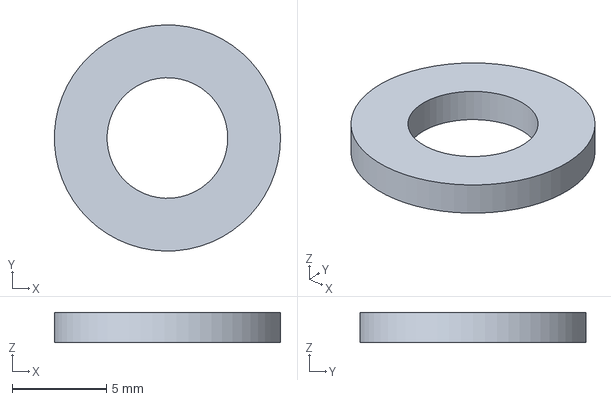
[picture p237: CAD file, 2026-09-21]
arastirma/3_TOPPING/kasar_kabi_v10/step/pul_arka_3.step
12.0 x 12.0 x 1.60 mm
