kursatkemalkul/autokitch/arastirma/3_TOPPING/parca/TOPPING_sog_kondenser.SLDPRT

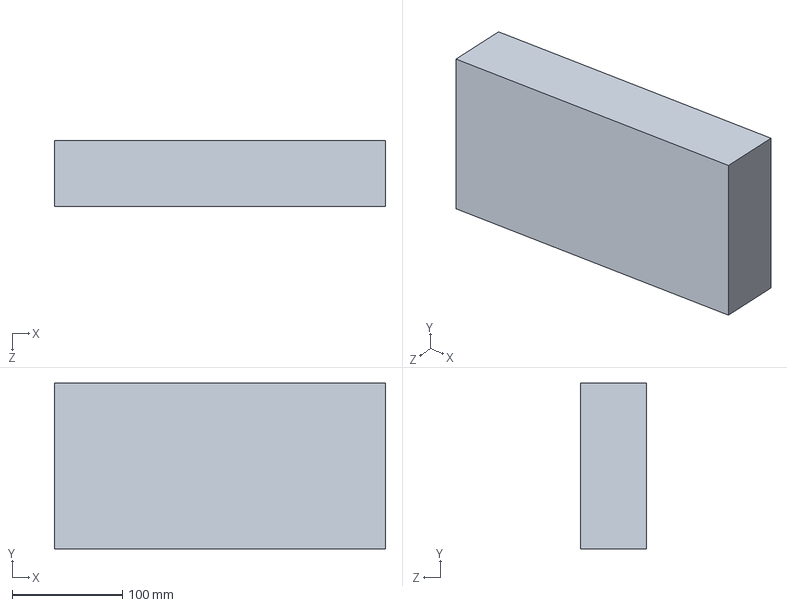
[picture p238: CAD file, 2026-09-08]
arastirma/3_TOPPING/parca/TOPPING_sog_kondenser.SLDPRT
300.0 x 150.0 x 60.0 mm
