kursatkemalkul/autokitch/arastirma/3_TOPPING/sucuk_kaseti_v3/step/govde.step

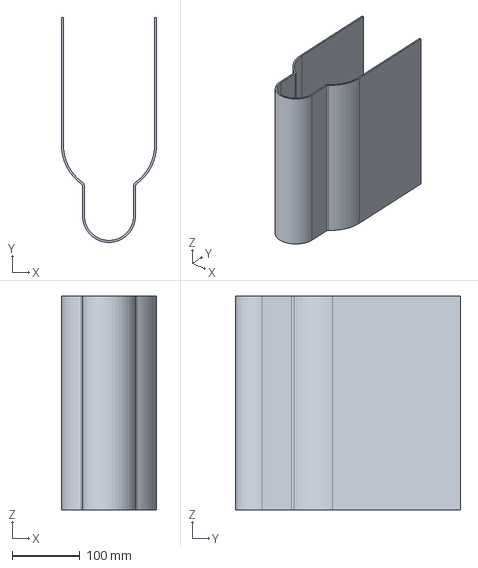
[picture p239: CAD file, 2026-09-21]
arastirma/3_TOPPING/sucuk_kaseti_v3/step/govde.step
140.0 x 331.0 x 315.0 mm
