kursatkemalkul/autokitch/arastirma/3_TOPPING/topping_modul_v1/step/konum_pimi_KÜP_SUCUK_0.step

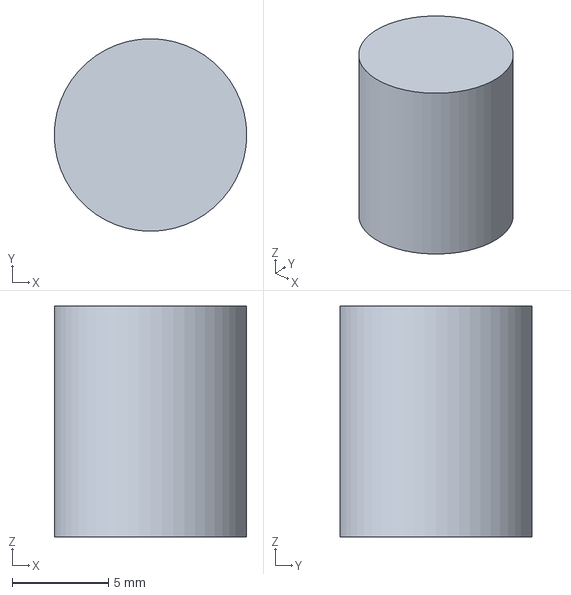
[picture p240: CAD file, 2026-09-21]
arastirma/3_TOPPING/topping_modul_v1/step/konum_pimi_KÜP_SUCUK_0.step
10.0 x 10.0 x 12.0 mm
