kursatkemalkul/autokitch/arastirma/4_OVEN/parca/OVEN_pano_plc.SLDPRT

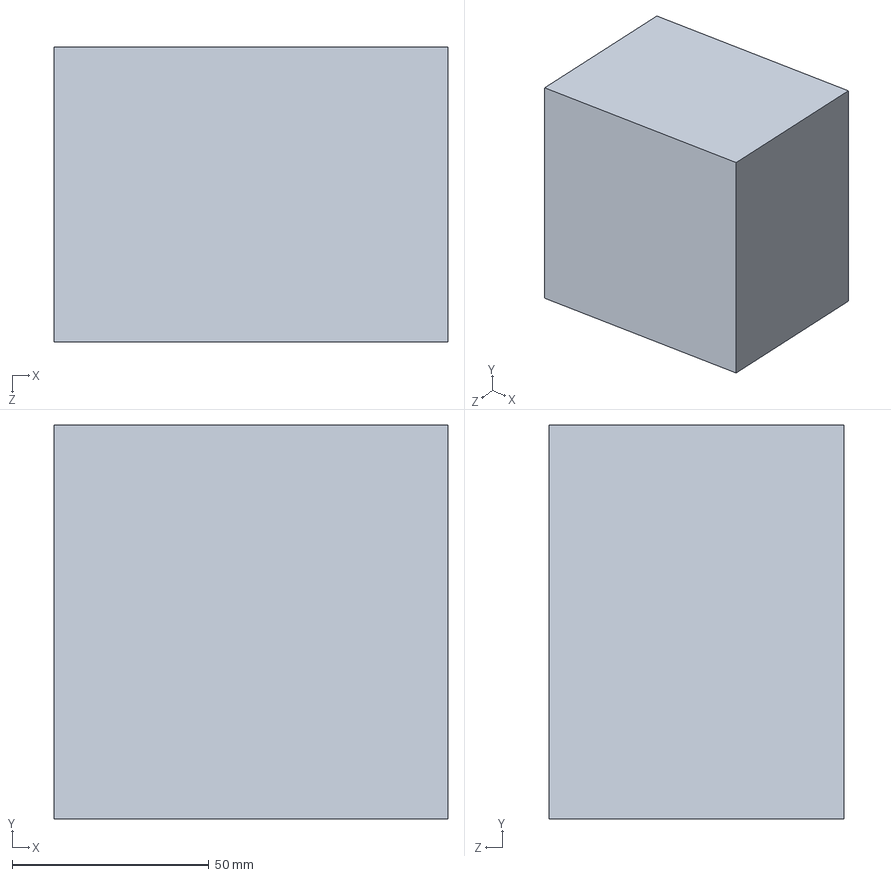
[picture p241: CAD file, 2026-09-08]
arastirma/4_OVEN/parca/OVEN_pano_plc.SLDPRT
100.0 x 100.0 x 75.0 mm
