kursatkemalkul/autokitch/arastirma/_ortak/FIRIN_KAPAK_CAM/parca/FKAP_cerceve_sol.SLDPRT

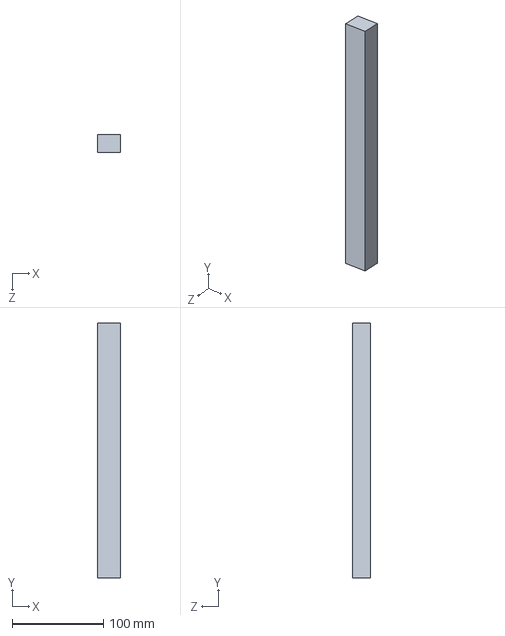
[picture p242: CAD file, 2026-09-08]
arastirma/_ortak/FIRIN_KAPAK_CAM/parca/FKAP_cerceve_sol.SLDPRT
25.0 x 280.0 x 20.0 mm
