kursatkemalkul/autokitch/arastirma/_ortak/KAP_YAG_14x68x24/parca/KAPYAG_PC_kapak_gecmeli.SLDPRT

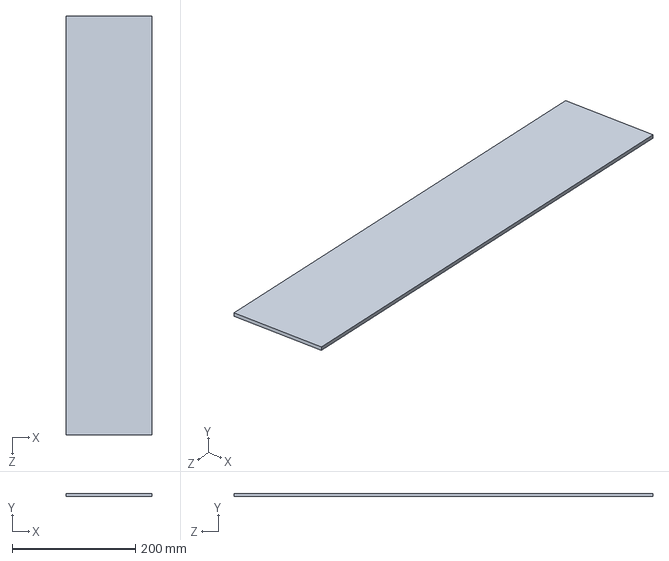
[picture p243: CAD file, 2026-09-08]
arastirma/_ortak/KAP_YAG_14x68x24/parca/KAPYAG_PC_kapak_gecmeli.SLDPRT
140.0 x 5.00 x 680.0 mm
