kursatkemalkul/autokitch/arastirma/_ortak/MOTOR_TAHRIK_GRUBU/parca/MTG_M12_soket.SLDPRT

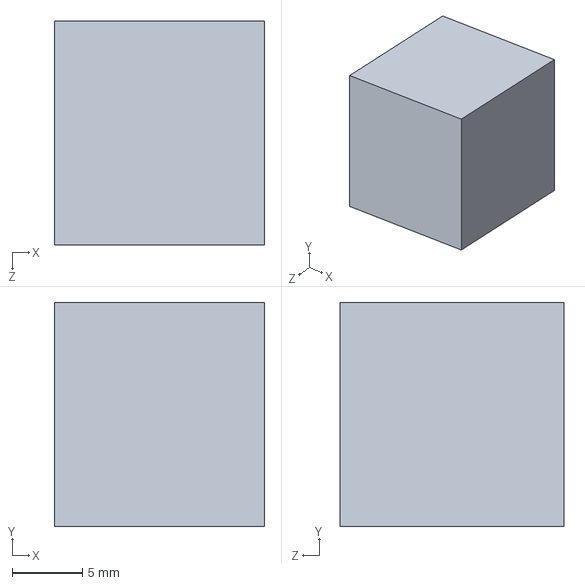
[picture p244: CAD file, 2026-09-08]
arastirma/_ortak/MOTOR_TAHRIK_GRUBU/parca/MTG_M12_soket.SLDPRT
15.0 x 16.0 x 16.0 mm
