kursatkemalkul/autokitch/arastirma/_ortak/SENSOR_REED_D12/parca/SNS_kablo_D5.SLDPRT

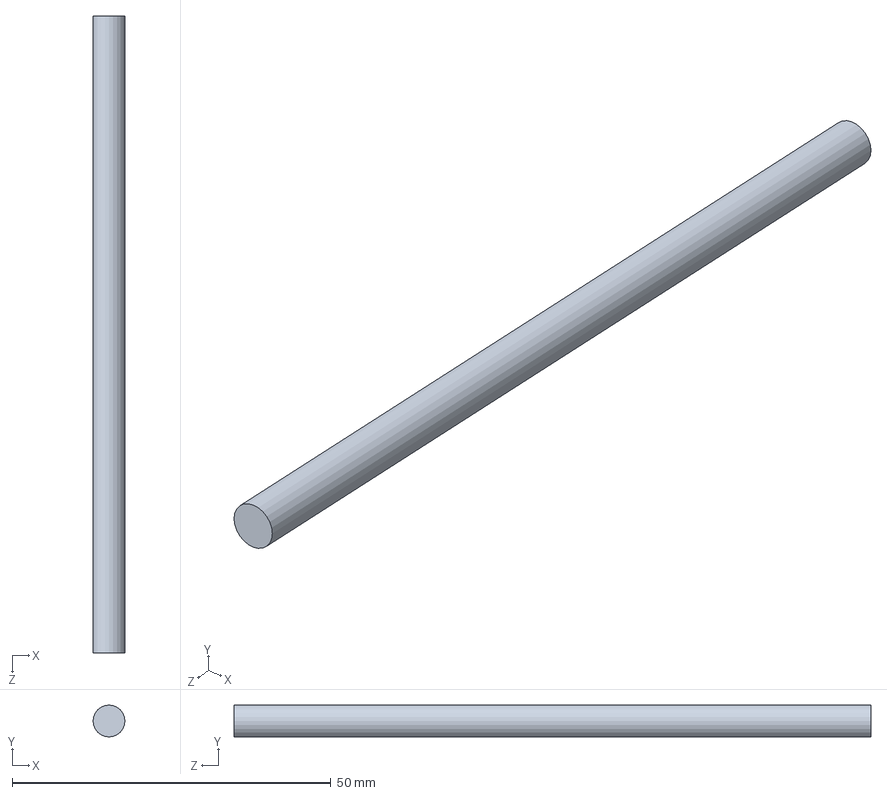
[picture p245: CAD file, 2026-09-08]
arastirma/_ortak/SENSOR_REED_D12/parca/SNS_kablo_D5.SLDPRT
5.00 x 5.00 x 100.0 mm
