kursatkemalkul/autokitch/arastirma/_ortak/SISE_KOLA_1L/parca/KOLA1L_omuz_D70.SLDPRT

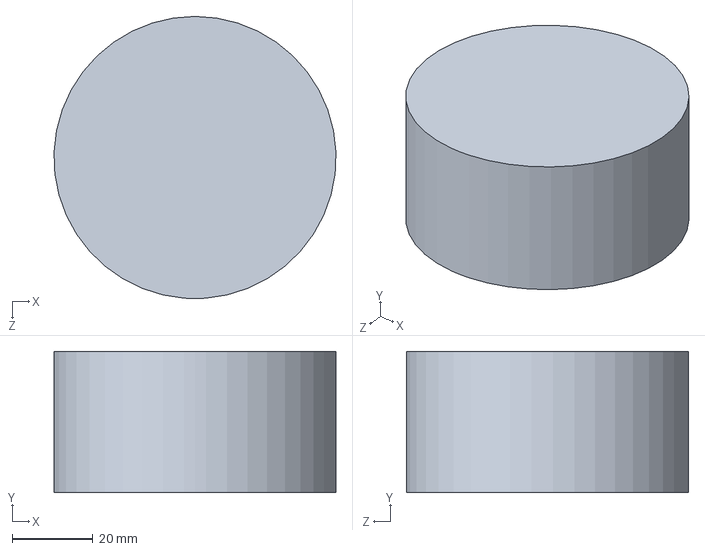
[picture p246: CAD file, 2026-09-08]
arastirma/_ortak/SISE_KOLA_1L/parca/KOLA1L_omuz_D70.SLDPRT
69.9 x 35.0 x 70.0 mm
