kursatkemalkul/autokitch/arastirma/_ortak/VANTUZ_D40/parca/VNT_nipel_M8.SLDPRT

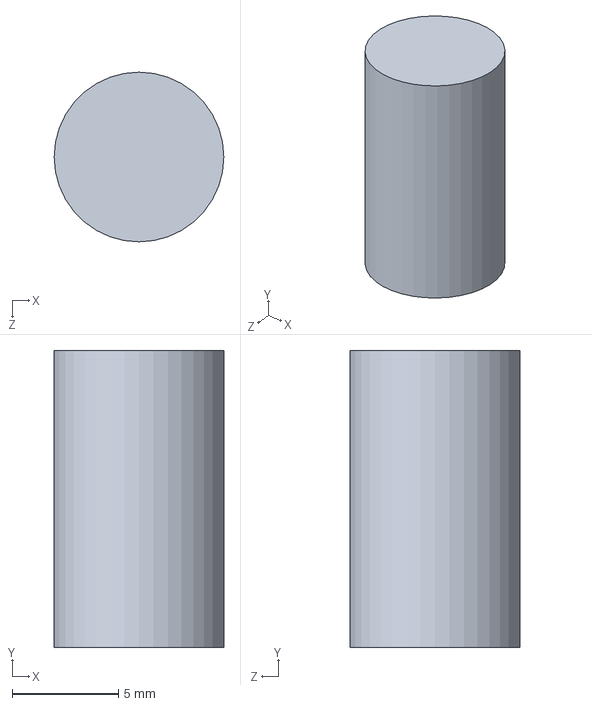
[picture p247: CAD file, 2026-09-08]
arastirma/_ortak/VANTUZ_D40/parca/VNT_nipel_M8.SLDPRT
8.00 x 14.0 x 8.00 mm
