kursatkemalkul/autokitch/arastirma/2_PRESS/parca/PRESS_ayak_4.SLDPRT

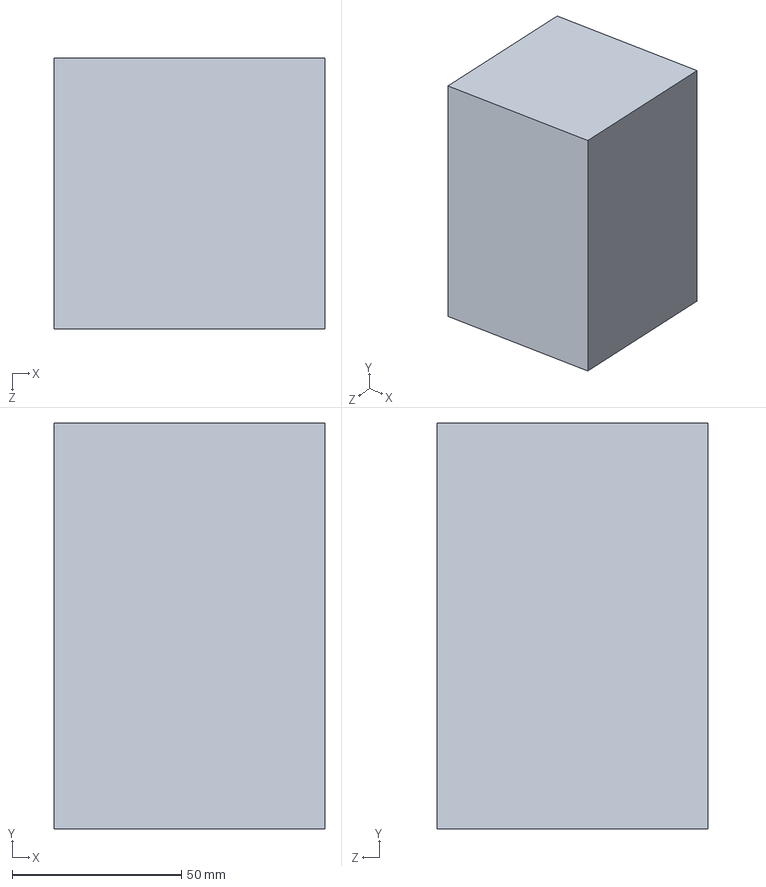
[picture p248: CAD file, 2026-09-08]
arastirma/2_PRESS/parca/PRESS_ayak_4.SLDPRT
80.0 x 120.0 x 80.0 mm
