kursatkemalkul/autokitch/arastirma/3_TOPPING/alt_montaj/KAP_14x68x24/parca/KAP_kizak_sol_30x20.SLDPRT

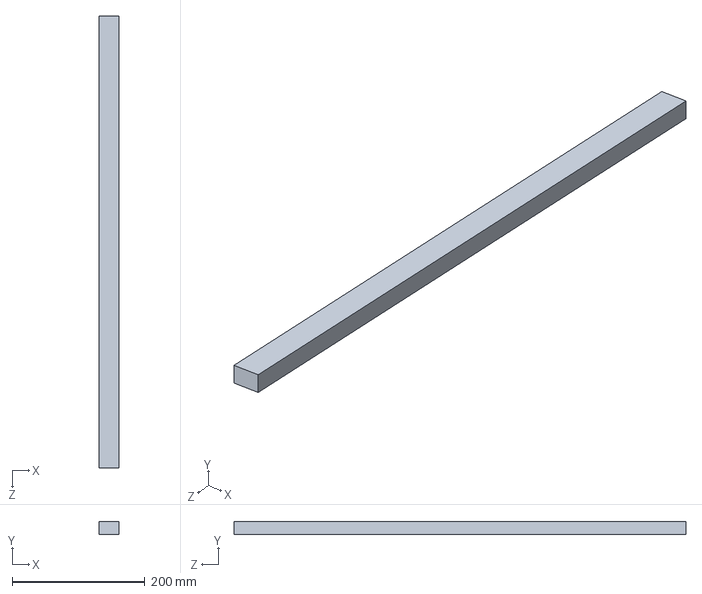
[picture p249: CAD file, 2026-09-08]
arastirma/3_TOPPING/alt_montaj/KAP_14x68x24/parca/KAP_kizak_sol_30x20.SLDPRT
30.0 x 20.0 x 680.0 mm
