kursatkemalkul/autokitch/arastirma/3_TOPPING/kiyma_kaseti_v5/step/oring_on_kovan.step

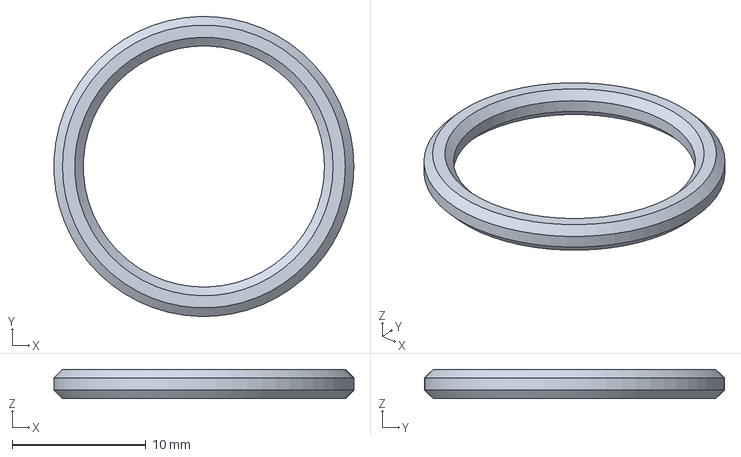
[picture p250: CAD file, 2026-09-21]
arastirma/3_TOPPING/kiyma_kaseti_v5/step/oring_on_kovan.step
22.4 x 22.4 x 2.20 mm
