kursatkemalkul/autokitch/arastirma/3_TOPPING/kusbasi_kaseti_v4/step/orumcek_arka.step

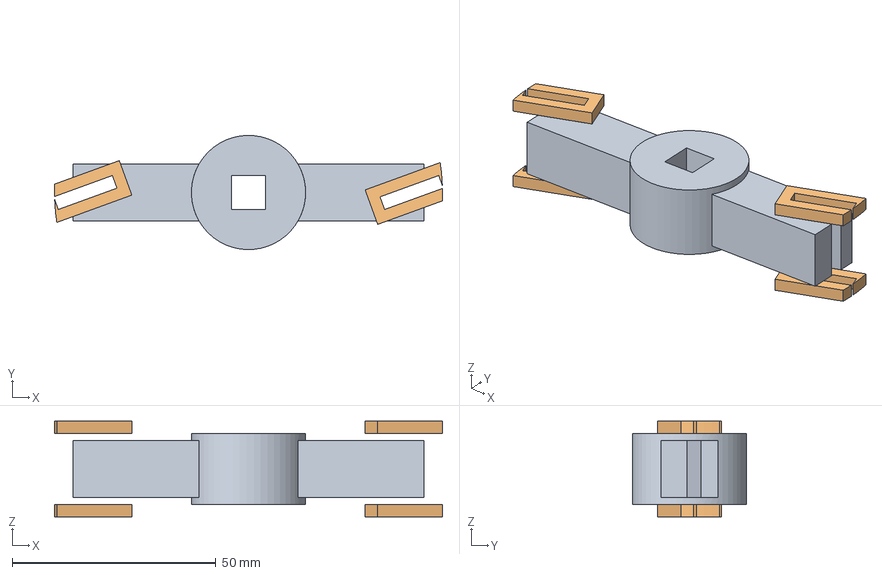
[picture p251: CAD file, 2026-09-21]
arastirma/3_TOPPING/kusbasi_kaseti_v4/step/orumcek_arka.step
95.1 x 28.0 x 23.5 mm
