kursatkemalkul/autokitch/arastirma/3_TOPPING/parca/TOPPING_arka_duvar_pano_surucu_3.SLDPRT

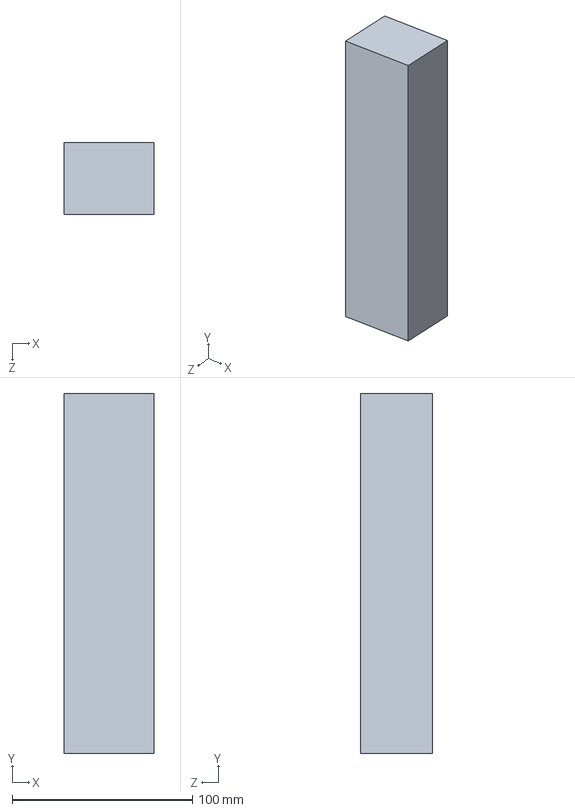
[picture p252: CAD file, 2026-09-08]
arastirma/3_TOPPING/parca/TOPPING_arka_duvar_pano_surucu_3.SLDPRT
50.0 x 200.0 x 40.0 mm
