kursatkemalkul/autokitch/arastirma/3_TOPPING/topping_modul_v1/step/kovan_HARÇ_1_helezon.step

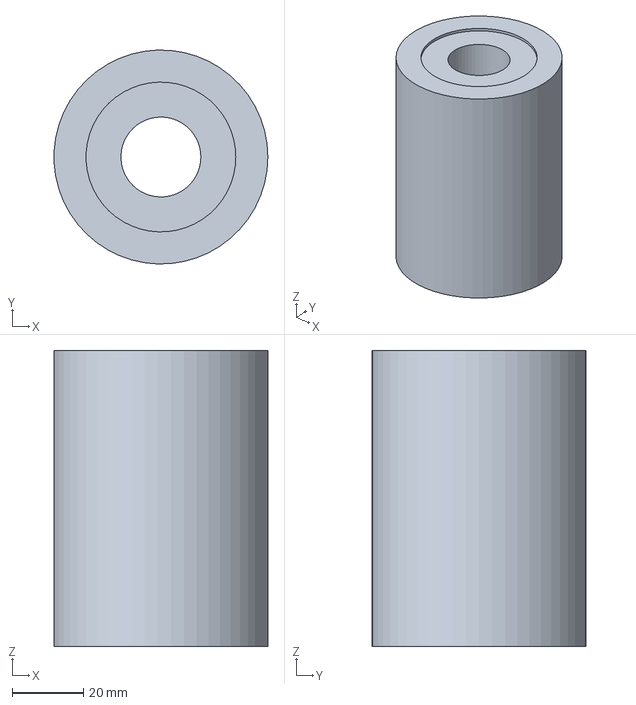
[picture p253: CAD file, 2026-09-21]
arastirma/3_TOPPING/topping_modul_v1/step/kovan_HARÇ_1_helezon.step
59.9 x 60.0 x 83.0 mm
