kursatkemalkul/autokitch/arastirma/4_OVEN/parca/OVEN_pano_SSR_2.SLDPRT

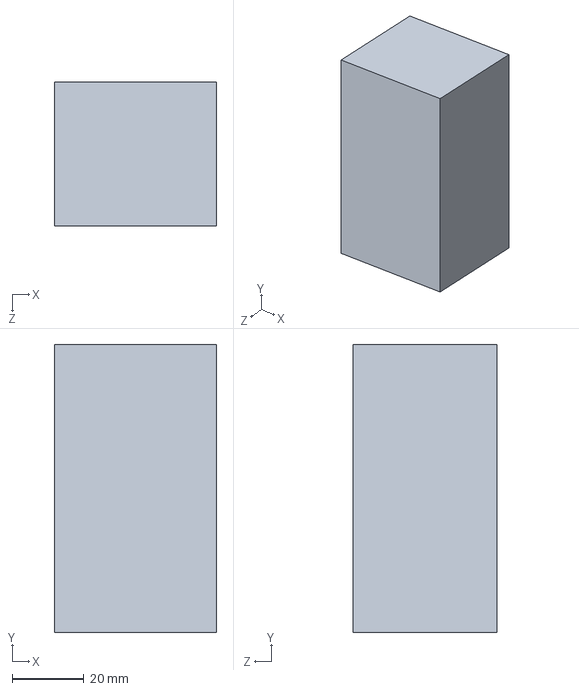
[picture p254: CAD file, 2026-09-08]
arastirma/4_OVEN/parca/OVEN_pano_SSR_2.SLDPRT
45.0 x 80.0 x 40.0 mm
