kursatkemalkul/autokitch/arastirma/_ortak/FIRIN_KAPAK_CAM/parca/FKAP_cerceve_ust.SLDPRT

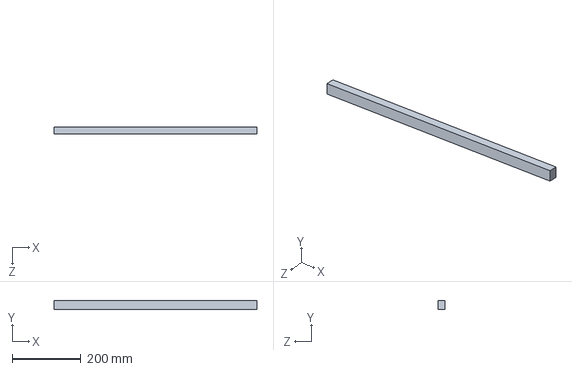
[picture p255: CAD file, 2026-09-08]
arastirma/_ortak/FIRIN_KAPAK_CAM/parca/FKAP_cerceve_ust.SLDPRT
590.0 x 25.0 x 20.0 mm
