kursatkemalkul/autokitch/arastirma/_ortak/KAP_YAG_14x68x24/parca/KAPYAG_dolum_agzi_D60.SLDPRT

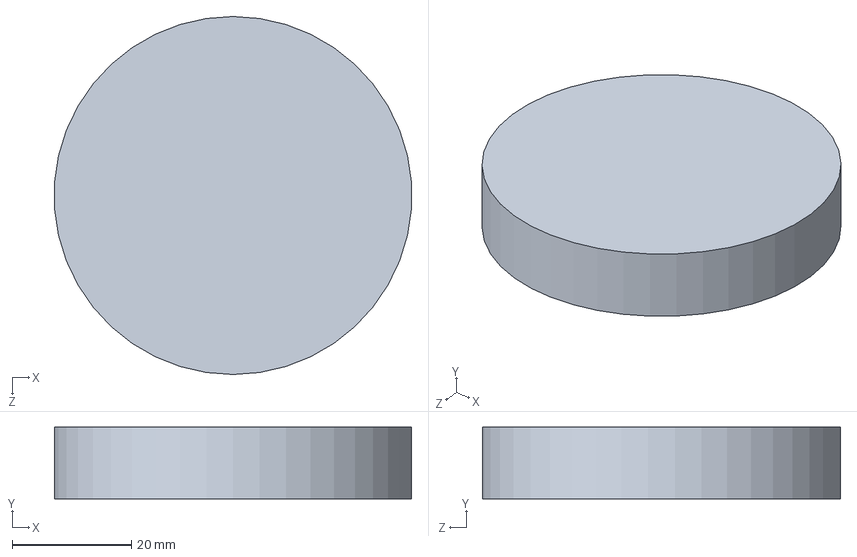
[picture p256: CAD file, 2026-09-08]
arastirma/_ortak/KAP_YAG_14x68x24/parca/KAPYAG_dolum_agzi_D60.SLDPRT
59.8 x 12.0 x 60.0 mm
