kursatkemalkul/autokitch/arastirma/_ortak/KUTU_KOLA_330ml/parca/KOLA330_govde_D66.SLDPRT

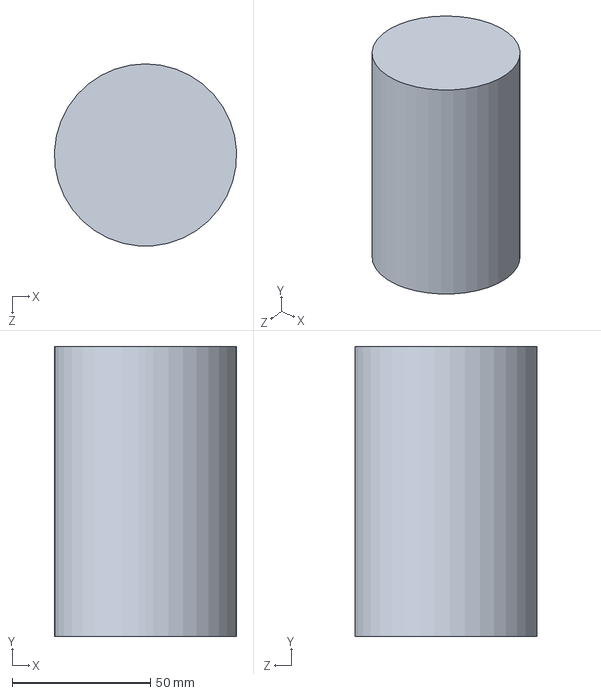
[picture p257: CAD file, 2026-09-08]
arastirma/_ortak/KUTU_KOLA_330ml/parca/KOLA330_govde_D66.SLDPRT
65.9 x 105.0 x 66.0 mm
