kursatkemalkul/autokitch/arastirma/_ortak/MOTOR_TAHRIK_GRUBU/parca/MTG_motor_24V_37x37x80.SLDPRT

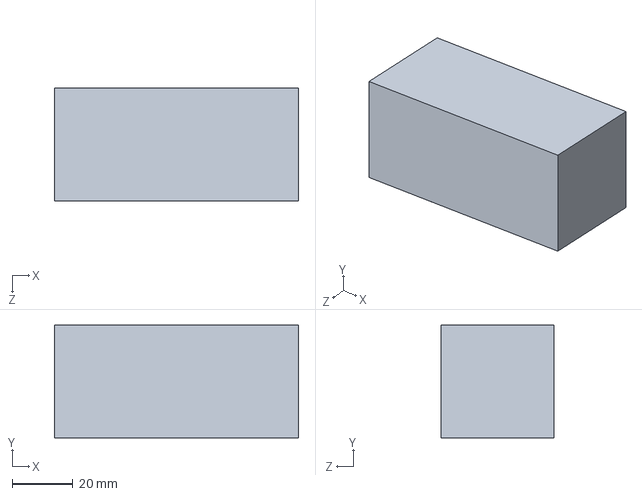
[picture p258: CAD file, 2026-09-08]
arastirma/_ortak/MOTOR_TAHRIK_GRUBU/parca/MTG_motor_24V_37x37x80.SLDPRT
80.0 x 37.0 x 37.0 mm
