kursatkemalkul/autokitch/arastirma/_ortak/SISE_KOLA_1L/parca/KOLA1L_kapak_D32.SLDPRT

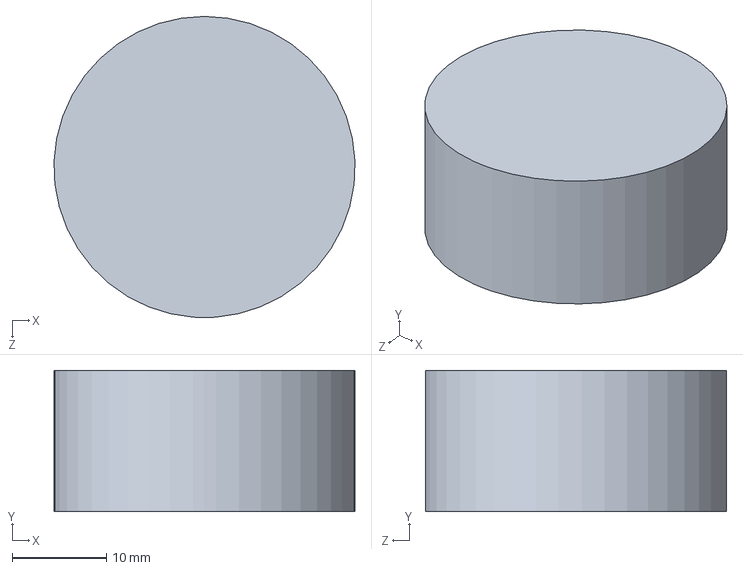
[picture p259: CAD file, 2026-09-08]
arastirma/_ortak/SISE_KOLA_1L/parca/KOLA1L_kapak_D32.SLDPRT
32.0 x 15.0 x 32.0 mm
