kursatkemalkul/autokitch/arastirma/2_PRESS/parca/PRESS_panel_pres_agzi.SLDPRT

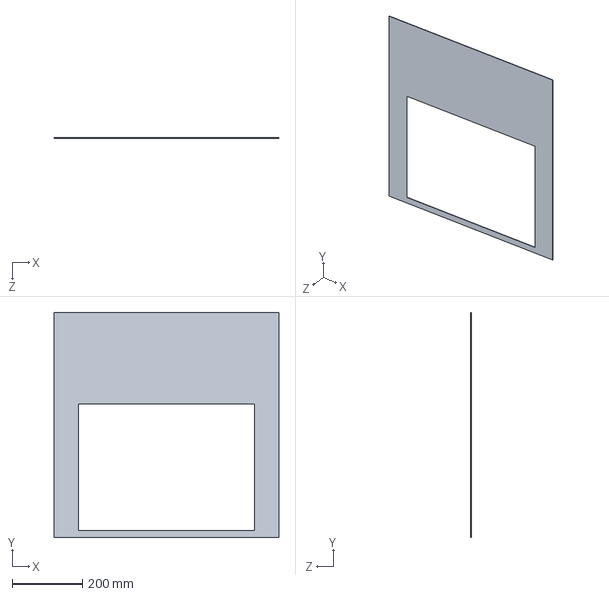
[picture p260: CAD file, 2026-09-08]
arastirma/2_PRESS/parca/PRESS_panel_pres_agzi.SLDPRT
640.0 x 640.0 x 1.50 mm
