kursatkemalkul/autokitch/arastirma/3_TOPPING/alt_montaj/KAP_14x68x24/parca/KAP_PC_govde_5mm.SLDPRT

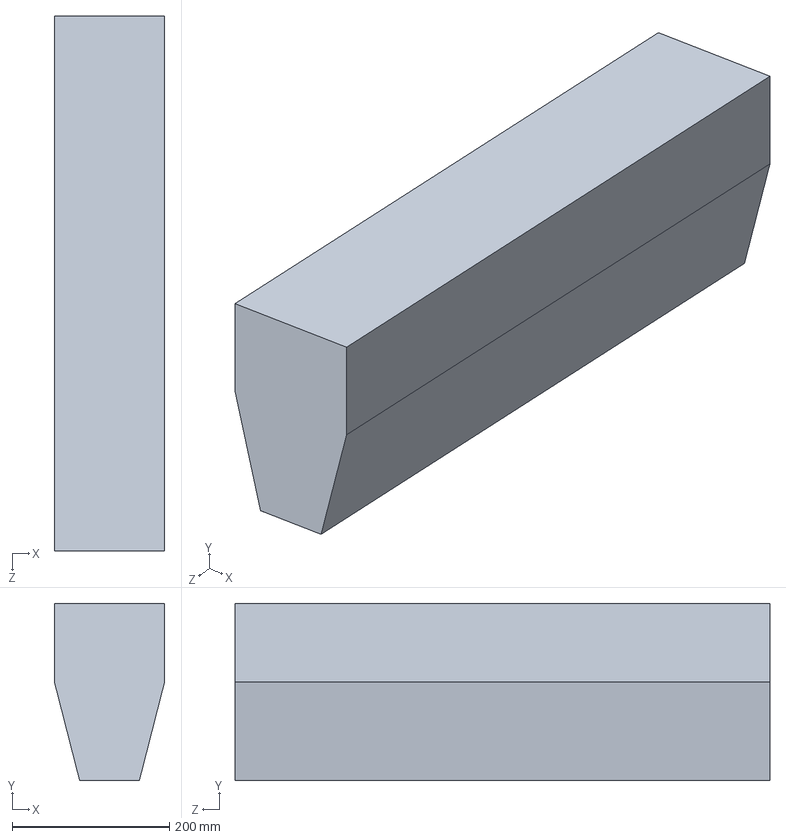
[picture p261: CAD file, 2026-09-08]
arastirma/3_TOPPING/alt_montaj/KAP_14x68x24/parca/KAP_PC_govde_5mm.SLDPRT
140.0 x 225.0 x 680.0 mm
