kursatkemalkul/autokitch/arastirma/3_TOPPING/kasar_kabi_v10/step/setuskur.step

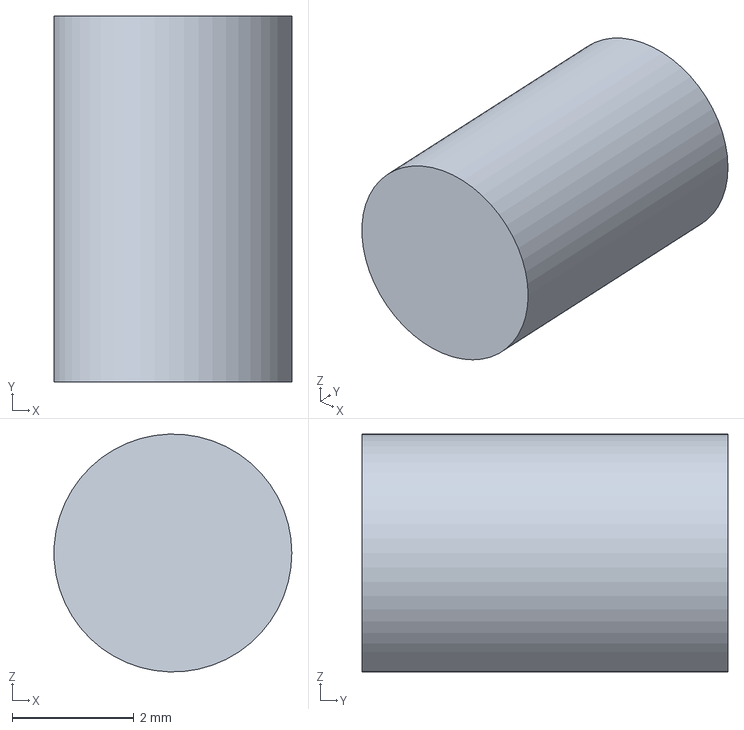
[picture p262: CAD file, 2026-09-21]
arastirma/3_TOPPING/kasar_kabi_v10/step/setuskur.step
3.90 x 6.00 x 3.90 mm
