kursatkemalkul/autokitch/arastirma/3_TOPPING/kiyma_kaseti_v5/step/plaka_on.step

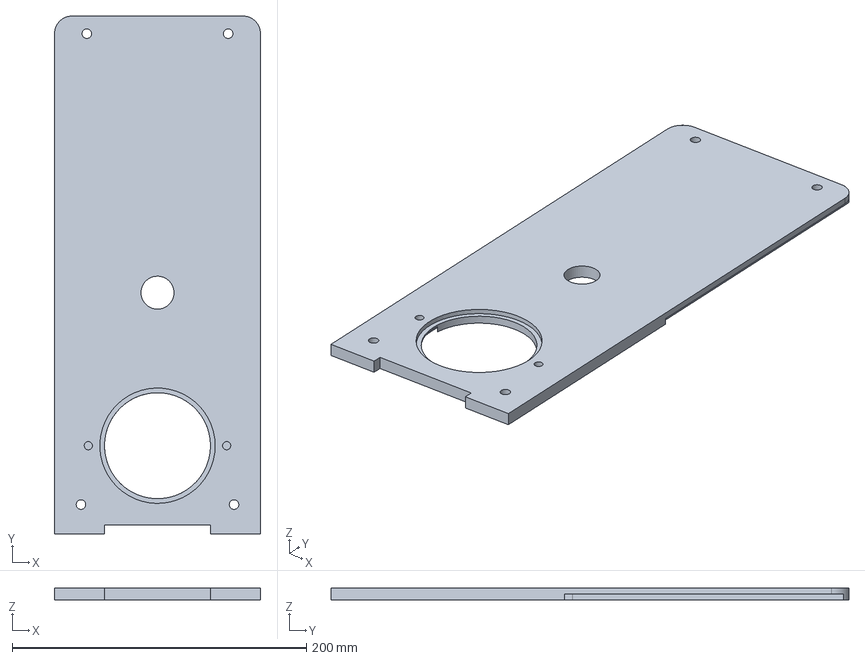
[picture p263: CAD file, 2026-09-21]
arastirma/3_TOPPING/kiyma_kaseti_v5/step/plaka_on.step
140.0 x 352.0 x 8.00 mm
