kursatkemalkul/autokitch/arastirma/3_TOPPING/parca/TOPPING_klape_kat2_gazli_amortisor_2.SLDPRT

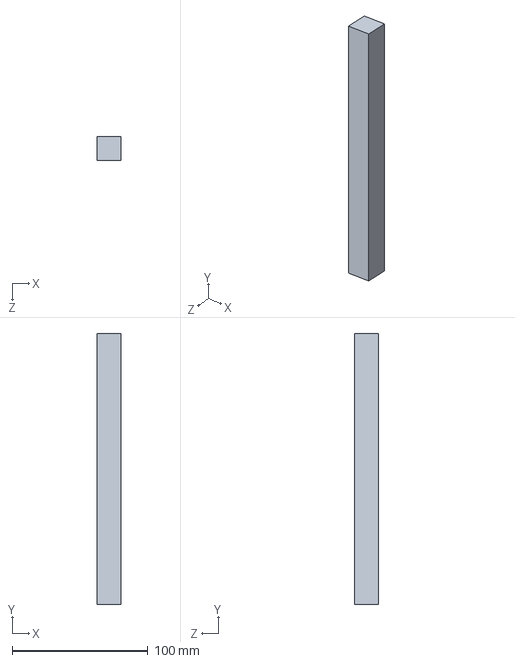
[picture p264: CAD file, 2026-09-08]
arastirma/3_TOPPING/parca/TOPPING_klape_kat2_gazli_amortisor_2.SLDPRT
18.0 x 200.0 x 18.0 mm
