kursatkemalkul/autokitch/arastirma/3_TOPPING/sucuk_kaseti_v3/step/gobek_helezon.step

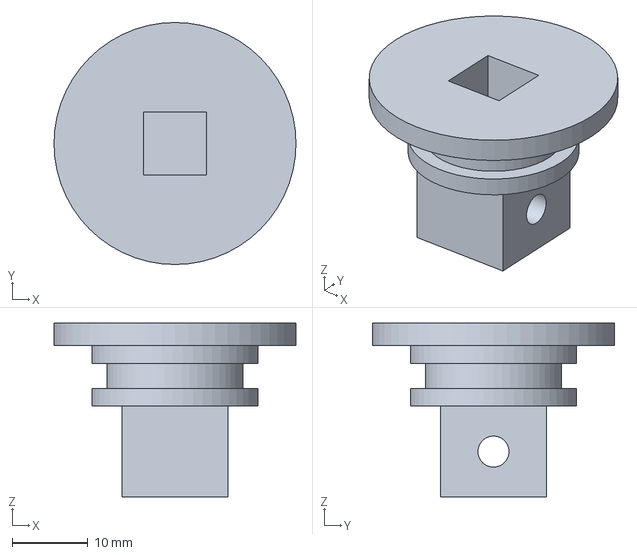
[picture p265: CAD file, 2026-09-21]
arastirma/3_TOPPING/sucuk_kaseti_v3/step/gobek_helezon.step
32.0 x 32.0 x 23.0 mm
