kursatkemalkul/autokitch/arastirma/3_TOPPING/topping_modul_v1/step/huni_HARÇ.step

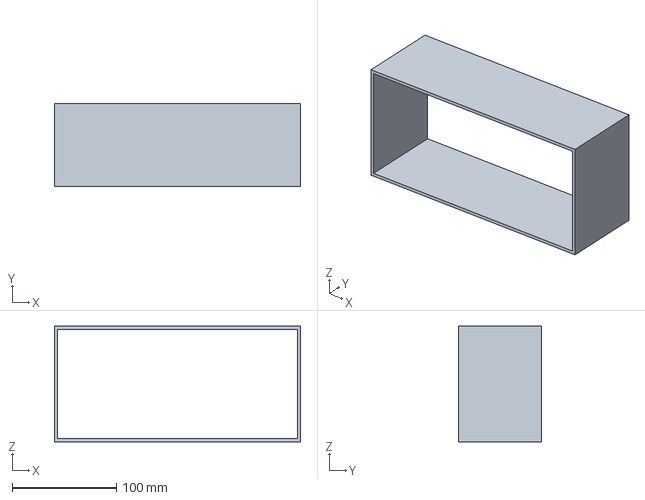
[picture p266: CAD file, 2026-09-21]
arastirma/3_TOPPING/topping_modul_v1/step/huni_HARÇ.step
236.0 x 80.0 x 111.0 mm
