kursatkemalkul/autokitch/arastirma/4_OVEN/parca/OVEN_dis_alt.SLDPRT

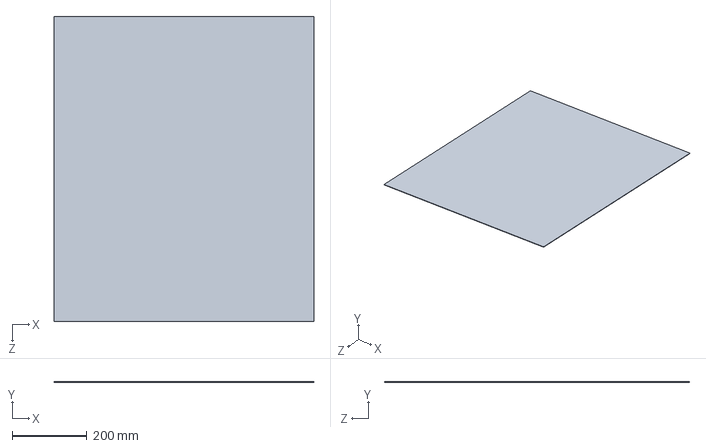
[picture p267: CAD file, 2026-09-08]
arastirma/4_OVEN/parca/OVEN_dis_alt.SLDPRT
697.0 x 1.50 x 818.5 mm
