kursatkemalkul/autokitch/arastirma/_ortak/KAP_YAG_14x68x24/parca/KAPYAG_samandira_D30.SLDPRT

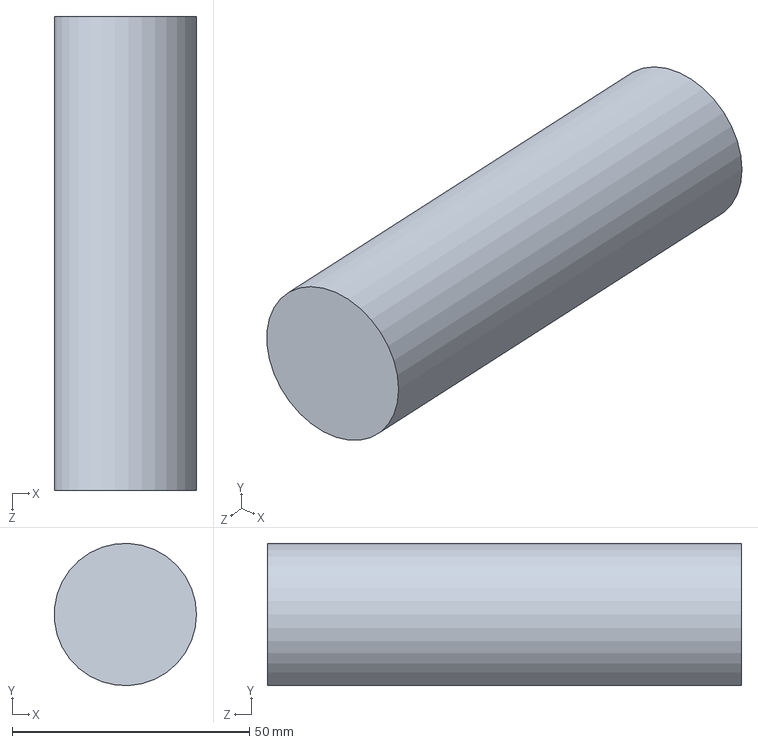
[picture p268: CAD file, 2026-09-08]
arastirma/_ortak/KAP_YAG_14x68x24/parca/KAPYAG_samandira_D30.SLDPRT
29.9 x 30.0 x 100.0 mm
