kursatkemalkul/autokitch/arastirma/_ortak/KUTU_KATLI_32x32/parca/KUTU_kapak_320x320_dik.SLDPRT

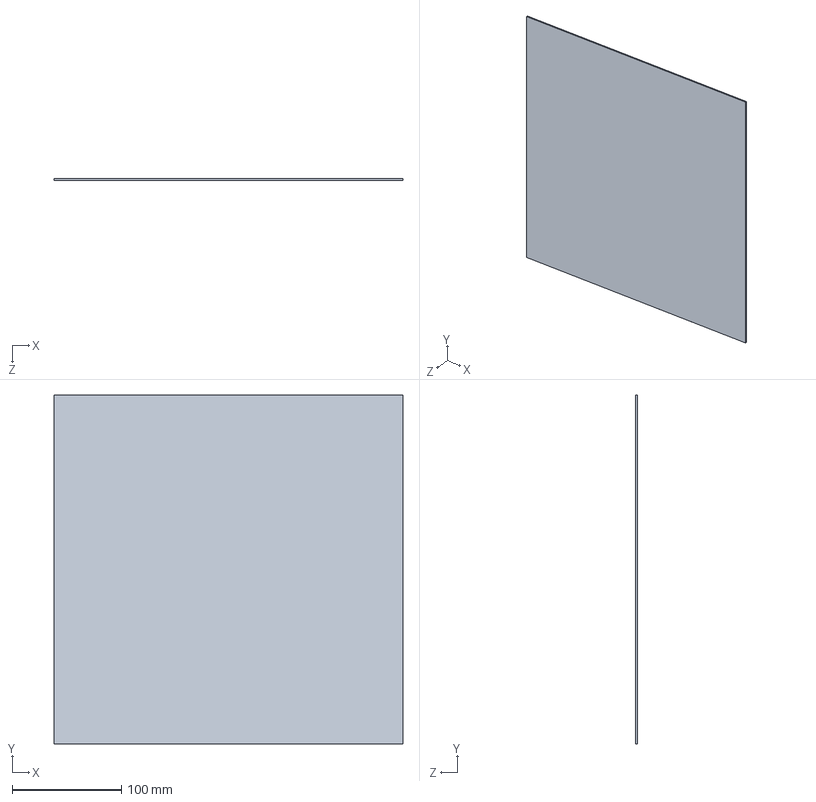
[picture p269: CAD file, 2026-09-08]
arastirma/_ortak/KUTU_KATLI_32x32/parca/KUTU_kapak_320x320_dik.SLDPRT
320.0 x 320.0 x 1.60 mm
