kursatkemalkul/autokitch/arastirma/_ortak/MOTOR_TAHRIK_GRUBU/parca/MTG_reduktor_govde_37x37x40.SLDPRT

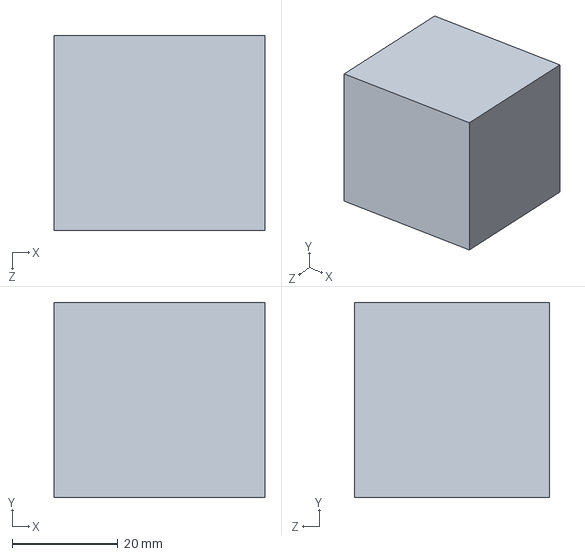
[picture p270: CAD file, 2026-09-08]
arastirma/_ortak/MOTOR_TAHRIK_GRUBU/parca/MTG_reduktor_govde_37x37x40.SLDPRT
40.0 x 37.0 x 37.0 mm
