kursatkemalkul/autokitch/arastirma/2_PRESS/parca/PRESS_uc_pence_parmak_2.SLDPRT

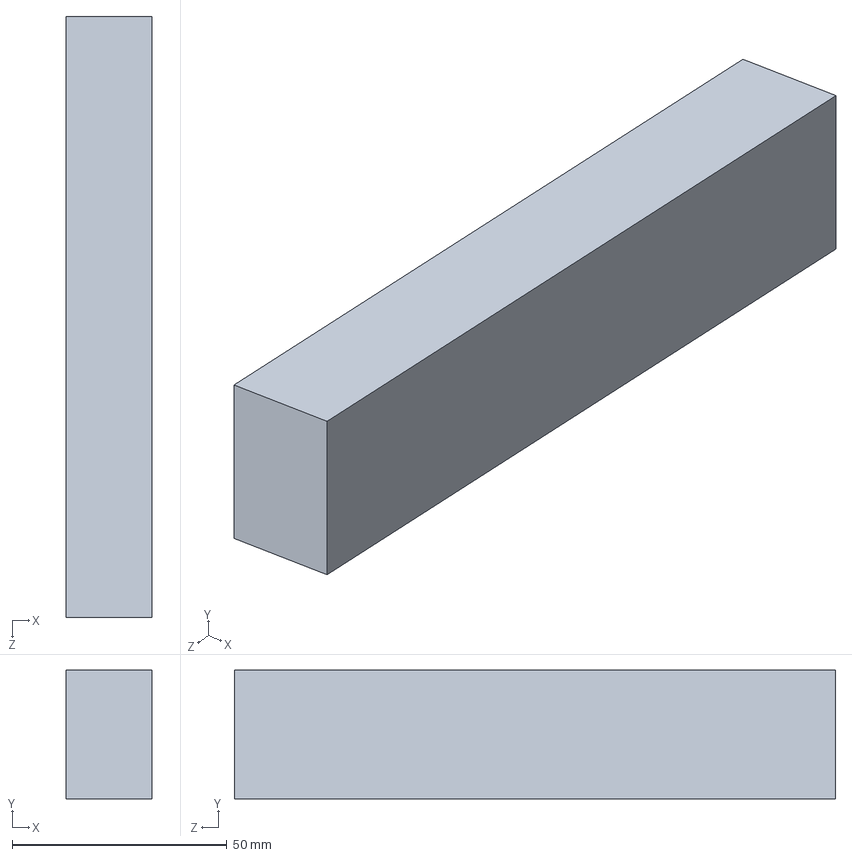
[picture p271: CAD file, 2026-09-08]
arastirma/2_PRESS/parca/PRESS_uc_pence_parmak_2.SLDPRT
20.0 x 30.0 x 140.0 mm
