kursatkemalkul/autokitch/arastirma/3_TOPPING/alt_montaj/KAP_14x68x24/parca/KAP_on_cekme_dudagi.SLDPRT

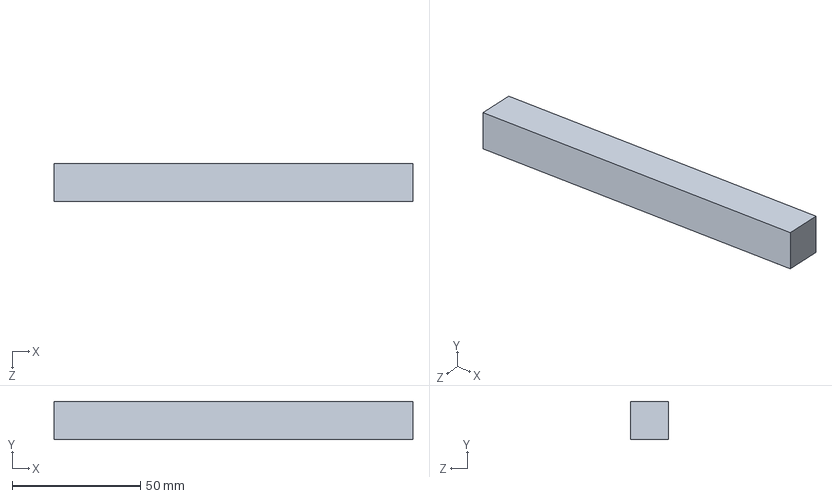
[picture p272: CAD file, 2026-09-08]
arastirma/3_TOPPING/alt_montaj/KAP_14x68x24/parca/KAP_on_cekme_dudagi.SLDPRT
140.0 x 15.0 x 15.0 mm
