kursatkemalkul/autokitch/arastirma/3_TOPPING/kasar_kabi_v10/step/orumcek_arka.step

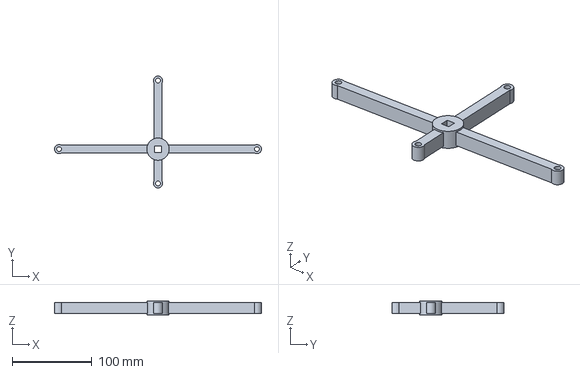
[picture p273: CAD file, 2026-09-21]
arastirma/3_TOPPING/kasar_kabi_v10/step/orumcek_arka.step
259.5 x 140.5 x 17.5 mm
