kursatkemalkul/autokitch/arastirma/3_TOPPING/parca/TOPPING_sag_kanal_kablo_kanali.SLDPRT

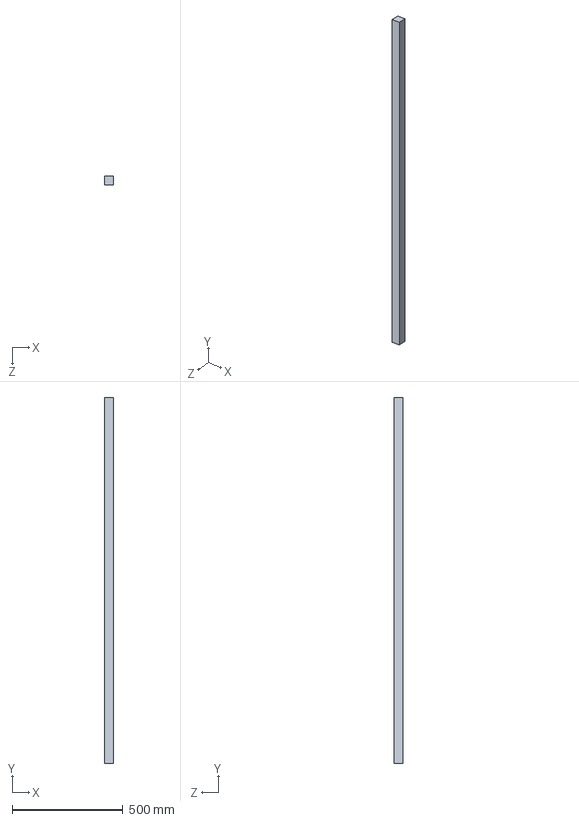
[picture p274: CAD file, 2026-09-08]
arastirma/3_TOPPING/parca/TOPPING_sag_kanal_kablo_kanali.SLDPRT
40.0 x 1650.0 x 40.0 mm
