kursatkemalkul/autokitch/arastirma/3_TOPPING/sucuk_kaseti_v3/step/helezon_cekirdek.step

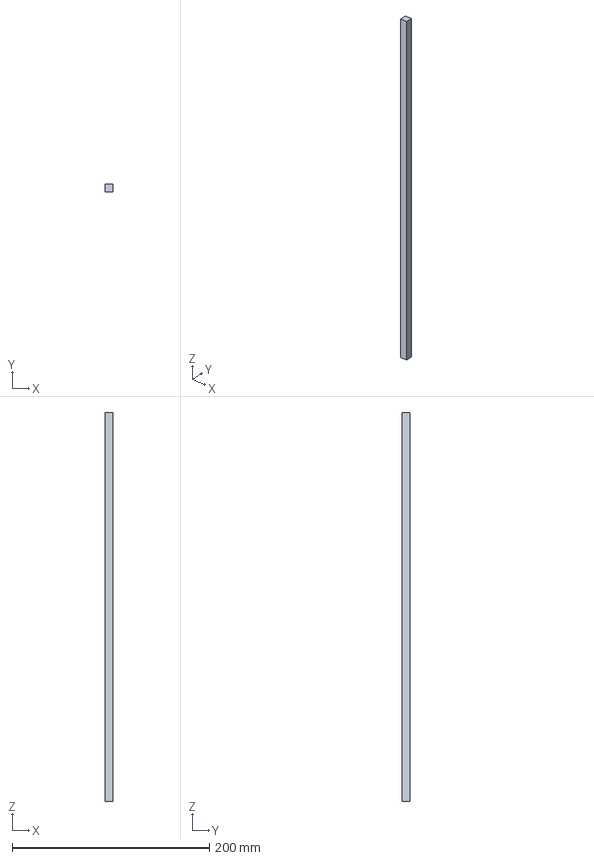
[picture p275: CAD file, 2026-09-21]
arastirma/3_TOPPING/sucuk_kaseti_v3/step/helezon_cekirdek.step
8.00 x 8.00 x 394.5 mm
