kursatkemalkul/autokitch/arastirma/3_TOPPING/topping_modul_v1/step/reduktor_HARÇ_1_rotor.step

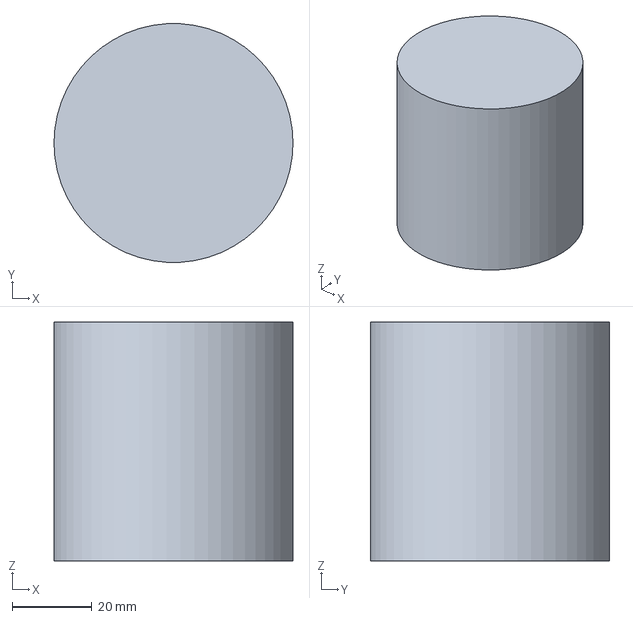
[picture p276: CAD file, 2026-09-21]
arastirma/3_TOPPING/topping_modul_v1/step/reduktor_HARÇ_1_rotor.step
60.0 x 59.9 x 60.0 mm
