kursatkemalkul/autokitch/arastirma/4_OVEN/parca/OVEN_yalitim_tasyunu_sag.SLDPRT

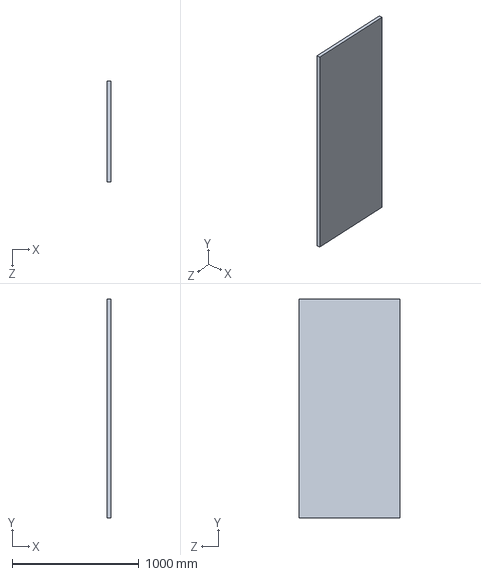
[picture p277: CAD file, 2026-09-08]
arastirma/4_OVEN/parca/OVEN_yalitim_tasyunu_sag.SLDPRT
30.0 x 1730.0 x 798.5 mm
