kursatkemalkul/autokitch/arastirma/_ortak/FIRIN_KAPAK_CAM/parca/FKAP_mentese_motoru_D28.SLDPRT

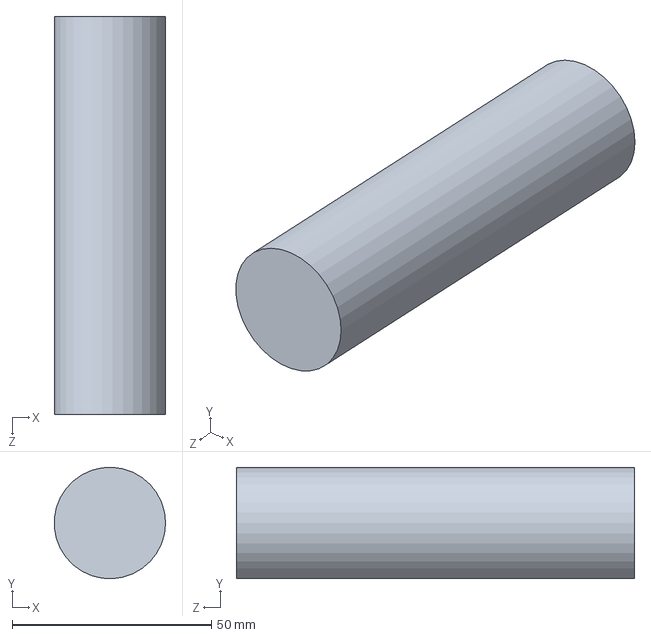
[picture p278: CAD file, 2026-09-08]
arastirma/_ortak/FIRIN_KAPAK_CAM/parca/FKAP_mentese_motoru_D28.SLDPRT
27.9 x 28.0 x 100.0 mm
