kursatkemalkul/autokitch/arastirma/_ortak/MOTOR_TAHRIK_GRUBU/parca/MTG_enkoder_kapagi.SLDPRT

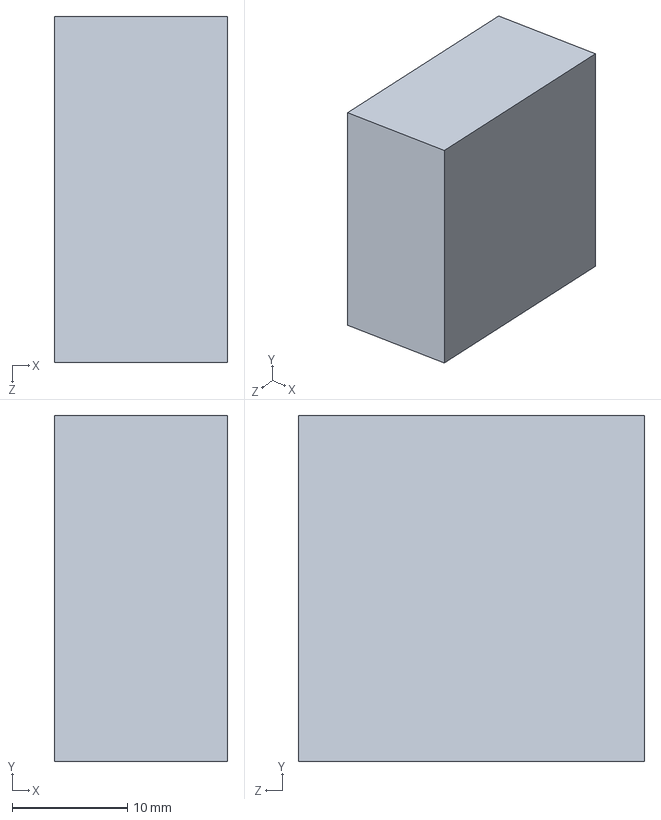
[picture p279: CAD file, 2026-09-08]
arastirma/_ortak/MOTOR_TAHRIK_GRUBU/parca/MTG_enkoder_kapagi.SLDPRT
15.0 x 30.0 x 30.0 mm
