kursatkemalkul/autokitch/arastirma/2_PRESS/parca/PRESS_kova_kapagi_mentese_1.SLDPRT

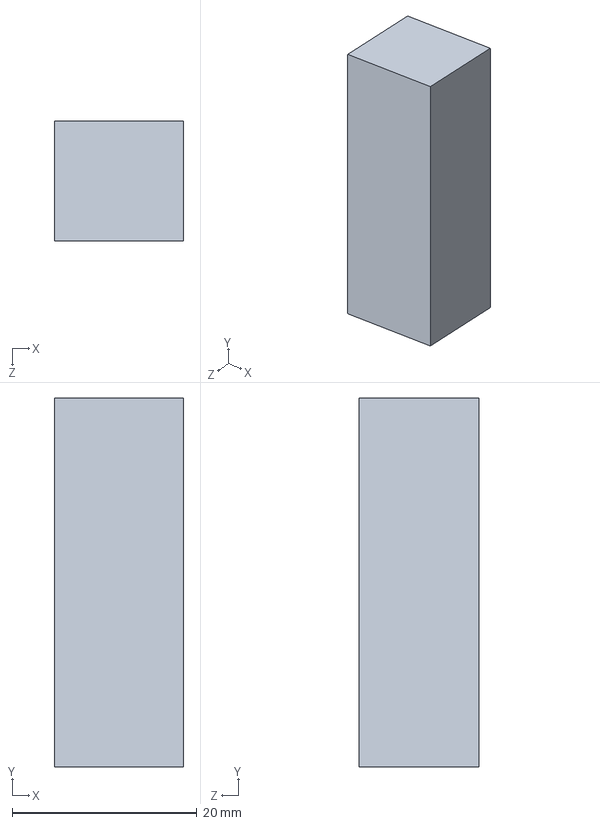
[picture p280: CAD file, 2026-09-08]
arastirma/2_PRESS/parca/PRESS_kova_kapagi_mentese_1.SLDPRT
14.0 x 40.0 x 13.0 mm
