kursatkemalkul/autokitch/arastirma/3_TOPPING/alt_montaj/KAP_14x68x24/KAP_14x68x24.SLDASM

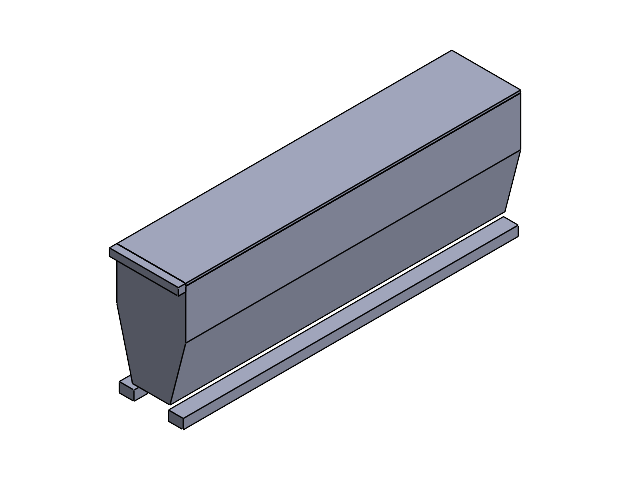
[picture p281: CAD file, 2026-09-08]
arastirma/3_TOPPING/alt_montaj/KAP_14x68x24/KAP_14x68x24.SLDASM
KAP_PC_govde_5mm
KAP_PC_kapak_gecmeli
KAP_agiz_kapagi_PC
KAP_helezon_POM_D70
KAP_helezon_topuz_D50
KAP_kizak_sag_30x20
KAP_kizak_sol_30x20
KAP_on_cekme_dudagi
KAP_tarak_mili_D12
KAP_tarak_topuz_D30
