kursatkemalkul/autokitch/arastirma/3_TOPPING/alt_montaj/SOKET_MOTOR/SOKET_MOTOR.SLDASM

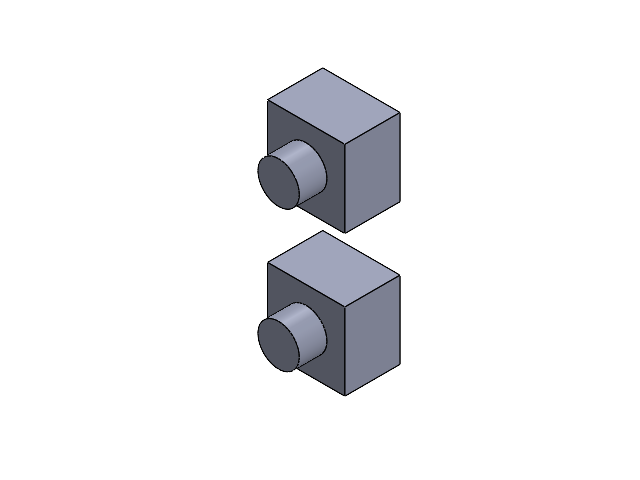
[picture p282: CAD file, 2026-09-08]
arastirma/3_TOPPING/alt_montaj/SOKET_MOTOR/SOKET_MOTOR.SLDASM
SM_soket_helezon_yayli
SM_soket_tarak_yayli
SM_motor_helezon_57x57x40
SM_motor_tarak_57x57x40
