kursatkemalkul/autokitch/arastirma/_ortak/FIRIN_KAPAK_CAM/FIRIN_KAPAK_CAM.SLDASM

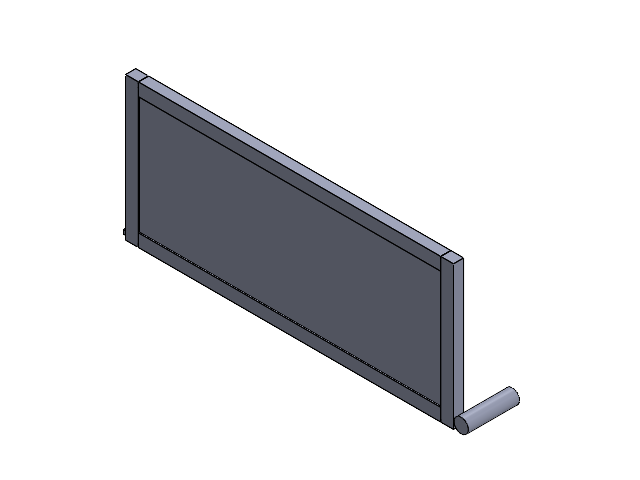
[picture p283: CAD file, 2026-09-08]
arastirma/_ortak/FIRIN_KAPAK_CAM/FIRIN_KAPAK_CAM.SLDASM
FKAP_cerceve_sol
FKAP_cerceve_sag
FKAP_cerceve_ust
FKAP_cerceve_alt
FKAP_cam_dis_4mm
FKAP_cam_ic_4mm
FKAP_pivot_mili_D8
FKAP_mentese_motoru_D28
