kursatkemalkul/autokitch/arastirma/_ortak/KAP_YAG_14x68x24/KAP_YAG_14x68x24.SLDASM

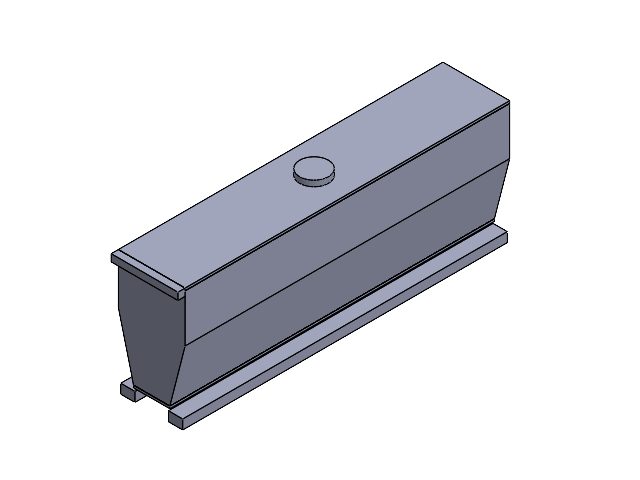
[picture p284: CAD file, 2026-09-08]
arastirma/_ortak/KAP_YAG_14x68x24/KAP_YAG_14x68x24.SLDASM
KAPYAG_PC_govde_5mm
KAPYAG_PC_kapak_gecmeli
KAPYAG_dolum_agzi_D60
KAPYAG_kizak_sag_30x20
KAPYAG_kizak_sol_30x20
KAPYAG_kuru_baglanti_D12
KAPYAG_on_cekme_dudagi
KAPYAG_samandira_D30
KAPYAG_taban_plakasi_kapali
