kursatkemalkul/autokitch/arastirma/_ortak/KUTU_KATLI_32x32/KUTU_KATLI_32x32.SLDASM

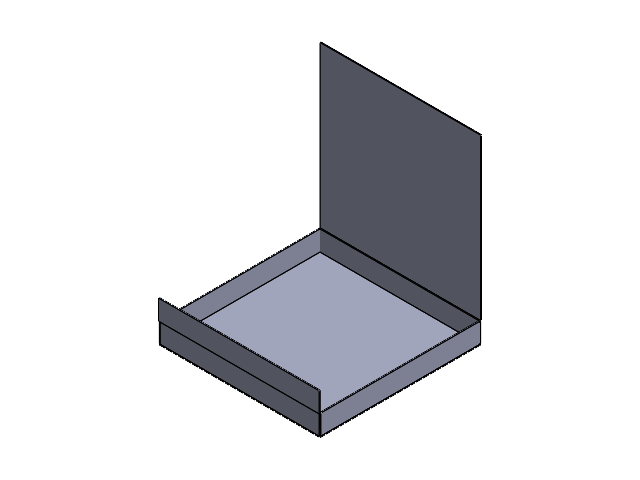
[picture p285: CAD file, 2026-09-08]
arastirma/_ortak/KUTU_KATLI_32x32/KUTU_KATLI_32x32.SLDASM
KUTU_taban_320x320
KUTU_duvar_on
KUTU_duvar_arka
KUTU_duvar_sol
KUTU_duvar_sag
KUTU_kapak_320x320_dik
KUTU_on_dil
