kursatkemalkul/autokitch/arastirma/_ortak/KUTU_KOLA_330ml/KUTU_KOLA_330ml.SLDASM

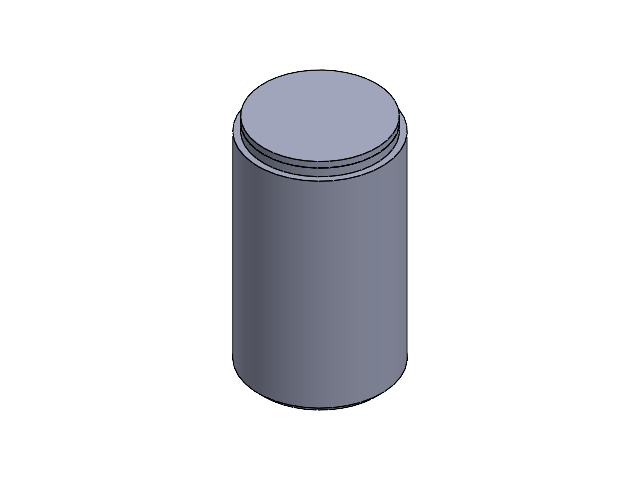
[picture p286: CAD file, 2026-09-08]
arastirma/_ortak/KUTU_KOLA_330ml/KUTU_KOLA_330ml.SLDASM
KOLA330_alt_bilezik_D60
KOLA330_govde_D66
KOLA330_boyun_daralma_D60
KOLA330_kapak_D60
