kursatkemalkul/autokitch/arastirma/_ortak/MOTOR_TAHRIK_GRUBU/MOTOR_TAHRIK_GRUBU.SLDASM

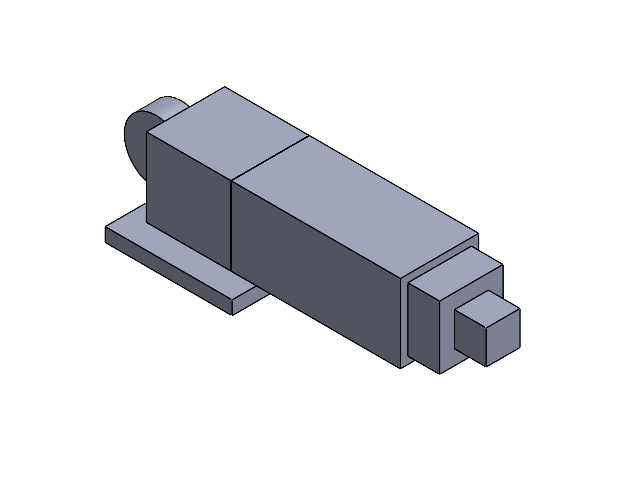
[picture p287: CAD file, 2026-09-08]
arastirma/_ortak/MOTOR_TAHRIK_GRUBU/MOTOR_TAHRIK_GRUBU.SLDASM
MTG_kasnak_D30_kayis
MTG_reduktor_govde_37x37x40
MTG_motor_24V_37x37x80
MTG_enkoder_kapagi
MTG_M12_soket
MTG_montaj_braketi_3mm
