kursatkemalkul/autokitch/arastirma/_ortak/SISE_KOLA_1L/SISE_KOLA_1L.SLDASM

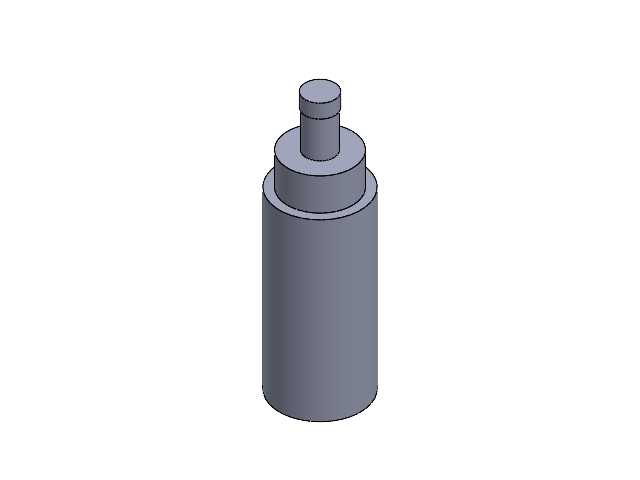
[picture p288: CAD file, 2026-09-08]
arastirma/_ortak/SISE_KOLA_1L/SISE_KOLA_1L.SLDASM
KOLA1L_govde_D88
KOLA1L_omuz_D70
KOLA1L_boyun_D30
KOLA1L_kapak_D32
