kursatkemalkul/autokitch/arastirma/_ortak/TEPSI_D320/TEPSI_D320.SLDASM

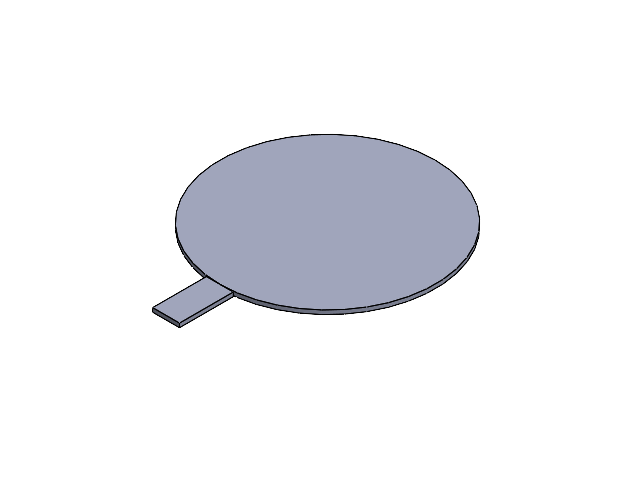
[picture p289: CAD file, 2026-09-08]
arastirma/_ortak/TEPSI_D320/TEPSI_D320.SLDASM
TEPSI_disk_D320_alu_1.5
TEPSI_kulp_40x6x80
