kursatkemalkul/autokitch/arastirma/_ortak/UC_YUVASI/UC_YUVASI.SLDASM

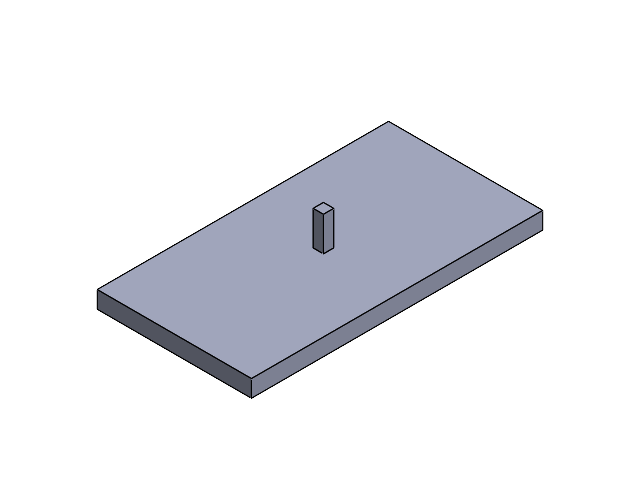
[picture p290: CAD file, 2026-09-08]
arastirma/_ortak/UC_YUVASI/UC_YUVASI.SLDASM
UCY_taban_180x20x340
UCY_kilit_pimi_12x40
