kursatkemalkul/autokitch/arastirma/_ortak/VANTUZ_D40/VANTUZ_D40.SLDASM

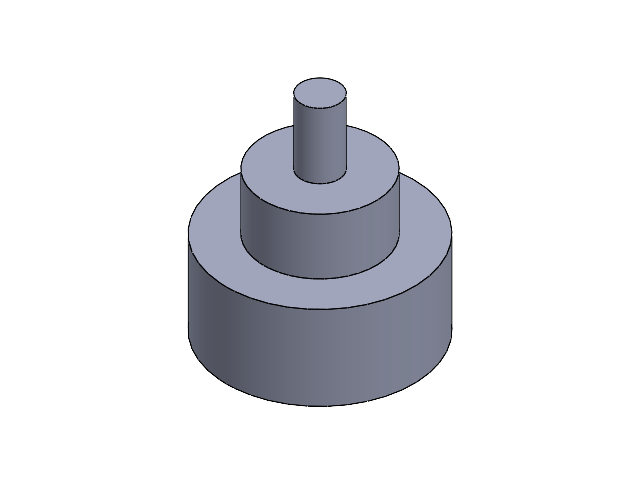
[picture p291: CAD file, 2026-09-08]
arastirma/_ortak/VANTUZ_D40/VANTUZ_D40.SLDASM
VNT_koruk_dudak_D40
VNT_govde_D24
VNT_nipel_M8
