kursatkemalkul/autokitch/arastirma/2_PRESS/PRESS.SLDASM

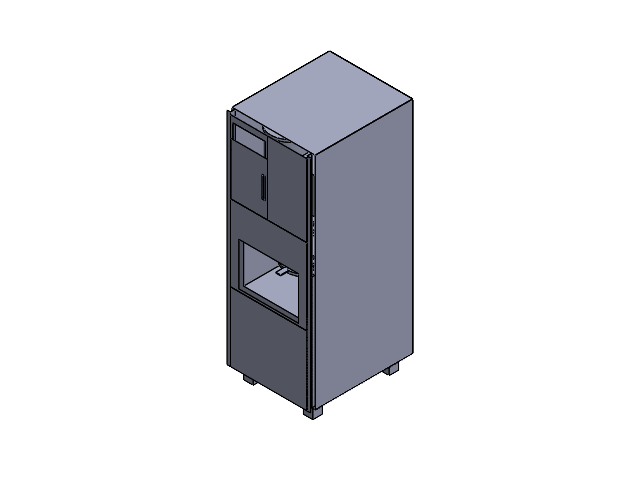
[picture p292: CAD file, 2026-09-08]
arastirma/2_PRESS/PRESS.SLDASM
PRESS_PZP400_alt_plaka_D340
PRESS_PZP400_govde_SATIN_ALINAN
PRESS_PZP400_motor_rezistans_govdesi
PRESS_PZP400_piston_mili
PRESS_PZP400_ust_plaka_D290
PRESS_ayak_1
PRESS_ayak_2
PRESS_ayak_3
PRESS_ayak_4
PRESS_cop_kovasi_30L_D300
PRESS_dis_alt
PRESS_dis_arka
PRESS_dis_ust
PRESS_dis_yan_sag
PRESS_dis_yan_sol
PRESS_kontrol_panosu_kucuk
PRESS_kova_kapagi_kapak
PRESS_kova_kapagi_kulp_cukuru
PRESS_kova_kapagi_mentese_1
PRESS_kova_kapagi_mentese_2
PRESS_kova_kizagi_sag
PRESS_kova_kizagi_sol
PRESS_kova_tabani
PRESS_panel_alt
PRESS_panel_pres_agzi
PRESS_panel_ust_sag
PRESS_panel_ust_sol
PRESS_poset_kelepcesi_D320
PRESS_sove_sag
PRESS_sove_sol
PRESS_tepsi_rafi_kosebent_sag
PRESS_tepsi_rafi_kosebent_sol
PRESS_tepsi_rafi_raf
PRESS_tepsi_rafi_raf_buk_arka
PRESS_tepsi_rafi_raf_buk_on
PRESS_uc_catal_flans_ISO9409
PRESS_uc_catal_lama_1
PRESS_uc_catal_lama_2
PRESS_uc_catal_sirt
PRESS_uc_pence_govde
PRESS_uc_pence_parmak_1
PRESS_uc_pence_parmak_2
PRESS_uc_rafi_kosebent_sag
PRESS_uc_rafi_kosebent_sol
PRESS_uc_rafi_raf
PRESS_uc_rafi_raf_buk_arka
PRESS_uc_rafi_raf_buk_on
TEPSI_disk_D320_alu_1.5 x 3
TEPSI_kulp_40x6x80 x 3
UCY_taban_180x20x340 x 3
UCY_kilit_pimi_12x40 x 3
