kursatkemalkul/autokitch/arastirma/3_TOPPING/TOPPING.SLDASM

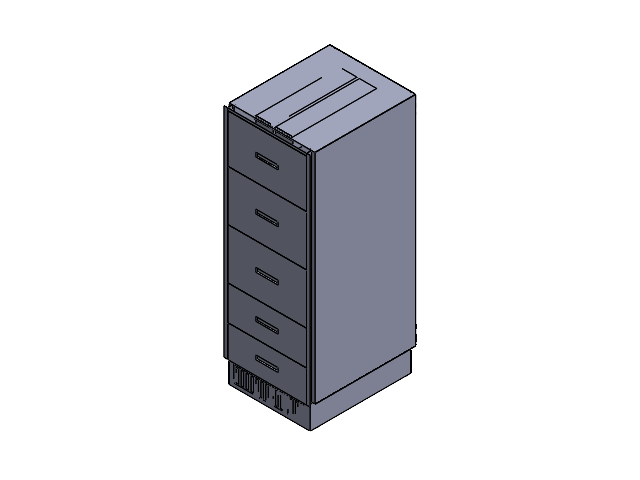
[picture p293: CAD file, 2026-09-08]
arastirma/3_TOPPING/TOPPING.SLDASM
TOPPING_arka_duvar_kapak_saci
TOPPING_arka_duvar_pano_guc_kaynagi
TOPPING_arka_duvar_pano_plakasi
TOPPING_arka_duvar_pano_plc
TOPPING_arka_duvar_pano_surucu_1
TOPPING_arka_duvar_pano_surucu_2
TOPPING_arka_duvar_pano_surucu_3
TOPPING_arka_duvar_pano_surucu_4
TOPPING_arka_duvar_pano_surucu_5
TOPPING_arka_duvar_pano_surucu_6
TOPPING_ayar_ayagi_1
TOPPING_ayar_ayagi_2
TOPPING_ayar_ayagi_3
TOPPING_ayar_ayagi_4
TOPPING_ayar_mil_1
TOPPING_ayar_mil_2
TOPPING_ayar_mil_3
TOPPING_ayar_mil_4
TOPPING_dis_alt
TOPPING_dis_arka
TOPPING_dis_ust
TOPPING_dis_yan_sag
TOPPING_dis_yan_sol
TOPPING_evap_fan_1
TOPPING_evap_fan_2
TOPPING_evaporator_sol_kanal
TOPPING_ic_alt
TOPPING_ic_arka
TOPPING_ic_tavan
TOPPING_ic_yan_sag
TOPPING_ic_yan_sol
TOPPING_kat1_kapak_pimi_D8_1
TOPPING_kat1_kapak_pimi_D8_2
TOPPING_kat2_kapak_pimi_D8_1
TOPPING_kat2_kapak_pimi_D8_2
TOPPING_kat3_kapak_pimi_D8_1
TOPPING_kat3_kapak_pimi_D8_2
TOPPING_klape_alt1_gazli_amortisor_1
TOPPING_klape_alt1_gazli_amortisor_2
TOPPING_klape_alt1_kapak
TOPPING_klape_alt1_kulp_cukuru
TOPPING_klape_alt1_pivot_mil
TOPPING_klape_alt2_gazli_amortisor_1
TOPPING_klape_alt2_gazli_amortisor_2
TOPPING_klape_alt2_kapak
TOPPING_klape_alt2_kulp_cukuru
TOPPING_klape_alt2_pivot_mil
TOPPING_klape_kat1_gazli_amortisor_1
TOPPING_klape_kat1_gazli_amortisor_2
TOPPING_klape_kat1_kapak
TOPPING_klape_kat1_kulp_cukuru
TOPPING_klape_kat1_pivot_mil
TOPPING_klape_kat2_gazli_amortisor_1
TOPPING_klape_kat2_gazli_amortisor_2
TOPPING_klape_kat2_kapak
TOPPING_klape_kat2_kulp_cukuru
TOPPING_klape_kat2_pivot_mil
TOPPING_klape_kat3_gazli_amortisor_1
TOPPING_klape_kat3_gazli_amortisor_2
TOPPING_klape_kat3_kapak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
