kursatkemalkul/autokitch/arastirma/4_OVEN/OVEN.SLDASM

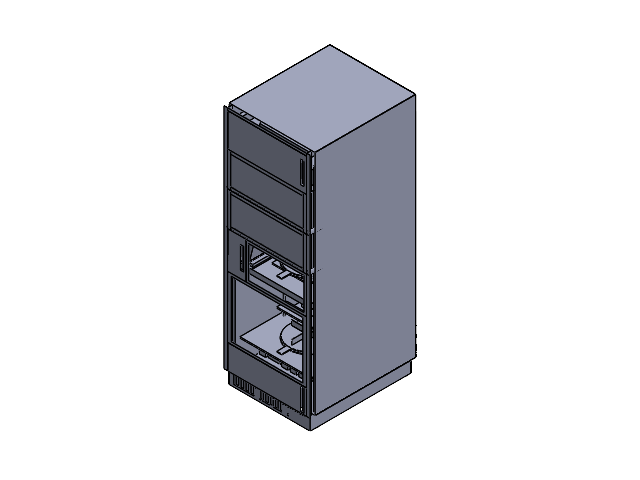
[picture p294: CAD file, 2026-09-08]
arastirma/4_OVEN/OVEN.SLDASM
OVEN_OMAKE_firin_SATIN_ALINAN_64x60x56
OVEN_OMAKE_hazne_1_tepsi_duzlemi_117
OVEN_OMAKE_hazne_2_tepsi_duzlemi_145
OVEN_arka_kanal_bolme_saci
OVEN_ayar_ayagi_1
OVEN_ayar_ayagi_2
OVEN_ayar_ayagi_3
OVEN_ayar_ayagi_4
OVEN_ayar_mil_1
OVEN_ayar_mil_2
OVEN_ayar_mil_3
OVEN_ayar_mil_4
OVEN_damlalik_tavasi
OVEN_dis_alt
OVEN_dis_arka
OVEN_dis_ust
OVEN_dis_yan_sag
OVEN_dis_yan_sol
OVEN_egzoz_fani_D120
OVEN_egzoz_izgarasi_ust
OVEN_fan_filtre_kapagi_kapak
OVEN_fan_filtre_kapagi_kulp_cukuru
OVEN_fan_filtre_kapagi_mentese_1
OVEN_fan_filtre_kapagi_mentese_2
OVEN_firin_arka_kanal_kablo
OVEN_firin_buhar_kanali
OVEN_karbon_filtre_40x40x5_opsiyon
OVEN_kesme_aktuator_24V_1500N
OVEN_kesme_aktuator_mili
OVEN_kesme_bicak_1_2x28_t1.2
OVEN_kesme_bicak_2_2x28_t1.2
OVEN_kesme_gobek_D28
OVEN_kesme_kilavuz_mili_D12_1
OVEN_kesme_kilavuz_mili_D12_2
OVEN_kesme_kizak_plakasi
OVEN_kesme_tepsi_halkasi_D330
OVEN_kesme_ust_travers
OVEN_kesme_zemin_plakasi
OVEN_panel_kesme
OVEN_panel_sprey
OVEN_panel_ust_serit
OVEN_pano_SSR_1
OVEN_pano_SSR_2
OVEN_pano_kapagi_kapak
OVEN_pano_kapagi_kulp_cukuru
OVEN_pano_kapagi_mentese_1
OVEN_pano_kapagi_mentese_2
OVEN_pano_klemens_rayi
OVEN_pano_plakasi
OVEN_pano_plc
OVEN_pano_pompa_rolesi
OVEN_pano_psu_24V
OVEN_pano_surucu_mentese_1
OVEN_pano_surucu_mentese_2
OVEN_pano_surucu_pres
OVEN_plenum_kutusu
OVEN_plint_U
OVEN_plint_arka
OVEN_plint_izgara_paneli
OVEN_sicak_dolap_isitici_100W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
