kursatkemalkul/autokitch/arastirma/FULL_MAKINE/HAT.SLDASM

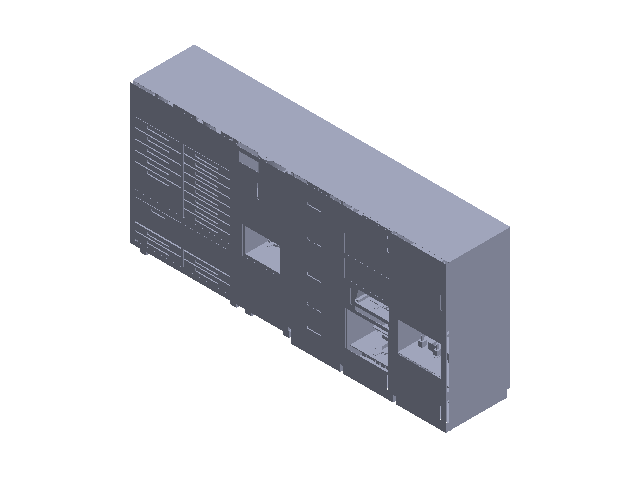
[picture p295: CAD file, 2026-09-08]
arastirma/FULL_MAKINE/HAT.SLDASM
STORE_ayak_1
STORE_ayak_2
STORE_ayak_3
STORE_ayak_4
STORE_ayirici_pu
STORE_ayirici_sac_alt
STORE_ayirici_sac_ust
STORE_dis_alt
STORE_dis_arka
STORE_dis_ust
STORE_dis_yan_sag
STORE_dis_yan_sol
STORE_evap_fan_1
STORE_evap_fan_2
STORE_evaporator_1
STORE_evaporator_2
STORE_ic_alt
STORE_ic_arka
STORE_ic_tavan
STORE_ic_yan_sag
STORE_ic_yan_sol
STORE_klape_kaset_kati_donmus_kap_1
STORE_klape_kaset_kati_donmus_kap_2
STORE_klape_kaset_kati_donmus_kap_3
STORE_klape_kaset_kati_donmus_kap_4
STORE_klape_kaset_kati_gazli_amortisor_1
STORE_klape_kaset_kati_gazli_amortisor_2
STORE_klape_kaset_kati_kulp_cukuru
STORE_klape_kaset_kati_on_dis_sac
STORE_klape_kaset_kati_on_ic_sac
STORE_klape_kaset_kati_on_pu
STORE_klape_kaset_kati_pivot_mil
STORE_klape_kaset_kati_raf
STORE_orta_bolme_pu
STORE_orta_bolme_sac_sag
STORE_orta_bolme_sac_sol
STORE_panel_ayirici_on
STORE_panel_bant_alt
STORE_panel_bant_ust
STORE_panel_bos_bant
STORE_panel_sogutma
STORE_pu_alt
STORE_pu_arka
STORE_pu_tavan
STORE_pu_yan_sag
STORE_pu_yan_sol
STORE_sog1_kompresor
STORE_sog1_kondenser
STORE_sog1_kondenser_fan
STORE_sog2_kompresor
STORE_sog2_kondenser
STORE_sog2_kondenser_fan
STORE_sove_orta
STORE_sove_sag
STORE_sove_sol
STORE_teknik_taban
CEK_icecek_on_ic_sac_1.0 x 4
CEK_icecek_on_pu_37.5 x 4
CEK_icecek_on_dis_sac_1.5 x 4
CEK_icecek_kulp_cukuru_1.0 x 4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
