kursatkemalkul/autokitch/(list of files, cad)

Other CAD files:
arastirma/3_TOPPING/kusbasi_kaseti_v4/KUSBASI_KASETI_v4_MONTAJ.step
arastirma/3_TOPPING/kusbasi_kaseti_v4/step/somun_arka_0.step
arastirma/3_TOPPING/sucuk_kaseti_v3/step/somun_on_0.step
arastirma/3_TOPPING/sucuk_kaseti_v3/SUCUK_KASETI_v3_MONTAJ.step
arastirma/3_TOPPING/TOPPING_dis_v1.SLDPRT
arastirma/4_OVEN/OVEN_dis_v1.SLDPRT
arastirma/_ortak/HAMUR_TOPU_220g/parca/HMR_topu_220g.SLDPRT
arastirma/_ortak/KABLO_24V_D5/parca/KABLO_24V_D5x120.SLDPRT
arastirma/_ortak/KAYIS_GT3_6mm/parca/KAYIS_GT3_6x3x650.SLDPRT
arastirma/_ortak/KUTU_BLANK_40x76/parca/BLANK_karton_E_dalga_1.6.SLDPRT
arastirma/_ortak/RAY_DIS_PROFIL/parca/RAY_DIS_PROFIL_14x49x660.SLDPRT
arastirma/_ortak/TEPSI_HAMUR_GN21/parca/TPS_silikon_GN21_20_cukur.SLDPRT
arastirma/_ortak/YUVA_1L/parca/YUVA_1L_halka.SLDPRT
arastirma/_ortak/YUVA_icecek/parca/YUVA_icecek_halka.SLDPRT
arastirma/3_TOPPING/alt_montaj/SOKET_MOTOR/parca/SM_soket_tarak_yayli.SLDPRT
arastirma/3_TOPPING/kusbasi_kaseti_v4/step/topuz.step
arastirma/_ortak/KUTU_KATLI_32x32/parca/KUTU_duvar_arka.SLDPRT
arastirma/3_TOPPING/alt_montaj/L_RAF_CIFTI/parca/LRAF_sag_20x8x2.SLDPRT
arastirma/3_TOPPING/alt_montaj/SOKET_MOTOR/parca/SM_soket_helezon_yayli.SLDPRT
arastirma/3_TOPPING/kiyma_kaseti_v5/step/somun_on_0.step
arastirma/3_TOPPING/kusbasi_kaseti_v4/step/somun_arka_3.step
arastirma/_ortak/KUTU_KATLI_32x32/parca/KUTU_on_dil.SLDPRT
arastirma/_ortak/KUTU_KOLA_330ml/parca/KOLA330_alt_bilezik_D60.SLDPRT
arastirma/3_TOPPING/alt_montaj/SOKET_MOTOR/parca/SM_motor_tarak_57x57x40.SLDPRT
arastirma/3_TOPPING/kasar_kabi_v10/step/kavrama_helezon.step
arastirma/3_TOPPING/sucuk_kaseti_v3/step/kavrama_karistirici.step
arastirma/_ortak/KUTU_KATLI_32x32/parca/KUTU_duvar_on.SLDPRT
arastirma/3_TOPPING/kusbasi_kaseti_v4/step/pul_on_1.step
arastirma/_ortak/FIRIN_KAPAK_CAM/parca/FKAP_cerceve_sag.SLDPRT
arastirma/3_TOPPING/kiyma_kaseti_v5/step/kavrama_karistirici.step
arastirma/3_TOPPING/kusbasi_kaseti_v4/step/pul_arka_2.step
arastirma/_ortak/KAP_YAG_14x68x24/parca/KAPYAG_kizak_sol_30x20.SLDPRT
arastirma/_ortak/KUTU_KATLI_32x32/parca/KUTU_taban_320x320.SLDPRT
_local/codex_robot_v25/igus_ZLW_20200_3000.stp
arastirma/1_STORE/STORE.SLDASM
arastirma/1_STORE/STORE_dis_v1.SLDPRT
arastirma/1_STORE/STORE_dis_v1.step
arastirma/1_STORE/STORE_dis_v1.stl
arastirma/1_STORE/cekmece/CEKMECE_1L/CEKMECE_1L.SLDASM
arastirma/1_STORE/cekmece/CEKMECE_1L/parca/CEK_1L_kayis_baglanti_pabucu.SLDPRT
arastirma/1_STORE/cekmece/CEKMECE_1L/parca/CEK_1L_kulp_cukuru_1.0.SLDPRT
arastirma/1_STORE/cekmece/CEKMECE_1L/parca/CEK_1L_kutu_U_1.0.SLDPRT
arastirma/1_STORE/cekmece/CEKMECE_1L/parca/CEK_1L_kutu_arka_1.0.SLDPRT
arastirma/1_STORE/cekmece/CEKMECE_1L/parca/CEK_1L_miknatis_15x8x3.SLDPRT
arastirma/1_STORE/cekmece/CEKMECE_1L/parca/CEK_1L_on_dis_sac_1.5.SLDPRT
arastirma/1_STORE/cekmece/CEKMECE_1L/parca/CEK_1L_on_ic_sac_1.0.SLDPRT
arastirma/1_STORE/cekmece/CEKMECE_1L/parca/CEK_1L_on_pu_37.5.SLDPRT
arastirma/1_STORE/cekmece/CEKMECE_1L/parca/CEK_1L_ray_ic_profil_sag.SLDPRT
arastirma/1_STORE/cekmece/CEKMECE_1L/parca/CEK_1L_ray_ic_profil_sol.SLDPRT
arastirma/1_STORE/cekmece/CEKMECE_1L/parca/CEK_1L_tepsi_taban_saci_1.5.SLDPRT
arastirma/1_STORE/cekmece/CEKMECE_donmus/CEKMECE_donmus.SLDASM
arastirma/1_STORE/cekmece/CEKMECE_donmus/parca/CEK_donmus_kayis_baglanti_pabucu.SLDPRT
arastirma/1_STORE/cekmece/CEKMECE_donmus/parca/CEK_donmus_kulp_cukuru_1.0.SLDPRT
arastirma/1_STORE/cekmece/CEKMECE_donmus/parca/CEK_donmus_kutu_U_1.0.SLDPRT
arastirma/1_STORE/cekmece/CEKMECE_donmus/parca/CEK_donmus_kutu_arka_1.0.SLDPRT
arastirma/1_STORE/cekmece/CEKMECE_donmus/parca/CEK_donmus_miknatis_15x8x3.SLDPRT
arastirma/1_STORE/cekmece/CEKMECE_donmus/parca/CEK_donmus_on_dis_sac_1.5.SLDPRT
arastirma/1_STORE/cekmece/CEKMECE_donmus/parca/CEK_donmus_on_ic_sac_1.0.SLDPRT
arastirma/1_STORE/cekmece/CEKMECE_donmus/parca/CEK_donmus_on_pu_37.5.SLDPRT
arastirma/1_STORE/cekmece/CEKMECE_donmus/parca/CEK_donmus_ray_ic_profil_sag.SLDPRT
arastirma/1_STORE/cekmece/CEKMECE_donmus/parca/CEK_donmus_ray_ic_profil_sol.SLDPRT
arastirma/1_STORE/cekmece/CEKMECE_icecek/CEKMECE_icecek.SLDASM
arastirma/1_STORE/cekmece/CEKMECE_icecek/parca/CEK_icecek_kayis_baglanti_pabucu.SLDPRT
arastirma/1_STORE/cekmece/CEKMECE_icecek/parca/CEK_icecek_kulp_cukuru_1.0.SLDPRT
arastirma/1_STORE/cekmece/CEKMECE_icecek/parca/CEK_icecek_kutu_U_1.0.SLDPRT
arastirma/1_STORE/cekmece/CEKMECE_icecek/parca/CEK_icecek_kutu_arka_1.0.SLDPRT
arastirma/1_STORE/cekmece/CEKMECE_icecek/parca/CEK_icecek_miknatis_15x8x3.SLDPRT
arastirma/1_STORE/cekmece/CEKMECE_icecek/parca/CEK_icecek_on_dis_sac_1.5.SLDPRT
arastirma/1_STORE/cekmece/CEKMECE_icecek/parca/CEK_icecek_on_ic_sac_1.0.SLDPRT
arastirma/1_STORE/cekmece/CEKMECE_icecek/parca/CEK_icecek_on_pu_37.5.SLDPRT
arastirma/1_STORE/cekmece/CEKMECE_icecek/parca/CEK_icecek_ray_ic_profil_sag.SLDPRT
arastirma/1_STORE/cekmece/CEKMECE_icecek/parca/CEK_icecek_ray_ic_profil_sol.SLDPRT
arastirma/1_STORE/cekmece/CEKMECE_icecek/parca/CEK_icecek_tepsi_taban_saci_1.5.SLDPRT
arastirma/1_STORE/cekmece/CEKMECE_taze/CEKMECE_taze.SLDASM
arastirma/1_STORE/cekmece/CEKMECE_taze/parca/CEK_taze_kayis_baglanti_pabucu.SLDPRT
arastirma/1_STORE/cekmece/CEKMECE_taze/parca/CEK_taze_kulp_cukuru_1.0.SLDPRT
arastirma/1_STORE/cekmece/CEKMECE_taze/parca/CEK_taze_kutu_U_1.0.SLDPRT
arastirma/1_STORE/cekmece/CEKMECE_taze/parca/CEK_taze_kutu_arka_1.0.SLDPRT
arastirma/1_STORE/cekmece/CEKMECE_taze/parca/CEK_taze_miknatis_15x8x3.SLDPRT
arastirma/1_STORE/cekmece/CEKMECE_taze/parca/CEK_taze_on_dis_sac_1.5.SLDPRT
arastirma/1_STORE/cekmece/CEKMECE_taze/parca/CEK_taze_on_ic_sac_1.0.SLDPRT
arastirma/1_STORE/cekmece/CEKMECE_taze/parca/CEK_taze_on_pu_37.5.SLDPRT
arastirma/1_STORE/cekmece/CEKMECE_taze/parca/CEK_taze_ray_ic_profil_sag.SLDPRT
arastirma/1_STORE/cekmece/CEKMECE_taze/parca/CEK_taze_ray_ic_profil_sol.SLDPRT
arastirma/1_STORE/detay/CEKMECE_DETAY.SLDASM
arastirma/1_STORE/detay/parca/DET_MOTORLU_RAY_M12_soket.SLDPRT
arastirma/1_STORE/detay/parca/DET_MOTORLU_RAY_govde_45x12.7.SLDPRT
arastirma/1_STORE/detay/parca/DET_MOTORLU_RAY_kablo_D5.SLDPRT
arastirma/1_STORE/detay/parca/DET_MOTORLU_RAY_motor_kutusu.SLDPRT
arastirma/1_STORE/detay/parca/DET_PASIF_RAY_govde_45x12.7.SLDPRT
arastirma/1_STORE/detay/parca/DET_PU_dilimi_arka.SLDPRT
arastirma/1_STORE/detay/parca/DET_arka_ic_sac.SLDPRT
arastirma/1_STORE/detay/parca/DET_bolme_saci_sag.SLDPRT
arastirma/1_STORE/detay/parca/DET_bolme_saci_sol.SLDPRT
arastirma/1_STORE/detay/parca/DET_kablo_kanali_dilimi_40x25.SLDPRT
arastirma/1_STORE/detay/parca/DET_on_sove_dilimi.SLDPRT
arastirma/1_STORE/detay/parca/DET_raf_alt.SLDPRT
arastirma/1_STORE/detay/parca/DET_raf_ust.SLDPRT
arastirma/1_STORE/detay2/CEKMECE_TAHRIK_DETAY.SLDASM
arastirma/1_STORE/detay2/parca/DET2_PLC_dilimi.SLDPRT
arastirma/1_STORE/detay2/parca/DET2_PU_dilimi_arka.SLDPRT
arastirma/1_STORE/detay2/parca/DET2_arka_ic_sac.SLDPRT
arastirma/1_STORE/detay2/parca/DET2_bolme_saci_sol.SLDPRT
arastirma/1_STORE/detay2/parca/DET2_ethernet_kablosu_ana_PC.SLDPRT
arastirma/1_STORE/detay2/parca/DET2_gergi_makarasi_braketi.SLDPRT
arastirma/1_STORE/detay2/parca/DET2_kablo_24V_motor_D5.SLDPRT
arastirma/1_STORE/detay2/parca/DET2_kablo_kanali_40x25.SLDPRT
arastirma/1_STORE/detay2/parca/DET2_kayis_GT3_6mm.SLDPRT
arastirma/1_STORE/detay2/parca/DET2_klemens_kutusu_dilimi.SLDPRT
arastirma/1_STORE/detay2/parca/DET2_on_sove_dilimi.SLDPRT
arastirma/1_STORE/detay2/parca/DET2_raf_alt.SLDPRT
arastirma/1_STORE/detay2/parca/DET2_raf_ust.SLDPRT
arastirma/1_STORE/detay2/parca/DET2_ray_dis_profil_sag.SLDPRT
arastirma/1_STORE/detay2/parca/DET2_ray_dis_profil_sol.SLDPRT
arastirma/1_STORE/detay2/parca/DET2_reed_sensor_braketi.SLDPRT
arastirma/1_STORE/parca/STORE_PLC_giris_modulu_16_kanal.SLDPRT
arastirma/1_STORE/parca/STORE_ayak_1.SLDPRT
arastirma/1_STORE/parca/STORE_ayak_2.SLDPRT
arastirma/1_STORE/parca/STORE_ayak_3.SLDPRT
arastirma/1_STORE/parca/STORE_ayak_4.SLDPRT
arastirma/1_STORE/parca/STORE_ayirici_pu.SLDPRT
arastirma/1_STORE/parca/STORE_ayirici_sac_alt.SLDPRT
arastirma/1_STORE/parca/STORE_ayirici_sac_ust.SLDPRT
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
