kursatkemalkul/autokitch/_local/claude_son_yerel/gece2/adim4/kars_montaj_v7.md

# GLB KARŞILAŞTIRMA

A = `C:/Users/Kemal/AppData/Local/Temp/claude/C--Users-Kemal-Desktop-Kemal-WEBS-TE/f3ef876a-f062-4b29-bb81-775cc8a1a6d8/scratchpad/gece2/adim4/b9/otonom/hat3d/v3/hat3_v7.glb` (71588576 bayt)  
B = `C:/Users/Kemal/AppData/Local/Temp/claude/C--Users-Kemal-Desktop-Kemal-WEBS-TE/f3ef876a-f062-4b29-bb81-775cc8a1a6d8/scratchpad/gece2/adim4/girdi00/hat3_v7.glb` (71588536 bayt)  
köşe toleransı ±0.01 mm

- bayt bayt: **farklı (aşağıda anlamsal karşılaştırma)**
- düğüm adları + sırası: aynı (774 düğüm)
- malzemeler / sahne (extras: mekanizmalar, kategoriler…): aynı
- 774 düğüm karşılaştırıldı · toplam 1638824 üçgen · en büyük köşe farkı 3.45004 mm
- animasyonlar: 6 · farklı: 0

## Farklı düğümler (4)

| düğüm | üçgen A / B | köşe farkı mm | ne farklı |
|---|---|---|---|
| K_GOVDE__celik | 16988 / 16988 | 2.7000 | NORMAL 0.145, indisler, köşe 2.7000 mm |
| K_GOVDE__kabuk | 4624 / 4624 | 3.4500 | NORMAL 0.08169, indisler, köşe 3.4500 mm |
| K_GOVDE__on_seffaf | 3660 / 3660 | 1.6503 | NORMAL 0.09356, indisler, köşe 1.6503 mm |
| K_GOVDE__sac | 10688 / 10688 | 1.5001 | NORMAL 0.06196, indisler, köşe 1.5001 mm |

**SONUÇ: 4 FARK**
