kursatkemalkul/autokitch/otonom/onizleme-9eki/e/hat/e-montaj.html

Store›HAT›Makine v3›E montajı

← Makineye dön

# E (kutu katlama) — montaj sırasıv3 · mekanizmalar parça parça, vida vida · yol denetimli

E istasyonu üretimden başlayarak: kaide 304 borudan kaynaklanır, taban + ön kasa + panel kulakları tezgâhta tek parça kaynaklı alt montaj olur; yan, üst ve arka saclar lazerden düz açınım olarak çıkar, abkantta bükülür, FHP saplamalar preslenir (görünür yüzde vida yok, somunlar içeriden). Mekanizmalar tezgâhta iki modül hâlinde hazırlanır: üst modül (besleyici, vakum kolu, köşe kaldırıcılar, parmaklar, arka itici) ve alt modül (kalıp, köprü, kapak katlama mekanizması). Şarjör + asansör, robot çöpü, E panosu, fiş paneli J3, 4 ön kapak ve şarjör yan kapısı da yerine girer.

Diğer montajlar: A · B · tek çekmece · TOPPING · F · U

v3 · mekanizmalar (zincir 81–85): üst modül (besleyici, besleyici iticisi, vakum barı, köşe kaldırıcı + 4 köşe tutucu, köşe pistonu, arka itici + piston, ön parmak) ve alt modül (kalıp, kalıp yuvası, köprü, kapak katlama, katlayıcı kol) artık blok olarak gelmiyor: makinenin önündeki tezgâhta 265 parça tek tek, her vida / setskur / pim / segman / somun kendi ekseninde (segman yandan yivine) takılarak kurulur; sonra modül bütün olarak yerine girer. Montaj sırası parçaları sanal olarak sökerek bulundu (her parçanın giriş yolu çakışmasız). Yeni bağlantılar: besleyici dikmeleri köşebentle plakaya, raylar kendi havşalı deliklerinden, motor yuvası yan saca preslenmiş saplama + somunla (dışta çıkıntı yok), E3Z sensörleri kendi deliklerinden 4 mm dile, kalıp duvarları ve ön kılavuzlar üst plakaya. Denetim (v3.1, pano parça parça): plan sorunu 0 · belirme 0 · havada 0 · üretim karesi 0 · bağlantısız parça yalnız 1 (katlama sensörü, aşağıda) · beyanlı model açığı 37 çift (mil / göbek / kasnak üreteçte deliksiz). E panosu (zincir 98): montaj plakası 4 arayüz saplamasına ince somunla, 3 TS35 rayı plakaya ISO 7380 M4 × 5 (ray şapka kanalı oyuldu), 2 kablo kanalı (kapalı katı, 700 / 660 mm) DIN 7991 M4 × 6, cihazlar DIN klipse — tezgâhta arka sacın iç yüzünde kurulur. Açık (düzeltilecek): 8 itici ray vidası rayın açık ağlı deliğinde 1 mm sürtünüyor; köşe pistonu ve uç blok köşebentlerinde 7 vida başı / pim komşusuna 1–1,5 mm değiyor (adım 83 yerleşimi); katlama sensörü (Omron E3Z) sol yan saca 1 mm — yan delikleri vidalanamıyor, sensör en az 4 mm içeri alınmalı; E iç kabloları (adım 99) hazırlanıyor.

Model yükleniyor…

Kamera: otomatik

◀◀❚❚▶▶ 0,0 / 0 sn

HIZ0,5×1×2×4× GÖRÜNÜMKenar çizgileri Kesit

## Atölye sırası

AUTOKITCH · E montajı v3 (açınım → büküm → tezgâhta mekanizma → montaj, yol denetimli) · model: hat3_v10r_e · zincir 00–85 + 98, E gövdesi h3_e_sac_v1 · 7 Eki 2026
