kursatkemalkul/autokitch/otonom/onizleme-9eki/topping/hat/topping-montaj.html

Store›HAT›Makine v3›TOPPING montajı

← Makineye dön

# TOPPING — montaj sırasıv6 · her parça vidalı / kaynaklı · yol denetimli

TOPPING üretimden başlayarak, B dolabının (silik) üstünde, yeni 7 ürün yerleşimiyle (lahmacun harcı, kıyma, patates, tavuk, kuşbaşı, kaşar, sucuk). Kaide boruları kaynaklanır; plaka ve dış saclar lazerden düz açınım olarak çıkar, abkantta bükümler tek tek yapılır, somun ve saplamalar preslenir. Soğuk oda yalıtımı ölçüsünde kesilmiş PU levhalar (yapıştırıcıyla dış saca); iç sac kaynaksız: bükümlü kenarlar komşu sacın arkasına girer, POM ısı kesici pullu kör perçinlerle bağlanır, köşeler silikonla kapanır. Hazır ürünler (soğutma grubu, evaporatörler, UNO gövdeleri, kasetler, motorlar, valf adası, X ekseni) tek parça olarak kendi açık tarafından girer; UNO silindirleri arkadan, mili burçtan geçip pistona vidalanır. Kıyma UNO gövdesi ile çıkış dirseği tezgâhta birleşik iner.

Diğer montajlar: A · B · tek çekmece · F · E · U

v6 · bağlantı: her taşıyıcı parça kaynaklı ya da vidalı (zincir 62–66): 9 sac TIG ile bağlandı · 5 UNO rafa kaynaklı L pabuca 2 × M5 · kaşar / sucuk kaseti K2 kapağının iç yüzündeki POM takozla kilitli (kapak kapanmadan kaset oturmamışsa makine başlamaz) · kaset motorları, valf adası, X ekseni duvara / tabana kaynaklı braketle · menteşe ve X sensör braketleri preslenmiş saplamayla · kapak emniyet sensörleri tabana kaynaklı braketle (2 × M4). Montaj sırası düzeltmeleri: servis sacındaki kablo kanalı sucuk motoru sensörünün önünde 30 → 25 mm (servis sacı düz girer) · önce K2 (orta kayıtlı), sonra K1 kapanır. Açık maddeler: kıyma silindirinin halka flanşı evaporatör cebinde (üretici çizimi bekleniyor) · iç elektrik kanalı / braket / rakor 5 parça ve kaşar / sucuk kovan contaları 0,6 mm içinde bir yere değmiyor (elektrik işiyle düzeltilecek).

Model yükleniyor…

Kamera: otomatik

◀◀❚❚▶▶ 0,0 / 0 sn

HIZ0,5×1×2×4× GÖRÜNÜMKenar çizgileri Kesit

## Atölye sırası

AUTOKITCH · TOPPING montajı v6 (açınım → büküm → montaj, yol + bağlantı denetimli) · model: hat3_v10h · zincir 00–66, TOPPING gövdesi h3_topping_sac_v2 · 5 Eki 2026
