kursatkemalkul/autokitch/_local/claude_son_yerel/MONTAJ_ANIMASYON_KURALLARI.md

# MONTAJ ANİMASYONU KURALLARI (Kemal, 4 Eki 2026)

Amaç: animasyonu izleyen bir usta, parçayı gerçekten AYNI SIRAYLA ve AYNI YÖNTEMLE üretip birleştirebilmeli.

## 1. ÜRETİMDEN BAŞLA
1. Her sac parça önce DÜZ AÇINIM olarak görünür (lazer kesim: dış kontur + tüm delikler, kesikler, rahatlatmalar).
2. Sonra ABKANT: her büküm tek tek, gerçek sırasıyla (büküm sırası DFM'deki ile aynı), doğru yönde ve açıda katlanır.
3. PEM somun/saplama varsa bükümden ÖNCE ya da sonra (gerçek sıraya göre) kendi deliğine preslenir.
4. Profiller (kutu, köşebent, ray) kesim boyunda gelir; delikleri görünür.

## 2. BİRLEŞTİRME GERÇEK OLMALI
5. Hiçbir parça "sihirle" birleşmez. Her birleşim gerçek bir yöntemle gösterilir:
   - **Vida/cıvata:** her vida tek tek, kendi deliğine kendi ekseninde girer; pul ve somun varsa onlar da. Vidanın boyu ve dişi doğru (ucu karşı parçadan taşmaz, diş boyu yeterli).
   - **Perçin / perçin somun:** deliğe girer, sıkılır (başı oturur).
   - **Kaynak:** dikiş yeri birleşme anında vurgulanır (çizgi/nokta).
   - **Geçme / tırnak / kilit:** tırnak yuvasına girer, gerekiyorsa döndürülür/kaydırılır.
6. Profiller birbirine İÇ İÇE GEÇMEZ. Birleşim parçası (köşebent, bağlantı plakası, cıvata) ya da kaynak ile birleşir.
7. Her bağlantı noktası modelde GERÇEK: delik var, vida var, karşısında somun/PEM/diş var. Deliksiz vida, vidasız delik olmaz.

## 3. HAREKET KURALLARI
8. Hiçbir parça başka bir parçanın içinden geçmez (yol 2–5 mm adımlarla denetlenir).
9. Hiçbir parça yerinde belirmez. İstisna: kablolar ve kayış (kanal boyunca/kasnağa sarılarak "uzar").
10. Havada duran parça yok: her parça oturduğu anda bir şeye bağlıdır (ya da bağlantısı aynı adımda yapılır).
11. Geliş yönü gerçekçi: delikli/geçmeli parça eksen boyunca; kapalı hacme giren parça açık taraftan, o taraf kapanmadan; kapak menteşe tarafından.
12. Tezgâh alt montajı: dolap içinde kurulamayan grup tezgâhta kurulur, sonra bütün olarak yerine girer.

## 4. SIRA VE GÖSTERİM
13. Önce yazılı montaj planı (adım, parça, yön, bağlantı, açık taraf), animasyon plandan üretilir.
14. Adım metni sade Türkçe: ne, nereden, neyle bağlanıyor (ör. "Sol ray: 3 × M5×6 havşa vida ile bölme sacındaki PEM'lere").
15. O adımda birleşen parçalar ve bağlantı elemanları kısa süre vurgulanır.
16. Çevre (dolabın kendisi) silik görünür; montajı yapılan ürün tam renk.

## 5. DENETİM (yayından önce zorunlu)
17. Yol çakışması 0 · yerinde belirme 0 (istisnalar hariç) · havada 0 · son konum = model (±0,01 mm).
18. Vida/delik eşleşmesi: her vidanın deliği ve karşı dişi var; boyu taşmıyor; diş boyu ≥ 1×d (sacta PEM ile).
19. Bunlardan biri tutmazsa sayfa YAYIMLANMAZ, plan düzeltilir.
