kursatkemalkul/autokitch/otonom/onizleme-9eki/a/hat/a-montaj.html

Store›HAT›Makine v3›A montajı

← Makineye dön

# A · AÇICI — montaj sırasıv3 · üretimden montaja

A kabuğu üretimden başlayarak, B dolabının (silik) üstünde: kaide boruları kesim boyunda gelir ve TIG ile kaynaklanır; 4 mm plaka lazerden çıkar, altına PEM'ler preslenir, delik kaynağıyla borulara; damlama sacı puntalanır; A → B cıvataları Ø16 servis deliğinden; 30 × 30 iskelet ve 22 kulak kaynaklanır; 4 panel (37 sacın hepsi) düz açınımdan abkantta tek tek bükülür, PEM saplamaları preslenir, somunlar içeriden (dışta vida başı yok). Satın alınan açıcı tek ürün olarak önden girer, 4 × M8 ile kaideye. TOPPING (silik) yanına gelince 4 × ISO 4762 M8 × 10 + ISO 7092 pul A'nın içinden ve tabla rayı 4 × M6. Kapı emniyet sensörü sabit tarafta; kablosu dikme ve kaide borularının içinden B kablo kanalına iner (A iç hacmine girmez). Kapak havada çift cidar olarak kurulur, menteşe tarafından takılır. A içinden kablo / kanal geçmez.

Diğer montajlar: B · tek çekmece · TOPPING · F · E · U

Model yükleniyor…

Kamera: otomatik

◀◀❚❚▶▶ 0,0 / 0 sn

HIZ0,5×1×2×4× GÖRÜNÜMKenar çizgileri Kesit

sackapakprofilvida / cıvata / perçin / PEM (mavi)cıvata (arayüz)kaynak dikişi / punta (kırmızı, kalıcı)açıcı (tek ürün)bas-aç / silikon tapaçevre (B, TOPPING) silik

## Atölye sırası

AUTOKITCH · A montajı v3 (çekmece v3 / B v3 yöntemi: açınım → büküm → montaj, birleşim yakın planları) · model: hat3_v9l (zincir 00–44) + zincir_A_tamamla · A gövdesi h3_a_sac_v1 · v3.1 (6 Eki): A ↔ TOPPING cıvatası ana modelle eşit — M8 × 10 + ISO 7092 (zincir 48 + 55) · v3.4 (7 Eki): kapı emniyet sensörü + aktüatörü Schmersal föyü ölçüsünde yan yana (vidalı) + kablosu dikme ve kaide boruları içinden B kanalına (zincir 120–123) · yerel
