kursatkemalkul/autokitch/otonom/onizleme-9eki/b/hat/b-montaj.html

Store›HAT›Makine v3›B montajı

← Makineye dön

# B · ÇEKMECELİ SOĞUK DOLAP — montaj sırasıv4 · üretimden montaja · bağlantılar gerçek

B dolabının tamamı üretimden başlayarak: her gövde sacı kendi yaklaşma çizgisinde lazerden düz açınım olarak belirir, abkantta bükümleri tek tek yapılır, PEM ve saplamalar preslenir, sonra yerine iner. Yalıtım kesilmiş PU levhalardır: her levha tek doğru boyunca takılır, sac flanşlarının / köşebentlerin yeri levhada boşaltılmıştır, köşe boşlukları ayrı dolgu şeridiyle dolar; levhalar saca yapıştırılır (yeşil). İç saclar kenarlarından bükülen flanşlarla kör perçinlenir; dış kabuk köşebent ve punta ile (kırmızı noktalar); her cihaz, kanal, dikme ayağı ve braket kendi deliğine, kendi cıvata / saplama / somunuyla bağlanır (mavi). Renk anahtarı model penceresinin sağ üstünde.

İlk çekmecenin tam montajı (her vida, PEM, kaynak tek tek): Tek çekmece montajı →

Diğer montajlar: A · TOPPING · F · E · U

Model yükleniyor…

Kamera: otomatik

◀◀❚❚▶▶ 0,0 / 0 sn

HIZ0,5×1×2×4× GÖRÜNÜMKenar çizgileri Kesit

sacön çerçeve (430)profilvida / cıvata / perçin / PEM (mavi)kaynak dikişi / punta (kırmızı, kalıcı)PU levhamekanizma / raymotor / soğutma grubugüç kablosubilgi kablosugider hortumuköpük kapağı / PTFE takoz / kayışyapıştırıcı / silikon (yeşil)

## Atölye sırası

AUTOKITCH · B montajı v4 (ortak oynatıcı: renk anahtarı, kalıcı kırmızı kaynak / punta, yeşil yapıştırıcı) · model: ana model ?v=9t (zincir 00–51, TOPPING adım 37 v2 dahil: PU levhalar 46, bağlantı elemanları 47, iç sac flanş + perçin 49, taşıyıcı hayalet disk 51) · v4.1 (6 Eki): kaynak dikişleri gerçek ölçü — TIG Ø5 boncuk, punta Ø6 çekirdek; kenar çizgisi kırmızıyı örtmez · v4.4: A sensör kablosu geçişi tavan biriminde (rakor + PU kılıf, zincir 122) · sağ yan çentiğindeki puntalar çentik üstüne, 3. emiş penceresi köşebendin önünde (zincir 124) · 215 punta iki saca değer · yerel · v4.5 (7 Eki): dağıtık EtherCAT — kolon başına EP7342 / EP1809 kutuları + kutu kanalları (adım 16), kolon kabloları W070 / W070b / W071 / W074 / W075 / W073 / W045b fişe kadar (adım 23), yeni B panosu (adım 10), W072 yeniden (zincir 130–135)
