kursatkemalkul/autokitch/otonom/onizleme-9eki/k/hat/k-montaj.html

Store›HAT›Makine v3›K montajı

← Makineye dön

# K (kesme + sprey) — montaj sırasıv4 · her parça tek tek · vidalı / kaynaklı · yol denetimli

K istasyonu üretimden başlayarak: taban sacı, destekler, istasyon rafı ve çerçeve parça parça yerinde kaynaklanır; saclar lazerden düz açınım olarak çıkar, abkantta tek tek bükülür, PEM saplama / somunlar preslenir. Ardından itici ve bant ayakları, bant, çitler, itici X / Z eksenleri, Festo kesici silindiri, kesici kafa (bıçak seti aletsiz sökülür), yan saclar, sprey nozülü, yağ sistemi, tartı + teneke gelir. Arka sac + pano grubu tezgâhta parça parça kurulur, sonra arkadan girer. En son kanallar, kablolar, üst sac ve ön kapak. Her vida, somun, pul, pim kendi ekseninde tek tek takılır.

Diğer montajlar: A · B · tek çekmece · TOPPING · F · U · E

v4 · durum (7 Eki 04:15, yerel önizleme): 1.369 parça · 30 adım · 6.4 dk; her parça tek tek, her vida / somun / pul kendi ekseninde; saclar lazer açınımı → abkant → PEM; tezgâh grupları (sol sac + iç kanallar, kesici silindiri, kesici kafa, nozül, arka sac + pano, üst sac, ön kapak) tezgâhta parça parça kurulup yerine gelir. Tam denetim (2 mm adım, 12.645 çift): plan sorunu 0 · son konum beyansız 0 · belirme 0 · havada 0 (7 beyanlı: rakor kilit somunu, yapışkan askı, yüzer POM yüz, hortum kaplinleri — karşı parçası 1–3 s içinde gelir) · bekleyen bağlantı elemanı 0 · gerçek yol çakışması 14 (sıfır boşluklu kayma 61 ayrı sayıldı) · büküm karesi 2. AÇIK MADDELER (hepsi model / zincir 86 tasarımı; sonraki zincir adımında): 1) Yol çakışması 14: pompa ve yağ akış portalı üst pedleri portalın içine iniyor (4) · Z yükseltme vidaları rayın altından (3) · Harting taban vidaları sac yönünde, vida yönü ters (4) · PulsaJet nozülü ↔ braket saplama ucu / somunu nozül gövdesinin içinde (2) · tartı rakoru kilit somunu ↔ kanal (1). 2) Kısa yol (içeriden 40 mm, son çare): elektrik braketi 5 (üst kayıt + kulak arasından). 3) Model açığı 3: Ø12 kovanlar kare boruda deliksiz · iç kanal 2 / 3 ↔ zincir kanalı 1 ek parçası yok. 4) Büküm: ön kapak dış tava ↔ iç tava tezgâhta 2 kare. 5) Devirden: SMC şartlandırıcı braketi kulak delikleri · X silindir uç kapağı vidaları itici sacından geçiyor · K kolu ana zincire alınmadı. Model: zincir 86 düzeltildi (somun / pul gerçek kesişim denetimi; 341 eleman, açık 0; iki koşu bayt aynı SHA256 82cbb2e9…).

Model yükleniyor…

Kamera: otomatik

◀◀❚❚▶▶ 0,0 / 0 sn

HIZ0,5×1×2×4× GÖRÜNÜMKenar çizgileri Kesit

## Atölye sırası

AUTOKITCH · K montajı v4 (açınım → büküm → montaj, yol denetimli) · model: hat3_v10zf · K kolu (Codex 70–79) + zincir 86 bağlantıları · 7 Eki 2026 · YEREL
