kursatkemalkul/autokitch/_local/claude-site-20261005/held-paths/otonom/hat/topping-montaj.html

Store›HAT›Makine v3›TOPPING montajı

← Makineye dön

# TOPPING — montaj sırasıv4 · üretimden montaja

TOPPING üretimden başlayarak, B dolabının (silik) üstünde: kaide boruları kaynaklanır, plaka ve dış saclar lazerden çıkar ve abkantta tek tek bükülür. Soğuk oda yalıtımı ölçüsünde kesilmiş PU levhalar (yapıştırıcıyla dış saca); iç sac kaynaksız: bükümlü kenarlar komşu sacın arkasına girer, POM ısı kesici pullar üstünden kör perçinle bağlanır, köşeler silikonla kapanır. Evaporatörler ayaklarıyla kuru bölme tabanına vidalanır; arka servis sacı tek başına sökülür, 17 havşa vidası çökertilmiş deliklere oturur (dış yüz düz). Hazır ürünler (soğutma grubu, evaporatörler, UNO'lar, kasetler, motorlar, valf adası, X ekseni) tek parça olarak kendi açık tarafından girer.

Diğer montajlar: A · B · tek çekmece · F · E · U

Açık maddeler (Kemal: “uzatmadan bitir”): yol denetiminde kalan çakışmalar var — yalıtım levhası ile iç sacın giriş sırası (levhalarda giriş oluğu gerekir), teknik ön perde ↔ taban burçları, raf köşebentleri ↔ raf levhası, sos / harç UNO gövdesi ↔ üst raf, X ekseni ↔ yayıcılar, bazı iç kablo kanalları; kör perçin uçları ve dimple oturması beyanlı. Önemli: evaporatör ayakları servis sacındaki kablo kanalının arkasında kalıyor; servis sacı sökülürken kanal ayağa takılır (ayak öne alınmalı ya da kanal servis sacından ayrılmalı). Açıkta PU 85 nokta (çoğu büküm arkası gizli boşluk). Ayrıntı: sayfa altındaki denetim satırı.

Model yükleniyor…

Kamera: otomatik

◀◀❚❚▶▶ 0,0 / 0 sn

HIZ0,5×1×2×4× GÖRÜNÜMKenar çizgileri Kesit

## Atölye sırası

AUTOKITCH · TOPPING montajı v4 (açınım → büküm → montaj, birleşim yakın planları) · model: zincir 00–50, TOPPING gövdesi h3_topping_sac_v2 · 4 Eki 2026 · yerel
