kursatkemalkul/autokitch/_local/montaj-v87/v87_genel.png

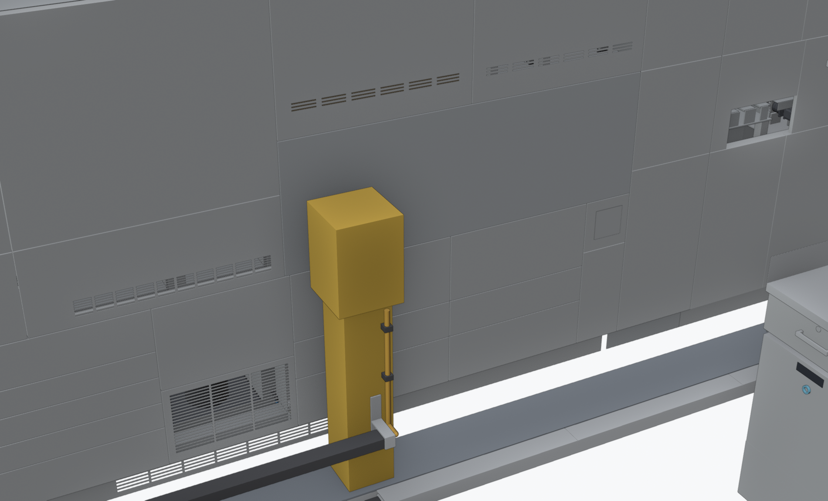
_local/montaj-v87/v87_genel.png
