kursatkemalkul/autokitch/_local/montaj-v87/v87_tezgah.png

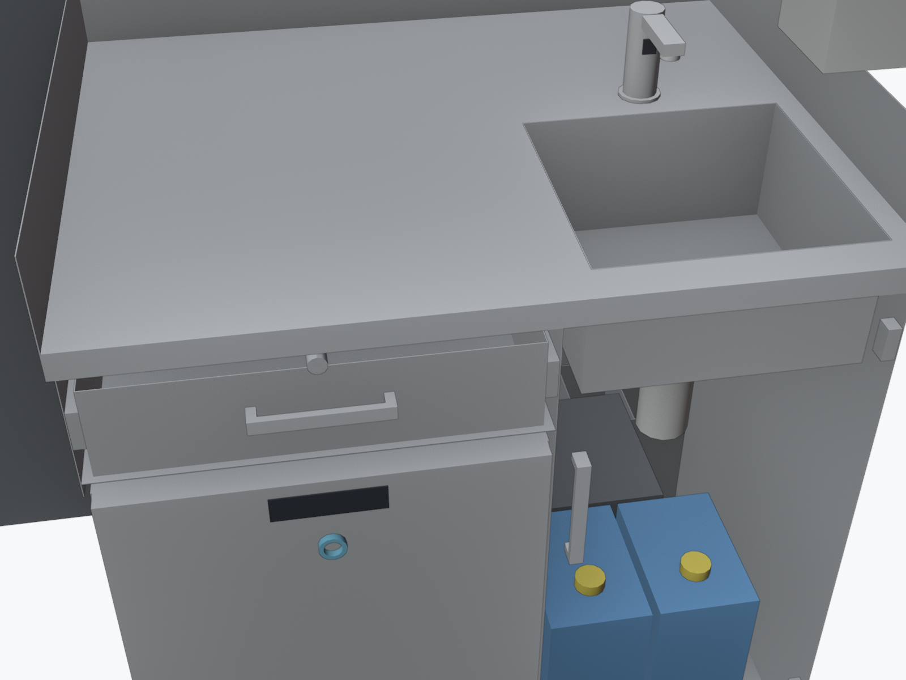
_local/montaj-v87/v87_tezgah.png
