kursatkemalkul/autokitch/arastirma/3_TOPPING/alt_montaj/L_RAF_CIFTI/L_RAF_CIFTI_asm_on.png

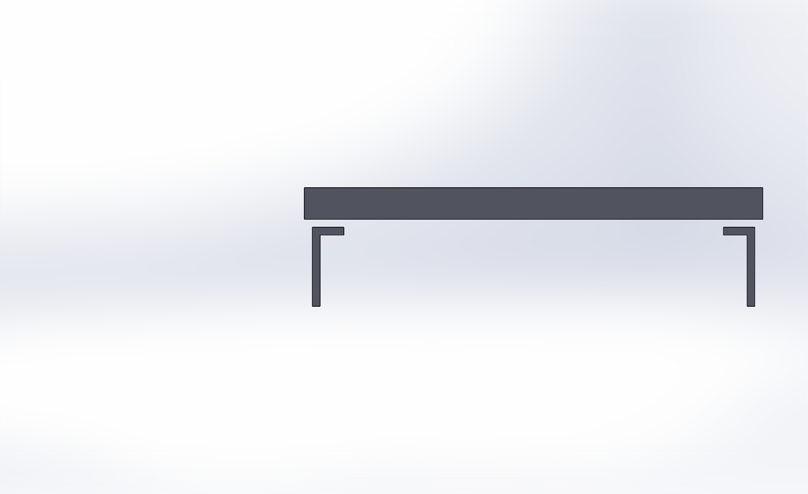
arastirma/3_TOPPING/alt_montaj/L_RAF_CIFTI/L_RAF_CIFTI_asm_on.png
