kursatkemalkul/autokitch/arastirma/3_TOPPING/alt_montaj/SOKET_MOTOR/SOKET_MOTOR_asm_iso.png

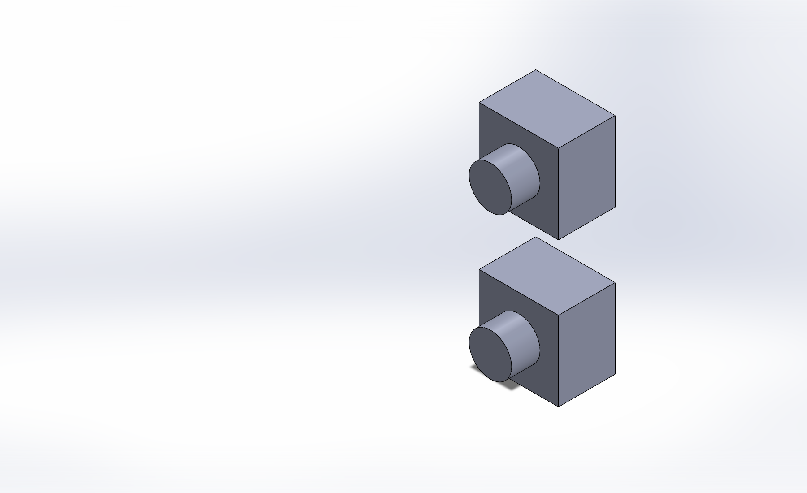
arastirma/3_TOPPING/alt_montaj/SOKET_MOTOR/SOKET_MOTOR_asm_iso.png
