kursatkemalkul/autokitch/_local/claude_son_yerel/gece2/adim3/u/arastirma/_uretec/topping_cad_v32.py

# -*- coding: utf-8 -*-
"""topping_cad_v32 (30 Eyl 2026 · YEREL · yap_topping_cad_v32.py): RAYIN ÜSTÜ TAMAMEN KAPALI — alçak kızak HIWIN MGN15H + kapalı paslanmaz ray çatısı + yandan dolanan kızak ayakları
v32: Kemal 30 Eyl "bu rayın üstü kapanmalı, arasına hamur sos küp sucuk girmemeli" → "paslanmaz örtü bandı yap / doğru olanları yap": HGH15CA (H 28) bloğun üstü plakanın
     altıydı → örtü de çatı da geçemezdi · MGN15H (H 16) → çatı bloğun üstünden geçer, ÜSTTE YARIK YOK · ayak eteğin altından dolanır (ters kap labirent) · plaka 48,5,
     tabla, disk, aktarma kotu AYNI · raylar −540…1793,5 (ek 650 / 770) · blok hatvesi 160 · uç kapakları · dönüş motoru plakaya oturdu (tekne tabanından 3 mm)
v31: topping_cad_v31 (30 Eyl 2026 · YEREL · yap_topping_cad_v31.py): EVAPORATÖR KASETİ KURU BÖLMEDE (soğutma grubunun tam üstü) · SICAK GAZLI YOĞUŞMA TAVASI · soğuk kutu topping_uno_cad_v19
v31: Kemal 30 Eyl "tamam önerdiğini yap toppinge": evaporatör soğuk odadan çıktı → kuru bölmede 40 mm PU'lu kaset, soğuk kutunun arka duvarına takılı (arka dış sac kesik,
     kutunun PU'su kasetin ön yalıtımı) · alt kanaldan emer → lamel paketi → arka baca → 2 fan → üst kanaldan tavan boyunca kapağa üfler · tahliye sifonlu, dümdüz
     aşağı → ünitenin atış havasındaki sıcak gaz döngülü tavaya · hatlar ünitenin üstünden dikine kasete (≈ 39 cm)
v30: topping_cad_v30 (29 Eyl 2026 gece · YEREL · yap_topping_cad_v30.py): SOĞUTMA GRUBU KAİDEDE (arka-alt) · TEKNİK CEP KALKTI · HAVA ÖNDEN KANATLARIN ALT BANDINDAN
v30: Kemal "soğutma grubunu alta, sağ köşedekileri kaldır, o bölüm temiz boş · dikdörtgen · eşitlik isterim": Secop CU KLF6.6CND yan çevrili, C kaidesinin 3. gözünde
     (kaide_cad_v4 cebi) · sol kanat alt bandı EMİŞ + filtre / sağ kanat ATIŞ · teknik bölme (ön perde −475 · enerji zinciri kanalı 25 öne · ayırma perdesi · kuru bölme tabanı) · pano + UPS kuru bölmenin
     üstünde (üstten servis kapağı) · ana hava rakoru kuru bölmeye (z −740) · soğuk kutu dikdörtgen + eşit kapaklar topping_uno_cad_v18
v29: topping_cad_v29 (29 Eyl 2026 · YEREL · yap_topping_cad_v29.py): TEKNİK CEP KUTUNUN ÜSTÜNDE — konsol taşıyıcılar kalktı, cihazlar TU v16 soğuk kutusunun B tavanına
(teknik taban, dünya 1578) titreşim pedleriyle oturur · Secop CU KLF4.8CND gerçek ölçü 307 × 272 × 380 · evaporatör kuru bölmeden kalktı (TU v16: yalıtımın içinde) · T kapağı 1578–1859
v28 (29 Eyl 2026 · YEREL · yap_topping_cad_v28.py): RAY CIVATALARI — HGR15 havşalarına DIN 912 M4 × 16 (delikler boş kalmaz) · başka değişiklik yok
v27 (29 Eyl 2026): BANTLI TABLA — kaset + sabit tahrik + ayarlar a, c, d, e, f (yap_topping_cad_v27.py).
v26 (28 Eyl 2026 akşam · yap_topping_cad_v26.py): AÇICI KOLONU kutu profil 120 × 50 × 4 (v25 dolu blok) · RAY ÖRTÜ ÇATISI 2 ayrı L şerit (yarık boydan boya) · başka değişiklik yok. Önceki: topping_cad_v25.py
v25 (28 Eyl 2026 gece): ÖN DÜZLEM +79 · TEMİZ KUTU (SPEC_on_duzlem_v63 §2.3) — kabuk ön kenarı +39 + ön dönüş · ön çerçeve + tava paneller (mekanizma 2 kanat,
  teknik cep T) · AÇICI ön tahriki DİK AÇILI NMRV030, kafa ön ucu +10, açıcı ≤ +39, Z ekseni ray + araba + adaptör, pnömatik DSBC-32-100 dik asılı ·
  havada parçalar bağlandı · montaj V1_TASI kaydırmaları yeni adlarla son yerinde · dünya denetimi (TU v14 + itici). Önceki: topping_cad_v24.py (yap_topping_v25.py)
v25 DÜZELTME (28 Eyl sabah · on_duzlem_v63/denetim_C.md): mekanizma kanatları 788'den (A|C basamak yok) · tava panel menteşeleri kol + taban, sanal pivot
  ön dış köşe · bas-aç mandallar simetrik (üst kayıtta) · T sol dikmesi dikey ayırma sacına 2 L köşebent · teknik cep 2 × L 30×30×3 taşıyıcı + titreşim
  takozu · T yarıkları çerçevenin önünden çekildi · eski v1 soğuk hücre / ön kapak BOM'dan çıktı · dünya denetimi: soğuk taban kaçağı, çerçeve bandı,
  5 kapak açılma taraması (flipper katlanarak), hazne dolum çekmesi, bağlantı temasları, havada beyaz listesi ≤ 0,25 mm açıklıkla
v24 (26 Eyl 2026 gece): TOPPING TEKNESİ MODÜL İÇİNDE BİTER — X motoru + tahrik kasnağı SOL uca (−560), avara + gergi SAĞ uca (1650),
  kayış kelepçeleri arabanın sol yarısına (Xc −130 · −50); tekne/kirişler −600…1795 (v23: −555…1885, F fırınına 85 mm giriyordu).
  Sağ tampon kayış koluna (1617–1629), limit+ 1647, bağlama laması 1745, kayış 4480. Sağ dış saca hava rakor deliği. Önceki: topping_cad_v23.py
AUTOKITCH · 3 · TOPPING MODÜLÜ — ÜRETİM MODELİ v1 (22 Eyl 2026)
Kemal: "bunlar niye bu kadar önde, birde arka kısımlarını o motor yerlerini — bu TOPPING'i full tasarla, üretime yönelik."

NE ÇÖZÜLDÜ
  · KASET ÖNE TAŞIYORDU: kulp z = 0'ın 48 mm önüne çıkıyordu, kabin kapanmıyordu. Kaset 80 mm içeri alındı,
    önüne yalıtımlı KAPAK kondu; kulp artık kabinin içinde (topping_hesap_v4.py · derinlik dizilimi).
  · ARKA 505 mm BOŞTU: artık KAVRAMA (40) + YALITIMLI BÖLME (65) + KURU MAKİNE BÖLMESİ (320). Motorlar soğuk hücrenin
    DIŞINDA, yalıtımın arkasında; mil bölmeden yataklı-keçeli kovanla geçiyor. Yoğuşma almıyorlar, soğutma yükü yok.
  · 12 TAHRİK (6 kaset × 2 mil): NEMA23 kapalı çevrim step + EŞ EKSENLİ planet redüktör i=10. Sonsuz vida (NMRV030)
    kullanılmadı: girişi dik olduğu için motor yana taşıyor, 140'lık kasetin arkasında komşuya giriyordu.
  · Mil eksenleri kaset üreteçlerinden OKUNUR (hardcode yok): 140 sınıfı CY 60 / YC 164 · kaşar CY 40 / YC 195.

KOORDİNAT (modül yereli): x 0..1800 soldan sağa · y 0..970 aşağıdan yukarı (makinede 1060 eklenir) · z 0 ön yüz, −830 arka.
ÇIKTI: arastirma/3_TOPPING/topping_modul_v22/ (parça başına STEP + STL, MONTAJ.step, BOM.csv) · otonom/hat3d/ (GLB/USDZ)

v2 (22 Eyl 2026): kuru bolme 200 (arkada bosluk yok) · kaset 120 geriye, onunde ON NIS ·
evaporator ve hava kanali kasetlerin ICINDEN cikarildi · meme yarigi kasetin kendi agiz olcusunden ·
cakisma taramasina KASETLER girdi. Onceki: topping_cad_v1.py
v3 (22 Eyl 2026): meme yarigi hucre on sinirina kadar acildi (kaset YUVADAN CIKMIYORDU) ·
evaporator kasetlerin ARKASINA, millerin ustune · huni bacasi pideye 40 mm kala biter ·
kaset alti bosluk 20 -> 10. Onceki: topping_cad_v2.py
v4 (22 Eyl 2026): evaporator DELIKLI SAC PERDE arkasinda bir plenumda (ticari sogutucu standardi) ·
baca bastan basa acildi (ustu kapaliydi) ve iki kademeli oldu. Onceki: topping_cad_v3.py
v5 (22 Eyl 2026): evaporator KURU BOLMEYE (motorlarin ustune), sogutma arka yalitimdaki iki bosluktan ·
baca/huni parcasi kalkti, kasetin kendi YUVARLAK borusu pideye iniyor. Onceki: topping_cad_v4.py
v6 (22 Eyl 2026): her YUVA kendi kaset CAD'ini kullaniyor (once 140/280 sinifina gore tek model
varsayiliyordu). HARC 1 ve HARC 2 artik harc_cad_v1 — duckbill valfli, Ic O25 borulu harc/sos kaseti.
v7 (22 Eyl 2026): ON CERCEVE SACI KALKTI (Kemal: "en ondeki metal anlamsiz parcayi kaldir, dis kabukta
sadece sag sol arka ust alt") · HARC yuvalari harc_cad_v2 — VIDA YOK, hortum pompali borulu nozzle.
v8 (22 Eyl 2026): DONER TABLA — x arabasi (lineer kizak + kayis) + tabla (O360, 35 dev/dk).
Nozzle sabit; tabla donerken x'te kaydigi icin agiz pide uzerinde spiral ciziyor.
v9 (22 Eyl 2026): kaset borulari yalitimin ust yuzunde bitiyor; yalitimda uzun yarik yerine TEK YUVARLAK
DELIK + icinde DOZAJ KOVANI. damlama_teknesi ve agiz_cercevesi silindi.
v10 (22 Eyl 2026): DONER TABLA TAM URETIM MODELI — tekne + kiris merdiveni + HGR15 raylar + 4 blok +
araba plakasi + doner yatak + ayar bilezigi + gobek + tabla + pancake motor + lokma + GT3 kayis
zinciri + apron + cati + kirinti cekmecesi + enerji zinciri + 5 sensor + tamponlar. Ray yarigi kalkti.
"""
import csv, io, json, math, os, re, sys, time
import cadquery as cq

U = os.path.dirname(os.path.abspath(__file__)); KOK = os.path.dirname(os.path.dirname(U)); sys.path.insert(0, U)
URETIM = None   # v24/v23: üretim klasörü YOK (kural 6.7)
XK_SOL, XK_SAG = -560.0, 1678.4   # v27: avara + gergi braketi +28,4 (aktarma +28,4 → kayış kolu brakete 130 mm³ giriyordu; tampon yine kolun 10 mm önünde)   # v24: X kayışı kasnak merkezleri (motor SOLDA, avara SAĞDA) — H.KAYIS_SOL/SAG yerine
# ---- v25 · ÖN DÜZLEM (SPEC_on_duzlem_v63) ----
Z_ON = 79.0                        # ön düzlem = fırın ön yüzü (montaj sözleşmesi Z_ON = FT.ZS)
Z_KABUK = 39.0                     # dış kabuk (taban, tavan, yan saclar) ön kenarı = soğuk kapak arkası
Z_CER_C = (39.0, 59.0)             # C ön çerçevesi 30 × 20 × 2 (tava panellerin arkası)
Z_PAN_C = (59.0, 79.0)             # tava panel: yüz 1,5 (+77,5…+79) + 20 dönüş
DERZ = 3.0
DX_D, DY_D = 700.0, 892.0          # TC yerel → dünya (montaj: x + 700 · y + 892)
TU_DOSYA = os.environ.get("TOPPING_TU", "topping_uno_cad_v19.py")   # v31: evaporatör kuru bölmede (arka duvarda 2 kanal + kaset yuvası)   # v30: dikdörtgen soğuk kutu + eşit kapaklar        # dünya denetiminde soğuk paket (montaj: spec_from_file_location, bir kez −168)
ITICI_MOD = os.environ.get("TOPPING_ITICI", "itici_cad_v5")
RAKOR_ACICI = ((1472.0 - 892.0, -700.0), (1460.0 - 892.0, -712.0))       # sol yan sac · açıcı hattı 2 × Ø6 (TU v14 hava_hatti_acici_D6_1/2)
RAKOR_ANA = (1809.0 - 892.0, -740.0)   # v30: KURU BÖLMEYE (teknik cep yok · v25–v29 z −432)                                      # sağ yan sac · montaj ANA_V44 (dünya y 1809, z −432)
MEK_PAN_Y0 = 788.0                 # v25b · mekanizma kanatlarının alt kenarı = A alt paneli (dolap önü 785 + derz 3 · A|C birleşiminde basamak yok — A ajanı / denetçi 3)
ON_PANELLER = {"onyuz_mekanizma_kanadi_sol": (701.5, 1597.75, MEK_PAN_Y0, 1107.5), "onyuz_mekanizma_kanadi_sag": (1600.75, 2497.0, MEK_PAN_Y0, 1107.5)}   # v30: T kapağı KALKTI (teknik cep yok · K2 tavana kadar, topping_uno_cad_v18)          # v29: T kapağı teknik tabandan (TU v16)          # v25b · tava paneller DÜNYA x0, x1, y0, y1 (pafta / montaj buradan okusun)
T_YARIK_Y = (720.0, 860.0)          # v29: giriş yarıkları T alt kaydının (686–716) üstünde          # v25b · T lazer yarık bantlarının ilk sırası (yerel y · giriş / çıkış; v25: 690 / 870 → çerçeve kayıtlarının arkasında kalıyordu)
PAN_DON = {"onyuz_mekanizma_kanadi_sol": (701.5, "sol"), "onyuz_mekanizma_kanadi_sag": (2497.0, "sag")}   # dünya menteşe kenarı
# v30 · SOĞUTMA GRUBU KAİDEDE (Kemal 29 Eyl gece): Secop CU KLF6.6CND 307 × 272 × 380 YAN ÇEVRİLİ (380 x boyunca · kondenser + fan SOL uçta → hava soldan girer,
#       sağdan çıkar — ünite yönü soğutmacı firmayla doğrulanacak) · C kaidesinin 3. arka gözünde (kaide_cad_v4 cebi) · tepsi + askılar TC tabanına · DÜNYA ölçüleri
CU_X, CU_Y, CU_Z = (1633.0, 2013.0), (815.0, 1087.0), (-785.0, -478.0)            # 380 × 272 × 307 · taban sacının (893,5) 78,5 altına gömülü · üstü soğuk kutuya 22
CU_PED, CU_TEPSI_Y = 6.0, (806.0, 809.0)                                           # Ø40 × 6 titreşim pedi · tepsi 3 mm (B tavanına 806 − 788 = 18 mm hava)
CU_CEP = (1628.0, 2095.0, -790.0, -477.0)                                          # taban + kaide plakası kesiği: ünite + 5 (1628–2018) · sağında ATIŞ boşluğu (2018–2095) · önü perdenin arkasında
AYIRMA_X = 1631.5                                                                  # hava ayırma perdesi (ünitenin sol yüzü) · solu EMİŞ, sağı ATIŞ
TB_PERDE_Z, TB_X1 = -475.0, 2420.0                                                 # teknik bölme ön perdesi = enerji zinciri kanalının arka yüzü (kanal 25 öne: −475…−415) · sağ perde (sabit tahrik x ≥ 2434 dışarıda)
EZK_Z = (-475.0, -415.0)                                                           # v30 · enerji zinciri kanalı (v25–v29 −500…−440 → ünitenin önüne 22 mm giriyordu) · mekanizma teknesinin arka kenarına dayalı
TABAN_EMIS = ((745.0, 1129.0), (1179.0, 1575.0)); TABAN_ATIS = ((2145.0, 2415.0),); TABAN_Z = (-785.0, -480.0)   # taban hava açıklıkları (kaide 1., 2. / 4. arka göz · ön perdenin arkasında)
KAIDE_PENCERE_X = {"emis": ((750.0, 1124.0), (1184.0, 1570.0)), "atis": ((1630.0, 2090.0), (2150.0, 2450.0))}   # = kaide_cad_v4.C_PENCERE_X (dünya denetiminde karşılaştırılır)
KAIDE_PENCERE_Y = (800.0, 866.0)                                                   # = kaide_cad_v4.C_PENCERE_Y
IZGARA_Y = [826.0 + 9.0 * i_ for i_ in range(7)]                                   # mekanizma kanatlarının alt bandı: 7 sıra × 6 (dünya y 826–886 · alt kaydın 821 üstü, kaide 888 altı)
IZGARA_X = {"sol": [750.0 + 70.0 * i_ for i_ in range(10)], "sag": [1758.5 + 70.0 * i_ for i_ in range(10)]}   # 10 × 60 · derze simetrik (sol 750–1440 · sağ 1758,5–2448,5)
KLF66 = {32: 499.0, 35: 480.0, 38: 460.0, 40: 446.0}                               # W @ −10 °C · Secop föy (sogutma_topping_v1 SECOP_LISTE 314H6003, 35 / 40 doğrusal)
GEREKEN_DIK = {32: 340.0, 35: 368.0, 38: 393.0, 40: 410.0}                         # W · dikdörtgen kutu, dolum + ılık gün (dikdortgen_sogutma_v1 = sogutma_topping_v1 yöntemi, TU v16/v18 geometrisi)

# v31 · EVAPORATÖR KASETİ (Kemal 30 Eyl: "tamam önerdiğini yap"): soğuk odadaki evaporatör (TU v18) → KURU BÖLMEDE, soğutma grubunun TAM ÜSTÜNDE · DÜNYA ölçüleri
#       yer: pano (x ≤ 1450) ile DIN plakası (x ≥ 2020) arası · hava hattının (y ≤ 1467) üstü · servis kapağının (y 1860,5) altı · grup x 1633–2013 tam altında
KSET = dict(x=(1470.0, 2010.0), y=(1473.0, 1855.0), z=(-826.0, -630.0))            # dış zarf 540 × 382 × 196 (önü kutunun arka duvarında: TU v19 KASET_KESIK 1492–1988 × 1495–1833)
KSET_CER = 10.0                                                                     # POM-C ısı kesici çerçeve (z −640…−630): sacların ön kenarı buna, çerçeve kutunun arka dış sacına + ABS yüzüne basar (conta dudağı)
KSET_DIS, KSET_PU, KSET_IC = 1.0, 40.0, 1.0                                         # dış sac 304 1,0 · PU 40 (λ 0,022 · 40 kg/m³) · iç sac 304 1,0
KSET_BOS = (1512.0, 1968.0, 1515.0, 1813.0, -784.0, -630.0)                         # iç boşluk (ön yüzü kutunun ABS yüzü · TU v19 arka_duvar_kaset_yuzu)
KSET_BOBIN = (1513.0, 1910.0, 1533.0, 1670.0, -731.0, -646.0)                       # lamel paketi (hava öne→arkaya, z boyunca 85) · ön aralık 16 · arka baca 53 · sağında kollektör bölmesi
KSET_ARA_Y = (1670.0, 1671.5)                                                       # ara sac: alt bölge (dönüş + bobin) | üst bölge (fanlar + üfleme)
KSET_KOL_X = (1910.0, 1911.5)                                                       # kollektör ayırma sacı (dağıtıcı + genleşme valfi bölmesi hava yolunun dışında)
KSET_FAN_Z = (-701.5, -700.0)                                                       # fan plakası: önü üfleme odası (−700…−630), arkası emiş odası (−784…−701,5)
KSET_TAVA = (1513.0, 1910.0, 1515.0, 1533.0, -783.0, -631.0)                        # damlama tavası 304 1,0 (bobin + baca altı) · çıkış sağ-arka köşe
KSET_TAHLIYE = [(1895.0, 1515.0, -775.0), (1895.0, 1440.0, -775.0), (1895.0, 1440.0, -805.0), (1895.0, 1462.0, -805.0), (1895.0, 1462.0, -815.0),
                (1895.0, 1115.0, -815.0), (2120.0, 1115.0, -815.0), (2120.0, 950.0, -815.0), (2120.0, 950.0, -770.0), (2120.0, 940.0, -770.0)]   # Ø8 · sifon 1440 → 1462 (22 mm su) · uç yoğuşma tavasının üstünde (hava boşluklu)
KSET_HAT = {"sogutma_emis_hatti": (1950.0, -700.0, 15.5, 6.35), "sogutma_sivi_hatti": (1928.0, -700.0, 3.175, 3.175)}   # x, z, dış r (emiş Cu Ø12,7 + Armaflex 9), çıplak Cu r
KSET_HAT_Y = (1087.0, 1473.0, 1540.0)                                               # ünitenin üstü · kasetin altı (POM geçiş bloğu) · kollektör bölmesi (dağıtıcı / TXV zarfı altı)
YT = (2098.0, 2142.0, 893.5, 933.5, -780.0, -490.0)                                 # yoğuşma tavası (teknik bölme, ünitenin ATIŞ havasında · cep kenarı 2095 ↔ taban açıklığı 2145 arası dolu sac)
SICAK_GAZ = [(2013.0, 980.0, -700.0), (2120.0, 980.0, -700.0), (2120.0, 905.0, -700.0), (2120.0, 905.0, -560.0), (2120.0, 980.0, -560.0), (2013.0, 980.0, -560.0)]   # Cu Ø6,35 basma hattı döngüsü
# v31 · FANLAR (katalog ölçüsüyle; STEP indirilmedi) · hava debisi + kanal hızları + bobin UA denetimi dünya denetiminde
FAN = dict(ad="Sanyo Denki San Ace 120W", kod="9WPA1224P4G001", a=120.0, t=25.0, r_bogaz=57.5, r_gobek=21.0, merkez=((1620.0, 1742.0), (1800.0, 1742.0)),
           q_serbest=198.0, q_isletme=110.0, p_isletme=40.0, P=7.4,
           kaynak="Sanyo Denki TR59 (05-2025) s. 11–13: IP68 · 24 V · 6,0 W · 4250 d/dk · 198 m³/h serbest · 135 Pa · −20…+70 °C · PWM hız girişi · 240 g")
#       işletme: tam hızda ≈ 130–145 m³/h @ 55–60 Pa (eğri okuması ±%15) · sistem ≈ 55 Pa @ 2 × 130 → %85 hızda 2 × 110 m³/h @ ≈ 40 Pa (fan yasaları: Q ∝ n, p ∝ n², P ∝ n³ → 2 × 3,7 W)
BOBIN_ALAN_YOG = 400.0                                                              # m²/m³ · lamel adımı 4,5 mm (ASHRAE 2018 Refr. Ch. 14: 0 °C altı yüzey 4–8 mm), Ø9,52 boru (dış yüzey yoğunluğu, [V] — soğutmacı firma kesinleştirir)
U_BOBIN = (25.0, 35.0)                                                              # W/m²K · küçük dolap evaporatörü, ıslak, 1–2 m/s (dış yüzeye göre, [V]; kıyas: Kelvion Küba FMA 011D 1,2 m² · 85 m³/h)
FAN_EV_ESKI = 10.0                                                                  # W · GEREKEN_DIK içindeki fan ısısı varsayımı (sogutma_topping_v1 FAN_EV)
YOGUSMA_GUN = 576.0                                                                 # g/gün · kapak açılışı + dolum (sogutma_topping_v1 · S2 dolum günü) + defrost suyu
EK_T_KURU = 8.0                                                                     # K · kuru bölme ortamın üstünde (sogutma_topping_v1 varsayımı)
EK_PSI = 0.03                                                                       # W/mK · POM ısı kesici çerçeve (sac ön kenarları ↔ soğuk iç), [V]


def ek_kaset(t_ortam):
    """v31 · kasetin getirdiği EK ısı (W) · ortam t_ortam °C: 5 yüz U·A·ΔT (h dış 10 · PU 40 · h iç 20) + çerçeve ψ·L·ΔT − kasetin örttüğü duvarın artık kaybetmediği
    ısı (kutu duvarı U 0,36 · kesik alanı) + (fan gücü − eski varsayım 10 W) · kaset içi ≈ 0 °C · oda +3 °C"""
    (x0, x1), (y0, y1), (z0, z1) = KSET["x"], KSET["y"], KSET["z"]
    a_, b_, c_ = (x1 - x0) / 1000.0, (y1 - y0) / 1000.0, (z1 - KSET_CER - z0) / 1000.0
    A = 2.0 * a_ * c_ + 2.0 * b_ * c_ + a_ * b_
    U_ = 1.0 / (1.0 / 10.0 + KSET_PU / 1000.0 / 0.022 + 1.0 / 20.0)
    dT = t_ortam + EK_T_KURU - 0.0
    L_ = 2.0 * ((KSET_BOS[1] - KSET_BOS[0]) + (KSET_BOS[3] - KSET_BOS[2])) / 1000.0
    U_duv = 1.0 / (1.0 / 10.0 + 0.0575 / 0.022 + 1.0 / 20.0)
    A_kesik = (1988.0 - 1492.0) * (1833.0 - 1495.0) * 1e-6
    return A * U_ * dT + EK_PSI * L_ * dT - U_duv * A_kesik * (t_ortam + EK_T_KURU - 3.0) + (FAN["P"] - FAN_EV_ESKI)
# v29 (tarihçe): TEK_TABAN_D, TEK_PED = 1578.0, 6.0   # v29 · teknik cep tabanı (dünya · TU v16 Y_TEK 1746 − 168) · titreşim pedi Ø40 × 6 (v28 konsol L taşıyıcı + Ø20 × 10 takoz)
# v29 (tarihçe): CU_KLF = (860.0, 1167.0, 272.0, -40.0, -420.0)     # v29 · Secop CU KLF4.8CND: x (yerel) · yükseklik · z ön / arka (307 × 272 × 380 · sogutma_topping_v1)


def panel_don(sh, ad, aci):
    """v25b · tava panel açık konumu (DÜNYA şekli): çok kollu gizli menteşe, sanal dönme merkezi ön dış köşe (x menteşe kenarı, z +79), dikey eksen · aci derece"""
    x, yon = PAN_DON[ad.split(":")[-1]]
    return sh.rotate(cq.Vector(x, 0.0, Z_ON), cq.Vector(x, 1.0, Z_ON), -aci if yon == "sol" else aci)


def boru_y(x0, x1, z0, z1, y0, y1, t=2.0):
    """v25 · y boyunca kutu profil (uçları açık)"""
    return kut(x0, x1, y0, y1, z0, z1).cut(kut(x0 + t, x1 - t, y0 - 1.0, y1 + 1.0, z0 + t, z1 - t))


def boru_x(y0, y1, z0, z1, x0, x1, t=2.0):
    return kut(x0, x1, y0, y1, z0, z1).cut(kut(x0 - 1.0, x1 + 1.0, y0 + t, y1 - t, z0 + t, z1 - t))


def boru_z(x0, x1, y0, y1, z0, z1, t=2.0):
    return kut(x0, x1, y0, y1, z0, z1).cut(kut(x0 + t, x1 - t, y0 + t, y1 - t, min(z0, z1) - 1.0, max(z0, z1) + 1.0))


def omega_pz(x0, x1, yc, zt, yon, h=15.0, t=1.0):
    """v25 · x boyunca omega takviye 40 (10 + 20 + 10) · flanşlar z = zt yüzeyine oturur, tepe yon yönünde h (acici_kabin_cad_v1 ile aynı)"""
    lo = lambda a, b: (min(a, b), max(a, b))
    za, zb = zt, zt + yon * h
    w = kut(x0, x1, yc - 20.0, yc - 10.0, *lo(zt, zt + yon * t)).union(kut(x0, x1, yc + 10.0, yc + 20.0, *lo(zt, zt + yon * t)))
    w = w.union(kut(x0, x1, yc - 10.0, yc - 10.0 + t, *lo(za, zb))).union(kut(x0, x1, yc + 10.0 - t, yc + 10.0, *lo(za, zb)))
    return w.union(kut(x0, x1, yc - 10.0, yc + 10.0, *lo(zb, zb - yon * t)))


def tava(x0, x1, y0, y1, yariklar=()):
    """v25 · tava panel: yüz 304 fırçalı 1,5 (z +77,5…+79) + 4 kenar 20 arkaya bükülü (z +59…+77,5) · yariklar: (x0, x1, y0, y1) lazer kesik"""
    zy = Z_ON - 1.5
    w = kut(x0, x1, y0, y1, zy, Z_ON)
    for a, b, c, e in ((x0, x0 + 1.5, y0, y1), (x1 - 1.5, x1, y0, y1), (x0, x1, y0, y0 + 1.5), (x0, x1, y1 - 1.5, y1)):
        w = w.union(kut(a, b, c, e, Z_PAN_C[0], zy))
    for a, b, c, e in yariklar:
        w = w.cut(kut(a, b, c, e, zy - 1.0, Z_ON + 1.0))
    return w


def silx(y, z, r, x0, x1):
    """v24: x boyunca silindir"""
    return cq.Workplane("YZ", origin=(min(x0, x1), y, z)).circle(r).extrude(abs(x1 - x0))
from kaset_3d_v3 import Mesh, MM, MALZEME, doku_ad, usdz_yaz, OUT
import topping_hesap_v7 as H                                                            # v27: aktarma 1665,4 · ray 1798 · limit+ 1688 (bantlı tabla)
import bantli_tabla_montaj_v1 as BT                                                     # v27: kaset + sabit tahrik + konum pimleri (tek kaynak bantli_tabla_cad_v1)

# ---------------------------------------------------------------- SABİTLER ----------------------------------------------------------------
W, Y, D = 1800.0, 970.0, 830.0                       # modül gabarisi (pafta HAT v19: modül C)
SAC, SAC_IC, PU = 1.5, 1.0, 60.0                     # dış sac · iç kabuk · poliüretan
Y0 = 1060.0                                          # modülün makinedeki taban kotu
ZK = H.Z_KASET; ZKAP = H.Z_KAPAK; ZKAV = H.Z_KAVRAMA; ZBOL = H.Z_BOLME; ZKURU = H.Z_KURU; ZNIS = H.Z_NIS
AGZ = (10.0, 120.0); BAS = (123.0, 257.0); KAS = (260.0, 620.0); TEK = (706.0, 962.0)    # yerel y zonları
# Harç kasetleri henüz tasarlanmadı; yuvası 280 (kaşar gövdesi sınıfı) ve mil eksenleri de kaşarınki VARSAYILDI.
# PAFTA DÜZELTMESİ: HAT v19'da yuva genişlikleri kaset genişliğine BİREBİR eşitti ve yuvalar bitişikti —
# kılavuz lamasına ve geçme boşluğuna yer kalmıyordu, kaset fiziksel olarak girmezdi. Yuvalar burada
# kaset + BOSLUK, aralarında BOLME kalınlığında ayırıcı olacak şekilde YENİDEN hesaplanıyor ve ortalanıyor.
BOSLUK, BOLME = 2.0, 3.0
_ADLAR = ("HARÇ 1", "HARÇ 2", "KIYMA", "KUŞBAŞI", "KAŞAR KABI", "KÜP SUCUK")
_GEN = (280, 280, 140, 140, 280, 140)
_TOP = sum(_GEN) + len(_GEN) * BOSLUK + (len(_GEN) + 1) * BOLME
_X = round(30.0 + PU + ((W - 2 * (30.0 + PU)) - _TOP) / 2.0, 1)
YUVA = []
for _ad, _g in zip(_ADLAR, _GEN):
    _X += BOLME
    YUVA.append((_ad, _X, _X + _g + BOSLUK, _g)); _X += _g + BOSLUK
_X += BOLME
# v6: sınıf değil YUVA bazlı — HARÇ yuvaları kaşarla aynı gövdeyi kullanıyor ama borusu ve valfi başka.
XC_TABLA = H.X_PARK          # tablanin CIZILDIGI yer = PARK KONUMU (acicinin alti)
KASET_CAD = {"HARÇ 1": "harc_cad_v4", "HARÇ 2": "harc_cad_v4", "KIYMA": "kiyma_cad_v9",
             "KUŞBAŞI": "kusbasi_cad_v8", "KAŞAR KABI": "kasar_cad_v14", "KÜP SUCUK": "sucuk_cad_v8"}


def boru(modul):
    """kasetin YUVARLAK çıkış borusu: iç çap, et, alt uç kotu (kaset yerel y). Taban yarığı ve
    kaset zarfı buna göre kuruluyor — sayı iki yerde yazılmasın."""
    import re
    k = io.open(os.path.join(U, modul + ".py"), encoding="utf-8").read()
    m = re.search(r"^BORU_D, BORU_ET, BORU_ALT(?:, BORU_GECIS)?\s*=\s*([\d.]+),\s*([\d.]+),\s*(-?[\d.]+)", k, re.M)
    return float(m.group(1)), float(m.group(2)), float(m.group(3))


def agiz(modul):
    """kasetin ÇIKIŞ AĞZININ kaset yerel z aralığı — meme yarığı buna göre açılır.
    v1'de yarık kasetin ön yüzünden 5 mm geride başlıyordu; ağız ise ön yüzün ÖNÜNDEYDİ,
    yani ürün yarığa denk GELMİYORDU. Artık kasetin kendi ölçüsünden okunuyor."""
    import re
    k = io.open(os.path.join(U, modul + ".py"), encoding="utf-8").read()
    g = lambda ad: float(re.search(r"^%s.*?=\s*([\d.]+)" % ad, k, re.M | re.S).group(1))
    m = re.search(r"^AG_Z0, AG_Z1, AG_X\s*=\s*([\d.]+),\s*([\d.]+)", k, re.M)
    d = re.search(r"^W, D, H\s*=\s*([\d.]+),\s*([\d.]+)", k, re.M)
    return float(m.group(1)), float(m.group(2)), float(d.group(2))


AGIZ = {a: agiz(m) for a, m in KASET_CAD.items()}
BORU = {a: boru(m) for a, m in KASET_CAD.items()}
MALZEME.setdefault("sac", dict(renk=(0.74, 0.77, 0.80, 1.0), met=0.85, ruf=0.32))
MALZEME.setdefault("pu", dict(renk=(0.93, 0.88, 0.72, 1.0), met=0.0, ruf=0.85))
MALZEME.setdefault("motor", dict(renk=(0.18, 0.19, 0.22, 1.0), met=0.5, ruf=0.45))
MALZEME.setdefault("bakir", dict(renk=(0.72, 0.45, 0.20, 1.0), met=0.9, ruf=0.35))
MALZEME.setdefault("kart", dict(renk=(0.10, 0.35, 0.22, 1.0), met=0.1, ruf=0.6))
MALZEME.setdefault("silikon", dict(renk=(0.85, 0.30, 0.20, 1.0), met=0.0, ruf=0.6))          # v25
MALZEME.setdefault("plastik", dict(renk=(0.12, 0.12, 0.13, 1.0), met=0.0, ruf=0.6))
MALZEME.setdefault("bant", dict(renk=(0.93, 0.94, 0.92, 1.0), met=0.0, ruf=0.8))         # v27: Forbo Transilon beyaz
MALZEME.setdefault("miknatis", dict(renk=(0.55, 0.57, 0.62, 1.0), met=0.9, ruf=0.35))     # v27: NdFeB (kapak altında)
MALZEME.setdefault("uhmw", dict(renk=(0.95, 0.95, 0.93, 1.0), met=0.0, ruf=0.45))


def eksen(modul):
    """kaset üretecinden mil eksenlerini OKU (iki yerde yazılmasın)"""
    s = io.open(os.path.join(U, modul + ".py"), encoding="utf-8").read()
    m = re.search(r"CY, RT, YC, RB, RF, Y_UST, Y_DOLUM = ([\d.]+), ([\d.]+), ([\d.]+)", s)
    assert m, modul + ": eksen satiri bulunamadi"
    return float(m.group(1)), float(m.group(3))

EKSEN = {a: eksen(m) for a, m in KASET_CAD.items()}


kut = lambda x0, x1, y0, y1, z0, z1: cq.Workplane("XY").box(abs(x1 - x0), abs(y1 - y0), abs(z1 - z0), centered=False).translate((min(x0, x1), min(y0, y1), min(z0, z1)))
def koni_y_t(x, z, r_ust, r_alt, y0, y1):
    """y ekseninde konik (merkezleme pimi): y0'da r_alt, y1'de r_ust"""
    if abs(r_alt - r_ust) < 0.01: return sily(x, z, r_alt, y0, y1)
    return cq.Workplane(obj=cq.Solid.makeCone(r_alt, r_ust, y1 - y0, cq.Vector(x, y0, z), cq.Vector(0, 1, 0)))


def sily(x, z, r, y0, y1): return cq.Workplane("XZ").center(x, z).circle(r).extrude(-(y1 - y0)).translate((0, y0, 0))
def silz(x, y, r, z0, z1): return cq.Workplane("XY").center(x, y).circle(r).extrude(z1 - z0).translate((0, 0, z0))
PARCALAR = []
# v11 · yuva etiketi kotlari — hat_montaj dokuyu BU kotlara yapistiriyor, iki yerde ayri sayi olmasin
ET_Y0, ET_Y1 = KAS[1] + 1.0, KAS[1] + 17.0          # kaset tavaninin (620) 1 mm ustu, 16 mm yuksek
ET_Z0, ET_Z1 = ZKAP[1] - 2.5, ZKAP[1] - 1.0        # hucrenin ON RIMINDE, on kapagin 1 mm gerisinde
# Yuvaya giren urunun adi — etiketin yazisi ve simulasyon bunu OKUR (iki yerde ayri liste olmasin)
URUN = {"HARÇ 1": "LAHMACUN HARCI", "HARÇ 2": "PİZZA SOSU", "KIYMA": "KIYMA",
        "KUŞBAŞI": "KUŞBAŞI", "KAŞAR KABI": "KAŞAR", "KÜP SUCUK": "KÜP SUCUK"}

# ======================= HIWIN GERCEK CAD (TraceParts STEP AP214) =======================
KATALOG_STEP = os.path.join(os.path.dirname(os.path.abspath(__file__)), "..", "katalog", "step", "hgh15ca.stp")
_HIWIN = {}


def hiwin():
    """HGH15CA STEP'ini bir kez yukler: araba katisi + ray kesiti.
    STEP'te ray Z'de uzuyor; bizim modelde X'te. Y ekseni etrafinda 90 derece ceviriyoruz."""
    if _HIWIN: return _HIWIN
    w = cq.importers.importStep(KATALOG_STEP)
    sol = sorted(w.val().Solids(), key=lambda s_: -s_.BoundingBox().xlen * s_.BoundingBox().ylen)
    araba = next(s_ for s_ in sol if abs(s_.BoundingBox().zlen - 61.4) < 1.0)
    ray = next(s_ for s_ in sol if abs(s_.BoundingBox().zlen - 150.0) < 1.0)
    DY = 35.5                                                   # STEP ray tabani -15 -> modelde 20,5
    _HIWIN["araba"] = araba.rotate(cq.Vector(0, 0, 0), cq.Vector(0, 1, 0), 90.0).translate(cq.Vector(0, DY, 0))
    _HIWIN["ray_ornek"] = ray.rotate(cq.Vector(0, 0, 0), cq.Vector(0, 1, 0), 90.0).translate(cq.Vector(0, DY, 0))
    return _HIWIN


def hiwin_ray(x0, x1, zc):
    """HIWIN ray KESITINI x0..x1 arasina uzatir + katalog delik desenini acar.
    Katalog (Linear_Guideway-E-1.pdf s.41): WR15 HR15 · gecme d4,5 · havsa D7,5 h5,3
    · hatve P60 · uctan E20 · civata M4x16."""
    orn = hiwin()["ray_ornek"]
    # Ornek ray 150 mm; kesitini alip X boyunca 1600 mm'ye uzatiyoruz. Delik olmayan bir
    # yerden kesiyoruz (delikler uctan 20, hatve 60 -> x=0 ortada, delik yok).
    # Kesit supurme denendi, profilin yalniz bir yuzunu aldi (ray 5,5 mm cikti, 15 olmali).
    # Ornek rayin DELIGI YOK (27.449 mm3 / 150 mm = 183 mm2 profil alani, tam katalog
    # agirligini veriyor). O yuzden 150 mm'lik ornegi uc uca EKLIYORUZ, boya kesiyoruz,
    # sonra KATALOG delik desenini kendimiz aciyoruz.
    boy = x1 - x0
    n_kopya = int(boy // 150.0) + 1
    r = orn.translate(cq.Vector(75.0, 0.0, 0.0))
    for i in range(1, n_kopya):
        r = r.fuse(orn.translate(cq.Vector(75.0 + i * 150.0, 0.0, 0.0)))
    r = r.intersect(cq.Workplane("XY").box(boy, 60.0, 60.0, centered=(False, True, True))
                    .translate(cq.Vector(0.0, 28.0, 0.0)).val())
    r = r.translate(cq.Vector(x0, 0.0, zc))
    w = cq.Workplane(obj=r)
    n = int((x1 - x0 - 40.0) // 60.0) + 1
    for i in range(n):
        xd = x0 + 20.0 + i * 60.0
        if xd > x1 - 20.0: break
        w = w.cut(sily(xd, zc, 2.25, 20.0, 36.0))               # Ø4,5 gecme
        w = w.cut(sily(xd, zc, 3.75, 30.2, 36.0))               # Ø7,5 x 5,3 havsa (ust 35,5)
    return w, n


# ======================= v32 · ALÇAK KIZAK HIWIN MGN15H + KAPALI RAY ÇATISI (Kemal 30 Eyl) =======================
# "bu rayın üstü kapanmalı, arasına hamur sos küp sucuk girmemeli" → "paslanmaz örtü bandı yap / yap işte doğru olanları"
# v31: HGH15CA (H 28) → blok üstü = araba plakası altı (y 48,5) · 36 mm yarıklı iki L şerit, blok yarıktan geçiyordu → düşen her şey raya iniyordu.
#      Örtü bandı da kapalı çatı da bloğun üstünden geçemiyordu (tabla yükselir → aktarma kotu 1000 bozulur).
# v32: MGN15H (H 16) → blok üstü 36,5 · aradaki 12 mm'de ayak tabanı 3 + çatı (1,5, 3° eğim) + boşluklar · çatının ÜSTÜNDE YARIK YOK ·
#      ayak çatının ALTINDAN yana çıkar, iç eteğin içinden iner, eteğin ALTINDAN dışarı geçip plakaya çıkar (ters kap labirent: içeri girmek için
#      yukarı doğru gitmek gerekir, düşen hiçbir şey giremez) · örtü bandının istediği kaldırma makarası, mıknatıs, gergi, sıyırıcı YOK, aşınan örtü parçası yok.
MGN = dict(ad="HIWIN MGN15HZ0HM", H=16.0, H1=4.0, W=32.0, B=25.0, C=25.0, L1=43.4, L=58.8, dis="M3 × 4", kg=0.092, C_din=6370.0, C0=9110.0, M0X=73.5, M0Y=57.82, M0Z=57.82,
           kaynak="HIWIN MG serisi katalog G99TE17-1306 s. 80 (MGN15H) + hiwin.de ürün 5-001047: H 16 · H1 4 · W 32 · B 25 · C 25 · L1 43,4 · L 58,8 · M3 × 4 · "
                  "C 6,37 kN · C0 9,11 kN · M0X 73,5 · M0Y/M0Z 57,8 N·m · 0,09 kg · kod sonu M = paslanmaz (blok, ray, bilye, tutucu)")
MGNR = dict(ad="HIWIN MGNR15R…HM", WR=15.0, HR=10.0, D=6.0, h=4.5, d=3.5, P=40.0, E=15.0, E_min=6.0, E_max=34.0, civata="DIN 912 M3 × 10", kg_m=1.06, Lmax=1960.0,
            kaynak="HIWIN MG katalog s. 80 + hiwin.de 5-001090: WR 15 · HR 10 · D 6 · h 4,5 · d 3,5 · P 40 · E 15 (uç payı 6–34) · cıvata M3 × 10 · 1,06 kg/m · tek parça ≤ 1960 mm")
Y_KIRIS = 20.5                                              # ray kirişi üstü (kaynaktan sonra frezelenir)
Y_RAY = Y_KIRIS + MGNR["HR"]                                # 30,5
Y_BLOK = (Y_KIRIS + MGN["H1"], Y_KIRIS + MGN["H"])          # 24,5 … 36,5
Y_PLAKA = 48.5                                              # araba plakası altı · v31 ile AYNI (tabla, disk, aktarma kotu değişmez)
KIZAK_DX = 80.0                                             # blok ekseni Xc ± 80 (v31 ± 100): sert duruşlarda bloklar rayın üstünde kalır
RAY2_X = (-540.0, 1793.5)                                   # v31 H.RAY_X0/X1 −500…1798: sol sert duruşta blok raydan 51 mm taşıyordu · sağ uç kiriş / tekne ucunu (1795) 3 mm aşıyordu
RAY_EK = {"on": 650.0, "arka": 770.0}                       # eşleştirilmiş ray eki (tek parça ≤ 1960) · iki rayda şaşırtmalı
X_SERT = (-395.0, 1645.4 + 30.0)                          # sert duruş (tabla ekseni): SOL −395 = limit −380 + 15 aşım (v32 tampon takozu plakaya) · SAĞ tampon 1645,4 ↔ kayış kolunun sağ ucu (Xc − 30) = 1675,4
#   v31 sol tampon (x −580, Ø20, y 43,5–63,5) plakaya −420'de değecekti ama önce APRON (y 58,5–60,5, plakadan 40 mm solda) −380'de tampona giriyordu ve −420'de kayış kelepçesi
#   X kasnağına giriyordu (v32 X süpürmesi buldu) → v32: PU takoz 20 × 9 × 15 plakanın kalınlığında (y 49–58), apron 1 mm üstünden geçer, kelepçe kasnağa 5,5 mm kalır
AYAK_DX = 20.0                                              # kızak ayağı x boyu 40
AYAK = dict(taban=(-16.0, 23.0), ic=(19.0, 23.0), kol=(19.0, 39.0), dis=(35.0, 39.0), flans=(35.0, 47.0), y_kol=(22.0, 26.0), t_taban=3.0, t_flans=4.0)   # u = s·(z − zc), s: iç yön (rayların arası)
CATI = dict(t=1.5, egim=3.0, y_alt=40.0, u_dis=(-30.0, -28.5), u_ic=(28.0, 29.5), u_ayak=-20.0, y_etek=29.0)   # dış etek kirişin dış kenarında · iç etek iç kenarından 0,5 içeride
CATI_X = (RAY2_X[0] - 1.5, 1795.0)                          # uç kapakları dahil (sağda kiriş / tekne ucu 1795)
ACICI_F = 482.0                                             # N · açıcı silindiri Festo DSBC-32 × 6 bar (π/4 · 32² · 0,6) — kafa tablaya en çok bu kadar bastırır (yük denetimi, en kötü durum)
X_HAREKETLI_P = ("kizak_blogu_", "araba_plakasi", "doner_yatak", "ayar_bilezigi", "donus_motoru", "tahrik_lokmasi", "siyirici_apron", "kayis_kolu", "kayis_kelepcesi_",
                 "tabla_home_sensoru", "tabla_home_bayragi", "x_bayragi", "kilit_burcu_", "tabla_gobegi", "calisma_diski", "disk_pimi_", "bk_", "ayar_konum_pimi_", "merkezleme_pimi_")   # = montaj ARABA + TABLA
RAY_E, RAY_CIVATA = {}, {}                                  # modul() doldurur: ray parçası uç delik payları · cıvata sayısı (denetim okur)


def x_hareketli(ad):
    return ad == "tabla" or ad.startswith(X_HAREKETLI_P)


def _us(zc):
    return -1.0 if zc > -170.0 else 1.0                     # iç yön: iki rayın arasına (tabla ekseni z −170)


def _uk(x0, x1, zc, u0, u1, y0, y1):
    s_ = _us(zc); za, zb = zc + s_ * u0, zc + s_ * u1
    return kut(x0, x1, y0, y1, min(za, zb), max(za, zb))


def mgn_ray(x0, x1, zc, x_ek):
    """MGNR15R · 15 × 10 · iki yanda bilye yolu (gösterim oluğu 2,4 × 1) · iki parça, x_ek'te EŞLEŞTİRİLMİŞ EK · her parçada uçtan E 15, hatve 40 ·
    havşa Ø6 × 4,5 + geçme Ø3,5 · DIN 912 M3 × 10 (baş havşanın dibinde, üstü ray üstünün 1,5 altında; diş kirişte, çizilmedi)"""
    r_ = None; cv_ = None; n_ = 0; E_ = []
    for a_, b_ in ((x0, x_ek), (x_ek, x1)):
        p_ = kut(a_, b_, Y_KIRIS, Y_RAY, zc - MGNR["WR"] / 2.0, zc + MGNR["WR"] / 2.0)
        for s_ in (-1.0, 1.0):
            p_ = p_.cut(kut(a_ - 1.0, b_ + 1.0, Y_RAY - 3.7, Y_RAY - 1.3, zc + s_ * MGNR["WR"] / 2.0 - 1.0, zc + s_ * MGNR["WR"] / 2.0 + 1.0))
        xd_ = a_ + MGNR["E"]; son_ = xd_
        while xd_ <= b_ - MGNR["E_min"] + 1e-6:
            p_ = p_.cut(sily(xd_, zc, MGNR["D"] / 2.0, Y_RAY - MGNR["h"], Y_RAY + 1.0)).cut(sily(xd_, zc, MGNR["d"] / 2.0, Y_KIRIS - 1.0, Y_RAY))
            _alyan = cq.Workplane("XZ").center(xd_, zc).polygon(6, 2.5 / math.cos(math.radians(30.0))).extrude(-1.5).translate((0, Y_RAY - MGNR["h"] + 3.0 - 1.5, 0))
            b2_ = sily(xd_, zc, 2.75, Y_RAY - MGNR["h"], Y_RAY - MGNR["h"] + 3.0).cut(_alyan).union(sily(xd_, zc, 1.5, Y_KIRIS, Y_RAY - MGNR["h"]))
            cv_ = b2_ if cv_ is None else cv_.union(b2_); n_ += 1; son_ = xd_
            xd_ += MGNR["P"]
        E_.append((round(MGNR["E"], 2), round(b_ - son_, 2), round(b_ - a_, 2)))
        r_ = p_ if r_ is None else r_.union(p_)
    return r_, cv_, n_, E_


def mgn_blok(xb, zc):
    """MGN15H katalog ölçüsüyle (STEP indirilmedi · HIWIN 3B dosyası gelirse aynı ölçüde yerine konur): çelik gövde L1 43,4 · iki plastik uç kapağı + conta
    (L 58,8'e tamamlar) · W 32 · H1 4 · H 16 · rayı saran kanal (tavanı ray üstüne, yanları ray yanına değer)"""
    y0, y1 = Y_BLOK; w2 = MGN["W"] / 2.0
    kanal = kut(xb - 40.0, xb + 40.0, y0 - 1.0, Y_RAY, zc - MGNR["WR"] / 2.0, zc + MGNR["WR"] / 2.0)
    g_ = kut(xb - MGN["L1"] / 2.0, xb + MGN["L1"] / 2.0, y0, y1, zc - w2, zc + w2).cut(kanal)
    uc_ = []
    for s_ in (-1.0, 1.0):
        xa_, xe_ = sorted((xb + s_ * MGN["L1"] / 2.0, xb + s_ * MGN["L"] / 2.0))
        uc_.append(kut(xa_, xe_, y0 + 0.5, y1 - 0.5, zc - w2 + 0.5, zc + w2 - 0.5).cut(kanal))
    return g_, uc_


def kizak_ayagi(xb, zc):
    """v32 · KIZAK AYAĞI · 304, 4 mm (tel erozyon), 40 mm boy · blok üstü → çatının ALTINDA iç yana → iç eteğin İÇİNDEN aşağı →
    eteğin ALTINDAN dışarı (alt kol, kirişin 1,5 üstünde) → eteğin DIŞINDA yukarı → üst flanş araba plakasının altına"""
    x0, x1 = xb - AYAK_DX, xb + AYAK_DX; A_ = AYAK; yb = Y_BLOK[1]
    a_ = _uk(x0, x1, zc, A_["taban"][0], A_["taban"][1], yb, yb + A_["t_taban"])
    a_ = a_.union(_uk(x0, x1, zc, A_["ic"][0], A_["ic"][1], A_["y_kol"][0], yb + A_["t_taban"]))
    a_ = a_.union(_uk(x0, x1, zc, A_["kol"][0], A_["kol"][1], A_["y_kol"][0], A_["y_kol"][1]))
    a_ = a_.union(_uk(x0, x1, zc, A_["dis"][0], A_["dis"][1], A_["y_kol"][0], Y_PLAKA))
    a_ = a_.union(_uk(x0, x1, zc, A_["flans"][0], A_["flans"][1], Y_PLAKA - A_["t_flans"], Y_PLAKA))
    return a_


def _cati_y(u, ust=False):
    C_ = CATI; y_ = C_["y_alt"] + (u - C_["u_dis"][1]) * math.tan(math.radians(C_["egim"]))
    return y_ + (C_["t"] / math.cos(math.radians(C_["egim"])) if ust else 0.0)


def ray_catisi(zc):
    """v32 · RAY ÇATISI · 304 1,5 tek parça bükme: kirişe vidalı ayak + dış etek + 3° dışa eğimli üst (su dışa akar, labirentten uzağa) + iç damlama eteği (y 29) ·
    ÜSTTE YARIK YOK"""
    C_ = CATI; s_ = _us(zc)
    P_ = [(C_["u_ayak"], Y_KIRIS), (C_["u_ayak"], Y_KIRIS + C_["t"]), (C_["u_dis"][1], Y_KIRIS + C_["t"]), (C_["u_dis"][1], _cati_y(C_["u_dis"][1])),
          (C_["u_ic"][0], _cati_y(C_["u_ic"][0])), (C_["u_ic"][0], C_["y_etek"]), (C_["u_ic"][1], C_["y_etek"]), (C_["u_ic"][1], _cati_y(C_["u_ic"][1], True)),
          (C_["u_dis"][0], _cati_y(C_["u_dis"][0], True)), (C_["u_dis"][0], Y_KIRIS)]
    return cq.Workplane("YZ").polyline([(y_, zc + s_ * u_) for u_, y_ in P_]).close().extrude(CATI_X[1] - CATI_X[0]).translate((CATI_X[0], 0.0, 0.0))


def ray_catisi_kapagi(zc, x0, x1):
    """v32 · çatının uç kapağı: çatının iç kesitini (etek altı dahil) kapatır"""
    C_ = CATI; s_ = _us(zc)
    P_ = [(C_["u_ayak"], Y_KIRIS), (C_["u_ic"][1], Y_KIRIS), (C_["u_ic"][1], C_["y_etek"]), (C_["u_ic"][0], C_["y_etek"]), (C_["u_ic"][0], _cati_y(C_["u_ic"][0])),
          (C_["u_dis"][1], _cati_y(C_["u_dis"][1])), (C_["u_dis"][1], Y_KIRIS + C_["t"]), (C_["u_ayak"], Y_KIRIS + C_["t"])]
    return cq.Workplane("YZ").polyline([(y_, zc + s_ * u_) for u_, y_ in P_]).close().extrude(x1 - x0).translate((x0, 0.0, 0.0))


MOTOR_STEP = os.path.join(os.path.dirname(os.path.abspath(__file__)), "..", "katalog", "step", "stp-mtr-23079.step")
GUC_STEP = os.path.join(os.path.dirname(os.path.abspath(__file__)), "..", "katalog", "step", "ndr-240-24.stp")
UPS_STEP = os.path.join(os.path.dirname(os.path.abspath(__file__)), "..", "katalog", "step", "ub10-242.stp")


def din_parca(yol, x0, y0, z0):
    """DIN ray cihazini STEP'ten alir ve bizim eksenlere oturtur.
    STEP'te: X = yukseklik, Y = ray boyunca genislik, Z = derinlik.
    Bizde:   X = makine boyu (ray yonu), Y = yukseklik, Z = derinlik.
    Z etrafinda 90 derece cevirince X<-genislik, Y<-yukseklik oluyor.
    x0,y0 = sol-alt kose; z0 = ON yuz (parca -z'ye, makinenin icine dogru uzar)."""
    # OCP bugu: cok-katili STEP Compound'ini tek hamlede dondurmek UPS'te
    # gecersiz Compound uretiyor; 18 katinin her biri tek basina gecerli. Katilari
    # ayri dondurup yeniden Compound kurunca hacim ayni ve sekil gecerli kaliyor.
    _w = cq.importers.importStep(yol).val()
    _ss = [q.rotate(cq.Vector(0, 0, 0), cq.Vector(0, 0, 1), 90.0) for q in _w.Solids()]
    sh = cq.Compound.makeCompound(_ss)
    b = sh.BoundingBox()
    _loc = cq.Location(cq.Vector(x0 - b.xmin, y0 - b.ymin, z0 - b.zmax))
    sh = cq.Compound.makeCompound([q.moved(_loc) for q in _ss])
    return cq.Workplane(obj=sh)


SURUCU_STEP = os.path.join(os.path.dirname(os.path.abspath(__file__)), "..", "katalog", "step", "stp-drv-4830.step")
_MOT = {}


def nema23():
    """STP-MTR-23079 gercek katisi (DC surum — v17'de AC surumden degistirildi).
    STEP'te: govde z -64,5..0, mil z 0..+31,6, kablo -y'de 333 mm uzuyor.
    Bizim modelde motorun mil yuzu zm'de ve govde -z'ye dogru uzuyor — ayni yonelim.
    STEP 17 kati tasiyor: govde + iki yatak gobegi + 4 baglama civatasi + kablo telleri."""
    if _MOT: return _MOT
    w = cq.importers.importStep(MOTOR_STEP)
    sol = w.val().Solids()
    # KABLO = motor zarfinin cok disina tasan katilar (teller). Govde = geri kalanin
    # hepsi (ana govde + civatalar + gobekler) — hepsi tek katiya kaynatiliyor.
    _kablolar = [x for x in sol if x.BoundingBox().ymin < -80.0]
    _govdeler = [x for x in sol if x.BoundingBox().ymin >= -80.0]
    govde = _govdeler[0]
    for x in _govdeler[1:]:
        govde = govde.fuse(x)
    kablo = _kablolar[0]
    for x in _kablolar[1:]:
        kablo = kablo.fuse(x)
    _KABLO_YON = -1.0      # yeni motorda kablo -y'ye uzuyor (eskisinde +y idi)
    # mili kes: mil redüktörün icine girer, onu redüktör temsil ediyor
    kes = cq.Workplane("XY").box(200, 300, 100, centered=(True, True, False)).val()
    _MOT["govde"] = govde.cut(kes)
    # KABLO: STEP'te DUZ 76 mm uzuyor ve bu haliyle 140'lik kasetlerde ust motora carpiyor
    # (olculdu: 3 yuvada 1.406 mm3 + fan_0'da 1.885 mm3). Iki mil arasi 104 mm, motor 57 —
    # aralik 47 mm. Gercek kablo BUKULEBILIR; modelde 25 mm'lik cikis guduguyle temsil
    # ediliyor. TASARIM KISITI: kablo motordan en cok 40 mm sonra donmeli, yani duz uclu
    # fis degil, DIRSEK KONNEKTOR ya da hemen bukulen kablo kanali gerekiyor.
    KAB = 25.0
    kb = kablo.BoundingBox()
    # v17 DUZELTME: eski motorda kablo +y'de idi, kb.ymin govdeye en yakin uctu.
    # Yeni motorda kablo -y'ye uzuyor; ayni satir kablonun UZAK ucundan 25 mm kesiyor,
    # gudukc motorun 300 mm otesinde havada kaliyordu (olculdu: y -32,8..-7,8).
    # Artik hangi yone giderse gitsin GOVDEYE YAKIN 25 mm aliniyor.
    _y0 = (kb.ymax - KAB) if kb.ymax <= 1.0 else kb.ymin
    _MOT["kablo"] = kablo.intersect(cq.Workplane("XY").box(40, KAB, 40, centered=(True, False, True))
                                    .translate(cq.Vector(0, _y0, (kb.zmin + kb.zmax) / 2)).val())
    return _MOT


def nema23_koy(xm, yy, zm):
    """motorun MIL YUZU zm'de olacak sekilde yerlestirir (govde -z'ye uzar)"""
    m = nema23()
    v = cq.Vector(xm, yy, zm)
    return (cq.Workplane(obj=m["govde"].translate(v)), cq.Workplane(obj=m["kablo"].translate(v)))


REDUKTOR_STEP = os.path.join(os.path.dirname(os.path.abspath(__file__)), "..", "katalog", "step", "pgcn23-1025.step")
_RED = {}


def suregear():
    """PGCN23-1025 gercek katisi. STEP: govde z -79..0, cikis mili 0..+24."""
    if _RED:
        return _RED
    w = cq.importers.importStep(REDUKTOR_STEP)
    # CIKIS MILINI KES: redüktörün cikis mili ile bizim "mil_*" parcamiz gercekte AYNI mil.
    # Ikisini birden koyunca ust uste biniyor (olculdu: 4.349 mm3 mil + 3.076 mm3 kovan).
    kes = cq.Workplane("XY").box(200, 200, 100, centered=(True, True, False)).val()
    _RED["tum"] = w.val().cut(kes)
    return _RED


def suregear_koy(xm, yy, z_cikis):
    """redüktörün CIKIS YUZU z_cikis'te olacak sekilde yerlestirir (govde -z'ye uzar)"""
    return cq.Workplane(obj=suregear()["tum"].translate(cq.Vector(xm, yy, z_cikis)))


YATAK_STEP = os.path.join(os.path.dirname(os.path.abspath(__file__)), "..", "katalog", "step", "xu080149.stp")
_YAT = {}


def xu080149():
    """STEP'te yatak ekseni X boyunca (x 0..22,27). Bizim tablada eksen Y (dusey),
    o yuzden Z etrafinda 90 derece ceviriyoruz: x -> y."""
    if _YAT: return _YAT
    w = cq.importers.importStep(YATAK_STEP)
    _YAT["kati"] = w.val().rotate(cq.Vector(0, 0, 0), cq.Vector(0, 0, 1), 90.0)
    return _YAT


KALKAN_V27 = ("tabla_gobegi", "tabla", "calisma_diski", "disk_pimi_A", "disk_pimi_B", "disk_pimi_C")   # v27 (e): kaset bunların yerine ayar bileziğine oturur
def TU_BORU(pts, r):
    """v31 · boru hattı (silindir + küre eklemler) · topping_uno_cad.boru ile aynı"""
    ss = []
    for a, b in zip(pts[:-1], pts[1:]):
        v = cq.Vector(*b) - cq.Vector(*a)
        if v.Length > 1e-6: ss.append(cq.Solid.makeCylinder(r, v.Length, cq.Vector(*a), v.normalized()))
    for p in pts[1:-1]: ss.append(cq.Solid.makeSphere(r, cq.Vector(*p), angleDegrees1=-90, angleDegrees2=90))
    return cq.Workplane(obj=cq.Compound.makeCompound(ss))


def ekle(ad, wp, mal, bom=None):
    if ad in KALKAN_V27: return
    PARCALAR.append(dict(ad=ad, wp=wp, mal=mal, bom=bom))


def modul():
    UFL = (W / 2.0 - 120.0, W / 2.0 + 120.0)                                   # yalıtım boşluklarının x aralığı
    UFY, DNY = (KAS[1] - 75.0, KAS[1] - 5.0), (KAS[0] + 5.0, KAS[0] + 40.0)    # üfleme (üstte) · dönüş (altta) — mil bandının dışında
    HAMUR_, TEPSI_, TABLA_ = H.HAMUR_K, H.TEPSI_K, H.TABLA_K
    hy0, hy1 = KAS[0] - H.KASET_ALTI, KAS[1] + 20.0                            # v3: kaset altı boşluk 20 → 10 (Kemal: "neden bu kadar kalın")
    zc0, zc1 = ZKAP[1], ZBOL[1]                                               # soğuk paket derinliği (−20 … −510)
    XI0, XI1 = 30.0 + PU, W - 30.0 - PU                                       # hücre iç genişliği (90 … 1710)
    MIL = []                                                                  # (x, y, kod) — 12 tahrik mili; yalıtım ve kabuk bunlara göre delinir
    for ad, x0, x1, gen in YUVA:
        for j, ey in enumerate(EKSEN[ad]):
            MIL.append(((x0 + x1) / 2.0, KAS[0] + ey, "%s_%s" % (ad.replace(" ", "_"), "helezon" if j == 0 else "rotor")))
    # Kasetin MEMESİ hücrenin tabanından geçer: her yuvanın altına yarık açılır, ürün oradan aşağıdaki dozaj bandına düşer.
    # v9: YALITIM ve İÇ KABUKTA artık uzun yarık YOK — her yuvada TEK YUVARLAK DELİK (Kemal: "yalıtımda
    # sadece bir delik olur, etrafı kapanır"). Kaset borusu y 250'de, yani yalıtımın üst yüzünde bitiyor;
    # ürünü deliğin içindeki DOZAJ KOVANI aşağı indiriyor. Yarık yalnız TABAN RAYINDA kalıyor:
    # boru y 250–260 arasında rayın içinden geçiyor, kaset çekilirken o yol açık olmalı.
    DELIK = []                                                                 # (x merkez, z merkez, delik yarıçapı)
    for ad, x0, x1, gen in YUVA:
        bd, be, _ = BORU[ad]
        a0_, a1_, dd_ = AGIZ[ad]
        DELIK.append(((x0 + x1) / 2.0, ZK[0] + ((a0_ + a1_) / 2.0 - dd_ / 2.0), bd / 2.0 + be + 1.0))
    YARIK = [(x_ - r_ - 2.0, x_ + r_ + 2.0) for x_, z_, r_ in DELIK]           # yalnız taban rayı için
    # MEME YARIĞI kasetin KENDİ ağız ölçüsünden: kaset yerel z → modül z (kaset ön yüzü ZK[0]).
    # v3 DÜZELTMESİ: yarık yalnız ağız boyundaydı (42 mm) ve kaset öne çekilince meme 6 mm sonra iç kabuğun
    # tabanına çarpıyordu — KASET YUVADAN ÇIKMIYORDU. Yarık artık hücrenin ÖN SINIRINA kadar açık;
    # meme o sınırı geçince zaten hücrenin dışında (kapak açık) oluyor.
    _a0, _a1, _dd = AGIZ["KAŞAR KABI"]
    ZY = (ZKAP[1], ZK[0] + (_a0 - _dd / 2.0) - 6.0)                           # ön sınır … ağzın arka ucu + pay

    # ---------------- 1 · DIŞ KABUK (bükme sac 1,5 · AISI 304) ----------------
    _dt = kut(0, W, 0, SAC, Z_KABUK, -D)
    for _a, _b in TABAN_EMIS + TABAN_ATIS:                                       # v30 · kaide gözlerine hava açıklıkları (teknik bölmenin altında, gıda bölgesinin DIŞINDA)
        _dt = _dt.cut(kut(_a - DX_D, _b - DX_D, -1.0, SAC + 1.0, TABAN_Z[1], TABAN_Z[0]))
    _dt = _dt.cut(kut(CU_CEP[0] - DX_D, CU_CEP[1] - DX_D, -1.0, SAC + 1.0, CU_CEP[3], CU_CEP[2]))   # v30 · soğutma grubu cebi + sağında atış
    ekle("dis_taban", _dt, "sac", bom=("Dış taban sacı", 1, "304 1,5 mm · lazer + abkant · v30: arka bantta 3 hava açıklığı + soğutma grubu cebi", "modülün tabanı, alttaki B modülüne oturur"))
    ekle("dis_tavan", kut(0, W, Y - SAC, Y, Z_KABUK, -630.0), "sac", bom=("Dış tavan sacı", 1, "304 1,5 mm · lazer + abkant", "v30: soğuk kutunun üstü (TU v18 tavanı, düz) · üstünde cihaz YOK"))
    ekle("kuru_bolme_servis_kapagi", kut(0, W, Y - SAC, Y, -630.0, -D), "sac",
         bom=("Kuru bölme servis kapağı", 1, "304 1,5 mm · 1800 × 200 · kenarları bükülü · 8 × M5 perçin somun", "v30 · pano + UPS + güç kaynağı + sürücüler + valf adası ÜSTTEN buradan · yan saclara, arka saca ve soğuk kutunun arka dış sacına oturur"))
    for s, x in (("sol", 0.0), ("sag", W - SAC)):
        # v20: tabla iki uctan da modulden CIKIYOR — solda aciciya (modul A),
        # sagda firin bandina. Iki yan sacta da tabla yuksekliginde yarik var.
        _ys = kut(x, x + SAC, SAC, Y - SAC, Z_KABUK, -D)                          # v25: ön kenar +39 (kapak arkası)
        _xd = (SAC, SAC + 30.0) if s == "sol" else (W - SAC - 30.0, W - SAC)
        _ys = _ys.union(kut(_xd[0], _xd[1], SAC, Y - SAC, Z_KABUK - SAC, Z_KABUK))   # v25: 30 mm ön dönüş (içe) — çerçeve + soğuk kapak buna basar, menteşe buna
        # DUZELTME: once iki ayri delik acilmisti (tabla 92-130 ve mekanizma 1-66);
        # arada 66-92 DOLU kaliyordu ve tam oraya DONER YATAK (58,5-80,8) ile
        # AYAR BILEZIGI (80,8-86) denk geliyordu — tabla soldaki aciciya GECEMIYORDU.
        # Artik modulun alt bandi iki uctan da TEK PARCA acik: araba plakasi,
        # yatak, bilezik, gobek, tabla ve disk serbest gecer.
        _ys = _ys.cut(kut(x - 1.0, x + SAC + 1.0, 1.0, 150.0, -510.0, 5.0))   # v23: 132 → 150 (en yüksek ürün diskte 136,5) · v25: öne +5 (disk z 0'a kadar)
        _ys = _ys.cut(kut(x - 1.0, x + SAC + 1.0, 1.0, 66.0, -510.0, -1.0))   # mekanizma gecisi
        if s == "sag":
            _ys = _ys.cut(silx(RAKOR_ANA[0], RAKOR_ANA[1], 7.0, x - 1.0, x + SAC + 1.0))   # v25: ana hat rakoru Ø14 montaj hattıyla aynı eksende (dünya y 1809 · z −432; v24 y 1832 · z −415)
        else:
            for _ry, _rz in RAKOR_ACICI:
                _ys = _ys.cut(silx(_ry, _rz, 6.0, x - 1.0, x + SAC + 1.0))       # v25: açıcı hattı rakorları Ø12 (2 × Ø6 hortum)
        ekle("dis_yan_" + s, _ys, "sac", bom=("Dış yan sac", 2, "304 1,5 mm · lazer + abkant", "komşu modüle cıvatalanır (lego birleşim)") if s == "sol" else None)
    ekle("dis_arka", kut(SAC, W - SAC, SAC, Y - SAC, -D, -D + SAC), "sac", bom=("Dış arka sac", 1, "304 1,5 mm", "kuru bölmenin arkası; kablo rakorları burada"))
    # v25 · RAKORLAR (hortum çapında iç delik, yan sacın deliğine oturur): açıcı hattı 2 × (sol) + ana hat (sağ)
    for _i, (_ry, _rz) in enumerate(RAKOR_ACICI):
        ekle("rakor_hava_acici_%d" % _i, silx(_ry, _rz, 6.0, -1.5, SAC + 1.5).cut(silx(_ry, _rz, 3.0, -2.0, SAC + 2.0)), "koyu",
             bom=("Duvar geçiş rakoru Ø6 · SMC KQ2E06-00A (bulkhead)", 2, "sol yan sacta · somunlu", "açıcı Z silindirinin 2 hattı (valf adası → A)") if _i == 0 else None)
    ekle("rakor_hava_ana", silx(RAKOR_ANA[0], RAKOR_ANA[1], 7.0, W - SAC - 1.5, W).cut(silx(RAKOR_ANA[0], RAKOR_ANA[1], 5.0, W - SAC - 2.0, W + 1.0)), "koyu",
         bom=("Duvar geçiş rakoru Ø10 · SMC KQ2E10-00A (bulkhead)", 1, "sağ yan sacta · dışı x 2500'ü geçmez", "v30: ana hat fırın üstünden TOPPING KURU BÖLMESİNE (z −740 · montaj ANA_V44)"))

    # ---------------- 2 · ÖN YÜZ AÇIK (v7) ----------------
    # Kemal: "en öndeki metal anlamsız parçayı kaldır — dış kabukta TOPPING'in ön yüzeydeki sacı yani,
    # sadece sağ sol arka üst alt." Ön çerçeve sacı zaten üç büyük açıklıkla delinmişti (robot ağzı,
    # kaset kapağı, teknik bant servisi) ve hiçbir yükü taşımıyordu. Dış kabuk artık BEŞ YÜZ:
    # taban · tavan · iki yan · arka. Ön yüzü kaset kapağı, robot ağzı çerçevesi ve teknik bant kapağı kapatıyor.

    # ---------------- 3 · SOĞUK HÜCRE: PU 60 + iç kabuk 1,0 ----------------
    PUP = (("pu_taban", 30.0, W - 30.0, hy0 - PU, hy0), ("pu_tavan", 30.0, W - 30.0, hy1, hy1 + PU),
           ("pu_sol", 30.0, 30.0 + PU, hy0, hy1), ("pu_sag", W - 30.0 - PU, W - 30.0, hy0, hy1))
    for ad, x0, x1, y0, y1 in PUP:
        w_ = kut(x0, x1, y0, y1, zc0, zc1)
        if ad == "pu_taban":
            for x_, z_, r_ in DELIK: w_ = w_.cut(sily(x_, z_, r_, y0 - 1.0, y1 + 1.0))       # v9: yuvarlak dozaj deliği
        ekle(ad, w_, "pu", bom=("PU yalıtım paneli 60 mm", 4, "poliüretan 60 · λ 0,022 W/mK", "soğuk hücreyi sarar; ısı kaybı hesabı topping_hesap_v4") if ad == "pu_taban" else None)
    arka = kut(XI0, XI1, hy0, hy1, ZBOL[0], ZBOL[1])
    for x_, y_, k_ in MIL: arka = arka.cut(silz(x_, y_, 31.0, ZBOL[0] + 1, ZBOL[1] - 1))     # 12 mil geçişi
    for _y0, _y1 in (UFY, DNY):                                                              # v5: üfleme + dönüş boşlukları
        arka = arka.cut(kut(UFL[0], UFL[1], _y0, _y1, ZBOL[0] + 1, ZBOL[1] - 1))
    ekle("pu_arka", arka, "pu", bom=("PU arka bölme paneli 60 mm", 1, "poliüretan 60", "SOĞUK / KURU ayırıcı: motorlar bunun arkasında kalır"))

    ic = kut(XI0, XI1, hy0, hy1, zc0, ZBOL[0])
    ic = ic.cut(kut(XI0 + SAC_IC, XI1 - SAC_IC, hy0 + SAC_IC, hy1 - SAC_IC, zc0 + 1, ZBOL[0] + SAC_IC))
    for x_, z_, r_ in DELIK: ic = ic.cut(sily(x_, z_, r_, hy0 - 2.0, hy0 + 3.0))            # v9: yuvarlak dozaj deliği
    for x_, y_, k_ in MIL: ic = ic.cut(silz(x_, y_, 31.0, ZBOL[0] - 1, ZBOL[0] + SAC_IC + 1))
    ekle("ic_kabuk", ic, "sac", bom=("İç kabuk (soğuk hücre)", 1, "304 1,0 mm · bükme, köşeler kaynaklı-taşlanmış", "gıda bölgesi: köşe R ≥ 6, yıkanabilir; 6 meme yarığı + 12 mil geçişi"))

    # ---------------- 4 · ÖN KAPAK ----------------
    # v15: masif blok degil GERCEK SANDVIC. Disi 1,5 mm sac kabuk, ici PU.
    # (Masif modellenince 74,4 kg cikiyordu; gercegi ~12 kg.)
    _kx0, _kx1 = 84.0, W - 84.0
    _ky0, _ky1 = KAS[0] - 26.0, KAS[1] + 26.0
    _kz0, _kz1 = ZKAP[0], ZKAP[1] + 6.0
    _dis = kut(_kx0, _kx1, _ky0, _ky1, _kz0, _kz1)
    _ic = kut(_kx0 + 1.5, _kx1 - 1.5, _ky0 + 1.5, _ky1 - 1.5,
              min(_kz0, _kz1) + 1.5, max(_kz0, _kz1) - 1.5)
    ekle("on_kapak", _dis.cut(_ic), "sac",
         bom=("Ön kapak sacı · sandviç kabuğu", 1, "1,5 mm 304 · 2 menteşe + mıknatıslı kilit", "kaset ağzını kapatır; açılınca 6 kaset önden çekilir"))
    ekle("on_kapak_pu", _ic, "pu",
         bom=("Ön kapak PU dolgusu", 1, "poliüretan köpük 40 kg/m³", "sandviçin yalıtım çekirdeği"))
    cont = kut(88.0, W - 88.0, KAS[0] - 22.0, KAS[1] + 22.0, ZKAP[1] + 6.0, ZKAP[1])
    cont = cont.cut(kut(102.0, W - 102.0, KAS[0] - 8.0, KAS[1] + 8.0, ZKAP[1] + 7.0, ZKAP[1] - 1.0))
    ekle("kapak_contasi", cont, "silikon", bom=("Kapak contası", 1, "manyetik buzdolabı contası", "kapağın arka yüzünde; yalıtım panelinin ön yüzüne basar"))
    # v25: eski kapak menteşeleri (mentese_0/1) SİLİNDİ — montajda havada görünüyorlardı (SPEC §2.3). Soğuk kapaklar topping_uno_cad_v14'te.

    # ---------------- 5 · KASET YUVALARI ----------------
    for ad, x0, x1, gen in YUVA:
        k = ad.replace(" ", "_")
        # v10: RAY YARIĞI KALKTI. Ölçüldü: taban rayı z −200…−525, yarık z −104…−174 — kesişmiyorlar,
        # yarık SIFIR malzeme kaldırıyordu. Boru rayın ÖNÜNDE iniyor, rayı hiç geçmiyor.
        ray = kut(x0 + 6.0, x1 - 6.0, KAS[0] - 4.0, KAS[0], ZK[0], ZK[1])
        ekle("ray_%s" % k, ray, "sac", bom=None)
        for i, xx in enumerate((x0 + 20.0, x1 - 30.0)):
            ekle("konum_pimi_%s_%d" % (k, i), silz(xx + 5.0, KAS[0] + 20.0, 5.0, ZKAV[0], ZKAV[0] - 12.0), "celik", bom=None)
        # v5: BACA/HUNİ PARÇASI KALKTI (Kemal: "başka parça yok, direk kasetin kendi ucu pideye yaklaşıyor").
        # Ürünü kasetin KENDİ yuvarlak borusu indiriyor; boru kaset tabanının 100 mm altına iniyor ve
        # pidenin üst yüzüne 40 mm kala bitiyor. Modülde yalnız borunun geçtiği yarık var.
    # v9 · DOZAJ KOVANI: yalıtım deliğini baştan başa geçen paslanmaz boru. Üstü kasetin borusunun
    # ucuna denk geliyor (arada 1 mm hava), altı pidenin DUSME kadar üstünde bitiyor. Yalıtımı kapatan parça bu.
    for (x_, z_, r_), (ad, x0, x1, gen) in zip(DELIK, YUVA):
        kv = sily(x_, z_, r_ - 0.2, AGZ[1] + H.DUSME, hy0)                 # üstü iç kabuğun ALT yüzünde biter
        kv = kv.cut(sily(x_, z_, r_ - 1.4, AGZ[1] + H.DUSME - 1.0, hy0 + 1.0))
        ekle("dozaj_kovani_%s" % ad.replace(" ", "_"), kv, "sac", bom=None)
    # v11 · YUVA ETİKET PLAKASI: ürün adı KASETE değil MAKİNEYE yazılıyor. Kaset gövdeleri ortak
    # (ORTAK GÖVDE 140), ayırt eden şey içindeki vida — o yüzden "bu yuvaya ne girer" bilgisi yuvanın
    # kendisine ait. Plaka iç kabuğun ön rimine, kasetin ÜSTÜNE oturuyor; kaset takılıyken de okunur.
    for ad, x0, x1, gen in YUVA:
        pl = kut(x0 + 15.0, x1 - 15.0, ET_Y0, ET_Y1, ET_Z0, ET_Z1)
        ekle("yuva_etiketi_%s" % ad.replace(" ", "_"), pl, "sac", bom=None)
    for a_, ad_, n_, malz_, gor_ in (("_bom_yuva_etiket", "Yuva etiket plakası", 6,
            "304 1,5 mm · baskılı ya da lazer kazıma", "ürün adı yuvanın üstünde; kaset gövdeleri ortak olduğu için ürün bilgisi makinede durur"),):
        ekle(a_, kut(0, 0.1, 0, 0.1, 0, -0.1), "sac", bom=(ad_, n_, malz_, gor_))
    for a_, ad_, n_, malz_, gor_ in (("_bom_kovan", "Dozaj kovanı", 6, "304 boru 1,2 mm · iç kabuğa kaynaklı", "yalıtım deliğini baştan başa geçer; kasetin borusu üstüne oturur, ürünü pidenin %.0f mm üstüne indirir" % H.DUSME),):
        ekle(a_, kut(0, 0.1, 0, 0.1, 0, -0.1), "sac", bom=(ad_, n_, malz_, gor_))

    for i, xx in enumerate([YUVA[0][1] - BOLME] + [y[2] for y in YUVA]):
        ekle("bolme_%d" % i, kut(xx, xx + BOLME, KAS[0], KAS[0] + 60.0, ZK[0], ZK[1]), "sac", bom=None)
    for a_, ad_, n_, malz_, gor_ in (("_bom_kilavuz", "Yuva ayırıcı lama 3 × 60 × 325", 7, "304 lama, iç kabuğa kaynaklı", "kasetin iki yanını kılavuzlar; kaset ile arasında 2 mm boşluk"),
                                     ("_bom_ray", "Taban rayı", 6, "304 bükme, meme yarığı açık", "kaset üstünde kayar; altındaki yarıktan meme geçer"),
                                     ("_bom_pim", "Konum pimi Ø10", 12, "304 taşlanmış", "kaset arkada iki pimle merkezlenir → kavrama hizalanır"),
                                     ("_bom_huni", "— (baca parçası kalktı)", 0, "kasetin kendi borusu", "ürünü kasetin yuvarlak çıkış borusu pide üstüne %.0f mm kala indiriyor" % H.DUSME)):
        ekle(a_, kut(0, 0.1, 0, 0.1, 0, -0.1), "sac", bom=(ad_, n_, malz_, gor_))

    # ---------------- 6 · TAHRİK ×12 (kuru bölmede) ----------------
    R = H.S["tahrik"]; MO, RE, YA, KE = R["motor"], R["reduktor"], R["yatak"], R["kece"]
    for xm, yy, k in MIL:
        sok = silz(xm, yy, 22.0, ZKAV[0], ZKAV[0] - 26.0)
        sok = sok.cut(kut(xm - 19, xm + 19, yy - 3, yy + 3, ZKAV[0] + 1, ZKAV[0] - 20.0)).cut(kut(xm - 3, xm + 3, yy - 19, yy + 19, ZKAV[0] + 1, ZKAV[0] - 20.0))
        ekle("soket_" + k, sok, "pom", bom=None)
        ekle("yay_" + k, silz(xm, yy, 16.0, ZKAV[0] - 26.0, ZKAV[1]).cut(silz(xm, yy, 12.0, ZKAV[0] - 27.0, ZKAV[1] - 1.0)), "celik", bom=None)
        ekle("mil_" + k, silz(xm, yy, 11.0, ZKAV[1], ZBOL[1] - 40.0), "celik", bom=None)
        kov = silz(xm, yy, 30.0, ZBOL[0], ZBOL[1] - 18.0)
        kov = kov.cut(silz(xm, yy, YA["cap_dis"] / 2, ZBOL[0] - 1, ZBOL[0] + YA["z"]))
        kov = kov.cut(silz(xm, yy, KE["cap_dis"] / 2, ZBOL[1] - 18.0 - KE["z"], ZBOL[1] - 17.0))
        kov = kov.cut(silz(xm, yy, 11.2, ZBOL[0] + 1, ZBOL[1] - 19.0))
        ekle("kovan_" + k, kov, "pom", bom=None)
        # Mil gudugu koddaki 42 mm'den TASARIM degeri olan 40 mm'ye cekildi; gercek 79 mm'lik
        # redüktörle motor arka saci 0,5 mm deliyordu. 40 ile deliyor degil ama arkada
        # YALNIZ 1,5 mm kaliyor — servis bosluğu yok. Karar Kemal'de (asagidaki BOM notu).
        ekle("reduktor_" + k, suregear_koy(xm, yy, ZBOL[1] - 40.0), "motor", bom=None)
        zm = ZBOL[1] - 40.0 - 79.0 - 2.0                 # GERCEK redüktör boyu 79 mm (hesapta 60 varsayilmisti)
        _g, _kb = nema23_koy(xm, yy, zm)
        ekle("motor_" + k, _g, "motor", bom=None)
        ekle("motor_kablosu_" + k, _kb, "koyu", bom=None)
    for a_, ad_, n_, malz_, gor_ in (("_bom_soket", "Yaylı haç soketi", 12, "POM-C + paslanmaz yay", "kaset takılınca haç kavramaya oturur; yay kursu 14 mm, diş kaçarsa kaset zorlanmaz"),
                                     ("_bom_mil", "Tahrik mili Ø22", 12, "AISI 304 taşlanmış", "yalıtımlı bölmeden geçer; soğuk tarafta soket, kuru tarafta redüktör"),
                                     ("_bom_kovan", "Yataklı-keçeli kovan", 12, "POM-C gövde + yatak ×2 + keçe 22×35×7", "mili bölmeden SIZDIRMAZ geçirir; soğuk hücreye nem girmez"),
                                     ("_bom_red", "Planet redüktör i = 10", 12, "PLF60/PLE60 sınıfı · eş eksenli", "sonsuz vida DEĞİL: girişi dik olduğu için motor yana taşıyordu"),
                                     ("_bom_motor", "AutomationDirect STP-MTR-23079 · NEMA23 · 1,95 N·m tutma · 2,8 A · DC · IP40 (GERÇEK CAD)", 12, "sürücüsüyle birlikte", "dozaj = mil açısı; kapalı çevrim adım kaçırmayı yakalar")):
        ekle(a_, kut(0, 0.1, 0, 0.1, 0, -0.1), "celik", bom=(ad_, n_, malz_, gor_))

    # ---------------- 7 · SOĞUTMA ----------------
    # v5 · SOĞUTMA PAKETİ KURU BÖLMEYE (Kemal: "standart versiyonunu bul, MOTORLARIN OLDUĞU YERE koy,
    # sonra içeriye soğuğu verecek şekilde YALITIMA BOŞLUK AÇ, içeri gitsin hava").
    # Hücrenin içinde artık hiçbir soğutma parçası yok. Fanlı evaporatör (unit cooler) kuru bölmede,
    # motorların üstünde duruyor; soğuk havayı arka yalıtımdaki ÜFLEME boşluğundan kavrama bölmesine basıyor,
    # oradan delikli perde hücreye yayıyor, dönüş yine yalıtımdaki alt boşluktan evaporatöre geliyor.
    # ÖLÇÜ: 400 × 180 × 190 (lamel paketi 140 + fan 50) — ticari sınıfın en küçük fanlı evaporatörü [V: yükümüz %.0f W, katalogdaki en küçük
    # unit cooler bile 300–500 W verir; kesin model seçilmedi]. Motorlar y 271–484'te, evaporatör 500'den başlıyor.
    EVX = (W / 2.0 - 200.0, W / 2.0 + 200.0)
    EVY = (500.0, 680.0)
    EVZ = (ZKURU[0] - 5.0, ZKURU[0] - 145.0)                                   # lamel paketi 140; fan arkasında 50
    # v29 · EVAPORATÖR + FAN + 4 AYAK KURU BÖLMEDEN KALKTI: yalıtımın dışındaydı (+134 W, kuru bölmede yoğuşma · sogutma_topping_v1) → topping_uno_cad_v16
    #       soğuk odanın İÇİNDE (A tavanı, SOS haznesinin üstü), hatlar L duvarından teknik cepteki yoğuşma ünitesine · EVX / EVY yalnız eski hava perdesi (montaj dışı) için
    # v4 · HAVA PERDESİ (Kemal: "iceriye havayi vermiyor mu, kesikler aciliyor sacda — standardi bu degil mi").
    # Ticari soğutucu düzeni: evaporatör + fanlar arka bölmede bir PLENUM'un içinde, önlerinde delikli sac perde.
    # ÜST sıra kesiklerden soğuk hava hücreye basılır, ALT sıra kesiklerden (millerin altından) geri emilir.
    # Ayrı "hava kanalı saci" kalktı — perde onun işini yapıyor ve evaporatörü de gözden gizliyor.
    PZ0, PZ1 = ZKAV[0] - 1.0, ZKAV[0] - 2.5                                    # 1,5 mm perde sacı
    perde = kut(XI0 + SAC_IC, XI1 - SAC_IC, KAS[0], KAS[1], PZ0, PZ1)
    for x_, y_, k_ in MIL:                                                     # 12 mil/soket geçişi
        perde = perde.cut(silz(x_, y_, 25.0, PZ0 + 1.0, PZ1 - 1.0))
    for ad, x0_, x1_, gen_ in YUVA:                                            # 12 konum pimi geçişi
        for px in (x0_ + 25.0, x1_ - 25.0):
            perde = perde.cut(silz(px, KAS[0] + 20.0, 8.0, PZ0 + 1.0, PZ1 - 1.0))
    ust0, ust1 = EVY[0] + 6.0, EVY[1] - 6.0                                    # üfleme kesikleri (evaporatör hizası)
    alt0, alt1 = KAS[0] + 6.0, KAS[0] + 36.0                                   # dönüş kesikleri (millerin altı)
    xx = XI0 + SAC_IC + 30.0
    while xx + 14.0 < XI1 - SAC_IC - 30.0:                                     # 14 × 40 mm yarıklar, 40 mm arayla
        perde = perde.cut(kut(xx, xx + 14.0, ust0, ust1, PZ0 + 1.0, PZ1 - 1.0))
        perde = perde.cut(kut(xx, xx + 14.0, alt0, alt1, PZ0 + 1.0, PZ1 - 1.0))
        xx += 40.0
    ekle("hava_perdesi", perde, "sac", bom=("Hava perdesi · delikli sac", 1, "304 1,5 mm · lazer", "evaporatör bölmesini kapatır; üst kesiklerden soğuk hava girer, alt kesiklerden döner (ticari soğutucu düzeni)"))
    # v30 · SOĞUTMA GRUBU KAİDEDE + TEKNİK BÖLME (Kemal 29 Eyl gece: "soğutma grubunu alta, sağ köşedekileri kaldır, o bölüm temiz boş · eşitlik isterim"):
    #       v29'un teknik cebi (ünite + pano + UPS + güç kaynağı + DIN + pedler) KALKTI → soğuk kutu dikdörtgen (topping_uno_cad_v18). Ünite arka-alt köşede,
    #       C kaidesinin 3. arka gözüne gömülü (kaide_cad_v4 cebi) · tepsi + 4 askı TC tabanına · hava sanayi dolabı gibi ÖNDEN: sol mekanizma kanadının alt
    #       bandından girer (kaide 1.–2. gözler) → taban açıklıkları → teknik bölme → ayırma perdesi → ünite → sağ taraf → 3.–4. gözler → sağ kanadın alt bandı ·
    #       teknik bölme GIDA tarafına kapalı (ön perde z −475 = enerji zinciri kanalının arkası; kanal 25 öne alındı) · kuru bölme tabanı ünite havasını kuru bölmeden ayırır
    _xl = lambda x_: x_ - DX_D
    _yl = lambda y_: y_ - DY_D
    ekle("sogutma_grubu_KLF66", kut(_xl(CU_X[0]), _xl(CU_X[1]), _yl(CU_Y[0]), _yl(CU_Y[1]), CU_Z[0], CU_Z[1]), "motor",
         bom=("Yoğuşma ünitesi Secop CU KLF6.6CND (R290) · 314H6003", 1, "307 × 272 × 380 · 14,5 kg · 499 W @ −10/32 °C · 460 @ 38 · 426 @ 43 (föy)",
              "v30 · KAİDEDE arka-alt (yan çevrili: 380 x boyunca · kondenser + fan SOL uçta → hava soldan girer, sağdan çıkar · yön soğutmacı firmayla doğrulanacak) · "
              "gereken (dikdörtgen kutu, dolum + ılık) 340 / 368 / 393 / 410 W @ 32 / 35 / 38 / 40 °C · hatlar üst yüzüne dikine (TU v18) · montaj / gaz dolumu soğutmacı firma"))
    for _i, (_px, _pz) in enumerate(((CU_X[0] + 25.0, CU_Z[0] + 25.0), (CU_X[1] - 25.0, CU_Z[0] + 25.0), (CU_X[0] + 25.0, CU_Z[1] - 25.0), (CU_X[1] - 25.0, CU_Z[1] - 25.0))):
        ekle("sogutma_grubu_pedi_%d" % _i, sily(_xl(_px), _pz, 20.0, _yl(CU_TEPSI_Y[1]), _yl(CU_TEPSI_Y[1] + CU_PED)), "silikon",
             bom=("Titreşim pedi Ø40 × 6 · neopren 60 Shore A (tepsiye yapıştırma + ünite tabanına M6)", 4, "parça no VARSAYIM", "v30 · soğutma grubu tepsisinde") if _i == 0 else None)
    ekle("sogutma_grubu_tepsisi", kut(_xl(CU_X[0]), _xl(CU_X[1]), _yl(CU_TEPSI_Y[0]), _yl(CU_TEPSI_Y[1]), CU_CEP[2] + 1.0, -438.0), "sac",
         bom=("Soğutma grubu tepsisi AISI 304 3 mm", 1, "380 × 351 · arka kenarı 2 askıya kaynak · ön kenarı kaidenin tepsi köşebendine oturur (kaide_cad_v4, 2 × M5)",
              "v30 · kaide cebinde · B dolabının tavanına 18 mm hava (ısı köprüsü yok)"))
    for _i, (_ax, _ar) in enumerate(((CU_X[0] + 5.0, "arka"), (CU_X[1] - 35.0, "arka"))):                    # önde askı yok: enerji zinciri kanalı taban sacında (−475…−415)
        _z0, _z1 = (CU_CEP[2] + 1.0, CU_CEP[2] + 4.0) if _ar == "arka" else (CU_CEP[3] - 4.0, CU_CEP[3] - 1.0)
        _zu = (CU_CEP[2] - 29.0, CU_CEP[2] + 4.0) if _ar == "arka" else (CU_CEP[3] - 4.0, CU_CEP[3] + 29.0)
        _as = kut(_xl(_ax), _xl(_ax + 30.0), _yl(CU_TEPSI_Y[1]), SAC, _z0, _z1).union(kut(_xl(_ax), _xl(_ax + 30.0), SAC, SAC + 3.0, _zu[0], _zu[1]))
        ekle("sogutma_grubu_askisi_%d" % _i, _as, "sac",
             bom=("Soğutma grubu askısı L 30 × 3 AISI 304", 2, "dik kol tepsinin arka kenarına kaynak · yatay kol TC tabanına 2 × M6 (altında kaide arka profili)", "v30 · ünite + tepsi ≈ 18 kg: yarısı 2 askıda (≈ 45 N), yarısı kaidenin ön köşebendinde") if _i == 0 else None)
    _cp = kut(_xl(CU_CEP[0] + 1.0), _xl(CU_CEP[0] + 2.5), _yl(CU_TEPSI_Y[1]), SAC, CU_CEP[2] + 1.0, CU_CEP[3] - 1.0).union(
        kut(_xl(CU_CEP[0] - 14.0), _xl(CU_CEP[0] + 2.5), SAC, SAC + 1.5, CU_CEP[2] + 1.0, CU_CEP[3] - 1.0))
    ekle("sogutma_grubu_cep_perdesi", _cp, "sac",
         bom=("Soğutma grubu cebi sol perdesi AISI 304 1,5 · L", 1, "üst kolu TC tabanına 2 × M5", "v30 · cebin emiş tarafını kapatır (atış havası ünitenin altından emişe dönmez)"))
    _ayir = lambda x0_, x1_: kut(x0_, x1_, SAC, _yl(1107.5), -D + SAC, -630.0).union(kut(x0_, x1_, SAC, _yl(1109.0), -630.0, TB_PERDE_Z - 1.5))   # kuru bölme tabanının altında / soğuk kutunun altında
    ekle("teknik_bolme_ayirma_perdesi", _ayir(_xl(AYIRMA_X), _xl(AYIRMA_X + 1.5)).cut(kut(_xl(AYIRMA_X) - 1.0, _xl(AYIRMA_X + 1.5) + 1.0, SAC - 1.0, _yl(CU_Y[1]), CU_Z[0], CU_Z[1])), "sac",
         bom=("Teknik bölme hava ayırma perdesi AISI 304 1,5", 1, "ünite kesiti kadar pencereli · kenarları köpük bantlı", "v30 · solu EMİŞ (kaide 1.–2. göz), sağı ATIŞ (3.–4. göz) · hava yalnız ünitenin içinden geçer"))
    ekle("teknik_bolme_on_perdesi", kut(SAC, _xl(TB_X1), SAC + 60.0, _yl(1109.0), TB_PERDE_Z - 1.5, TB_PERDE_Z), "sac",
         bom=("Teknik bölme ön perdesi AISI 304 1,5 (sökülebilir)", 1, "%.0f × %.1f · alt kenarı enerji zinciri kanalının arka kenarına oturur (kanalın arka duvarı perdenin altı) · kenarları köpük bantlı · 8 × M5 perçin somun" % (TB_X1 - DX_D - SAC, 1109.0 - DY_D - SAC - 60.0),
              "v30 · teknik bölmeyi GIDA bölgesine (mekanizma) kapatır · servis: mekanizma kanatları açılıp tabla kenara alınınca sökülür (ünite önü ön düzlemden ≈ 560 mm)"))
    ekle("teknik_bolme_sag_perdesi", _ayir(_xl(TB_X1 - 1.5), _xl(TB_X1)), "sac",
         bom=("Teknik bölme sağ perdesi AISI 304 1,5", 1, "arka sac + ön perde + kuru bölme tabanı arasında", "v30 · sabit tahrik (x ≥ 2434) bölmenin DIŞINDA kalır"))
    _kt = kut(SAC, _xl(TB_X1), _yl(1107.5), _yl(1109.0), -D + SAC, -630.0)
    _kt = _kt.cut(kut(_xl(2349.0), _xl(2401.0), _yl(1106.0), _yl(1110.0), -781.0, -689.0))                 # şartlandırıcı gövdesi geçer (TU FRL x 2350–2400)
    for _ha, (_hx, _hz, _hr, _hri) in KSET_HAT.items():                                                    # v31 · soğutma hatları (ünite → kaset, dikine)
        _kt = _kt.cut(sily(_xl(_hx), _hz, _hr + 1.0, _yl(1106.0), _yl(1110.0)))
    _kt = _kt.cut(sily(_xl(KSET_TAHLIYE[6][0]), KSET_TAHLIYE[6][2], 5.0, _yl(1106.0), _yl(1110.0)))        # v31 · kaset tahliyesi (Ø8 hortum, lastik rakor)
    ekle("kuru_bolme_tabani", _kt, "sac",
         bom=("Kuru bölme tabanı AISI 304 1,5", 1, "hat + şartlandırıcı + kaset tahliyesi delikleri (lastik rakor)", "v30 · kuru bölmeyi teknik bölmeden (ünite havası 40–50 °C) ayırır · pano / sürücüler sıcak havada kalmaz"))
    # v30 · KURU BÖLMENİN ÜSTÜ: pano + UPS + güç kaynağı arka saca (üstten servis kapağıyla) · R290 sızarsa aşağı çöker → röleler ünitenin 500 mm üstünde
    ekle("kuru_pano_kutusu", kut(_xl(900.0), _xl(1450.0), _yl(1585.0), _yl(1845.0), -D + SAC, -D + SAC + 120.0).cut(
        kut(_xl(901.5), _xl(1448.5), _yl(1586.5), _yl(1843.5), -D + SAC + 1.5, -D + SAC + 118.5)), "sac",
         bom=("TOPPING panosu", 1, "304 · 550 × 260 × 120 · önü (kuru bölmeye) kapaklı, IP54", "PLC giriş/çıkış + röleler + sürücü beslemesi · v30: kuru bölmenin ÜSTÜNDE arka saca 4 × M6 (üstten servis kapağıyla ulaşılır)"))
    ekle("kuru_din_plakasi", kut(_xl(2020.0), _xl(2230.0), _yl(1600.0), _yl(1760.0), -D + SAC, -D + SAC + 2.0), "sac",
         bom=("DIN montaj plakası 304 2 mm", 1, "210 × 160 · arka saca 4 × M6 (perçin somun)", "v30 · UPS + güç kaynağı raylarını taşır (kuru bölmenin üstü, soğutma hatlarının sağı)"))
    ekle("kuru_din_rayi_ups", kut(_xl(2030.0), _xl(2130.0), _yl(1612.0), _yl(1647.0), -D + SAC + 2.0, -D + SAC + 9.5), "sac",
         bom=("DIN ray TS35 × 7,5 · UPS", 1, "EN 60715 · 100 mm", "v30 · DIN plakasında"))
    ekle("kuru_din_rayi_guc", kut(_xl(2135.0), _xl(2215.0), _yl(1622.0), _yl(1657.0), -D + SAC + 2.0, -D + SAC + 9.5), "sac",
         bom=("DIN ray TS35 × 7,5 · güç kaynağı", 1, "EN 60715 · 80 mm", "v30 · DIN plakasında · güç kaynağının ray tırnağı gövde altının 10 mm üstünde (v29 ile aynı)"))
    ekle("kuru_ups", din_parca(UPS_STEP, _xl(2040.0), _yl(1612.0), -D + SAC + 9.5 + 130.5), "koyu",
         bom=("UPS PULS UB10.242 · DIN ray 24 V", 1, "121,7 × 49,0 × 130,5 mm (GERÇEK CAD) · ayrıca akü modülü ister",
              "elektrik kesintisinde kaset konumları ve saat korunur · v30: kuru bölmenin üstünde DIN plakasında"))
    ekle("kuru_guc_kaynagi", din_parca(GUC_STEP, _xl(2140.0), _yl(1612.0), -D + SAC + 9.5 + 122.8), "sac",
         bom=("Güç kaynağı MEAN WELL NDR-240-24 · 24 V 240 W", 1, "DIN ray · 125,2 × 63,0 × 122,8 mm (GERÇEK CAD)",
              "aynı anda en çok 2 mil döner; motor 2,8 A → gerek %d W, bir üst standart boy 240 W · v30: kuru bölmenin üstünde" % H.S["elektrik"]["guc_kaynagi_W"]))
    # v25 · KURU BÖLME SÜRÜCÜLERİ (4 kaset tahriki: kaşar + sucuk × 2 mil) · STP-DRV-4830 · DIN rayında, ray 2 ayakla arka saca
    _drv = cq.importers.importStep(SURUCU_STEP).val()
    _drv = _drv.rotate(cq.Vector(0, 0, 0), cq.Vector(0, 1, 0), 90.0)
    _db = _drv.BoundingBox()
    HATVE = 33.0
    SUR_Y, SUR_Z = 1432.0 - DY_D, -760.0                                       # dünya y 1432 (valf adasının sağı) · arka yüz = DIN ray yüzü z −760
    for i in range(4):
        xx = 480.0 + i * HATVE
        _d = _drv.translate(cq.Vector(xx - _db.xmin, SUR_Y - _db.ymin, SUR_Z - _db.zmin))
        ekle("kuru_surucu_%d" % i, cq.Workplane(obj=_d), "kart",
             bom=("Step sürücü · STP-DRV-4830", 4, "3 A/faz · 12-48 VDC · mikroadım · DIN ray",
                  "kaşar + sucuk kasetlerinin 4 mili (2 × helezon + 2 × rotor) · motor 2,8 A, sürücü 3,0 A (GERÇEK CAD) · UNO'lar pnömatik") if i == 0 else None)
    ekle("kuru_din_rayi_surucu", kut(470.0, 617.0, SUR_Y + 5.0, SUR_Y + 40.0, SUR_Z - 7.5, SUR_Z), "sac",
         bom=("DIN ray TS35 × 7,5 · sürücüler", 1, "EN 60715 · 147 mm", "kuru bölmede, dünya x 1170–1317"))
    for _i, _x0 in enumerate((478.0, 579.0)):
        ekle("kuru_din_rayi_ayak_%d" % _i, boru_z(_x0, _x0 + 30.0, SUR_Y + 7.5, SUR_Y + 37.5, -D + SAC, SUR_Z - 7.5), "celik",
             bom=("DIN ray ayağı 30 × 30 × 2 AISI 304", 2, "boy 61 · arka saca kaynak saplama", "v25 · sürücüler v24'te havadaydı") if _i == 0 else None)


    # ---------------- 7c · v31 · EVAPORATÖR KASETİ (kuru bölme · soğutma grubunun TAM ÜSTÜ) ----------------
    #   Kemal 30 Eyl: "tamam önerdiğini yap" · sanayi dolabı MONOBLOK düzeni: kaset soğuk kutunun arka duvarına TAKILIR (TU v19: arka dış sac kesik, kutunun PU'su kasetin
    #   ön yalıtımı, iki POM kanal) · hava: ALT kanaldan girer → 16 mm ön aralık → lamel paketi (öne→arkaya) → 53 mm arka baca → üst oda → 2 fan → üfleme odası → ÜST
    #   kanaldan tavan boyunca kapağa · bobin + genleşme valfi + dağıtıcı SOĞUTMACI FİRMA (zarf) · fanlar katalog ölçüsüyle · yoğuşma suyu Ø8 sifonlu hortumla dümdüz
    #   aşağı → ünitenin atış havasındaki SICAK GAZ döngülü tava (v18'in elektrikli kabı + hazne üstündeki hortumu kalktı) · servis: kuru bölmenin üst kapağı + kasetin üst paneli
    def _kw(x0, x1, y0, y1, z0, z1):
        return kut(_xl(x0), _xl(x1), _yl(y0), _yl(y1), z0, z1)
    (KX0, KX1), (KY0, KY1), (KZ0, KZ1) = KSET["x"], KSET["y"], KSET["z"]
    ZC = KZ1 - KSET_CER                                                          # −640 · sacların ön kenarı
    _d1 = KSET_DIS; _p1 = KSET_DIS + KSET_PU; _i1 = KSET_DIS + KSET_PU + KSET_IC
    assert abs(KX0 + _i1 - KSET_BOS[0]) < 0.01 and abs(KX1 - _i1 - KSET_BOS[1]) < 0.01 and abs(KY0 + _i1 - KSET_BOS[2]) < 0.01 and abs(KY1 - _i1 - KSET_BOS[3]) < 0.01 and abs(KZ0 + _i1 - KSET_BOS[4]) < 0.01
    _dl = _kw(KX0 + _d1, KX1 - _d1, KY0 + _d1, KY1 - _d1, KZ0 + _d1, ZC + 1.0)              # dış sacın içi (önü açık)
    _ic_ic = _kw(KSET_BOS[0], KSET_BOS[1], KSET_BOS[2], KSET_BOS[3], KSET_BOS[4], ZC + 1.0)
    _ic_dis = _kw(KX0 + _p1, KX1 - _p1, KY0 + _p1, KY1 - _p1, KZ0 + _p1, ZC)
    _ic_dis_c = _kw(KX0 + _p1, KX1 - _p1, KY0 + _p1, KY1 - _p1, KZ0 + _p1, ZC + 1.0)
    _tx, _ty, _tz = KSET_TAHLIYE[0]
    _tdl = sily(_xl(_tx), _tz, 4.0, _yl(KY0 - 1.0), _yl(KY0 + _i1 + 1.0))                     # tahliye deliği (alt duvar)
    _gec = _kw(1915.0, 1965.0, KY0, KY0 + _i1, -720.0, -680.0)                                 # hat geçiş bloğunun yeri (alt duvar)
    _dsac = _kw(KX0, KX1, KY0, KY1, KZ0, ZC).cut(_dl).cut(_gec).cut(_tdl)
    ekle("evap_kaseti_dis_sac", _dsac, "sac",
         bom=("Evaporatör kaseti dış sacı AISI 304 1,0", 1, "%.0f × %.0f × %.0f · 5 yüz (önü açık, POM çerçeveye oturur) · üst panel 4 × M5 contalı sökülür (fan servisi)" % (KX1 - KX0, KY1 - KY0, ZC - KZ0),
              "v31 · kuru bölmede, soğutma grubunun TAM ÜSTÜNDE · alttan 2 askıya oturur, önden kutunun arka dış sacına 8 × M5 (perçin somun)"))
    _pu = _kw(KX0 + _d1, KX1 - _d1, KY0 + _d1, KY1 - _d1, KZ0 + _d1, ZC).cut(_ic_dis_c).cut(_gec).cut(_tdl)
    ekle("evap_kaseti_PU", _pu, "pu",
         bom=("Evaporatör kaseti PU yalıtımı 40 mm", 1, "poliüretan 40 kg/m³ · λ 0,022 · yerinde köpük (iki sac arası)", "v31 · kuru bölme (ortam + 8 K) ↔ kaset içi (≈ 0 °C) · ek kayıp dünya denetiminde"))
    _isac = _ic_dis.cut(_ic_ic).cut(_gec).cut(_tdl)
    ekle("evap_kaseti_ic_sac", _isac, "sac",
         bom=("Evaporatör kaseti iç sacı AISI 304 1,0", 1, "%.0f × %.0f × %.0f iç · köşeler kaynaklı · tahliye + hat geçişi delikli" % (KSET_BOS[1] - KSET_BOS[0], KSET_BOS[3] - KSET_BOS[2], ZC - KSET_BOS[4]),
              "v31 · hava yolunun dış duvarı (yoğuşma suyu tavaya akar)"))
    _cer = _kw(KX0, KX1, KY0, KY1, ZC, KZ1).cut(_kw(KSET_BOS[0], KSET_BOS[1], KSET_BOS[2], KSET_BOS[3], ZC - 1.0, KZ1 + 1.0))
    ekle("evap_kaseti_isi_kesici_cerceve", _cer, "pom",
         bom=("Kaset ısı kesici çerçevesi POM-C", 1, "%.0f × %.0f dış · %.0f bant · %.0f derin · ön yüzde conta dudağı (EPDM, TPE-V)" % (KX1 - KX0, KY1 - KY0, _i1, KSET_CER),
              "v31 · dış sac (sıcak) ile soğuk iç arasında metal yok (ψ ≈ 0,03 W/mK [V]) · kutunun arka dış sacına ve ABS kaset yüzüne basar → hava sızdırmaz"))
    ekle("evap_kaseti_hat_gecis_blogu", _gec.cut(sily(_xl(KSET_HAT["sogutma_emis_hatti"][0]), KSET_HAT["sogutma_emis_hatti"][1], KSET_HAT["sogutma_emis_hatti"][3], _yl(KY0 - 1.0), _yl(KY0 + _i1 + 1.0)))
                                          .cut(sily(_xl(KSET_HAT["sogutma_sivi_hatti"][0]), KSET_HAT["sogutma_sivi_hatti"][1], KSET_HAT["sogutma_sivi_hatti"][3], _yl(KY0 - 1.0), _yl(KY0 + _i1 + 1.0))), "pom",
         bom=("Kaset hat geçiş bloğu POM-C", 1, "50 × 42 × 40 · 2 delik hat çapında (silikonla sızdırmaz)", "v31 · emiş + sıvı hattı kasetin altından kollektör bölmesine"))
    for _i, _x0 in enumerate((1485.0, 1970.0)):                                               # emiş hattının (x ≤ 1965,5) sağında
        _as = _kw(_x0, _x0 + 30.0, KY0 - 3.0, KY0, KZ0, KZ1).union(_kw(_x0, _x0 + 30.0, KY0 - 33.0, KY0, KZ1 - 3.0, KZ1))
        ekle("evap_kaseti_askisi_%d" % _i, _as, "sac",
             bom=("Kaset askısı L 30 × 3 AISI 304", 2, "yatay kol kasetin altında (196) · dik kol kutunun arka dış sacına 2 × M6 (perçin somun)", "v31 · kaset + bobin ≈ 21 kg [V]: 2 askı + önde 8 × M5") if _i == 0 else None)
    _tv = _kw(*KSET_TAVA).cut(_kw(KSET_TAVA[0] + 1.0, KSET_TAVA[1] - 1.0, KSET_TAVA[2] + 1.0, KSET_TAVA[3] + 1.0, KSET_TAVA[4] + 1.0, KSET_TAVA[5] - 1.0))
    _tv = _tv.cut(sily(_xl(_tx), _tz, 4.0, _yl(_ty - 1.0), _yl(_ty + 2.0)))
    ekle("evap_kaseti_damlama_tavasi", _tv, "sac",
         bom=("Kaset damlama tavası AISI 304 1,0", 1, "%.0f × %.0f × %.0f · %%1 eğim sağ-arka köşedeki Ø8 çıkışa" % (KSET_TAVA[1] - KSET_TAVA[0], KSET_TAVA[5] - KSET_TAVA[4], KSET_TAVA[3] - KSET_TAVA[2]),
              "v31 · bobinin + arka bacanın altı · defrost suyu da buraya"))
    ekle("evap_kaseti_lamel_paketi", _kw(*KSET_BOBIN), "celik",
         bom=("Evaporatör lamel paketi (Al lamel 4,5 mm adım / Cu boru Ø9,52) · YAPTIRILACAK", 1,
              "%.0f × %.0f × %.0f (hava yönü %.0f) · yüzey ≈ %.1f m² [V]" % (KSET_BOBIN[1] - KSET_BOBIN[0], KSET_BOBIN[3] - KSET_BOBIN[2], KSET_BOBIN[5] - KSET_BOBIN[4], KSET_BOBIN[5] - KSET_BOBIN[4],
                                                                          BOBIN_ALAN_YOG * (KSET_BOBIN[1] - KSET_BOBIN[0]) * (KSET_BOBIN[3] - KSET_BOBIN[2]) * (KSET_BOBIN[5] - KSET_BOBIN[4]) * 1e-9),
              "v31 · soğutmacı firma: −10 °C buharlaşma, +3 °C oda, gereken UA dünya denetiminde · tava kenarlarına oturur, üstü ara saca"))
    ekle("evap_kaseti_alt_conta_lamasi", _kw(KSET_TAVA[0] + 1.0, KSET_TAVA[1] - 1.0, KSET_TAVA[2] + 1.0, KSET_BOBIN[2], KSET_BOBIN[5] - 1.0, KSET_BOBIN[5]), "sac",
         bom=("Bobin altı sızdırmazlık laması AISI 304 1,0", 1, "bobinin ön alt kenarı · altında 1 mm su çentikleri", "v31 · hava bobinin altından arka bacaya kaçmaz"))
    ekle("evap_kaseti_kollektor_ayirma_saci", _kw(KSET_KOL_X[0], KSET_KOL_X[1], KSET_BOS[2], KSET_ARA_Y[0], KSET_BOS[4], KSET_BOS[5]), "sac",
         bom=("Kollektör ayırma sacı AISI 304 1,0", 1, "bobin uç plakasının devamı", "v31 · dağıtıcı + genleşme valfi bölmesi hava yolunun dışında"))
    ekle("evap_kaseti_kollektor_TXV_zarfi", _kw(KSET_KOL_X[1], 1960.0, KSET_HAT_Y[2], 1640.0, -760.0, -660.0), "koyu",
         bom=("Dağıtıcı + termostatik genleşme valfi (R290) · YER ZARFI", 1, "48,5 × 100 × 100 [V]", "v31 · soğutmacı firma (hat uçları buraya)"))
    _ara = _kw(KSET_BOS[0], KSET_KOL_X[0], KSET_ARA_Y[0], KSET_ARA_Y[1], KSET_BOBIN[4], KSET_BOS[5]).union(_kw(KSET_KOL_X[0], KSET_BOS[1], KSET_ARA_Y[0], KSET_ARA_Y[1], KSET_BOS[4], KSET_BOS[5]))
    ekle("evap_kaseti_ara_saci", _ara, "sac",
         bom=("Kaset ara sacı AISI 304 1,0", 1, "bobin üstünden öne (arka baca açık)", "v31 · alt bölge (dönüş + bobin) ile üst bölgeyi (fanlar + üfleme) ayırır"))
    _fp = _kw(KSET_BOS[0], KSET_BOS[1], KSET_ARA_Y[1], KSET_BOS[3], KSET_FAN_Z[0], KSET_FAN_Z[1])
    for _fx, _fy in FAN["merkez"]:
        _fp = _fp.cut(silz(_xl(_fx), _yl(_fy), FAN["r_bogaz"], KSET_FAN_Z[0] - 1.0, KSET_FAN_Z[1] + 1.0))
    ekle("evap_kaseti_fan_plakasi", _fp, "sac",
         bom=("Kaset fan plakası AISI 304 1,5", 1, "2 fan boğazı Ø%.0f" % (2 * FAN["r_bogaz"]), "v31 · önü üfleme odası, arkası emiş odası"))
    for _i, (_fx, _fy) in enumerate(FAN["merkez"]):
        _a2 = FAN["a"] / 2.0; _z0 = KSET_FAN_Z[0] - FAN["t"]; _z1 = KSET_FAN_Z[0]
        _fr = _kw(_fx - _a2, _fx + _a2, _fy - _a2, _fy + _a2, _z0, _z1).cut(silz(_xl(_fx), _yl(_fy), FAN["r_bogaz"], _z0 - 1.0, _z1 + 1.0))
        _fr = _fr.union(silz(_xl(_fx), _yl(_fy), FAN["r_gobek"], _z0 + 4.0, _z1 - 4.0))
        for _k in range(5):                                                                   # 5 kanat (düz levha, gösterim)
            _kn = kut(_xl(_fx) + FAN["r_gobek"] - 1.0, _xl(_fx) + FAN["r_bogaz"] - 2.0, _yl(_fy) - 12.0, _yl(_fy) + 12.0, (_z0 + _z1) / 2.0 - 1.5, (_z0 + _z1) / 2.0 + 1.5)
            _fr = _fr.union(_kn.rotate((_xl(_fx), _yl(_fy), 0.0), (_xl(_fx), _yl(_fy), 1.0), 72.0 * _k + 15.0))
        ekle("evap_kaseti_fani_%d" % _i, _fr, "motor",
             bom=("Eksenel fan %s %s" % (FAN["ad"], FAN["kod"]), 2, "%.0f × %.0f × %.0f · %s" % (FAN["a"], FAN["a"], FAN["t"], FAN["kaynak"]),
                  "v31 · fan plakasının arkasına 4 × M4 · emiş odasından çekip üfleme odasına basar · %%85 hız (PWM): %.0f m³/h @ ≈ %.0f Pa · fırçasız DC (R290 bölmesinde kıvılcım yapmaz [V])"
                  % (FAN["q_isletme"], FAN["p_isletme"])) if _i == 0 else None)
    for _ha, (_hx, _hz, _hr, _hri) in KSET_HAT.items():
        ekle(_ha, sily(_xl(_hx), _hz, _hr, _yl(KSET_HAT_Y[0]), _yl(KSET_HAT_Y[1])), "koyu" if "emis" in _ha else "celik",
             bom=(("Emiş hattı Cu Ø12,7 + Armaflex 9 mm (dış Ø31)" if "emis" in _ha else "Sıvı hattı Cu Ø6,35"), 1, "ünitenin üstünden (y %.0f) DİKİNE kasetin altına (y %.0f) · %.0f mm" % (KSET_HAT_Y[0], KSET_HAT_Y[1], KSET_HAT_Y[1] - KSET_HAT_Y[0]),
                  "v31 · kuru bölme tabanından geçer (lastik rakor) · v18: ≈ 700 mm, arka duvar bloğundan · montaj + gaz dolumu soğutmacı firma"))
        ekle(_ha + "_ic", sily(_xl(_hx), _hz, _hri, _yl(KSET_HAT_Y[1]), _yl(KSET_HAT_Y[2])), "celik",
             bom=("Hat ucu Cu (kaset içi)", 1, "geçiş bloğundan kollektör bölmesine", "v31") if "emis" in _ha else None)
    _th = [(_xl(p_[0]), _yl(p_[1]), p_[2]) for p_ in KSET_TAHLIYE]
    ekle("evap_kaseti_tahliye_hortumu", TU_BORU(_th, 4.0), "silikon",
         bom=("Kaset tahliye hortumu silikon Ø8 · SİFONLU", 1, "tava çıkışı → sifon (%.0f → %.0f, %.0f mm su) → dümdüz aşağı → kuru bölme tabanı → yoğuşma tavasının üstünde hava boşluklu biter"
              % (KSET_TAHLIYE[1][1], KSET_TAHLIYE[3][1], KSET_TAHLIYE[3][1] - KSET_TAHLIYE[1][1]),
              "v31 · sifon: kasetin alt bölgesi fan emişinde (eksi basınç) → teknik bölmenin sıcak havası tahliyeden kasete çekilmez"))
    _yt = _kw(*YT).cut(_kw(YT[0] + 1.0, YT[1] - 1.0, YT[2] + 1.0, YT[3] + 1.0, YT[4] + 1.0, YT[5] - 1.0))
    ekle("yogusma_tavasi_sicak_gazli", _yt, "sac",
         bom=("Yoğuşma buharlaştırma tavası AISI 304 1,0 · SICAK GAZ döngülü", 1, "%.0f × %.0f × %.0f (%.2f L) · TC tabanına 2 × M5" % (YT[1] - YT[0], YT[5] - YT[4], YT[3] - YT[2], (YT[1] - YT[0] - 2) * (YT[5] - YT[4] - 2) * (YT[3] - YT[2] - 1) * 1e-6),
              "v31 · ünitenin ATIŞ havasında (x 2098–2142, cep kenarı ile taban açıklığı arası) · kompresör basma hattının döngüsü suyu ısıtır · v18'in 30 W elektrikli kabı kalktı"))
    ekle("sicak_gaz_dongusu", TU_BORU([(_xl(p_[0]), _yl(p_[1]), p_[2]) for p_ in SICAK_GAZ], 3.175), "celik",
         bom=("Sıcak gaz döngüsü Cu Ø6,35", 1, "kompresör basma hattından tavaya U döngü · soğutmacı firma", "v31 · yoğuşma suyunu buharlaştırır (kondenser öncesi gazı da biraz soğutur)"))

    # ---------------- 8b · DÖNER TABLA — TAM ÜRETİM MODELİ (v10) ----------------
    # v9'a kadar 9 adet yer tutucu bloktu; parçaların hiçbiri birbirine bağlanmıyordu. Şema: X ekseni
    # KAYIŞ tahrikli tek araba, DÖNÜŞ ekseni araba plakasının altındaki pancake motorla EŞ EKSENLİ doğrudan.
    TB = H.S["tabla"]
    Xc = XC_TABLA                                                               # v20: modelde PARK KONUMUNDA çizilir (açıcının altı, strok x -350…1627)
    ZT = ZK[0] + 30.0                                                           # tabla ekseni (nozzle'dan z'de 20 mm geride)
    RT_ = TB["cap"] / 2.0

    # --- 8b.1 TAŞIYICI: tekne + kiriş merdiveni (1,5 mm saca lineer ray bağlanmaz) ---
    # v22: uzayan hareketin TAMAMI tasinir; sag motor ve sol avara da ayni teknededir.
    _TX0, _TX1 = XK_SOL - 40.0, 1795.0                                     # v24: tekne modülün içinde biter (duvar 1798,5); solda motor cebi
    tk = kut(_TX0, _TX1, 1.5, 4.5, -5.0, -415.0)
    tk = tk.union(kut(_TX0, _TX1, 1.5, 31.5, -5.0, -8.0)).union(kut(_TX0, _TX1, 1.5, 31.5, -412.0, -415.0))
    # X motoru arka taraftan takilir; teknenin arka kivriminda katalog motor zarfi kadar servis cebi.
    tk = tk.cut(kut(XK_SOL - 34.0, XK_SOL + 34.0, 0.5, 33.0, -416.0, -411.0))    # v24: motor servis cebi SOL uçta
    ekle("mekanizma_teknesi", tk, "sac", bom=("Mekanizma teknesi", 1, "304 3,0 mm · kenarları 30 kıvrık · %1,5 eğim",
         "ray kirişlerinin kaynaklandığı yapısal tekne; damlayanı tabla düzleminin ALTINDA toplar, ön-solda Ø25 tahliye"))
    for ad_, z0_, z1_, gen_ in (("on", -95.0, -35.0, 60.0), ("arka", -305.0, -245.0, 60.0)):
        ekle("ray_kirisi_%s" % ad_, kut(_TX0, _TX1, 4.5, 20.5, z0_, z1_), "celik",
             bom=("Ray kirisi 60 x 16 x %.0f" % (_TX1 - _TX0), 2, "304 lama · tekneye sürekli kaynak", "kaynaktan SONRA üç üst yüzey TEK BAĞLAMADA frezelenir (düzlemlik 0,1 mm/m · v32: MGN15 raylar — HIWIN MG montaj toleransıyla teyit [V])") if ad_ == "on" else None)
    ekle("kayis_kirisi", kut(_TX0, _TX1, 4.5, 20.5, -385.0, -335.0), "celik",
         bom=("Kayış kirişi 50 × 16 × %.0f" % (_TX1 - _TX0), 1, "304 lama", "kayış kasnakları, avara ve gergi bunun üstünde · v24: modül içinde biter"))
    for i_, xb in enumerate((-520.0, -220.0, 80.0, 380.0, 680.0, 980.0, 1280.0, 1580.0, 1745.0)):   # v24: son lama 1745
        ekle("baglama_lamasi_%d" % i_, kut(xb, xb + 40.0, 4.5, 20.5, -335.0, -305.0), "celik",
             bom=("Baglama lamasi 40 x 16", 9, "304 lama", "arka ray kirişi ile kayış kirişini bağlar; dönüş motoru z −141…−198 bandında gezdiği için tam boy lama konulamıyor") if i_ == 0 else None)

    # --- 8b.2 LİNEER KIZAK · v32: ALÇAK HIWIN MGN15H (Kemal 30 Eyl: "rayın üstü kapanmalı, arasına hamur sos küp sucuk girmemeli") ---
    # v31 HGH15CA (H 28) bloğun üstü plakanın altıydı → örtü de çatı da geçemiyordu. MGN15H (H 16): blok üstü 36,5 · plaka 48,5 YERİNDE (tabla kotu aynı).
    _RY = {ad_: mgn_ray(RAY2_X[0], RAY2_X[1], zc_, RAY_EK[ad_]) for ad_, zc_ in (("on", -65.0), ("arka", -275.0))}
    RAY_E.clear(); RAY_CIVATA.clear()
    for ad_ in ("on", "arka"):
        _r, _cv, _say, _E = _RY[ad_]
        RAY_E[ad_] = _E; RAY_CIVATA[ad_] = _say
        ekle("lineer_ray_%s" % ad_, _r, "celik",
             bom=("Lineer ray %s × %.1f (iki parça, eşleştirilmiş ek)" % (MGNR["ad"], RAY2_X[1] - RAY2_X[0]), 2,
                  "paslanmaz · ön %.0f + %.1f · arka %.0f + %.1f mm (tek parça ≤ %.0f, ekler şaşırtmalı) · %s"
                  % (RAY_EK["on"] - RAY2_X[0], RAY2_X[1] - RAY_EK["on"], RAY_EK["arka"] - RAY2_X[0], RAY2_X[1] - RAY_EK["arka"], MGNR["Lmax"], MGNR["kaynak"]),
                  "v32 · HGR15 yerine (12 mm alçak blok için) · ray kirişine %s · sol sert duruşta blok raydan taşmaz (v31: 51 mm taşıyordu)" % MGNR["civata"]) if ad_ == "on" else None)
        ekle("lineer_ray_%s_civatalari" % ad_, _cv, "celik",
             bom=("Cıvata %s · A2 paslanmaz (ray bağlantısı)" % MGNR["civata"], sum(v_[2] for v_ in _RY.values()), "havşa Ø6 × 4,5 dibinde · hatve 40 · uçtan 15",
                  "ray kirişine (dişli) · v32") if ad_ == "on" else None)
    for i_, (xb, zc_) in enumerate([(Xc - KIZAK_DX, -65.0), (Xc + KIZAK_DX, -65.0), (Xc - KIZAK_DX, -275.0), (Xc + KIZAK_DX, -275.0)]):
        _g, _uc = mgn_blok(xb, zc_)
        ekle("kizak_blogu_%d" % i_, _g, "celik",
             bom=("Kızak bloğu %s" % MGN["ad"], 4, "paslanmaz · katalog ölçüsüyle modellendi (STEP indirilmedi) · %s" % MGN["kaynak"],
                  "v32 · HGH15CA yerine (H 28 → 16) · hatve %.0f (v31: 200) · uçta çift dudaklı conta + alt conta · Z0 ön yük" % (2.0 * KIZAK_DX)) if i_ == 0 else None)
        for j_, u_ in enumerate(_uc):
            ekle("kizak_blogu_%d_uc_%s" % (i_, "ab"[j_]), u_, "koyu",
                 bom=("Blok uç kapağı + conta (bloğun parçası)", 8, "plastik uç kapağı + conta · bilye dönüş kanalı", "v32 · MGN15H'nin kendi parçası (ayrı sipariş yok)") if i_ == 0 and j_ == 0 else None)
        ekle("kizak_blogu_%d_ayagi" % i_, kizak_ayagi(xb, zc_), "celik",
             bom=("Kızak ayağı · AISI 304 4 mm · 40 boy", 4, "tel erozyon · bloğa 4 × M3 × 6 havşa (DIN 7991, bloğun M3 × 4 dişine) · plakadan 2 × M4 × 12 havşa",
                  "v32 · blok ↔ araba plakası: çatının altından yana → iç eteğin içinden aşağı → eteğin altından dışarı → yukarı plakaya (ters kap labirent) · "
                  "yükseklik 12 = plaka 48,5 − blok üstü 36,5 → tabla kotu aynı") if i_ == 0 else None)
    apl = kut(Xc - 150.0, Xc + 130.0, 48.5, 58.5, -25.0, -315.0).cut(sily(Xc, ZT, 23.0, 47.0, 60.0))   # v27 (d): sağ kenar −20 (aktarma +28,4'te fırın kabuğuna değmesin)
    ekle("araba_plakasi", apl, "celik", bom=("Araba plakası 280 × 290 × 10", 1, "304 · iki yuva TEK BAĞLAMADA işlenir (eş eksenlik 0,05)",
         "altında motor pilotu Ø38,1 H8, üstünde döner yatak yuvası; hafifletme cepli ~5,5 kg"))

    # --- 8b.3 DÖNÜŞ: yatak · ayar bileziği · göbek · tabla ---
    # v16: GERCEK katalog yatagi. Ø196,85 x 22,27 — tasarimda Ø160 varsayilmisti.
    _y = xu080149()["kati"].translate(cq.Vector(Xc, 58.5, ZT))
    ekle("doner_yatak", cq.Workplane(obj=_y), "celik",
         bom=("Çapraz makaralı döner yatak", 1, "Schaeffler (INA) XU080149 · Ø196,85 × 22,27 · GERÇEK CAD",
              "Ø340 konsol tablanın devirme momentini doğrudan alır; iç bilezik plakaya cıvatalı"))
    # AYAR BILEZIGI ZATEN BUNUN ICIN VAR (isleme araligi 2-14 mm): yatak 20 yerine 22,27
    # cikinca fazlaligi bilezik yutar, gobek ve tabla YERINDE KALIR. 7,5 -> 5,23 mm islenir.
    _ab = sily(Xc, ZT, 105.0, 80.77, 86.0).cut(sily(Xc, ZT, 50.0, 79.8, 87.0))
    _PIM27 = [p for p in BT.PARCALAR if p["grup"] == "DONER" and p["ad"].startswith("ayar_konum_pimi_")]      # v27 (e)
    for _p27 in _PIM27:
        _ab = _ab.cut(cq.Workplane(obj=_p27["sh"].translate(cq.Vector(Xc, -DY_D, ZT))))                     # pres geçme deliği = pim
    for i_ in range(3):                                                     # v20: kilit burcu delikleri
        a_ = math.radians(120.0 * i_ + 40.0)
        _ab = _ab.cut(sily(Xc + 92.0 * math.cos(a_), ZT + 92.0 * math.sin(a_), 7.0, 80.0, 87.0))
    ekle("ayar_bilezigi", _ab, "celik",
         bom=("Ayar bileziği · torna halka", 1, "304 · dış Ø210 iç Ø100 · kalınlık 5,23 — yatak Ø197 × 22,27 olunca büyüdü ve İNCELDİ (aralık 2–14)",
              "ray + blok + yatak katalog toleransının TAMAMI bu tek parçada toplanır; yedek dikey boşluk 7,5 mm"))
    gb = sily(Xc, ZT, 110.0, 86.0, 97.0).cut(sily(Xc, ZT, 30.0, 85.0, 98.0))
    for i_ in range(2):
        gb = gb.cut(sily(Xc + (10.0 if i_ == 0 else -10.0), ZT, 4.1, 85.0, 92.0))                # tahrik pimi burçları
    for _p27 in _PIM27:                                                                                   # v27 (e): 2 × Ø8 konum pimi, bileziğe presli
        ekle(_p27["ad"], cq.Workplane(obj=_p27["sh"].translate(cq.Vector(Xc, -DY_D, ZT))), "celik", bom=_p27["bom"])
    _yer = cq.Vector(Xc, -DY_D, ZT)                                                                         # v27: KASET (elle çıkar) park konumunda
    for _k27 in BT.KASET:
        ekle("bk_" + _k27["ad"], cq.Workplane(obj=_k27["sh"].translate(_yer)), _k27["mal"], bom=_k27["bom"])
    for _t27 in BT.TAHRIK:                                                                                  # v27 (f): sabit tahrik (dünya → yerel)
        ekle("st_" + _t27["ad"], cq.Workplane(obj=_t27["sh"].translate(cq.Vector(-DX_D, -DY_D, 0.0))), _t27["mal"], bom=_t27["bom"])
    # v29 · SABİT TAHRİK BAĞLANTILARI (dünya denetimi 'havada', v27'den beri): yatak burcu tahrik kutusuna (8,5 mm), motor ve motor kutusu tahrik kutusuna
    #       (1,5 mm) bağlı değildi → yatak flanşı (burç buna kaynaklı) + motor adaptör flanşı (işlenmiş; motor 4 × M5, iki kutuya TIG) eklendi
    _TK = {p_["ad"]: p_["sh"] for p_ in BT.TAHRIK}
    _kb_, _mb_, _yb_ = _TK["tahrik_kutusu"].BoundingBox(), _TK["motor_kutusu"].BoundingBox(), _TK["tahrik_yatak_burcu"].BoundingBox()
    _xs_, _ys_ = (_yb_.xmin + _yb_.xmax) / 2.0, (_yb_.ymin + _yb_.ymax) / 2.0
    _mt_ = _TK["tahrik_motoru"]
    def _mkesit(z_):                                                           # motorun z kesit alanı (kare gövde ≈ 3100 · pilot Ø38,1 ≈ 1140)
        k_ = _mt_.intersect(kut(_xs_ - 40.0, _xs_ + 40.0, _ys_ - 40.0, _ys_ + 40.0, z_ - 0.005, z_ + 0.005).val())
        return k_.Volume() / 0.01
    _za, _zb = _mb_.zmax - 12.0, _mb_.zmax                                    # gövde ön yüzü motor kutusunun ağzının ≤ 12 mm gerisinde
    assert _mkesit(_za) > 2000.0 and _mkesit(_zb) < 2000.0, (_mkesit(_za), _mkesit(_zb))
    for _i_ in range(24):
        _zm = (_za + _zb) / 2.0
        if _mkesit(_zm) > 2000.0: _za = _zm
        else: _zb = _zm
    Z_MOTOR_YUZ = _zb + 0.01                                                   # motor flanş yüzü (dünya z) + 0,01 (yüz kesiti ±0,002 mm sayısal · temas payı ≤ 0,05)
    _ad_ = kut(_mb_.xmin + 1.5, _mb_.xmax - 1.5, _mb_.ymin + 1.5, _mb_.ymax - 1.5, Z_MOTOR_YUZ, _mb_.zmax).cut(silz(_xs_, _ys_, 19.15, Z_MOTOR_YUZ - 1.0, _mb_.zmax + 1.0))
    ekle("st_motor_adaptor_flansi", _ad_.translate((-DX_D, -DY_D, 0.0)), "celik",
         bom=("Sabit tahrik motor adaptör flanşı AISI 304 · işlenmiş", 1, "%.0f × %.0f × %.1f · NEMA23 pilot yuvası Ø38,3 · motor 4 × M5" % (_mb_.xlen - 3.0, _mb_.ylen - 3.0, _mb_.zmax - Z_MOTOR_YUZ),
              "v29 · motor kutusunun ağzına + tahrik kutusunun arka kenarına TIG · motor buna oturur (v27–v28 motor ve motor kutusu havadaydı)"))
    _yf_ = kut(_kb_.xmin + 1.5, _kb_.xmax - 1.5, _kb_.ymin + 1.5, _kb_.ymax - 1.5, _yb_.zmin - 3.0, _yb_.zmin).cut(silz(_xs_, _ys_, 10.0, _yb_.zmin - 4.0, _yb_.zmin + 1.0))
    ekle("st_yatak_flansi", _yf_.translate((-DX_D, -DY_D, 0.0)), "celik",
         bom=("Sabit tahrik yatak flanşı AISI 304 3 mm", 1, "%.0f × %.0f · kaplin geçişi Ø20" % (_kb_.xlen - 3.0, _kb_.ylen - 3.0),
              "v29 · tahrik kutusunun içine TIG · yatak burcu buna kaynaklı (v27–v28 burç havadaydı)"))
    ekle("tabla_gobegi", gb, "celik", bom=("Tabla göbeği Ø220 × 11", 1, "304 işlenmiş, cepli ~1,8 kg",
         "ayar bileziğine 3 × M8 saplama + paslanmaz KELEBEK SOMUN + 2 × Ø8 h7 konum pimi ile ALETSİZ sökülür"))
    # v20 · TEPSI YOK: robot parmak kesikleri KALDIRILDI. Hamur artik dogrudan bu
    # yuzeyde aciliyor; kesik olursa hamur delige girer.
    tb_ = sily(Xc, ZT, RT_, 97.0, 100.0)
    ekle("tabla", tb_, "sac", bom=("Döner tabla Ø340 × 3", 1, "304 · göbeğe sürekli TIG kaynak",
         "TAŞIYICI tabla — gıda yüzeyi DEĞİL; gıda yüzeyi üstündeki çalışma diski"))
    # v20 · CALISMA DISKI = gida yuzeyi. Tabla gobege kaynakli, sokulemiyor; yikanabilsin
    # diye ustune elle cikan disk kondu. Kenari 15 mm'de 2 mm'ye iner (soyma).
    # UST YUZ Ø340 BOYUNCA DUZ (y 108) — pide duz zeminde acilmali.
    # INCELME ALT YUZDE: son 15 mm'de taban 100 -> 106'ya cikar, kenar 2 mm kalir.
    _dsk = sily(Xc, ZT, RT_, 106.0, 108.0)                                  # tum disk 2 mm ust kabuk
    _dsk = _dsk.union(sily(Xc, ZT, RT_ - 15.0, 100.0, 106.0))               # ortada tam kalinlik
    _dsk = _dsk.union(koni_y_t(Xc, ZT, RT_, RT_ - 15.0, 100.0, 106.0))      # alt yuzde konik gecis
    for i_ in range(3):                                                     # pim delikleri
        a_ = math.radians(120.0 * i_)
        _dsk = _dsk.cut(sily(Xc + 100.0 * math.cos(a_), ZT + 100.0 * math.sin(a_), 4.1, 99.0, 109.0))
    ekle("calisma_diski", _dsk, "pom",
         bom=("Çalışma diski Ø340 · 8 → 2", 1, "mat gıda UHMW-PE (ya da PU kaplı) · elle çıkar · yedekli",
              "GIDA YÜZEYİ: hamur burada açılır, malzeme buna dökülür, akşam sökülüp yıkanır. "
              "MAT olacak — cilalı yüzeyde koniler hamuru açmaz, yerinde döndürür. "
              "Kenar son 15 mm'de 2 mm'ye iner: pide soyularak ayrılır, sürüklenmez"))
    for i_ in range(3):
        a_ = math.radians(120.0 * i_)
        ekle("disk_pimi_%s" % "ABC"[i_], sily(Xc + 100.0 * math.cos(a_), ZT + 100.0 * math.sin(a_), 4.0, 100.0, 108.0), "celik",
             bom=("Disk konum pimi Ø8 × 8", 3, "304 · tablaya H7/r6 presli",
                  "r = 100'de 120° aralıklı; çalışma diskini yerinde tutar (sıyrılırken kaymasın). "
                  "Diskle AYNI KOTTA biter — gıda yüzeyinde çıkıntı yok") if i_ == 0 else None)

    # --- 8b.4 DÖNÜŞ MOTORU (eş eksenli, i = 1) ---
    ekle("donus_motoru", kut(Xc - 28.5, Xc + 28.5, Y_PLAKA - 41.0, Y_PLAKA, ZT - 28.5, ZT + 28.5), "motor",   # v32: plakaya oturur (v31 4,5–45,5: plakayla 3 mm boşluk, tekne tabanına sürtüyordu)
         bom=("Dönüş motoru · NEMA23 PANCAKE", 1, "57 × 57 × 41 · kapalı çevrim step · ~0,9 N·m [V: tork eğrisi doğrulanacak]",
              "araba plakasının ALTINA 4 × M5 havşa, ekseni TABLA EKSENİYLE AYNI; redüktör ve kayış YOK · gereken 0,169 N·m → ~5 kat pay"))
    lk = sily(Xc, ZT, 15.0, Y_PLAKA, 66.0).cut(sily(Xc, ZT, 4.1, Y_PLAKA - 0.5, 67.0))   # v32: motor 3 yukarı → lokma 48,5–66   # v25: motor mil yüzüne oturur (v24 0,5 boşluk)
    for i_ in range(2):
        lk = lk.union(sily(Xc + (10.0 if i_ == 0 else -10.0), ZT, 4.0, 66.0, 74.0)).union(sily(Xc + (10.0 if i_ == 0 else -10.0), ZT, 3.95, 74.0, BT.H.Y_TABAN[1] - 1.5 - DY_D))   # v27 (e): pim kaset tabanı burcuna (dünya 982,5)
    ekle("tahrik_lokmasi", lk, "celik", bom=("Tahrik lokması Ø30 × 17,5", 1, "304 torna · yarıklı sıkma + M5 pinç",
         "üstünde r = 10'da 2 × Ø8 pim; göbeğin altındaki burçlara girer — rijit kaplin YOK, tabla düşeyde ayrılabiliyor"))

    # --- 8b.5 X TAHRİK ZİNCİRİ (v22: TAM 1987 mm strok) ---
    # v21 hatasi: ray -500'e uzamisti fakat kayis x=52'de basliyordu; parkta (-350)
    # araba kayisa bagli degildi. Ayrica iki duz kosu Y yerine Z'de ayrilmisti.
    _KL, _KR, _KY, _KRAD = XK_SOL, XK_SAG, 33.0, H.KASNAK_R                  # v24: −560 / 1650
    ekle("x_tahrik_kasnagi", silz(_KL, _KY, _KRAD, -367.5, -352.5).cut(silz(_KL, _KY, 4.0, -369.0, -351.0)), "celik",   # v25: sıkma bilezikli → delik = mil
         bom=("GT3 kasnak 20 dis x 15", 1, "PD %.3f -> cevre TAM %.2f mm/tur; sikma bilezikli" % (2.0 * _KRAD, H.KASNAK_CEVRE), "x motorunun milinde"))
    # Motor STEP'inin mili zaten Z ekseninde. v21'de X etrafinda 90 derece
    # cevrilince mil Y'ye bakiyor ve govde kayisin icine giriyordu.
    # Motor teknenin ARKASINDA; gercek NEMA23 mili +Z yonunde kasnaga uzanir.
    # Boylece motor govdesi ne kayis kirisine ne de urun bolgesine girer.
    _mot_yuz = -397.5
    _mg = nema23()["govde"].translate(cq.Vector(_KL, _KY, _mot_yuz))         # v24: motor SOL uçta (park tarafı)
    ekle("x_motoru", cq.Workplane(obj=_mg), "motor",
         bom=("X motoru - NEMA23 kapali cevrim step", 1, "57 x 57 x 76 - %.1f N.m - 24 V - mil asagi" % H.X_MOTOR_TORK,
               "200 mm/s = 200 dev/dk; %.2f kg hareketli kutlede gereken %.3f N.m, motor payi %.1f kat" % (H.X_HAREKET_KUTLE, H.X_GEREKEN_TORK, H.X_TORK_PAY)))
    ekle("x_motor_mili", silz(_KL, _KY, 4.0, _mot_yuz, -352.5), "celik",
         bom=("X motor mili O8", 1, "motorun katalog mili + sikma bilezigi", "kasnak gobegine kadar kesintisiz; kasnak deligi O8,2"))
    _mk = kut(_KL - 45.0, _KL + 45.0, 4.5, 75.0, _mot_yuz, _mot_yuz + 8.0).cut(silz(_KL, _KY, 20.0, _mot_yuz - 1.0, _mot_yuz + 9.0))
    ekle("x_motor_kaidesi", _mk, "sac",
         bom=("X motor kaidesi", 1, "304 8 mm dik motor plakasi - tekneye 4 x M8", "motor teknenin arkasinda; mil servis cebinden kasnaga gelir"))
    ekle("avara_kasnak", silz(_KR, _KY, _KRAD, -367.5, -352.5).cut(silz(_KR, _KY, 4.0, -369.0, -351.0)), "celik",   # v25: rulman iç bileziği mile sıkı
         bom=("Avara kasnak GT3 20 dis x 15", 1, "flansli - icinde 2 x 625-2RS paslanmaz rulman", "v27: SAĞ uçta (1678,4); aktarmada kelepçe 1607'de biter"))
    # Avara plakasi kayis duzleminin arkasinda; onceki U braket iki kayis kosusunu kesiyordu.
    _agb = kut(_KR - 22.0, _KR + 22.0, 20.5, 50.0, -385.0, -377.0).cut(silz(_KR, _KY, 4.0, -386.0, -376.0))   # v25: mil brakete sıkı (M8 gergi)
    ekle("avara_gergi_braketi", _agb, "celik",
         bom=("Avara + gergi braketi", 1, "304 10 mm - 16 mm yuvali 2 x M8 + M6 itme vidası + kontra", "gergi sol servis bolgesinden ayarlanir"))
    ekle("avara_mili", silz(_KR, _KY, 4.0, -385.0, -352.5), "celik",
         bom=("Avara mili O8", 1, "17-4PH - iki 625-2RS rulman", "gergi plakasindan kasnaga"))
    _bt = 1.5
    for i_, yc_ in enumerate((_KY - _KRAD - _bt / 2.0, _KY + _KRAD + _bt / 2.0)):
        ekle("x_kayisi_%d" % i_, kut(_KL, _KR, yc_ - _bt / 2.0, yc_ + _bt / 2.0, -367.5, -352.5), "koyu",
             bom=("X kayisi GT3-15 kapali cevrim %.0f mm" % (2.0 * (XK_SAG - XK_SOL) + H.KASNAK_CEVRE), 1, "celik kordlu poliuretan [V: tedarikci boyu dogrulayacak]", "iki kosu AYNI XY duzleminde; tum -350...1637 is strokunda kelepce kayis ustunde") if i_ == 0 else None)
    # Kasnak sarimlari: duz kosularin iki ucunu fiziksel olarak kapatir.
    for ad_, xx_, sol_ in (("sol", _KL, True), ("sag", _KR, False)):
        _sar = silz(xx_, _KY, _KRAD + _bt, -367.5, -352.5).cut(silz(xx_, _KY, _KRAD, -369.0, -351.0))
        _sar = _sar.intersect(kut(xx_ - 14.0 if sol_ else xx_, xx_ if sol_ else xx_ + 14.0, _KY - 14.0, _KY + 14.0, -368.0, -352.0))
        ekle("x_kayisi_sarim_" + ad_, _sar, "koyu")
    _yc = _KY + _KRAD + _bt / 2.0
    kol = kut(Xc - 150.0, Xc - 30.0, _yc + 4.5, _yc + 14.5, -385.0, -315.0).union(kut(Xc - 110.0, Xc - 70.0, _yc + _bt / 2.0 + 0.5, _yc + 4.5, -367.5, -352.5))   # v24: plakanın SOL yarısı
    ekle("kayis_kolu", kol, "celik", bom=("Kayis kolu - L", 1, "304 10 mm bukme - plakaya 4 x M8 + O6 pim", "ust kayis kosusunu araba plakasina baglar · v24: 120 boy, plakanın sol yarısında (sağ uç 2500'ü geçmesin)"))
    for i_, xb in enumerate((Xc - 130.0, Xc - 50.0)):
        ekle("kayis_kelepcesi_%d" % i_, kut(xb - 20.0, xb + 20.0, _yc - 4.5, _yc + 4.5, -371.0, -349.0).cut(kut(xb - 21.0, xb + 21.0, _yc - 1.0, _yc + 1.0, -368.0, -352.0)), "celik",
             bom=("Kayis kelepcesi", 2, "304 govde + GT3 dis profilli baski plakasi", "kapali kayisin ust kosusuna iki noktadan 2 x M5 + 2 x M4 ile baglanir") if i_ == 0 else None)

    # --- 8b.6 HİJYEN / KORUMA ---
    ap = kut(Xc - 190.0, Xc + 130.0, 58.5, 60.5, -5.0, -340.0)   # v27: sağ kenar plaka kenarında (Xc + 190 aktarmada fırın kabuğuna 1005 mm³ giriyordu).cut(sily(Xc, ZT, 85.0, 57.5, 61.5))
    ap = ap.cut(sily(Xc, ZT, 101.0, 40.0, 95.0))      # v16: Ø197 yatak + 2 mm bosluk
    ekle("siyirici_apron", ap, "sac", bom=("Sıyırıcı apron 320 × 335 × 2", 1, "304 · kenarı 10 kıvrık · elle çıkar",
         "tepsinin ayak izini birebir örter; dökülen kırıntı raylara ULAŞAMAZ"))
    for ad_, zc_ in (("on", -65.0), ("arka", -275.0)):          # v32 · KAPALI RAY ÇATISI (v25–v31: 36 mm yarıklı iki L şerit, araba bloğu yarıktan geçiyordu)
        ekle("ray_ortu_catisi_%s" % ad_, ray_catisi(zc_), "sac",
             bom=("Ray çatısı · AISI 304 1,5 tek parça bükme", 2, "boy %.1f · kirişe vidalı ayak (12 × M3 × 6 ISO 7380) + dış etek · üst 3° dışa eğimli · iç damlama eteği y %.0f'a iner"
                  % (CATI_X[1] - CATI_X[0], CATI["y_etek"]),
                  "v32 · Kemal 30 Eyl \"rayın üstü kapanmalı, arasına hamur sos küp sucuk girmemeli\": ÜSTTE YARIK YOK · kızak ayakları iç eteğin ALTINDAN dolanır "
                  "(ters kap labirent: düşen hiçbir şey giremez) · temizlik: 12 vida sökülür, çatı kalkar") if ad_ == "on" else None)
        for u_, (xa_, xe_) in (("sol", (CATI_X[0], RAY2_X[0])), ("sag", (RAY2_X[1], CATI_X[1]))):
            ekle("ray_ortu_kapagi_%s_%s" % (ad_, u_), ray_catisi_kapagi(zc_, xa_, xe_), "sac",
                 bom=("Ray çatısı uç kapağı · AISI 304 1,5", 4, "çatının iç kesitini (etek altı dahil) kapatır · 2 × M3 çatıya", "v32 · ray ucu kapalı · blok sert duruşta kapaktan ≥ 8 mm")
                 if (ad_, u_) == ("on", "sol") else None)
    ekle("kirinti_cekmecesi", kut(100.0, 1580.0, 4.5, 20.5, -240.0, -212.0).cut(kut(103.0, 1577.0, 6.5, 21.5, -237.0, -215.0)), "sac",
         bom=("Kırıntı çekmecesi", 1, "304 1,0 mm · önden çekilir", "iki ray kirişi arasında; boşaltılıp yıkanır"))
    ekle("enerji_zinciri_kanali", kut(-520.0, 1790.0, SAC, SAC + 60.0, EZK_Z[0], EZK_Z[1]).cut(kut(-517.0, 1787.0, SAC + 2.0, SAC + 61.0, EZK_Z[0] + 3.0, EZK_Z[1] - 3.0)), "sac",   # v30: 25 öne (arka duvarı = teknik bölme ön perdesinin altı) · v25: tabana oturur
         bom=("Enerji zinciri + kanalı", 1, "iç 15 × 30 · R40 · boy ~840 · kanal 304 1,0 mm 60 × 60",
              "dönüş motoru arabayla gezdiği için ZORUNLU; içinde PUR kılıflı sürükleme-zinciri kablosu (PVC DEĞİL)"))

    # --- 8b.7 SENSÖRLER ve TAMPONLAR ---
    for ad_, xb in (("home", H.X_PARK), ("limit_sol", H.X_LIMIT_SOL), ("limit_sag", 1675.0)):            # v27 (d): limit+ 1647 → 1675 (aktarma +28,4) · v24: limit+ 1647 (tampon 1650)
        ekle("x_%s_sensoru" % ad_, silz(xb, 28.0, 6.0, -25.0, -19.0), "koyu",
             bom=("Enduktif sensor M12 x 50 IP69K PNP NO", 3, "on ray kirisinin dis yuzune L braketle", "home %.0f - limit- %.0f - limit+ %.0f" % (H.X_PARK, H.X_LIMIT_SOL, 1675.0)) if ad_ == "home" else None)
        ekle("x_%s_sensor_braketi" % ad_, kut(xb - 8.0, xb + 8.0, 16.0, 22.0, -35.0, -19.0), "celik",
             bom=("Sensör braketi 304 3 mm · M12 kelepçeli", 3, "ön ray kirişinin ön yüzüne 2 × M4", "v25 · sensörler v24'te kirişin 10 mm önünde havadaydı") if ad_ == "home" else None)
    ekle("x_bayragi", kut(Xc - 30.0, Xc + 30.0, 40.0, 48.5, -30.0, -6.0), "sac",   # v25: plakanın altına 5 mm girer (kaynak) — v24: 1 mm önündeydi
         bom=("X bayrağı 60 × 25", 1, "304 3 mm", "araba plakasının ön kenarının altında"))
    # v20 · TABLA KILIDI: acma aninda konilerin artik torku tablayi cevirmesin.
    # Gereken 3-5 N.m, pancake motorun tutma torku 0,9 N.m — motor yetmiyor.
    for i_ in range(3):                                                     # burc: delik ayar bileziginde ACILIR
        a_ = math.radians(120.0 * i_ + 40.0)
        _bx, _bz = Xc + 92.0 * math.cos(a_), ZT + 92.0 * math.sin(a_)
        ekle("kilit_burcu_%d" % i_, sily(_bx, _bz, 7.0, 80.8, 86.0).cut(sily(_bx, _bz, 5.0, 80.0, 87.0)), "celik",
             bom=("Kilit burcu Ø14/Ø10", 3, "sertleştirilmiş 420 · ayar bileziğine presli",
                  "açıcının altında gövdeye bağlı pim buraya girer, tabla dönmez. "
                  "DOZAJ HIZINA DOKUNULMADI — kilit yalnız açma anında") if i_ == 0 else None)
    ekle("tabla_home_sensoru", sily(Xc, ZT - 128.0, 4.0, 66.5, 76.5), "koyu",
         bom=("Tabla home sensörü M8 endüktif IP67", 1, "araba plakasının ÜSTÜNDE braketli", "algılama yüzü YUKARI; arabayla birlikte gezdiği için sabit referansa gerek yok"))
    ekle("araba_plakasi_sensor_braketi", kut(Xc - 6.0, Xc + 6.0, 60.5, 66.5, ZT - 134.0, ZT - 122.0), "celik",
         bom=("Tabla home sensör ayağı 304", 1, "12 × 6 × 12 · apron + plakaya M4", "v25 · sensör v24'te apronun 6 mm üstünde havadaydı"))
    ekle("tabla_home_bayragi", sily(Xc, ZT - 128.0, 10.0, 85.0, 89.0).union(kut(Xc - 5.0, Xc + 5.0, 80.77, 85.0, ZT - 138.0, ZT - 105.0)), "celik",   # v25: bileziğe kaynaklı kol (göbeğin 1 mm altında)
         bom=("Tabla home bayrağı 3 × 20 × 12", 1, "304 · ayar bileziğine r = 128'de kaynaklı (yatak Ø197 olunca dışarı kaydı)", "boşluk 2,0 mm · robot tepsiyi hep aynı açıda bulmalı"))
    ekle("uc_tamponu_0", kut(X_SERT[0] - 170.0, X_SERT[0] - 150.0, 49.0, 58.0, -80.0, -65.0), "silikon",   # v32: PU takoz plakanın kalınlığında (v31 Ø20 y 43,5–63,5 · x −580)
         bom=("Uç tamponu PU takoz 20 × 9 × 15 (sol)", 1, "poliüretan 90 ShA + 304 braket",
              "ARABA PLAKASINA çarpar: tabla ekseni %.0f = limit %.0f + %.0f aşım · apron (y 58,5) 0,5 mm üstünden geçer · kayış kelepçesi X kasnağına 5,5 mm kalır (v31: apron −380'de tampona, kelepçe −420'de kasnağa giriyordu)"
              % (X_SERT[0], H.X_LIMIT_SOL, H.X_LIMIT_SOL - X_SERT[0])))
    ekle("uc_tamponu_0_braketi", kut(X_SERT[0] - 170.0, X_SERT[0] - 150.0, 20.5, 49.0, -82.0, -63.0), "celik",
         bom=("Uç tamponu braketi 304", 1, "20 × 28,5 × 19 · ön ray kirişinin üstüne 2 × M5", "v32 · takozla birlikte 25 sağa (ray çatısının uç kapağından 3,5 solda)"))
    # v24: SAĞ tampon kayış KOLUNA vurur (kol aktarmada 1607'de biter; tampon 1617–1629 → sert limit Xc 1650 = aktarma + 13)
    ekle("uc_tamponu_1", silx(_yc + 9.5, -372.5, 5.0, 1645.4, 1657.4), "silikon",
         bom=("Uç tamponu Ø10 × 12 (sağ)", 1, "poliüretan", "kayış KOLUNA vurur (kol y 48–58, kayışın üstünde) · gergi braketinin önündeki plakada · tekne 1795'te bittiği için plaka tamponu sığmadı"))
    ekle("uc_tamponu_plakasi", kut(1657.4, 1660.4, 45.0, 62.0, -377.0, -366.0), "celik",   # v27 (d): +28,4 (gergi braketi 1628–1672 önünde kalır) · v25: braketin üst yüzüne oturur
         bom=("Tampon plakası 3 × 17 × 10", 1, "304 · gergi braketinin ön yüzüne kaynak", "kayış düzleminin (y ≤ 44) üstünde"))

    for a_, ad_, n_, malz_, gor_ in (
            ("_bom_tabla", "Tabla yasası", 1, "yazılım", "ağız pide merkezine %.0f mm'de 2,5 s bekler, r² doğrusal azalarak %.0f mm'ye iner, 0,3 s bekler [kasar_akis_model_v2]" % (TB["r_dis"], TB["r_ic"])),
            ("_bom_strok", "Strok ve istasyon", 1, "-", "tabla merkezi x %.0f...%.0f (%.0f mm) - park SOLDA - dozajda %.1f mm/s, geciste %.0f mm/s" % (H.X_PARK, H.X_AKTARMA, H.X_STROK, TB["x_doz_hiz"], TB["x_gecis_hiz"])),
            ("_bom_cevrim", "Cevrim", 1, "-", "uzayan strok dahil sure receteye gore sim_makine_v6 tarafindan hesaplanir; doz yasasi 10 s / urun DEGISTIRILMEDI"),
            ("_bom_civata", "Bağlantı elemanları (tümü A4/A2 paslanmaz)", 260, "15 tip · gıdaya bakan her baş HAVŞA ya da KUBBE",
             "v32: ray 118 × M3×10 · kızak ayağı 16 × M3×6 havşa (bloğa) + 8 × M4×12 havşa (plakadan) · yatak 8 × M5×16 · ayar bileziği 6 × M5×16 · göbek 3 × M8×40 saplama + kelebek somun + 2 pim · dönüş motoru 4 × M5×20 · kayış kolu 4 × M8×25 + 2 pim · kelepçe 4 × M5 + 4 × M4 · X motoru 4 × M5×12 + kaide 4 × M8×25 · avara M8×40 + braket 2 × M8×25 + M6 jack · apron 8 × M4×10 · ray çatısı 24 × M3×6 ISO 7380 + uç kapağı 8 × M3 · sensör 12 × M4×12 · zincir 18 · tampon 2 takım M10")):
        ekle(a_, kut(0, 0.1, 0, 0.1, 0, -0.1), "celik", bom=(ad_, n_, malz_, gor_))

    # ---------------- 8d · ACICI — KONILI DONER ACICI (v21) ----------------
    import math as _m
    AC_X, AC_Z = XC_TABLA, ZT
    AC_TEPE = 108.0 + 8.0                       # tepe: disk ustu + pide kalinligi
    AC_L, AC_RB = 140.0, 45.0                   # boy = pide yaricapi · taban yaricapi
    AC_ACI = _m.degrees(_m.atan2(AC_RB, AC_L))  # 17,82 derece

    def _koni(yon):
        """tepesi tabla ekseninde, alt cizgisi YATAY koni. yon=+1 one, -1 arkaya"""
        p0 = cq.Vector(AC_X, AC_TEPE, AC_Z)
        p1 = cq.Vector(AC_X, AC_TEPE + AC_RB, AC_Z + yon * AC_L)
        v = p1 - p0
        k = (cq.Workplane("XY").circle(0.4).workplane(offset=v.Length)
             .circle(AC_RB).loft(ruled=True).val())
        eks = cq.Vector(0, 0, 1).cross(v)
        aci = _m.degrees(_m.acos(max(-1.0, min(1.0, cq.Vector(0, 0, 1).dot(v) / v.Length))))
        if eks.Length > 1e-9:
            k = k.rotate(cq.Vector(0, 0, 0), eks, aci)
        return cq.Workplane(obj=k.translate(p0)), p1

    # z bantlari: her parcanin kendi yeri var, ic ice girmiyorlar

    def _birim(v_):
        l_ = v_.Length
        return cq.Vector(v_.x / l_, v_.y / l_, v_.z / l_)

    def _yonlendir(sh_, hedef_, nokta_):
        """Yerel +Z eksenini hedefe cevirir, sonra nokta_ konumuna tasir."""
        h_ = _birim(hedef_)
        z_ = cq.Vector(0.0, 0.0, 1.0)
        eks_ = z_.cross(h_)
        ac_ = _m.degrees(_m.acos(max(-1.0, min(1.0, z_.dot(h_)))))
        if eks_.Length > 1e-9:
            sh_ = sh_.rotate(cq.Vector(0, 0, 0), eks_, ac_)
        elif z_.dot(h_) < 0.0:
            sh_ = sh_.rotate(cq.Vector(0, 0, 0), cq.Vector(1, 0, 0), 180.0)
        return sh_.translate(nokta_)

    def _eksen_silindir(p_, u_, r_, boy_):
        return cq.Workplane(obj=cq.Solid.makeCylinder(r_, boy_, p_, u_))
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
