kursatkemalkul/autokitch/_local/claude_son_yerel/gece2/adim3/u/arastirma/_uretec/topping_fizik_ihrac_v16.py

# -*- coding: utf-8 -*-
"""TOPPING MODULU -> FIZIK IHRACI (1. asama)

Kemal: "sirada bizim seyi oraya koy topping seyini ... dijital twin kuruyoruz unutma, hersey olmali."

BU DOSYA NE YAPAR: uretim modelini (topping_cad_v11 + 6 kaset) alir, her parcayi
  - agina (ucgen) cevirir              -> Isaac Sim'de gorunur ve CARPISIR
  - hangi HAREKETLI PAKETE ait bulur   -> ARABA / TABLA / HELEZON_x / KARISTIRICI_x / SABIT
  - HACMINI olcer ve KUTLESINI hesaplar-> fizik icin sart (tork, atalet, rampa)
ve tek bir .npz + .json yazar. Ikinci asama (Isaac'in kendi Python'u) bunu okuyup
UsdPhysics eklemli sahneyi kurar.

KUTLE: parcanin gercek hacmi x malzeme yogunlugu. KATALOG parcalarinda (motor, redüktor,
kizak, doner yatak) gövde ici bos oldugu icin hacim x yogunluk YANLIS olur; onlarin kutlesi
KATALOG_KUTLE tablosundan gelir ve JSON'da "kaynak" alaniyla isaretlenir:
    olculdu  = CAD hacminden hesaplandi
    katalog  = uretici/katalog degeri
    VARSAYIM = ne olculdu ne katalog — DEGISTIRILECEK
(bkz. feedback: 'motor koy deyince kutu modelleyip birakiyorsun')
"""
import io, json, math, os, sys
import numpy as np
import cadquery as cq

U = os.path.dirname(os.path.abspath(__file__)); sys.path.insert(0, U)
KOK = os.path.dirname(os.path.dirname(U))
OUT = os.path.join(KOK, "otonom", "hat3d", "fizik")
os.makedirs(OUT, exist_ok=True)

import topping_cad_v21 as TC
import topping_hesap_v5 as H

# ---------------------------------------------------------------- malzeme yogunluklari (kg/m3)
YOGUNLUK = {
    "sac": 7900.0,       # 304 paslanmaz
    "celik": 7900.0,     # 304 / A4 civata
    "koyu": 7900.0,      # kararmis celik parcalar
    "pom": 1410.0,       # POM-C
    "silikon": 1150.0,   # gida silikonu
    "cam": 1200.0,       # PC / PETG seffaf
    "pu": 40.0,          # poliuretan kopuk
    "bakir": 8960.0,
    "kart": 1850.0,      # FR4 elektronik kart
    "motor": 7900.0,     # YER TUTUCU — asagida katalog tablosu eziyor
}

# ---------------------------------------------------------------- katalog kutleleri (kg)
# Not: bunlar parca SECILINCE gercek katalog degeriyle degistirilecek. Simdilik sinif tipik degeri.
KATALOG_KUTLE = [
    # (ad basi,                 kutle kg, kaynak, not)
    ("kizak_blogu_",            0.18, "katalog",
     "HIWIN HGH15CA · GERCEK CAD (TraceParts STEP AP214) modelde · katalog agirligi 0,18 kg "
     "(STEP'in dolu hacmi 0,289 kg verir; gercek arabanin ici bilya yolu ve plastik kapak, katalog degeri esas)"),
    ("motor_kablosu_",          0.02, "olculdu", "2,8 A kablo gudugu"),
    # v9: AC surumden DC surume gecildi (AC motorun surucusu 141x47x114 mm, elektrik
    # bandina sigmiyordu). Kutle ureticinin kendi tablosundan:
    # surestepmotors.pdf s.3, frame 23 / 276 oz-in sutunu -> "Weight 2.2 lb [1.0 kg]"
    ("motor_",                  1.00, "katalog",
     "AutomationDirect STP-MTR-23079 · NEMA23 · 1,95 N·m tutma · 2,8 A · 3,8 mH · 1,1 ohm · "
     "rotor ataleti 0,48 kg·cm2 · IP40 · GERCEK CAD modelde (surestepmotors.pdf s.3)"),
    # surestepdrive.pdf s.2, STP-DRV-4830 sutunu -> "Weight 3.0 oz [85.9 g]"
    ("surucu_",                 0.086, "katalog",
     "AutomationDirect STP-DRV-4830 · 0,35-3,0 A/faz secilebilir · 12-48 VDC · GERCEK CAD "
     "(surestepdrive.pdf s.2). NOT: uretici 'metal yuzeye monte et, isiyi oradan atar' diyor — "
     "DIN ray arkasina metal sirt plakasi gerekiyor."),
    ("donus_motoru",            0.50, "katalog sinifi",
     "NEMA23 pancake 57x57x41 · katalogda 0,6 N·m / 0,88 A · kutle gövde boyundan (57x57x56 = 0,7 kg) olceklendi"),
    # doner yatak artik GERCEK CAD (Schaeffler XU080149) — kutlesi hacminden dogru cikiyor,
    # katalog satirina gerek yok. (Eski varsayim 2,50 kg idi; gercegi 3,27 kg.)
    ("reduktor_",               0.90, "katalog",
     "AutomationDirect SureGear PGCN23-1025 · i=10 · 60x60x79 mm · NOMINAL CIKIS TORKU 5 N·m · GERCEK CAD"),
    # --- SATIN ALINAN BIRIMLER: zarf dogru, kutle KATALOGDAN (masif kutu olarak
    #     olculunce sacma cikiyordu: sogutma 114,7 · evaporator 90,3 (masif bakir!) · UPS 49,5 kg)
    # SOGUTMA PAKETI YAPTIRILACAK (Kemal, 22 Eyl 2026): raftan alinan katalog urunu degil,
    # sogutmaci firma kurar. Uretici STEP'i ARANMIYOR; modelde yer zarfi, kutle sinif degeri.
    ("sogutma_grubu",          26.0, "yaptirilacak",
     "1/5 HP hermetik hava sogutmali kondenser unitesi · sinif tipigi (Embraco/Tecumseh boyu) · "
     "kesin model sogutmaci firma secince belli olacak"),
    ("evaporator",              7.0, "yaptirilacak",
     "400x180x190 fanli unit cooler · alu lamel + bakir boru, ici BOS — masif bakir degil · "
     "sogutma paketiyle birlikte firma kurar"),
    ("fan_0",                   1.2, "yaptirilacak", "Ø200 eksenel fan · evaporatore dahil, ayri alinmaz"),
    # v10: ikisi de GERCEK CAD oldu.
    ("ups",                     0.65, "katalog sinifi",
     "PULS UB10.242 DIN ray UPS · GERCEK CAD. UYARI: ureticinin kendi kutle degerine "
     "ulasamadim (pulspower.com 404, RS sayfasi bos), 0,65 kg DIN ray UPS sinifinin "
     "tipik degeri — DOGRULANACAK. Ayrica AKU MODULU henuz modelde yok."),
    ("guc_kaynagi",             1.00, "katalog",
     "MEAN WELL NDR-240-24 · 24 V 240 W · GERCEK CAD · kutle uretici spec sayfasindan "
     "(NDR-240-SPEC.PDF, PACKING satiri 1 kg)"),
    # v16 · ACICI ve BANT parcalari (topping_cad_v21)
    ("acici_motoru_",           1.00, "katalog", "STP-MTR-23079 · acici konisi tahriki (GERCEK CAD)"),
    ("acici_reduktoru_",        0.90, "katalog", "SureGear PGCN23-1025 sinifi planet · i = 5"),
    ("bant_motoru",             1.00, "katalog", "STP-MTR-23079 · bant tahriki (GERCEK CAD)"),
    # PTFE kapli cam elyaf orgu: yogunluk ~1,5 g/cm3. "koyu" (7900) yogunlugu ile
    # hesaplansa 3 kat agir cikardi.
    ("bant",                    0.60, "katalog sinifi",
     "PTFE kapli cam elyaf orgu 1,5 mm · cevre ~886 x 290 geniş x 1,5 = 385 cm3 x 1,5 g/cm3"),
    ("x_motoru",                1.00, "katalog",
     "AutomationDirect STP-MTR-23079 · NEMA23 · 1,95 N·m tutma · 2,8 A (GERCEK CAD)"),
]


def katalog_kutle(ad):
    for k in KATALOG_KUTLE:
        bas, kg, kaynak, aciklama = k
        if ad.startswith(bas) and kg > 0:
            return kg, kaynak, aciklama
    return None, None, None


# ---------------------------------------------------------------- hareketli paket ayrimi (hat_montaj_v18 ile AYNI)
ARABA_P = ("kizak_blogu_", "araba_plakasi", "doner_yatak", "ayar_bilezigi", "donus_motoru", "tahrik_lokmasi",
           "siyirici_apron", "kayis_kolu", "kayis_kelepcesi_", "tabla_home_sensoru", "tabla_home_bayragi", "x_bayragi",
           "kilit_burcu_")                               # v20: kilit burclari ayar bileziginde -> ARABA ile gezer
# v20: CALISMA DISKI ve DISK PIMLERI tablanin ustunde, onunla birlikte doner.
# Listeye eklenmeyince SABIT sayiliyor ve tabla giderken geride kaliyorlardi
# (Kemal: "su parcalar ne, sil onlari" — ortada duran buyuk beyaz disk buydu).
TABLA_P = ("tabla_gobegi", "tabla", "merkezleme_pimi_", "calisma_diski", "disk_pimi_")


# v21 · ACICI ve BANT hareketli paketleri — animasyon icin AYRI DUGUM yazilir.
# Koniler kendi eksenlerinde doner, kafa dikeyde iner-kalkar, bant silindirleri doner.
KONI_ON_P = ("acici_konisi_on", "acici_mili_on")
KONI_ARKA_P = ("acici_konisi_arka", "acici_mili_arka")
ACICI_P = ("acici_yatagi_", "acici_reduktoru_", "acici_motoru_", "acici_askisi_", "acici_kafa_plakasi")
BANT_TAM = ("bant",)                       # bandin kendisi (yerinde durur)
BURUN_TAM = ("bant_burun_silindiri",)      # doner
TAHRIK_TAM = ("bant_tahrik_silindiri",)    # doner


def grup_modul(ad):
    if ad in BANT_TAM: return "BANT"
    if ad in BURUN_TAM: return "BANT_BURUN"
    if ad in TAHRIK_TAM: return "BANT_TAHRIK"
    if ad.startswith(KONI_ON_P): return "KONI_ON"
    if ad.startswith(KONI_ARKA_P): return "KONI_ARKA"
    if ad.startswith(ACICI_P): return "ACICI"
    if ad.startswith(TABLA_P) and ad not in ("tabla_home_sensoru", "tabla_home_bayragi"): return "TABLA"
    if ad.startswith(ARABA_P): return "ARABA"
    return "SABIT"


# ---------------------------------------------------------------- aglama
def ag(sh, tol=0.12, aci=0.35):
    """CadQuery katisindan (V,F) — METRE cinsinden, cunku Isaac sahnesi metre calisiyor"""
    vs, ts = sh.tessellate(tol, aci)
    V = np.array([[v.x * 1e-3, v.y * 1e-3, v.z * 1e-3] for v in vs], dtype=np.float32)
    F = np.array(ts, dtype=np.int32)
    return V, F


def hacim(sh):
    try: return abs(sh.Volume()) * 1e-9          # mm3 -> m3
    except Exception: return 0.0


# ======================= AG ONBELLEGI =======================
# NEDEN: her kucuk degisiklikte butun montaj (1157 kati, 1,37 M ucgen) sifirdan
# hesaplaniyordu — tek vidayi duzeltsen de 3,5 dakika. Oysa parcalarin %80'i
# KASETLERE ait ve modulu degistirince kasetler hic degismiyor.
# COZUM: her bolumun agi, o bolumu ureten KAYNAK DOSYALARIN ozetine (sha1) gore
# diske saklanir. Kaynak degismediyse bolum diskten okunur, hic hesaplanmaz.
# Kaynak bir harf bile degisirse ozet degisir ve o bolum yeniden hesaplanir —
# yani bayat veri riski yok.
import hashlib, pickle, time

ONBELLEK = os.path.join(U, "_onbellek_ag")
os.makedirs(ONBELLEK, exist_ok=True)


def _ozet(*yollar):
    h = hashlib.sha1()
    for y in yollar:
        try:
            with open(y, "rb") as f: h.update(f.read())
        except OSError:
            h.update(b"YOK")
    return h.hexdigest()[:16]


def bolum(ad, kaynaklar, uret):
    """ad: bolum adi · kaynaklar: bu bolumu belirleyen dosyalar · uret: () -> parca listesi"""
    yol = os.path.join(ONBELLEK, "%s_%s.pkl" % (ad, _ozet(*kaynaklar)))
    if os.path.exists(yol):
        t0 = time.time()
        with open(yol, "rb") as f: ps = pickle.load(f)
        print("   %-18s ONBELLEKTEN  %4d parca  %.1f sn" % (ad, len(ps), time.time() - t0))
        return ps
    t0 = time.time()
    ps = uret()
    with open(yol, "wb") as f: pickle.dump(ps, f, protocol=4)
    print("   %-18s HESAPLANDI   %4d parca  %.1f sn" % (ad, len(ps), time.time() - t0))
    # ayni bolumun eski ozetlerini sil (disk sismesin)
    for f_ in os.listdir(ONBELLEK):
        if f_.startswith(ad + "_") and not f_.endswith(os.path.basename(yol).split("_")[-1]):
            try: os.remove(os.path.join(ONBELLEK, f_))
            except OSError: pass
    return ps


def kur():
    import importlib
    parcalar = []

    # ================= 1) MODUL =================
    # ONBELLEK ANAHTARI: modulu belirleyen kaynaklar. Bunlardan biri degisirse modul
    # yeniden hesaplanir; kasetler etkilenmez.
    KAY_MODUL = [TC.__file__, H.__file__, __file__] +                 [os.path.join(U, "..", "katalog", "step", f) for f in
                 ("hgh15ca.stp", "stp-mtr-23079.step", "stp-drv-4830.step", "pgcn23-1025.step",
                  "xu080149.stp", "ndr-240-24.stp", "ub10-242.stp")]

    def _modul():
        yerel = []
        TC.PARCALAR[:] = []; TC.modul()
        # ON KAPAK CIZILMEZ: kapali kapak kasetlerin onunu tamamen kapatiyor, ikizde
        # hicbir sey gorunmuyordu. Kapak gercek parca, BOM'da ve STEP'inde duruyor;
        # burada ACIK kabul ediliyor.
        GIZLI = ("on_kapak", "on_kapak_pu", "kapak_contasi")
        ps = [p for p in TC.PARCALAR if not p["ad"].startswith("_bom") and p["ad"] not in GIZLI]
        # SATIN ALINAN ELEKTRONIK KABA AGLANIR: gercek surucu CAD'i DIP anahtarlarina
        # kadar modelli, 12 tanesi ucgeni 2,25 M'a cikariyordu. Dis olcu/kutle/carpisma
        # zarfi 0,6 mm toleransta da ayni.
        KABA = ("surucu_",)
        for p in ps:
            sh = p["wp"].val()
            V, F = ag(sh, tol=0.60, aci=0.8) if p["ad"].startswith(KABA) else ag(sh)
            if not len(F): continue
            h = hacim(sh)
            kg, kaynak, aciklama = katalog_kutle(p["ad"])
            if kg is None:
                kg, kaynak, aciklama = h * YOGUNLUK.get(p["mal"], 7900.0), "olculdu", "CAD hacmi x %s yogunlugu" % p["mal"]
            yerel.append(dict(ad=p["ad"], birim="TOPPING_MODUL", grup=grup_modul(p["ad"]),
                              mal=p["mal"], hacim_m3=h, kutle_kg=kg, kaynak=kaynak, not_=aciklama, V=V, F=F))
        return yerel

    parcalar += bolum("MODUL", KAY_MODUL, _modul)

    # ================= 2) KASETLER =================
    # Kasetler KENDI EKSENINDE (tasinmamis) onbellege alinir; yuvaya tasima onbellekten
    # sonra yapilir. Boylece modul degisince kasetler yeniden hesaplanmaz — parcalarin
    # %80'i kasetlerde oldugu icin asil kazanc burada.
    for ad, x0, x1, gen in TC.YUVA:
        mod_ad = TC.KASET_CAD[ad]
        k = ad.replace(" ", "_")

        def _kaset(mod_ad=mod_ad, k=k):
            mod = importlib.import_module(mod_ad)
            mod.PARCALAR[:] = []; mod.kap()
            yerel = []
            for p in mod.PARCALAR:
                if p["ad"] == "tasima_tapasi": continue
                sh = p["wp"].val()
                V, F = ag(sh)
                if not len(F): continue
                gr = p.get("grup")
                grup = "SABIT" if not gr else (("HELEZON_" if gr == "helezon" else "KARISTIRICI_") + k)
                h = hacim(sh)
                # HELEZON / POMPA ROTORU DILIMLENIR: konveks carpisma govdesi helis
                # bosluklarini doldurup vidayi masif silindire ceviriyordu.
                # v12'ye kadar dilimler OCC boolean'iyla kesiliyordu ve basarisiz kesim
                # "except: continue" ile SESSIZCE atiliyordu — kasar helezonunun B ve C
                # segmentleri boyle kayboldu. Artik boolean YOK: parca bir kez aglanir,
                # ucgenler agirlik merkezlerinin z'sine gore 2,5 mm'lik kovalara ayrilir.
                # Kutle, ucgen alaniyla orantili dagitilir; toplam birebir korunur.
                if (p["ad"].startswith("helezon_") or p["ad"] == "pompa_rotoru")                         and not p["ad"].endswith("cekirdek"):
                    DZ = 0.0025
                    c = V[F].mean(axis=1)
                    a_ = V[F][:, 1] - V[F][:, 0]
                    b_ = V[F][:, 2] - V[F][:, 0]
                    alan = 0.5 * np.linalg.norm(np.cross(a_, b_), axis=1)
                    kova = np.floor((c[:, 2] - c[:, 2].min()) / DZ).astype(int)
                    alan_top = alan.sum() or 1.0
                    for q in sorted(set(kova.tolist())):
                        m_ = kova == q
                        Fq_ = F[m_]
                        if not len(Fq_): continue
                        kul = np.unique(Fq_)
                        ix = -np.ones(len(V), dtype=np.int32); ix[kul] = np.arange(len(kul))
                        pay = float(alan[m_].sum() / alan_top)
                        yerel.append(dict(ad="%s__%s_d%02d" % (k, p["ad"], q), birim="KASET_" + k, grup=grup,
                                          mal=p["mal"], hacim_m3=h * pay,
                                          kutle_kg=h * pay * YOGUNLUK.get(p["mal"], 7900.0),
                                          kaynak="olculdu",
                                          not_="helezon kanadi dilimi (carpisma icin) · ucgen kovalama",
                                          V=V[kul], F=ix[Fq_]))
                    continue
                yerel.append(dict(ad="%s__%s" % (k, p["ad"]), birim="KASET_" + k, grup=grup,
                                  mal=p["mal"], hacim_m3=h, kutle_kg=h * YOGUNLUK.get(p["mal"], 7900.0),
                                  kaynak="olculdu", not_="CAD hacmi x malzeme yogunlugu", V=V, F=F))
            return yerel

        kaynak_dosya = importlib.import_module(mod_ad).__file__
        ps_k = bolum("KASET_" + k, [kaynak_dosya, __file__], _kaset)
        # yuvaya tasi (onbellek yerel eksende tutuluyor)
        mod = importlib.import_module(mod_ad)
        xm, z0 = (x0 + x1) / 2.0, TC.ZK[0] - mod.D / 2.0
        ot = np.array([xm, TC.KAS[0], z0], dtype=np.float32) * 1e-3
        for p in ps_k:
            q = dict(p); q["V"] = p["V"] + ot
            parcalar.append(q)

    return parcalar


def yaz(parcalar):
    # ---- eklem tanimlari: makinenin gercek hareket eksenleri
    # X arabasi prizmatik; tabla Y ekseninde doner; kaset milleri Z ekseninde doner.
    # strok, istasyon ve pivot sim_makine.json'dan OKUNUR (kontrol yazilimiyla ayni kaynak)
    with io.open(os.path.join(os.path.dirname(OUT), "sim_makine.json"), encoding="utf-8") as f:
        SM = json.load(f)
    T = SM["tabla"]
    eklem = [dict(ad="X", tip="prizmatik", grup="ARABA", eksen="X",
                  alt=T["strok"][0] * 1e-3, ust=T["strok"][1] * 1e-3,
                  baslangic=T["baslangic_x"] * 1e-3, istasyon=T["istasyon_x"] * 1e-3,
                  hiz_mm_s=T["x_gecis_hiz"], doz_hiz_mm_s=T["x_doz_hiz"]),
             dict(ad="TABLA", tip="doner", grup="TABLA", eksen="Y",
                  pivot=[v * 1e-3 for v in T["pivot"]], rpm=T["rpm"], ebeveyn="ARABA")]
    for a_, x0, x1, gen in TC.YUVA:
        k = a_.replace(" ", "_")
        mod = sys.modules[TC.KASET_CAD[a_]]
        xm = (x0 + x1) / 2.0
        y_ = next(v for v in SM["yuvalar"] if v["kod"] == k)
        for rol, g, kot in (("doz", y_["grup_doz"] + "_" + k, TC.KAS[0] + (mod.CY if y_["grup_doz"] == "HELEZON" else mod.YC)),
                            ("karis", y_["grup_karis"] + "_" + k, TC.KAS[0] + (mod.CY if y_["grup_karis"] == "HELEZON" else mod.YC))):
            eklem.append(dict(ad=g, tip="doner", grup=g, eksen="Z", rol=rol,
                              pivot=[xm * 1e-3, kot * 1e-3, 0.0], ebeveyn="SABIT",
                              rpm=(y_["helezon_rpm"] if rol == "doz" else 4.0)))

    grup_kutle = {}
    for p in parcalar:
        grup_kutle[p["grup"]] = grup_kutle.get(p["grup"], 0.0) + p["kutle_kg"]

    meta = dict(
        modul=dict(w=TC.W, y=TC.Y, d=TC.D, agz=list(TC.AGZ), kas=list(TC.KAS), zk=list(TC.ZK)),
        olcek="metre (CAD mm / 1000)",
        parca=[{k: v for k, v in p.items() if k not in ("V", "F")} for p in parcalar],
        eklem=eklem,
        grup_kutle_kg={k: round(v, 3) for k, v in sorted(grup_kutle.items())},
    )
    with io.open(os.path.join(OUT, "topping_fizik_v1.json"), "w", encoding="utf-8") as f:
        json.dump(meta, f, ensure_ascii=False, indent=1)

    d = {}
    for i, p in enumerate(parcalar):
        d["V%d" % i] = p["V"]; d["F%d" % i] = p["F"]
    np.savez_compressed(os.path.join(OUT, "topping_fizik_v1.npz"), **d)

    ucgen = sum(len(p["F"]) for p in parcalar)
    print("\nPARCA %d · UCGEN %d" % (len(parcalar), ucgen))
    print("GRUP KUTLELERI (kg):")
    for g, kg in sorted(grup_kutle.items()):
        print("   %-24s %8.2f" % (g, kg))
    v = [p for p in parcalar if p["kaynak"] == "VARSAYIM"]
    print("KUTLESI VARSAYIM OLAN %d parca: %s" % (len(v), ", ".join(sorted({x["ad"] for x in v}))[:160]))
    print("yazildi -> %s" % OUT)


if __name__ == "__main__":
    yaz(kur())
