kursatkemalkul/autokitch/(commit log)

2026-08-10 Pitch revizyonu: pizza-odakli anlatim, rol bazli maliyet, sade pazar, bolum 1/2 ayrimi
    - 17 ay / 1,35M gibi dogrulanmamis rakamlar kaldirildi (modul fiyati bos birakildi)
    - Cozum karsilastirmasi pizza restorani ornegine cevrildi (rol + isveren maliyeti)
    - Urun: pizza icin 4 modul; yeni Platform bolumu (tum mutfak gruplari)
    - Sektor: humanoid argümani + birlesik sade kanit blogu; Moat kelimesi kaldirildi
    - Pazar: SAM/TAM jargonu kaldirildi, sade anlatim
    - Silindi: rekabet tablosu, sektor haritasi, 3 yillik hedef, fazlar
    - Site iki bolume ayrildi: Bugunun Isi (moduller) / Vizyon (insansiz mutfak)
2026-08-10 AUTOKITCH 4-bolumlu hub yapisi + maliyet formati duzeltmesi
    - Ana giris artik sifre sonrasi 4 secenekli hub: solda otonom taraf
    (Otonom Endustriyel Mutfak + Tam Otonom Insansiz Mutfak), cizgiyle
    ayrilmis sagda klasik taraf (Fabrika & Yatirim + Fizibilite)
    - Pitch moduller/ sayfasina tasindi; vizyon otonom/ sayfasina ayrildi
    - Maliyet karti: her satir 'rol · N kisi = maas+SGK+vergi toplami',
    altta aylik toplam + kisi basi oldugu notu
2026-08-10 Icindekiler menusu + yatirim cagrilari kaldirildi + Store final tasarimi
    - Her iki sunum sayfasina fizibilite tarzinda sabit Icindekiler (sol, aktif
    bolum takipli); genis ekranda gorunur
    - 'Tohum yatirimi ariyoruz' / 'Birlikte kurmak' CTA bolumleri silindi;
    'Yatirimci Sunumu' etiketleri 'Ozel Sunum' yapildi (hub dahil)
    - Pop-up ornek gorseli yerine kullanicinin kendi FINAL TASARIMI (Pin store:
    siparis ekrani + isikli teslim dolaplari + kurye) — assets/store-final.jpg
    - Ham tasarim klasoru (POP UP Store/) gitignore'da, canliya gitmez
2026-08-11 Fiyat arastirmasi gorsel bolumler olarak sunum sonlarina eklendi
    - Line: 'Tedarik & Yatirim' — ikonlu bilesen fiyat kartlari (pres/bant/nozul/
    firin/cobot), toplam yatirim cubugu + geri odeme (7-12 ay), beyaz bolum
    - Store: 'Makine Fiyatlari' — Cin/Avrupa/ABD uc yol karti, Yo-Kai video karti
    (fiyatlariyla), Fransa saha ekonomisi 4'lu istatistik, bordro-makine kiyas
    cubugu; Icindekiler'e iki sayfada da yeni link
2026-08-13 Store: Tablo & Plan sayfasi — rakip kiyasi, canli maliyet hesaplayicisi, 21 m2 mimari plan, 4 senaryo, 6 acik karar (arastirma verili)
2026-08-13 Tablo: Dominos franchise kesintisi gercek rakamlarla duzeltildi (%12.9 nakit + %3.3 gizli malzeme marji = %16.2), TR'de %46-48 komiser akisi notu
2026-08-13 Store: iki model yapisina gecildi (Model S insansiz 6 m2 / Model M insanli 10 m2) — secim kartlari, S icin ayri mimari plan, konumlar ikiye ayrildi, ekonomi 3'lu oldu; 4 kolonlu maliyet tablosu Tablo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
2026-08-13 Store: Model M senaryo gridi onarildi (kartlar ikiser ikiser), personel gunu karti grid disina alindi; iki modele de 'Konum mantigi ve avantajlar' basligi eklendi
2026-08-13 Sistem semalari: saat cizelgesi tek urune (pizza) gore yeniden yazildi — simit/bowl/kahvaltI cikarildi; Model M gunduz-gece gecisini, Model S kesintisiz akisi anlatiyor
2026-08-13 Maliyet: 'Kac pizza satarsam kurtarir' tablosu — dort model yan yana, basabas noktasindan +%20/+%40/+%60/iki kat senaryolari ve guvenlik payi; hesap motoru hmodel() olarak ayrildi, girdi degisince ca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
2026-08-13 Senaryo tablosu: 'Makinenin parasi ciktiktan sonra' blogu — amortisman bitince sifira sifir noktasi ve aylik/yillik net kar, dort model icin dinamik
2026-08-13 Maliyet: acilir-kapanir yatirim kirilimi — 32 kalem x 2 model (makine/ekipman, tadilat, ilk stok), her kalem duzenlenebilir, ara toplam ve pay hesabi, toplam ana tabloya canli yansiyor
2026-08-15 Kurulum sablonlari: Yol A ve Yol B — yerlesim krokileri + makine/fiyat listeleri
    - Sayfa sonuna #yollar bolumu: iki sablon kutusu
    - Yol A (dusuk risk, pilot): Let's Pizza GEN 2 cekirdek + tasiyici robot kol
    SVG yerlesim krokisi + makine tablosu (toplam 2.888.568 TL makine,
    3.397.169 TL tadilat+stok dahil — maliyet tablosuyla ayni)
    - Yol B (GEN 2 hedefi): kol merkezli acik mutfak — taban istasyonu, N31 pres,
    sos+topping, konveyor firin, kesme+kutulama; SVG kroki + tahmini bantli
    tablo (2,15-3,16 M TL); %3 kesinti yok, teknoloji mulkiyeti + satilabilir urun
    - Karar cercevesi kutusu: iki yol rakip degil ardisik
    - Icindekilere 'Kurulum Sablonlari' eklendi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
2026-08-17 Let's Pizza kesin cevaplar (17 Agu) + Suzumo/Macco durum + para girislerinde binlik nokta
    - Torghele 3 soruyu cevapladi: hamur = uretim tesisinde acilmis + fermente
    hazir taban (makinede mikser/pres/un-su YOK), dolum 90 taban; GEN 3 ayri
    konsept (hamur topundan robotik pizzaci, tarih yok); %3 net ciro sozlesme
    suresince kalici — IoT+destek+veri+yazilim, yerinde servis ve parca HARIC
    - TAM ISABET karti, makine kunyesi (nesil tablosu gercege gore), 90 taban
    kapasite hesaplari, Yol A videosu GEN 2 surec videosuyla degistirildi
    - Suzumo: TR temsilcisi cevapladi — kapsam disi, ilerlenmeyecek
    - Macco: 20 Agu Per 11.00 gorusme daveti notu
    - Para girislerinde binlik nokta (3.397.169); hn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
2026-08-17 Macco: gorusme planlandi (20 Agu Per 11.00, CEO Victor Martin — davet onayla gonderildi)
2026-08-18 1 Pizzanin Maliyet Haritasi: pasta grafigi + maliyet akisi netlestirme
    - Yeni kart: buyuk Model M pastasi (9 kalem, buyukten kucuge, en buyuk kalem
    vurgulu, kalem kalem TL+% lejant) + 4 modelin mini pastasi ve birim maliyet
    karsilastirmasi (M 243 / S 216 / D 208 / P 299 TL) — tablodan canli hesaplanir
    - Menu fiyati satiri 'Satis ve komisyon' grubuna tasindi; hnote: 'bu maliyet
    degil satis fiyati; komisyonlar bunun yuzdesi oldugu icin once girilir'
    - Komisyon hnote: kesintilerin KDV dahil menu fiyati uzerinden hesaplandigi
    aciklandi; pizza basi grubu 'malzeme (KDV haric)' olarak netlesti
    - hpasta() hsen'e baglandi — her giris degisiminde pastalar guncellenir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
2026-08-18 Maliyet iki katmana ayrildi: uretim maliyeti (fiyattan bagimsiz) + satisa bagli
    - Tablo 2 sonu: 1 PIZZANIN URETIM MALIYETI = sabit gider payi + malzeme
    (172,8 TL) — fiyat degisince degismez
    - Tablo 4 sonu: satisa bagli toplam (komisyon + KDV, 83,6 TL) ve
    = 1 PIZZANIN TOPLAM MALIYETI (256,4 TL)
    - 'Gunluk satis varsayimi' -> 'Gunde kac pizza yapiyoruz — uretim adedi';
    aciklama: aylik gideri pizzaya bolmenin paydasi, satis tahmini degil
    - Fiyat satiri: 'yalniz yuzde hesabi icin' — komisyon ve KDV fiyatin yuzdesi
    oldugu icin gerekli oldugu acikca yazildi
    - Pasta lejantina iki ara toplam: uretim %67 / satisa bagli %33
2026-08-18 Saf 1-pizza maliyet karsilastirmasi: adet/fiyat/gelir vergisi kutulari gizlendi
    - Uretim adedi, satis fiyati ve gelir/kurumlar vergisi orani satirlari
    gorunmez (motor ve Yatirim geri-donus hesabi icin DOM'da durur)
    - Kesintiler artik pizzanin KENDI maliyeti uzerinden: matrah = uretim
    maliyeti x 1,10 (yeni gorunen satir); platform/POS/franchise + KDV farki
    bu matrahtan hesaplanir — 'satis fiyati girilmez' sorunu cozuldu
    - Yeni sonuclar (M): uretim 172,8 + kesinti 44,3 + KDV 3,6 = 220,7 TL
    Karsilastirma: M 221 / S 187 / D 197 / P 290 TL — pasta ayni matraha gecti
    - Not: gercek platform kesintisi satis fiyatindan olur; buradaki alt sinir
    oldugu tabloda aciklandi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
2026-08-18 Sabit gider payi geri: 1 pizza maliyetinin parcasi — aylik uretim anlatisi gorunmez
    - '1 PIZZAYA DUSEN SABIT GIDER PAYI' satiri geri geldi (M 79,8 / S 53,7 /
    D 81,4 / P 139,6 TL); hucrede yalniz deger, bolme detayi yok
    - Uretim maliyeti = sabit payi + malzeme + ambalaj (M 172,8); toplamlar
    M 220,7 / S 187,4 / D 197,1 / P 289,9 TL
    - Pasta 10 dilime dondu (dukkan kalemleri dahil); KDV mahsubunda faturalar payi geri
    - Ekranda 'aylik uretim / pizza-ay' ifadesi yok — bolme perde arkasinda
2026-08-18 Yapisal kiyas satiri: 'AYNI SATISTA sabit gider payi' — olcek telafisi kaldirilmis hali
    - Mevcut pay satiri: her model kendi adedinde (M 79,8 / D 81,4) — hnote'ta
    Dominos'un ~3 kat pahali dukkani ~3 kat satisla telafi ettigi yazildi
    - Yeni satir: hepsi Model M'in satis adedinde calissaydi —
    M 79,8 / S 42,2 / D 232,5 (2,9 kati) / P 99,7 TL
    - Mahalle noktasi kiyasi icin asil anlamli olan bu satir
2026-08-18 Platform kesintisi ac/kapa anahtari (platsw): kapaliyken hepsi dukkandan satilmis sayilir
    - Tablo 3 basligina anahtar: kapali -> platform komisyonu 0, %3 kart komisyonu
    tum satisa; ①② satirlari soluklasir
    - Toplamlar kapaliyken: M 187,3 / S 143,9 / D 376,7 / P 205,0 TL
    - Bayrak ak_flags_v1.plat ile saklanir, buluta esitlenir; reset acik hale doner
2026-08-18 Gelir/kurumlar vergisi ac/kapa anahtari (gvsw) — aylik is hesabinda
    Kapaliyken vergi 0 sayilir, vergi oncesi kar dogrudan net kar olur (M: 63.730 TL);
    vergi satiri soluklasir. Bayrak ak_flags_v1.gv ile saklanir ve buluta esitlenir.
2026-08-18 Celiski giderildi: adet artik TEK ve tum kolonlar icin ortak
    Sorun: 1-pizza maliyet tablosu ortak tabana (HREFA) bolerken, aylik is hesabi
    her modelin KENDI adedini kullaniyordu — Dominos 390 TL maliyetle 240 TL'ye
    satip kar ediyor gorunuyordu.
    Cozum: tek adet girisi (colspan, aylik kartta), hread her kolona ayni degeri
    verir; HREFA kaldirildi, her iki tablo da ayni aylikAdet ile calisir.
    70/gun'de: net kar M 57.908 / S 89.570 / D -260.730 / P 99.426 TL — maliyet
    tablosuyla (M 220,7 / D 390,1) artik ayni yonde.
2026-08-18 Adet ayrimi: aylik kar her firmanin KENDI hacminde, maliyet kiyasi ortak adette
    - Aylik Is Hesabi: 4 ayri adet girisi geri (M 70 / S 55 / D 200 / P 50) —
    gercek dunya sonucu: net kar M 57.908 / S 58.192 / D 160.055 / P 27.067 TL
    - 1 pizza maliyeti: hrefAdet() ile hepsi Model M'in adedinde kiyaslanir
    (M 79,8 / S 42,2 / D 232,5 / P 99,7 TL sabit pay) — dev dukkan hacimle
    ucuz gorunemez
    - Sabit pay hucresinde gri dipnot: 'kendi satis hacminde: X TL' — iki taban
    da gorunur, celiski gizlenmez
2026-08-18 (b) geri alindi, (a) plani geri: maliyet kendi adediyle hesaplanir
    Kemal (b) plani sevmedi. 7404748 (tek tablo, (a) mantigi) geri yuklendi:
    1 pizza maliyeti = sabit gider payi + malzeme + kesinti + KDV; adet degisince
    maliyet de degisir (20/gun -> 423,6 TL, 200/gun -> 180,8 TL). Aylik sonuc ayni
    adetten turedigi icin celiski cikmaz.
    Platform komisyonu anahtari (platsw) HTML'e eklendi — JS kablolamasi zaten
    vardi; gvsw ve amortsw yerinde.
2026-08-18 Yan urun katkisi (tek satir) + orta boy kiyas guncellemeleri
    - Yeni giris satiri: 'Yan urun net katkisi — pizza basina' (M/S 20 · D 35 · P 15 TL)
    aciklamada hesap: siparislerin %50'sinde icecek, kola 25 -> 60 TL, +%15 tatli
    Robot kol icecegi sogutucudan alir; ek makine gerekmez
    - Aylik sonuca '+ Yan urun geliri' satiri; kar hesabina dahil
    - Etki: Model M aylik net 5.105 -> 45.860 TL; 190 TL + platform kapali
    senaryosunda 45.300 TL
    - Urun satiri orta boy (25 cm) olarak dort kolonda esitlendi; malzeme 72/72/70/75,
    kutu 8; fiyatlar 240/240/245/300 (SITE EDITOR degisikligi dahil edildi)
2026-08-18 Icecek fiyati + sepet kiyasi: asil rekabet avantajimiz gorunur oldu
    - Yeni satir 'Icecek — musteriye satis fiyati' (M/S 60 · D 160 · P 70);
    her hucrenin altinda otomatik 'pizza + icecek = X TL' sepet toplami
    - Dominos ayni kolayi 130-165 TL'ye satiyor; biz 60 TL'ye satip yine 35 TL
    kar ediyoruz — musteri sepeti karsilastirdiginda fark 100-155 TL
    - 190 TL senaryosunda sepet: biz 250 TL, Dominos 405 TL
2026-08-19 HATA DUZELTME: giris dinleyicisi geri geldi — tablo yeniden canli hesapliyor
    Rakip fiyat satirini eklerken init blogundaki addEventListener satiri yanlislikla
    silinmis, dongusu bos kalmisti; hicbir giris (fiyat, kira, adet...) hesabi
    tetiklemiyordu. Satir geri eklendi.
    Dogrulama: kapi fiyati 190/250/300 -> platform listesi 292/385/462 TL,
    aylik net 34.679/114.791/180.350 TL; kira degisimi de aninda yansiyor.
2026-08-20 Pizza/Pide urun secici + site genelleme
    SECICI (#hesap basinda iki pill):
    - Pide secilince: kolon D 'Usta Pideci' (TAB Gida), P 'Mahalle pideci';
    tum etiketler pide diline doner (Pideyi kaca satacagiz, 1 PIDENIN...);
    pasta '1 Pidenin Maliyet Haritasi'
    - HDEFP pide varsayilanlari: M/S taban 180 TL malzeme 50; Usta Pideci
    taban 230 -> %22 komisyonla platform listesi 295 TL (Getir'de gorulen),
    gunde 150, kira 120k, franchise %9; esnaf pideci 220 TL / 60 adet
    - Iki urunun degerleri AYRI saklanir (ak_hesap_v3 / ak_hesap_pide_v1),
    ikisi de buluta esitlenir; secim ak_flags_v1.urun ile cihazlar arasi tasinir
    - hsReset yalniz aktif urunu sifirlar; kelime donusumu gidis-donus dogrulandi
    GEN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
2026-08-20 Usta Pideci yan urun katkisi 30 -> 90 TL — TAB sepet verisine gore
    TAB 2025: sepet ortalamasi 938 TL/siparis (62,5 mlr / 66,6 mln islem).
    Gunde 90 siparis x 938 = 84 bin TL/gun ciro; 150 pide x 295 = 44 bin —
    fark pide disi satistir (corba, ayran, tatli): pide basina ~267 TL ciro,
    ~90 TL net katki. Boylece bayinin 12-24 ay geri donus vaadi tabloda da
    tutarli hale gelir (kaba P&L: ~615K TL/ay net -> 15M / 615K = 24 ay).
2026-08-23 YOL C eklendi: canli tasarim defteri — Istasyon 1 (HAMUR) karar verildi
    Yol A/B kutularinin altinda tam genislik yesil defter blogu:
    - Kurallar: tek dukkan (merkez mutfak yok), bir kisi, cok az is, yuvarlak pide
    - Istasyon 1 ekipmanlari ozellikleriyle: dik buzdolabi (GN 2/1, 200-240 top,
    motorlu servis kapagi), cukurlu silikon tepsiler (20 top, O12), ilik raf,
    pres adaylari Fersah CP-330 / PZP-400 (secim pilot testiyle), sayacli cop
    haznesi, rezerv dondurucu yuvasi (bos, 600-700 top, robot erisimi bugunden)
    - Nasil calisir: dolum / adresli raf+FIFO / surekli dongu / sure bekcisi /
    gece rutini / insan isi (3 gunde bir 10 dk + gunluk ~1 saat)
    - Siradaki istasyonlar listesi (sos-kasar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
2026-08-23 ISTASYON 3 · FIRIN karar verildi: kompakt konveyor (tek govdeye uygun)
    Tek govde hedefi karari belirledi: uzun tunel sigmaz, kapili hizli firin
    robota kapi actirir; kesisim tezgahustu kompakt konveyor — bant 40-45 cm,
    dis boy <=150 cm, 3-6 kW, ~300C'de 3-4 dk, bantta ardisik 3-4 urun
    (40-60/saat). PLC'den hiz+isi (eko-mod, uzaktan izleme); cikista isitmali
    yag spreyi. Acik alt-karar: standart bant vs tas bant — pilot tadim testi.
    Ornek sinif: Zanolli Synthesis 06/40, Lincoln tezgahustu.
    Kroki: firin + ayaklar + sprey dashed griden yesile cevrildi, bant cizgisi
    ve isi dalgalari eklendi; zone basligi 'IST. 3 · FIRIN' yesil, SIRADAKILER
    saga kaydi. Defterde siradaki karar: Istasyon 2 —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
2026-08-23 Istasyon 3 revize: kompakt konveyor -> MOTORLU KAPAKLI HAZNE (2 kavite, tas taban)
    Kemal'in itirazi hakli cikti: kapali hazne konveyorden az elektrik yakar
    (tunelin iki ucu acik, isi surekli kacar: ~1300-1800 kWh/ay yerine
    ~500-800), dikey istifle az yer tutar, tas taban pide altini verir —
    Pazzi ve konsept renderlarla ayni cozum. Robot kurekle koyar-alir, kapagi
    motor acar. Kapasite 2 kavite donusumlu 25-35/saat; 150+/gun olursa
    3. kavite veya konveyor B plani. Kroki gorseli 2 kapakli hazneye cevrildi.
2026-08-23 Yag spreyi unitesi tam tarifi Istasyon 3'e islendi
    3-4 L isitmali hazne (45-50C, termostat+seviye sensoru PLC'de), sadeyag
    veya tereyagi+aycicek karisimi (pilot tadimi), gida tipi nozul + damla
    onleyici, 3-5 ml/pide porsiyon, kol pideyi altindan tek harekette gecirir;
    gun sonu sicak su cekmeli mini-CIP; hazir food-spraying unitesi alinip
    uyarlanir (100-200 W).
2026-08-23 Yaglama karari: ROBOT SIKAR — ayri istasyon iptal
    v0 pilot: kol tutucusunda sabit aerosol + pnomatik tetik (150 pide/kutu,
    ~0,8 TL/pide); v1 urun: bilege monte isitmali hatli mini nozul (sadeyag,
    arkadaki tanktan hortumla, 3-5 ml PLC porsiyonu, gun sonu mini-CIP).
    Rulo ve sabit sprey istasyonu secenekleri kapatildi. Krokide firin yanindaki
    sprey kutusu kaldirildi, kolun bilegine turuncu nozul isareti eklendi.
2026-08-24 ISTASYON 4 (kesim+kutulama) karar + xRobotics cevabi islendi
    Istasyon 4: Cancan sinifi coklu bicak yildizi + 24V lineer piston (PLC,
    1 sn) + itici plaka -> kutu; kutu magazini + acici; ~15-20K TL. Robot bicak
    tutmaz. Kroki: kutu istasyonu yesil, piston + bicak yildizi cizimi.
    xRobotics (24 Agu, Igor Buchatskiy VP): SATIS VAR 39.000 USD EXW + 1.200
    nakliye + gumruk (~2,2M TL); Turkiye 'yes we can'; yalniz yuvarlak (bizim
    pide yuvarlak — itiraz gecersiz); ici 2-5C sicak yag giremez (bizde firin
    cikisinda); kasar/sucuk numune istiyor. Kart durumu guncellendi.
2026-08-24 Istasyon 4'e kutu hatti detayi: piyasada hazir yok, kendimiz yapiyoruz
    Yassi kutu katlama (insan, 3 gunde bir 10 dk) -> yayli raf en alttakini
    surer -> pide itilir -> sabit egik sac kapagi motorsuz kapatir -> robot
    alir. Hareketli parca yalniz itici. v1'de vakumlu otomatik katlayici.
2026-08-24 ISTASYON 5 · QR teslimat dolabi + icecek karar verildi
    Cift kapili (gecisli) isitmali gozler (~60C, 10-12 adet, LED durum);
    icecek ayni goze; siparis-goz eslesmesi + sure bekcisi PLC'de; tedarik:
    Carter-Hoffmann/Hatco sinifi hazir, Winnsen (mail beklemede), yerli
    kargomat ureticisine custom — ~150-400K TL. Kroki: dolap yesil, dolu
    gozler + LED; SIRADAKILER basligi kalkti. Kalan tek karar: Istasyon 2.
2026-08-24 Istasyon 5 goz mekanizmasi kesinlestirildi + yerli tedarikci adaylari
    Tek merkezi QR kamera; goz basina motorlu on kapak (sikisma emniyetli),
    yayli arka kapakcik (robot tarafi kilitli ic hacim — motor gereksiz),
    kizilotesi doluluk sensoru, termostatli isitici, LED. Tam sekans islendi
    (koy->eslestir->okut->ac->bosal->3-5sn->kapan). Yerli adaylar: Kutu
    (kutu.tech), Metasel; isitmali govde bilgisi S2000/Oskar/Asaf sinifi.
2026-08-24 Icecek sogutucusu kurgusu + kombine robot eli karari
    Egimli kanalli sogutucu (2x kutu kola, ayran, su, 1L siseler altta),
    serit perdeli acikllik, robot hep kanal agzindan alir; stok sayaci
    yazilimda. Robot eli: TEK kombine el — kurek yuzu + silikon pedli genis
    pence (0-110mm), bilek cevirince yuz degisir; tool changer yok; kol
    10 kg tasima sinifi.
2026-08-24 Sachet cozumu + SATIN ALMA LISTESI (kroki sirasiyla, 16 kalem)
    Sachet: eleman kutu katlarken icine pecete+mendil+pul biber seti atar —
    mekanizma 0, robot isi yok; v1'de friction feeder opsiyonu.
    Satin alma listesi: her parca ozellik + aday marka/firma (linkli: Fersah,
    Gold Medal, Cancan, Kutu, Metasel) + tahmin bandi; yesil=hazir alinir,
    turuncu=entegrator imalati. Kaba toplam 1,7-2,9M TL — Model S yatirim
    kalemiyle capraz kontrol notu.
2026-08-24 Ayri satin alma tablosu kaldirildi; marka/fiyat/link bilgileri istasyon bloklarina dagitildi
    Kemal'in istegi: bilgiler hat cizimin altindaki istasyon yazilarinin
    icinde olsun. Buzdolabi (Inoksan/Oztiryakiler/Frenox ~70-120K + kapak),
    tepsiler (~400-700 TL/adet), ilik raf (10-15K), pres (Fersah link,
    100-300K), rezerv dondurucu (80-150K), firin (Empero/Atalay 2x30-60K +
    motorizasyon), Gold Medal + Cancan + Kutu + Metasel linkleri, kol adaylari
    (Dobot/Fanuc/UR + ray + el + PLC + sasi fiyat bantlari) ve kaba toplam
    (1,7-2,9M) ilgili satirlara islendi.
2026-08-27 Krokiye BEYIN kutusu eklendi: pano rafi (PLC + mini PC + bulut)
    Ilik raf/pres ustundeki bos duvar alanina mavi pano kutusu — uc modul:
    PLC (refleks), MINI PC (akil), 4G/WiFi->bulut. OMURGA+BEYIN blogunun
    gorsel karsiligi.
2026-08-28 Yol C: Ist.1 stok mimarisi (168+72+12), 72 saat kurali, min-max doldurma + cozulme bekcisi, 4 gunluk siparis ritmi, kademeli tahmin motoru
2026-08-29 Ist.1: envanter kurali — goz sensoru yok, kayit defteri + alma aninda bilek kamerasi dogrulamasi
2026-08-29 Omurga + Ist.5: kombine el soft-gripper parmak seti + kavrama kurallari
2026-08-29 Omurga: kombine el semasi gorseli + adaptif 2F-140 detayi
2026-09-03 TOPPING v5: sogutma gercek boyut 25 cm, kasetler 35 cm, elektrik bolmesi
2026-09-03 TOPPING v6: kaset kapasiteleri 3 gunluk (kasar ~20 kg)
2026-09-04 Robot tepsi ucu (Kemal): TOPPING v8 tabla kalkti, OVEN tepsiyle, PACK egerek kutuya, OMURGA uc degistirici + tepsi + pence; problem defterleri
    [ist3_topping8.py, make_topping8.py]
2026-09-05 HAT v45.1: XML kırığı (⑨ '<') düzeltildi, STORE −18 çekmecesinde TOPPING kapları (kıyma/kuşbaşı 16×54×24)
2026-09-07 HAT · Yol C sitesi: otonom/hat/ (3B dükkan + makine sahneleri, 10 birim sayfası, aynı 6 başlık); Store sayfasından Yol C araştırma bloğu kaldırıldı, nav linki eklendi; arastirma: TOPPING v27, OVEN v2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
2026-09-08 STORE: çekmece tahrik sistemi (motor + kayış + sensör) modeli, detay animasyonu ve site sayfası
    - SolidWorks: çekmece derinliği 700, arkada 57 mm motor yuvası; 17 motor grubu + 34 kasa rayı + kayış + kablo ana modelde
    - Çekmece içerikleri: yuvalı tepsilerde 280 kola, 42 şişe, 160 taze + 80 donmuş hamur topu
    - Site: otonom/hat/cekmece.html (tahrik sistemi detayı + animasyon), store.html'e tıklanabilir 3B dolap
    [BLANK_karton_E_dalga_1.6.SLDPRT, CEKMECE_1L.SLDASM, CEKMECE_DETAY.SLDASM, CEKMECE_TAHRIK_DETAY.SLDASM, CEKMECE_donmus.SLDASM, CEKMECE_icecek.SLDASM, CEKMECE_taze.SLDASM, CEK_1L_kayis_baglanti_pabucu.SLDPRT]
2026-09-11 sim: KOMBİNE EL doğru modellendi — kavrama/kürek modu tek uçta, mod geçişi çalışma anında çözülüyor; AYRI UÇLAR seçeneğinde robot PRESS'teki uç istasyonuna gidip gerçekten uç değiştiriyor
2026-09-11 sim: TOPPING'de tepsi bırakma kaldırıldı (raf yok — robot tepsiyi dozaj ağzında tutar); her ürün kendi tepsisinde, hazne çok slotlu — iki lahmacun aynı göze ayrı ayrı konur
2026-09-11 sim: SİPARİŞLER tablosu netleştirildi — geldi/hazır saatleri ayrı, teslim edilen süre sabit yeşil, bekleyen canlı sayaç, ürünlerin bulunduğu istasyon kolonu
2026-09-11 sim: teslim süresi saniye cinsinden de gösteriliyor (tablo + PICKUP gözü)
2026-09-11 sim: veriye dayalı senaryo seti (Yemeksepeti 17-20 = %36, tepe 18:00) — öğle/akşam/cumartesi/büyüme/iftar + ayarlanabilir sürekli akış; Poisson geliş + tekrarlanabilir tohum + 'başka akşam' düğmesi; 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
2026-09-11 sim: içecek artık robotun boş zaman işi — ürünler fırındayken taşınıyor, yeni ürün başlatmanın önüne geçmiyor; sipariş yalnız içeceği bekliyorsa acil önceliğe çıkıyor
2026-09-11 sim: kesici PACK'teyken masa doluysa robot fırından pide almıyor (kesici tek, sıra var) — sipariş kaybına yol açan kilitlenme düzeltildi
2026-09-11 sim: kesici konumu üçüncü seçenek — OVEN işlem ağzında masa (robot bırakıp gider); kesici masası dolu iken fırından pide alma blokajı her masa moduna genişletildi
2026-09-11 sim: HAT DENGESİ paneli — her istasyonun doluluk yüzdesi (robot/fırın/pres/topping/kesici/pack/pickup), darboğaz ve boş duran istasyonlar
2026-09-12 maliyet hesabı: kişi kişi personel maaşı + makine künyesi kaldırıldı
    - "Aylık personel gideri" tıklanınca Kişi 1-6 satırları açılır; bir kolonda kişi
    maaşı girilirse personel gideri kişilerin toplamı olur, boşsa kişi sayısı × maliyet
    - otonom/makine/ (Makine Künyesi) sayfası silindi; sağ üst link, 14 "künye ↗" linki
    ve not paragrafındaki yönlendirme kaldırıldı
    - Sağ üste "Maliyet Hesabı ↗" (yeni sekmede #hesap)
    - Not: pizza malzeme ₺72 + paket ₺10 -> ₺90 + paket ₺8
2026-09-12 maliyet hesabı ayrı sayfaya taşındı: otonom/maliyet/
    - #hesap (Maliyet Hesabı) + #yollar (Kurulum Şablonları, Yol A/B — hesabı besliyor)
    yeni sayfada; şifre kapısı, Firebase eşitleme, stiller ve JS birlikte taşındı
    - Yeni sayfa menüsü: ← Store · HAT · Yol C → · Hat Simülasyonu ↗; bağıl yollar düzeltildi
    - Ana sayfa: iki bölüm, ilgili CSS/JS/Firebase silindi (355 KB -> 219 KB);
    sağ üst "Maliyet Hesabı ↗" ve metindeki iki link maliyet/ sayfasını yeni sekmede açar
2026-09-12 maliyet: malzeme maliyeti otomatik — alış fiyatı (TL/kg) × tarif gramı
    - 3. tablo "Malzeme alış fiyatları" (açılır kapanır, 12 malzeme, kaynak notlarıyla):
    un 27, kaşar 420, kıyma 690, mozzarella 533, sucuk 832, salça 64, yağ 112,
    soğan 16,5 / domates 27 / sivri biber 37,5 (İstanbul hali 10 Eyl), maydanoz 12,75, pul biber 270
    - Ürün bloklarında tarif gramları + fire %; "Malzeme maliyeti — otomatik" dökümlü
    (pide 160 g un + 130 g kaşar + 10 g yağ = 60,0 · lahmacun 41,0 · pizza 102,5 TL)
    - Rakip kolonlarındaki ±%10 malzeme varsayımı kaldırıldı: dört kolonda aynı fiyat
    - Önceki kâbul: sucuk 450 ve salça 120 kaynaksızdı; Bizim Toptan fiyatlar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
2026-09-12 maliyet HATA DÜZELTME: fiyat adetle kayıyordu — artık fiyat sabit, kâr adetle değişir
    - Hata: fiyat = (maliyet + kâr) / d her hesapta yeniden türetiliyordu; adet düşünce sabit gider payı
    artıyor, fiyat da yükseliyor, toplam kâr hep adet × kâr kalıyordu (Usta Pideci 50+50'de bile kârlı).
    - Düzeltme: satış fiyatı (pd_/lh_/pz_fiyat) karar ve sabit; "Kâr ekle" fiyatı bir kez belirler,
    kâr kutusu o adetteki gerçek kârı gösterir (eksiye düşebilir). Fiyat doğrudan da yazılabilir.
    - Yeni satır: Başabaş — günde kaç ürün (fiyat + ürün karışımı + yan ürün katkısıyla)
    - Eski kayıt: ekranda görülen fiyat sabitlenir (kayıtlı kârdan geri hes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
2026-09-12 maliyet: içecek hesabı — satış/alış fiyatı + oran, aylık sonuca net kâr satırı
    - Yeni girdiler: içecek alış fiyatı (KDV hariç, 40 TL) · satılan ürünlerin yüzde kaçına içecek eşlik ediyor (%25, dört kolon)
    - İçecek satış fiyatı: Model M/S 60 TL, Usta Pideci / mahalle 80 TL (Kemal); eski 90/70/40 tahminleri bir kez 80'e
    - 1 içecekten kalan = satış × (1/1,10 − kart %3 − franchise/1,10) − alış; platformda liste fiyatı aynı kârı bırakacak kadar yükselir
    - Aylık sonuç: "+ İçecek net kârı" satırı (%25 ve %50 senaryoları birlikte), başabaşa dahil; "Diğer yan ürün (tatlı vb.)" 0 ayrı
    - Sonuç (%25): M +16.467 TL/ay (1.292 içecek × 1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
2026-09-12 maliyet: baştan sona denetim düzeltmeleri
    - Pizza→pide metin değiştirme kaldırıldı; başlıklar (Usta Pideci / Mahalle pidecisi), lejant,
    enerji/ikmal/sabit gider notları, yatırım kalemleri ve alt not sabit ve güncel yazıldı
    - KDV: malzeme alışı %1 (temel gıda), ambalaj/fatura %20, platform komisyonu ve franchise faturası %20
    (nakit ödenir, beyannamede düşülür) — kâr değişmez, KDV ve komisyon satırları gerçeğe uydu
    - Geri dönüş ve açılış nakdi markaya giriş bedelini (isim) içerir (Usta Pideci 8M+7M)
    - Varsayılanlar: mahalle pidecisi pide 350 TL (kendi kuryesi), 90 pide + 225 lahmacun (Kemal'in esnaf verisi);
    Usta Pideci 60 + 90 = 150/gün (TA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
2026-09-13 sim: 13 Eyl kararlari hat simulasyonuna islendi
    - satis gunde 80 pide + 200 lahmacun; aksam piki 53, cumartesi 74 siparis
    - OVEN 3 hazne ortak havuz, ayri lahmacun firini yok
    - STORE v6 271 cm: hamur 3 gun taze, dondurucu yok, icecek 504 kutu, 1 L yok
    - TOPPING 14 yuva / 12 kaset, PACK sarjor 506 blank
2026-09-13 sim + sim_bant: cikan urun sayaci (pide / lahmacun / icecek)
    Metrik seridine "cikan urun" kutusu ve anlik hesaba satir eklendi; iki simde de
    ayni sayac, karsilastirma icin.
2026-09-14 sim_karsi: tabla - bant karsilastirma simulasyonu (solda tabla, sagda bant)
    Iki motor ayni saatle, ayni siparislerle kosar. Tabla: robot hamuru tablaya
    koyar, pres tablanin ustune basar (ors), tabla kasetlerin altinda doner+kayar,
    iterek firin bandina verir, bos doner. Bant: pres -> aktarim -> surekli bant,
    baslik altinda dozaj, firin sirasi yoksa bant durur. Firin, robot, kesme, kutu,
    dolap ikisinde ayni. Karsilastirma tablosu, kapasite ve tam yuk hesaplari,
    adim/sure tablosu. Ana sayfa ve sim_bant'a link.
2026-09-17 maliyet: eksik kalemler — hazır hamur topu, pide menü karışımı (kıyma/kuşbaşı/sucuk), limon, reklam, ilaçlama/hijyen, bakım her zaman, ikmal 2 günlük ritim, Yol C yatırımı
2026-09-17 maliyet: Kemal düzeltmesi — pide yalnız kaşarlı, limon/ilaçlama/ikmal satırları kalktı, bakım yalnız yatırım açıkken
2026-09-17 sim3d v2: ağızlar gerçek boşluk, çatal uç, tam döngü (tepsi→pres→hamur→topping spiral→fırın→kesim→sprey→kutu→QR), erişim + çarpışma ölçümü, dirsek seçimi
2026-09-17 sim3d v3: pim+parmaklı el (çatal yok), tepsi sokete, pres kızağı, içecek/tatlı şarjörü, otomatik fırın/QR kapakları, kutu tepside, mesafe/hız tabanlı süreler, akşam piki çizelgeleyici + KPI + Gantt
2026-09-18 HAT v13 (taslak): pano bolmesi firinlarin ustunde, makinede ekran yok (tablet) — FR5 alt sprey agzina yetismiyor, karar bekliyor
2026-09-18 HAT v16: D kolonu 200 asagi, firin panosu kaldirildi, pres agzi asagida (plaka 1150) motor ustte
2026-09-18 HAT v17 + sim3d v7: 3B erisim taramasi — omuz 970, ray z 360, D kolonu 285'ten; 3 firin gozu dahil her istasyon erisilir; omuz ekseni korumasi
2026-09-18 3D sim: iki robot dinamik gorev dagitimi — yapabilen robot isi alir, SAG firin kolonuna sagindan yanasir, ince ray kilidi (araba + kol + acik cekmece araliklari), is sonunda kendi tarafina cekilme, f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
2026-09-18 sim3d + pafta v19: 3 fırın gözü de pide/pizza/lahmacun (süre ürüne göre), yalnız-pide / yalnız-lahmacun tam yük senaryoları
2026-09-19 sim3d_bant_tabla: tablalı hatta Atosa üretici verisi (≤ 1 dk / pizza) → tabla turu en az 60 sn; takt üç adaydan seçilir
2026-09-19 sim3d_bant_tabla: bantlıda fırın sırası bekleme noktası ağzın 350 mm gerisinde (ürünler üst üste binmiyor)
2026-09-19 karşılaştırma: her hat bitince 3D görüntünün üstünde sonuç penceresi (çubuk sona çekilince de açılır, ✕ ile kapanır)
2026-09-19 sim3d_bant_tabla: OPT.ic2 anahtarı (içecek + tatlıyı ikinci robot taşır) — iki robotlu üst sınır ölçümü için
2026-09-19 sim3d: ROBOTLU HAT + ATOSA TABLASI varyantı (?tabla=1) — tabla tepsiyi pres altından dozaja ve fırın ucuna taşır, robot yalnız alır/koyar
2026-09-19 sim3d: deney anahtarları — OPT.sagKutu (sağ robot yalnız kutu+QR) ve OPT.kutu3 (kutu işi robottan alınır, üst sınır)
2026-09-19 sim3d: OPT.hayalet — ray kilidi kapalı (iki robot birbirinin içinden geçer), teorik üst sınır ölçümü
2026-09-20 sim3d: AÇIK KORİDOR modu (?akis=acik) + çift ray ve istasyon kilidi deneyleri
    Kemal'in tarif ettiği akış: pres · dozaj · fırın · kesim+sprey · kutu ağızları
    aynı derinlikte (z −400) ve ön yüzleri açık → tepsi ağızdan hiç çıkmaz, robot
    onu tabla gibi yana kaydırır. Kesim ile sprey tek ağza alındı.
    Ölçüm (tam yük, 2. saat): 1 robot 24→28 · 2 robot 35→38 · çift ray 37→44 ·
    çift ray + 2. pres 42→46. Robot işi 149→124 s/ürün (kol hareketi 106→81 s).
    Uyarı: çekmece kolonları bugünkü yerinde kalırsa 34 temas çıkıyor.
    Ek deney anahtarları (varsayılan kapalı): OPT.ciftRay (robotlar ayrı eksende),
    OPT.toppingAyri (kaşar/harç ay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
2026-09-20 sim3d_bant_tabla: 2. robot seçeneği (bantlı + Atosa tablalı hat)
    SOL robot yalnız hamur (pres / tabla ucu), SAĞ robot kutu + QR + içecek/tatlı.
    İkisi aynı rayda: görev boyunca süpürdükleri x aralıkları çakışırsa sonra gelen bekler.
    3D'de ikinci robot turuncu olarak çizilir (S.n ile görünürlük).
    2 robot için iki düzeltme: takt artık hamur+kutu toplamı değil max(hamur,kutu)
    (işler paralel kollarda), ve kutu ileri-bakış kuralı SOL robota uygulanmıyor.
    Ölçüm (tam yük, 2. saat) · Atosa tablalı: içeceksiz 57→58, içecekli 41→56.
    Bantlı: içeceksiz 54→55, içecekli 44→55. İçeceksizde fırın tavanı (60) bağlıyor,
    kazanç içecek taşımanın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
2026-09-20 sim3d_bant_tabla: içecek çekmecesi sağ uca alındı (x 3890–4510)
    K·KESME modülünün altına, QR dolabının hemen soluna. 2 robotta SAĞ robot
    içecek için hattın soluna inmiyor → iki robotun birbirini beklemesi sıfırlandı
    (saatte ~25 dk kayıp gitti). ?icecek=sol ile eski yer.
    Ölçüm (tam yük, 2. saat, içecek + tatlı dahil):
    Atosa tablalı 2 robot 56 → 58 · bantlı 2 robot 55 → 56 · ray beklemesi 1531 s → 0.
    Tek robotta değişmiyor (41–42). Çarpışma taraması: her iki hatta 0 temas
    (ilk deneme x 3990–4610'da 1 temas vermişti, 100 mm sola alındı).
2026-09-20 sim: tek hat sayfalarına sonuç kartı + 2. robotun animasyonu düzeltildi
    1) sonuc_kart.js (ortak): oynatma sonuna gelince 3D görünümün üstünde sonuç kartı
    çıkar — saatlik ortalama, saat saat çıkan ürün, bekleme, robot doluluğu, fırın,
    ölçümle bulunan darboğaz. Karşılaştırma ekranındaki kartın tek sayfa sürümü;
    iframe'de (PANELSIZ) çıkmaz, orada kendi kartı var.
    2) sim3d_bant_tabla oynatıcısı her bloğu ROB[0]'da oynatıyordu → 2 robot seçilince
    sağdaki kıpırdamıyordu. motor() artık S.ri=b.ri kullanıyor, hazirla() iki robotu
    da başlangıç konumuna alıyor, durum satırı SOL / SAĞ ayrı yazıyor.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
2026-09-20 sim3d_bant_tabla: yeni hat · ATOSA TABLA + 4 KAPALI GÖZ (?hat=goz)
    Konveyör fırın yerine 4 kapaklı göz. Robot ürünü tabladan kürekle alıp göze
    sürüyor, pişince alıp kesme plakasına bırakıyor; bıçak + sprey + itici + kutu
    yine makine. Her ürüne kendi süresi (pide 240 / lahmacun 120 s).
    Geometri: göz iç 360×360, iç yükseklik 100 (ürün 25 + üst boşluk 75), gövde 165
    → 4 göz 700–1360 mm. Fırın kolonu 650 mm olduğu için kesme, kutu, QR ve içecek
    700 mm sola kaydı: HAT 5300 → 4600 mm. Tabla ucu 2330 → 2560 (topping modülünün
    dışına, robot küreği oraya giriyor).
    Ölçüm (tam yük, 2. saat): 1 robot 31 içeceksiz / 26 içecekli · 2 robot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
2026-09-20 sim3d_bant_tabla: konveyör fırın ürün sayısı parametresi (?firin=3)
    Fırın kısalınca kesme, kutu, QR ve içecek de kayıyor → hat boyu ona göre.
    3 ürünlük fırın: hazne 1050, hat 5300 → 4950 mm, fırın tavanı 45/saat.
2026-09-20 sim: karşılaştırma ekranı ve hat seçiciler üç seçeneğe göre yenilendi
    Karşılaştırma artık A · Atosa tablalı + konveyör, B · Bantlı + konveyör,
    C · Atosa + 3 kapaklı göz gösteriyor. Robot sayısı seçici A ve B'ye uygulanıyor,
    C tek robotla sabit. Sonuç kartlarının darboğaz hesabı üç hat için de doğru
    (tabla turu, fırın doluluğu, ray paylaşımı; göz sayısı 3'e göre).
    Hat seçicilerde elenen kurgular "arşiv ·" ön ekiyle duruyor — silinmedi,
    sim3d/ adresinden açılabiliyor.
2026-09-20 site + sim: üç seçeneğe göre güncelleme, C paftası çizildi
    - Gözlü hat varsayılanı 4 → 3 göz (4 göz elendi: 3'le aynı çıktı veriyordu)
    - sim3d (robot kollu v19 ve türevleri) sayfasına ARŞİV uyarısı
    - sim3d_bant_tabla alt başlığı A · B · C'yi anlatıyor
    - otonom/index: "2 sabit robot kol + 3 kapaklı göz" kararı → üç seçenek özeti;
    hat ölçüsü 5,7 m → 5,30 (A/B); pişme süreleri ölçümle uyumlu hale getirildi
    - otonom/hat/index: sayfanın 14 Eyl'deki 420 cm'lik tepsili hattı anlattığı,
    güncel üç seçeneğin ölçü ve kapasiteleri üst kutuda belirtildi
    - YENİ PAFTA: HAT_ATOSA_GOZLU_v1_teknik.png (C seçeneği) — 3 kapaklı göz,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
2026-09-20 hat: A seçeneğini kısaltma alternatifleri + C paftası sayfaya eklendi
    YENİ PAFTA: HAT_KISALTMA_v1_teknik.png — MEVCUT ve dört alternatif yan yana,
    modül serileri, kazanılan mm, dükkân sınırı (3900) ve boş hacim kullanımı.
    ALT-1 kesme kutunun içine (K + E tek gövde) −600 mm
    ALT-2 hazne sırası iki kata (3 üst + 3 alt) −530 mm
    ALT-3 ikisi birden → 4170 mm
    ALT-4 ALT-3 + depo hat içinde (1311 L / 3972 L boş cep) → ayrı depo ihtiyacı sıfır
    DÜZELTME (kural ihlali): içecek çekmecesi bugün 3890–4510'a alınmıştı ve F ile K
    modüllerinin sınırını kesiyordu — "istasyon = kapalı ürün" kuralına aykırı.
    4020–4580'e çekildi, K·KESME mod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
2026-09-20 DÜZELTME: stok kuralı 2 gün (Kemal, 20 Eyl) — 3 gün / 7 gün hesapları geçersiz
    Kısaltma alternatifleri ve depo analizi yanlış stok süresiyle kurulmuştu.
    Geçerli kural 16 Eyl'den beri "her şey 2 günlük, 2 günde bir tedarik".
    Düzelen rakamlar:
    - Hamur: 20 çekmece 560 top = 280 ürün × 2 gün → TAM TUTUYOR, açık yok
    (yanlış hesapta 271 L açık görünüyordu ve ALT-4'e gereksiz 7. sıra çekmece koymuştum)
    - Yedek depo toplamı 1311 L → 732 L: içecek yedeği 420 kutu 142 L · kutu 2 gün
    fazlası 229 blank 111 L · UPS + pano 268 L · kaşar+sucuk 45 L · tatlı 61 L ·
    peçete/poşet 25 L · boş kaset 80 L
    - Hatta 3972 L kullanılabilir cep var, yerle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
2026-09-20 GERİ ALMA: içecek + tatlı çekmecesi eski yerine (K3 üstü, x 1372–1992)
    Kemal: "önceki haline al, bir kazancı yok." Doğru — tek robotta fark yok
    (41 ↔ 42). Kazanç yalnız 2 robotlu çalışmada vardı (içecekli 56 → 58, iki
    robotun birbirini bekleme süresi 1531 s → 0).
    Varsayılan artık eski yer; ?icecek=sag ile sağ uç denenebilir.
    C seçeneğinin paftası da eski yere göre yeniden çizildi.
    Ölçüm (tam yük, 2. saat): A 1 robot içecekli 41 · 2 robot içecekli 56 ·
    2 robot içeceksiz 58 · C 26. Çarpışma 0.
2026-09-20 karşılaştırma seçmeli oldu · C seçeneği HAT 2 KOL v19 ile hizalandı
    1) KARŞILAŞTIRMA EKRANI: hatlar artık sabit üç sütun değil. Alt bardan
    istediğini seç, KARŞILAŞTIR'a bas — seçtiklerin yan yana açılır, tek
    seçersen tam ekran olur. Seçim localStorage'da saklanıyor.
    Listede beş hat var: A tablalı · B bantlı · C robot kollu (v19) ·
    tabla + kürek varyantı · açık koridor.
    2) C SEÇENEĞİ = ROBOT KOLLU HAT v19. Paftası (HAT_2KOL_v19) ile simi
    (sim3d) artık aynı kurguyu gösteriyor: tepsili akış, robot her istasyona
    taşır, 3 kapaklı göz, hat 3900 mm — dükkâna sığan tek seçenek.
    C sütununun bütün rakamları bugün yeniden ölçüldü: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
2026-09-20 kaset3d: Picnic hopper kurgusunda detaylı kaset modeli (bizim ölçülerde)
    Kemal'in gönderdiği Picnic CHEESE HOPPER fotoğraflarındaki kurgu, bizim
    16 Eyl ölçülerimizde: şeffaf huni gövde (üst 140 → alt 70), altta şeffaf
    tekne içinde yatay helezon (mil Ø20 · kanat Ø56 · 7 tur), ucunda konik
    çıkış + kaplin bileziği, üstte contalı kapak, ön yüzde sarı etiket bandı,
    iki yanda ayak + arka ayak, arkada asma tırnakları.
    Kaşar kabı aynı kurgunun 280 mm genişliğindeki hali, helezonun üstünde
    dikey karıştırıcı var.
    Çok parçalı glTF: her parça kendi malzemesiyle (şeffaf gövde alpha blend,
    beyaz POM helezon, sarı bant, koyu conta). GLB + USDZ, AR'de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
2026-09-20 kaset3d v3: Picnic hopper formu tam detay — radyuslar, vidalar, yazılı bantlar
    Kemal: "bu ne dümdüz kare, ben sana tam detaylı, radyusu vidasına kadar."
    v2 kutu gibiydi; v3 fotoğraflardaki gerçek formu izliyor, zarf bizim ölçümüz.
    - gövde sabit kesitli ekstrüzyon: dik duvar → C1 sürekli büyük radyus → tekne yarım dairesi, 3 mm cidar (dış + iç yüzey)
    - iki uç plakası masaya iner, AYAK olur; radyus köşeler + kemer boşluk
    - radyus köşeli flanş + kapak + tutamak
    - önde ŞEFFAF ÇIKIŞ TÜPÜ, içinden geçen kalın kanatlı helezon (mil Ø20 · kanat Ø56 · hatve 48, analitik helikoid normalleri), konik mil ucu
    - paslanmaz TEL KARIŞTIRICI (iki çerçeve),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
2026-09-20 kaset3d: iPhone AR dosyası onarıldı — "açılamadı" hatasının sebebi geçersiz prim adı
    Kemal telefonda AR'de açmayı denedi, "açılamadı" dedi. Sebep: USDZ'yi elle metin
    (.usda) olarak yazıyordum ve üç parçanın adında eksi işareti vardı
    ("gobek_kulak_-1", "vida_gobek_-1", "yiv_gobek_-1"). USD'de prim adı yalnız
    harf/rakam/alt çizgi olabilir → dosya hiç parse edilemiyordu. Pixar USD ile
    doğrulandı: "'gobek_kulak_-1' is not a valid prim name".
    Onarım: USDZ artık Pixar'ın resmi kütüphanesiyle (usd-core) yazılıyor —
    ikili .usdc + gömülü PNG dokular, UsdUtils.CreateNewARKitUsdzPackage ile
    paketleniyor, adlar temizleniyor, her mesh'e extent + doubleSided e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
2026-09-20 Kasar kabi v5: uctan cikis (Picnic/Atosa gibi), kap 280x325x360, uretim/deneme surumu
    - helezon O40 / mil O14 sag el, hatve 22-26-30, tup ici cift agizli, agiz ustunde cirpici pimler; karistirici kafes R129
    - motor: 2 x NMRV030 + NEMA23, katalog olculeriyle arka 95 mm'ye sigiyor (20+6+63=89)
    - akis.html v5: Roberts hesabi, kap ici sim, pide ustu dagilim simi (distan ice, dis kenarda 2,5 sn bekleme, darbe/tabla orani uyarisi),
    dusme ve tabla sayilari, motor/derinlik butcesi, deneme adimlari; v4 sayfasi akis_v4.html olarak arsivlendi
    - 3D: kasar_v5 (animasyonlu + USDZ) ve kasar_v5_dozaj (etek, reduktorler, tabla distan ice kayar)
2026-09-21 Kasar kabi v6: URETIM MODELI — CadQuery ile gercek katilar, STEP+STL, otomatik cakisma ve kanat denetimi
    - 43 parca ayri gecerli kati: plakalarda kanal/yatak/saplama/fatura delikleri, gecme bosluklari, montaj sirasi gercek
    - helezon: 8x8 kare cubuk cekirdek + 4 tek hatveli baski segmenti (22/26/30/cift agiz 36); tahrik gobegi + hac kavrama x2 ayni parca
    - karistirici: kare mil + 3 orumcek + 4 cubuk; on kovan + topuz + teget kilit pimi (mil one cikar, kafes ustten alinir)
    - menteseli agiz kapagi, silikon siyiricilar, uyari etiketleri, asma deligi KALDIRILDI; tasima tapasi eklendi
    - denetimler: parca ciftleri ortak hacim (temiz), donen gruplar 4 acida (temiz), ag uzerinde kanat ucu O40 (65/6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
    [BOM.csv, KASAR_KABI_v6_MONTAJ.step, cikis_tupu.step, cikis_tupu.stl, cubuk_0.step, cubuk_0.stl, cubuk_1.step, cubuk_1.stl]
2026-09-21 kasar kabi v7: arkada 60 mm konik mil koku geri kondu
    Kemal fark etti: v5'te helezonun arkasinda konik kok (O26 -> O16) vardi,
    v6'yi CadQuery ile sifirdan kurarken dusmustu.
    - kasar_cad_v7.py: segment A'nin mili tek revolve ile (boolean yok)
    - revolve ekseni YEREL koordinatta olmaliymis; global eksen hacmi 0 olan
    katiyi "gecerli" diye donduruyordu
    - dogrulama: mil govdesi 23 649 mm3, analitik koni hesabiyla birebir
    - Roberts kapasitesi arkada 15,8 -> onde 26,3 mL/tur
    - akis.html: mil yasasi + sim cizimi + kolon paylari yerel kapasiteye gore
    - v6 arsive (akis_v6.html, kaset3d eski surumler)
    [BOM.csv, KASAR_KABI_v7_MONTAJ.step, cikis_tupu.step, cikis_tupu.stl, cubuk_0.step, cubuk_0.stl, cubuk_1.step, cubuk_1.stl]
2026-09-21 akis: v5 -> v7 fark tablosu + yapamadiklarim bolumu
    Kemal "bunun gibi degistirdigin baska sey var mi" diye sordu.
    v5'in 107 parcasi v7'nin 56'siyla karsilastirildi; konik kok disinda
    5 fark daha cikti. En riskli: karistirici R129 -> R124 ve silikon
    siyiricilarin kalkmasi -> kase duvarinda 7 mm supurulmeyen bant.
2026-09-21 kasar kabi v8: kanat SUREKLI degisen hatveli, tam yuzeyle
    Kemal: "onu modelle, onemli olan o parca."
    Duzeltme: v5'te de hatve basamakliydi (22/26/30) - "v5'te surekliydi"
    demem yanlisti. v8'de gercekten surekli: 22,00 -> 30,17 mm dogrusal.
    - supurme yok: 4 kenar egrisi (BSpline) + BRepFill ruled yuzeyler ->
    dikis -> 6 yuzlu tek kati. OCC'nin kanat dusurme/cokertme hatasi yok.
    - toplam donus 11,75 tur = 47 ceyrek tur -> bolme yerleri kare cubuga
    tam oturuyor; uc hatve ~30 kaldigi icin dozaj sayilari degismedi
    - TUZAK: milin donus-yuzeyi DIKISI kanadin uc kapagiyla cakisinca
    birlesme sessizce hacmi 0 olan "gecerli" kati veriyor. Dikis acisi
    aranip hacimle dogrulaniyor.
    - olculen hatve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
    [BOM.csv, KASAR_KABI_v8_MONTAJ.step, cikis_tupu.step, cikis_tupu.stl, cubuk_0.step, cubuk_0.stl, cubuk_1.step, cubuk_1.stl]
2026-09-21 kaset3d: v8 montaj animasyonu + tedarikci dozaj paftasi
    Kemal: "nasil montajliyorsun, vida nasil giriyor, kapak nasil kapaniyor,
    tum parcalar icin yapabiliyor musun"
    - kasar_montaj_v8.py: ayni v8 katilarindan 18 adimlik montaj animasyonu
    (33 sn). Her parca kendi takilma yonunden gelir; helezon donerek onden,
    kafes ustten, yatak kapagi once itilir sonra ceyrek tur doner.
    - sayfada "v8 · montaj" sekmesi + adim listesi; adima dokununca o ana atlar
    - TEDARIK/AUTOKITCH_DOSING_01.png: 6 hazneli dozaj unitesi paftasi
    (1800 x 830 x 970, hazne 400 + motor 100), olculer HAT v19'dan
2026-09-21 montaj: AR'de de oynuyor + oynat/sar cubugu
    Kemal: "bu animasyonlar AR'de gozukmez mi" + "assagiya play koy da
    ileri geri sarip detaylari kontrol edebileyim"
    - usdz_yaz'a istege bagli anim parametresi: parca basina xformOp
    zaman ornekleri (-pivot -> rotZ -> +pivot -> ofset). anim=None ise
    dosya eskisi gibi duragan, eski cagrilar bozulmadi.
    - kasar_v8_montaj.usdz: 30 fps, 32,8 sn, 789 KB, USD denetimi gecti
    dogrulama: parcalar t=0'da ofsetli, t=sonda sifirda
    - sayfada oynat/durdur + onceki/sonraki adim + sarma cubugu
2026-09-21 kiyma kaseti v1: kasar kabi v8 mimarisinden turetildi (140 genislik)
    Urun: kiymali pide ic harci (cig, sogan+domates+biberli) = hazirlanmis et
    karisimi, <= +4 C (Yon. md. 31). 160 g x 20 pide/gun -> 2 gun 6,4 kg.
    Kendi akmaz, yapisir, beklerken su salar.
    - helezon buyuk ve yavas: O56 / mil O18 / hatve surekli 36 -> 48,5
    (7,25 tur = 29 ceyrek tur), ~21 dev/dk, uc hizi 0,06 m/s
    tup icinde tek agiz, agzin ustune kadar; cirpici pim yok
    - kafes yerine besleme rotoru: 2 siyirici lama 15x3, duvara 2,4 mm
    - agiz = asagi bakan 30x30 kisa meme; ilk 35 mm kapali tup (macun tikaci)
    - drenaj yok: su rotorla geri karistirilir
    - kasar kabiyla ortak: gobek, hac kavrama, pimler, kovan, topuz, miller
    - d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
    [BOM.csv, KIYMA_KASETI_v1_MONTAJ.step, cikis_tupu.step, cikis_tupu.stl, cubuk_0.step, cubuk_0.stl, cubuk_1.step, cubuk_1.stl]
2026-09-21 kaset3d AR: uretim/dozaj animasyonlu + montajda "yalniz bu adim"
    Kemal (iPhone AR): "kasar animasyonu oynamiyor, sadece montajda var;
    AR'da ileri geri sarma yok"
    - <onek>_calis.usdz: helezon + karistirici/rotor donuyor (12 sn dongu,
    tam tur sayisi -> basa sararken sicramaz). Uretim ve dozaj sekmelerinin
    iPhone AR dosyasi artik bu. Dogrulama: 2,5 sn'de helezon 90 derece.
    - iPhone AR goruntuleyicisinde sarma cubugu yok, siteler ekleyemiyor.
    Cozum: her montaj adiminin duragan hali ayri USDZ (18 + 18 dosya,
    13,8 + 9,5 MB); sayfada adima gel, "AR'de gor - yalniz bu adim (k/18)"
    tam o adimi acar. Dogrulama: adim 9'da helezon yerinde, tup disarida.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
2026-09-21 AR animasyonu duzeltildi: her karede ornek, tek matris op'u
    Kemal (iPhone AR): "animasyon bozuk, dogru hareket etmiyor"
    Sebep: USDZ'de seyrek anahtar kare. iPhone donusumu yalniz YAZILI
    orneklerde okuyup arasini konum + kuaterniyon olarak kendi dolduruyor:
    - calisma animasyonu: 0 -> -2520 derece (7 tur) 2 anahtarla = 0'a denk,
    donmuyor / yalpaliyor
    - montajda helezon: 720 derece 4 aralikta = aralik basina 180 derece,
    yon belirsiz
    - eksen disi pivot donusunde parca yay yerine kiris ciziyor
    Cozum: hareket pencerelerinde 30 kare/sn ornek, 4 op yerine tek matris.
    Dogrulama (yalniz yazili orneklerde): ardisik en buyuk donus 8,4 / 31,2
    derece, eksen sapmasi 0,0000 mm.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
2026-09-21 kusbasi kaseti v1: tane boyundan turetilen hesap + CAD
    Kemal: "kusbasini yap ama iyice hesapla, vidasini matematiksel olarak,
    ilk kasara yaptigin gibi"
    HESAP (kusbasi_akis_model_v1.py): tasarimi tek sayi yonetiyor - kup
    kenari d. Kurallar: kopru icin aciklik >= 4d (BulkInside), mil-tekne
    bosluk >= R*d (CEMA 1,75/2,5/4,5), kanatlar arasi net >= 3d, iki
    hareketli yuzey arasi ya < d/3 ya > 1,5d. Roberts kapasitesi, doz
    belirsizliginin alt siniri (kesme duzlemi), pide ustu dagilim
    (Monte Carlo), Janssen tikac basinci, tork.
    SONUC: d 10 mm'de butun kurallar tutuyor, 12'de agiz sinirda (3,7d),
    15'te calismaz.
    CAD (kusbasi_cad_v1.py, kiyma kasetinden turetildi): helezon O68 / mil
    O16 / kok O28, t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
    [BOM.csv, KUSBASI_KASETI_v1_MONTAJ.step, cikis_tupu.step, cikis_tupu.stl, cubuk_0.step, cubuk_0.stl, cubuk_1.step, cubuk_1.stl]
2026-09-21 kusbasi: tabla yasasi kusbasi icin ayri cozuldu + "pat diye dokerse"
    Kemal: "tabla disaridan iceri donerken her yerine esit miktarda verecek
    sekilde kurdun degil mi; pat tek seferde verirse olmaz"
    - kasar yasasi kusbasinda tutmuyor (kasar eriyip ~13 mm yayilir, kup
    yayilmaz): halkalar arasi sapma %20, en dis halka %63
    - agzin her yaricapta ne kadar oyalanacagi scipy NNLS ile cozuldu
    (A w = sabit, w >= 0, komsu istasyonlar arasi puruz terimi):
    sapma %13, en dis halka %80; takas tablosu r_max 95/100/105/110
    - kendi gradyan cozucum yakinsamiyordu (ic halkalari sifirliyordu),
    atildi
    - ayni 145 g obek obek duserse bos hucre: surekli %13, 4 obek %34,
    2 obek %48, tek seferde %50 -> surek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
2026-09-21 kaset kontrol listesi (72 madde) + kiyma v2 + animasyonlar hesapla ayni
    Kemal: "kiyma icin de yap, animasyonu duzelt, her sey dogru olsun;
    bir check list yap, o listeye gore her seyi kontrol et"
    KONTROL LISTESI: _uretec/kaset_kontrol.py - uc kaset icin ayni maddeler
    (A uretec denetimleri, B geometri, C uretim dosyalari, D animasyon =
    hesap, E AR ornekleri, F sayfa, G canli, H kasetler arasi). 72/72.
    Listenin yakaladigi iki gercek hata:
    - "govde ve arka plaka kiyma ile kusbasinda ortak" iddiam yanlisti
    (tekne capi baska) -> metin duzeltildi, ortaklik hacimle dogrulaniyor
    - mil eksenleri standart degildi -> KIYMA v2: helezon ekseni 52 -> 60
    (140 sinifinda alt tahrik ortak). Ust eksen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
    [BOM.csv, KASAR_KABI_v8_MONTAJ.step, KIYMA_KASETI_v1_MONTAJ.step, KIYMA_KASETI_v2_MONTAJ.step, KUSBASI_KASETI_v1_MONTAJ.step, cikis_tupu.step, cikis_tupu.stl, cubuk_0.step]
2026-09-21 Kaset: ORTAK GÖVDE 140 (kıyma v3 = kuşbaşı v2 = küp sucuk v1) + küp sucuk hesabı
    - gövde, iki uç plakası, kapak, kulp, yatak kapağı, saplamalar üç kasette birebir aynı (CY 60 · YC 164 · tekne Ø72)
    - kıyma v3: vida Ø56 → Ø68, 68 g/tur, 14 dev/dk, uzun kollu rotor
    - kuşbaşı v2: vida/tüp/ağız aynı → hesap değişmedi; kısa kollu rotor (duvara 19, kanada 22 mm)
    - küp sucuk v1: 41/41 parça kuşbaşı kasetiyle aynı; hesap sucuğun sabitleriyle yeniden kuruldu (akis_sucuk.html)
    - kontrol listesi 4 kaset · 98/98; H2/H3/H5/H6 ortak gövde + varsayılan argüman tuzağı maddeleri
    [BOM.csv, KIYMA_KASETI_v3_MONTAJ.step, KUSBASI_KASETI_v2_MONTAJ.step, SUCUK_KASETI_v1_MONTAJ.step, cikis_tupu.step, cikis_tupu.stl, cubuk_0.step, cubuk_0.stl]
2026-09-21 Kaset: BİRLEŞİM DETAYLARI v1 (kaşar v9 · kıyma v4 · kuşbaşı v3 · küp sucuk v2)
    Kemal AR'da yakaladı: saplama–plaka, kulp ve bayonet "klik" çözülmemişti.
    - saplama M6 iki ucu dişli + pul DIN 125 + kubbeli kör somun DIN 1587
    - kulp: kaynaklı tek parça, ayakta M6 × 14 kör diş; montaj sırası düzeltildi
    (üst saplamalar önce kulpa vidalanır, sonra önden geçirilir)
    - bayonet: tüpte 3 tırnak, kapakta giriş → halka → 0,25 tümsek → cep + dayama,
    O-ring hem conta hem yay (it → 35° çevir → klik)
    - gövde–plaka contası, muylu O-ringleri, tüp O-ringi, M4 insert
    - tek kod: kaset_birlesim_v1.py (dört kasette aynı); montaj: kaset_montaj_v2.py (22 ad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
    [BOM.csv, KASAR_KABI_v9_MONTAJ.step, KIYMA_KASETI_v4_MONTAJ.step, KUSBASI_KASETI_v3_MONTAJ.step, SUCUK_KASETI_v2_MONTAJ.step, cikis_tupu.step, cikis_tupu.stl, conta_arka.step]
2026-09-21 Makine ANA MONTAJI v1: hattın tamamı tek modelde + kütük + STEP
    Kemal: "çalıştığımız şeyleri parça parça birleştirip makineyi tamamlayalım;
    pafta yerleşimine koyup 3B üretim modeli yapalım, sitede komple görülsün,
    sonra SolidWorks/STEP'e dökeriz."
    - hat_montaj_v1.py: 56 birimlik KÜTÜK (tek gerçek kaynak). Ölçüler HAT v19
    paftasından exec ile OKUNUR, elle yazılmaz.
    - durum: GERCEK (gerçek CAD, zarfı paftayla doğrulanır) / KUTU (modellenmedi) /
    KATALOG (satın alınan). Şu an 5/56 gerçek: 4 kaset + dozaj başlıkları.
    - çıktı: otonom/hat3d/hat_v1.glb + .usdz + durum.json ·
    FULL_MAKINE/HAT_v1_YERLESIM.step (SolidWorks'te montaj olarak açılır)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
    [HAT_v1_YERLESIM.step]
2026-09-21 Kaset: KAPAK YOK (kaşar v10 · kıyma v5 · kuşbaşı v4 · küp sucuk v3)
    Kemal: "Kapak olmasın, TOPPING'de de yok."
    - kapak kaldırıldı; yerine gövde ağzında İÇE 8 mm bükme dudak (gövdeyle aynı
    parça): kenar keskin değil, ağız esnemiyor, elle tutulacak yer var.
    Dışa bükülemez — kaset dış ölçüsü (140 / 280) dolu.
    1 numaralı kural gereği iki eksik daha kapatıldı:
    - SIYIRICI LAMA pozitif tutuluyor: rotor KAYNAKLI tek parça, her lama-kol
    birleşiminde 3 mm kaynak yakası. Yaka lamanın dış köşesiyle sınırlı →
    kâse boşluğu 2,44 mm bozulmadı (vida/pim yok: çiğ ette aralık = bakteri).
    - ÖN KOVAN LABİRENTİ: kovanın arka yüzünde Ø28,4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
    [BOM.csv, HAT_v1_YERLESIM.step, KASAR_KABI_v10_MONTAJ.step, KIYMA_KASETI_v5_MONTAJ.step, KUSBASI_KASETI_v4_MONTAJ.step, SUCUK_KASETI_v3_MONTAJ.step, cikis_tupu.step, cikis_tupu.stl]
2026-09-21 Site: TOPPING sayfası güncellendi + 3D/AR sayfaları Yol C düzenine bağlandı
    Kemal: "bu sürümler nerede — yol hat C var ya, oradaki düzene entegre et,
    bilgilerinin de bir sayfası olsun."
    - otonom/hat/topping.html baştan yazıldı: 5 Eyl'deki Picnic kap kurgusu yerine
    bugünkü hâli. 7 bölüm (ne yapar · kaset durum tablosu · özellikler ·
    teknik resimler · tedarikçiler · açık konular · sürüm geçmişi), sitenin
    kendi hat.css düzeninde.
    - kaset3d ve hat3d hiçbir yerden bağlı değildi: HAT üst sayfasının lejantına
    ve güncel durum kutusuna eklendi; iki sayfaya da aynı yol izi konuldu
    (AUTOKITCH › HAT · Yol C › 3 · TOPPING › ...).
    - birleşim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
2026-09-21 Site: HAT 3B sahneleri v19 yerleşimine çekildi
    Kemal: "lan bunları güncellesene, ben basınca o makineye açılacak, ordan
    topping'i seçeceğim."
    Sahneler hâlâ 14 Eylül'ün 420 cm'lik 5 kolonlu tepsili hattını gösteriyordu.
    - makine.html: HAT v19 → 390 × 83 × 203. Çekmeceler tabanda tek modül (250),
    PRESS ve TOPPING onun üstünde, FIRIN ve KUTULAMA yanda; ray yok, iki sabit
    kobot (x 125 · 320). Her modül tıklanınca kendi sayfası.
    - hat/index.html: makine grubu aynı yerleşime çekildi, tıklayınca makine.html.
    Arkada kaybolduğu için rengi koyulaştırıldı, saydam duvarlar açıldı.
    - makine.html metinleri güncellendi (ray, tepsi, kapasite, sürüm geçmi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
2026-09-21 Site: iç sayfalar gerçek 3B üretim modeline geçti (makine → istasyon → kaset)
    Kemal: "ana sayfa doğru ama iç sayfalar yanlış. Makineye girince 3D üretim
    modeli büyük haliyle gelsin, üstüne gelince istasyonlar parlasın, seçtiğim
    istasyon açılsın, ordan kasetleri ayrı ayrı seçip açayım. Temiz, minimalist."
    - hat_montaj_v2.py: her birim KENDİ malzemesini alır (MC_KASET_KIYMA gibi, USD
    için ASCII) → model üstünde parça seçilebiliyor (materialFromPoint).
    Ayrıca modül başına ayrı GLB/USDZ basar: modul_A..E + modul_R.
    Kabin zarfı modül modeline girmez — saydam da olsa en önde durup içerideki
    birimin seçilmesini engelliyordu.
    - model3d.js (or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
    [HAT_v2_YERLESIM.step]
2026-09-21 Kaset modelleri renkli + detaylı; imleç kayması düzeltildi
    Kemal: "burda niye kasetler detaysız renksiz duruyor, birde tam üstündeyken
    seçmiyor sanki mouse kaymış gibi."
    1) RENKSİZ/DETAYSIZ: v2'de gerçek kasetin bütün parçaları TEK ağa eritilip
    TEK malzeme alıyordu — şeffaf gövde, paslanmaz mil, POM helezon hepsi aynı
    mat beyaz oluyordu; iç parçalar modele hiç girmiyordu.
    hat_montaj_v3.py: her parça KENDİ tonunu korur (malzeme adı
    M<modül>_<kod>__<ton>), kasetin İÇİ de girer (helezon, rotor, mil, kovan,
    topuz). Dışarıda kalan yalnız küçük bağlantı elemanları.
    2) İMLEÇ KAYMASI: model-viewer materialFromPoint PENCERE koordinatı bekl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
    [HAT_v3_YERLESIM.step]
2026-09-21 Kasetler KATI çiziliyor; kutular seçimi çalmıyor
    Kemal: "hala şeffaf gözüküyor ve seçmek çok zor."
    - hat_montaj_v4.py: makine/istasyon görünümünde gerçek kasetin PC parçaları
    (gövde, plakalar, çıkış tüpü) KATI çiziliyor. Şeffaf bırakınca kaset hayalet
    gibi duruyor ve imleçle hedeflemek zorlaşıyordu. Kasetin KENDİ sayfasında
    şeffaf kalıyor (içini görmek için) — orası ayrı üreteç, dokunulmadı.
    - topping.html'e "İçini gör" düğmesi: PC gövdeyi saydamlaştırıp helezonu
    gösterir, tekrar basınca katıya döner.
    - model3d.js: henüz modellenmemiş kutular alfa 0,055'e düşürüldü ve
    İSTASYON sayfalarında seçimi çalmıyorlar (ma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
    [HAT_v4_YERLESIM.step]
2026-09-21 İstasyon modeli kasetin kendi sayfasıyla aynı; vurgu kaldırıldı
    Kemal: "parçayı açınca gözüken şekilde gözüksün istiyorum, montajda detaylı.
    Üstüne gelince parlamasın yanmasın, diğerleri şeffaflaşmasın, gerek yok."
    - hat_montaj_v5.py: kasetin BÜTÜN parçaları modele giriyor (v3/v4'teki ATLA
    listesi kalktı) ve her parça KENDİ malzemesini koruyor — PC gövde yine
    şeffaf, içerideki helezon/rotor görünüyor. v4'teki "cam → katı" çevirisi
    kaldırıldı. modul_C 1,3 → 2,6 MB.
    - model3d.js: renk/alfa değiştiren her şey çıktı. Üstüne gelince yalnız etiket
    açılıyor, imleç el oluyor, tıklayınca sayfası açılıyor. Kutuları
    solukla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
    [HAT_v5_YERLESIM.step]
2026-09-21 TOPPING modülü üretim modeli: kabin + 12 tahrik + soğutma + pano
    Kemal: "bunlar niye bu kadar önde, birde arka kısımlarını o motor yerlerini —
    bu TOPPING'i full tasarla üretime yönelik."
    topping_hesap_v1.py (model bundan okur, sayı iki yerde yazılmaz):
    - derinlik dizilimi: kapak 20 | kulp 60 | KASET 325 | kavrama 40 | yalıtım 65 |
    KURU MAKİNE 320 = 830. Kaset ön yüzle aynı hizadaydı, kulpu 48 mm dışarı
    taşıyordu → 80 mm içeri alındı, önüne yalıtımlı kapak kondu.
    - tahrik: sıkışma 3 N·m → tasarım 6 N·m; planet i=10 ile motorda 0,67 N·m,
    NEMA23 1,2 N·m veriyor. Sonsuz vida KULLANILMADI (girişi dik, motor yana
    taşıyor, komşu kasete gir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
    [BOM.csv, TOPPING_MODUL_v1_MONTAJ.step, agiz_cercevesi.step, agiz_cercevesi.stl, bolme_0.step, bolme_0.stl, bolme_1.step, bolme_1.stl]
2026-09-22 3B görüntüleyici: kesit + ölçü araçları, çift tıkla açma, kaset etiketleri
    Kemal'in 4 isteği:
    1 Sürüklerken bırakılan tıklama parçayı açıyordu → 6 px'ten fazla hareket
    varsa tıklama sayılmıyor; açma artık ÇİFT TIK (tek tık yalnız seçer).
    2 KESİT: X / Y / Z düzlemi + kaydırıcı + yön çevirme. model-viewer renderer'ı
    dışarı vermediği için sahnedeki ilk mesh'in onBeforeRender kancasıyla
    yakalanıyor; THREE.Plane gerekmiyor, {normal, constant} düz nesnesi yetiyor.
    Kanca ilk kareyi bekler, yakaladığı anda bekleyen kesiti kendisi uygular.
    3 ÖLÇÜ: iki noktaya tıkla → aradaki mesafe + X/Y/Z farkları mm cinsinden;
    noktalar mod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
2026-09-22 Kesit X ve Y düzeltildi (dünya koordinatı) + model bandı tam genişlik
    Kemal: "sadece Z düzgün çalışıyor, gerisi çalışmıyor düzgün kesit için."
    SEBEP: scene.boundingBox modelin KENDİ (GLB) koordinatını verir, ama kesme
    düzlemi DÜNYA koordinatında uygulanır. model-viewer modeli sahneye
    yerleştirirken kaydırıyor — bu modülde x −1,60 · y −1,52 · z +0,25 m.
    Z'de kayma küçük olduğu için kesit az çok tutuyordu, X ve Y'de düzlem
    modelin tamamen dışında kalıyordu.
    ÇÖZÜM: sınırlar parçaların matrixWorld'ünden hesaplanıyor. model-viewer'ın
    kendi gölge düzlemi ADSIZ mesh — dışarıda bırakılmazsa kutu şişiyor.
    Ölçüldü: X 936/1800, Y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
2026-09-22 Kesit fare hareketinden etkilenmiyor + araç çubuğu yazıları ayrıldı
    Kemal: "sağ clickle hareket ederken kesitin yüzeyi ileri geri gidiyor;
    mouse hareketleri section'ı etkilemesin, sadece alt bardan ayarlansın.
    Birde bardaki yazılar iç içe geçmiş."
    SEBEP: model-viewer modeli bir "target" grubunun içine koyup kaydırıyor
    (bu modülde −1,60 / −1,52 / +0,25 m) ve SAĞ TIK PAN bu ofseti değiştiriyor.
    Kesme düzlemi dünya koordinatında sabit kaldığı için model kayınca kesit
    yüzeyi modelin içinde ileri geri geziyordu.
    ÇÖZÜM: sınır kutusu artık model bbox + GÜNCEL target ofseti olarak
    hesaplanıyor ve camera-change'te düzlemin sayısı tazeleniyor. Malzemele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
2026-09-22 TOPPING v2: kaset geriye, kuru bölme 200, evaporatör kasetlerin içinden çıktı
    Kemal: "kasetleri geri it, arkada boşluk olmasın; kalınlıkları doğru ayarla;
    sadece kasetlerin olduğu kısım soğutuculu; kablolar motorun yanından gider."
    Ayrıca: "soğutucu grubu kasetlere giriyor sanki" — DOĞRU ÇIKTI.
    1 KURU BÖLME ÖLÇÜSÜNE İNDİ: 320 → 200 mm (mil ucu 40 + redüktör 60 +
    motor 76 + kablo payı 24). v1'de motorun arkasında 142 mm boşluk vardı.
    2 KASET GERİYE GİTTİ, önünde ÖN NİŞ 84 mm açıldı. Çıkış ağzı modül ön
    yüzünden 10–55 mm yerine 130–175 mm içeride. Niş YALITIMSIZ; soğutulan
    derinlik 445 → 425 (yalnız kulp boşluğu + ka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
2026-09-22 TOPPING v3: kaset artık yuvadan çıkıyor, evaporatör arkaya, huni bacası
    Kemal: "şu sağdaki şeyi arka tarafa al · alt çıkış nozzle yeri, o parçayı
    biraz daha uzun yap ki pideyle arasındaki doğru mesafe olsun · neden alt
    kısım bu kadar kalın, kasetlerin rafı, bir sebebi var mı."
    1 GERÇEK HATA — KASET YUVADAN ÇIKMIYORDU. Meme yarığı yalnız ağız boyundaydı
    (42 mm); kaset öne çekilince meme 6 mm sonra iç kabuğun tabanına çarpıyordu.
    Yarık hücrenin ön sınırına kadar açıldı: meme 28 mm sonra sınırı geçiyor ve
    hücrenin dışında serbest kalıyor.
    2 EVAPORATÖR SAĞ UÇTAN ARKAYA: kasetlerin arkasındaki kavrama bölmesine,
    millerin ü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
2026-09-22 TOPPING v4: evaporatör delikli perde arkasında, baca baştan başa açıldı
    Kemal: "kasetlerin arkasındaki uzun parça ne? Soğutmak için bir motor ve
    içeriye havayı vermiyor mu, kesikler açılıyor sacda — standardı bu değil mi?
    Birde nozzle kısımlarını anlamadım, dolu parçalar var bunda."
    1 EVAPORATÖR ÇIPLAK DURUYORDU → ticari soğutucu düzenine geçildi: evaporatör
    + 2 fan arka bölmede bir PLENUM'un içinde, önlerinde DELİKLİ SAC PERDE.
    Üst sıradaki kesiklerden soğuk hava hücreye basılıyor, millerin altındaki
    alt sıradan geri dönüyor. Ayrı "hava kanalı saci" kalktı — perde hem onun
    işini yapıyor hem evaporatörü gizliyor. Perdede 12 m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
2026-09-22 Soğutma kuru bölmeye, kaset ağızları yuvarlak boru oldu (pideye 40 mm)
    Kemal: "o parçanın standart versiyonunu bul, motorların olduğu yere koy,
    sonra içeriye soğuğu verecek şekilde yalıtıma boşluk aç, içeri gitsin hava
    · kasetlerden kare çıkış yapmışsın, yuvarlak yap, çapını da hesapla ve alta
    doğru uzat · başka parça yok, direk kasetin kendi ucu pideye yaklaşıyor."
    1 SOĞUTMA KURU BÖLMEYE (topping_cad_v5): standart sınıf fanlı evaporatör
    (unit cooler) 400 × 180 × 190, motorların üstünde. Soğuğu arka yalıtımdaki
    İKİ BOŞLUKTAN veriyor — üstte üfleme, altta dönüş; ikisi de mil bandının
    (y 300–455) dışında. Kavrama bölmes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
2026-09-22 Boru birleşimi konik oldu + HARÇ/SOS kaseti modellendi (duckbill valfli)
    Kemal: "aşağı inen boru çapının dışı yataydaki boru çapıyla aynı değil,
    birleşimleri düzgün olmadı · şu harç kasetleri ile sos aynı şey aslında,
    bu ikisinin nasıl olacağını tam modelle, nozzle falan da yap."
    1 BİRLEŞİM (boru v2): boru artık tüpün dışında TÜP ÇAPIYLA başlıyor, 22 mm
    konik daralıp kendi çapına iniyor, sonra düz devam ediyor — basamak yok.
    Kaşarda ölçülen asıl sorun: boru dışı Ø58, yatay tüp dışı Ø50 → boru tüpten
    KALINDI. Üstelik ürün zaten tüpün iç Ø44'ünden geçiyor, Ø52'nin anlamı yoktu
    → kaşar borusu Ø44 (tüp içi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
2026-09-22 Harç/sos VİDASIZ hortum pompaya çevrildi + TOPPING ön sacı kalktı
    Kemal: "ya niye vidalı yaptın? Sosla lahmacun harcını dedik ya, BORULU
    NOZZLE olacak diye." Haklı — v1'de kaşar gövdesini kopyalayıp içine helezon
    koymuştum, yanlıştı. Sıvı/macun vidayla dozlanmaz; konuşulan sistem hortum
    pompasıydı (Atosa'da görülen bidon + hortum düzeni).
    HARÇ / SOS ÜNİTESİ v2 — hiçbir yerinde vida yok:
    HAZNE → dip rakoru (en alçak nokta) → emiş hortumu → PERİSTALTİK POMPA
    (rotor + 3 makara hortumu ezer) → basma hortumu → BORULU NOZZLE Ø16
    + 1/2" duckbill valf → pidenin 40 mm üstü.
    Ürün YALNIZ hortumun içinde; pompanın hiçbir parçası ür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
2026-09-22 DÖNER TABLA: iki eksenli (x arabası + Ø340 tabla, 35 dev/dk)
    Kemal: "şimdi altına Atosa gibi tabla yapacağız ama nasıl olacak? Her kasetin
    çıkış yerine denk gelecek, ona göre kendini ayarlayıp dönerken ilerleyecek."
    SİSTEM: nozzle SABİT. ARABA x'te kayar (hem kasetten kasete, hem dozaj
    sırasında ağzın pide merkezine uzaklığını değiştirir), TABLA kendi ekseninde
    döner. Tabla dönerken araba kaydığı için ağız pide üzerinde spiral çizer —
    Atosa'da başlık radyal kayar, bizde tabla kayar, sonuç aynı.
    SAYILAR UYDURULMADI: kasetlerin akış modelleri (kasar_akis_model_v2 ·
    kusbasi_akis_model_v2) zaten tablalı düzene göre çözülmüştü. Tabla yasas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
2026-09-22 Nozzle yalıtım deliğine oturdu + damlama teknesi ve ağız çerçevesi silindi
    Kemal: "yuvarlak parçalar neden yalıtım parçasından da aşağıya gidip saçma
    sapan uzun kalıyor? Kasetlerin o yuvarlak parça uzunluğu sadece yalıtımın üst
    kısmına kadar gelsin, orada kes; yalıtımın içine de aynı çapta yuvarlak boşluk
    aç, kaset takılınca ucu oraya denk gelsin, malzeme aşağı aksın — bu sayede
    etrafı kapanır, yalıtımda sadece bir delik olur. Yalıtımın altındaki gri
    parçayı sil. Ön yüzeyde havada uçan sacı da sil."
    1 BORU 90 mm KISALDI: alt uç y 160 → y 250 (yalıtımın üst yüzü). Kaset
    üreteçlerinde yapıldı: kasar v13 · kiyma v8 · kusba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
2026-09-22 Döner tabla TAM ÜRETİM MODELİ (188 parça) + boru ucu iç kabuğun üstünde
    Kemal: "bu tabla nasıl xyz'de hareket ediyor, nasıl dönüyor kendi etrafında —
    bunu her şeyiyle üretime yönelik çiz, motoruna kadar vidasına kadar."
    v9'a kadar tabla 9 adet YER TUTUCU BLOKTU; parçaların hiçbiri birbirine
    bağlanmıyordu. v10'da gerçek mekanizma — 188 parça, BOM 66 kalem:
    X EKSENİ (kayış tahrikli tek araba): sağ uçtaki sabit NEMA23 → GT3 20 diş
    kasnak (çevre tam 60,00 mm/tur) → açık uçlu kayış sol uçtaki avaraya gidip
    döner, iki ucu arabanın altındaki kola kelepçelenir. Araba iki HGR15 rayda
    4 blokla gezer. Gergi avara braketinde, ağızdan elle erişilir.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
2026-09-22 Canlı simülasyon: makineyi gerçekten yöneten kod + 3B sahne
    Kemal: "bu tepsiye animasyon verebiliyor musun? Sağda bir pencere açalım,
    ordan kontrol edelim, kodunu da test edelim. Her şey gerçekmiş gibi düşün —
    motorlar, kablolar, bir sisteme/PC'ye bağlı diyelim, burdaki kod ile
    yönetiyoruz. Yarın öbürgün birine verirken 'bak kod bu, bu kod bunu aktif
    ediyor, tepsi ilerliyor, sonra kasetin üst motorunu aktif ediyor' diyeyim.
    Kaşarlı pide deyince tepsi kaşarın altına dönüp x'teki hareketini kaşarın
    döküldüğüne göre ayarlasın."
    ÜÇ PARÇA:
    1 sim_topping_v1.py — üretim modelini (topping_cad_v10 + 6 kaset) alıp HAREKET
    EDEN paketleri ayrı gruplara b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
2026-09-22 Simülasyon TOPPING sayfasının içine taşındı — ayrı sayfa kalktı
    Kemal: "neden başka bir sayfaya gidiyor? Tüm detayları ilk sayfada
    istiyorum; sadece sağda bir pop-up sayfa olsun, ona basınca animasyon
    açılsın ve ordan seçeyim. Kasetin de parçaları çalışsın."
    · sim.html silindi; sim3d.js aynı görüntüleyici kutusunun içine three.js
    sahnesi kuruyor, sağdan 430 px panel kayıyor (telefonda tam genişlik).
    · CANLI SİMÜLASYON düğmesi sayfadan çıkarmadan açıp kapatıyor; kapanınca
    model-viewer, etiketler ve kesit çubuğu geri geliyor.
    · Kasetin kendi parçaları dönüyor: helezon, karıştırıcı ve harç pompası
    makine_kodu.js'deki MOTOR açı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
2026-09-22 Simülasyon artık ASIL modeli oynatıyor — ayrı sim modeli kaldırıldı
    Kemal: "neden simülasyonu aç deyince başka bir model geliyor, neden direkt
    modeli çalıştırmıyorsun? Ana modele uygula, çalışmanı basit şekiller görmek
    istemiyorum."
    HATAM: sim için ayrı bir GLB üretiyordum (sim_topping_v1.glb) ve kendi kaba
    ağ/malzeme hattı vardı — 145.658 üçgen, 11 malzeme, etiket yok, cam yok.
    Sayfanın gösterdiği modul_C.glb ise 297.524 üçgen, 51 malzeme, sarı etiketli.
    Yani sim gerçekten daha basit bir modeldi.
    SEBEP: dönen parçalar (helezon, karıştırıcı, tabla, araba) üretim modelinde
    gövdeyle aynı mesh'te birleşiyordu, ayrı döndürülemiyorlardı. A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
2026-09-22 Kemal'in bulduğu 7 kusur + gerçek dökülme + yuva etiketleri
    1 · SAYFA KENDİLİĞİNDEN KAYIYORDU — kod paneli çalışan satırı scrollIntoView ile
    ortalıyordu, o da SAYFAYI kaydırıyor. Artık yalnız kod kutusunun kendi
    scrollTop'u oynuyor. Ölçüldü: bir çevrim boyunca sayfa kayması 0 px.
    2 · PİDE TABLANIN ALTINDAYDI — pivotla() nesnenin position'ını eziyor (GLB ağları
    0'da durur, dünya koordinatı geometrinin içindedir). Tepsi/pide diskleri de
    artık GEOMETRİDEN konumlanıyor. Tepsi 100–112, pide 112–120 (tabla üstü 100).
    3 · SOS KASETİNİN EKSENLERİ KAYIKTI — pompalı kasette roller TERS: üst mil (YC 195)
    pompa rotoru, alt mil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
2026-09-22 TOPPING dijital ikizi Isaac Sim'de — fizikli USD, 14 eklem, çalışıyor
    Kemal: "sırada bizim şeyi oraya koy, TOPPING şeyini... dijital twin kuruyoruz
    unutma, her şey olmalı."
    İKİ AŞAMALI ZİNCİR (CadQuery ve Isaac ayrı Python'lar):
    topping_fizik_ihrac_v1.py (sistem Python + CadQuery)
    topping_cad_v11 + 6 kaset → ağ + HACİM + KÜTLE + hareketli paket → .npz + .json
    topping_usd_v3.py (C:\isaacsim\python.bat)
    → TOPPING_fizik_v3.usd : 534 parça · 315.786 üçgen · 14 eklem
    İLK KEZ GERÇEK KÜTLELER (hacim × malzeme yoğunluğu):
    ARABA 15,18 kg · TABLA 5,11 kg · SABİT 803,09 kg
    kaset milleri 0,38–0,80 kg
    14 parçanın kütlesi VARSAYI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
2026-09-22 Dijital ikiz tamamlandı: katalog parçaları + UR10e + tepsi/pide + Python kontrol
    Kemal: "hepsini yap tabi."
    1 · KATALOG PARÇALARI — HIWIN kataloğu (Linear_Guideway-E-1.pdf s.41) indirildi ve okundu:
    HGH15CA blok W34 H28 L61,4 · 0,18 kg · C 14,7 kN C0 23,47 kN
    HGR15 ray 15×15 · hatve 60 · 1,45 kg/m
    Modeldeki blok zarfı zaten katalogla birebirmiş — kütle düzeltildi.
    NEMA23 pancake 57×57×41 kataloğu: 0,6 N·m / 0,88 A (benim varsayımım 0,9'du).
    Döner yatak kütlesi artık halka hacminden hesaplı (2,5 kg), uydurma değil.
    VARSAYIM kalan: yalnız 12 planet redüktör — ve onlar SABİT tarafta, dinamiği etkilemiyor.
    ARABA 15,02 kg · TABLA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
2026-09-22 Küp sucuk simülasyonu: doğru çözüm seçildi, kurulum hataları bulundu — henüz akmıyor
    Kemal: "küp sucuklar için bir simülasyon yapsana... bizim kasetler çalışsın,
    alt tablanın üstüne pide koy, hadi full çalıştır."
    ÇÖZÜM SEÇİMİ (ve nedeni)
    Isaac Sim'de granül için üç yol var. PBD parçacık ve Newton XPBD aynı sınıf:
    NVIDIA'nın kendi geliştiricisi forumda "1 cm parçacık normal yerçekiminde
    oldukça zor, çözücü bu senaryo için yeterince doğru değil" diyor. Bizim küp 8 mm.
    ÜÇÜNCÜ YOL SEÇİLDİ: her küp GERÇEK bir rijit kutu. 70 g / 0,538 g = 130 küp;
    400 rijit cisim PhysX için hiçbir şey. Bu boyutta EN DOĞRU çözüm ayn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
    [hgh15ca.stp]
2026-09-22 HIWIN'in gerçek CAD'i montaja girdi — kızak ve araba artık katalog parçası
    Kemal: "indir montaja ekle, önce şunu bir yap."
    TraceParts'tan inen HGH15CA STEP AP214 iki katı taşıyor, ikisi de doğrulandı:
    araba 34,00 × 23,70 × 61,40 mm
    ray 15 × 15 profil · 150 mm örnek · 27.449 mm³ = 1,45 kg/m (katalogla BİREBİR)
    MODELE GEÇİRİLDİ (topping_cad_v12):
    kizak_blogu_0..3 uydurma kutu → HIWIN'in GERÇEK araba katısı
    lineer_ray_ön/arka uydurma kutu → GERÇEK profil, 1600 mm'ye uzatılmış
    + katalog delik deseni (Ø4,5 geçme · Ø7,5×5,3 havşa
    · hatve 60 · uçtan 20 · M4×16)
    R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
2026-09-22 Gerçek NEMA23 motor montajda — ve kablosu 4 çakışma ortaya çıkardı
    AutomationDirect STP-MTRAC-23078 (TraceParts STEP AP214, captcha'yı Kemal girdi):
    NEMA23 · 2 fazlı bipolar · 227 oz-in = 1,60 N·m tutma · 0,71 A · 1,8° · 200 adım/tur · IP40
    STEP ölçüldü: gövde 56,40 × 57,51 × 76 mm · mil +20 mm · KABLO yandan düz 76 mm
    İhtiyacımız 1,2 N·m'di; 1,60 seçildi, %33 pay.
    13 motor (12 tahrik + X ekseni) uydurma kutudan GERÇEK katıya çevrildi.
    GERÇEK BULGU — KABLO SIĞMIYOR. Kabloyu da modele koyunca tarama 4 çakışma buldu:
    motor_kablosu_KIYMA_helezon ↔ motor_KIYMA_rotor 1.406 mm³
    motor_kablosu_KUŞBAŞI_helezon ↔ motor_KUŞBA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
    [stp-mtrac-23078.step]
2026-09-22 Gerçek planet redüktör montajda — artık HİÇBİR kütle varsayım değil
    AutomationDirect SureGear PGCN23-1025 (TraceParts STEP AP214):
    10:1 · tek kademe · NEMA23 flanş · aynı SureStep motoru için yapılmış
    STEP ölçüldü: 60 × 60 × 103 mm (gövde 79 + çıkış mili 24)
    NOMİNAL ÇIKIŞ TORKU 5 N·m
    İKİ GERÇEK BULGU
    1 · KURU BÖLME YETMİYOR. Hesapta redüktör 60 mm varsayılmıştı, gerçeği 79 mm.
    Dizilim "mil ucu 40 + redüktör 60 + motor 76 + kablo payı 24 = 200" idi;
    gerçek ölçüyle 40 + 79 + 76 + 24 = 219 mm → 19 mm eksik. İlk denemede
    12 motorun HEPSİ arka dış sacı deldi (24 çakışma).
    Şimdilik mil güdüğü koddaki 42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
    [pgcn23-1025.step]
2026-09-22 Sahte kütleler temizlendi: modül 825 kg → 348 kg
    Kemal ağırlığı sorunca baktım: 825,3 kg'ın 518'i BEŞ YER TUTUCU BLOKTAN geliyordu.
    Hepsi masif kutu olarak modellenmişti, hacim × yoğunluk saçma sayı veriyordu:
    pano_kutusu 189,6 kg evaporator 90,3 kg (MASİF BAKIR!)
    sogutma_grubu 114,7 kg on_kapak 74,4 kg ups 49,5 kg
    İKİ TANESİ GEOMETRİDEN DÜZELDİ (bizim imal ettiğimiz parçalar — BOM zaten doğru
    yazıyordu, geometri tutmuyordu):
    on_kapak → 1,5 mm sac kabuk + PU çekirdek (74,4 → 16,5 kg)
    pano_kutusu → 1,5 mm sac kabin, içi boş (189,6 → ~20 kg)
    ÜÇÜ KATALOG KÜTLESİYLE (satın alınan birim, zarfı doğru, masif olmalar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
2026-09-22 Gerçek döner yatak montajda — Schaeffler XU080149
    TraceParts / Schaeffler (INA) · XU080149 çapraz makaralı döner yatak, dişsiz,
    iki tarafı keçeli. STEP ölçüldü: Ø196,85 × 22,27 mm · 14 katı · 3,27 kg.
    BULGU — YATAK TASARIMDAKİNDEN BÜYÜK. Modelde Ø160 × 20 (iç Ø70) varsayılmıştı;
    gerçek katalog parçası Ø196,85 × 22,27. İlk denemede 5 çakışma: apron, tabla home
    sensörü, home bayrağı ve ayar bileziği ↔ göbek.
    ÇÖZÜM — AYAR BİLEZİĞİ ZATEN BUNUN İÇİN VAR. Tasarımda "işleme aralığı 2–14 mm"
    yazıyordu; yatağın 2,27 mm fazlalığını bilezik yuttu (7,5 → 5,23 mm işlenir),
    göbek ve tabla YERİNDE KALDI. Kaskad gerekmedi. Ka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
    [xu080149.stp]
2026-09-22 Dijital ikiz Z-YUKARI'ya çevrildi — CAD Y-yukarı, Isaac/ROS Z-yukarı
    Kemal ekranda bakarken: "ürünlerin yönü yanlış, yukarı bakıyor, XYZ'de bir sıkıntı
    var, sahneyi mi çevireceğim?"
    HATA BENDE. Bizim CAD Y-YUKARI çalışıyor; Isaac Sim, ROS ve kütüphaneden gelen robot
    varlıkları Z-YUKARI. UR10e Z-yukarı geldiği için makineyle uyumsuzdu — ikisi 90°
    dönüktü. Sahneyi çevirmek çözüm değil, kaynağı düzelttim.
    DÖNÜŞÜM (topping_usd_v7): CAD (x, y, z) -> USD (x, -z, y) [X etrafında +90°]
    · ağ noktaları çevriliyor
    · yerçekimi (0,-1,0) -> (0,0,-1)
    · zemin Y-normalli dörtgenden Z-normalliye
    · eklem eksenleri: CAD X->X · CAD Y->Z · CA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
2026-09-22 Dijital ikiz: ön kapak kalktı, gerçek malzemeler (kasetler saydam), Isaac içinde ürün paneli
    - topping_fizik_ihrac_v8: on_kapak / on_kapak_pu / kapak_contasi fizik ihracatından
    çıkarıldı. Sitedeki modelde zaten çizilmiyordu, fizik ihracatında unutulmuştu;
    kapalı kapak kasetlerin önünü tamamen kapatıyor, ikizde hiçbir şey görünmüyordu.
    Kapak gerçek parça olarak BOM'da ve STEP'te duruyor, burada AÇIK kabul ediliyor.
    - topping_usd_v8: her tona bir UsdPreviewSurface — renk + metaliklik + pürüz +
    OPAKLIK. cam 0,22 opak (kaset gövdeleri saydam), sac/çelik metalik, bakır,
    kart, silikon, PU kendi tonunda. Önce yalnız displayColor yazılıyordu.
    - ikiz_ac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
2026-09-22 Ikiz v6 launcher: kesit araci acildi + panele GIZLE dugmeleri
    - omni.kit.window.section (Isaac'in Section Tool'u) kurulu ama base profilde
    kapaliydi; enable_extension ile aciliyor. Window > Section'dan kesme duzlemi.
    - Panelde GIZLE bolumu: DIS KABUK (11 parca) · KASET GOVDESI (6) ·
    MOTOR PAKETI (60) · PANO/SOGUTMA (6). Tik koy kaybolur, kaldir geri gelir.
    Parca sayilari parca listesinden dogrulandi, dordu de dolu.
2026-09-22 TOPPING v17: motor yanlis surumdu, duzeltildi + surucu gercek CAD oldu
    MOTOR HATASI (benim hatam): STP-MTRAC-23078'i torkuna bakip secmistim, urun
    sayfasindaki "Optimized for AC-input stepper drives" satirini kacirmisim. O
    motorun surucusu STP-DRVAC-24025; gercek CAD'ini indirdim, 141,2 x 47,5 x 113,7 mm.
    Elektrik bandindaki yuva 34 x 75 x 95 mm — hicbir yone donmuyor, 12 tanesi hic
    sigmiyor. Yer tutucu kutuyla calisirken bu gorunmuyordu.
    DUZELTME: ayni NEMA23 govdesinin DC surumu STP-MTR-23079
    1,95 N.m tutma (ihtiyac 1,2) · 2,8 A · 3,8 mH · 1,1 ohm · rotor ataleti 0,48 kg.cm2
    kutle 1,0 kg — hepsi surestepmotors.pdf s.3'ten, tahmin yok
    govde 76 -> 64,5 mm kisaldi: kuru bolmede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
    [stp-drv-4830.step, stp-drv-4850.step, stp-drvac-24025.step, stp-mtr-23079.step]
2026-09-22 TOPPING v18: guc kaynagi ve UPS gercek CAD oldu · kule UPS sigmiyor
    GUC KAYNAGI MEAN WELL NDR-240-24 (TraceParts STEP AP214) · 1,0 kg
    Neden 240 W: motor faz akimini 2,0 A varsaymistim, gercek motorun uretici
    tablosunda 2,8 A. Kemal'in formuluyle 154 -> 215 W, ust standart boy 240 W.
    (topping_hesap_v5)
    Gercek olcu 125,2 x 63,0 x 122,8. Yer tutucu 160 x 100 x 100 idi: derinlik
    22,8 mm tasiyordu, X'te ise 97 mm YER KAZANILDI.
    UPS PULS UB10.242 DIN ray UPS (TraceParts STEP AP214)
    BULGU: BOM'daki "500 VA hat ici UPS"in gercegi Eaton 5P650i; CAD'i indirildi,
    150 x 233 x 357 mm. Teknik bant 240 yuksek / 250 derin, UPS'e ayrilan X 220 mm.
    UC EKSENDE DE SIGMIYOR. Zaten kule UPS g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
    [5p650i.stp, ndr-240-24.stp, ub10-242.stp, w2e200-hh38-01.stp]
2026-09-22 KASAR VIDASI EKSIKTI — duzeldi · sogutma "yaptirilacak" · uretim 169 sn -> 6 sn
    1) KASAR HELEZONU EKSIK CIZILIYORDU (Kemal ekranda gordu)
    Kanat carpisma icin 2,5 mm dilimlere bolunuyordu; her dilim OCC boolean'iyla
    (sh.intersect(kutu)) kesiliyor, BASARISIZ KESIM "except: continue" ile SESSIZCE
    atiliyordu. Kasarda B segmentinin 44 diliminden 4'u, C'nin 36'sindan 4'u yazilmis,
    kanadin govdesi hic cizilmemis.
    YENI: boolean YOK. Parca bir kez aglanir, ucgenler agirlik merkezinin z'sine gore
    2,5 mm'lik kovalara ayrilir. Kesim basarisiz olamaz, ucgen kaybolmaz.
    Sonuc A 47 · B 44 · C 36 · D 35 — CAD segment boylariyla birebir.
    Kutle ucgen alaniyla orantili dagitilir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
2026-09-22 Site modeli v25: yeni motor, surucu, guc kaynagi ve UPS sitede de gorunuyor
    Site modeli hala topping_cad_v16 okuyordu — yani eski AC motor, kutu surucu,
    kutu guc kaynagi, kutu UPS. hat_montaj_v25 artik topping_cad_v19 + hesap_v5
    okuyor, sitedeki makine Isaac'teki ikizle ayni parcalari tasiyor.
    BOY: gercek surucu ve motor CAD'leri modul_C.glb'yi 13,4 -> 34,7 MB'ye cikardi,
    telefonda acilmaz. Iki onlem:
    - SURUCULER gercek OLCULU ZARF kutusu olarak ciziliyor (kutu STEP'in kendi
    sinir kutusundan, uydurma degil). Elektrik bandinda, dis sacin arkasindalar;
    disaridan zaten hicbir zaman gorunmuyorlar. Isaac ikizinde tam detay duruyor.
    - MOTOR ve REDUKTOR gercek CAD kaliyor, kaba agleniyor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
2026-09-23 Site modeli v26: kutu yok, Isaac'teki ile ayni gercek parcalar
    Kemal sirketteki BILGISAYARDAN bakiyor, telefondan degil — v25'teki boyut
    kaygisi yersizdi. v25'te suruculer gercek olculu zarf kutusu olarak ciziliyordu;
    artik sitedeki makine Isaac ikiziyle BIREBIR AYNI: satin alinan her parca kendi
    uretici CAD'iyle duruyor (STP-DRV-4830 surucu, STP-MTR-23079 motor, SureGear
    redüktör, NDR-240-24 guc kaynagi, UB10.242 UPS, HIWIN kizak/ray, XU080149 yatak).
    modul_C.glb 37,4 MB. Masaustunde sorun degil.
    Kaba aglama duruyor ama daha ince ayarda (0,6/0,8). TUZAK NOTU: uretici STEP'leri
    ICLERINDE HAZIR UCGEN AGI tasiyor, OpenCascade toleransi ne verirsen ver o hazir
    agi donduruyor — TC_AG(kab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
2026-09-23 Site modeli v27: on kapagin PU cekirdegi de cizilmiyor
    Kemal: "sitedeki toppingin on kapagini sil kasetleri goremiyorum."
    Liste v15'ten beri eksikti: kapak o surumde masif bloktan SAC KABUK + PU CEKIRDEK'e
    cevrilmisti; montaj gorunumunde "on_kapak" ve "kapak_contasi" disarida birakildi
    ama "on_kapak_pu" listeye eklenmedi. Kapagin sac kabugu gitmis, yalitim dolgusu
    tek basina kalmis ve kasetlerin onunu kapatiyordu. Ayni hata fizik ihracatinda da
    vardi, orada 22 Eyl'de duzeltilmisti — site tarafi atlanmis.
    ?v=26 -> ?v=27.
2026-09-23 TOPPING v20 · TEPSISIZ KURGU: calisma diski, tabla kilidi, banda aktarma, konili acici
    Kemal'in onayladigi karar listesi modele islendi.
    TEPSI IZLERI SILINDI
    merkezleme pimleri + tablanin kenarindaki uc parmak kesigi kalkti. Kesikler
    robotun tepsi altina parmak sokmasi icindi; hamur artik dogrudan bu yuzeyde
    aciliyor, delik ZARARLI.
    CALISMA DISKI Ø340 · 8 -> 2
    mat gida UHMW, elle cikar, uc pimle tutulur, yedekli. Ust yuz Ø340 boyunca DUZ
    (y 108); incelme ALT yuzde, son 15 mm'de taban 100 -> 106'ya cikip kenar 2 mm
    kaliyor. Sebebi: bant hamuru SOYARAK birakiyor, surterek degil.
    MAT olacak — cilali yuzeyde koniler hamuru acmaz, yerinde DONDURUR.
    TABLA KILIDI
    ayar bilez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
2026-09-23 Animasyon duzeltmeleri: tabla soldaki aciciya gecebiliyor, acici gorunuyor, hamur TOP geliyor
    Kemal: "hersey kaymis animasyonda. soldaki yerede gidemiyor tabla cunku yolunu
    acmamissin. ustundeki o parcayi da yapmamissin. hamur top halinde de koymamissin."
    1) YOL GERCEKTEN KAPALIYDI — benim hatam
    Yan sacta IKI AYRI delik acmistim: tabla icin 92-130, mekanizma icin 1-66.
    Arada 66-92 DOLU kaliyordu ve tam oraya DONER YATAK (58,5-80,8) ile AYAR
    BILEZIGI (80,8-86) denk geliyordu. Artik modulun alt bandi iki uctan da TEK
    PARCA acik (y 1-132, z -510..0): araba plakasi, yatak, bilezik, gobek, tabla
    ve calisma diski serbest geciyor.
    2) ACICI GORUNMUYORDU
    ACICI_KAFA / KOLON / KIL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
2026-09-23 Geride kalan parcalar duzeldi + tabla artik acicinin altinda park ediyor
    Kemal: "su parcalar ne, sil onlari ise yaramiyorsa" (ekran goruntusunde daire
    icine alinmis) + "tabla her zaman presin altinda beklesin, isi bitince oraya donsun".
    1) O PARCALAR ISE YARIYOR — YANLIS GRUPTAYDILAR
    v20'de eklenen CALISMA DISKI, DISK PIMLERI ve KILIT BURCLARI hareketli grup
    listelerine yazilmamisti, SABIT sayiliyorlardi. Tabla X'te giderken onlar
    yerinde kaliyordu — ortadaki buyuk beyaz elips calisma diskinin ta kendisiydi.
    TABLA_P += calisma_diski, disk_pimi_ (tablayla birlikte doner)
    ARABA_P += kilit_burcu_ (ayar bileziginde, arabayla gezer)
    Hem site mode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
2026-09-23 Tabla artik PARK KONUMUNDA ciziliyor (en sol, acicinin alti)
    Kemal: "ulan tabla tam ortada, en solda baslamali."
    Tabla strokun ORTASINDA (x 900) cizilmisti — o eski tepsili kurgunun istasyonuydu.
    Park yeri artik sol uc. Cizim konumu XC_TABLA = -350 sabitine baglandi ve
    sim_makine.json da AYNI sabitten okuyor, ikisi bir daha ayrilmasin diye.
    (baslangic_x 900 -> -350, pivot da ayni)
    BUNU YAPINCA CIKAN CAKISMA
    Park konumundaki araba X TAHRIK MOTORUNA giriyordu — cunku bir onceki turda
    tahriki sol uca tasimistim (sag uc urun cikisi diye). Olculdu: kayis kolu x
    motor 12.619 mm3, kelepce x kaide 1.286, apron x motor 425.
    X TAHRIKI SAG UCTA BIRAKILDI (geri alindi).
    AKTARMA KOPRUSU artik A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
2026-09-23 ACICI ve FIRIN BANDI ANIMASYONLU: kafa iniyor, koniler donuyor, pide banda gecip firina gidiyor
    Kemal: "hic bir detay yok, calisan birsey yok, nasil banta dustugu gorulmuyor,
    animasyonu yok. su parcalar uretime gidicek kadar detayli ve animasyonlari olmali."
    MODEL: yeni hareketli paketler AYRI DUGUM olarak yaziliyor
    ACICI kafa takimi (yatak, reduktor, motor, aski, kafa plakasi) — dikeyde iner
    KONI_ON on koni + mili — KENDI EKSENINDE doner
    KONI_ARKA arka koni + mili — TERS YONDE doner
    BANT bandin kendisi
    BANT_BURUN Ø20 burun silindiri — doner
    BANT_TAHRIK Ø60 tahrik silindiri — doner
    (hat_montaj_v33 + topping_fizik_ihrac_v16, ikisi ayni list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
2026-09-24 Son model (topping_cad_v21) Isaac Sim'e aktarildi
    Kemal: "son yaptigin 3d modeli Isaac Sim'e aktar, kendi dosyana."
    ZINCIR topping_cad_v21 -> topping_fizik_ihrac_v16 -> topping_usd_v14
    -> topping_ikiz_v14 -> ikiz_ac_v11
    CIKTI TOPPING_fizik_v14.usd (19,1 MB) · TOPPING_IKIZ_v14.usd
    1189 parca · 1,49 M ucgen · 14 eklem · 16 rijit cisim
    SABIT kutle 290,82 -> 343,15 kg (acici + bant paketi 52 kg)
    KUTLESI VARSAYIM OLAN PARCA: 0
    IKI HATA YAKALANDI VE DUZELTILDI
    1) Ihrac dosyasi topping_cad_v19'u okuyordu — yani acici ve bant modele hic
    girmiyordu (modul 205 parca cikti, olmasi gereken 237). Kaynak v21'e cevrildi.
    2) EKLEMSIZ GRUP SERBEST CISIM OLUYORDU.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
2026-09-24 HAT_ATOSA_TABLALI v4 · dukkanda yalniz LAVABO kaliyor
    Kemal: "temizlikti, yedekti, 4 gunluk kutu, 4 gunluk icecek, ne varsa buna koy.
    Dukkanda sadece lavabo. Bulasik makinesini de koy, kaplarimizin sigacagi sanayi
    tipi olanini arastir bul. Bos bir suru yer var."
    BULASIK MAKINESI — arastirildi, secildi, yerlestirildi
    MEIKO M-iClean UM sinifi TEZGAH ALTI · 460 x 600 x 730 · sepet 500 x 500
    giris yuksekligi 315 mm · 2,4 L/sepet · cevrim 90/120/180 sn · 40 sepet/saat
    YER: F modulunun tabanindaki 680 x 770 x 835'lik BOS hacim. Yaninda 2 x 5 L
    makine deterjani + parlatici.
    NEDEN GIYOTIN DEGIL: giyotin (M-iClean HM) 635 x 750 x 1520 ve kapagi kalkinca
    ~2000 — hatta o hacim yo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
2026-09-24 HAT_ATOSA_TABLALI v7 · TOPPING bolumu topping_cad_v22'ye esitlendi (strok 1987, X tahrik, tekne)
    Tekne modul C'nin sag kenarini 85, sag kasnak 35 mm asiyor - paftada kirmizi uyari.
2026-09-24 Makine montaji v36 · B cekmece modulu gercek uretim modeli (store_cad_v1)
    21 contali motorlu cekmece (ray + GT3 kayis + 24 V motor + reed), K4 sogutma + depo + nis, K1 ustu kart bolmesi.
    Ince tepsi: pide 5x4, lahmacun 6x6 -> 160 / 432 top. Strok 640, arka sira acilinca on yuzun onunde.
    Cakisma taramasi kapali ve acik konumda 0.
2026-09-24 Makine montaji v37 · B cekmece modulu v2: fitil, yan kayis, standart urunler, calisma animasyonu
    Fitil: gecmeli manyetik profil 21 x 18,5 her soguk kapakta (kanalli). Kayis yan bantta (T4).
    Motor Transmotec PD3665-24-51-BFEC, ray Accuride DZ3832-0070, acik/kapali reed Littelfuse 59135,
    pano S7-1200 + Mean Well NDR-240-24 + Electromen EM-324C + 21 secici role, Secop CU KLF4.0CND.
    Strok 628 / 3,3 sn; cakisma kapali 0, acik 0. BOM: 69 kalem (23 satin alma, 46 uretim).
    [BOM.csv, BOM_OZET.csv]
2026-09-25 PACK · E kutu katlama modulu v1: standart pizza kutusu, 830 modul, 7 eksen, calisma animasyonu
    - Kutu: 32x32x4,2 E-dalga "Amerikan kapama" (US 4441626 A dizilimi), acilim hesap 804 x 404
    - 700'e sigmiyor (acilim boyu + sarjor/kalip izdusumu) -> modul 830 x 830 x 2030 (hat 5430, onay bekliyor)
    - Sarjor 567 kutu, ustten itmeli besleme, zimba kalibi, dusen kopru, devirme parmagi, U flap katlayici, kapak kolu
    - Standart parcalar: SureStep STP-MTR-23079 + STP-DRV-4830, SureGear PGCN23-1025, HIWIN HGR15/HGH15CA (uretici STEP), SFU16, S7-1200
    - Kinematik tek kaynak (GLB + tarama); cakisma: makine 201 an, kutu 46 an, pizza 25 an -> 0
    - Acik: kose tirnagi kiviricisi, uretici bicak cizimi; K icin sar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
    [BOM.csv, BOM_OZET.csv]
2026-09-25 PACK v1 · BOM ozeti: ayni urunun ornekleri toplanir (7 motor, 7 surucu, 10 araba, 6 ray); tekrar eden satin alma parcalari uretim satirina dusmez; STEP ciktisi kaldirildi
    [BOM.csv, BOM_OZET.csv]
2026-09-25 Makine montaji v38 · E kutu katlama modulu ana montajda (kutu_cad_v2) + PACK v2
    Kemal: "detaylar genel montajda da gorunsun, istasyonu acmak zorunda kalmayayim".
    E: 11 birim gercek parca (210 parca), 16 mentese dugumu, dondurme kanallari; ortak 40 sn dongu
    (cekmeceler 1 tur, kutu modulu 2 tur). Hat 5430 (E 830; pafta v8 onayi bekliyor).
    kutu_cad_v2: kayis_y z isaret hatasi (asansor/piston kayis kollari modulun onunde havadaydi) -
    montajin zarf denetimi yakaladi; piston BK12 aski ayaklari kayisin iki yanina alindi; kutu
    uretecine kendi zarf denetimi eklendi. Taramalar: makine 201 an 0, kutu 46 an 0, pizza 25 an 0.
    Montaj SolidWorks STEP yazmiyor.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
    [BOM.csv, BOM_OZET.csv]
2026-09-25 Makine montaji v39 · cekmece rayi uc elemanli teleskop (store_cad_v3)
    Kemal: "cekmeceler aciliyor ama havada kaliyor, cekmece rayindan cikip havada kaliyor".
    v2'de ray iki parcaydi; acilinca ic profil dis profilin 97 mm onunde kaliyordu.
    v3: Accuride DZ3832 gibi uc eleman - dis (kasa, sabit), ara (strok/2 = 314), ic (cekmece, 628).
    Tam acik en az bindirme dis-ara 384 / ara-ic 380 mm, kutu-ic ray bagi 527 mm; cakisma kapali 0,
    acilma yolunda 4 konum 0 (hareketli-hareketli dahil). Ara elemanin yari hizi varsayim.
    Montaj: ara ray dugumleri cekmeceyle ayni zamanlamada yari yol animasyonlu. BOM 1_STORE_v6.
    STORE sayfasi: GERCEK_STORE rozeti eksikti (v36'dan beri birim listesi ve etiket hata veri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
    [BOM.csv, BOM_OZET.csv]
2026-09-25 Makine montaji v40 · alt taban cizgisi 123 + ana montaj animasyonsuz
    Kemal: "ustte bant istasyonlari hizali, alt taraf da oyle olmali; en alt cekmecenin altindaki
    gereksiz alani kaldir, sagdaki istasyonlarin alt tabanini ona hizala" + "ana montajda animasyona
    gerek yok, icine girince oynasin".
    B store_cad_v4: yalitimli taban en alt cekmece onunun 3 mm altina cikti (167,5 - 3 - 41,5 = 123);
    cekmeceler yerinde; K4 sicak bolmesinin alti tek sac (Secop +3 mm, bidonlar sigiyor).
    E kutu_cad_v3: govde 123'ten; asansor tahriki tabanin altinda (motor aski plakasi + kayis
    koruyucu), sarjor 567 korundu; supurgelik 60 geride. F ve K taban dolaplari 123-1060 + supurgelik.
    Denetim: B/E/F/K alt cizgisi 12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
    [BOM.csv, BOM_OZET.csv]
2026-09-25 HAT_ATOSA_TABLALI v8 · teknik resim modele (montaj v41) esitlendi
    Kemal: "teknik resmi de buna gore guncelle, siteye update et".
    Hat 5430 (E 830 kutu katlama, kutu_cad_v3: sarjor 567, besleyici 1500, tepsi 1104, agiz 1085-1330),
    alt taban cizgisi 123 (butun govdeler, B yalitimli taban 123-164,5), surec kotu 1168 (tabla ekseni z -170),
    TOPPING ic kotlari topping_cad_v22'den (tabla 1060-1168, soguk kabin 1250-1760, kasetler 1320-1680),
    TOPPING'de 2 kaset (kasar + kup sucuk, Codex adaylari) + 4 bos yuva, B store_cad_v4 (K4 Secop + GN depo +
    temizlik nisi, K1 ustu pano), F govde 1060-1486 / bant 1166, K plaka 1164 / yedek kutu yok.
    Uyari eklendi: acicinin kafa plakasi ve on koni motoru govdenin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
2026-09-25 Beldos Mini-fill E-P + Beltop UNO 275 (sehpasiz) 3B modelleri
    beldos_cad_v1.py: iki makine Beldos brosur olculeri ve olcekli cizimlerinden;
    her parca kaynak etiketli (brosur / cizimden olcek / foto / hesap / varsayim).
    UNO'nun ayaklari, alt taban saci, bukum sac govdesi, ust tablasi, yan raylari
    ve valf kilit kolu silindi; yerine duz baglanti plakasi (bizim). 15 denetim
    gecti (685 / 690 / 197 / O384 / 477x296x228 / 149 / 495). Sayfa: otonom/hat/beldos.html,
    TOPPING T2 satirindan linkli.
2026-09-25 TOPPING v2 · sos ve harc icin duz kaplama bicagi (Beldos icing nozzle tipi) + yalitim cebi + tabla 1 tur
2026-09-25 Makine montaji v43 · TOPPING altindaki PU yalitim tabani yerine 3 mm tasiyici raf (154 kg, sehim 3,4 mm)
2026-09-25 HAT_ATOSA_TABLALI v10 · teknik resim modele (montaj v43) esitlendi: TOPPING v2 havali UNO, spreader, 3 mm raf, valf adasi, kompresor K tabaninda
2026-09-25 Makine montaji v44 · alt kisim v3: B store_cad_v5 (tam kaplayan kapaklar, icecek tek kat, K4 kasar/sucuk deposu + PLC Secop arkasinda), F/K tabanlari yeniden, kompresor K tabani arkasinda · pafta v11
    [BOM.csv, BOM_OZET.csv]
2026-09-25 Makine montaji v45 · K kesme + sprey gercek model (kesme_cad_v1) · TOPPING v2 dozaj hesabi + canli simulasyon · ana montaja 1 tam animasyon · pafta v12
    - K: PU bant (RollerDrive), Festo DGRF-C kesici + PulsaJet tereyag nozulu ayni kafada, 20 derece cit, igus eksenli itici, 3 L isitmali tank, pano; cakisma taramasi makine 0 / urun yolu 0 / itici x E 0; kesme.html
    - TOPPING: topping_v2_hesap_v1 tek kaynak (sos tam 1 tur, kama yarik q ~ r, spiral), topping_uno_cad_v5, makine_kodu_v2.js + sim3d_v2.js (secince baslar, karisik secilebilir)
    - hat_v45.glb: pizza cekmeceden QR dolabina 84 s tek dongu (yolculuk_v45.py)
    - HAT_ATOSA_TABLALI v12 + PDF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
    [BOM.csv, BOM_OZET.csv]
2026-09-26 Makine montaji v47 · animasyon eksen duzeltmesi (v46) + on yuzden tasan parcalar iceri · pafta v13
    - v46: donen parcalar (tabla, konileri, UNO valfleri, kaset milleri, aktarma makaralari) kendi ekseninde duran dugum;
    kareler arasi sapma 350 mm -> en cok 2 mm (her derlemede olculur) · tabla_bos_sensoru sabit · 30 kare/s
    - v47 (topping_cad_v23): aktarma bandi motoru bandin arkasinda, tahrik makarasiyla es eksenli (on yuzun 78 mm onundeydi,
    havada ve 90 derece ters) · on yan sac + mil uclari + fire silecegi z <= 0 · cikis yarigi 24 -> 44 mm (kup sucuklu urun gecer)
    - yer tutucu firin bandi TOPPING tahrik makarasinin icinden baslamiyor · hamur topu tablaya oturuyor
    - montajda on yuz d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
2026-09-26 F firin denemesi (ayri surum) · Sveba Dahlen TP10 gercek katalog firini hatta uyarlandi · ana makine v47 degismedi
    - firin_tp10_cad_v1: TP10 3B (foy olculeri + cizimden ≈ · ic yerlesim VARSAYIM) · uc kutulari ekran tarafinda yan kutu
    - hat_montaj_tp10_v1: F = TP10 (x 2514-4064, ayaksiz, ekran arkada, bant 1166) + giris bandi (70 mm, NEMA23 + GT2)
    + 2 adet 20 derece cit (urun -170 -> -249 -> -170) + destek saclari + arka sac · TOPPING aktarma bandi yerine giris bandi,
    X motoru kaidesi pahli · K bant levhalari 18'den, itici motoru sag uca, sol sac penceresi + uc kutusu cebi
    - denetim: gercek kati kesisimi TEMIZ (135 x 89 parca) · urun yolu TEMIZ (O280 + O300 zarf) · on yuz GECTI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
2026-09-26 F firin denemesi v2 · TP10 kesiti, govde 1500'e uzatildi (bos bant yok, isitilan 1316, 4 urun) · son kontrol TEMIZ · pafta v3
    Kemal: "gercek firinin sadece onunu arkasini istedigimiz olcuye uzat, bant bos olmasin, son bir kontrol yap".
    - firin_tp10_cad_v2: TP10 kesiti aynen, govde 2500-4000; uc rulolari uc duvarlarinin (60) icinde, bant 2568-3996; on oda 64
    (giris bandi + TOPPING X tahriki cebi); tahrik + gergi teknik bolmede; urun -249, kayma diskte (itici ACIK) + K bandinda giris citi.
    - BULGU: TOPPING mekanizma teknesi + X tahriki F'ye 85 mm tasiyor (v47'de zon muafiyeti gizliyordu) -> cep, karar Kemal'de.
    - hat_montaj_tp10_v2: gercek kati kesisimi TEMIZ, urun yolu TEMIZ (403 konum),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
2026-09-26 Makine montaji v51 · FIRIN 79 mm ONE (firin_tp10_cad_v5: cikinti 1500x517x79, F 909, urun hatti -170 duz) · itici_cad_v3 duz 170 (destek plakasi yok) · topping_uno_cad_v9 fitil tam · kesme_cad_v2 on 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
    [BOM.csv, BOM_OZET.csv]
2026-09-27 Makine montaji v52 · kutu yedegi TEK YERDE firin ustu sol 320 (887 = 3,1 gun, dolap pizza gozu bos) · firin_tp10_cad_v6 raf 4 mm + 10 takoz (99 kg, sehim 0,2 mm) · FIRIN KABUGU GORUNUR (v51 ciplak fi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
2026-09-27 Teknik resim HAT_ATOSA_TABLALI v14 = montaj v52 · F TP10 1500 79 mm one (cikinti, F 909) + ust raf 4 mm/10 takoz: sol kutu yedegi 320, sag kompresor, davlumbaz arka · aktarma iticisi MY1B16-250 + gir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
2026-09-27 Montaj onbellegi (onbellek.py + ob_calistir.py): icerik adresli cache — cut/fuse/intersect/clean sonucu, yuzey agi, sinir kutusu ve STEP okuma geometrinin parmak iziyle diske yazilir; yalniz degisen 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
2026-09-27 Makine montaji v54 (Kemal'in 5 maddesi) · TOPPING yalitimi tek dikdortgen + teknik cep 1,5 mm sacla ayrik (topping_uno_cad_v10) · K tank + pano uste, taban bos (kesme_cad_v3) · icecek yedegi firin us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
    [BOM.csv, BOM_OZET.csv]
2026-09-27 Makine montaji v55 (gorsel): TOPPING yalitimi yari saydam gorunur, teknik ayirma saci mavi, pizza + icecek yedegi yiginlari karton rengi (Kemal: 3D'de goremedim) · geometri ve denetimler v54 ile ayni
2026-09-27 Makine montaji v57 · ALCAK HAT (Kemal onayli Resim 1 v4 + QR_TEZGAH v4): her sey 168 asagi, tek duz cizgi 788 (tek parca cekmeceli dolap 0-4000 ustu = A, C, firin alti), kaide 104 (mekanizma 892, dis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
    - store_cad_v6: K1 6 lahm · K2 6 lahm · K3 5 pide · K4 Secop + B panosu + kasar/sucuk depo · K5 3 pide + tatli (firin alti, PU 60) · K6 3 icecek · serit: robot copu 15 L + klape · firin alti tasiyici cerceve · soguk tam 2 gun (160 / 432 / 144 / 12)
    - kesme_cad_v4 + kutu_cad_v5 (dilim_v1: 168 mm dilim), bulasik K altinda (deterjan + parlatici arkasinda), icecek yedegi 6 koli E altinda (288 = 4 gun),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
    [BOM.csv, BOM_OZET.csv]
2026-09-28 Site temizliği + montaj v67 (sahte şeffaflık yok)
    Kemal: "hâlâ eski montajlar parçalar çıkıyor sitede, sil bunları, sayfaları düzenle"
    + "yalıtım neden şeffaf, ön kapaklar dışında her şey normal olsun".
    - Montaj v67: yalıtım, UNO silindiri, robot ve yer tutucular opak; sahte
    şeffaf yüzey panelleri kalktı. Şeffaf kalan: ön kapaklar + PC kaset.
    - Beldos v2: UNO silindiri, kasa sacı, bağlantı plakası opak.
    - Eski sayfalar silindi (TOPPING v1, seçenekler, alternatif, dolap, çekmece,
    ekran, kod, sim, geçmiş, karşılaştır, eski akış sayfaları).
    - Kalan sayfalardan eski kartlar, sürüm geçmişleri, eski pafta/render
    resimleri, 'önceki' notları ve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
    [BOM.csv, BOM_OZET.csv]
2026-09-28 Montaj v68: yalıtım her yüzde tam (çıplak süzgeç kalktı)
    Kemal: "Çekmecelerin bazı yerinde yalıtım malzemesi görünmüyor ya da
    eksik, tam dönmüyor, temiz olmalı."
    - 27 Eyl'deki görsel süzgeç (CIPLAK) 22 gerçek parçayı modelden
    düşürüyordu: dolabın arka PU'su, sol yan PU'su, arka/sol sacları;
    K ve E'nin yan/arka/üst sacları, E şarjör yan kapısı, fırın taş yünü.
    v68'de süzgeç kapalı; "kabuk" sacı opak (yarı saydam tanımlıydı).
    - Ölçüm (sitedeki modul_B, 5 mm ızgara): arka, sol yan, üst, alt ve
    sağ ara duvar yüzleri %100 PU ile kaplı (v67'de arka ve sol %0).
    - Şeffaf kalan yalnız ön kapaklar + PC kaset.
    - Sayfalar v68'e güncel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
2026-09-28 Montaj v69: üretim düzeltmeleri (katı denetimi) + kesitte dolu yüz
    - B store_cad_v9: kapak iç sacı tek parça (fitil kanalının dışındaki halka = dış sacın arka dönüşü), ısı kalkanı sol sacı tek parça (x 2534)
    - C topping_uno_cad_v15 (K1/K2 kapak iç sacı tek parça, sucuk_cad_v8, Codex STEP kırıntıları atılır; 176/176) + topping_cad_v26 (açıcı kolonu 120 × 50 × 4 kutu profil, ray örtüsü 4 ayrı L şerit; dünya denetimi 28/28)
    - E kutu_cad_v8: kapak masası açıkça 2 levha (kol 0–144° taraması, en az 1,00 mm, kesişim 0)
    - Kaset sucuk_cad_v8: örümcek kaynak yakaları kola bitişik (kontrol listesi v7 → v8: bozulan yok)
    - denetim_kati_v2: 3867 p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
    [BOM.csv, BOM_OZET.csv]
2026-09-28 Keep mechanism demos bright on dark-mode devices
2026-09-28 Add folding-nose and rotary-belt table experiments with transfer timing
2026-09-28 Denemeler: tabla → fırın aktarma seçenekleri (3B animasyon + kroki + kapasite simi)
    Bugünkü itici, A tabla bekler, B yükleme bandı (fırın 3 pide), B′ yükleme bölümü tünelin içinde (fırın 4 pide).
    Sim tam yük 1./2. saat: A 32/39 · B 44/55 · B′ 56/65. Ana model değişmedi.
2026-09-28 Publish thin-nose belt pickup and deposit animation
2026-09-28 3B pencere uzun: ekran boyu − 70 px (en az 640), telefonda − 150 px (en az 480) · hat.css v12
2026-09-28 Add isolated modular station CAD v1 and verified local preview
    [BOM_EK.csv, MODULER_EK_PARCA_v1.step, cikis_tupu_v15.step, cikis_tupu_v2.step, helezon_B_v15.step, helezon_C_v15.step, helezon_D_v15.step, helezon_D_v2.step]
2026-09-28 Bantlı tabla v1: kare bant kaseti 310×310 + mıknatıslı tahrik + yükleme bandı (hesap + üretim CAD + simülasyon, yerel)
    Hesap (bantli_tabla_hesap_v1): Forbo Transilon E 3/1 U0/U2 bant, 2 eş Ø12 rulo, Century Spring
    62266SCS gergi (33,6 N/kol), GT2 140 (rotor 28T / burun 20T), mıknatıslı kavrama (6 × S-10-05-N,
    dipol tahmini 0,39 N·m / gereken 0,075), açıcı 482 N altında yatak sehimi 0,45, dönüş Ø447,8,
    aktarma 2337 → 2365,4, aktarma 1,25 s.
    CAD (bantli_tabla_cad_v1): 87 katı + bant/GT2 ağları; TOPPING v26 + A kabini bağlamı ana klasörden
    salt okunur çıkarıldı (baglam/, gz). Denetim D1–D10 hepsi geçti: kaset iç çakışma 0 (1128 çift),
    ayarlı istasyon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
    [BOM_bantli_tabla_v1.csv]
2026-09-29 HAT üst sayfası barına "Bantlı tabla v1 · 3B simülasyon" düğmesi + simülasyon sayfasına "← HAT" dönüş bağlantısı
    Kemal: "erişemiyorum buna, bir yere link koy, tuş koy, hattın içinde tepedeki sayfaya, barda olsun".
2026-09-29 HAT barına Modüler v1 düğmesi · modüler sayfasına ← HAT · STEP siteden kaldırıldı (kural 6.7)
    Kemal (29 Eyl 2026): her dediğini yap. MODULER_EK_PARCA_v1.step ve sayfadaki
    indirme bağlantısı kalktı; dosya git geçmişinde duruyor.
    [MODULER_EK_PARCA_v1.step]
2026-09-29 Fırın → B yük yolu + B ağırlık zarfı hesabı v1 (CAD değişmedi)
    F kullanımda 409,8 kg (eski hesapta üst kabin 110,8 kg yoktu); 40×40×2 kirişler
    26,8 / 37,8 MPa (izin 137), dikme burkulma güvenliği 104. B boş taşıma tahmini
    892–968 kg (Secop föy 10,9 kg; evaporatör CAD'de dolu blok). Ayak kataloğu açık.
2026-09-29 Montaj v70: bantlı tabla ana montajda · TOPPING v27 · fırın v9 · pafta v19
    Kemal (29 Eyl 2026): montaja adapte et. Kare bant kaseti 310 × 310 (elle çıkar)
    disk + tabla + iticinin yerine; sabit mıknatıslı tahrik TOPPING sağ-arkada;
    yükleme bandı fırının ısıtılmayan ön odasında (ısıtılan 1028, 3 ürün); aktarma
    2365,4; ray 2498; orta dikme boşluklu; yarık alt 965. İtici kalktı.
    Denetim: fırın çakışma TEMİZ · ürün yolu TEMİZ · araba+kaset aktarmada ve
    6 istasyonda dönüş TEMİZ (apron ve avara braketi düzeltildi).
2026-09-29 Montaj v72: bağımsız istasyonlar (Codex modüler v1) v71 üstüne
    A kendi sağ duvarı + A–C contası · B/K/E alt şase + M12 yuvaları · B içinde A/C
    taşıyıcı + GFRP · B–K, K–E, A/C→B bağlamaları · köpük/sac cepleri. 96 yeni parça,
    22 parça uyarlandı. Tüm denetimler TEMİZ (yeni parça denetimi dahil).
2026-09-29 Add isolated 400mm K station articulated pusher motion study
2026-09-29 STORE v10 + montaj v76 (yerel): tepsiler, kola parmakla, 21 cekmece simetrik
    Strok 628 -> 700 (avara -73 -> -1, ray ayni). Her sey silikon tepside,
    yayli itici kalkti: lahmacun 42, pide 25, icecek 48, tatli 12 / tepsi.
    2 gun kurali: lahmacun 10, pide 7, icecek 3, tatli 1 = 21 cekmece.
    K1-K3 5'er, K5-K6 3'er ayni on cizgileri. Kutular 540, fan payi 19.
2026-09-29 STORE v14 + montaj v80 (yerel): kutu tabani 2 mm, motor rampasi 0,3 s
    Cekmece kutusu tabani 1 -> 2 mm (yanlar 1 mm): dolu icecek cekmecesinde
    sehim ~12 -> 1,8 mm. Surucu rampasi 0,3 s: en agir cekmece 34 kg icin
    motor 25 N / 60 N. Yuk denetimi (ray 45 kg, motor 60 N, sehim 2 mm) her
    cekmecede assert. Animasyonda acilma 3,7 + 0,3 s.
2026-09-29 TOPPING duzeltmeleri + montaj v81 (yerel): kaide ayni hiza, conta yok, ray civatalari
    kaide_cad_v3: A 1,5-700, C 700-2500 (istasyon yuzleriyle ayni hiza, A|C arasinda
    16 mm bosluk kalkti), C arka -830. moduler_montaj_v3: A-C cevre contasi kalkti.
    topping_cad_v28: HGR15 havsalarina DIN 912 M4x16 (delikler bos kalmaz).
    Montaj: kaset donus supurmesi A kabini + firin/yukleme bandi/firin ustu kabine
    karsi da denetlenir (sos 685,8 / A duvarina 34,5 mm; sucuk 2517,2 / yukleme
    bandina 4,7 mm).
2026-09-29 v84: motor-driven E corner folding, positive front tuck and guided lid former
    Local main model on v83. 143-state changed-tool scan clean; final full-width press relief checked at 461 poses. Prototype only: physical carton, torque and motion-control validation remain open.
2026-09-29 E v11: vacuum sheet transfer and motorized supported forming nest
2026-09-29 TOPPING evaporator kapagi + sogutma hatlari arka duvardan (TU v17, yerel)
    Kemal: "o teknik kismini gormeyelim; sanayi tipi buzdolaplarinda onune delikli sac
    panel konur, hava oradan gelir". topping_uno_cad_v17: A tavanindaki evaporatorun onu
    ve alti AISI 304 1,0 yarikli kapakla kapandi (on izgara 63 yarik 60x6 = 22680 mm2,
    2,7 m/s; alt donus izgarasi 45 yarik = 16200 mm2, 3,8 m/s @ 0,062 m3/s); ici hava
    yoluna gore (donus bolmesi arkada, lamel, fan, ufleme). Sogutma hatlari tavandan
    degil evaporatorun arkasindan arka duvardaki POM bloktan kuru bolmeye, oradan teknik
    cepteki yogusma unitesinin arka yuzune; L duvari deliksiz; soguk odada gorunen hat
    yok. TU 203/203; TC v29 dunya denetimi TU v1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
2026-09-29 TOPPING sogutma grubu kaideye, soguk kutu dikdortgen, esit kapaklar (TU v18 + TC v30 + kaide v4, yerel)
    - topping_uno_cad_v18: soguk kutu dikdortgen (basamak ve teknik cep kalkti), K1 = K2
    mekanizma kanatlariyla ayni derz, flipper kam orani 33, evaporator sag ustte 400,
    hatlar kuru bolmeden dikine kaidedeki uniteye. Denetim 201/201.
    - topping_cad_v30: Secop CU KLF6.6CND kaidede (x 1633-2013, y 815-1087), tepsi + askilar,
    teknik bolme perdeleri, kanat alt bandi izgara (sol emis + filtre, sag atis),
    pano + UPS + guc kaynagi kuru bolmenin ustunde, servis kapagi, enerji zinciri kanali 25 one.
    Dunya denetimi 33/33.
    - kaide_cad_v4: C kaidesinde unite cebi + 4 gozde hava penceresi (y 800-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
    [yap_topping_uno_cad_v18.py]
2026-09-29 v86: TOPPING sogutma grubu kaidede, soguk kutu dikdortgen, esit kapaklar (Codex v85 ustune, yerel)
    - hat_montaj_v86 (yap_hat_montaj_v86): topping_uno_cad_v18 + topping_cad_v30 + kaide_cad_v4,
    ana hava hatti firin ustunde arkadan (z -740) TOPPING kuru bolmesine,
    kaide <-> TOPPING denetiminde sogutma grubu cebi haric + sogutma grubu <-> cekmeceli dolap denetimi (18 mm).
    - Denetimler: sozlesme 36, firin cakisma + urun yolu, donus supurmesi, bantli tabla, kaide, S + ray,
    QR goz yolu, bagimsiz istasyon, on yuz, hava ana hatti TEMIZ; USD GECTI.
    Bilinen bilgi satiri (bulasik kapak zarfi) v84/v85 ile ayni.
    - Parca etiketi duzeltmesi: kaide pencereleri 66 yuksek, hava hatti metni (teknik cep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
2026-09-29 S personel tezgahi v2: bulasik makinesi tezgah altinda, ustte el yikama evyesi (tezgah_cad_v2 + bulasik_cad_v3, yerel)
    - Kemal 30 Eyl: "bulasik makinesini personel tezgahinin altina koy, tezgahi ona gore ayarla, ustune kucuk el yikama evyesi".
    - Tezgah on zonun sag ucundaki cebi doldurur (x 3842-4505, z 1044-1874, ust 900 + 100 etek).
    - MEIKO M-iClean US (bulasik_cad_v3: ayaklar geri, on yuz -x) kapagi bekleme alanina acilir (84 derin on zonda ince duvara bakan kapak acilamazdi).
    - Ustunde kilitli kisisel cekmece.
    - Evye dolabi: hazne 300x300x150, GROHE Euroeco Cosmopolitan E 36271000 fotoselli batarya, Stiebel Eltron EIL 3 Premium ani su isitici (sicak su yonetmeligi), sise sifon, kose musl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
2026-09-29 E v12: gercek sureler (katalog hiz/ivme sinirlari, dongu 23,0 -> 31,96 s), kafa inisi 2,20 + kafa plakasi arka kenari 3 mm kirpildi (yakinlik 1,29 -> 4,30 mm), BOM + sifir sensorleri; tam tarama: kes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
2026-09-29 K v8 uretim modeli (Codex K400 v7 uzerine): Festo DGRF-C-63-125 gercek geometri + baglanti plakasi, PulsaJet AAB10000AUH-03 + UniJet TG-W dik (104210 TG almiyor), MY1B10G katalog + MY-J10 + D-M9N + A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
2026-09-30 K v8: denetim betigi _local/k-v8'e (kapsam) — _uretec'e kopyalanip ob_calistir ile calisir
2026-09-30 v87: K v8 uretim (Codex K400 v7 ustune) + E v12 gercek sure + tezgah v2 (bulasik tezgah altinda, el evyesi) + GERCEK SURELI animasyon + sayfa duzeni (yan panel, hiz dugmeleri) + dukkan; HAT 5230
    - montaj: Codex promote.py (K400, HAT 5230) + kesme_cad_v8 + kutu_cad_v12 + tezgah_cad_v2; hava ana hatti K dali K sol duvar rakoruna (y 1809, z -770); K ayaklari moduler M12 standardina; urun z'si K'da citle (FT.CC_B'de 36 mm sicrama kalkti)
    - yolculuk gercek surelerle (trapez): FR5 TCP 800 mm/s + 0,4 s [V], ray 800 + 0,8 s [V], cekmece 190,5 mm/s (Transmotec 127 d/dk), TOPPING X 200 + 0,3 s, tabla <= 35 d/dk, kaset spirali r_ic 22, FIRIN GERCEK 6,27 mm/s (3,5 dk), K v8 + E v12 saatleri, robot E'ye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
    [kesme_v8_bom.csv]
2026-10-05 Preserve latest Claude h3 generators, audit outputs and session on remote baseline
    [1085256.stp, 1201442.stp, 3022218.stp, 3209510.stp, 3209536.stp, a9f79610.stp, a9f79616.stp, a9n21555.stp]
2026-10-05 TOPPING montaj v5 (yeni 7 ürün) + zincir adım 56 (sol evaporatör 2. ayağı 27 mm)
    - Zincir adım 56: 56_evap_ayak.py, v9w → v9x. Tavuk UNO silindiri flanşı arkadan girerken
    ayağın dik kolunu 2 mm sıyırıyordu; ayak 30 → 27 mm. İki koşu bayt aynı
    (SHA256 83d54bbb…), model _local/claude_son_yerel/hat3_v9x.glb.gz.
    - TOPPING montaj v5: otonom/hat/topping-montaj.html + hat3d/v3/topping_montaj.
    22 adım, 542 öğe, son kare 542/542 (0,0005 mm), belirme 0.
    Gerçek çakışma 6: servis sacı kablo kanalı ↔ evaporatör ayakları (karar bekliyor),
    kanat K1 ↔ orta kayıt. Açık maddeler sayfada ve KUYRUK3.md'de.
    - t5 hattı: v9e yerine merkez_v9w.py, yol denetimi mod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
2026-10-05 Zincir adım 57 (hazırlık): servis sacı kablo kanalı ayak hizalarından kesik
    Kemal: "kablo kanalını en mantıklısını yap". 57_kanal_kesik.py, v9x → v9y: yatay kanal
    4 evaporatör ayağı hizasından 2 mm boşlukla kesilir (4 parça), boş rakor 1476 → 1608.
    İki koşu bayt aynı (SHA256 49fc7520…). zincir.py / SIRA.md kaydı.
    DEVAM EDİYOR: TOPPING montaj animasyonu henüz v9y ile yeniden üretilmedi, yayında v9x sürümü var.
    Claude-Session: https://claude.ai/code/session_01JmrukqGUcpxmzyL729YFo1
2026-10-05 TOPPING montaj v5 yeniden üretildi (model v9y, adım 57 kablo kanalı kesiği)
    Servis sacı kablo kanalı ↔ evaporatör ayakları çakışması kalktı: gerçek çakışma 6 → 2
    (kanat K1 ↔ orta kayıt; sucuk motoru sensörüne 2 üçgen temas). Belirme 0, son konum beyansız 0.
    Model hat3_v9y.glb.gz (v9x.gz yerine).
    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
2026-10-05 Standart önlemleri bitti (zincir 58–61), hijyen kuralı, zincir kilidi boşaldı
    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
2026-10-05 Ortak çalışma: Claude TOPPING v6 (zincir 62–69), Codex K montaj (70–79), aynı anda çalışma kuralları
    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
2026-10-05 KURALLAR: küçük kararları ajan verir; hazır ürün bağlantısı bizim braketle (Kemal)
    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
2026-10-05 Zincir adım 64: TOPPING hazır ürünler bizim braketle bağlı (motorlar, valf adası, X ekseni, menteşeler, sensör braketleri)
    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
2026-10-05 Zincir 64: motor dolgusu ayrı parça, braket ayakları burçtan 1 mm dışarı (montaj sırası çakışmasız)
    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
2026-10-05 TOPPING montaj v6: zincir 65 (servis kanalı 25 mm) + 66 (emniyet sensörü braketi), animasyon hat3_v10h ile yeniden, plan/çıktı çakışma 0, bağlantı denetimi kategorili
    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
2026-10-05 F montaj v2: plan günlüğü (yeni sıra · plan sorunu 41 → 18)
    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
2026-10-05 Site temizliği 2: eski istasyon sayfaları (açıcı, dolap, topping v2, fırın, kesme, kutu, beldos, denemeler, modüler v1) ve yalnız onların kullandığı modeller / betikler kaldırıldı · bağlantılar istas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
    [kesme_v8_bom.csv, kesme_v9_bom.csv]
2026-10-05 Integrate UR10e rail QR and order playback into published v10h machine
2026-10-05 Reserve K chain steps70-73 for TOPPINGv6 montage adaptation
2026-10-05 Release K chain lock after branch registration and repeat checks
2026-10-05 E montaj v2: plan düzeltmeleri (U↔E M8 ekseni, üst kulak somunları), e_cikti E'ye uyarlandı
    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
2026-10-05 Zincir 68: E arka sac alt/üst dönüş delikleri öne açık yarık (E montaj v2 sıra denetimi) · E plan sırası: üst → üst modül → yan sol → alt modül
    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
2026-10-05 E montaj v2: sayfa taslağı (v10j · zincir 00–68), plan sorunu 0
    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
2026-10-05 E montaj v2: ayak + kontra birlikte, somun yaklaşımı 10–12 mm, havada_grup, ilk çıktı
    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
2026-10-05 E montaj v2: arka sol somunlar 6 mm, üst modül dayamada, kaynak model kesişimleri beyanlı
    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
2026-10-05 Zincir 69: E arka ↔ yan sol 4 bağlantı (şarjör arkası) PEM S-M5 + dıştan M5 × 6 · iki koşu bayt aynı
    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
2026-10-06 Zincir 80 (E kapı + emniyet sensörü bağlantıları) ve E planına entegrasyon — yarım, denetim bekliyor
    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
2026-10-06 E montaj v2 (zincir 00–80): bağlantısız 0, yol çakışması 0, geçici dayalı 1 beyanlı — Kemal onayı bekliyor
    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
2026-10-06 E mekanizma işi için hazırlık: hat3_v10l.glb.gz (zincir 00–80) ve kayıt dosyaları depoda, e_parca göreli yol · KOORDINASYON: E mekanizma (2. oturum, 81–85) + A kontrol (86–89)
    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
2026-10-06 KOORDINASYON: K montajı Claude'a devredildi (claude/k-montaj, zincir 86–89), A kontrol beklemede
    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
2026-10-06 coord: reserve robot rail service integration step 90
2026-10-06 robot v21: centre manufacturer CAD rail and reconnect QR and arm services
    [igus_ZLW_20200_3000.stp]
2026-10-06 archive original STEP without text conversion
    [igus_ZLW_20200_3000.stp]
2026-10-06 coord: identify final robot rail release branch
2026-10-06 fix: clean robot carriage and recess floor cable distribution v22
    [igus_ZLW_20200_3000.stp]
2026-10-06 coord: reserve conduit joints and cable bends step92
2026-10-06 fix: join recessed cable routes and relocate wall distribution v23
2026-10-06 E mekanizma: zincir 81-83 vidalı bağlantılar (ara kayıt; 84 yarım, zincire bağlı değil)
    81 kalıp + köprü, 82 kapak katlama, 83 köşe kaldırıcı + köşe pistonu.
    Her adım iki koşuda bayt bayt aynı. Ortak motor: e_mek_bag.py.
    Claude-Session: https://claude.ai/code/session_017vbYk9UNDSSWUjzLt3P51p
2026-10-06 E mekanizma: adım 84 tamam (10 hata düzeltildi) + adım 85 besleyici yazıldı · zincir 81–85 iki koşu bayt aynı (yerel)
2026-10-06 Integrate QR controls on opposite cabinet end and turn box inward; compact measured wall v25
    [igus_ZLW_20200_3000.stp]
2026-10-06 Fix box turn on fixed rail through open corridor and audit native arm clearances
2026-10-06 E montaj v3: 2. adım (taban, dikmeler, kayıtlar, 18 kulak, braketler) ve 9. adım (arka sac tezgâhta → pano, menteşe laması + somun, menteşeler → birlikte arkadan) parça parça · sökerek sıra önbellekl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
2026-10-08 Publish ROCHU fixed four-finger prototype as a separate demo
2026-10-08 Publish reviewed ROCHU V2 trial with tool-following camera
2026-10-08 Update V2 upper dough pickup-release animation and sampled clearance evidence
2026-10-09 Restore V2 finger orientation and complete conceptual cycles with neutral resets
2026-10-09 Compare smaller dessert with all four products on one fixed mounting
2026-10-09 Fit paired fixed gripper to carton cola dough and smaller dessert
2026-10-09 Aim all four gripping faces inward and refit fixed mount
2026-10-12 Use station CAD bounds for isolated views; reveal inside mechanisms
2026-10-12 Keep the full robot rail travel visible in its detail view
2026-10-14 Link technical drawings and assembly animations from Store navigation
2026-10-15 Remove duplicate assembly navigation from main page
